SaitoTommo/CatTeasingRobot/esp32-host/README.md

# 接收窗口协议（2026-10-13）

ESP 0.50 配套 Uno V6.14：ESP GPIO43 经电平转换接 Uno D13；Uno D1 回传至 GPIO44。
普通真实 UART 命令等待 Uno 的一次性 RX available，SIM_UNO 保留原协议。
停止与停止重试可直接发送，缺少窗口不能解除 STOP_UNCONFIRMED。
`/api/state` 的 `uartWindow` 显示是否收到许可、当前编号、年龄及队列长度。
接线及兼容性以 [当前接线表](../SOFT_UART_WIRING.md) 为准；以下旧版接线为历史说明。

# DEV ESP32 0.49（2026-10-13，已烧录并回读版本）

`ESP32_CAT_HOST_0.49_ESCAPE_CONTINUOUS_FRONT` 修复 0.48 转完后等待前向请求超时的问题：转向停稳后直接读取持续 FLOOR 结果，要求新帧且采集时间晚于本次停稳观察起点。无需单次 FLOOR 请求及 generation/step 匹配；旧画面或非 FLOOR 画面不能授权直跑。侧向 90° 搜索、连续直跑及普通开关不关闭逃跑前向保护的语义保持不变。原因和验证见[持续前向检查修复](../evidence/escape-continuous-front-20261013/README.md)。

# ESP32 0.48（2026-10-13，已烧录，发现转后检查超时）

`ESP32_CAT_HOST_0.48_ESCAPE_QUARTER_SEARCH` 保留第一次攻击后找猫和复核，再进行侧向超声波门控的 90° 方向搜索。转前不依赖当前前向结果；转后获取新画面，CLEAR 才连续直跑，BLOCKED 则在剩余预算内再转 90°。最多 3 个方向，侧距阈值可在猫互动配置调整（默认 15 cm）。逃离阶段前向保护独立启用，失效/过期停车，触碰恢复重新检查。台架步骤、离线数据、应用文件及回滚边界见[90° 旋转避障说明](../evidence/escape-quarter-search-20261013/README.md)。Uno 不变；已烧录并回读版本，但后续用户日志显示三次转后检查均超时，0.49 修复此缺陷。

# 当前 DEV 配对版本（2026-10-12）

ESP `0.47_SWITCH_FIX` / Uno `V6.13` 新增手机遥控、速度与声光控制、自定义路线及指定路线节点续寻；巡逻与遥控卡片均可续寻，避障、猫识别和标签识别分卡显示。使用、协议和回滚说明见 [遥控与续寻](../遥控与续寻.md)。烧录与验证结果见项目日志；以下旧版本内容按日期保留。

0.47 修复前向开关在标签／猫接近、试探与复核中的遗漏，并独立保存开关、同步高级参数草稿。核查与验证边界见 [开关核查](../开关核查-20261012.md)。

# 当前 ESP32 0.40（2026-10-06）

0.39 首次实机回读发现 OV3660（PID 0x3660）增益上限 status=248，而通用 sensor.h 注释给的是 OV2640 的 0–6 档位。最终已通过COM11烧录0.40，USB与HTTP回读一致；95个旧配置不变，路线[43,46]保留。本机完整寄存器仍回读248，已落在正确范围，未进行参数试写或识别效果实验。OV3660/OV5640 的驱动使用 0x3A18/0x3A19 的 10-bit 原始寄存器刻度，uint8_t status 对超过255的值会截掉高位。因此 0.40 按传感器 PID 给网页提供参数范围；OV3660/OV5640 用 get_reg 读全 10-bit 值、set_reg 写对应掩码，范围 0–1023；其他传感器保留 enum 0–6。不能简单把 248 截成 6，也不能把未保存的原始默认上限误写成 0–6。读失败时该项不当作有效回读；写后读失败拒绝保存并尝试回滚。

接口核对见 [Espressif OV3660 驱动](https://github.com/espressif/esp32-camera/blob/master/sensors/ov3660.c)：set_gainceiling、init_status、get_reg/set_reg。其余本地日志和摄像头功能沿用下面 0.39 的说明。本轮只更新原始项目日志，归类版留给后续整理。

# 当前 ESP32 0.39（2026-10-06，未上传）

网页新增“导出本地全部日志”。已收到的日志写入当前浏览器、当前网页地址的 IndexedDB，不再随 ESP 重启清空，也不再以 160 条限制本地历史。ESP 仍保留 160 条环形缓冲；网页拉取后归档，并按设备 ID、随机启动 ID、序号去重。界面只显示最近 500 条，本地历史不自动裁剪，导出包含全部已保存记录及当前页面尚未落盘的记录。文件格式为 esp32-local-history-v1：logs 为全部历史，lastState 为最后收到的设备快照，附接收时间、启动信息、断线事件、漏收区间和摄像头参数变更。

ESP 断线时，只要当前页面仍开着，导出按钮仍可使用。刷新后重新获得页面时会读回本地历史；ESP 离线时本功能不负责提供网页本身。网页关闭期间不会采集新日志，断线期间超出 ESP 环形缓冲的记录无法补回；崩溃串口 backtrace 不在 HTTP 日志中。AP 地址与局域网地址属于不同网页来源，各自保存。浏览器容量有限、可被清理或驱逐；存储失败会显示错误并保留当前页面待保存记录，读取失败不会生成冒充完整历史的文件。导出后不会自动删除本地数据。

摄像头区域增加“调整摄像头参数”：JPEG 质量、亮度、对比度、饱和度、自动／手动曝光、曝光目标、AEC2、自动／手动增益、增益上限、白平衡及预设、伽马、镜头校正、镜像与翻转，合计 18 项。猫和标签共用同一物理摄像头设置。数字 0/1 表示关闭/开启，JPEG 数值越小画质越高；手动曝光值是传感器驱动刻度，不能当作毫秒。QVGA 320×240 与 JPEG 格式保持固定。

先停止并等待停车确认、结束手动测试、关闭识别性能实验，再点击“应用并保存到 ESP”。请求在控制循环中校验和执行，取帧与传感器设置使用同一互斥锁；传感器不支持的项目和范围外、小数参数会拒绝。实际驱动接受值保存在独立 NVS camera 键，重启恢复；页面等待相同 requestId 的结果回读，不把 HTTP queued 当成成功。驱动可能量化数值，回读显示实际配置；自动模式的实时曝光／增益不是由该状态测量。未保存过时沿用当前板子的启动默认值，“恢复本机启动默认参数并保存”可回到该组参数。

修改后取消旧识别票据、清空旧缓存、丢弃前两帧并检查采集时间，旧推理完成后也不能重新发布为当前预览。空地外观参考失效，先持久化其失效状态，再保存摄像头参数，避免两次 NVS 写入之间断电后出现新画面参数配旧地面参考。驱动设置或保存失败时尝试回滚，并回报失败；回滚本身失败同样明确显示。

驱动接口及范围依据本机 ESP32 Camera sensor.h，结合 [Espressif OV2640 驱动](https://github.com/espressif/esp32-camera/blob/master/sensors/ov2640.c) 核对。设置能力与实际识别改善仍须实机验收。本轮不修改 Uno、不执行串口或烧录。

以下为历史版本记录。

# 当前 ESP32 0.38（2026-10-05，未上传）

双轮扫描预算采用实际左右编码器脉冲和，配套 Uno 6.11 的扩展 VQ 回报；旧格式继续接受并记录 SCAN_COMPAT。新增 tagScanMaxFrames，默认 3，范围 1–10 整数。网页巡游参数区可在停止且停车确认后保存，写入原有 NVS config 并显示板上回读。每次停稳使用新画面识别当前目标标签，找到立即结束本步，未找到保持停车重试，达到次数上限再转下一步；无效识别和超时仍停止。窗口为 min(60000, scanVisionTimeoutMs×次数)。猫的 catCheckMaxFrames 和主动找猫完整行为轮次保持各自设置。

离线验证与实机待测范围见[项目日志](../项目日志.md)最后的“双轮扫描预算与停稳后的标签多帧识别”。须配套更新两块板；本轮没有串口或烧录操作。

以下为历史版本记录。

# 当前 ESP 0.13 / Uno V6.6（2026-10-03，用户正在上传，待验收）

ESP0.13 网页增加“最低驱动 PWM”，先停止并等待确认，再输入1–255整数、点击“保存最低 PWM”，查看“板上已保存下限”回读。初始140沿用用户当前测得值；已有保存值优先，ESP重启保留。比如请求95、下限140则下发140；设置100后下发100。0仍停车，正反方向不变；范围外或小数拒绝。后续改变供电时可以调整这个参数，不需重烧程序。

该设置由ESP统一处理MOTOR/TEST_MOTOR/DRIVE/ROTATE/SR及旧MOVE/TURN运动命令，在CRC封装之前应用；包括自动策略、手动测试和原始命令。纯转角、距离、时长、扫描编号/预算/flags不变。策略请求PWM仍单独保存，网页显示下限调整后的命令值和请求值；实际输出看Uno遥测。要测更低启动PWM，先把下限降低到准备测的值或1。UnoV6.6自己的下限为1，本次无需更改Uno；若板上仍是旧固件，下调到低于其固定下限可能被Uno再次提高，应先更新配对固件。

配对固件已离线实施。路线使用用户保存的1–128个数字标签ID；找到只要求当前ID在有效新帧出现，到达使用单独保存的宽度比例，未配置时用0.25。所有找猫/找标签和丢失后重找最多两圈，按 Uno 分步转、停稳、请求后新帧的协议执行。慢接近猫采用短 DRIVE→确认STOP→停稳→识别，移动期间不运行猫模型；猫消失重找，找到续剩余距离，失败回原路线并持续报告。

首次触碰位置优先；顶部/画面冲突/多触碰按首次位置找猫两圈，双侧近距直接原地扫描。实际策略、视觉帧门槛、CRC及页面状态有自动化检查；猫状态 CAT-01～CAT-18 同时纳入现场验收。旧网页 SIM_UNO 无 SCAN_V1，不能验收新配对固件。

离线构建：`./build.ps1`，板型 `esp32:esp32:XIAO_ESP32S3:PSRAM=opi,PartitionScheme=max_app_8MB`。上一节点 ESP0.12 编译 Flash3714906/8257536 bytes、静态SRAM78792/327680 bytes；0.13完整编译通过：Flash3717266/8257536 bytes、静态SRAM78792/327680 bytes；本轮结果单独记于统一验收记录第5节。`-Upload` 已阻止默认自动复位；用户允许上传，但 RESET、进入烧录模式、界面和运动由用户操作，需另行配合。不要沿用下方历史自动上传命令。完整证据见[离线结果](../离线验证结果.md)，现场步骤见[统一验收记录](../统一验收记录.md)。下方旧版实测保留原日期，不表示本版本通过实机验收。

# XIAO ESP32-S3 Sense 上位机

分支 `esp32-sense-host`，基线 `9217cc9`。关键阶段分别提交，保留现有 Uno 测试台。

## 连接

双击仓库根目录 `启动ESP32测试网页.bat`，自动启动本地服务器并打开 ESP32 页面；已运行则复用。端口被旧版本或其他服务占用时提示关闭对应服务，不自动结束进程。启动日志在忽略版本管理的 `esp32-host/vendor/web-8765*.log`。PowerShell 也可运行 `./esp32-host/start-web.ps1`；`-NoBrowser` 只启动服务，`-Port 8766` 可选择其他端口。它启动的是电脑测试网页；开发板调试网站随固件上电启动。

从原测试台打开“ESP32 实机上位机”，或访问 `http://localhost:8765/esp32-lab.html`。USB 使用 115200 波特，选择 COM11；网页模拟 Uno，ESP32 接收观测并运行决策。切换 UART 后不接受模拟输入。

开发板创建热点 `ESP32-CatHost`，密码 `catrobot32`。调试页 `http://192.168.4.1/`，HTTP MJPEG 流 `http://192.168.4.1:81/stream`。调试页可配置 2.4GHz Wi-Fi；热点保留，站点 IP 在状态中显示。

2026-10-01 接好外置天线后，完整固件已连接笔记本热点，当前地址 `192.168.137.22`；HTTP 页面、Uno 收信日志和视频解码已实测通过。IP 可能改变，以实时状态为准。电脑页面连接 USB 后会自动填写 stationIP 对应的视频地址和调试页链接。

也可连接笔记本移动热点：开启 2.4GHz 热点并接好开发板外置天线，通过 USB 或板载调试页保存热点信息。连接成功后使用状态里的 `stationIP` 访问 `http://<stationIP>/` 和 `http://<stationIP>:81/stream`；电脑测试页的视频地址也改成该流地址。固件重启会读取已保存配置自动连接。`http-smoke.py --host <stationIP>` 可验证此网络上的视频。

真实 Uno UART（0.5）：ESP32 D6/GPIO43 TX→LV4→HV4→Uno D12 软件接收；Uno D1/TX→HV3→LV3→ESP32 D7/GPIO44 RX，共地，57600/8N1。Uno D0只保留给USB串口桥。蜂鸣器移至Uno D13，LED使用ESP板载GPIO21；完整接线见[当前接线表](../SOFT_UART_WIRING.md)。USB控制和ESP UART是独立入口。先验证协议，再验收实体运动。

## 编译和烧录

旧版曾使用 `./build.ps1 -Upload -Port COM11`；当前请在本目录运行 `./build.ps1` 仅编译，使用 XIAO ESP32-S3、OPI PSRAM 和 `max_app_8MB` 分区。脚本保留完整猫检测模型，并将 `ESP32CatHost/debug_page.html` 无损 gzip 压缩为内置网页头文件；网页由浏览器自动解压。编辑网页后运行 `node ./generate-debug-page.mjs`，Arduino IDE 直接编译前也需生成头文件。编译失败时不自动烧录。

Arduino IDE 中对应选项：Board 为 XIAO_ESP32S3，PSRAM 为 OPI PSRAM，Partition Scheme 为 Maximum APP (7.9MB APP No OTA/No FS)。默认 8MB 分区的应用槽只有 3,342,336 bytes，不能把这个应用槽限制当成开发板的总 Flash 容量。当前应用不使用 OTA 和文件系统；NVS 配置区保留。不要使用整片擦除或合并镜像覆盖配置区。

## 路线

`route` 是有序 AprilTag ID 数组，例如 `[7,42,2,100,7]`，按顺序循环。支持 1–128 个节点，可重复访问；tag36h11 ID 范围 0–586。停止策略后保存，存于 ESP32 NVS，重启回读；上电不自动运动。

巡逻寻路使用独立转速：`patrolSearchPwm=45`（搜索标签）、`patrolAlignPwm=30`（对准标签），范围均为 30–150。电脑 USB 测试页和开发板调试页均提供“巡逻转向速度”输入框：停止巡游 → 修改两项 PWM → 保存 → 查看“板上当前值”确认 → 重新启动测试。保存后重启保留；读取实际配置后才允许保存，旧固件缺少参数时提示更新。旧保存配置没有这两个键时自动使用新默认值；原 `searchPwm`、`alignPwm` 继续用于互动中的找猫/对准，互动逃离及直行参数保持原值。降低 PWM 可减少两帧观测间的转角，但不保证消除纠偏摆动；实车需确认低 PWM 能稳定启动。

## 版本与验证

- 通信阶段：USB JSON 行、UART CRC、HTTP 调试页、独立流服务器、网页 JavaScript Uno 模拟入口。网页 65 项测试通过；此阶段策略/视觉文件为下一阶段接口，尚不提供识别或自主巡游。
- 已接入板载 ESPDet-Pico 猫检测、完整 tag36h11 识别，以及本地巡游/互动状态机。默认仅提供约 5fps 预览，不运行推理；在网页选择“只识别标签”“只识别猫”或“两种识别”。每次检测后休息 200ms，两次检测启动至少间隔 350ms，上电重新回到仅预览。实际观测周期包含推理和队列耗时；2026-10-01 各模式约 12 秒实测分别为标签 2.12Hz、猫 2.21Hz、双识别 1.49Hz，长期稳定性仍未验证。
- 状态机支持按路线搜索/对准/接近标签、编码器 360° 搜索上限、750ms 无有效脉冲反馈时发送 STOP、四区触碰、声光探索、捕猎逃跑、主动 HTTP 找猫、三段试探、装死等待及会话关闭/重开确认。0.10 已取消 KEEP；ESP 只在启动车轮、改变速度和停车时发送 MOTOR/STOP。距离停止使用 Uno 确认的几何参数；实体模式不能以模拟值补充缺失观测。
- 实机检查记录在 `VALIDATION.md`。首次烧录后发现控制任务栈溢出，已将两个 4KB 缓冲移出栈并增加任务栈。编译、启动、视频和识别质量分别记录，不把编译成功等同于实物验收通过。

### AprilTag 纠错内存评估（2026-10-01）

当前 `tag36h11` 使用 0 位纠错。目标 ESP32-S3 编译器确认 `quick_decode_entry` 为 16 字节；按本仓库 `quick_decode_init` 的容量公式，0/1/2 位纠错的码表分别为 28,176 / 1,042,512 / 36,544,272 字节。历史双识别日志中 PSRAM 最低剩余 6,606,424 字节，且固件已配置大块 malloc 使用 PSRAM。1 位纠错在容量上可行，2 位超过 8MiB PSRAM 总容量。此评估没有开启纠错；历史剩余总量不等于当前最大连续空闲块，开启前后仍需验证分配成功、峰值剩余和识别耗时。纠错仅容忍标签编码位读错，不能替代标签四边形检出。

## 前向标定与边界

地面外观检测路线来自先前的单目地面/障碍研究讨论，相关论文引用与当前简化范围见 [前向视觉研究依据](./FRONT_VISION_REFERENCES.md)。当前实现不包含论文中的 IPM、MRF 分割或距离估计；分块数量与阈值是项目参数。

前向默认 `INVALID`；视频可见不代表可前进。原型提供地面外观参考：停止策略，固定实车相机，用 15cm 标尺对应图像警戒区调整 `floorRoiTop`，确认当前警戒区是空地后点采集参考。中央一半视野、下部 ROI 分成 24 块，与参考灰度均值比较；接近的猫或外观变化返回 `BLOCKED`。这是定性外观检查，不是深度测距，同色障碍可能漏检，实车避障还需现场验证。相机高度、朝向、光照改变后重新标定。

只启用一种检测时，另一种视觉观测标为不可用。猫未检出、触碰松开都不证明离开；装死等待超时未确认则保持停车，现场确认后人工恢复。

## 指示灯

官方说明：未接电池时，USB 接入后红色充电灯约 30 秒会熄灭，这不表示断电或过热。来源 https://wiki.seeedstudio.com/xiao_esp32s3_getting_started/#battery-usage 。排查是否运行应看 COM11、启动日志、HTTP 状态和 uptime；本次没有实测板温或电源电压，不能据指示灯推断温度。

## 板载 Arduino 调试网页（0.6）

首页用两个明显按钮显示 `Simulated UART` / `Real UART`，选中状态来自 ESP32 的实际模式回读；收到近期 Uno 回报才显示真实接收状态。切换模式停止策略与会话，并清空旧传感器、配置回读。

停止巡游后，可直接测试前进、后退、左转、右转和左/右轮各自正反转（PWM 1–255，时长 50–2000 ms），以及会话解锁、LED、蜂鸣器、PING、状态和配置查询。点击“开启测试：绕过全部避障”后，这些限时动作忽略前向标定、左右超声波和触碰；没有伪造CLEAR或测距值。开关仅作用于手动测试，自动巡游继续遵守避障；上电、模式切换、Uno重启后恢复避障。每次等待会话解锁，再发送 `TEST_MOTOR`；关闭绕过时先确认前向输入。结束后发送STOP/SESSION_STOP，CRC、会话锁、失速停止和急停保留。模拟模式只产生SIM_TX；真实模式通过GPIO43/GPIO44的57600 UART与Uno D12/D1通信，不接受HTTP模拟Uno回报。网页按钮发送成功只代表入队，执行结果看实际Uno回报。

Arduino 配置面板支持左右安全距离（1–100 cm）、轮径（20–150 mm）、轮距（50–300 mm）。ESP32 逐项等待 `DONE`，最后 `GET_CONFIG` 回读核对四项值。部分设置失败可能已改变先前项；请读取当前值核对。当前 Uno 只在 RAM 中保存这些值，Arduino 重启后恢复默认。轮径和轮距还须与 ESP 策略参数匹配。前向安全常量、触碰规则、电机最小驱动值等没有可写协议的限制会说明需改 Uno 固件，不生成无效设置按钮。

传感器面板独立显示超声波物理测距/控制值、编码器、四处触碰、电机请求/实际引脚输出、LED/蜂鸣器、前向判定、LIVE/DRY_RUN 及物理 I/O 掩码。每行单独计时，2.5 秒后标为过期；不会用其它新回报刷新旧读数。前向判定是上位机视觉输入，不是深度测量。板载网页复用 `hardware-telemetry.mjs`，构建时打包到 gzip，无外部 JS 请求。

## 构建命令

ESP32 0.11 配套 Uno 6.4：Arduino 配置面板和接口允许左右 1–100 cm；Uno 默认左右均 3 cm，仅有效新鲜测距严格小于阈值时执行超声波停车。无效或过期测距保持原样显示，但不触发超声波停车。前向判断仍只由 ESP 执行，停止确认、触碰、失速和 MP 反馈超时规则保留。新原因 SIDE_LEFT_OBSTACLE / SIDE_RIGHT_OBSTACLE 不再混入 SENSOR_INVALID。模拟 Uno 已同步该规则。此版本不代表长期串口失联已修复。

ESP32 0.10 配套 Uno 6.3：57600 不变，正常遥测每 2 秒请求一次，每次回三条 CRC 短帧和校验 DONE；收齐后原子更新 13 项显示读数。MP 编码器运动反馈改为 200 ms，独立于慢速遥测；ESP 超过 750 ms 没有有效 MP 仍发送 STOP。取消所有 ESP KEEP 定时发送，Uno MOTOR 没有续租截止时间。ESP 失联而无法发送 STOP 时，Uno 不会因为收不到续行自动停车，本地侧向、触碰、失速检查仍有效。限时手动 TEST_MOTOR 保留截止时间。真实巡游验收需用户操作，本轮上传后仅进行静止通信核对。

真实 UART 的 STOP 设置独立确认等待：收到匹配编号、CRC 正确的 `DONE id MOTOR_STOPPED` 才继续发送队列中的其它命令。每 300 ms 未确认时重发同编号 STOP，最多三次；仍未确认则清空后续队列并显示“停车未确认”，阻止新电机命令。显式新 STOP 可重新尝试，迟到的有效确认也可解除等待。清理普通命令队列不会清除已发出的停止等待。MOTOR 的 750 ms 反馈超时从实际串口发送时开始计时，避免排队等待 STOP 确认时误判。STOP 重发是停车确认恢复，不是续行。Uno 的 DONE 回报统一加 CRC。停止策略并不等于已经实测电机静止，停车确认表示 Uno 已执行关闭输出。

ESP32 0.9 在正常巡游按钮旁保留“前向避障”开关，需停止后切换，以板上配置回读为准，保存后重启保留。默认开启。关闭时跳过 ESP 的前向外观门禁，不改变 `frontCalibrated` 或参考图。前向判断和 STOP 停车指令由 ESP 决定；Uno 6.2 不再执行前向门禁，CAMERA_FRONT 仅保留兼容回读，正常控制不再周期发送此指令。标签新鲜度、左右超声波、触碰、失速和通信停车继续有效；不会自动切换 DRY_RUN/LIVE。

车轮架空固定的标签流程测试：选择 Real UART，确认 Uno 状态为 LIVE；在路线输入框保存自己指定的 ID 数组（1–128 项，ID 0–586），查看“板上已保存路线”。关闭前向避障，然后启动巡游。启动/恢复会自动在 OFF 或 CAT 模式下开启 BOTH（猫与标签），已有 TAGS/BOTH 设置保留，无需另按识别按钮。按当前目标顺序展示真实标签，居中且宽度达到 `tagStopWidth` 才算到达；日志为 `TAG_REACHED <ID>`，随后切换下一个，末尾循环回到首个。每次启动从数组首项开始。启动逐步等待 STOP、当前编号 GET_CONFIG 的 DATA/DONE、SESSION_START 确认；准备期间暂停自动遥测，每阶段超时最多重试两次。网页固定显示当前步骤和最后的故障/动作拒绝原因。没有保存过路线的新设备以空路线启动，要求用户先保存；已有保存路线继续使用。搜索仍受原有 360°/`searchTimeoutMs` 限制，轮子架空时编码器转角也会累计。

本轮 Uno 固件按用户要求将默认轮距改为 120 mm，复位后 `GET_CONFIG` 应回读 `TRACK_MM=120.0`；原默认 0 会使巡游因 `geometry not confirmed` 停止。网页仍可修改轮径/轮距，临时修改在复位后恢复默认，应与 ESP 策略参数一致。120 mm 是用户指定的默认值，不是此次实测。串口失联也会停止，不应通过关闭前向避障解释或绕过。关闭前向开关不证明巡游、标签识别或长期通信稳定性已验收。

PowerShell 运行 `./build.ps1` 编译；加 `-Upload -Port COM11` 烧录。构建目录使用 Windows 临时目录的英文路径，避免当前中文项目路径导致链接失败。`generate-config.mjs` 从原网页的概率和参数范围生成校验头；修改参数定义后再运行它。模型生成脚本由构建脚本自动执行并检查 SHA-256。

工具链：Arduino CLI、`esp32:esp32@3.3.12`、ArduinoJson 7.4.3。板型 `esp32:esp32:XIAO_ESP32S3:PSRAM=opi,PartitionScheme=max_app_8MB`。PSRAM 必须开启。

资料：[Seeed 开发板说明](https://wiki.seeedstudio.com/xiao_esp32s3_getting_started/)、[Espressif ESP-DL](https://github.com/espressif/esp-dl)、[AprilTag ESP32 库](https://github.com/raspiduino/apriltag-esp32)。识别库及模型来源和许可证另见 `THIRD_PARTY.md`。
