SaitoTommo/CatTeasingRobot/evidence/front-switch-escape-20261014/README.md

# 前向避障开关覆盖逃离流程：2026-10-14

用户授权二次复核后烧写 ESP32，并要求更新版本号。基线提交为 `fb7f8b7`，功能修改为 `fdb89be`，最终源码为 `32888ba`，固件编号为 `ESP32_CAT_HOST_0.52_FRONT_AVOIDANCE_SWITCH`。

相对于基线，运行逻辑只改变前向开关对逃离流程的控制：关闭时跳过转向后的前向画面检查、起步前检查及行进中的前向拦截，并关闭该阶段的 FLOOR 请求；开启时保留原有有效期、标定和新画面要求。侧距、触碰、停车确认、失速和通信处理没有修改。控制台说明、版本标识及对应回归检查同步更新；独立手机遥控原本没有前向视觉拦截，本次没有新增该功能。

最终编译通过：程序 3,845,178 字节，静态 RAM 86,032 字节，应用文件 3,845,328 字节。四组本机回归检查共通过 1,741 项断言，覆盖开关开启/关闭、无效/过期/缺失/未标定输入、侧距和触碰，以及原有策略和接近行为。

COM11 既有分区表 3,072 字节与编译分区完全一致。固件 deviceId 按 little-endian eFuse 整数打印，HTTP 的 `c0871ead4f7c` 对应 esptool MAC `7c:4f:ad:1e:87:c0`。首次身份检查未转换字节顺序而停止，未写应用；依据本机 ESP32 核心实现修正部署脚本后重新核对并继续。

上传仅写 `0x10000` 应用区，26.0 秒完成，esptool 确认 `Hash of data verified`。没有写 NVS、引导程序、分区表，也没有上传 Uno。上传前和分区检查后均回读空闲、无运行电机和无待确认停车。

`192.168.137.234` 回读确认 0.52、`IDLE / SIM_UNO`、摄像头正常。99 项配置变化 0 项，路线 `[14,15]`、直行校正间隔 100 ms、前向开关开启和地面标定均保留。设备实际提供的 gzip 控制台页面与生成的 `debug_page.h` 字节内容一致。

完整构建、检查、上传输出及摘要已提交。应用镜像、已知 0.51 回滚镜像、完整状态快照和 gzip 页面样本保存在同目录，未加入 Git；回滚镜像来自此前已保存的 0.51 构建，并非本次设备闪存备份。没有执行实车运动、猫识别/逃离验收或长期稳定性测试。
