SaitoTommo/CatTeasingRobot/猫互动状态机现状-20261004.md

## 2026-10-14：直行校正间隔配置（已烧录，运动效果待验收）

ESP 0.51 / Uno 6.15：网页提供 straightBalanceIntervalMs（20–1000 ms 整数，默认 200 ms）；ESP 持久保存，下次自主启动同步 Uno。WAIT_PATROL_BALANCE 在几何配置确认后发送 SB，等待对应事务的校验完成回复后才进入 WAIT_SESSION_START。LINK_RECOVERY_BALANCE 在通信恢复的停车及几何确认后重新同步，确认后才进入 LINK_RECOVERY_SESSION_START。未确认、错误或超时不会授权运动。

补充现有 0.49 逃离门控状态：ESCAPE_SIDE_SETTLE 等待侧向取帧前停稳；ESCAPE_SIDE_CHECK 检查候选方向侧距及观测；ESCAPE_FRONT_SETTLE 等待转向后停稳；ESCAPE_FRONT_CHECK 等待停稳后更新的连续 FLOOR 观测，确认可行后进入逃离直行。

## 2026-10-12：DEV ESP 0.46 操作区布局

电脑：UART／巡游左列，摄像头与正下方避障中列，遥控右列。手机：UART／巡游、摄像头、遥控、避障。已烧录并摘要校验，路线 [43,46,51] 与全部配置保持。

## 2026-10-12：DEV ESP 0.45 路线独立存储

解决路线修改时整份配置写入失败导致末节点未保存的问题；路线独立写入、立即回读并在启动恢复。已保存用户路线 [43,46,51]，复位后回读一致，其余配置保持。

## 2026-10-12：DEV ESP 0.44 路线编辑与接管修复

巡逻和遥控卡片均提供路线编辑、保存及起始节点续巡；实际 Uno 裸 DONE 配置完成回报导致的接管超时已修复。静止真 UART 进入/退出遥控通过，运动验收待完成。详见《遥控与续寻.md》和《串口回报匹配检查-20261012.md》。

> 2026-10-12 DEV：源码 ESP 0.43_REMOTE_RESUME / Uno V6.13。新增 REMOTE 接管状态，自主策略在该状态不执行。遥控链路为 ENTER_STOP → ENTER_LOCK → CONFIG → START → ACTIVE；松手 MOVE_STOP → START，退出 EXIT_STOP → EXIT_LOCK → 停止或指定节点巡游。每一步等待对应停车或会话确认。
> Uno 新增 MOTION_REMOTE：限时 600 ms 的遥控运动，可续期和更新速度/方向；绕过环境保护，保留失速。续期不能重置同方向失速计时；超时/中止后锁定会话。TEST_MOTOR 的 SAFE/BYPASS 语义保留。GET_CONFIG 可附带 REMOTE_V1 能力标记；旧 ESP 不支持该标记，回滚时配套恢复两端版本。
> 两处续寻使用相同路线索引入口；先停车并清理遥控/声光，再寻找所选节点，不把选择视作已到达。部署及实机验收结果见 2026-10-12 项目日志，以下保留历史状态说明。

> 2026-10-06 当前源码：ESP 0.42 / Uno配对6.11（仅离线验证，未烧录）。设备已烧录的是maintenance/0.40-cat-flow的0.40.1维护版。以下2026-10-05发布记录保留为历史证据；找猫、接近和确认的当前行为以本条及当前状态表为准。
>
> 主动找猫与触摸找猫共用CAT_CONFIRM：停车确认、编码器停稳后最多catCheckMaxFrames张新画面，任一次找到立即通过，无额外catConfirmWaitSeconds等待、不要求居中。扫描各停点也最多三帧。快/慢接近整段执行，结束后CHECK_APPROACH → SETTLE → CAT_CHECK；catApproachStepCm不再生效。猫丢失后使用与标签相同的TargetRecoveryMemory和startTargetRecovery/advanceTargetRecovery引擎：最近五秒位置优先、中心死区参考趋势，局部→反向→原预算余额。猫不使用标签直行宽限；重新找到继续保存的行为/剩余距离，初次主动/触摸选择仍各自保留。标签ID、到站宽度与路线规则保留。0.40.1仅简化确认和整段接近，不带方向恢复。
> 2026-10-06 更新：ESP 0.41 标签短暂漏检保留已确认直行命令；持续丢失后确认停车 → TAG_SETTLE（编码器停稳）→ TAG_RECHECK（多帧停车复核）→ 记忆方向局部搜索／反向局部搜索／共享剩余预算搜索。找到或到站、停止、互动抢占和配置变更会结束对应恢复状态。
> 2026-10-05 更新：ESP 0.35 的主动找猫与触碰找猫共用 CAT_CONFIRM，找到猫后不检测居中。旧 FACE_CAT、ALIGN_CAT、CHECK_ALIGN 与猫居中预算已退出运行路径；后文这些状态属于历史版本。接近短段后的 SETTLE/CAT_CHECK 保留用于停稳识别。详见 esp32-host/统一找猫不检测居中-20261005.md。
# 猫互动状态机现状：ESP 0.42 / Uno 6.11

2026-10-04 更新。本页前半部分是当前源码现状；末尾保留 ESP 0.17 基线原清单，供版本对照。代码基线提交 81588be，配置页面提交 970643d，独立找猫提交 ebd8db6，连续互动与逃跑拆分提交 5995e7d。

这份清单已逐条核对 policy.cpp 的状态入口、等待动作和转移条件，同时核对 Uno 扫描和运动执行器。自动化覆盖不代表实际识别、运动和 UART 长期稳定性；现场由你验收。当前构建/上传记录见项目日志。

## 当前完整流程

首次触碰：巡游/待命 → 开始一轮互动 → 固定首次触碰位置 → 选择探索/捕猎。

后续触碰：CAT_TOUCH 内只记证据，不重抽、不切换来源。ROBOT_SEARCH 的首次触碰属于新的攻击入口，转入与巡游首触完全相同的 CAT_TOUCH 状态机。若正在转向、直行或扫描：确认停车 → WAIT_TOUCH_RESUME → 松开后续做剩余角度/距离/扫描预算。装死/声光/观察不因拍打重新开始。

捕猎：WAIT_RELEASE → **ESCAPE_DIRECTION（寻找逃跑方向）** → 必要时找猫或 ESCAPE_TURN → 确认停车 → ESCAPE_DRIVE → **ESCAPE_MOVE（执行逃跑直行）** → 确认停车 → POST_ESCAPE → 本轮完成计数/装死选择。

未装死：停车找猫并对准 → WAIT_CHASE → 有追击则观察、继续下一轮；无追击到期则结束。首次顶部/冲突找猫后，对准猫，再转 180°远离猫；找猫扫描本身不算逃跑。

探索：TOUCH_SIGNAL → SIGNAL 声光周期 → 周期完成计数 → 满足可配置最短探索时间后才抽装死 → 未装死则重新面向猫观察 → 下一声光周期。

装死：PREY_WAIT 保持静止，灯条由你遥控 MazeBot；猫退出确认或可配置装死超时结束。不会为画面外的猫转圈。

独立主动找猫：IDLE/STOPPED → 停车确认 → 几何参数 → SESSION_START → 原地两圈找猫。无需标签路线，无需先巡游。主动找猫结束后统一返回巡游：巡游中触发则恢复原路线节点及 TAG_REARM 条件；从 IDLE/STOPPED 触发则从保存路线第一个节点开始。找猫本身仍无需路线；返回时若没有保存路线，明确报 empty route 并停止，不编造标签。主动找猫默认完成5个完整动作后退出邀请；快接近、慢接近、完整三段试探、声光和观察各计一次，内部短段/停车复核不计数。猫攻击立即进入统一首触状态机；找到后有效新帧无猫可提前退出。

## 2026-10-05：CAT_CHECK 停稳后多帧复核

SETTLE → CAT_CHECK：新增 catCheckMaxFrames，默认 3，允许整数 1–3。主动找猫与触碰互动中进入 CAT_CHECK 的路径共用此配置。任一张有效新画面找到猫即通过；有效未找到则在同一 CAT_CHECK 内请求下一张，全部未找到后才进入原有丢失处理。每张采用新取帧 ticket，拒绝重复／旧帧及不匹配 generation、stepId 的结果。补测期间不重新 SETTLE，不发送运动命令。

scanVisionTimeoutMs 限制整次 CAT_CHECK 识别窗口，不按补测次数延长。无效、过期或超时走 FAULT / STOPPED，发送 STOP 与 SESSION_STOP，不能当作猫离开而恢复巡游。CAT_CHECK_SAMPLE 日志记录次数、frameSeq、found/absent/invalid；状态回报 catCheckSamples 和 catCheckMaxFrames。次数配置在主动找猫、猫互动面板和全部参数中可保存并回读；旧保存配置未包含此项时使用默认 3。

本次仅修改 CAT_CHECK，CAT_CONFIRM 的等待及最终单帧、扫描各停点的单帧、OBSERVE/SIGNAL/FOLLOW_WAIT 中的单帧离开判定保留现状。仍可能从这些入口结束互动；不能声称所有漏检引起的恢复巡游均已解决。离线回归和编译不代表实际摄像头、电机行为已验收。

已获用户授权上传 ESP32（Uno 上传需先通知，等待用户拔掉板间串口线）。本次 Uno 未改未上传。ESP 编译 Flash 3,762,754 字节、静态 RAM 83,696 字节；COM11 核对既有 3072 字节分区一致，仅写 0x10000 应用 3,762,896 字节，25.3 秒，Hash of data verified。HTTP 回读 ESP32_CAT_HOST_0.29_FPS_BENCH_3_ACTIVE_SEARCH_3_CAT_CHECK_3、IDLE/SIM_UNO、catCheckMaxFrames=3；原有保存参数变化 0 项，路线 [46,40] 保留；服务页面与编译页面一致。原生 CAT_CHECK 新增 116 项检查、现有 policy 1172、连续互动 623、PWM/配置 2656、扫描 259 项通过，网页 31 项和状态清单 2 项通过。设备验收仍由用户切 Real UART 后进行；本次未主动运行实车电机。证据见 evidence/cat-check-three-frames-20261005/verification.json。

## 2026-10-05：主动邀请计数与上位机调参

最新主动邀请为 ACTIVE_SEARCH_3。默认完成5个完整动作后返回巡游；猫攻击或找到后有效新帧无猫可提前中断。快速接近默认最多15厘米、请求PWM180，仍使用catApproachStepCm短段上限及停车新帧；慢接近使用原保存计划距离/PWM。快接近达到距离上限或猫宽超过远阈值后进入慢接近，两者分别计一次；三段试探完整结束计一次。并行闪灯不是额外动作，概率robotSlowFlashPercent默认50%，只在整个慢接近开始抽一次。

“主动找猫”控制台显示当前动作、完成次数/上限、摄像头新鲜有效猫框占画面宽度、控制采用的远近档和实际PWM。可保存robotActionLimit、快接近距离/PWM、并行闪灯概率、远处和停下后概率组、catFarWidth/catNearWidth、initialLookSeconds、decisionIntervalMs、signalFlashMs、signalBeepMs及慢接近/试探参数。猫宽阈值采用百分比输入，存为归一化宽度；中间区间沿用上一远近档。过期/无效画面显示无有效新鲜检测。

观察与声光时长独立：观察按initialLookSeconds；灯按signalFlashMs，蜂鸣按signalBeepMs，声光动作等待较长者结束后计数。参数经config/NVS保存和板上回读，编辑草稿不会被轮询覆盖；修改前需停止且确认停车。既有保存概率、宽度、时长和最低PWM不自动改值。最低PWM255会使快180/慢95都实际255，控台明确显示，真实速度差仍待用户标定。本次未修改/上传Uno。

## ESP 顶层状态

| phase | 含义与出口 |
| --- | --- |
| IDLE | 待命；可直接主动找猫或由首次触碰启动。 |
| STARTING | 停车/几何/会话准备；会话确认后根据启动目标进入巡游或猫互动。 |
| PATROL | 标签巡游；alert 或首次触碰优先打断并进入 INTERACTION。摄像头单独看到猫不触发互动。 |
| INTERACTION | 主动邀请 ROBOT_SEARCH 的首次触碰转为 CAT_TOUCH，复用巡游首触流程；CAT_TOUCH 内后续拍打保留已选分支。 |
| RECOVERING | Uno 链路恢复；每轮先确认 STOP、关闭会话、回读配置，再重开会话；最多四轮。 |
| ENDING | 停车并关闭会话；持续触碰时先等松开，随后按来源返回巡游或待命。 |
| STOPPED | 故障或操作员停止；后续自动运动已取消，等待重新启动。 |

## ESP 所有 action 状态

包含猫流程、它依赖的启动/退出步骤，以及恢复巡游的节点；因此不会把“公共状态”漏出清单。

| action | 中文含义 | 当前转移与条件 |
| --- | --- | --- |
| IDLE | 待命 | 独立互动关闭会话后进入；可再次找猫或启动巡游。 |
| WAIT_PATROL_STOP | 等启动前停车 | STOP 确认后，真机 GET_CONFIG；模拟先 SET_GEOMETRY。独立找猫也复用此状态，名称不代表必须巡游。 |
| WAIT_PATROL_GEOMETRY | 等模拟几何设置 | 确认后读取 CONFIG。 |
| WAIT_PATROL_CONFIG | 等几何回读 | 合法轮径/轮距确认后启动会话；缺失则故障。 |
| WAIT_SESSION_START | 等会话开放 | 独立找猫进入 INTERACTION，巡游启动/恢复进入 PATROL。 |
| WAIT_STOP | 等确认停车 | 确认后进入 nextAction；超时则故障；页面显示下一步。 |
| WAIT_RELEASE | 首次响应等触碰松开 | 保留原计划，不再因按住 4 秒正常结束；探索走声光，捕猎走 ESCAPE_DIRECTION。 |
| TOUCH_SIGNAL | 首次探索入口 | 开始声光周期并启动探索计时。 |
| ESCAPE_DIRECTION | 寻找逃跑方向 | 按首个触碰决定 +90/-90/0；顶部/冲突或两侧近先两圈找猫；找到并面向猫后准备转 180°远离。目标方向受阻或侧距过期退出恢复规则。 |
| ESCAPE_TURN | 寻找方向中的实际转向 | ROTATE 回报完成后确认停车，再进 ESCAPE_DRIVE。此时尚未执行直行，不计逃跑轮数。 |
| ESCAPE_DRIVE | 已有方向，准备逃跑 | 核对前方可走，发 DRIVE 后进入 ESCAPE_MOVE。默认 26 cm 减 3 cm 余量。 |
| ESCAPE_MOVE | 逃跑直行 | 编码器确认 MD 完成后停车 → POST_ESCAPE；触碰停车后续做剩余距离。 |
| POST_ESCAPE | 完整逃跑已完成 | 增加一轮；默认第 5 轮强制装死，之前每轮按 escapePreyPercent 抽一次；否则找猫并等待追击。 |
| WAIT_CHASE | 等猫追击 | postEscapeWaitSeconds 默认 10 秒；新触碰或远/中→近的有效画面证明追击，进入面向猫观察；到期无证据退出。开始时猫已经近且一直近，不单凭“仍可见”算追击。 |
| WAIT_TOUCH_RESUME | 接触后暂停续做 | 已确认停车，等待松开；普通转向扣已用角度，逃跑/试探扣已走距离；慢接近先停稳识别再继续；扫描保留已用两圈预算。 |
| SEARCH_CAT | 准备找猫 | 配置两圈扫描；scanNext 保存找到后目的。 |
| WAIT_SCAN_CONFIG | 等 SC 确认 | 必须 SCAN_CONFIGURED；错误延后 100 ms 重发，首次外最多 3 次；无回复 2.5 秒再安排重发。 |
| SEARCH_CAT_ACTIVE | 分步扫描猫 | Uno 转小步并停稳后 VQ，ESP 取新画面回 VR；找到则对准并执行后续目标，其他结果报找猫失败。 |
| BOTH_SIDE_SCAN | 两侧近的扫描切换 | 保留扫描累计角度，flags=1 继续剩余预算；不是倒退，也不是逃跑直行。 |
| FACE_CAT | 准备面对猫 | SETTLE → CAT_CHECK → 对准判断。 |
| ALIGN_CAT | 实际对准猫的小步转向 | 每步 ±20.25°，完成后 CHECK_ALIGN；最多 8 步或超时报找猫失败。 |
| CHECK_ALIGN | 转向后检查入口 | SETTLE → CAT_CHECK → ORIENT 判断。 |
| SETTLE | 等停车后稳定 | 等用户最低等待、编码器安静时间及停车后两次样本；此时遥测每 250 ms，普通状态仍 2 秒；成立后 CAT_CHECK，超时找猫失败。 |
| CAT_CONFIRM | 主动/触摸共用静止复核 | 停车后等编码器安静、两次样本及最低等待；最多三张新画面，任一次找到通过，无额外等待。首触CHOOSE_TOUCH行为选择保留。 |
| CAT_CHECK | 停车后新画面识别 | 最多三帧，找到则继续保存下一步；接近/试探丢失时沿记忆方向局部、反向、剩余预算恢复；过期/无效/超时明确失败。 |
| APPROACH_CAT | 准备整段快/慢接近 | 前方可走且有猫则发剩余完整距离DRIVE；距离完成按原规则计数和选择后续行为。 |
| CAT_DRIVE | 整段快/慢接近 | 一次执行剩余完整距离，运动中不实时识别猫；触摸/通信/编码器保护保留，结束后CHECK_APPROACH。 |
| CHECK_APPROACH | 完整接近动作后识别入口 | SETTLE → CAT_CHECK → APPROACH_CAT完成计数；丢失时恢复，保留行为及剩余距离。 |
| PROBE_DRIVE | 准备试探当前段 | 前方可走发 DRIVE。 |
| PROBE_MOVE | 试探当前段运动 | 默认 3/4/3 cm；完成后 CHECK_PROBE。 |
| CHECK_PROBE | 试探后识别入口 | SETTLE → CAT_CHECK → PROBE_DONE 行为 → PROBE_PAUSE。 |
| PROBE_PAUSE | 试探段间停顿 | 默认 700/900/600 ms，继续下一段或结束三段并观察。 |
| SIGNAL | 声光探索/主动声光 | 周期完成后关闭声光；猫主动探索计一轮，达到最短时间才抽装死；未装死则面对猫观察。 |
| OBSERVE | 静止观察 | 默认 initialLookSeconds 5 秒后 FOLLOW_WAIT。 |
| FOLLOW_WAIT | 等下一行为 | 默认决策间隔 2.5 秒；猫主动互动沿原分支继续；机器人动作间等待后再按概率选择行为，完成 robotActionLimit（默认5）个完整动作才正常结束返回巡游。 |
| PREY_WAIT | 装死静止等待 | 不自动闪灯/蜂鸣；有效远离或连续有效无猫且无触碰持续 catLeaveSeconds 默认 5 秒退出；captureWaitMaxSeconds 默认 15 秒到期正常退出，不报旧 MAX_WAIT_UNCONFIRMED。 |
| END_SESSION | 互动结束准备关会话 | 触碰已松开则 SESSION_STOP，否则 WAIT_INTERACTION_RELEASE。 |
| WAIT_INTERACTION_RELEASE | 等触碰松开后退出 | 停车已确认；不在按住时恢复巡游运动，松开再关闭会话。 |
| WAIT_SESSION_STOP | 等会话关闭确认 | 巡游来源恢复原节点；独立主动找猫重开保存路线的新巡游；缺路线明确 FAULT。独立触碰来源仍按原规则进入 IDLE。巡游重开会话时清对准次数/旧决策帧、恢复标签扫描默认方向。 |
| LINK_RECOVERY_STOP | 恢复前停车确认 | 重试 STOP；确认后 LINK_RECOVERY_STOPPED。 |
| LINK_RECOVERY_STOPPED | 已确认停车 | 发 SESSION_STOP 进入 LINK_RECOVERY_SESSION_STOP。 |
| LINK_RECOVERY_SESSION_STOP | 等关闭会话 | 匹配 SESSION_STOPPED 后读 GET_CONFIG。 |
| LINK_RECOVERY_CONFIG | 恢复配置回读 | 几何确认后重开会话；原故障停止则保留停止。 |
| LINK_RECOVERY_SESSION_START | 等恢复会话 | 确认后按原 phase 恢复；猫互动使用新画面重新搜索，巡游重新扫描标签。 |
| FAULT | 故障停止 | 错误原因保留；运动、扫描和识别请求取消。 |
| SCAN_TAG | 准备恢复/开始找标签 | 共用 SC → SR，进入 SCAN_TAG_ACTIVE。 |
| SCAN_TAG_ACTIVE | 分步找标签 | 成功则 APPROACH_TAG，失败故障；猫触碰优先打断。 |
| APPROACH_TAG | 接近当前标签 | 当前目标宽度达到停车阈值先确认停车；偏离则 TAG_ALIGN；丢失则重新扫描。 |
| TAG_ALIGN | 标签小步对准 | ROTATE 完成、停车确认后继续接近；最多 8 步/超时故障。 |
| TAG_ARRIVAL | 标签到达确认后换节点 | 当前节点加一，末尾循环；同编号下一节点需 TAG_REARM。 |
| TAG_REARM | 等同编号重新可计到达 | 标签消失或宽度退到停车阈值 80% 以下，再开始扫描。 |

SCAN_TAG_ACTIVE 是 SR 成功后由条件表达式赋值的状态，不能仅搜索 action== 字面量来列清单。

## 行为目标不是驻留状态

ORIENT 是停车画面后的对准判断；CHOOSE_ROBOT 是机器人主动选择；FAST_APPROACH 是远处快速接近的完整动作，达到 robotFastApproachCm 距离上限或新鲜猫框宽度大于 catFarWidth 后计一次，再切 SLOW_APPROACH。SLOW_APPROACH 完成计划距离后计一次；它的 robotSlowFlashPercent 只在动作开始抽一次，闪灯并行于短段运动；停止后按 robotNearSignalPercent/robotNearObservePercent/robotNearStayPercent 选择声光/观察/静止；SLOW_APPROACH/RESUME_APPROACH、PROBE_APPROACH/PROBE_DONE、STAY_SIGNAL/STAY、TOUCH_SIGNAL、ESCAPE_DIRECTION_FOUND、ESCAPE_DRIVE、WAIT_CHASE 是保存的后续行为。ESCAPE_DIRECTION_FOUND 表示已找到并对准猫，现在决定远离方向。

旧 TOUCH_END、TOUCH_PREY 不再有有效入口/处理；PREY/PREY_SIGNAL/END 的旧直接行为分派不在新的首次响应流程中使用，不能把它们列为目前会自动出现的状态。

## Uno 执行状态完整清单（本次固件未改，配对 6.11）

| 扫描 phase | 实际行为 |
| --- | --- |
| IDLE | 无扫描；合法 SR 启动 NEXT。 |
| NEXT | 准备下一步；预算用完 TERMINAL，否则 TURN。 |
| TURN | 两轮反向，执行小步编码器转动；完成进入 SETTLE。 |
| SETTLE | Uno 自己确认最低停车时间/安静条件；不同于上表 ESP SETTLE，不依赖电脑网页。 |
| WAIT_VISION | VQ 请求新画面；每 500 ms 重发；有效无猫且有预算 NEXT，找到/无效/超时 TERMINAL。 |
| TERMINAL | 停车并 SD 终止；同 id/generation SR 重发不重置，不重新转两圈。 |

SD 结果：0 NOT_FOUND（预算耗尽）、1 FOUND、2 INVALID、3 TIMEOUT、4 ABORTED、5 SETTLE_TIMEOUT。猫扫描失败报告“找猫失败”；旧 id/generation 结果忽略。

| 普通运动 kind | 含义 |
| --- | --- |
| MOTION_NONE | 无运动，可接受下一运动。 |
| MOTION_TIMED | 定时运动，截止完成。 |
| MOTION_PULSES | DRIVE/ROTATE/扫描，按编码器脉冲完成。 |
| MOTION_CONTINUOUS | MOTOR 持续运动，直到 STOP/中止/替换。 |

任何正常自动运动触碰按下，Uno 先停再报告；持续按住时拒绝运动。此保护保留，ESP 的“不重新响应”不等于取消底层停车。AK=接收确认，MS=开始，MP=进度，MD=完成，MA=中止。ESP 根据 MA 已走距离/角度续做，而不是重发完整运动。

超声波辅助状态 SONAR_IDLE / SONAR_WAIT_RISE / SONAR_WAIT_FALL 是等待触发、回波上升沿和下降沿；它们不表示新的猫行为，但会影响测距新鲜度及运动方向是否可执行。会话 SESSION_START/SESSION_STOP 是 Uno 运动开放/锁定，不是猫行为。

## 配置、退出与故障

网页独立配置：远/近猫框宽度（默认 12%/35%）、追击超时 10 秒、最多逃跑完成轮数 5、逃跑装死概率 20%、探索最短时间 30 秒、探索装死概率 20%、退出确认时间 5 秒、装死超时 15 秒。概率两个独立字段，可改 0–100%；保留板上原有设置，新字段才取默认。

远≤远阈值、近≥近阈值，中间保持上一档；首次中间只观察。未看到/无效/过期不能当远近证据。装死退出用新鲜有效连续画面；拍打清离开计时，不重置装死最长时间。超时退出不冒充确认猫离开。

正常退出包括：主动邀请达到动作上限、有效猫离开画面或远离确认、两圈找猫失败、追击超时、装死超时、方向受阻/前方不能执行；回原巡游或待命按来源判断。故障退出包括：STOP 不确认、Uno 失联 2.5 秒、运动开始未确认 2.5 秒、运动中 750 ms 没检查通过的进度、编码器失速、必要命令失败、扫描重试耗尽、重启。保留真实原因，执行故障不当猫离开。

SC 配置：错误后 100 ms 重试，无回复 2.5 秒再安排重试，首次外最多 3 次。SR 启动：错误立即重发，无启动确认 100 ms 重发，同 id/参数首次外最多 3 次。普通 DRIVE/ROTATE 未加新的启动重试。两圈预算累计约 718.875°，接触暂停续做不会重新给完整两圈。

SETTLE 的最低停车等待 scanMinimumMs（默认 200 ms）、安静时间 scanQuietMs（默认 100 ms）与追击/装死超时不同；新遥测频率只去掉采样排队造成的额外等待，不缩短用户设置。实际等待还受 UART 回报和编码器变化影响。

## 基线 ESP 0.17 原清单（历史对照，非当前行为）

# 猫互动状态机现状：供重新梳理

日期：2026-10-04。代码基线：`81588be7ebb7336765ec6327c058ef7f87126325`。

版本：ESP `ESP32_CAT_HOST_0.17`，Uno `UNO_CAT_V6.8`。

本文描述这份基线代码实际写了什么，不是新的实施方案。没有修改程序、上传、reset、操作界面或进行运动测试。数字标为“默认”的，是代码初始值；网页保存的设置可以覆盖它们。

主要依据：[ESP 行为代码](esp32-host/ESP32CatHost/policy.cpp)、[行为默认设置](esp32-host/ESP32CatHost/policy_defaults.h)、[主程序默认设置与输入入口](esp32-host/ESP32CatHost/ESP32CatHost.ino)、[Uno 执行代码](firmware/UnoCatController/UnoCatController.ino)、[Uno 扫描状态机](firmware/UnoCatController/scan_machine.h)。

## 1. 先看完整流程

```text
巡游
 ├─收到触碰按下 → 猫主动互动 → 选择探索/捕猎 → 停车确认
 │   ├─探索 → 声光 → 面向猫 → 观察 → 后续选择
 │   ├─装死 → 静止等待猫远离
 │   └─逃跑 → 等触碰松开 → 转向或找猫 → 前进逃跑
 │                 → 停车找猫 → 等待追击 → 面向猫 → 观察 → 后续选择
 └─收到 alert 指令 → 机器人主动互动 → 停车找猫 → 对准
                         ├─猫较远 → 慢接近 / 三段试探
                         └─猫较近 → 声光 / 观察 / 静止
                                      → 观察 → 再次选择

找猫共用流程：停车 → 扫描配置 → 扫描启动
             → 转一小步 → 停稳 → 识别一帧
             → 找到则对准；未找到则下一步，最多两圈

结束互动：停车确认 → SESSION_STOP 确认
         → SESSION_START 确认 → 恢复原来的巡游目标

通信或运动故障：停车、关闭会话 → FAULT，等待人工恢复
```

注意：“猫较远/较近”在 ESP 固件中按猫框宽度占画面宽度判断，不是厘米测距。

## 2. 顶层状态与进入条件

| 状态 | 中文意思 | 进入及离开条件 |
| --- | --- | --- |
| `IDLE` | 尚未运行 | 启动/恢复后进入 `STARTING`。触碰会记录开关状态，但不会在这里自动开启互动。 |
| `STARTING` | 开启巡游会话 | 停车确认 → 获取 Uno 几何设置 → `SESSION_START` 确认 → `PATROL`。此阶段触碰不进入猫互动。 |
| `PATROL` | 巡游 | 新的触碰按下进入猫主动互动；`alert` 指令进入机器人主动互动。仅摄像头看到猫，不会自动打断巡游。 |
| `INTERACTION` | 与猫互动 | 有两种来源：`CAT_TOUCH`（猫触碰）和 `ROBOT_SEARCH`（alert）。现有代码允许后续触碰把机器人主动互动改为猫主动互动。 |
| `ENDING` | 结束当前互动并恢复巡游 | 停车 → 关闭会话 → 重开会话 → `PATROL`。一般保留被打断的路线节点。 |
| `STOPPED` + `FAULT` | 停止运行 | 人工停止、串口失联、运动未确认等进入这里。人工停止现在也记为 `operator_stop` 故障。 |

## 3. 触碰的完整处理：目前会重新打断互动

开关分为左、右、后、顶部。持续按住同一个开关，不反复算新的按下；松开后再次按下，会重新处理。

| 情况 | 当前实际处理 |
| --- | --- |
| 巡游中第一次按下 | 进入 `INTERACTION`，来源记为 `CAT_TOUCH`，清零互动轮数和分支，然后立即处理首次响应。 |
| 机器人主动互动中首次按下 | 改为 `CAT_TOUCH`，清零轮数和分支，重新选择触碰响应。 |
| 已在猫主动互动，松开后又按下，距上次达到 `touchDebounceMs` | 算新一轮，轮数增加；重新记录触碰位置，重新选装死/慢逃/快逃或探索声光。 |
| 未达到合并间隔，又按下 | 不增加轮数；不同位置会标记需要找猫；仍然停车并进入 `WAIT_RELEASE`。 |
| 一个开关尚未松开，另一个位置也按下 | 标记多个位置触碰、需要找猫；保持之前的首个位置；重新停车并进入 `WAIT_RELEASE`。此路径不会更新 `lastTouch`。 |
| 多个位置的 Uno 时间戳相同 | 额外标记同时触碰；首个位置按实际收到并处理的顺序保留。 |
| 顶部被碰 | 标记需要两圈找猫。 |
| 左碰但新鲜画面里的猫偏右，或右碰但猫偏左 | 保留触碰位置，标记需要两圈找猫。画面冲突判断阈值为中心位置 0.55/0.45。 |
| 左/右触碰要逃跑 | 分别准备 `+90°/-90°` 转向；后部准备 0°，即不先转。最终仍受测距、触碰和运动执行条件限制。 |

探索/捕猎的大分支一般只在 `branch < 0` 时抽一次；但同一分支下的具体动作会在新一轮触碰时重新抽。新一轮也会覆盖“首个触碰位置”。所以当前代码还不是“整轮互动固定第一次响应，后续拍打全部忽略”。

达到 `endingAfterRounds` 时优先进入收尾抽选，不再执行普通探索/捕猎抽选。默认第 3 轮：40% 结束恢复巡游、30% 安静装死、30% 声光装死。顶部或画面冲突时，可能先经 `WAIT_RELEASE` 找猫，再执行这个结局。

## 4. 行为选择：两种进入来源

### 猫触碰进入

| 选择 | 默认概率 | 实际动作 |
| --- | --- | --- |
| 探索分支 | 20% | 触碰后选择一种声光模式；不执行逃跑抽选。 |
| 捕猎分支 | 80% | 在该分支内再选：装死 20%、慢逃 40%、快逃 40%。 |
| 捕猎触碰即时声光 | 独立 20% | 停车确认后闪灯和蜂鸣，与装死/逃跑抽选独立。 |

探索声光模式四种：常亮 1.8 秒；120 ms 间隔闪烁 2.4 秒；600 ms 间隔闪烁 3.6 秒；1400 ms 间隔闪烁 5.6 秒。蜂鸣分别 120/180/240/360 ms。四种按抽取袋轮换，避免连续重复；这份固件结束会话时没有清空声光袋。

### alert 进入机器人主动互动

先停车找猫、对准，再选行为：

| 猫的位置 | 默认选择 | 后续 |
| --- | --- | --- |
| 未在新鲜有效画面中找到 | 两圈扫描找猫 | 找到后重新对准并选择；失败结束互动、报找猫失败。 |
| 猫框宽度小于 `catNearWidth`，默认 35% | 满足冷却时，15% 三段试探，其他慢接近 | 不满足试探冷却时直接慢接近。 |
| 猫框宽度达到近处阈值 | 20% 声光、40% 观察、40% 静止 | “静止”和“观察”在现有固件中均进入同一个 `OBSERVE` 状态。 |

## 5. ESP 的全部猫相关动作状态

表内出现的 `WAIT_STOP`、`SETTLE`、`CAT_CHECK` 等是共用步骤，会带着“下一步要做什么”的记录；同一个状态名不代表每次后续都相同。

| 状态名 | 做什么 | 正常下一步 / 其他出口 |
| --- | --- | --- |
| `WAIT_STOP` | 取消旧扫描/识别请求、清发送队列，发 STOP，等待停车确认 | 确认后进入保存的下一步；2.5 秒无确认则故障。 |
| `WAIT_RELEASE` | 等所有触碰松开 | 4 秒默认仍按住则结束互动；松开后按下表选择找猫、声光、装死或逃跑转向。 |
| `TOUCH_PREY` | 触碰抽中装死 | 进入 `PREY_WAIT`。 |
| `TOUCH_SIGNAL` | 触碰抽中探索声光 | 进入 `SIGNAL`。 |
| `TOUCH_END` | 达到轮数后的结局 | END 则结束互动；否则进入安静/声光装死。 |
| `SEARCH_CAT` | 准备两圈找猫 | 发扫描配置，进入 `WAIT_SCAN_CONFIG`。 |
| `WAIT_SCAN_CONFIG` | 等 Uno 接受 SC 参数 | 确认后发送 SR，进入 `SEARCH_CAT_ACTIVE`；失败按第 8 节重试。 |
| `SEARCH_CAT_ACTIVE` | Uno 分步转动，ESP 在停车后识别 | 找到猫后进入对准；扫描结果非 FOUND 则报找猫失败并结束互动。 |
| `BOTH_SIDE_SCAN` | 猫扫描受侧障碍中止，且两侧都近时切换原地扫描方式 | 保留已用角度，按剩余两圈预算继续配置扫描；用完预算则找猫失败。 |
| `FACE_CAT` | 已停车，准备面向猫 | `SETTLE → CAT_CHECK → ORIENT`。 |
| `SETTLE` | 等停车后编码器不再变化 | 满足最低等待及安静时间，并收到停车后两次编码器样本，才进入 `CAT_CHECK`；默认 6 秒仍不能确认则找猫失败。 |
| `CAT_CHECK` | 请求并等一张新的停车后猫画面 | 有效、找到猫则执行保存的下一步；有效但没猫则开始两圈寻找；画面过期、无效或等画面超时则找猫失败。 |
| `ALIGN_CAT` | 按猫偏左/偏右每次转 `-20.25°/+20.25°` | 运动完成 → 停车 → `CHECK_ALIGN`；转向超时或失败走故障/结束路径。 |
| `CHECK_ALIGN` | 转向后重新检查 | `SETTLE → CAT_CHECK → ORIENT`。 |
| 对准判断 `ORIENT` | 这是判断步骤，不是独立驻留状态 | 中心误差默认 ≤5.5% 则执行计划行为；否则再转一小步。最多 8 次，超出报找猫对准失败；没猫转两圈找。 |
| `APPROACH_CAT` | 决定下一段慢接近距离 | 尚有距离且看到猫则 `CAT_DRIVE`；没猫则扫描并计划 `RESUME_APPROACH`；距离完成则重新面向猫观察。 |
| `CAT_DRIVE` | 按上一张停车画面授权前进一小段，默认 1 cm | 完成 → 停车 → `CHECK_APPROACH`；运动中不实时识别猫，启用前方避障时仅看 FLOOR。 |
| `CHECK_APPROACH` | 慢接近一段后重新看猫 | `SETTLE → CAT_CHECK → APPROACH_CAT`；猫不见则两圈寻找，找到继续剩余距离，找不到结束并报找猫失败。 |
| `PROBE_DRIVE` | 准备试探的当前一段 | 前方可走则进入 `PROBE_MOVE`。 |
| `PROBE_MOVE` | 试探前进，默认 3/4/3 cm | 每段完成 → 停车 → `CHECK_PROBE`；运动中不实时识别猫。 |
| `CHECK_PROBE` | 试探前进后重新看猫 | `SETTLE → CAT_CHECK → PROBE_DONE`；没猫则两圈寻找，找到后执行 PROBE_DONE。 |
| 行为 `PROBE_DONE` | 本段识别完成 | 进入 `PROBE_PAUSE`。 |
| `PROBE_PAUSE` | 各段默认停 700/900/600 ms | 前两段后继续下一段；第三段后面向猫观察。 |
| `ESCAPE_TURN` | 根据触碰位置先转向 | 完成 → 停车 → `ESCAPE_DRIVE`。 |
| `ESCAPE_DRIVE` | 准备逃跑直行 | 默认距离为 26 cm 减停车余量（默认 3 cm）；前方可走则 `ESCAPE_MOVE`；剩余距离为 0 则找猫。 |
| `ESCAPE_MOVE` | 慢逃/快逃直行 | 完成 → 停车 → `POST_ESCAPE`；运动中不实时识别猫。 |
| `POST_ESCAPE` | 逃跑结束后重新找猫 | 停车并两圈找猫，找到、对准后进入 `WAIT_CHASE`。 |
| `WAIT_CHASE` | 默认等猫追击 10 秒 | 时间到后重新面向猫，进入观察。 |
| `SIGNAL` | 原地灯光/蜂鸣 | 时间到关闭声光，重新面向猫观察。 |
| `OBSERVE` | 面向猫静止观察，默认 5 秒 | 时间到进入 `FOLLOW_WAIT`。 |
| `FOLLOW_WAIT` | 默认再等决策间隔 2.5 秒 | 机器人主动互动重新选择行为；猫主动互动按第 6 节选择或等待。 |
| `PREY_WAIT` | 装死停车，可附灯光/蜂鸣 | 新鲜画面仍看到猫、猫框小于远处阈值、无触碰，持续默认 5 秒才结束；默认最长 15 秒仍不能确认离开则故障，要求人工恢复。 |
| `END_SESSION` | 停车已确认，发 SESSION_STOP | `WAIT_SESSION_STOP`。 |
| `WAIT_SESSION_STOP` | 等会话关闭确认 | 清轮数、分支、后续标记，再发 SESSION_START。 |
| `WAIT_SESSION_START` | 等重开会话确认 | 回 PATROL 的 SCAN_TAG/TAG_REARM，继续原来的路线节点。 |
| `FAULT` | 停止、取消请求、关闭声光/会话 | 人工启动/恢复才再走启动流程。 |

`SLOW_APPROACH`、`PROBE_APPROACH`、`RESUME_APPROACH`、`STAY_SIGNAL`、`STAY`、`PREY`、`PREY_SIGNAL`、`END`、`CHOOSE_ROBOT` 是计划行为/后续目标，不能当成额外驻留状态。实际分别转入上表状态。

### WAIT_CHASE 名称补充澄清

你在测试中称为“wait change”的状态，当前代码里最接近且实际存在的名称是 `WAIT_CHASE`（等待猫追击），不是 WAIT_CHANGE。若当时屏幕确实显示其他拼写，需要以那次日志为准。该状态上表已经列出，但此前说明不够醒目。

实际顺序是：逃跑完成 → POST_ESCAPE → 停车 → 两圈搜索猫 → 找到并对准 → WAIT_CHASE → 等 `postEscapeWaitSeconds`（默认 10 秒）→ 再次面向猫 → OBSERVE。它不是等串口回复，也不是停车后识别延迟。三者对应不同设置：追击等待为 postEscapeWaitSeconds，停车识别最低等待为 scanMinimumMs，观察时间为 initialLookSeconds。

### WAIT_RELEASE 松开后的顺序

1. 左右都近，或者顶部/冲突/多位置要求找猫：两圈扫描。左右都近使用 flags=1；不倒退。
2. 否则探索分支执行声光，装死分支执行装死。
3. 否则要转的一侧太近：结束互动恢复巡游。
4. 左/右侧距任意一侧缺失或超过 2.5 秒：结束互动恢复巡游。
5. 转角为零直接准备逃跑；否则先转再逃跑。

因此：两侧都近可以走原地扫描路径；该路径在 Uno 只放行原地转动的侧距检查，仍然受触碰、会话锁等条件影响。

## 6. 观察之后是否继续：现在的真实规则

| 来源 | FOLLOW_WAIT 当前处理 |
| --- | --- |
| `ROBOT_SEARCH` | 每次重新判断猫：没有猫则找猫；有猫则按远近选择接近/试探/声光/观察。 |
| `CAT_TOUCH`，超过无新触碰时间 | 默认 12 秒则直接结束，未要求先确认猫离开。 |
| `CAT_TOUCH`，`followPending=true` | 默认 5% 三段试探、35% 观察、60% 直接结束；试探需要看到猫且冷却满足，否则该部分落入观察。 |
| `CAT_TOUCH`，已经做过这一次后续选择 | `followPending=false` 时不会自动再选下一动作，留在 FOLLOW_WAIT，直到新触碰、无触碰超时或会话上限。 |

这解释了“互动并不一直继续”：现有流程包含随机直接返回巡游、一次性后续选择和时间限制。

## 7. Uno 的两套执行状态机

### 分步扫描（找猫和找标签共用）

| 状态 | 处理 | 下一步 |
| --- | --- | --- |
| `IDLE` | 无扫描 | 收到合法 SR → NEXT。 |
| `NEXT` | 检查剩余角度预算，准备下一步 | 预算耗尽 → TERMINAL/NOT_FOUND；有预算 → TURN。 |
| `TURN` | 左右轮反向转一小步，默认 2 个编码器脉冲 | 本步完成 → SETTLE；运动拒绝/中止 → 终止。 |
| `SETTLE` | 等最低停车时间及编码器安静时间 | 默认最低 200 ms、安静 100 ms → WAIT_VISION；默认 3 秒仍没停稳 → SETTLE_TIMEOUT。 |
| `WAIT_VISION` | 发 VQ，让 ESP 用停车后的新画面识别；每 500 ms 重发请求 | VR FOUND → 终止成功；NOT_FOUND 且有预算 → NEXT；无效 → INVALID；默认等 3 秒 → TIMEOUT。 |
| `TERMINAL` | 发 SD 结果，停车 | 本事务结束；相同 id/generation 的 SR 重发不会重置扫描或重新转动。 |

总预算按两圈量化，默认几何得到约 718.875°。这是一轮寻找的预算；之后丢猫再找会启动新的预算。总扫描事务另外有不超过 600 秒的上限。ESP 会把收到扫描终止结果前的扫描用时加回 `sessionAt`，因此这段用时通常不计入互动时长上限。

| SD 数值 | 名称 | 猫扫描在 ESP 的处理 |
| --- | --- | --- |
| 0 | NOT_FOUND，预算用完没找到 | 报找猫失败，结束并恢复巡游。 |
| 1 | FOUND | 对准后执行保存的行为。 |
| 2 | INVALID | 报找猫失败，结束并恢复巡游。 |
| 3 | TIMEOUT | 报找猫失败，结束并恢复巡游。 |
| 4 | ABORTED | 若仍匹配当前扫描，报找猫失败；已被取消的旧扫描结果忽略。 |
| 5 | SETTLE_TIMEOUT | 报找猫失败，结束并恢复巡游。 |

### 普通运动与触碰

| 情况 | Uno 的现有动作 |
| --- | --- |
| 没运动 `MOTION_NONE` | 可接受下一条符合条件的运动指令。 |
| 持续运动 `MOTION_CONTINUOUS` | MOTOR 持续执行，等待 STOP、中止或替换。 |
| 定时运动 `MOTION_TIMED` | 达到截止时间结束。 |
| 脉冲运动 `MOTION_PULSES` | DRIVE/ROTATE/扫描按编码器目标执行；两轮各自到达目标后结束。 |
| 任意正常自动运动期间触碰按下 | 先中止运动/扫描，再报告 TOUCH。即使 ESP 忽略新的行为抽选，Uno 仍会停车。 |
| 触碰一直按住时又收到普通自动运动/SR | 拒绝：TOUCH_ACTIVE 或 SESSION_OR_TOUCH_LOCK。 |
| 会话已关闭 | 拒绝运动：SESSION_STOPPED。 |
| 已有普通运动/扫描不能接受另一运动 | 拒绝 BUSY。 |
| 编码器不前进、到期未完成、转向侧太近 | 中止并报告 ENCODER_STALL / MOTION_TIMEOUT / SIDE_* 等。 |

运动回报：AK 表示接收确认；MS 开始；MP 进度；MD 完成；MA 中止。触碰中止在 ESP 的 `motionFailure` 里取消当前运动/扫描，但仅直接返回，不自动保存和续做被打断动作；实际后续主要由 TOUCH 事件重新安排。

## 8. 共用重试、故障和退出条件

| 条件 | 当前行为 |
| --- | --- |
| 扫描配置 SC 收到 BAD_CHECKSUM/BAD_ENVELOPE | 等 100 ms 重发，首次之外最多再发 3 次。 |
| SC 没回复 | 每次等 2.5 秒确认超时，再等 100 ms 重发；超过次数则 FAULT。 |
| 扫描启动 SR 收到同类错误 | 立即重发相同 id/参数，首次之外最多 3 次。 |
| SR 没启动确认 | 从实际发送起 100 ms 后重发，最多 3 次。 |
| 普通 DRIVE/ROTATE/MOTOR 没确认 | 2.5 秒报 motion start not confirmed；当前没有相同的运动启动重试。 |
| 已开始运动，750 ms 没收到检查通过的进度回报 | FAULT。 |
| 真串口超过 2.5 秒没收到 Uno 消息 | Uno link timeout → FAULT。 |
| 普通会话相关等待未确认 | 2.5 秒重发，首次外最多 2 次，再失败则 FAULT。 |
| STOP 未确认 | FAULT/STOP_UNCONFIRMED，阻止后续运动。 |
| 猫对准超过 8 步，或一小步超过默认 5 秒 | 报找猫失败、结束互动。 |
| 猫停车后的画面过期、无效、等待超时 | 报找猫失败、结束互动。 |
| 猫扫描两圈未找到 | 报找猫失败、结束互动。 |
| 触碰默认 4 秒不松开 | 结束互动，不要求确认猫离开。 |
| 非 PREY_WAIT 互动时间达到默认 60 秒 | 结束互动；扫描等待阶段先处理扫描，不在该检查处结束。 |
| FOLLOW_WAIT 无新触碰默认 12 秒 | 结束互动。 |
| 后续选择抽中返回巡游，或轮数结局抽中 END | 结束互动，即使猫还在。 |
| 装死看到猫远离并持续默认 5 秒 | 结束互动；条件为有效新鲜画面检测到猫、宽度 < 默认 12%，且没触碰。完全看不到猫不会启动这个离开计时。 |
| 装死达到默认最长 15 秒且没有确认离开 | FAULT：MAX_WAIT_UNCONFIRMED。 |
| 逃跑/接近/试探准备阶段，前方连续默认 2 秒不能确认可走 | 结束互动；运动中明确看到前方 BLOCKED 也结束。 |
| 要转的一侧近，或等待松开后侧距过期 | 结束互动恢复巡游。 |
| 猫扫描侧障碍，且两侧都近 | 尝试 BOTH_SIDE_SCAN；其他互动侧障碍中止一般结束互动。 |
| 其他普通运动错误/中止 | 通常 FAULT；触碰中止有前述特殊处理。 |
| Uno 重启 / 人工停止 / 切换模式 | 停止，取消流程。 |

恢复巡游并不保证一定能走：后续找标签、转向和前进仍可能因为障碍或通信失败停在 FAULT。

## 9. 关键默认设置与未生效项

| 设置 | 默认 | 用途 |
| --- | --- | --- |
| `touchDebounceMs` | 1000 ms | 松开再拍是否算新一轮；不延迟首次响应。 |
| `endingAfterRounds` | 3 | 达到轮数时抽选收尾；0 禁用这一条件。 |
| `endingInactivitySeconds` | 12 秒 | 无新触碰结束；0 禁用这一条件。 |
| `sessionLimitSeconds` | 60 秒 | 非装死互动总时长限制。 |
| `initialLookSeconds` / `decisionIntervalMs` | 5 秒 / 2500 ms | 观察与后续决策间隔。 |
| `postEscapeWaitSeconds` | 10 秒 | 找猫、对准后等待追击。 |
| `captureWaitMaxSeconds` / `catLeaveSeconds` | 15 秒 / 5 秒 | 装死最长等待与远离确认时间。 |
| `catNearWidth` / `catFarWidth` | 35% / 12% | 猫框宽度比例的近处/远处判断。 |
| `visionMaxAgeMs` | 1500 ms | 画面可用于决策的最长年龄。 |
| `slowApproachCm` / `catApproachStepCm` | 9 cm / 1 cm | 慢接近总距离与分段距离；总距离先减默认 3 cm 停车余量。 |
| `escapeDistanceCm` | 26 cm | 逃跑距离，先减停车余量。 |
| `slowApproachPwm` / `probePwm` / `slowEscapePwm` / `fastEscapePwm` | 95 / 90 / 95 / 210 | 所有非零运动还受网页最低 PWM 值抬高。 |
| `minimumDrivePwm` | 140 | 未保存设置时的默认最低 PWM；实际值以已保存设置为准。 |
| `scanMinimumMs` / `scanQuietMs` | 200 / 100 ms | 停车后的最短等待和编码器安静时间。 |
| `farCatThresholdCm` / `catLeaveDistanceCm` | 40 / 70 cm | ESP 固件未使用；真实代码使用猫框宽度比例。 |
| `searchTimeoutMs` / `finalSearchTimeoutMs` | 15 / 8 秒 | ESP 固件未使用；真实扫描使用两圈预算和 SC 超时参数。 |

## 10. 仓库旧网页模拟流程：与 ESP 固件分开看

仓库还保留 `app.mjs` + `decision-system.mjs` 的电脑网页模拟流程。它不是当前 ESP 0.17 的行为执行器，不能用其说明替代上面的真实固件状态机。

旧网页的顶层也是 IDLE/PATROL/INTERACTION/ENDING。独立决策输出包括：PATROL、SEARCH_CAT_START、EXPLORE_SOUND_LIGHT、ATTACK_RESPONSE、SLOW_APPROACH、PROBE_APPROACH、STAY_SIGNAL、OBSERVE、STAY、END_SESSION；网页执行还提供 SEARCH_CAT_STOP、FAST_FORWARD、CAPTURE_WIGGLE、慢逃/快逃等动作。

其主要规则：HTTP_NEGATIVE 只在巡游触发主动互动；探索/捕猎分支一轮只抽一次，但触碰仍会记录攻击次数和互动轮数；后续按试探/观察/结束概率选择；轮数、无触碰超时、会话时长、失败、确认猫远离等会结束。旧网页远近判断按模拟摄像头的厘米距离；触碰回应失败会直接返回巡游。

旧 README 还写了“逃跑后找猫上限 360°、收尾 8 秒”等历史说明；它与当前 ESP 的两圈扫描不同。本次没有修改这些旧说明或旧网页。

## 11. 对照你刚刚提出的新要求：待你梳理，尚未实施

你提出的是：第一次猫响应优先打断其他任务；一旦进入互动，后续拍打不再新建响应或重新规划；除非猫退出，否则继续这轮互动。

需要重新定规则的现有位置：

1. 重复触碰会覆盖位置、增加轮数、重新抽具体动作，并停车重设下一步。
2. 机器人主动互动会被后续触碰切换为猫主动分支。
3. 多位置触碰会取消原流程，重新进入找猫。
4. Uno 每次触碰都会停车，持续按住拒绝运动；是否保留“临时停车、松开续做”需另定。
5. 无新触碰、互动时长、轮数、随机返回巡游，都不等猫实际退出。
6. 猫主动互动的后续只选择一次，之后可能留在 FOLLOW_WAIT 等超时。
7. 猫退出没有统一判断：装死只认“仍看到猫但已远”；其他阶段多通过扫描失败结束。
8. 画面无效、串口/运动失败和“猫真的走了”目前有不同出口，需要分别梳理，避免混为同一个条件。

本文仅供你逐项决定保留、删除或修改；代码基线保持不变。
