SaitoTommo/CatTeasingRobot/开关核查-20261012.md

# DEV 开关核查与修复（2026-10-12）

本次源码版本 ESP32_CAT_HOST_0.47_SWITCH_FIX，配套 Uno V6.13。实车测试结果待用户反馈后整理入项目日志。

## 问题与证据

用户在页面看到前向关闭，但标签很小就切换到下一目标。21:25:49 导出的本地日志回读 frontAvoidanceEnabled=false、tagStopWidth=0.2；同一 bootId 下 545762ms 进入 APPROACH_TAG，545763ms FRONT_BLOCKED，545765ms STOP，545775ms MOTOR_STOPPED，545776ms TAG_ARRIVAL/TAG_REACHED 46，随后 SCAN_TAG。这段没有前进命令，无法据此判断电机故障，也无法判断前向结果是真实障碍还是误报。

这是策略路径问题：approachFrontBlocked 和 approachFrontClear 未读取总开关，历史测试甚至要求关闭时仍拦截。另有 349852ms CONFIG_ERROR：NVS save failed; RAM applied but restart persistence unconfirmed。旧开关操作重写含地面参考的整份配置，因此 RAM 回读关闭不保证重启保持。

## 修复范围

前向两个共用判断现在先读取总开关。关闭时 blocked=false、clear=true；开启时保留有效性、标定、新鲜度与障碍优先判断。标签 APPROACH_TAG/TAG_ALIGN、TAG_RECHECK，猫 chooseRobot、APPROACH_CAT、CAT_DRIVE、CAT_CHECK，PROBE_DRIVE/PROBE_MOVE，以及既有逃跑、接触恢复和普通动作测试全部遵循该开关。关闭时猫移动/试探不再强制要求 FLOOR 识别；停车后仍按原流程识别猫。关闭不绕过标签/猫自身识别有效性、停车确认、失速、触碰或左右超声波保护。标签正常到达仍比较 tagStopWidth；开启前向时遇障后跳下一标签的旧规则保留。

开关单独保存为 NVS front 键的 0/1，写入并立即回读成功才更新单项开关的 RAM 值；失败报告错误，不声称成功。启动覆盖旧 config 开关；无该键时兼容原配置。完整配置成功保存后也同步独立键。页面按钮以板上回读为准，关闭文案说明接近同样关闭拦截，检测状态仍显示。

## 其他开关核查

| 控件 | 控制链路与实际范围 | 结论与证据级别 |
| --- | --- | --- |
| 前向避障 | 页面 config → 独立 NVS/readback → 全部前向策略判断 | 已修复；开/关、无效/未标定、新帧、宽度到达与重启存储离线验证 |
| 模拟 / Real UART | mode → 停车、清会话、接收源匹配 → 真实/模拟发送 | 源码核查及既有静止 UART 验证；重启默认 SIM_UNO |
| 遥控进入 / 退出 | STOP → SESSION → CONFIG 能力 → ACTIVE，退出先停车 | 原确认匹配修复已部署验证；开关控制者、释放及超时离线检查 |
| 动作测试绕过全部避障 | bench_safety → manualBypass → TEST_MOTOR BYPASS/SAFE，Uno motionBypassAvoidance | 源码核查与现有 UI 检查；仅动作测试，非自主巡游设置 |
| 显示预览 / 显示猫框 | 本地选项 → JPEG/视频显示与画框；不改变策略 | 页面测试通过；隐藏预览不等于关闭识别 |
| OFF/TAGS/CAT/BOTH | visionMode → 待机 USER；运行中由 policyVisionMode 与显式票据选择 | 生效范围是待机识别模式；自主会覆盖，以 actualVisionMode 为准，非关闭自主感知的总开关 |
| 性能测试启停 | visionBench → 采集/识别循环与间隔，关闭恢复正常模式 | 源码核查、性能页面测试；只在本次上电保存 |
| 摄像头 aec/agc/awb、aec2/awb_gain、raw_gma/lenc、hmirror/vflip | 值范围校验 → 传感器 setter → 实际回读 → camera NVS，失败回滚并报错 | 摄像头驱动/运行时离线验证；自动曝光/增益打开时手动值可能不决定实时值 |
| ESP 灯开 / 关 | manual_test → hostLedManual → GPIO21，独立 mode4 防止迟到 Uno 回报覆盖 | 源码核查；自主声光接管/STOP 可改变灯，不是永久禁用灯开关 |
| Uno DRY_RUN/LIVE、DEBUG_IO ON/OFF（原始串口诊断） | 串口命令 → physicalIo/输出与中断绑定、注入门禁 | 源码核查；本轮不改变 Uno，也未操作实车诊断开关 |

未发现上述其他开关与前向开关相同的遗漏。此结论不等于逐项实车验收；运动、摄像头自动控制实际效果、超声波与触碰物理行为仍由实测确认。左右超声波卡片目前提供阈值设置，没有独立启停开关，不把阈值当作开关。

## 验证与回滚

针对性检查输出、烧录前后状态和应用备份位于 evidence/switch-audit-20261012/。大体积固件与历史 evidence 不加入 Git。烧录前保存 0.46 串口状态并核对回滚应用的 ROM 摘要；本次仅更新 ESP 应用分区。应用回滚不恢复 NVS；回滚到 0.46 不读取独立 front 键，将使用旧 config 的开关，需要重新核对。完整原始 Flash 备份另见遥控与续寻说明。

扩大回归补充发现：页面按钮确认切换后，全部参数 JSON 曾保留旧前向值，后续保存可能恢复旧开关。现仅在板上开关回读变化时同步该字段，保留其他参数草稿和未完成的 JSON；未确认的切换不改草稿，用户直接编辑高级开关时的普通轮询不覆盖其编辑。增加专门页面回归检查。

最终部署结果：ESP 0.47 已烧录，86 项网页检查与完整原生回归通过（包含前向分支 144、开关存储 8、遥控 71、路线 19 等）。最终编译 Flash 3833626/8257536 字节、静态 RAM 85992/327680 字节。写入 Hash 与独立 ROM 摘要均匹配；真实 ESP 静止状态开关开启/关闭写入回读通过，复位后 frontAvoidanceEnabled=false、路线 [43,46,51]，全部 config 与本轮烧录前一致。未发送运动或巡游指令。当前重启默认 SIM_UNO，真机测试需切回 Real UART。完整实车接近验收与当天开发总结待用户反馈后写入项目日志。

## 2026-10-13 用户验收补记

完成上述部署后，用户反馈“测试没问题”。本轮接近／前向开关问题记为已部署、用户实测通过（定性反馈）；未提供测试次数、模式或距离，不扩展为其他历史故障全部解决。助手当时静止验证范围与原 validation.json 保持不变。近期聊天补漏与当天开发总结已写入《项目日志.md》2026-10-13 节。
