SaitoTommo/CatTeasingRobot/遥控与续寻.md

# 手机遥控与指定标签续寻

DEV 配对版本：ESP `0.47_SWITCH_FIX`、Uno `V6.13`。顶部注释、ESP `/api/state` 和 Uno `READY` 回报使用这些版本号。部署结果另见项目日志。

## 使用

连接 ESP 热点后打开 [板载页面](http://192.168.4.1/)。真机操作需选择 Real UART，并接好 ESP↔Uno 通信线；SIM_UNO 只接受模拟来源回报。遥控启动会检查 Uno 的 `REMOTE_V1` 能力，旧 Uno 或旧模拟器不会被当作支持遥控。

- **自定义巡游路线**：在巡逻或遥控卡片中填写标签 ID 顺序（如 `43, 46, 12, 46`，支持空格、箭头或 JSON 数组），点击“保存巡游路线”。先停止巡游或退出遥控，并确认停车。两个编辑框同步，轮询不覆盖未保存草稿；以 ESP 写入成功回报及路线回读确认保存。路线重启保留。
- **巡逻与续寻卡片**：无需进入遥控即可输入标签 ID、选择路线节点、点击续寻。普通“启动巡游”从首节点开始。
- **手机遥控与续寻卡片**：点击进入遥控，等待停车、锁定、配置能力检查和解锁确认；按住前/后/左/右控制运动，松手停车。左/右是原地转向。PWM 0–255，默认 100，独立于自主最低 PWM；低 PWM 不保证实车能起转。
- 两处输入框搜索**已经保存的路线**，不会新增标签或修改路线；同一 ID 的重复节点显示各自序号，两处选择同步。续寻先寻找该节点，随后沿原路线循环，不把选择当作到达。
- 遥控中也能从该卡片启动巡游或续寻。程序先退出遥控、关闭声光、确认停车和会话锁定，再启动自主扫描；恢复自主保护。
- 蜂鸣器可选择长响（600 ms）、两声短响（180 ms，第二声在 800 ms）、三声短响（150 ms，起点 0/600/1200 ms），或按住鸣叫、松手静音。按住鸣叫取消旧声音模式。
- 随机灯光从不亮、常亮、慢闪、双闪选择，相邻不重复；节奏与时长复用自主探索定义。关闭声光不取消正在按住的移动。

## 保护与状态

遥控期间绕过前向、左右障碍及触碰保护，页面持续显示这一状态；原始观测仍正常显示。自主策略的避障设置不被改写。失速、急停和通信停车保留。

方向与按住鸣叫每 150 ms 续期一次，各自最多有效 600 ms；网页松手、触摸取消、失焦和隐藏会发出停止请求。Uno 在 ESP 或网络失联时也会本地结束遥控运动并锁定会话。相同方向续期不会重置失速计时。超时或故障后必须重新进入遥控并再次按下，旧请求不能恢复运动。

遥控使用单控制者会话和递增序号，切换模式或设备重启使旧会话失效。停车未确认时禁止新运动与续寻。HTTP 返回 `queued:true` 只是请求入队；以板上状态和 Uno 回报确认操作结果，PWM 回报也不等于实测转速。

避障、猫识别、标签识别分别展示。过期、无效、未开启识别、有效未检出和设备断线有不同提示；它们不表示空间畅通或目标不存在。

## 接口与兼容性

- `/api/input`：`op:remote`，动作 `enter/heartbeat/move/move_stop/beep_hold/sound/light/quiet/exit`；进入携带 `client`，后续请求携带 `client/session/seq/expectedMode`。
- 路线保存接口：`{op:"route_save",requestId:"唯一请求号",route:[43,46,12,46],expectedMode:"UART"}`；`/api/state.routeSave` 返回对应请求的 saved/error。保存不启动巡游。
- 两个卡片调用同一续寻接口：`{op:"control",action:"resume_from",index:1,route:[9,46,40],expectedMode:"UART"}`。`index` 为零基路线位置，`route` 必须与当前板上路线一致；旧 `start/resume` 仍从首节点启动。
- `/api/state.remote` 返回会话阶段、执行确认、请求 PWM、声光状态、能力和错误。
- Uno 新增 `TEST_MOTOR <leftPWM> <rightPWM> <50..600ms> REMOTE`；只更新已有遥控运动，其他运动仍返回 BUSY。`SAFE/BYPASS` 原语义不变。`GET_CONFIG` 末尾追加 `REMOTE_V1`，新 ESP 接受新旧配置回报。
- 老 ESP 的严格配置解析不支持追加标记，因此回滚配对固件时须同时恢复旧 ESP 和旧 Uno。

## 验证与回滚

离线回归覆盖接管、松手、变速、方向更新、心跳失效、失速、旧协议拒绝、迟到请求、重复标签节点、路线变化及自主保护恢复。现场仍需验收真机方向、速度、声光、断开网页停车和续寻，不以离线测试代替实车行为。

原 ESP 回读状态和完整 8 MB Flash、原 Uno Flash 备份保存在 `evidence/remote-resume-20261012/`，不把大二进制纳入 Git。ESP 仅更新应用分区；原 NVS 和分区表保留，上传前逐字节核对分区表。两端上传后分别做 Flash 读回比较和实际版本回报核对。

需要回滚时使用原始备份或 `rollback/front-avoidance-baseline-20261011` 的源码构建；先停车并断开运动控制，核对设备 ID、端口与备份校验值。完整 Flash 备份会恢复 NVS，应用分区备份则保留当前 NVS；根据需要明确选择。回滚操作不自动执行。

0.44 修复遥控接管超时：实际 Uno GET_CONFIG 以裸 `DONE <id>` 完成，ESP 现在识别此格式；STOP/SESSION 确认仍检查对应完成原因。

0.44 部署检查：写入哈希校验和独立 ROM Flash 摘要校验成功；真 UART 已通过静止进入/退出遥控及保存现有路线确认。0.43 应用回读备份保存在 evidence/route-editor-20261012/esp-before-app.bin，恢复到 0.43 可保留 Uno V6.13。0.42 配对回滚仍须同时恢复旧 Uno。

0.45 将路线单独保存在 NVS `route` 键，避免每次编辑路线都重写较大的配置字符串。启动优先读取独立路线，未保存过时继续使用原配置中的路线；旧配置、摄像头设置和地面参考不被删除。保存后立即回读核对，再显示成功。

0.45 实际部署：已保存用户路线 `43 → 46 → 51`，复位后仍回读三节点；列表包含末节点 51，续巡请求采用节点位置 2。应用 Flash 摘要校验成功，未发送巡游或移动指令。回滚 0.44 会使用旧 config 内的路线（本轮基线为 43、46），它不读取新的独立 route 键。

0.46 页面布局：电脑顶部左侧为 UART／巡游与自定义路线，中间为摄像头预览及其正下方的前向避障／超声波状态，右侧为遥控。宽度不超过 1000px 时依次显示 UART／巡游、摄像头、遥控、避障；猫和标签识别状态随后显示。控制协议和路线保存方式沿用 0.45。

0.47 统一前向开关：关闭后标签与猫接近、试探和停车复核同样不受前向结果拦截；开启时保留原前向优先规则。单项开关独立 NVS 保存并立即回读，启动恢复；完整核查及其他开关的作用范围见 [开关核查](./开关核查-20261012.md)。实车结果待用户反馈后整理到项目日志。
