SaitoTommo/CatTeasingRobot/猫流程版本说明-20261006.md

# 0.40 猫流程维护版与 0.42

2026-10-06。0.40维护分支 maintenance/0.40-cat-flow 从2361672建立（该基线固件0.40，含此前文档，未包含0.41标签恢复）。版本 ESP32_CAT_HOST_0.40.1_SIMPLE_CAT_FLOW。

主动找猫和被抓后找猫共用扫描后的停稳确认：匹配STOP回报、两次后续编码器采样、零RPM、最短停车和静默窗口满足后请求新画面。不再额外等待catConfirmWaitSeconds。CAT_CONFIRM与CAT_CHECK同样最多catCheckMaxFrames次（1–3），任一次找到立即通过；不是要求三次阳性。有效负帧才重试，旧帧和错代次不计数；无效、超时保留原故障处理。

快/慢接近一次下发剩余完整距离，不再每catApproachStepCm停车识别。完整动作结束仍停车复查；试探动作保留原三段及停顿。触摸、通信、编码器、障碍保护与五次高层动作预算保留。运动中不持续识别猫，因此不会实时按猫框宽度提前结束这一段；最大距离受已有接近距离配置限制。编码器完成不证明实际车身位移。

旧NVS字段不删除、不重写：catApproachStepCm和catConfirmWaitSeconds列入unsupportedSettings；移除页面确认额外等待字段。路线ID、顺序及摄像头配置保留。0.40维护版不包含标签方向恢复。

离线验证：11个原生测试程序全部通过；59项Node页面/预览/日志/性能测试通过。新增真实policy回归覆盖整段快/慢接近、完整动作计数、两种确认入口第1/2/3帧命中。构建及烧录证据见 evidence/cat-flow-20261006/。本次用户随后明确授权只烧录0.40维护版，0.41/0.42禁止烧录。

0.42已以0.41为基础合入同一简化改动，使猫与标签共用TargetRecoveryMemory与startTargetRecovery/advanceTargetRecovery有界局部/反向/剩余全扫恢复引擎。猫不使用标签直行宽限；局部角度复用tagRecoveryAngleDeg，页面明确标为猫与标签共用，旧配置无需迁移。新画面匹配代次与步骤后才更新记忆，恢复成功继续原动作及剩余距离；停止、新互动、配置/摄像头变更、通信恢复清除记忆。两种目标各保留识别和完成条件，猫不采用标签的直行丢失宽限。0.42仅离线验证。

0.40.1应用3793024字节，COM11仅写0x10000，哈希校验、USB及HTTP回读通过；回读IDLE/SIM_UNO，已有策略配置变化零项，未做运动验收。维护版二进制保留evidence/cat-flow-20261006/firmware-040.bin。0.42的13个native程序通过（新增猫恢复111项），网页61项、状态清单2项通过；未烧录。
