SaitoTommo/CatTeasingRobot/新会话实施提示词.md

最新状态：ESP0.13完整编译通过（Flash3717266，静态RAM78792 bytes），用户已报告正在自行上传。助手未操作设备，上传成功及实际NVS保存/运动效果仍待确认。

2026-10-03新增：ESP源码0.13提供 minimumDrivePwm（默认140，整数1–255，NVS保存），网页确认停车后动态设置。统一 sendUno 在 CRC 前提高非零PWM幅值，保留方向与0；全自动/扫描/手动/原始运动命令适用，UnoV6.6保持不变。新增验收在统一验收记录第5节；尚未上传，RESET/界面/运动由用户操作。

# 2026-10-03 本轮执行进度补充

以下旧提示词是历史需求与现场状态，不自动构成新会话操作授权。本轮用户已在聊天批准实施、基线和关键节点 Git 提交，并允许上传代码；RESET、界面操作和运动测试仍由用户完成。当前源码 Uno V6.6 / ESP 0.12；离线原生与 Node 测试及编译通过，尚未上传和实机验收。使用《统一验收记录.md》《配置接入表.md》《扫描协议.md》继续，不拿旧模拟或历史短测当新版本实机证明。标签宽度保存值保留，未配置默认.25；所有搜索最多两圈；慢接近猫每段停稳后新帧识别，丢猫两圈重找、失败回原路线并保留找猫失败记录。

以下保留实施前上下文：

# 新会话实施提示词

以下内容可直接复制到新会话。状态表、To-do、测试矩阵和四张 Mermaid 图在同目录 `机器人状态机与测试清单.md`。

---

请继续我的 ESP32-S3 + Arduino Uno 猫互动机器人项目。工作目录：

`D:\data\SynologyDrive\文档\论文+学习\Embodied behavior design for social context`

主仓库 `uno-web-lab`。先读取适用的 AGENTS.md（若存在）、`uno-web-lab/机器人状态机与测试清单.md` 和 `uno-web-lab/项目日志.md`，再核查实际源码。状态表和图是目标设计，不是已完成实现；不要据此宣布功能已通过测试。

**当前 Uno 失联，我不在设备旁，无法 RESET。现在只做离线代码、文档、测试和编译，不要发设备命令、开电机、复位、上传或自动启动测量。等我回来恢复设备并明确告诉你设备准备好了，再进行实机操作。失联后不要继续递增 PWM 或依靠自动烧录恢复。**

最近烧录记录：ESP `ESP32_CAT_HOST_0.11`、Uno `UNO_CAT_V6.5`。V6.5 只移除了非零 PWM 120 下限，允许 1..255；编译 Flash 30774/32256、静态 RAM 1307/2048，已经上传过。分级测量取消，无可确认结果，最低启动／维持 PWM 尚未知。USB `app.mjs` 仍期待 V6.4，请核查兼容。

两份 Uno 源码必须同步：
- `uno-web-lab/firmware/UnoCatController/UnoCatController.ino`
- `uno-firmware/UnoCatController/UnoCatController.ino`

ESP 策略是 `uno-web-lab/esp32-host/ESP32CatHost/policy.cpp`，参数 `policy_defaults.h`，视觉与串口在 ESP 主固件。保留已有未提交改动，不自行清理或提交。

我的要求：

1. 路线数量、ID、顺序由我在网页输入，不可写死。网页显示找标签／靠近标签、真实子步骤、当前目标／路线位置、大小／阈值、观测年龄、动作确认和停车原因。
2. 有效新帧识别到当前 ID 就算找到，开始靠近；无需 25% 或居中。停止靠近的大小阈值单独可调，达到即停车，无需居中。现有 tagStopWidth 是宽度比例，不是面积比例；新默认值未确定，不混用单位。
3. 搜索低速“转一步→停稳→识别”，Uno 管电机计数、停稳、等待识别，ESP 管视觉与决策。实现独立 SCAN_ROTATE；保留不侦查的 ROTATE angle pwm 和手动持续 MOTOR。先核查现有 ROTATE／DRIVE 的参数与完成语义。
4. Uno 停稳后发请求，ESP 用请求之后新捕获帧识别，响应匹配 scanId、stepId、generation；去重并拒绝旧结果。跨板 millis 不能直接比较。识别等待、总步数／角度／时间都有限，不能重新引入 KEEP／续行租约。
5. 搜索按停稳事件识别，网页持续识别开关可额外启用；**靠近标签自动持续识别，每个新有效帧实时决定停止／纠偏**，不等下次扫描或网页刷新。视频预览独立。丢失／过期则停并有限重获。
6. 猫触碰／攻击最高行为优先级：Uno 立即停，ESP 抢占巡游、扫描、推理等待、旋转与直行。旧推理／完成通知不能恢复旧动作；操作员 STOP 和内存锁定不可被互动覆盖。仅看到猫不打断巡游，仍由真实触碰／明确 alert 触发。
7. 完整覆盖猫行为：主动找猫、朝向、慢接近、三段试探、原地声光、观察／静止；猫触发的四模式声光探索；捕猎可选短提示、静默被捕获、慢逃／快逃、释放等待、逃离转向／直行、等待追逐；结束回巡游／静默捕获／提示捕获、确认离开／等待故障。保留概率、冷却、轮数、防抖和会话规则，参见状态表。
8. 逃离策略尚未最终确定，不能默认看到猫就转 180°。可提议 ESP 按猫位置／触碰面／有效侧距选方向，Uno 纯角度旋转和有界距离执行；无效侧距不因侧向检查停，但不等于已确认畅通。没有后向超声波，不能虚构后向测距。
9. 前向检查仅 ESP 判断并 STOP，保留开关；Uno 不检查前向。侧向超声波归 Uno，默认／最小 1 cm，仅新鲜有效值严格小于阈值停车；无效／过期不因该检查停。触碰、失速、内存保护、可靠停车保持。
10. 保留两端 57600、无 KEEP、紧凑 50 字节 TB 遥测、200 ms MP、2000 ms 遥测查询、CRC 和非零编号匹配；STOP 确认前不发后续运动，发送／ACK 不能代替停车证明。

先核查这些核心问题：
- 搜索／对准／接近共用 SCAN_TAG 和搜索预算，需拆开，避免已找到仍报搜索耗尽。
- ESP angle() 多除一个 PI；修正并测试。67.5 mm 轮径、120 mm 轮距、20 脉冲/转，两轮对转各一个脉冲理论约 10.125°，不承诺 1° 精度。
- 重复 ID／循环不能旧帧跳节点，到达停车确认与重新布防要明确；互动回来续原路线。
- captureCueFlashMs、captureCueBeepMs、touchFeedbackBeepMs 在 ESP 对应路径硬编码；align/finalSearch 超时及厘米猫距离参数可能未接入。逐一追到核心，接入或明确不支持。
- 多标签＋角点＋floor 可能超过约 4096 字节，被 toCharArray 静默截断；需要长度保护和队列丢弃可观察。
- ROI 改动应使旧地面校准失效；ESP 几何保存不等于 Uno 已应用；UI 不从旧 observation.policy 取最新路线。
- 命令 #0 仍显示旧 PWM 的故障展示要纠正；前向关闭时逃离不要被无关旧相机观测卡住。
- STAY／OBSERVE 当前执行合并；声光离开分支应清理，不留下提示。

先给源码核查后的具体实施顺序，再完成不依赖未定选择的离线实现、有效的协议／状态机测试和两端编译，持续更新日志与图。界面→核心→协议→Uno 执行必须贯通，不要只做展示或模拟成功。未定的默认阈值／逃离规则应清楚说明并询问，不能擅自宣称已批准；继续做独立工作。

实机恢复后的测试另排：左右正反分级 PWM、角度／滑行／停稳、TAGS/CAT/BOTH 推理时序、UART 延迟、多个标签完整流程、四面触碰与全部猫分支、至少 10 分钟分场景稳定性。既有 BOTH 耗时 477–531 ms、相机缓存约 5.06 fps 仅是旧样本，识别 fps 尚未直接测量。

编译参考：Arduino CLI 路径 `D:/software/arduinoIDE/Arduino IDE/resources/app/lib/backend/resources/arduino-cli.exe`；ESP FQBN `esp32:esp32:XIAO_ESP32S3:PSRAM=opi,PartitionScheme=max_app_8MB`；优先英文临时构建路径。历史串口 Uno COM10、ESP COM11，历史 ESP 地址 192.168.137.15，均不代表允许当前访问或测试设备。

最终交付同步源码、真实状态网页、通过的离线测试／编译、更新的状态表／图／项目日志和未做的实机项。源码验证、编译、烧录、实机功能、长期稳定性分开报告，不能互相替代。
