SaitoTommo/CatTeasingRobot/配置接入表.md

# 当前 ESP 配置接入表（0.13）

日期：2026-10-03。保存前校验，保存后从 `config` 回读。所有配置更改要求可靠停车；保存不是执行回报。

| 配置 | 默认 / 单位 | 当前执行位置 |
|---|---|---|
| route | 未配置；数字ID数组 | policy 当前路线索引，1–128节点、ID0–586，重复节点需重新布防 |
| tagStopWidth | .25，标签宽度/画面宽度 | 每个新有效标签帧，优先于居中；保存值优先；页面百分比除100 |
| minimumDrivePwm | 140，整数1–255 | ESP sendUno统一处理非零PWM，正反号及0保持；NVS保存，确认停车后可调；包括扫描、直行、纠偏、手动测试和原始运动命令 |
| patrolSearchPwm / patrolAlignPwm | 45 / 30，请求值 | 标签SR扫描 / 小步ROTATE纠偏；实际下发幅值至少为minimumDrivePwm |
| searchPwm / alignPwm | 75 / 52 | 猫SR扫描 / 小步ROTATE朝向 |
| scanStepPulses | 2，整数脉冲1–64 | SC/SR每轮每步目标；总预算由真实Uno GET_CONFIG几何换算两圈 |
| scanMinimumMs / scanQuietMs | 200 / 100ms | Uno扫描停稳；ESP慢接近/朝向停车后编码器采样 |
| scanVisionTimeoutMs | 3000ms | 每次停稳新帧等待；不是整次搜索只有3秒 |
| scanSettleTimeoutMs | 3000ms | Uno停稳上限，大于两个窗口 |
| catSettleTimeoutMs | 6000ms | ESP在DRIVE/ROTATE停车确认后等待两次新编码器采样；保留2000ms遥测周期 |
| catApproachStepCm | 1cm，上限.5–3 | 慢接近每段DRIVE距离；实际距离按两轮真实脉冲扣除剩余量 |
| slowApproachCm / slowApproachPwm / stopMarginCm | 9cm / 95 / 3cm | 慢接近总目标先扣停止余量；重找成功不重置距离 |
| probeStep1/2/3Cm、probePause1/2/3Ms、probePwm | 3/4/3cm、700/900/600ms、90 | 三段试探与暂停，真实MD才完成；每段后停稳识别 |
| escapeDistanceCm、slowEscapePwm、fastEscapePwm | 26cm、95、210 | 有界DRIVE逃离，保留停止余量；纯转向由首次触碰位置决定 |
| captureCueFlashMs / captureCueBeepMs | 2200 / 360ms | 提示捕获真实LED FLASH/BEEP，不再硬编码 |
| touchFeedbackBeepMs / touchFlashPercent | 180ms / 20% | 捕猎前可选短提示；停机事务后执行 |
| signalFlashMs / signalBeepMs | 1400 / 180ms | 普通原地声光；退出清提示；探索四模式保持既有固定节奏池 |
| alignTimeoutMs | 5000ms | 每次有界朝向/标签纠偏等待；另有8次调整上限 |
| catNearWidth / catFarWidth | .35 / .12，猫框宽比例 | 主动远近分支 / 捕获后确认远猫；不是厘米 |
| visionMaxAgeMs | 1500ms | 真实采集年龄；推理开始不能把旧照片刷新为新观察 |
| frontAvoidanceEnabled | true | 仅ESP前向检查；移动中可只处理FLOOR，不运行CAT |
| floorRoiTop / floorReference / frontCalibrated | .75 / 空 / false | 地面外观参考；改ROI使旧参考失效，重新校准，不是深度测量 |
| 所有概率、冷却、轮数、防抖、观察/追逐/会话参数 | 保留原默认值 | chooseRobot/onTouch/FOLLOW_WAIT/PREY_WAIT等；概率组校验总和100；搜索时间单独计账，不在旧60s时限截断正常两圈 |
| wheelMm / trackMm | 67.5 / 120mm，ESP保存值 | SIM几何设置；实体决策只采用当前GET_CONFIG的真实回读；ESP保存不代表已写Uno |
| Uno左右净空 | 默认1cm，RAM，重启恢复默认 | 单独SET_SAFE_DISTANCE + GET_CONFIG回读；严格小于有效新鲜阈值才停；无效/过期不是受阻 |

当前 ESP 不使用 `farCatThresholdCm`、`catLeaveDistanceCm`（无可靠厘米猫距离），也不使用旧 `searchTimeoutMs`、`finalSearchTimeoutMs` 截断两圈扫描；页面与快照明确列出。旧电脑模型仍可能使用这些旧参数，不能混当ESP执行。

总扫描时间按剩余步数×（每步10s运动上限+停稳上限+识别上限）推导，最大600000ms；每步运动/失速可提前失败，不宣称一定转满。双侧例外仅flags=1的有限原地扫描，必须有新鲜双侧证据，不能用会绕过触碰的BYPASS。
