SaitoTommo/CatTeasingRobot/实施计划与人工验收.md

# ESP32 + Uno 实施计划与人工验收

日期：2026-10-03。状态：用户已在聊天批准执行，源码与离线自动化已实施；上传及现场验收尚未执行。

本计划以用户本次要求为执行边界，以《新会话实施提示词.md》《机器人状态机与测试清单.md》为需求背景，再对照当前源码制定。附件中的“继续实现”“编译”等文字不构成本次实施授权。用户随后在聊天批准实施和关键节点提交 Git，并允许直接上传；RESET、界面与运动测试由用户完成。以下初始源码核查表保留为实施前基线，最新实装与验收结果见《统一验收记录.md》《配置接入表.md》。

## 1. 本次边界与已经确定的选择

- 保留既有修改，不清理；按用户后续批准先提交基线，再在关键节点提交 Git，提交说明包括验证和未验证范围。
- 我运行自动化测试与离线编译；用户已允许我上传代码，但不允许自动 RESET。设备准备、按键复位、浏览器操作、架空轮和落地测试由用户完成；不使用 computer use。上传前需用户确认现场准备和端口。
- 离线工作不需要 Uno RESET。现场恢复需要时明确告知用户原因、操作和恢复标准，等用户确认再继续。
- 不依据历史 COM10/COM11、IP 或烧录记录连接设备。附件报告的失联状态未在本次实时核实。
- 已确定：标签停车使用“标签宽度 / 画面宽度”；保留用户保存值，没有保存值才用 0.25。它只决定停车，不决定是否找到标签。
- 用户补充规则：顶部触碰、触碰与画面冲突、多个位置触碰时，以第一次触碰为依据，分步找猫最多累计转 720°；找到提前结束，找不到回原路线巡游。想转方向有近障碍或所需信息已经过时则尝试恢复巡游，巡游无法继续则停止。
- 用户最新补充：所有找猫、找标签均以两圈（720°）为搜索上限，包括主动找猫、触碰找猫、正常标签搜索、丢失后重获、左右受阻时原地找猫；找到目标立即结束搜索。本条替代先前的任何一圈搜索安排。
- 左右都有近障碍时直接原地转，不先倒退；该分支同样最多 720°。该分支需要单独允许侧距过近时的原地旋转，普通运动的侧向规则不变；触碰、失速、STOP、内存保护保留。整体计划仍待批准。
- 用户最新要求：把现在已经存在的找猫及其后续互动状态机完整纳入计划，最后与新功能一并验收。既有且符合要求的行为可以不改，不能因为本次没有改过就免验收；现有流程与用户已经确定的新规则冲突的部分仍按新规则实施。详见第 3.1 节和最终验收清单。
- 用户最新补充：慢接近猫时不持续识别猫，改为走一小段→停车并停稳→识别新画面；新有效帧看不到猫则分步旋转寻找，最多两圈。找到则回慢接近流程，仍找不到则结束本次互动、继续原路线巡游，并回报“找猫失败”。标签靠近的自动持续 TAGS 规则不变。详见第 3.1.5 节。

## 2. 当前源码核查结论

| 核查项 | 当前事实 | 实施影响 |
|---|---|---|
| Uno 双份源码 | 两份 SHA256 一致，声明 UNO_CAT_V6.5，非零 PWM 下限为 1 | 每阶段保持一致；“实测至少 120”旧注释需要纠正，最低可运行 PWM 仍待测 |
| USB 网页握手 | app.mjs 精确期待 V6.4 | 更新受支持版本/能力检查，旧板不允许发送新扫描指令 |
| 路线 | ESP config.route 支持 1–128 个 ID；USB app.mjs 仍固定 A/B/C/D | 主运行路径使用用户数字 ID 数组，旧 USB/模拟入口不得展示固定路线冒充同一功能 |
| 标签巡游 | policy.cpp 共用 SCAN_TAG；先纠偏，再比较 tagStopWidth；到达立即推进索引，只等待 500 ms | 拆状态、预算与到达停车确认；旧帧不能推进下一节点 |
| 转角 | ESP angle() 多除一次 PI | 正确公式为 (左右脉冲之和) × wheelMm / 20 / trackMm × 180，仅适用于当前两轮反向旋转计数约定 |
| 本地动作 | DRIVE cm pwm，范围 -100..100 cm；ROTATE degrees pwm，范围 -360..360°；非零，PWM 1..255 | 都按几何换算每轮目标脉冲，四舍五入且至少 1 脉冲；两轮均到目标才完成；本地 10 s 上限 |
| 完成与中止 | Uno MD 带匹配编号和两轮脉冲，MA 带原因；均带 CRC | ESP 当前策略没有消费 MD 分支，逃离仍使用 MOTOR 和 ESP 角度判断，必须接入真正完成事件 |
| 触碰停车 | Uno setTouch 中先串口报告，再 abortMotion；扫描尚不存在 | 本地先关电机并取消扫描，再安排报告，减少日志输出对停车的拖延；实际时延仍需实测 |
| 视觉 | visionTask 拷贝最新 JPEG 缓存；processVision 用推理开始时间写 at，没有关联采集帧编号 | 新增真实帧身份、采集时间、请求代次；缓存晚更新不能证明照片在请求之后拍摄 |
| 队列 | Input.text 为 4096 字节；enqueueCamera 的 toCharArray 可能截断，忽略 xQueueSend 失败 | 控制和视觉分开调度；完整长度检查、丢包计数；不得用截断数据刷新观察 |
| 协议容量 | Uno 行缓冲 128 字节，解析器最多 8 个词，包括信封和命令 | 新扫描字段必须紧凑编码或拆为配置/执行接口，不能直接塞入长参数列表 |
| 配置接入 | 捕获提示/触碰提示部分写死；alignTimeoutMs、finalSearchTimeoutMs 和厘米猫距离未在当前 ESP 策略路径使用 | 为每个参数建立配置→校验→执行→回读映射，未支持项明确显示 |
| 显示和校准 | ESP 页面从 vision.policy 取路线索引；ROI 保存未使旧校准失效；故障可能 motorId=0 仍保留旧 PWM | 以最新策略快照显示，分开请求值/真实输出/历史命令；ROI 变更使参考失效 |

Flash 30774/32256、静态 SRAM 1307/2048 是日志中的上次 Uno 编译结果，本次未重新编译。新增扫描必须逐阶段检查实际容量，不能假定能直接塞入；不能靠删除触碰、失速、CRC 或内存保护来腾空间。

## 3. 实施顺序与代码范围

### 阶段 A：协议、动作和停车基础

涉及两份 UnoCatController.ino、ESP32CatHost.ino、policy.cpp、policy_ids.h、core.mjs、compact-telemetry.mjs、app.mjs。

1. 写出扫描协议规范：SCAN_ROTATE、停稳识别请求、识别结果、扫描完成/中止。关联键包含 scanId、stepId、generation；命令编号非零；各消息 CRC 校验。
2. 计算最大编号、参数和 CRC 时的帧长、词数、接收/发送缓冲占用及新增 SRAM；必要时使用短命令别名/紧凑字段，保持公开动作语义清楚。
3. 保留三个独立动作：SCAN_ROTATE 用于转动后识别；ROTATE 用于不识别的指定角度；MOTOR 用于手动持续运动。DRIVE 保留本地有界距离语义。
4. 接入 MS/MP/MD/MA 的真实事务匹配，区分命令已发送、已接受、执行中、已完成、已中止和停车未确认。
5. 保留 STOP 的 CRC+同编号 MOTOR_STOPPED 确认、300 ms 有限重试和未确认门禁；清队列、切模式、触碰、复位不能让旧动作绕过门禁。
6. 修正角度换算，测试正反方向、单轮/双轮计数、归零、累计及边界。两轮各一脉冲理论约 10.125°；小角度按脉冲量化，并显示实际请求/执行目标，不能承诺 1° 精度。
7. 保留 57600、无 KEEP、50 字节 TB、200 ms MP、2000 ms 遥测查询。扫描等待期间没有 MP 时不得误触发“运动反馈 750 ms 超时”；反馈检查只覆盖实际运动步骤，等待识别另用有限超时。

通过门槛：新协议边界测试、可靠停车测试和两端编译通过；Uno 双份源码一致，容量合格。

### 阶段 B：Uno 扫描和 ESP 新帧识别

涉及 Uno 扫描核心（拟提取 scan_machine.h）、ESP32CatHost.ino、vision.cpp、host_types.h 及新增扫描/视觉接口。

1. Uno 非阻塞状态：转一步→关闭输出→等待停稳→请求识别→等待匹配结果→下一步/完成。最小等待、编码器静止窗口、停稳超时和识别超时可配置；静止窗口仍受编码器分辨率限制。
2. 总步数、累计角度、总时间均有限。任何一步触碰、STOP、会话关闭、失速、侧向障碍或内存锁定立即取消；等待识别超时保持停止。重发同一请求不重新转一步或重复计数。
   所有目标搜索统一累计角度上限 720°；双侧受阻专用旋转的侧距例外见第 6 节。步数按实际每步脉冲/角度推导，总时限考虑两圈转动、每步停稳和识别等待，并与会话时限协调；不能沿用旧 360°或过短时限，使正常搜索在一圈附近就被判定为未找到。真实故障/请求超时仍可提前中止，显示实际原因。
3. ESP 收到停稳请求后记录本地采集屏障，只使用实际采集发生在请求之后的帧。核查相机驱动返回的帧时间/排队行为，拒绝缓存和驱动中更早的帧；不比较 ESP 与 Uno 的 millis。
4. 推理在视觉任务运行；UART、触碰和 STOP 不等待推理结束。推理结果返回控制核心时再次校验请求键、generation 和帧身份。
5. FOUND 只表示新有效帧中识别到该次目标。NOT_FOUND 与无法识别/无新帧分别处理；INVALID 不能冒充没找到后继续盲转。
6. 给控制事件保留优先处理能力，视觉采用受限待处理数据；超长/队列满显式计数，保留必要目标字段，角点等展示字段可限量。任何丢失不得刷新观察年龄。
7. 分开用户持续识别需求与行为必要识别：搜索默认由停稳请求触发；靠近标签自动连续 TAGS；慢接近猫只在每段停稳后请求 CAT，不在行进中持续推理；其他猫行为按需 CAT；合并需求决定实际模式；视频预览独立。慢接近期间不让网页后台持续 CAT/BOTH 请求重新引入移动中猫推理，显示本阶段实际识别安排。请求识别不被旧周期节流跳过。

通过门槛：延迟、乱序、重复、旧帧、旧推理、队列拥塞和抢占用例通过，转动中照片不能作为停稳照片。

### 阶段 C：标签巡游

涉及 policy.cpp（拟把可测试决策核心提取为 policy_core.cpp/.h）、策略配置、USB/模拟适配层。

1. 状态拆为选目标、找标签、找到、靠近、小步纠偏、丢失停车/重获、前向等待、到达停车确认、到达和重新布防。
2. 有效新帧出现当前 ID 即找到。每个新有效帧先判断是否达到停车宽度，再判断是否需要纠偏；未居中也能到达停车。
3. 搜索、纠偏、靠近、重获各有独立预算和原因。正常找标签和丢失后的重新寻找均允许最多累计 720°；找到以后不能再因原搜索时间累计报“从未找到”。丢失/过期先可靠停车，再有限重获。纠偏仍是对已找到目标的小步调整，不要求绕两圈。
4. 达阈值发 STOP，等停车确认才记到达和推进索引；相同帧不能计作下一次到达。
5. 重复 ID/单节点循环：除了新帧，还必须完成重新布防。建议相同 ID 连续可见且仍在停车阈值内时保持停止，等该 ID 消失或宽度退到明确的较小重布防阈值后，再允许再次计到达；超时显示等待重布防。此版本不自动倒车/离开制造新一圈，需要用户移动标签/机器人或另行批准离开动作。
6. 互动中保存路线索引及当前目标；正常互动收尾后重开会话并从该节点重新观察。操作员 STOP、失联/复位和故障不自动恢复旧动作。
7. 前向仅 ESP 判断并 STOP；开关关闭时逃离不因不需要的旧相机观察而卡住。普通运动左右仅 Uno 按新鲜有效值严格小于阈值停车，1 cm 默认/最小值不变；双侧受阻的专用原地扫描例外见第 6 节。

通过门槛：偏侧大标签、小标签、丢失、错误 ID、重复 ID、单节点、循环、互动恢复及停车未确认测试通过。

### 阶段 D：完整猫行为

涉及 policy.cpp/提取后的决策核心、decision-system.mjs、escape-planner.mjs 和参数生成器。

1. 真实触碰和明确 alert 才触发互动，看到猫只更新观察。触碰抢占搜索、扫描等待、推理、靠近、纯旋转和直行；操作员停止/故障锁定不可解除。
2. 每次取消增加 generation，清除旧完成处理和后续运动；迟到 MD、VISION_RESULT 不能恢复旧逃离。
3. 覆盖主动找猫、朝向、慢接近、三段试探及暂停、原地声光、观察/静止和后续等待。慢接近按第 3.1.5 节分段使用 Uno 有界 DRIVE，行进中不持续识别猫，停稳后才看新画面并决定继续/找猫/收尾；试探保留既有分段/暂停及视觉规则，不能把此次慢接近规则无声扩展为修改全部猫行为。两者触碰、STOP 等必要中止始终及时执行。
4. 保留四模式探索、会话分支只抽一次、模式池、防抖、轮次、概率、冷却和总时限；自动化用固定随机输入逐条覆盖分支，不靠重复运行碰概率。
5. 捕猎包括可选短提示、静默捕获、等待释放、慢逃/快逃、ROTATE 完成后 DRIVE、停后等待追逐，以及再次触碰后的取消/重新等待释放。顶部/触碰与画面冲突/多个位置触碰的找猫按第 6 节执行 SCAN_ROTATE，最多 720°，不使用不侦查的纯 ROTATE 一次转满两圈。
6. 捕获结束分回巡游、静默捕获、提示捕获。提示时长真正使用配置；静默与所有退出路径清旧灯/蜂鸣器。未检测到猫不能证明离开；只有新鲜有效的“猫已较远且无触碰”持续满足时间才确认离开，超时停止等待人工恢复。
7. STAY 与 OBSERVE 先保留现有静止执行含义，显示真实状态并说明两者当前都等待后续决策；不擅自新增行为差异。
8. 无可靠厘米估计时，farCatThresholdCm/catLeaveDistanceCm 明确标为 ESP 当前不支持；实际分支使用可配置框宽阈值。不要把框宽显示为真实厘米。
9. 逃离与找猫采用第 6 节的用户补充规则。首次触碰位置优先于画面；单侧受阻/信息过期/找猫失败均尝试可靠收尾后恢复原路线；巡游无法继续则停止。双侧过近时使用单独允许的原地扫描分支，最多 720°，不倒退。主动 alert 找猫和猫丢失后的重新寻找也统一两圈上限。

通过门槛：全部分支和退出条件有可重放测试，概率/冷却保持原值，按住触碰不反复计轮，任何旧结果不能启动旧运动。

### 阶段 E：网页和配置贯通

涉及 debug_page.html、generate-debug-page.mjs、debug_page.h、generate-config.mjs、policy_defaults.h、app.mjs、index.html、core.mjs，必要时同步资源映射。

1. 展示实际主状态/子步骤、路线索引/总节点/目标 ID、标签宽度与停车阈值、观测年龄、帧编号、命令确认、扫描步骤和停止原因。数据来自新策略快照，不依赖旧 observation.policy。
2. 用户输入任意有效有序 ID 数组，保留当前合法 1–128 节点容量限制、ID 0–586 和重复 ID；没有固定 A/B/C/D 默认路线。USB 场景适配与真实路线分开，不能拿场景名称替代真实 ID。
3. 到达宽度单独输入，明确百分比和比例换算；搜索 PWM、纠偏 PWM、步长/脉冲、停稳窗口和有限预算可保存、校验、回读。非零低 PWM 的参数范围不再隐含强制 120；能否转动由现场测量决定。
4. 建立配置接入表，包含 captureCueFlashMs、captureCueBeepMs、touchFeedbackBeepMs、alignTimeoutMs、finalSearchTimeoutMs 等；修改生成器后重新生成头文件，避免只改生成文件。
5. ROI 变更清除旧地面校准并要求重新采集；配置保存不伪造真实 Uno GET_CONFIG 回读，几何区分“ESP 保存”和“Uno 已确认”。配置修改要求可靠停车。
6. 当前命令为空/故障时不显示历史 PWM 冒充输出；真实输出未知时标未知，保留历史动作单独显示。HTTP queued 只表示排队，不显示成已应用。

通过门槛：无浏览器的 DOM/接口测试证明输入→配置→核心参数→协议和状态显示贯通；视觉布局和真实点击由用户验收。

## 3.1. 已有找猫状态机：可以保留，但最终一并验收

### 3.1.1 核查依据与“保留”的含义

本节以当前 ESP `esp32-host/ESP32CatHost/policy.cpp` 的 `policyControl`、`chooseRobot`、`behavior`、`onTouch`、`policyTick` 为实机策略依据，以 `policy_defaults.h`/ESP 初始化为参数依据；另对照旧 USB/模拟网页 `app.mjs` 的 `searchCat`、`alignToCat`、`finishFacingCat`、`holdCatView`、`waitForCatPursuit` 和行为执行，以及 `decision-system.mjs` 的概率/会话决策。

下面记录的是**目前源码怎样执行**，不是已经验收成功的结果。中文流程节点中“选择行为”是决策分支，`CHOOSE_ROBOT`/`STAY` 等名字有的只是待执行行为名称，不都对应一个实际运行状态。最终验收必须跟真实日志、动作及转移相互对照。

“可以不做更改”表示保留符合需求的行为顺序、概率、冷却、距离/时长参数和收尾含义，不为了验收重新设计整套互动。不免除两圈搜索、新帧扫描、角度修正、可靠停车、旧结果失效和触碰优先等已明确修改，也不把当前未实现的目标表当成既有功能。

### 3.1.2 当前 ESP 找猫和后续行为状态表

| 编号 | 当前状态/分支 | 当前源码入口与执行 | 当前正常出口/异常出口 | 最终一并验收的重点 |
|---|---|---|---|---|
| CAT-01 | 巡游看见猫 | `PATROL` 中相机结果更新猫观察，不自行进入互动 | 明确 `alert` 或真实触碰才进入互动 | 仅画面出现猫不打断路线；明确 alert 只在允许状态触发 |
| CAT-02 | 主动互动入口 | `policyControl(alert)` 停车、设置 `ROBOT_SEARCH`、记录会话开始并执行 `chooseRobot` | 没看到猫→`SEARCH_CAT`；看到→远近选择后 `FACE_CAT` | 发起方与原路线保存正确；开始互动不能越过停车确认；不重复开会话 |
| CAT-03 | 找猫 `SEARCH_CAT` | 当前连续 MOTOR 扫描；无有效新鲜视觉就停等；看到偏侧猫后在同一个搜索状态内对准 | 居中后按 `afterFace` 继续；当前 360°或 `searchTimeoutMs` 耗尽→`finish` | 按新要求改成停稳新帧扫描、720°；第一圈未见继续，第二圈可成功；找到与朝向分开记录，不能把看见但未居中说成未找到 |
| CAT-04 | 主动远近选择 `chooseRobot` | ESP 用猫框宽与 `catNearWidth` 比较；远处默认试探 15%、否则慢接近；试探须满足机器人试探冷却 | 选择 `PROBE_APPROACH` 或 `SLOW_APPROACH`，先进入 `FACE_CAT` | 远近依据明确是框宽；固定随机输入覆盖两分支和冷却；不把厘米字段冒充已使用 |
| CAT-05 | 主动近猫选择 `chooseRobot` | 默认声光 20%、观察 40%、静止 40%，先朝向 | `FACE_CAT` 后执行对应行为 | 概率组保持；三种选择均有验收，STAY/OBSERVE 当前执行合并要如实标明 |
| CAT-06 | 朝向 `FACE_CAT` | 保存 `afterFace`；当前看到偏侧猫时连续转向，居中停；猫不见则在该状态内搜索 | 根据 `afterFace` 去慢接近/试探/声光/观察/等待追逐；找不到或视觉不可用超时→结束互动 | 找到后纠偏的真实步骤、停止确认；朝向中丢失时最多两圈重新找；align/finalSearch 超时按实际接入验收，不因搜索预算误判 |
| CAT-07 | 慢接近 `APPROACH_CAT` | 当前 MOTOR 前行，ESP 用两轮脉冲估计距离；默认距离 9 cm、PWM95，受停止余量影响 | 当前到距离→朝向再观察；猫丢失→结束；观察不新鲜/前向非 CLEAR 先停，等待超时收尾 | 按最新要求改成分段走→停稳→新帧识别，不连续 CAT；停稳后猫不见则最多720°重找，找到续慢接近，找不到回原路线并报找猫失败；参数/剩余距离真实使用，触碰即时中止，详见第3.1.5节 |
| CAT-08 | 三段试探 `PROBE_DRIVE` | `probeStep` 从 1 起；默认 3/4/3 cm、PWM90；每段当前由 ESP 读脉冲判断完成 | 每段→`PROBE_PAUSE`；看不见猫→结束；触碰转入猫发起互动 | 恰好三段，距离/顺序/速度可调；每段完成或可靠停车后才进入暂停，旧完成不能推进下一段 |
| CAT-09 | 试探暂停 `PROBE_PAUSE` | 原地等待默认 700/900/600 ms；到时递增段号 | 第 1/2 次暂停后下一段；第 3 次后→朝向观察 | 暂停时无持续驱动；等待期间仍响应触碰/STOP；第三段结束不出现第四段 |
| CAT-10 | 原地声光 `SIGNAL` | 机器人主动 `STAY_SIGNAL` 使用 `signalFlashMs`/`signalBeepMs`；猫探索分支四模式，执行期间电机停 | 声光时限到→LED OFF→朝向→观察 | 主动提示与四种探索分开覆盖；原地不动、提示有限、退出不残留；参数实际接入 |
| CAT-11 | 观察/静止 `OBSERVE` | `behavior(OBSERVE)` 和 `behavior(STAY)` 当前都停并等 `initialLookSeconds`，默认 5 s | 到时→`FOLLOW_WAIT` | 可以保持相同执行含义，不能宣称两者现有动作不同；等待时无电机/默认声光，仍能被触碰抢占 |
| CAT-12 | 后续决策等待 `FOLLOW_WAIT` | 停车等 `decisionIntervalMs`，默认 2500 ms；ROBOT_SEARCH 到时重新选择；CAT_TOUCH 带 `followPending` 限定一轮一次，受试探冷却和无触碰超时约束 | 主动可再次选行为/重新找猫；猫发起默认试探/观察/回巡游为 5/35/60，冷却影响实际可选动作 | 不按每帧反复抽样；每轮最多一次猫后续抽样；冷却到期前后均覆盖；无触碰超时正常收尾 |
| CAT-13 | 触碰接管 `onTouch` | 当前先停；从巡游进入 CAT_TOUCH，会话中 ROBOT_SEARCH 也可转 CAT_TOUCH；按防抖计轮，探索/捕猎分支一会话选一次 | 声光探索，或捕获/慢逃/快逃；达到结束轮次进入结束三分支 | 四面、同时触碰、按住/释放/再按、主动找猫被触碰全部验收；加入首次位置锁定和用户两圈规则，不覆盖操作员/故障锁定 |
| CAT-14 | 等释放与逃离 `WAIT_RELEASE`/`ESCAPE_TURN`/`ESCAPE_DRIVE` | 等全部触碰释放；当前按画面或触碰选择角度，ESP 估计转角后直行；默认逃离26 cm，慢/快 PWM95/210 | 直行完成→`FACE_CAT(afterFace=WAIT_CHASE)`；再触碰→等待释放；释放超时/动作故障收尾 | 按第 6 节新规则替换方向处理，角度/距离交 Uno 本地有界执行；再触碰立即取消，旧完成不得再次直行 |
| CAT-15 | 逃离后等待追逐 `WAIT_CHASE` | 当前先朝向猫，成功后停等 `postEscapeWaitSeconds`，默认10 s | 到时再朝向→观察；触碰可接管新一轮 | 等待时电机保持停；等待前后两次找猫/朝向都验收；猫丢失时两圈重找，不无限逃离 |
| CAT-16 | 捕获等待 `PREY_WAIT` | 静默或带提示捕获；当前用有效猫框宽较小且无触碰持续 `catLeaveSeconds`，默认5 s，判断离开 | 确认离开→结束；默认15 s仍不能确认→`MAX_WAIT_UNCONFIRMED` 故障停 | 静默/提示分别覆盖；猫画面消失不等于离开；观察过期不能累计确认时间；超时不自动巡游 |
| CAT-17 | 正常收尾 `ENDING`/`WAIT_SESSION_STOP`/`WAIT_SESSION_START` | `finish` 停车、关会话；匹配会话完成后重开会话，回 `PATROL` | 正常继续原路线；确认超时→故障 | 找猫失败、动作完成、会话时限、无触碰超时等正常出口一并覆盖；清声光/旧事务；停车/会话确认齐全才恢复原目标 |
| CAT-18 | 必须停止 `FAULT`/停车未确认 | 操作员 STOP、Uno失联/复位、反馈超时、必要故障等清队列并停止；停车确认耗尽单独锁住 | 等人工明确恢复，不自动执行旧动作 | 在找猫流程每个主要等待/运动步骤都验证；猫事件和迟到推理/完成不能解除锁定 |

补充全局计时：ESP 当前互动（除 PREY_WAIT）受 `sessionLimitSeconds` 默认60 s约束；找猫当前 `searchTimeoutMs` 默认15 s；`alignTimeoutMs` 默认5 s、`finalSearchTimeoutMs` 默认8 s虽然存在于配置，当前 ESP 该路径没有独立使用。最终验收要证明两圈搜索与有限时间约束协调，不用过短旧时限让正常两圈被提前叫作“未找到”，同时不允许无限等待。

### 3.1.3 旧 USB/模拟网页的已有流程与差异

以下已有流程同样登记验收，但结果归到 USB/模拟适配层；不能拿它代替 ESP 实机验收。

| 已有流程 | 当前实现 | 与 ESP 当前实现的差异/验收重点 |
|---|---|---|
| `searchCat` | 基于 `scanUntilVisible` 旋转寻找；当前默认及内部 clamp 最大360° | 所有调用和内部限制都要允许720°，不能只改默认值；观察来源标为 SIM_CAMERA，不能当真实猫识别 |
| `alignToCat` | 对准猫，使用独立 `alignTimeoutMs`，丢失/受阻/持续触碰会退出或等待 | ESP 当前 SEARCH_CAT/FACE_CAT 合并处理搜索/朝向，没有对应独立超时；分别验收实际执行，不写成完全一致 |
| `finishFacingCat` | 等释放→必要时找猫→对准→再次检查；对准后丢失时最多两次尝试；收尾使用 finalSearchTimeoutMs | 声光前后、逃离前后、等待追逐后都可能调用；全部搜索入口两圈，重试仍有限；不能漏掉硬编码 searchLimitDeg=360 的调用 |
| `holdCatView` | 朝向后原地取景默认5 s；猫丢失或行为取消则退出；日志明确 photo_taken=false | ESP 当前 OBSERVE 是停等时间，未实现同样的持续可见退出含义。先如实保留差异并验收，不把模拟取景就绪说成拍照成功或擅自新增拍照 |
| `SLOW_APPROACH`/`PROBE_APPROACH` | 找猫→对准→DRIVE；试探使用三段距离和暂停；随后有朝向收尾 | 慢接近适配最新分段停稳识别/两圈重找/失败回巡游规则；试探保留独立既有流程并验收。模拟脉冲/运动动画不证明物理距离；实际验收以 Uno 回报和现场动作结合 |
| 声光/观察/静止 | USB 的 STAY 明确 STOP+LED OFF；OBSERVE 记录观察；声光、探索后有各自朝向/观察路径 | 允许保留现有差异，但灯/声必须按退出规则清理，最终报告不得声称两端执行完全相同 |
| 逃离后续 | 逃离后朝向→等追逐→再朝向→原地观察，过程中可触碰抢占 | 最终覆盖整个后续链，不只验收到“电机逃离完成”即结束 |

### 3.1.4 最终统一验收记录

CAT-01～CAT-18 每项记录：起始状态、触发事件/新观察、进入状态、发出动作和编号、停车/完成证据、实际出口、结果、日志位置。每项注明“保留既有”或“按新需求修改”，以及“自动化已通过/实机已通过/未验收/失败”；没有改代码不允许直接标通过。

- 自动化：执行实际固件共用核心，用可控时钟/观察/随机数分别覆盖正常、丢失、过期、等待超时、触碰抢占和旧结果迟到。原有概率组测试继续作为回归，并覆盖实际核心的分支出口。
- 人工：用户按上述编号操作页面和现场目标/触碰，先短测再稳定性测试。我提供逐项步骤和预期结果，用户操作并提供日志/观察；需要 RESET 时明确叫用户，不使用 computer use 代操作。
- 最终：新标签/扫描功能与已有找猫流程合在同一张验收清单。未完成的既有状态必须列出缺口，不能只因新增扫描或 Node 测试通过就宣布整套机器人行为验收完成。

### 3.1.5 慢接近猫：分段走，停稳识别，丢失后两圈寻找

这是用户对 CAT-07 的明确修改，替代行进中持续识别猫或一丢失就直接结束的既有路径。目的在于减少推理压力，让 UART、触碰和 STOP 更及时。实现后仍需用时序记录验证响应，不能仅凭减少调用宣称时延已改善。

| 子步骤（拟新增） | 电机与猫识别安排 | 下一步 |
|---|---|---|
| 慢接近准备 | 停止状态取得一帧有效新猫观察，必要时先朝向；记录已选慢接近行为和剩余距离 | 可接近→开始短距离段；无猫→找猫 |
| 分段行进 `CAT_APPROACH_STEP` | Uno 有界 DRIVE 执行一小段；不运行后台连续猫推理，不靠旧图在 ESP 定时循环中决定段完成 | 匹配 MD 后→停稳；触碰/STOP/必要故障立即中止 |
| 停稳 `CAT_APPROACH_SETTLE` | 输出关闭，按统一最小等待和编码器静止窗口等停稳；MD/PWM=0 本身不等于已停稳 | 停稳成功→请求识别；停稳超时→明确停止/失败原因 |
| 停后识别 `CAT_APPROACH_CHECK` | 只使用该次停稳请求之后实际拍摄的一帧，校验代次和帧身份；等待时保持停 | 有效看到猫→决定继续下一段/纠偏/已完成；有效没看到猫→重新找猫；无效或无新帧→有限等待，不假装猫已走 |
| 猫丢失后寻找 `CAT_APPROACH_REACQUIRE` | 原地转一步→停稳→新帧识别，最多累计720°；找到立即结束 | 找到→可靠停妥、重新朝向后回慢接近；两圈仍未找到→报告失败并结束本次互动 |
| 找猫失败回巡游 | 保持停、取消剩余慢接近和旧推理/完成，清理提示，可靠关会话/重开并恢复原路线 | 巡游能继续→正常巡游；巡游找不到目标/无法继续→停止；不自动再次进入本次慢接近 |

具体约束：

- 总接近距离仍使用 `slowApproachCm`（当前默认9 cm）及已批准的停止余量含义；新增可调每段上限、停稳窗口和识别等待上限。每段距离要按真实编码器脉冲量化，记录已走与剩余距离，不把每次重找当作重新获得完整9 cm。
- 停稳后找到猫再续行，不重新抽慢接近/试探概率，也不清零整次互动的有限时限；反复丢失/重找不能让会话无限延长。
- 在本次新有效帧中“没有检测到猫”只表示猫不在当前可识别画面中，因此启动寻找；它不能在 PREY_WAIT 中冒充“已经确认猫离开”。
- 无新帧/识别无效和转满两圈未找到分开报告；真正的触碰、失速、内存故障、停车未确认等按必要停止规则处理，不用回巡游解除锁定。
- 若前向检查开启，前向所需地面观察与猫推理分开安排，不能为了前向输入偷偷恢复连续 CAT，也不能因暂停 CAT 自动关闭前向检查；前向无有效观察按已有门禁处理。标签靠近仍持续 TAGS，视频预览保持独立。
- 失败回报进入日志及独立策略快照，包含“找猫失败”、发生于慢接近重找、实际累计角度、失败原因和时间；恢复巡游后网页仍能查看，不因当前 action 已变 PATROL 或滚动日志覆盖而丢失。它是行为失败记录，不能把恢复成功也显示成不可解除的整机 FAULT。

验收追加 CAT-07A～CAT-07F：正常分段停稳再识别；行进中猫移出画面且下一停稳才启动找猫；第一圈未见第二圈找到并恢复剩余距离；两圈未见回原路线且保留失败回报；旧帧/无效识别不启动下一段；行进/停稳/推理/重找各阶段触碰或 STOP 不被迟到结果恢复。人工测试由用户操作，自动化直接测试实际共用核心。

## 4. 我负责的自动化验证

现有 Node 测试主要覆盖 JS 模型和网页脚本，不能直接证明 ESP/Uno C++ 状态机。新增测试必须执行实际用于固件的控制核心。

| 层次 | 验证内容 | 方法 |
|---|---|---|
| 协议 | CRC、最大帧长、零/错编号、乱序、重复、代次变化、超时和计时回绕 | 对实际解析/事务核心做参数化测试，错误帧不启动下一运动 |
| Uno 扫描 | 两轮脉冲、停稳窗口、有限预算、无新帧、触碰/STOP/失速中止 | 原生 C++ 测试运行固件共用扫描核心，注入时钟/编码器/驱动输出桩；不另写一个 JS 扫描来代替 |
| 所有搜索两圈 | 找猫/找标签/重获/双侧受阻搜索均统一 720°，第一圈未见而第二圈识别到，满两圈仍未见 | 第一圈结束不报耗尽；第二圈新帧有效则成功；累计至两圈才按未找到处理；超时/故障提前退出显示实际原因；纠偏和靠近不误用两圈搜索预算 |
| 触碰找猫新规则 | 首次位置锁定、旧画面不覆盖、720° 内提前找到、满两圈未找到、单侧/双侧受阻、信息过期 | 测实际核心：双侧新鲜有效过近允许专用原地扫描最多 720°，不倒退、不关闭触碰/失速保护；该许可不泄漏到普通扫描/直行。找猫失败恢复原路线；巡游预算耗尽才停止；其他安全锁定不被恢复流程解除 |
| ESP 策略 | 找到/到达优先、独立预算、重获、重复节点、猫抢占、旧 MD、完整猫分支 | 原生 C++ 测试运行固件共用策略核心，注入观察、时钟、随机数和传输；编译器可用性在实施开始核查，缺失则明确报告验证缺口 |
| 已有找猫全流程回归 | 第3.1节 CAT-01～CAT-18 的既有与修改路径，包括选择、朝向、三段试探、观察/决策等待、逃离后续和正常/异常收尾 | 每项实际核心执行测试；保留功能也需要覆盖；旧 USB/模拟适配单独记录，不能替代 ESP/Uno 核心验证 |
| 慢接近停稳识别 | 第3.1.5节 CAT-07A～CAT-07F；识别请求严格晚于停稳，行进中没有连续 CAT；两圈重找、剩余距离、失败回报与原路线恢复 | 控制核心/识别调度事件轨迹联合断言；网页持续 CAT/BOTH 也不能绕过慢接近识别安排；错误/旧结果不推进下一段 |
| 视觉时序 | 缓存旧帧、推理迟到、重复帧、采集屏障、过期、队列满 | 测实际请求/帧接纳核心；相机与推理设备时延另留现场 |
| 既有回归 | 观察边界、侧距严格阈值、TB 完整批次、会话概率、传输及显示 | Node 测试；网络桩仅使用本机回环，不接实际 ESP/串口 |
| 网页配置 | 保存/拒绝/回读/核心使用、真实状态显示、旧 #0 PWM | 现有 vm/DOM 桩和 API 自动化；不打开或点击浏览器 |
| 生成和构建 | 配置/页面源与生成头一致、两份 Uno 一致、语法和两端编译 | Node 语法检查、生成一致性检查、Arduino CLI compile；上传另按用户授权及手动 RESET 流程执行，不调用默认自动复位上传 |

计划使用的命令形式：

```powershell
# 从 uno-web-lab 执行；用显式文件数组避免 Windows 通配符处理差异
$testFiles = @(Get-ChildItem -LiteralPath . -Filter '*.test.mjs' -File | ForEach-Object FullName)
$testFiles += (Resolve-Path -LiteralPath 'esp32-host/debug-page.test.mjs').Path
node --test @testFiles
node --check app.mjs
```

Arduino CLI 使用已有安装：D:/software/arduinoIDE/Arduino IDE/resources/app/lib/backend/resources/arduino-cli.exe。Uno 使用 arduino:avr:uno；ESP 使用 esp32:esp32:XIAO_ESP32S3:PSRAM=opi,PartitionScheme=max_app_8MB。用英文临时目录构建；如编译器仍不接受中文源码路径，复制完整构建输入到英文暂存路径。每阶段记录 Flash、静态 RAM 和实际容量差；编译通过不证明运行栈、硬件或长期稳定。

## 5. 用户现场操作和测试顺序

下列是批准实施、自动化验证通过之后的人工验收，当前不启动。届时提供最终版本、上传命令及每项记录表。

| 顺序 | 用户怎么做 | 通过条件/需要保存的证据 |
|---|---|---|
| 1. 恢复和上传 | 在设备旁确认供电/接线、架空固定车轮；需要时按 Uno RESET。按已授权的上传范围准备两端固件，复位/进入烧录状态由用户操作，打开页面确认 UART/LIVE 和版本 | READY/uptime、真实 GET_CONFIG、停止确认和实际输出；历史板号/IP 先重新确认；启动后不自动续旧巡游 |
| 2. 空闲稳定 | 不启动电机或声光，先观察至少 10 分钟，可运行明确的只读自动日志采集 | 无 READY 重现、uptime 下降、持续无回报、内存锁定；保留原始 UART/日志和供电状态 |
| 3. 四种轮向 | 网页分别选择左正/左反/右正/右反，每次使用 Uno 本地限时测试。逐档测启动 PWM；成功启动后另测降低 PWM 的维持能力 | 每档真实转动、MS/MP/MD 或中止、可靠停车；上一档未确认停止不试下一档。架空测量不当作落地结果 |
| 4. 角度和停稳 | 先纯 ROTATE 正反，再最小扫描步；标记车体方向并测多次实际转角，记录关输出后的滑行脉冲 | 两轮本地计数完成；实际误差/重复性可接受。停稳识别请求只能在停稳条件后出现，步长/PWM/等待以实测调整 |
| 5. 新帧和识别 | 在搜索转动期间展示/遮挡标签，停稳后换标签；分别试 TAGS/CAT/BOTH，试视频和持续识别开关；第一圈遮挡目标，第二圈再展示，另测两圈都不展示 | 每条结果关联正确请求和新采集帧；第一圈未见不提前报搜索耗尽，第二圈能找到；两圈未见按对应失败规则收尾；记录采集→推理→回复，实际识别 fps 与视频 fps 分开；开视频不启动行为 |
| 6. 标签全流程 | 自填路线（例如手头实际拥有的两个以上 ID），从小目标到大目标、偏侧大目标、遮挡/丢失、重复 ID、单节点循环逐项测试 | 小目标即进入找到/靠近；偏侧大目标直接停；停车确认才推进；旧帧不跳节点；重复 ID 的重新布防能看到等待原因 |
| 7. 触碰抢占 | 搜索转动、停稳等待、推理等待、靠近、ROTATE、DRIVE 中分别按 LEFT/RIGHT/REAR/TOP；再测按住与释放 | 电机及时停；旧结果不重新启动；按住不重复计轮。先用手控触碰模拟验收，完成短测后再考虑真实猫互动 |
| 8. 猫完整分支 | 用停止状态下可设置的测试概率依次覆盖主动 alert、四声光、三段试探、捕获/慢逃/快逃、结束三分支，再恢复原概率；测试顶部/多处触碰和画面冲突的两圈找猫，另测双侧过近时直接原地扫描两圈 | 仅看见猫不触发；首次触碰位置不会被后续位置/旧画面覆盖；找到猫提前结束，未找到回原路线，巡游找不到路才停止；声光按配置结束；捕获时目标消失不当作已离开。双侧分支不倒退，原地扫描仍响应触碰/STOP/失速 |
| 8A. 已有找猫统一验收 | 按第3.1节 CAT-01～CAT-18 逐项验证，包含未修改的既有行为；分别记录 ESP 实机与 USB/模拟结果 | 所有状态的入口/动作/出口与实际日志吻合；保留概率/冷却/暂停/等待时长；两圈、新帧、抢占规则同时成立；未验收状态留在最终清单，不省略 |
| 8B. 慢接近停稳识别 | 在短距离行进时移开猫目标，观察停稳后才识别并转圈；分别在第二圈重新展示和两圈都不展示；在各子步骤按触碰/STOP | 行进中无连续猫推理；第二圈找到后继续剩余慢接近；找不到可靠回原路线并显示找猫失败；下一段不会被旧帧启动；实际响应时延另记录 |
| 9. 前向/侧向 | 分别开关前向；改变 ROI 后重新校准；使用可控障碍检查两侧严格阈值，单测测距无效/过期 | 前向 STOP 来自 ESP；侧向仅新鲜有效 <1 cm 停，=1 cm 不因这一检查停；未知显示未知。实物很难精确制造 1 cm 边界，严格边界以自动化为主，实测另记误差 |
| 10. 稳定性 | 分场景各至少 10 分钟：静止通信、扫描/推理、完整巡游、互动；保存设置与完整记录 | 单独报告每场景时长、复位/失联、CRC 错误、停车重试、队列丢包、内存情况；不以短测替代长期结果 |

发生失联、复位、停车未确认或异常持续运动：用户现场停止测试并切断电机动力（按现场可用方式），保留日志；不继续递增 PWM，不自动烧录/复位恢复。不假定 ESP 失联必然使 Uno 停车：取消 KEEP 后持续 MOTOR 没有续租超时，这个既定契约在此次继续保留，实机有人在旁才能做持续运动测试。

## 6. 用户补充的触碰找猫、逃离和回巡游规则

本节记录用户在计划讨论中明确补充的规则，代替此前“信息不足一律保持停止”的建议；整体程序已由用户在聊天批准，以下规则已纳入实现和自动化；实体结果仍待用户验收。

| 情况 | 用户决定 | 落到程序的行为 |
|---|---|---|
| 顶部被碰 | 转两圈找猫，找不到回巡游 | 停车、等触碰释放，再转一步→停稳→新帧识别；累计最多 720°，找到提前结束 |
| 多个位置被碰 | 最先被碰的位置为准，然后转两圈找猫 | 记录这一轮首次 PRESS 的位置；后续 PRESS 不改该位置、不重复计轮；释放后进行最多 720° 搜索 |
| 触碰位置与画面不同 | 触碰为准，转两圈找猫；画面可能过期 | 画面不改写首次触碰位置；搜索方向按触碰位置设定，找到与后续朝向只能使用新帧 |
| 想转的一侧有新鲜有效近障碍 | 继续巡游，巡游找不到路就停 | 中止当前转动、确认停车、清理提示/旧请求，结束互动并恢复原路线；标签搜索/路径不可继续时停止 |
| 左右都有新鲜有效近障碍 | 直接原地转，不先倒退；最新要求所有搜索两圈，车体按圆形考虑 | 专用分步原地扫描，最多 720°，找到提前结束；这一动作允许侧距过近时旋转，仍受触碰/失速/STOP/内存保护和有限预算约束；未找到恢复巡游，巡游不了停止 |
| 所需信息已经过时 | 继续巡游，巡游不了就停 | 旧信息作废，可靠收尾后回原路线并取得新标签观察；若无新观察/找不到目标且巡游预算耗尽则停止，不使用旧帧盲目直行 |
| 两圈仍没找到猫 | 继续巡游，巡游不了就停 | 记录找猫失败原因，恢复原路线索引；不是无限转动，也不把找猫失败直接当成整机不可恢复故障 |

实现细节：

- “转两圈找到为止”按最多累计 720°理解：找到立即结束搜索，不强制补齐两圈。按脉冲量化记录目标/实际累计；总时间、步数和停稳/识别等待仍有上限，提前超时要显示实际原因，不虚报已经转满两圈。
- 两圈找猫使用 SCAN_ROTATE，不是纯 ROTATE 720。Uno 现有纯 ROTATE 单次只接受 ±360°；它不识别猫，不能拿两个纯转角命令替代新帧扫描。
- “首次触碰”按 Uno 实际检测并报告的先后顺序锁定。若多个触点在同一轮采样已经同时按下，硬件无法还原真实先后；使用明确、固定的报告顺序并标注同时检测，不宣称知道物理上谁先碰到。
- 先立即停车，触碰未释放时不开始旋转或逃离；后续运动再次触碰仍立即停车，但不能覆盖本轮首次位置。释放超时按既有停止/收尾规则处理。
- 双侧受阻优先于单侧受阻分支：两侧都是新鲜有效且严格小于设定阈值时按最多 720°的专用原地扫描执行；只有想转的一侧受阻时按回巡游规则。已有触碰搜索遇到双侧受阻则切入该专用分支并保留已累计角度，不能重新赠送两圈。
- 同一回合双侧受阻不因每帧/每次遥测重复启动或清零预算；专用扫描和整个触碰搜索累计上限均为 720°。记录已经走过的步骤与角度，避免在两个分支间切换导致无限转动。
- 原地扫描的侧距许可只属于这一有界动作，完成/中止/换状态立即清除，不作用于直行、倒车、普通 ROTATE、手动 MOTOR 或正常标签搜索。不能直接复用会同时绕过触碰的通用 BYPASS；需要把“允许这一动作原地旋转”和触碰等必要停车分别实现。按圆形车体制定动作不等于实测已经确认周围畅通。
- 触碰与旧画面冲突：触碰位置有效，按触碰启动新帧搜索。只有“后续动作所需观察已过期且无法取得有效新观察”才转入过期回巡游分支，不能因旧画面恰好过期而取消用户要求的两圈搜索。
- 找到猫后停止扫描，进入既有朝向/互动流程，保留本轮已选分支与概率；不凭这一帧自动改成另一个逃离方向。
- 恢复巡游只适用于正常找猫失败/行为受阻/观察过期；操作员 STOP、内存锁定、Uno 失联、停车未确认等必要故障仍保持停止，不能用“继续巡游”解除。
- 无效/过期侧距不等于“左右都有障碍”，不触发双侧原地扫描分支；保持用户既定的无效侧距不因该检查停车规则。此分支不倒退，也不引入不存在的后向测距。
- 按用户最新要求，正常标签巡游、主动 alert 找猫、触碰找猫及丢失后重获全部采用 720°搜索上限，取消此前只将触碰搜索设为两圈的安排；各自仍保留独立计数/计时与失败原因。

## 7. 交付与批准范围

批准整体计划后按 A→B→C→D→E 完成独立实现及第 6 节已确定规则，包括双侧受阻时专用原地扫描。每阶段通过实际核心自动化和编译门槛再推进，不留只接网页展示的假完成。

交付：同步源码、新协议说明、配置接入表、真实状态网页、自动化报告、两端编译与容量报告、更新后的状态表/四张流转图/项目日志，以及包含既有找猫 CAT-01～CAT-18 和新增功能的统一人工验收记录表。源码测试、编译、上传、实机功能、稳定性分别记录；未修改的既有功能也必须给出验收结果或明确缺口。

实施记录：基线 Git ba5afeb；Uno 扫描核心 Git 059bf30；ESP 协调 Git 87a2de6；后续实际策略、新帧门槛、页面与配置已实施并做原生/Node验证和两端离线编译，详细结果见统一验收记录。没有 RESET、上传、界面或电机测试。

## 8. 开发回顾对应的量化补测表（2026-10-03 新增）

历史证据与数据口径见《项目日志》“开发问题回顾与实测数据补充”章。这里补充测量交付要求，不改变整体实施批准范围；不启动现场测试。旧版 9600 的遥测 P50 510/542/630 ms 只作历史参考，当前 57600 / 紧凑遥测尚无同口径压力对照。

| 测量项 | 固定条件与应记录字段 | 当前结果 |
|---|---|---|
| 当前 UART 延迟基线与压力对照 | 记录两端版本、57600/8N1、接线、供电、诊断档、遥测协议/周期；分空闲、额外 PING、GET_STATUS、识别并行、运动并行；记实际发送 Hz、完整样本 n、TX→ACK/完整完成 P50/P95/max、错误/超时/溢出次数及总发送分母 | 待测；目标频率与实际频率分别记录；不能以 HTTP 往返或批次发布跨度替代 |
| 分场景稳定性 | 按第 5 节先至少 10 分钟静置，再逐个场景；记录实际时长、READY/uptime 下降、持续沉默及持续时间、CRC 错误、内存异常、最后事务/步骤；原始日志须能覆盖窗口 | 待测；一次复位或失联即停止递增负载，恢复由用户处理 |
| 供电对照 | 固定电源路径，记录电池/驱动板输入、驱动板 VSS/5V、Uno 5V 的静态与电机启动最低值、RESET/VCC 波形（有仪器时）、动作与负载 | 待测；历史 5.8 V 是驱动板输入，不是 Uno 5V |
| 四轮向 PWM | 左正/左反/右正/右反分别记录启动和启动后的最低维持 PWM、重复次数、脉冲/时间、架空或落地负载、电源电压；每档确认停车 | 待测；历史 120 不视为当前最低值，V6.5 下限 1 不是测量结论 |
| 转角与停稳 | 记录目标/实际角度、多次误差、两轮脉冲、PWM、轮径/轮距、关输出后额外脉冲和停稳时间 | 待测；理论约 10.125°/两轮各一脉冲不等于精度 |
| 新帧视觉链路 | TAGS/CAT/BOTH 分开，记录请求→停稳→采集→推理结束→结果接纳时间、帧/请求号、识别次数及窗口、视频开关/光照；过期/重复/迟到结果单列 | 待测；缓存 fps、推理耗时、有效识别 Hz 分开 |
| 安全停车响应 | 触碰和前向/侧向障碍分别记录观测→停车指令→Uno 输出归零→物理停稳时延、距离及重复次数；注明动作与安全配置 | 待测；DONE/MD 不替代目视停车与实体测量 |

每轮保存原始记录和统计摘要，并在项目日志新增对应日期章节。空白结果保持“待测”；记录失败样本与中止原因，不只记录成功值。计时来自 ESP/Uno/电脑时说明时钟与同步方法；跨设备未同步时间不直接相减。采集缺口、在途事务、版本/供电改变分别标注，只有同口径数据才计算改善百分比。
