SaitoTommo/CatTeasingRobot/寻找猫控制约定.md

# 当前控制约定（2026-10-03）

Uno V6.6 / ESP 0.12 已使用 [扫描协议](./扫描协议.md)：ESP 开始扫描，Uno 分步旋转→本地停稳→VQ，请求后实际采集的新帧才可回复 VR。匹配扫描/步骤/代次，最多两圈；找到提前退出，STOP或触碰取消旧动作和旧识别。使用同一板上的时间判断采集，不直接相减 ESP/Uno 时钟。

正常巡游只找路线标签；明确 alert 或真实触碰才触发猫行为。慢接近猫只在短 DRIVE 完成、STOP确认和停稳之后识别；有效新帧中猫消失才重找，找到继续剩余距离，最多两圈仍没有则回原路线并报告找猫失败。无效图像不是确认猫消失。

当前 MOTOR 没有 KEEP；不使用下面历史“350ms续发”方式做实体扫描。旧 A/B/C/D 场景和 SEARCH_CAT_START/STOP 名称不是新协议命令。以下保留早期电脑模型背景，当前行为和全部既有猫状态验收见[统一验收记录](./统一验收记录.md)。

# 寻找猫：上位机与 Uno 的开始 / 停止控制约定

## 职责与两个动作

`SEARCH_CAT_START` 和 `SEARCH_CAT_STOP` 是**上位机（未来的 ESP32，当前由网页代替）**的两个明确动作。Uno 只执行转向、停止和本地安全保护，不在 Uno 内判断画面中有没有猫。

固定路线巡游由上位机按路线标签 A/B/C/D 决策：到达当前标签后持续旋转搜索下一个标签，最多 360°，找到即停并接近。巡游阶段不启动寻找猫。只有收到一次性 HTTP 指令或 Uno 触碰触发互动后，互动策略才可能调用寻找猫。HTTP 指令通道：经 `server.mjs` 打开页面时，外部用 `curl -X POST http://127.0.0.1:8765/mood_alert -d "{\"source\":\"HTTP_NEGATIVE\"}"` 发一条，网页端（模拟 ESP32）轮询 `GET /mood_alert/pending` 收信，随后才向下位机发出动作命令；指令一次性消费，只携带意图，不携带猫的位置。`file://` 打开时无网络通道，用页面按钮模拟收到同一条指令。首次触碰先按概率选择声光探索或捕猎，本轮互动保持同一分支。探索时在接触中停车并同时发出灯光和蜂鸣，松开后再寻找并观察猫；捕猎时抽取装死或逃跑，装死当场停车，逃跑在触碰松开后先向远离猫的安全方向移动，停下后再搜索并面向猫。

| 上位机动作 | 上位机做什么 | 发给 Uno 的具体命令 | Uno 回报 |
| --- | --- | --- | --- |
| `SEARCH_CAT_START` | 启动摄像头检测，选择初始转向，持续检查新画面 | 连续转向控制，例如 `MOTOR -75 75`，并在有效期内续发 | `ACK`、运动状态，以及可能的安全中止事件 |
| `SEARCH_CAT_STOP` | 上位机确认猫**出现在镜头画面中**，或收到人工停止 / 会话结束 / 安全中止 | 立即发送 `STOP`；结束会话时发送 `SESSION_STOP` | 停止确认与被中止动作的结果 |

网页寻找期间约每 350 ms 续发一次连续转向命令；Uno 的实际连续命令超时以当前固件为准。若上位机失联，Uno 的连续运动命令不得无限期保持有效。

## 正常时序

1. 上位机进入 `SEARCH_CAT_START`，读取摄像头画面。如果此时已检测到猫，直接发送 `STOP`，不必先转动。
2. 画面中没有猫时，上位机发出低速转向命令，并持续读取新画面、续发转向命令。逃跑后的找猫允许根据现场安全条件选择扫描方向；装死期间不扫描。
3. 上位机确认 `cat_detected = true`，即**有猫进入镜头画面**，立刻进入 `SEARCH_CAT_STOP` 并向 Uno 发送 `STOP`。停止条件是“看见猫”，**不要求猫处于画面中央**。
4. 上位机收到停止确认后，记录发现时间、检测结果和寻找时长，再进行观察或下一步策略判断。

若始终没有检测到猫，最多旋转 360°；一圈结束、达到搜索时间上限、人工停止、会话结束或 Uno 本地安全条件中止时都立即停车。安全中止不能被记录为“找到猫”。

```text
上位机：SEARCH_CAT_START
摄像头：cat_detected = false
上位机 → Uno：MOTOR -75 75
摄像头：cat_detected = false
上位机 → Uno：续发 MOTOR -75 75
摄像头：cat_detected = true，center_x = 0.23
上位机：SEARCH_CAT_STOP，reason = CAT_DETECTED
上位机 → Uno：STOP
Uno → 上位机：停止确认
```

示例中猫处于画面左侧，仍应立即停止寻找。若接近猫等后续动作要求它居中，上位机需**另行启动对准猫**的视觉闭环，不能把“对准”混入本次寻找的停止条件。

## 互动收尾的面向猫约定

触碰回应收到 Uno 触碰按下时，先按可调概率选择一轮互动的声光探索或捕猎分支，不在同一轮中重复抽分支。探索分支的有效触碰立即让机器人停车，同时发送 LED 与蜂鸣命令；常亮、快闪、慢闪、极慢闪四种节奏用完一轮才重复，连续两次不相同。触碰松开后再寻找并观察猫。捕猎分支独立抽取“当场装死／松开后慢逃／松开后快逃”；装死立即停车，不找猫或转动，等待猫实际离开或达到可调静止上限。逃跑分支等触碰松开后依据当前可见方位或触碰方向实际转动，随后用新测量选择行程，不在逃跑前找猫或停留取景；Uno 的触碰、前方和侧边安全检查仍可拒绝运动。逃跑后停车并搜索猫，找到后对准；即使猫暂时不在镜头内也会尝试扫描。等待默认 10 秒供猫追击后，再次搜索、对准并静止观察；若猫不在画面或安全条件阻止转向，则显式记录失败。首次触碰立即启动回应，默认 1000 ms 的连击窗口只将后续快速触碰并入同一轮，不延迟回应。两分支共用后续观察／试探／巡游选择、轮数上限、无触碰超时和会话上限；达到轮数的触碰使用独立的三种结局概率。确认 `SESSION_STOPPED` 后再发送 `SESSION_START`，从被中断的巡游标签目标继续。机器人主动找猫使用另一套独立概率。其他顶层互动动作完成后，也尝试面向猫。单独手动发起的寻找最多旋转 360°。

捕猎分支还保留触摸时独立的声光反馈概率：抽中时立刻发送 LED 闪烁和蜂鸣命令，不改变装死／逃跑抽签，也不启动轮子。探索分支已经必定发出声光，不重复叠加此反馈。

只有模拟摄像头确认猫在画面内且中心误差不超过当前调试容差（默认 0.055），才记录 `FACE_CAT_RESULT status=READY` 和 `SIM_CAMERA CAPTURE_READY`。这表示模拟取景条件就绪，**并未拍摄真实照片**。若触碰持续按下、寻找超时、对准失败或 Uno 安全保护中止，记录失败原因并停止电机；会话结束时仍关闭所有执行器，不能把失败记成“已面向猫”。

## 中断与记录

- 用户点击“停止寻找猫”：上位机取消寻找并发送 `STOP`，结束原因记为 `OPERATOR_STOP`。
- 新互动行为取代寻找：先发送 `STOP`，结束原因记为 `REPLACED_BY_BEHAVIOR`。
- 整段互动结束：普通收尾先尝试面向猫并记录结果；装死收尾保持静止。之后发送 `SESSION_STOP`，关闭电机等执行器。
- Uno 报告障碍、触碰或其他安全中止：上位机停止续发转向命令，并记录实际中止原因。
- 日志分别记录 `SEARCH_CAT_START`、`SEARCH_CAT_STOP`、停止原因、摄像头检测结果、向 Uno 发出的命令及其回报。`CAT_DETECTED` 与人工或安全停止不能混为同一种结果。

本约定记录上位机与下位机的控制边界。当前网页使用模拟摄像头，可连接模拟 Uno 或串口实板 Uno；真实 ESP32 摄像头检测和实体运动效果仍需后续固件及实物验证。

扫描角度由左右轮编码器增量及已生效轮径/轮距计算，不读取场景朝向。摄像头在视野外或遮挡时不提供目标方位/距离；只有实际转动后才能获得新朝向的观测。
