SaitoTommo/CatTeasingRobot/离线验证结果.md

# 离线验证结果（2026-10-03）

固件来源：`87a2de6bd32de26bb257b472ee529fb3c2385809`，Uno V6.6 / ESP 0.12。详细机器可读结果及源码/产物 SHA256 在 [offline-validation-20261003.json](./offline-validation-20261003.json)。本轮没有打开设备串口、上传、RESET、操作网页或运动测试。

| 检查 | 最终结果 | 证据边界 |
|---|---|---|
| 实际 Uno scan_machine.h | 199 项通过 | 原生时钟/编码器输入，未运行于 Uno 板 |
| 实际 ESP policy.cpp | 429 项通过 | 实际 ArduinoJson 7.4.3；替换时钟、随机数、String 和 IO；覆盖既有 CAT-01～18、新增接近/重找、标签、抢占及第二圈联合流程 |
| 实际 VisionGate | 通过 | 请求前缓存、迟到推理、重复、取消及计时回绕 |
| 实际 ESP wire guard | 通过 | 物理 STOP/会话 DONE 和全部关键运动/扫描回报 CRC 门槛 |
| Node | 85 项通过，0 失败 | 网页绑定、参数、协议、观察边界及旧模型回归；不是新配对固件实机测试 |
| Uno AVR 编译 | Flash 32084/32256；静态SRAM1379/2048 bytes | core1.8.8、`firmware/build-uno.ps1` 必需优化参数；Flash仅剩172 bytes，静态余量不等于运行栈余量 |
| ESP32-S3 编译 | Flash3714906/8257536；静态SRAM78792/327680 bytes | core3.3.12、XIAO/OPI PSRAM/max_app_8MB；应用BIN3715056 bytes，与编译统计口径不同 |
| 仓库外 Uno 同步 | ino及scan_machine.h哈希分别与仓库匹配 | 仓库外副本不受本仓库Git管理，以仓库提交为恢复来源 |
| 无自动复位上传脚本 | PowerShell语法解析通过；仅查看本机工具帮助 | 未在板上执行，不宣称上传已通过 |

复现：在仓库根目录运行 `./tests/run-native.ps1`（可传 `-Compiler` 指定便携 Zig 0.14.1；默认ArduinoJson路径见脚本），以及 `node --test *.test.mjs esp32-host/*.test.mjs`。离线构建分别运行 `./firmware/build-uno.ps1`、`./esp32-host/build.ps1`。不要把生成头文件的脚本与读取这些头文件的编译测试同时运行。

## 上传准备，等待用户现场配合

上传已授权，RESET/进入烧录模式/界面/运动测试由用户操作。编译文件保存在报告所列 TEMP 路径；重编后哈希可改变，上传前确认文件对应当前源码。未创建固件仓库大二进制提交。

1. 用户在设备旁断开电机动力，关闭占用串口的窗口，确认 Uno 和 ESP 各自 COM 口，不依据历史 COM10/COM11 自动选设备。
2. Uno：用户按 RESET 进入短暂 bootloader 窗口，配合运行 `./firmware/upload-uno-no-reset.ps1 -Port COM数字 -ManualBootloaderReady`。已安装 AVRDUDE8 的 arduino 驱动支持 `-x noautoreset`（帮助注明不切换RTS/DTR）；只尝试一次，写/验证应用 HEX，不写 bootloader/fuses。错过窗口只报告失败，等用户再处理。
3. ESP：用户 BOOT+RESET 进入 ROM download mode，重新确认可能变化的 COM 口，再运行 `./esp32-host/upload-no-reset.ps1 -Port COM数字 -ManualBootloaderReady`。已安装 esptool5.3.1使用 `--before no-reset --after no-reset --no-stub`，连接只尝试一次。先读0x8000分区表与构建表逐字节比较，一致才只写0x10000应用；不整片擦除，不写NVS/分区/bootloader。表不符就停，不猜测覆盖。
4. 脚本成功后由用户重启。先查看 READY UNO_CAT_V6.6、ESP32_CAT_HOST_0.12、SCAN_V1能力、真实 GET_CONFIG 和停车确认，再按 [统一验收记录](./统一验收记录.md) 静置、单轮和完整行为逐项验收。历史失联未解除，出现沉默/复位先保存日志并停止加负载，恢复由用户操作。

脚本未执行；工具帮助和语法检查不能证明这两块板的实际上传/复位行为。旧电脑 SIM_UNO 不支持 SCAN_V1，不能替代新配对固件验收。物理转角/滑行、低PWM启动、触碰/超声波/识别效果、响应时延、运行内存与供电/UART长期稳定性均待用户测量，不填估计结果。
