SaitoTommo/CatTeasingRobot/扫描协议.md

# 分步扫描协议（V6.6 起）

现有 CRC-8 信封 `C <非零id> <命令>*HH` 不变。下列命令公开长名可用，实际传输使用别名；最长 8 个词，包含信封。所有扫描回报必须有 CRC，否则不接纳。

- `SCAN_CONFIG` / `SC minimum quiet vision total settle`：停稳最小等待、编码器静止窗口、识别等待上限、整次扫描上限、停稳上限，单位 ms。仅在无扫描/运动且已可靠停车时设置。
- `SCAN_ROTATE` / `SR generation signedStepPulses pwm pulseBudget flags`：命令 id 同时是 scanId。generation 非零，范围1..2147483647；每步带符号脉冲1..64；PWM1..255；每轮总目标脉冲1..1000；flags=0普通侧向检查，1为用户批准的双侧受阻原地扫描许可。flags 不绕过触碰/失速/内存/会话锁定。每轮 pulseBudget 由真实 GET_CONFIG 几何换算720°，整数脉冲量化；不承诺精确720°。
- `VISION_RESULT` / `VR scanId stepId generation result frameSeq`：result=0新有效帧未见，1找到，2识别无效。只接受当前等待步骤，非零新帧才允许0/1；2可以frameSeq=0并中止。重复/迟到/旧代次不推进。
- `VQ scanId stepId generation usedPulses*HH`：Uno关输出且满足停稳条件之后请求识别；usedPulses 是 Uno 自己计数的本次扫描累计脉冲（包含可观测滑行），用于恢复预算和诊断；最多在同一有限等待内每500ms重发，不重新转动。
- `SD scanId generation result*HH`：整个扫描已关输出并完成，result=0预算用完仍未见、1找到、2无效、3超时、4中止、5停稳超时。该回报不替代操作员STOP的匹配MOTOR_STOPPED确认。

每步复用MS/MP/MD/MA，编号为scanId。MD仅表示一步电机计数完成，随后仍需要停稳和识别；只有SD表示整个扫描结束。等待识别时不期待MP，也不发KEEP。重复SR不得重新转动；重复VQ复用同一新帧事务，不再次抽取结果或重启计时。

ESP记录收到VQ的本地时间、请求时帧序号和generation；只用实际采集时间晚于该请求的帧，driver/cache里的旧画面不合格。回复前再检查代次。两板millis不直接比较。STOP/触碰/会话关闭/复位作废旧事务。

V6.6 的 GET_STATUS、GET_DISTANCE、GET_ENCODER 都复用 GET_TELEMETRY 的完整 50 字节 TB 批次和 DONE TELEMETRY，避免重复文本输出代码占满 Flash。状态、输出、距离和编码器信息仍在批次中，旧文本格式不再返回；适配层必须解码完整批次，不能将 ACK 当作读数。GET_CONFIG 和 GET_IO 保留原格式。使用 firmware/build-uno.ps1 的明确 AVR 优化参数构建；默认参数无法装入 Uno。
