SaitoTommo/CatTeasingRobot/元器件接线与电脑测试.md

# Arduino Uno R3 元器件接线与电脑测试（V5.6）

V5.6 新增硬件实时读数：默认打开“硬件测试”，桌面采用四列元件卡片，开关与读数同卡显示。约每 250 ms 请求一次 GET_TELEMETRY，同一时刻最多一个请求，响应丢失时退避；不依赖模拟场景是否暂停。三组互动策略与共享日志默认折叠。

左/右电机显示接收的带符号 PWM、实际引脚驱动记录、方向引脚电平及输出开关；编码器显示累计脉冲、约 500 ms 窗口的 RPM、采样瞬间 HIGH/LOW 和物理/虚拟来源。超声波分别显示物理测距和最终控制读数，触碰显示原始电平及去抖状态，LED/蜂鸣器显示逻辑指令与引脚状态。前向判定标注电脑模拟或上位机来源。超过 2.5 秒未更新的单项读数标为过期；断开或 Uno 重启时清空旧值。数字电平不是波形，电机引脚驱动也不是实测电压、电流或转动反馈；真实转动需要看编码器。ENA/ENB 跳线固定使能时，显示 PWM 不代表实际调速；开启通道也不意味着检测到模块已接入。

使用本次页面前，需重启本地测试台服务器以加载新模块路由，刷新网页，并重新烧录主固件 UnoCatController.ino（READY UNO_CAT_V5.6）；独立的 SimpleMotorTest.ino 只接受 A/B/C/D/S，不能提供网页实时协议。界面操作及硬件验证由用户完成。

电脑继续作为上位机：USB 连接 Uno，Chrome/Edge 打开 http://localhost:8765/ 并连接串口，57600 波特。当前摄像头不直接接 Uno，也无需接 ESP32。

## 只接电机

当前固件采用 L298N 双路驱动接口。电机两根线接驱动板输出，不能接 Arduino IO。

| 端子 | Uno IO 或连接位置 |
| --- | --- |
| 左轮 IN3 / IN4 / ENB | D8 / D9 / D6（PWM） |
| 右轮 IN1 / IN2 / ENA | D4 / D7 / D5（PWM） |
| 左轮电机两根线 | 驱动板 OUT3 / OUT4 |
| 右轮电机两根线 | 驱动板 OUT1 / OUT2 |
| 驱动板 GND、电机电源负极 | Uno GND，所有地共地 |
| 电机供电 | 驱动板电机电源输入，按实际电机及驱动板额定要求供电 |
| Uno 与电脑 | USB |

PWM 调速需要取下 L298N 的 ENA/ENB 短接帽；它们不是 5V 稳压跳线。不要用 Uno 5V 给电机供电。驱动板逻辑电源/5V 稳压跳线按实际板型说明配置，避免 USB 5V 与驱动板 5V 输出相互供电。若实际不是 L298N，需核对其 IN/PWM/使能接口；当前固件没有单独 STBY 引脚。

1. 烧录 uno-firmware/UnoCatController/UnoCatController.ino；连接后确认 READY UNO_CAT_V5.6。先关闭电机电源，将车轮悬空。
2. 连接网页串口，点击“准备元器件测试（模拟未接输入）”。等待 IO 全部回报“已关闭”，状态为 DEBUG=ON INPUT_MODE=TEST MOTOR_MODE=OFF。轮距留空时使用名义 120 mm，本次单轮测试不依赖该值。
3. 仅勾选左电机或右电机，等待“已开启”。未接的编码器、超声波、触碰保持关闭，LED/蜂鸣器也关闭。勾选不会立刻转动电机。
4. 保持“测试模式按需注入未接传感器”勾选，再开启电机电源。点击对应轮子的正转/反转 0.5 秒按钮（PWM 120）。每条 MOTOR 指令只有 500 ms 租约，超时自动停止；日志 DEADMAN_TIMEOUT 是该按钮的预期收尾。未接真实编码器时，页面运动只是名义动画。
5. 测完点“关闭所有物理输出”：停止动作，关闭两路电机、LED、蜂鸣器和两路超声波 TRIG，保留所有输入开关选择；不会切断模块电源。

模拟距离来自网页场景，不代表真实避障。本次只做车轮悬空测试。前方小于 15 cm、侧面不足阈值或读数过期仍会拒绝动作。没有转动时检查 IO 回报、模拟输入复选框和场景阻挡，再检查电机电源、共地及 ENA/ENB 跳线。

未接编码器时使用短时单轮按钮或定时 MOVE/TURN，不使用 DRIVE/ROTATE。真实电机输出开启而对应编码器关闭时，计数型动作返回 PHYSICAL_ENCODER_REQUIRED，不生成虚拟脉冲冒充真实反馈。编码器关闭时无真实停转检测，但 500 ms 租约及定时动作时限仍生效。当前实测启动下限为 PWM 120，固件会将非零物理输出提升至至少 120。若 PWM 120 不足以启动电机，可在原有左右 PWM 输入自行调整，使用“连续控制”下发单条 500 ms 指令。

## 全部元件接线

| 元件/信号 | Uno IO | 说明 |
| --- | --- | --- |
| 左光槽编码器 DO | D2 | INPUT_PULLUP，下降沿计数，20 脉冲/车轮圈 |
| 右光槽编码器 DO | D3 | INPUT_PULLUP，下降沿计数 |
| 左轮驱动 IN3 / IN4 / ENB | D8 / D9 / D6 | ENB 使用 PWM |
| 右轮驱动 IN1 / IN2 / ENA | D4 / D7 / D5 | ENA 使用 PWM |
| 左 HC-SR04 TRIG / ECHO | D10 / D11 | 朝左；两个通道都开启才使用真实距离 |
| 右 HC-SR04 TRIG / ECHO | A4 / A5 | 朝右；作为数字 IO |
| 有源蜂鸣器控制/SIG | D12 | HIGH 触发；大电流模块或裸蜂鸣器使用驱动电路 |
| LED | D13 | 默认板载 LED；外接需限流电阻 |
| 顶部触碰 TOP | A0 | 开关另一端接 GND，按下 LOW |
| 左触碰 LEFT | A1 | 同上 |
| 右触碰 RIGHT | A2 | 同上 |
| 后触碰 REAR | A3 | 同上 |
| USB 串口 | D0 / D1 由板载 USB 串口占用 | 当前无需另接线，也不要再接其他串口主机 |
| 摄像头 | 不接 Uno IO | 当前电脑提供模拟输入；未来由 ESP32-S3 接摄像头 |

HC-SR04 VCC 接 5V、GND 共地。编码器及蜂鸣器模块供电/极性以实物为准。触碰按机械开关接地设计，不能直接套用不同极性的触摸模块。

物理开关只控制引脚驱动/采样，不控制模块电源。TRIG 可以单独开启发射，ECHO 独立控制采样；真实测距要同时开启该侧两项。真实超声波两项开启后，网页停止注入该侧模拟距离；真实触碰开启后，网页停止注入该开关模拟按压。LED/蜂鸣器先开启对应物理输出，再点“灯亮/闪烁/蜂鸣”。

修改 IO 会先停止当前动作、清除旧注入状态。切换某轮电机/编码器来源会清零该轮计数，避免混合虚拟与真实计数。可以按“编码器”“距离”读取回报。

所有设置只在本次上电有效。重启回到物理通道全部启用、LIVE 输入配置，电机/LED/蜂鸣器动作初值为停止，超声波可发射；需重新准备测试。关闭调试会停止运动、清除注入，不自动开启物理输出。原始兼容命令 DEBUG_MOTOR_MODE LIVE 会恢复全部物理通道。

## 新增串口协议

- CMD <id> GET_IO：逐项返回 DATA <id> IO <channel> ON|OFF。
- CMD <id> DEBUG_OUTPUTS OFF：关闭全部输出，保持输入通道选择。须先 DEBUG_MODE ON。
- CMD <id> DEBUG_IO <channel> ON|OFF：独立设置单通道。须先 DEBUG_MODE ON。
- DEBUG_MOTOR_MODE DRY_RUN：兼容的测试初始化命令，允许模拟输入并关闭全部物理通道，之后可以逐项开启。

通道名：MOTOR_LEFT、MOTOR_RIGHT、LED、BUZZER、SONAR_LEFT_TRIG、SONAR_RIGHT_TRIG、SONAR_LEFT_ECHO、SONAR_RIGHT_ECHO、ENCODER_LEFT、ENCODER_RIGHT、TOUCH_TOP、TOUCH_LEFT、TOUCH_RIGHT、TOUCH_REAR。

## 验证范围

固件编译与 Node 自动测试通过。界面操作、串口实物、IO 电平、电机方向及供电由用户测试；本次未烧录或驱动实体电机。
