SaitoTommo/CatTeasingRobot/ESP32真机移植观测边界.md

# ESP32 真机移植观测边界

2026-09-30 补充：最终目标是 ESP32 完整接管上位机，电脑仅作为调试浏览器。外部检测只可作为开发对照，不是最终完成标准；实施范围见 [ESP32 上位机与网页调试计划](./ESP32上位机与网页调试计划.md)。装死时视野外是未知，触碰释放不证明猫离开；未确认的等待超时保持停止。当前触碰传感器为左、右、后、上四路，后部模拟触碰默认开启；后方没有摄像头或超声波，超出触碰范围的位置未知。

本文档定义从网页仿真（uno-web-lab）移植到 ESP32-S3 真机时，每一个观测量从哪里来、误差多大、决策端必须如何降级使用。原则不变：

1. **所有传感器读数必须由物理交互产生**（图像像素、编码器脉冲、触碰开关、超声波回波），任何环节不得读取场景真值或隐藏状态。
2. **决策模块与传感输入、执行固件解耦**：决策只消费观测，不关心观测是仿真相机还是真实 OV 摄像头给的。

真机传感器清单：正前方单目摄像头（ESP32-S3 + OV2640/OV5640 一类），左、右各一个超声波传感器（已接在 Uno 上，固件 V5.2 已实现其运动安全）。**没有前向超声波，没有深度传感器，没有绝对定位。**

---

## 1. 观测量对照表

| 仿真观测量（core.mjs 产生） | 真机来源 | 精度现实 | 决策端用法 |
|---|---|---|---|
| `detected`（猫在 ±FOV、400cm 内、无遮挡） | 检测模型输出（置信度阈值） | 有漏检/误检 | 只作布尔；漏检的后果是继续扫描，可接受 |
| `centerX`（框中心/图像宽，0–1） | 检测框水平中心 ÷ 图像宽 | 高（对距离误差免疫） | **对准环的唯一输入**，见 §3 |
| `relativeDeg`（相对方位角） | 由 centerX 按镜头 FOV 反推 | 中 | 派生量，不作独立观测量 |
| `distanceCm`（射线测距真值） | **单目不可靠**，只能由框大小反推 | 差（±20–30%） | 禁止当绝对距离用，见 §2 |
| `bboxSize`（仿真里由距离正推） | 检测框面积/宽 ÷ 图像 | 中（单调可靠） | 距离层级、looming 差分的基础 |
| 前向 `CAMERA_FRONT` 厘米值 | 地面投影或猫框下缘估计，或降级为定性值 | 差 | 只送 `CLEAR/BLOCKED/INVALID`，15cm 安全阈值在 Uno 内部不变 |
| 左右 `sideSonarDistanceCm` | Uno 板载超声波（已有） | 好（±3cm） | 原样使用 |
| 扫描累计角 `sweptDeg` | Uno 编码器脉冲差（固件已有） | 好 | 360° 封顶逻辑原样移植 |
| 接近行程 | MOTOR 开启、MP 脉冲反馈、KEEP 续期、STOP 关闭 | 好 | 用编码器闭环，不依赖视觉测距 |
| 触碰 `TOUCH <AREA> PRESS` | Uno 触碰开关（已有） | 强 | **唯一的"到达猫身边"强信号** |

## 2. 距离：单目没有绝对值，用四层弱观测替代

仿真里 `cameraTargetObservation` 直接给出精确厘米数（core.mjs:99），真机复现不了。对应策略按可靠性排序：

**① 框宽层级（粗分远/近）。** 先验：猫身长约 45–50cm，在图像中框宽 `w_px ≈ k / 距离`。把 `farCatThresholdCm` 这类"绝对阈值"改为**标定后的框宽阈值**：实地把猫形道具放在 50/100/150/200cm 各拍 N 帧，记录框宽分布，取分位数当阈值。加两样东西防抖：
- **滞回**：进入"近档"用阈值 A，退回"远档"用更严的阈值 B（A<B 留间隙）；
- **驻留时间**：连续 M 帧（建议 ≥500ms）档位一致才允许切换档位，杜绝单帧误判驱动行为分类。

**② Looming 差分（趋势代替数值）。** 对框宽做时间差分：持续变大 = 在接近，持续变小 = 在远离。仿真里 `catLeaveDistanceCm`/`catLeaveSeconds`（猫离开判定）在真机上应改由"框宽连续缩小且最终漏检"触发，而不是比较厘米数。

**③ 编码器实测行程（控制距离靠轮子，不靠眼睛）。** 缓慢接近不依赖未标定的猫绝对厘米距离。对准后开启 MOTOR，持续消费视觉观测与 MP 编码器反馈，以测得行程和可见近档决定 STOP，并预留停止余量。巡游不再默认每 12 cm 停车；明确的互动试探停顿仍由策略决定。传感器失效或目标丢失必须按未知处理，不读取隐藏猫位置。

**④ 触碰即零距离。** `EVENT ... TOUCH ... PRESS` 是强观测：到了猫身边不需要知道距离。"到达判定"最终交给触碰，视觉档位只做粗分类。

**结论：对准与伺服不依赖距离；远/近行为分类依赖的是"层级 + 趋势 + 实测行程 + 触碰"，全部单目可产出。**

## 3. "边缘看到 → 转到正中间"真机全链路

这是图像伺服，全程只用 `centerX`，距离零参与：

```
loop（每帧，预期 5–15 fps 检测 / 25–50ms 控制）:
  if 未检测到:
     首次 MOTOR(+pwm,-pwm) 开启；KEEP 约每200ms续期（500ms租约），相同 MOTOR 也只续期不重启
     编码器累计角 ≥ min(360°, sweep_limit) → 报 FULL_SWEEP，按现有逻辑退出
     左右安全：Uno 超声波中止逻辑已有，勿绕过；中止原因按 SCAN_REVERSE 惯例反向
  else:
     e = centerX - 0.5
     if |e| < 对准容差(如 6–8%)  → STOP，进入下一行为
     else → MOTOR 按 sign(e) 转向；转向前查当前实体侧面测量（同 sceneTurnBlockReason 的观测接口）
  触碰按下 → 暂停对准、计时冻结（同 hold-position 逻辑）
```

要点：
- 检测容差别追求 <3%：帧率低、猫会动，6–8% 加一次判定即停，避免振荡；
- 电机速度对准阶段要低于扫描阶段（仿真 `alignPwm < searchPwm` 同理），否则冲过头来回找；
- 首次发现时 `centerX≈0 或 1`（视场边缘，±FOV/2 偏心）→ 回正最多约半个 FOV 的转角，肉眼就是"扫到就顺势转正"——与仿真行为一致，不是读了隐藏坐标；
- 低帧率要求保守处理数据新鲜度；过期或丢失的观测应停止相关动作或进入受限搜索，不能认为低帧率天然更安全。

## 4. 检测前端两条路线

| 路线 | 做法 | 优点 | 缺点 |
|---|---|---|---|
| A. 板载 esp-dl | ESP32-S3+PSRAM 跑自训练量化猫检测（参考 ESP-PCB-Design 流程，模型 ~100–300KB int8） | 离线闭环、延迟低 | 要自建猫数据集与训练管线；帧率低（3–10fps）；准确率有限 |
| B. 推流 + 外部检测 | ESP32 只出 MJPEG/RTSP，笔记本或边缘盒子跑 YOLO 类模型，把 `(detected, centerX, bboxW, ts)` 经 socket 回传 ESP32 | 模型强、迭代快 | 多一个 WiFi 依赖；**观测边界仍干净**——检测端只见像素，不见场景真值，与网页把观测喂 decision-system 同构 |

路线 B 可用于开发对照；按当前用户目标，最终验收采用 ESP32 自主完成观测与策略的路线 A。具体模型与资源预算尚未选定，表中规模/帧率仅为早期估计，不是本项目实测结果。

## 5. 现有策略参数在真机上的降级映射

| 仿真参数（decision-system.mjs） | 真机替代 |
|---|---|
| `farCatThresholdCm`（绝对距离分远近） | 框宽层级阈值（滞回 + ≥500ms 驻留） |
| `catLeaveDistanceCm` + `catLeaveSeconds`（猫离开判定） | looming 持续缩小 + 连续漏检时长 |
| `centerTolerancePercent` | 原样可用（centerX 是强观测量） |
| `slowApproachCm` 分段行程 | 原样可用（编码器闭环，本来就是测距之外的机制） |
| `searchTimeoutMs` / 360° 封顶 | 原样可用（编码器累计角） |
| `alignPwm`/`searchPwm` | 需实物重新标定（PWM↔转速非线性），先低速 |
| Uno 前向 15cm 安全距离 | 阈值不动；`CAMERA_FRONT` 值由 ESP32 从地面投影估计或送定性 BLOCKED |

## 6. 标定清单（先于任何行为实验）

1. 摄像头 FOV 实测（拍远处已知间隔标尺反推），把仿真 ±38° 换成真值；
2. 框宽-距离标定表（50/100/150/200cm，各 ≥30 帧，取 25–75 分位）；
3. PWM-转速、PWM-速度标定（Uno 端 `SET_GEOMETRY` 已支持编码器换算，沿用）；
4. 超声波左右安全阈值实车复核（现有 `SET_SAFE_DISTANCE`）；
5. 检测置信度阈值与漏检/误检率测试（静止、暗光、快速移动三组）。

## 7. 禁止项（保持观测边界的红线）

- 禁止把猫的仿真坐标、脚本阶段（`world.cat`、`CatMotionInput` 的 phase）以任何形式接入真机或真机回放数据管线——它们在仿真里也只允许 core.mjs 的传感派生读取；
- 禁止用"页面/调试端算好的方位角"替代 `centerX`——上位机之间只传观测，不传真值；
- 禁止绕过 Uno 的 500ms 读数新鲜度与触碰/超声波运动安全（固件 `motionSafetyReason` 原样保留）；
- 外部检测端（路线 B）只允许接收图像流，禁止接收场景 JSON 真值。
