SaitoTommo/CatTeasingRobot/esp32-host/统一找猫不检测居中-20261005.md

# 2026-10-05 统一找猫：检测到猫即可，不检测居中

用户要求主动找猫与被猫触发共用找猫实现，并取消居中检测。修改前的源码、网页、模拟器与文档已提交为 42b0cbd（ESP 0.34 基线）；原始未跟踪采集文件仍保留在本地。

ESP 0.35_UNIFIED_CAT_SEARCH 将所有 CAT 扫描成功统一转入 confirmCat：STOP 确认 → 两次新的编码器样本、零转速、最小等待与安静时间 → catConfirmWaitSeconds → 等待结束后的新 CAT 帧。复核有猫便分发 CHOOSE_TOUCH、CHOOSE_ROBOT、WAIT_CHASE 或原定后续行为，不读取 centerX、不使用猫居中容差，不下发 ALIGN_CAT 转向。主动行为选择复用这一张确认帧，不再次停车复核。复核暂时失去猫时按既有剩余扫描预算重试；无效帧、超时、触碰抢占与通信保护保留。

CAT_CONFIRM 最终请求帧时直接保持 CAT_CONFIRM，不再产生 CAT_CHECK → CAT_CONFIRM 的瞬间日志切换。主动接近/试探短段结束后的 SETTLE → CAT_CHECK 是运动后的实际停稳检查，仍保留；扫描寻找方向、逃跑转向与标签对准也仍保留。这些不再用于把猫框对到画面中央。

兼容：保存的 centerTolerancePercent、alignPwm、alignTimeoutMs 保留并标记 unsupportedSettings，不影响其他保存值；猫居中控件禁用并解释已停用，角度换算仅用于标签。猫远近框宽阈值、主动接近距离与概率、触碰互动分支、标签路线与对准不变。主动接近依照当前车头方向执行，不先把猫框转到中央。

日志依据：log49 只有 492911–504467ms 的标签巡游尾段，不能证明横跳现场。log50 在 645599ms 进入 CAT_CONFIRM，648580ms 确认新帧，648584ms 的 ROTATE 180 是逃跑方向转向，649331ms DRIVE 23 是逃跑，650210ms 再次扫描；并非 ALIGN_CAT。旧 encoder settle unavailable 时间戳 413943ms 不能当成本轮新故障。

验证记录另见下方；本轮仅源码修改、原生模拟检查与离线编译，未操作串口、上传 ESP/Uno 或运行实车。停稳耗时、识别可靠性与实车行为待测。
## 实际离线检查数据

- tests/run-native.ps1：扫描核心 259、实际 policy.cpp 1192、找猫检查 656、连续互动 618、PWM/设置 2656 项通过；视觉门控、实际串口帧校验通过；猫预览缓存与时序 20 项通过。
- node --test esp32-host/debug-page.test.mjs tests/state-inventory.test.mjs：37 项通过（模拟 DOM/接口，未浏览器实测）。
- 新检查覆盖 CAT_TOUCH/ROBOT_SEARCH × 猫框中心 0/0.2/0.8/1 × 宽度 0.1/0.2/0.5，完整扫描成功、停稳确认、最终新帧、直接选择行为；全程确认窗口没有 ROTATE/DRIVE/SR/MOTOR，也没有选择行为后的第二次 STOP。失去猫时两种入口均保留剩余扫描预算。
- git diff --check 通过。ESP 离线完整编译通过：Flash 3,774,014/8,257,536 字节，静态 RAM 85,352/327,680 字节。固件标识 ESP32_CAT_HOST_0.35_UNIFIED_CAT_SEARCH，尚未上传。
