SaitoTommo/CatTeasingRobot/esp32-host/三栏界面与猫框预览-20261005.md

# 2026-10-05：上位机三栏布局、独立识别原图与逐次耗时

顶部左侧传感器与电机输出回报，中间串口模式、启动巡游、主动找猫及停止，右侧摄像头、识别状态、识别原图与猫框。配置紧随其后分为三栏，动作／输出测试、串口日志放在配置下方，性能测试在页面末尾。窄屏自动收为两栏／单栏。

每次 ESP32 运行猫模型，独立缓存该次 JPEG 与 cat.box、score、frameSeq，提供 /cat-preview-frame；不依赖性能测试开关，不开启额外推理，不发送电机命令。浏览器 Canvas 绘制匹配原图上的框，新结果未找到猫时重绘原图清除旧框。默认显示识别原图，无结果时回退实时视频。可关闭预览、切换实时视频、隐藏猫框，偏好保存在浏览器本地。关闭预览时状态和耗时仍由 /api/state 更新。

预览下方显示逐次解码／模型推理／总处理／启动间隔。ESP 维护有限耗时缓冲，每次状态回报最近 16 条，浏览器去重保留最近 500 条、显示最近 10 条，缺失记录显示计数。总处理不含 HTTP 传输与浏览器画框。旧结果标记历史及时间，不把上一次识别当作持续看到猫；预览结果也不等同策略确认。

全部在本地：模型在 ESP32 推理，JPEG 和元数据通过局域网交给浏览器画框。没有云端识别请求。

本地页面、预览和性能测试 41 项通过；真实缓存／配对接口原生 20 项通过，现有原生策略回归通过。用户明确界面检查由本人完成，不使用 Computer Use 或内置浏览器检查。本次仅 ESP32 代码改动，Uno 无需更新；后续 Uno 上传必须先通知用户，等待用户拔掉板间串口线再操作。

部署证据：已授权仅更新 ESP32。COM11 上传前 USB 状态确认 STOPPED/UART、motorId=0、motorRunning=false、stopPendingId=0、stopUnconfirmed=false；3072 字节既有分区与编译一致，仅写应用 0x10000。Flash 3,767,914 字节，静态 RAM 85,264 字节；写入 3,768,064 字节、25.5 秒、Hash of data verified。USB 回读 ESP32_CAT_HOST_0.29_FPS_BENCH_3_ACTIVE_SEARCH_3_CAT_CHECK_3_PREVIEW、IDLE/SIM_UNO、cameraOk=true；原有保存配置变化 0 项，路线 [46,40] 与 catCheckMaxFrames=3 保留。尚未主动运行猫模型，因此预览缓存为空、耗时样本为 0；现场猫框显示与布局由用户检查。192.168.137.130 HTTP 在本次回读中超时，未确认部署页面的 HTTP 内容一致性。详见 evidence/camera-preview-layout-20261005/verification.json。未使用浏览器做界面检查，未上传 Uno，未运行实车电机。
