SaitoTommo/CatTeasingRobot/esp32-host/重连四轮与遥测重试-20261004.md

# ESP0.29：四轮恢复与有效配置判定

用户在log35诊断后明确授权：自动恢复增加到四轮，修正有效回报被判断失败的问题。本次仅ESP侧，Uno保持6.10。

1. 自动恢复最多四轮，保留每轮停车确认→会话停止→配置确认→必要时会话启动的顺序。所有轮次真正失败仍保持停车，未取消安全判断。
2. 配置解析同时用于普通启动WAIT_PATROL_CONFIG和恢复LINK_RECOVERY_CONFIG，校验命令ID、完整字段、有限数值、轮径20..150mm、轮距50..300mm、20slots/转、左右安全距离1..100cm。匹配有效DATA之后DONE才能前进。当前Uno6.10发出的完整配置兼容；不接受此前仅测试夹具使用的两字段简化包。
3. 不完整遥测已经收到经过现有校验的匹配DONE TELEMETRY时，释放telemetryId，按当前policyTelemetryInterval重新轮询：停稳/复核/恢复250ms，普通2000ms。保持三分片+有效DONE后才能发布快照；不改变CRC、停车门禁和编码器新样本条件。缺失或损坏DONE仍走原超时保护，不凭猜测完成事务。
4. 旧恢复测试人工置geometryConfirmed=true改为输入真实DATA+DONE序列；覆盖第四轮正确回复成功、错误ID、缺字段、NaN、slots错误、安全范围错误和尾部垃圾被拒绝，原FAULT恢复保持停车的契约仍覆盖。

原生实际policy1160项、连续互动252项、扫描259项、设置/PWM2640项及CRC/视觉门控通过；网页23项通过。源码与原生检查不代表实物串口根因已修复。Uno非人工重启、命令回环与电气噪声继续待查，本次修复的是ESP失败判定与缺帧后的恢复处理。

历史log34的reproduce.cpp按当时故障预期断言，应在b77a941/ee24f31代码版本下复现；当前版本以新增回归测试验证修复，不再把历史复现脚本成功作为当前版本标准。

部署证据位于evidence/uart-repro-20261004/post-v029/；现场复测通过后再提交本轮修复Git。

最终编译：Flash3,744,414/8,257,536字节（45%）；静态RAM79,000/327,680字节（24%）。严格完成回包检查另覆盖DONE编号错误、其他结果、多余尾字段及无挂起事务，均不得释放当前查询。

最终应用上传：COM11，0x10000，3,744,560字节，46.5秒，Hash of data verified。HTTP读回ESP32_CAT_HOST_0.29，SIM_UNO/IDLE，配置与上传前一致（verification.json）。Uno未上传。重开只读双串口捕捉，目录post-v029/capture；四轮恢复的实物验证仍待用户复测，本轮尚未提交Git。

用户验收：2026-10-04用户反馈‘目前来看应该没有问题，提交就好了’，授权本地提交。本记录属于当次现场反馈，未量化长期稳定性或证明UART物理根因已解决。
