SaitoTommo/CatTeasingRobot/esp32-host/自动恢复失败诊断-20261004.md

# 2026-10-04 log34：自动恢复收到配置后仍失败

本轮遵循用户“先不要改代码”：只分析导出/被动双USB抓取，运行不改变固件的离线复现，记录问题并提交已验收的现有版本。无烧录或设备控制。本地Git即可，不推远端。

## 确认的程序缺陷

ESP 0.28 / Uno 6.10。自动恢复的第三轮已经打通串口，但配置解析只允许主动作 WAIT_PATROL_CONFIG，不允许 LINK_RECOVERY_CONFIG。正确 DATA CONFIG 因状态门槛被忽略，geometryConfirmed仍为false；随后收到匹配DONE，恢复处理再次调用retryLink，因为已使用3轮而进入FAULT。

|ESP运行时间ms|日志证据|
|---|---|
|203187|发STOP #268|
|203198|收到DONE268 MOTOR_STOPPED|
|203233|收到DONE270 SESSION_STOPPED|
|203259|DATA271 CONFIG，轮径67.5mm、轮距120mm、左右安全距离1cm|
|203263|DONE271|
|203265|Uno link recovery failed after 3 attempts|

双USB COM10原始抓取柏林19:03:42.807495同时包含DATA271及DONE271*3A，证明配置确实由Uno发出。ESP导出也记录正确接收，不能归为这一步没有Uno回报。源码policy.cpp配置解析条件和恢复完成分支可直接对应。UI独立缓存能显示配置，不等于policy的geometryConfirmed已经设置。

精简证据：evidence/log34-diagnosis/log34-excerpt.json、serial-window.json。原导出位于D:/data/download/esp32-log(34).json，完整被动抓取保留evidence/uart-repro-20261004/post-v028/capture。

## 不改固件的复现

reproduce.cpp复用实际policy.cpp和原测试夹具：普通启动输入同一配置包时geometryConfirmed=1；第三轮恢复输入正确配置包时geometryConfirmed=0，匹配DONE后进入STOPPED/FAULT。输出保存reproduce.txt，退出码0表明该失败路径被成功复现，不代表修复通过。

原恢复测试直接设置geometryConfirmed=true，绕过真实DATA CONFIG解析，因此之前能通过的回归没有覆盖此次缺陷。这是明确测试盲点，本轮仅记录，不修改测试或固件。

## 与软件缺陷分开的通信异常

19:03:36起出现BAD_CHECKSUM、混入命令前缀/非ASCII的坏帧及UART_LOOPBACK；扫描VR回报出现命令回环，19:03:39收到SD251 39 3（TIMEOUT），不是扫描角度耗尽。紧接着初始停车及前两轮恢复停车收到共12条对应命令回环，没有匹配停止确认；期间仍有Uno诊断心跳和SD终态。因此不能称为整个Uno完全失联。通信异常为何发生，仍需检查电气、串口收发与调度，日志未证明具体根因。

第三轮STOP和配置均成功，是从通信异常转为ESP恢复状态漏解析的问题，不能继续统一称作链路未恢复。

19:02:34.073058（Berlin）COM10记录READY UNO_CAT_V6.10，随后EVENT DIAG_BOOT STAGE=74 CMD=94。用户随后明确确认没有碰过Uno，可以记录为运行期间的非人工触发重启。采集于19:00:46开始，启动出现在约107.6秒后，不是打开采集时立即出现的启动。供电、程序异常或其他复位原因尚未确认，不能用STAGE=74启动面包屑单独证明蜂鸣器引发重启。

## 手动切换为何表面恢复

208071ms操作者停止，208072 SIM_UNO；209195ms再次停止，209196 UART；之后STOP289、SESSION_STOP290、GET_CONFIG291均得到正常回报。切换路径停止策略、清理调试/紧凑遥测/历史观察、重新查询；它不要求完成自动恢复的geometryConfirmed门槛，也不自动恢复运动。通信其实在203198ms已有正常回报，只是自动恢复最终被程序判失败，人工切换清掉恢复失败的现场状态。不能由此认定切换修好了回环根因。

## 验收边界和后续方向

用户反馈本次探索声光等互动体验感觉没有问题，自动恢复仍失败。可提交当前验证版本，但不标记整机稳定性或恢复功能验收通过。以后若授权修复，应让普通启动与恢复共用经过命令ID/范围校验的配置解析，补实际DATA+DONE序列回归，并保留停车门禁；本轮未实施。
