SaitoTommo/CatTeasingRobot/esp32-host/探索声光组合-20261004.md

# 探索声光组合（2026-10-04）

ESP 0.27；Uno 保持 6.10，不增加 Uno 程序。

## 用户要求与硬件

四种灯光与四种声音自由组合；不亮、静音各算一种，但不能同时选中。未来使用 WS2811 灯带；本次仅以 XIAO ESP GPIO21 板载单色灯模拟节奏，不实现颜色、流水或实际灯带接口。

蜂鸣器：TinyTronics Active Buzzer 5V，输入 3.5–5.5V DC，电流小于25mA，标称2300±500Hz。商品说明为供电即鸣叫，无需输入频率。采用开关时序控制长短音，不声称实现可变音高。
https://www.tinytronics.nl/en/audio/speakers/buzzers/active-buzzer-5v

## 四种独立形式

|灯光|时序|
|---|---|
|不亮|保持关闭|
|常亮|1800ms|
|慢闪|2400ms；每800ms亮300ms|
|双闪|3000ms；每1200ms在0–180ms、400–580ms亮|

|声音|时序（ESP调度时间）|
|---|---|
|静音|无正时长BEEP|
|长响|600ms一次|
|两声短响|0ms、800ms各180ms|
|三声短响|0ms、600ms、1200ms各150ms|

组合时两个序列各自运行，到较长序列结束。本次15种组合随机不放回选取，用完重置，相邻组合不重复。蜂鸣器实际节奏还受串口排队和Uno调度延迟影响，实物听感待测。

## 行为与边界

初次找到猫并停车复核、选择探索后播放第一组。探索静止等待期间每次新的按压立即换组，长按不重复，保留原互动编号与探索分支。中途重按替换旧组，不叠加定时序列。没有按压时不自行循环声光。无互动后的找猫、观察超时、装死与逃跑流程保留；运动或找猫期间的触碰仍优先停车和安全交接。

灯直接在ESP调度，延迟到达的Uno HOST_LED事件不能覆盖当前探索灯光。停止、故障、通信恢复取消未播放的后续声音，延迟循环跳过已过期音节，避免集中补发。

网页LED开/关由ESP直接写GPIO21，不发送Uno串口命令，不需要Uno解锁、近期Uno遥测或停车回报；需策略处于IDLE/STOPPED，避免覆盖自动灯光。模拟串口模式下也可测试本地LED。急停、模式切换和重启熄灯。

## 验证

真实policy核心1051项、连续互动252项、扫描259项、设置/PWM2640项通过；CRC/视觉门控通过。网页23项通过。覆盖15种组合、各灯光输出、各声音脉冲、连续按压与长按、不自主重播、停止取消、过期音节跳过及本地LED模拟模式控制。

最终编译与上传结果见 evidence/uart-repro-20261004/post-v027/；实际灯光、声音及触碰响应需现场验收。

最终编译：Flash 3,744,202 / 8,257,536 字节（45%）；静态RAM 79,000 / 327,680字节（24%），剩余248,680字节。应用BIN 3,744,352字节。相比ESP0.26 Flash增加2,804字节，静态RAM增加8字节。Uno保持6.10，其原有Flash仅剩2字节；本次不向Uno加入模式表或新协议。

部署完成：COM11 app-only 0x10000，写入3,744,352字节、46.5秒，Hash校验通过。HTTP回读ESP32_CAT_HOST_0.27，保存配置变化0项。模拟模式/IDLE下分别执行网页同路径manual_test led_on、led_off：GPIO21回读LOW/亮、HIGH/灭，记录2条HOST_LED_LOCAL，LED串口命令0条。最终保持灯灭；上电默认SIM_UNO/IDLE，真机互动测试请切Real UART。此回读验证软件控制状态，不代替肉眼灯光、听感和实际按压验收。

恢复双USB只读捕获30分钟：evidence/uart-repro-20261004/post-v027/capture，COM10 57600与COM11 115200，DTR/RTS=false、writes=0；旧post-v026-uno610捕获已关闭保留。

## 0.28 并行响应修正

用户现场发现0.27在找猫期间再次按压没有声光回应。原因有两层：onTouch只在SIGNAL/OBSERVE/FOLLOW_WAIT/WAIT_CHASE无电机命令时触发；awaitStop和beginScan交接清空输出/发送队列，也会取消或丢失回应。

本次将选择/播放组合拆为playExplorationResponse，独立于主状态action。探索分支在扫描旋转、扫描配置、等识别帧、停车复核、等停止回报期间的新按压，都先按原逻辑安全停车，再启动并行回应；不把主状态改为SIGNAL，不重抽互动分支。静止复核保留原deadline/generation，新按压不重新开始找猫。扫描的触碰暂停和松开续扫仍保存已使用角度。

非终止性停车保留声光定时序列；清理扫描队列后只恢复当前尚未过期的音节，不重放整组。声光调度在扫描/配置等待的提前return之前运行。ESP本地灯直接更新；蜂鸣命令仍受原串口停车门禁约束，确认后执行队列中的有效回应。后续调度只恢复剩余有效音节。总停止、故障、退出互动、通信恢复仍取消声光。回应完成计数独立处理；随机装死决策延后到没有电机命令的静止行为节点，不在扫描中途抢走状态。

回归覆盖各找猫/复核节点、重复按压不改互动身份、停车门禁、暂停松开续扫保留声光、故障终止取消。实车并行效果仍待现场验收。

0.28回归结果：实际ESP policy核心1142项、连续互动252项、扫描259项、设置/PWM2640项，CRC与视觉门控检查均通过，网页23项通过。新增验证：回应结束且装死概率100%时扫描仍保持SEARCH_CAT_ACTIVE，待进入无扫描/无电机/无会话交接且停车确认的静止节点才允许装死。Uno源代码和协议格式未在本轮更改；逃跑距离与原有追逃、装死、巡游回归保留。

0.28最终构建：Flash3,744,614/8,257,536字节（45%）；静态RAM79,000/327,680字节（24%），剩余248,680字节。构建证据post-v028/build-final.txt。

0.28部署完成：COM11 app-only 0x10000，写入3,744,768字节、46.5秒、Hash verified。HTTP回读ESP32_CAT_HOST_0.28，保存配置0项变化；启动SIM_UNO/IDLE。只读双串口捕获已恢复到post-v028/capture（30分钟，writes0）。本轮无Uno烧录，无实车运动/声光并行验收。
