SaitoTommo/CatTeasingRobot/esp32-host/通信恢复与停稳检查-20261004.md

# 2026-10-04 ESP 0.24：通信恢复与停稳检查

## 实测证据与限制

- log28 导出时 `lastUnoAgeMs=208`、`DONE 343 TELEMETRY`，同时保留 `Uno link timeout`。当前连接与锁存故障不是同一时间的状态。
- 双串口采集：ESP ms259484 收到 DONE310，ms261986 触发超时，ms262897 收到真实 DONE313 MOTOR_STOPPED。不能据此确定通信中断的电气或调度原因。
- log29：ms426645 收到 STOP475 确认，ms426646 进入 SETTLE；后续编码器有增量，遥测仍报告非零转速。期间没有新的运动命令。用户明确为架空车轮测试，持续旋转原因未确定，不能归因为车辆在地面滑行。
- 该日志导出时已因 `alignment budget exhausted` 结束找猫，重新进入标签巡游扫描；导出的 `scanPhase=SETTLE` 是另一个扫描停稳阶段。
- log30 覆盖不到此前故障，但记录 ms771205 SIM_UNO、ms773355 UART、ms773486 STOP669 确认。双串口完整记录仍保存在 `evidence/uart-repro-20261004`；此前 STOP639 回显、坏帧及 STOP_UNCONFIRMED 与本轮模式切换分别记录，不能把模拟停车回复当成真实恢复。

## 改动

1. 活动流程出现 2500ms 通信超时或停车未确认时进入有上限的恢复流程，最多三轮。清理旧运动、旧扫描、视觉请求、串口半行、紧凑遥测及调试状态，保持真实 UART。
2. 每轮必须依次取得对应命令的真实停车确认、SESSION_STOPPED、配置/几何确认、SESSION_STARTED。单纯诊断消息或旧命令回复不能放行运动。停车命令仍使用原有三次重发机制；恢复阶段超过2500ms则换下一轮。失败后保留 FAULT。
3. 恢复成功后，互动重新寻找猫；保留已选择分支和轮数，不重放旧逃跑距离。巡游重新找当前标签。操作者停止或切换模式会取消自动恢复；检测到 Uno 重启仍按原有重启故障处理。
4. 原有停稳检查只看计数和时间。现在另要求两侧编码器转速为零；原地复核每250ms请求遥测，复核期间出现非零转速则重新停车并重新计时。
5. 页面解释通信重试步骤；历史 FAULT 与当前收到 Uno 数据同时存在时明确提示。

## 验证边界

原生回归包含真实 policy.cpp：错误类型停车回复不能放行、三轮恢复上限、诊断消息不能放行、保留互动分支、取消恢复、非零转速禁止识别及重新启动复核计时。源码检查及编译不能证明实际引脚已归零，也不能解释或消除持续车轮驱动、串口命令回显、Uno 自发复位的根因。
