SaitoTommo/CatTeasingRobot/esp32-host/FRONT_VISION_REFERENCES.md

# 前向视觉检测的研究依据与实现范围

## 先前讨论

先前对话「ESP32避障方案比较」（conversation `6ab8d23d-0bbc-83eb-ae83-131ef95469fc`，相关回答 `c8bb1c3a-73a1-4c8d-8a1a-3b7dc60cd754`）讨论了地面识别、地面平面检测、逆透视映射（IPM），并建议固定向下的相机、下方 ROI、学习地面外观、检测非地面区域，以及用地面接触点标定距离。

2026-10-01 回查确认：此前讨论有文献引用。可读取的对话导出只保留引用占位符，未展开原始引用 URL；下面的论文是本次重新核验、直接支持该研究路线的背景文献，不声称已恢复当时每一个引用链接。

## 核验后的论文引用

Lee, T.-J., Yi, D.-H., & Cho, D.-I. “Dan”. (2016). **A Monocular Vision Sensor-Based Obstacle Detection Algorithm for Autonomous Robots**. *Sensors*, 16(3), 311. https://doi.org/10.3390/s16030311

- 出版社全文：https://www.mdpi.com/1424-8220/16/3/311
- PubMed 题录与摘要：https://pubmed.ncbi.nlm.nih.gov/26938540/
- PMC 全文：https://pmc.ncbi.nlm.nih.gov/articles/PMC4813886/

论文将图像下方 ROI 的像素分类为地面或障碍，结合 IPM 几何信息和地面外观模型，使用马尔可夫随机场进行分割，并计算障碍到机器人的最短距离。它支持“单目相机结合地面模型检测障碍”的思路。

## 当前代码与论文的关系

当前 `ESP32CatHost/vision.cpp` 沿用先前讨论的地面外观参考路线，实现了一个简化检查：保存空地参考，比较下方中央 ROI 的 24 个灰度块均值，输出 CLEAR / BLOCKED / INVALID。

它没有实现该论文的 IPM、垂直平面模型、自适应外观学习、马尔可夫随机场分割或最短距离计算，因此应描述为**有相关文献依据的简化原型**，不能描述为该论文算法的完整复现或已验证的 ESP32 移植。

24 块、差异阈值 35、猫框底部比例 0.88 是本项目初始工程参数，不来自该论文。猫框近底部判阻挡是额外启发式规则。论文的准确率和距离误差不适用于当前实现；本项目尚未测得对应性能。

报告可用表述：

> 前向视觉模块参考单目地面/障碍分割研究路线（Lee et al., 2016），采用地面外观参考的轻量化原型；当前实现未包含论文中的 IPM、MRF 分割和距离估计，需通过实际场景测试验证。
