SaitoTommo/CatTeasingRobot/evidence/log45-48-review-20261005/诊断.md

# 2026-10-05 日志45–48诊断

由两个子代理分别完整读取45/46与47/48。四份版本均为 ESP32_CAT_HOST_0.29_FPS_BENCH_3_ACTIVE_SEARCH_3_CAT_CHECK_3_PREVIEW。

|日志|ESP ms|frameSeq|heap|日志数|
|---|---:|---:|---:|---:|
|45|2245|8|49972|8|
|46|2265|9|44968|8|
|47|8291|39|46104|21|
|48|8525|40|47580|21|

四份都是 IDLE/SIM_UNO，droppedLogs=0，没有 SETTLE/CAT_CHECK、主动找猫或运动轨迹。45/46日志相同；47/48日志相同；共同起始记录为seq1/ms152/READY ESP32_CAT_HOST，seq2/ms503/CAMERA init=0。uptime持续增长、启动记录一致，支持四份来自同一次ESP启动，不能计为四次重启。

明确捕捉到ESP刚启动，不能区分手动复位、断电、软件重启或异常崩溃。若与此前log42(ms450806、UART)属于同一设备的先后采样且中间未主动复位/上传，则uptime降至2245与启动日志重现支持中间发生ESP重启。文件自身未记录导出墙钟时间、reset reason、brownout、watchdog、panic，因此无法定位原因。

重启后处于SIM_UNO并周期记录 INPUT_REJECTED source does not match mode；这表示输入源与模式不符，不能当作重启原因。47/48的7023ms TELEMETRY_TIMEOUT属于模拟通路无应答，不证明ESP重启。无Uno uptime或READY UNO记录，不能判定Uno是否重启。

重启前日志不在四份文件中，故本次不能确认或排除主动找猫的反复横跳。前述log40存在明确动作/退出后巡游命令；CAT_CHECK三帧已实现，但OBSERVE/SIGNAL等其它单帧退出及每1cm停走重检仍存在。网页断连和ESP重启需要分别记录；目前未实现reset reason/WiFi/HTTP/min heap/largest block诊断，也未修复轮询负载。

本轮仅只读分析与Git归档，无固件修改、设备测试或上传。界面与物理验收由用户完成。
