SaitoTommo/CatTeasingRobot/evidence/rotation-avoidance-review-20261013/literature-and-design.md

# 快速直线逃离：文献核实与设计调整（2026-10-13）

## 核实结论

用户假设具有明确的指南依据：Ellis et al. (2013), AAFP and ISFM Feline Environmental Needs Guidelines, Journal of Feline Medicine and Surgery 15:219–230, DOI 10.1177/1098612X13477537，在 Pillar 3 / Using play to provide exercise and mimic predatory behavior 中建议使用逗猫棒模拟地面猎物，原文为“moving in straight lines swiftly away from the cat”。

原文链接：https://pmc.ncbi.nlm.nih.gov/articles/PMC11383066/
本地已提取全文：猫互动声光与探索文献-20261013/sources/13_Ellis_2013_Environmental_needs.txt（749–753 行）。

证据边界：这是专业指南的仿猎物玩耍建议，不能直接表述为实验已经证明猫普遍更喜欢快速直线而非其他轨迹。指南没有给出机器人速度、逃离距离、转身方式或等待时长的参数。

Hall (1995) 的博士论文摘要报告：最强烈的玩耍由小型、移动、具有真实鹿毛/羽毛/仿毛覆盖的玩具引发。它支持移动与其他猎物特征的作用，摘要并未建立直线或某个速度优于其他运动的结论。
原始机构来源：https://eprints.soton.ac.uk/459217/

2018 年 Enrichment Preferences of FIV-Infected and Uninfected Laboratory-Housed Cats 报告激光条件的互动强度较高，讨论快速运动可能诱发捕猎行为，但同时承认新奇性、运动量和先后呈现等解释限制，并指出互动强度比较不是经典同时选择的偏好测试。该研究没有独立操纵速度和直线轨迹。
来源：https://pmc.ncbi.nlm.nih.gov/articles/PMC6071041/
本次网络全文打开遇到验证页；相关方法及讨论已通过现有本地全文核对。

本次检索没有找到直接比较快速直线、慢速直线、曲线、以及分段/连续转身后的机器人逃离偏好的对照实验。未检索到不代表这样的研究绝对不存在。

## 对实现的调整建议（尚未修改策略）

保留“一次性连续直线逃离”作为行为设计目标，不把周期性停车做成正常逃跑节奏；持续避障判定可以在同一次 DRIVE 期间运行，出现阻挡、无效或超龄数据时打断停车。

将转身准备与直线逃离分成不同阶段：转前 STOP/停稳/新观测 → 必要时连续转身 → 转后停稳和新前向观测 → 一次性连续直线逃离。现有指南支持最后阶段的运动目标，但没有规定之前必须连续转身，也没有证明分段转身会降低猫的兴趣。

连续转身需要先证明车身旋转扫掠范围与传感器覆盖条件；当前前向地面外观差异和两侧距离读数无法证明整个旋转空间没有障碍。不能仅凭固定 15/10 cm 阈值将其当作已验证安全。

合并仍有价值：移植远程的转前/转后观测和停稳机制，保留 DEV 的既有开关及互动行为；修补短移监测、侧距 UNKNOWN、触碰恢复跳过转后检查等问题。不要将分段转身或自动前移 4 cm 两次作为无条件默认恢复策略。

快速逃离的参数需要依据实测车速、前向判定范围、图像/推理/通信延迟和停车距离确定。现有 CLEAR 是地面外观差异算法的输出，不是可行走距离测量，因此当前不能只从文献或 PWM 数值确定安全速度和距离。

建议先验证运动/感知条件，再用少量同猫对照观察比较连续转身和分段转身；保持直线逃离速度、距离和声光一致，分别记录追逐、扑击/接触、中途退出和回避，不将仅注视当作喜欢。

本轮只有文献和设计评估；DEV 已跟踪代码未改，没有合并、推送、烧录或运动。
