SaitoTommo/CatTeasingRobot/串口回报匹配检查-20261012.md

# Uno 回报编号与完成格式检查（2026-10-12）

用户日志的实际序列为 STOP → SESSION_STOP → GET_CONFIG。配置正确回报 REMOTE_V1，随后 `DONE 114` 已在 258178 ms 被 ESP 接收，但遥控接管在约 260653 ms 报确认超时；原代码只匹配 `DONE 114 `，漏掉无尾缀完成行。修复后的 ESP 0.44 在 CONFIG 阶段接受相同编号的裸 DONE；停车和会话操作仍要求对应完成原因，不把 AK 当作完成。

| Uno 操作/回报 | 实际格式 | ESP 检查结果 |
| --- | --- | --- |
| GET_CONFIG | DATA id CONFIG ...；DONE id | 遥控已修复；自主启动和通信恢复原本接受裸 DONE/CONFIG；调参回读按相同 id 匹配。 |
| GET_IO、部分 DEBUG 查询 | DONE id | uno_debug 先读取并匹配 id，不依赖尾缀。 |
| STOP | DONE id MOTOR_STOPPED | 停车门禁、策略和遥控要求相同编号及停止原因；物理来源要求 CRC。 |
| SESSION_START / STOP | DONE id SESSION_STARTED / SESSION_STOPPED | 策略和遥控匹配相同编号及完成原因。 |
| SET_GEOMETRY / SCAN_CONFIG | DONE id GEOMETRY_SET / SCAN_CONFIGURED | 自主步骤检查相同编号和原因；调参流程通过 id 跟踪。 |
| GET_TELEMETRY | TB id part ...；DONE id TELEMETRY | 三帧相同编号，检查长度、CRC、期限、完整性及末尾编号；裸 DONE 不误当遥测完成。 |
| 运动确认/完成/中断 | AK id；MD id left right；MA id reason left right | 策略解析编号与参数，遥控只接受当前运动编号；迟到的旧编号不能恢复动作。 |
| 扫描视觉/结束 | VQ id step generation ...；SD id generation result | 检查当前扫描编号、代次及字段数量。 |

本轮未发现另一处同样因裸 DONE 尾部匹配漏判造成的确认超时。按用户要求不扩大全套测试：受影响网页 61 项、实际路线保存控制器 17 个断言、实际遥控控制器 71 个断言通过。

已烧录 ESP 0.44，Uno V6.13 未改动。真 UART 静止验证确认进入遥控、退出遥控均成功，未发送运动指令；保存现有路线得到对应请求的 saved 回报。写入哈希校验和独立 ROM verify-flash 摘要比较成功。动作方向、声光和真正巡游的现场效果仍由实车验收确认。原始证据见 evidence/route-editor-20261012/。
