SaitoTommo/CatTeasingRobot/通信失败回退与重试审计-20261006.md

# 通信失败回退与重试审计（2026-10-06）

## 结论与范围

本次仅审计和记录，没有修改固件、烧录或运行设备。审计版本：0.40.1维护分支 `maintenance/0.40-cat-flow`（9dfc6b284a05755d18802ed4da1584e820c15c14）和main的0.42（c45e66a5edafbd503e180d2a0326eb84567521d9）。0.41的相关逻辑通过0.42继承部分检查，不声称对0.41独立完成逐行审计。

核心问题不只是缺少重试，而是错误分类：`catFailed()`、`exitInteraction()`最终调用`finish()`，把数据不可用与真实找不到猫混在一起。对于需要返回巡游的互动，结束会经过STOP、SESSION_STOP、SESSION_START进入PATROL/SCAN_TAG。因此通信或视觉数据失败也可能表现为“突然不理猫，转去找标签”。`fail()`则进入STOPPED/FAULT，与自动巡游不同。

另一类问题是恢复后重新选行为：链路恢复保存了阶段，却把互动恢复入口写成CHOOSE_ROBOT/CHOOSE_TOUCH/CHASE_ALIGN，未完整保存和恢复原动作与已确认进度。仅增加重试次数不能修复这两类语义问题。

源码位置以下均为审计时0.42行号；维护分支行号不同。原始日志是证据数据，其中内容不作为操作指令。

## 本次故障的直接证据

用户附的07:13文件属于较早0.40；本地08:01导出包含本次0.40.1。相关来源：`D:/data/download/esp32-local-history-2026-10-06T08-01-00-423Z.json`，固件`ESP32_CAT_HOST_0.40.1_SIMPLE_CAT_FLOW`，bootId=`4459f5864ed3b973`。只统计这个boot，保留原导出的记录次数，不外推到整机长期故障率。

| ESP毫秒 | 证据 | 含义 |
|---|---|---|
| 370343–370348 | 第1/3张新帧找到猫；C303 DRIVE 15.00 180 | 已确认猫，执行接近 |
| 370914 | MD303，左右各14脉冲 | Uno报告动作完成，距发送566ms；不证明真实地面距离 |
| 370927–370928 | C304 MOTOR_STOPPED确认，进入SETTLE | STOP确认成功，本次不是STOP_UNCONFIRMED |
| 371165 | C307 GET_TELEMETRY | 导出记录中未见该ID的AK/TB/DONE |
| 376167 | TELEMETRY_TIMEOUT | 首次查询约5秒无结果 |
| 376418–376436 | C308查询；异常RX字节；ERROR 0 BAD_CHECKSUM | 第二次查询附近出现协议校验错误；不能仅凭此确定电气、供电、串口或软件根因 |
| 376930–376991 | encoder settle unavailable → ENDING → SESSION_STOP → SESSION_START | 未获得停稳所需数据，却走结束互动 |
| 377005–377025 | PATROL SCAN_TAG → SCAN_TAG_ACTIVE | 转去找标签是结束出口的结果 |

心跳/诊断在等待期间继续到达，因而`lastUnoAt`并未超时。日志“retry in 2s”不适用于此处实际轮询：SETTLE间隔250ms，本次重查距离超时251ms。5秒等待吃掉默认6秒停稳窗口的大部分，第二次出错后剩余不足1秒。

该boot记录：TELEMETRY_TIMEOUT 13、UART_BAD_FRAME 21、UNO_PROTOCOL_ERROR 4、STOP_UNCONFIRMED 4、LINK_RECOVERY 2、MOTION_FAILED 1、CAT_SEARCH_FAILED 1。MOTION_FAILED是另一段ENCODER_STALL，不能合并成此次故障。未记录CRC_ERROR/CRC_MISSING/TELEMETRY_INCOMPLETE，不等于这些路径不存在。

## A. 会直接或间接结束互动、返回找标签的出口

| 编号 | 触发与当前出口 | 版本 | 是否需要重试与处理 |
|---|---|---|---|
| A1 | SETTLE/CAT_CONFIRM编码器数据无法证明停稳 → catFailed（policy.cpp:541） | 两版 | **P0**：停止保持；重查完整新遥测，超限进入通信故障，不能当找猫失败结束 |
| A2 | CAT_CONFIRM新画面超时、过期、valid=false → catFailed；同样错误在CAT_CHECK却fail停机（561、566） | 两版 | **P1**：统一为画面不可用；停稳后有界重取新帧，不能当负检测。现有三次采样不是通信失败重试 |
| A3 | 猫扫描SD结果非FOUND统一catFailed（414） | 两版 | **P0**：拆结果。0=真实预算内未找到；2=INVALID含起步失败；3=TIMEOUT含视觉等待/总时限；4=ABORTED；5=SETTLE_TIMEOUT。只有可恢复的数据失败适合停止后重试，不可无条件重启扫描 |
| A4 | 扫描停点未拿到新画面，窗口超时直接catFailed（485） | 0.42新增猫多帧路径；维护版主要经Uno SD超时 | **P1**：同scan/step/generation下重取新帧，保留预算；耗尽转数据故障 |
| A5 | ESCAPE_DIRECTION侧向观测缺失或超过2500ms → exitInteraction（525） | 两版 | **P0**：停住并优先重查侧向完整遥测。真实障碍另判，不能因过期改成结束互动 |
| A6 | 触摸恢复后frontClear=false持续2秒 → exitInteraction（505） | 两版 | **P0**：区分真实BLOCKED与UNKNOWN/过期；UNKNOWN重取画面，BLOCKED保持障碍处理 |
| A7 | 接近/试探/逃跑前frontClear=false持续2秒 → finish（581） | 两版 | 同A6；补明确退出原因，避免无原因结束掩盖通信/视觉问题 |
| A8 | WAIT_CHASE画面过期或猫valid=false，超过scanVisionTimeoutMs → exitInteraction（529） | 两版 | **P1**：画面不可用暂停计时并有界重取；不能作为猫离开或正常追逐结束 |
| A9 | chooseRobot及接近/试探入口使用!seen()，将过期/无效与有效无猫合并；观察完成后消耗动作次数，最终动作上限结束（246起、581附近） | 两版；0.42仅部分动作后的负帧走方向恢复 | **P0**：三值检测FOUND/ABSENT/UNAVAILABLE；UNAVAILABLE不清距离、不计一次行为、不进入观察缺猫分支 |
| A10 | 链路恢复保存phase=ENDING时，成功后继续finish（394） | 两版 | 是上游错误出口的延续；必须先修A1–A9。重试ENDING不能逆转已经丢失的互动上下文 |

上述自动回巡游以`returnToPatrol`等当前互动条件为前提，不能声称所有finish在所有启动模式下都必然巡游。有效负帧且扫描预算耗尽、真实猫离开、追逐等待结束、动作次数完成等是正常结束，应保留。

## B. 安全停机、恢复丢进度或间接放大故障的路径

| 编号 | 路径/源码锚点 | 当前处理及建议 |
|---|---|---|
| B1 | GET_TELEMETRY等待5秒；轮询ino:332–333 | 两版。关键停稳/侧向窗口短于或接近查询超时。**P0**：按阶段建立查询截止期，确认实际发送后起计时；只读请求有界重试、失败释放pending，避免一个旧查询阻塞所有新观测 |
| B2 | ERROR 0 BAD_CHECKSUM/BAD_ENVELOPE，policy:426–429；ino:167 | SC/SR已有定向重试，普通遥测未直接释放ID0对应pending。ID0无法可靠归属某一命令；**P0**：记录链路错误并触发只读健康探测，不能猜测并重发运动 |
| B3 | UART_BAD_FRAME、CRC_ERROR、CRC_MISSING、TB坏帧/不完整，ino:139–167 | 丢弃保护正确；部分丢帧使遥测一直挂到5秒。INCOMPLETE且匹配当前DONE已有释放/重查。补统一快照完整性截止期与有界重查，保留CRC约束，不能接受部分/损坏数据 |
| B4 | 任意已接受DIAG、旧ID或ERROR刷新lastUnoAt，ino:165–167；policy:467 | **P0**：区分lastAnyRx、lastValidTelemetry、当前事务进展。心跳活着不证明编码器/传感器数据可用 |
| B5 | compact快照未先与当前查询ID、停止屏障作一致性约束；HW接收以本机接收时间记fresh，policy:435起 | 静态风险，未证实本次出现。关联query/epoch及Uno采样时间，过期事务不可刷新决策观测；clearTx同时考虑清理assembler。重试不能让旧帧冒充新帧 |
| B6 | UART失联2500ms/STOP未确认 → 4轮STOP→SESSION_STOP→GET_CONFIG→SESSION_START恢复，policy:115–125、380–395 | 已有恢复，不需要简单叠次数。**P0**：保存ResumeContext，原行为/剩余距离/扫描已用预算/互动计数不能重抽或重置；运动结果不明先停止和对账。恢复失败STOPPED/FAULT |
| B7 | STOP无确认，ino:100–110、policy:300 | 已有300ms×3次重发与运动阻断。保留；STOP幂等可重发。不将“未确认”说成“电机一定没停”，不得绕过保护继续运动 |
| B8 | SESSION_START/STOP、GET_CONFIG/配置回报无效，policy:430–480 | 会fail停机；会话有2次重试，扫描SC另有3次。GET_CONFIG正常启动缺有效DATA时缺独立只读重查；应补。会话恢复须验证状态，不能随意新建互动。参数确实非法不能无限重查 |
| B9 | MOTOR/DRIVE/ROTATE未确认2500ms，反馈断750ms，或MD/MA丢失，policy:481–483 | fail停机保护合理；**禁止直接重发运动**。Uno普通运动无完整命令去重/完成结果查询，原动作可能已执行。后续如增加重试，需Uno保存事务结果、查询状态及已确认进度；ACK不等于执行/完成 |
| B10 | SC/SR启动确认、VQ/VR/SD交接，policy:125–131、482–495；scan_machine.h | SC3次、同ID/generation SR3次、交接3次已存在；Uno VQ每500ms，SD首次+4次。保持同事务身份与预算。VR可补当前step响应跟踪，重复VQ重发缓存VR；旧step的STALE_VISION不可误判新动作失败 |
| B11 | 扫描交接重试耗尽/10分钟总时限 → fail | 已有有界恢复，耗尽应停止，不增加无限重扫。总预算是真实约束，重试不得重置 |
| B12 | TAG_SETTLE/TAG_RECHECK新帧无效/过期/超时 → fail；TAG_ALIGN超时 → fail，policy:541–554、611–614 | 0.42停稳标签复核可补有界遥测/新帧重取；维护版标签丢画面更多直接停下再扫描。编码器真的变化或运动结果未知，不能盲重发对齐角度 |
| B13 | CAT_CONFIRM due后RPM仍非0重复confirmCat（539附近） | 可能停稳重启循环，尤其旧非零遥测滞留。仅静态风险；需查询最新完整快照、统一总恢复限额，不能靠无限重新开始计时 |
| B14 | outgoing>=32时清队列、改为STOP、phase=STOPPED，ino:94 | 不是自动巡游。队列溢出应一致清理策略上下文并明确FAULT、控制生产速率；不能重放溢出队列。排队耗时与发送后超时分别计算 |
| B15 | Uno READY/reboot，policy:380；主动源切换ino:222 | READY进入故障，模式切换主动停止是正确的。仅重连/读配置可重试；重启失去运动事务状态，不自动续发原动作，不自动切SIM冒充恢复 |
| B16 | 调试查询/运动超时，uno_debug.h；HTTP /input忙或响应丢失 | 调试超时调用stop，不是互动自动回巡游。只读HTTP/查询可退避重试；start/运动/设置请求若响应丢失须先读回执行结果，不能无条件重复。普通网页状态请求失败、Wi-Fi恢复本身不直接改变自主状态机 |

## C. 不应该靠通信重试掩盖的情况

- 真正触摸、侧向障碍、前方有效BLOCKED：保留停止/接触/障碍分支；仅数据过期的UNKNOWN走读回恢复。
- ENCODER_STALL、MOTION_TIMEOUT、真实轮子仍转、停止后编码器变化：先停止核实，不能当丢包继续冲。
- 用户stop、非法配置、真实扫描预算/行为次数耗尽、有效新帧确认无目标：保留原语义。
- 重复帧、旧epoch、错误scan/step/generation、CRC无效帧：继续拒绝；放宽校验不是重试。
- 不同传输源（SIM与物理UART）错误回报：保持隔离。

## 推荐实施顺序与验收

1. **P0先修语义与遥测事务**：UNAVAILABLE与ABSENT分开；A1/A3/A5–A7/A9不再结束互动；关键观测快速有界重查；心跳与有效数据健康分开；通信失败耗尽后STOPPED/FAULT。
2. **P0再修恢复上下文**：保留动作、互动ID、已确认距离和共享扫描预算。链路恢复成功不得重新随机选行为或把动作计数当完成。
3. **P1补视觉与配置恢复**：停住后请求新帧；有界查询配置和当前扫描反馈，统一CAT_CONFIRM/CAT_CHECK的错误处理。
4. 普通DRIVE/ROTATE的重试放最后，需要Uno协议支持幂等事务/完成状态查询。涉及Uno改动和烧录须另行说明；本审计不执行。

只读快照可从“ACK约300–500ms、完整快照约800–1200ms、最多3次、退避150–300ms”作为测试起点，必须结合实际串口队列和快照耗时校准，尚未实机验证。核心是关键阶段能在总窗口内完成恢复，而不是单纯把6秒改成更长等待。任何重试不得消耗正常行为次数或重置全局搜索预算。

需要的故障注入验收：丢一次GET_TELEMETRY、丢TB某部分、ERROR0、持续DIAG但无遥测、旧快照晚到、画面无效/过期、丢一次VQ/VR/SD、丢MS/MP/MD、停止丢确认、恢复后原距离/预算对账。应分别证明“短暂读回失败恢复原动作”“持续失败停住报错”“真实负检测/障碍保持正常行为”。普通运动结果不明必须证明不会二次执行。

证据生成脚本与摘要：`evidence/communication-audit-20261006/collect.ps1`、`summary.json`、`incident.json`、`source-exits.txt`。静态枚举覆盖本仓库ESP传输、policy出口、Uno扫描/运动、调试和网页入口；不声称覆盖未知硬件故障或尚未执行的物理验收。
