SaitoTommo/CatTeasingRobot/通信与视觉问题解决故事线_20261004.md

# 从“连不上”到“出错后能恢复”：通信与视觉问题的解决故事线

这是供项目介绍、复盘或面试讲述的版本。事实截至2026年10月4日；设备数据、源码判断、用户观察和未完成验收分开。完整问题索引见[分类日志](./项目日志_问题分类版_20261004.md)。

## 可以直接讲给别人听的版本

这个项目让ESP32负责摄像头识别和行为决策，让Arduino Uno负责电机与传感器。我们遇到的主要挑战是：两个控制器之间的通信能不能可靠地支撑一个完整行为。很多看起来像“识别失败”“电机不动”或“状态机卡住”的问题，最后沿着命令和回报的时间线，发现断点落在通信交接上。不过，我们没有统计所有故障的占比，所以“大部分问题来自通信”目前是项目体验和复盘判断，不能作为已测比例。

最初的问题是链路根本没有打通。Uno发给ESP的启动信息能够收到，ESP发给Uno的PING却没有回应。我们检查过电平转换、参考电源和接触情况，也做过回环、降速和最小程序对照，但仍没有最终查清原来Uno D0接收路径为什么不通。为了推进项目，我们采用一个绕过办法：让Uno用D12软件串口接收，用D1硬件串口回传，并先在9600波特率下验证。两端出现ROUND_TRIP_OK，完整程序也能收到PONG和传感器回报，才算打通双向通信。这个阶段解决的是“能通信”，原D0路径的根因仍然暂缓。

打通之后，我们发现“收到一些消息”还不等于可靠。有时消息漏字、乱码，关键的开始或完成回报损坏，界面和下位机就可能对当前动作产生不同理解。我们没有证据把这些损坏直接归因于电机质量：供电、电平转换、线路、中断时序和收发实现都仍是候选。为此，我们缩短命令和回报，加CRC-8校验，并让接收方拒绝损坏数据。早期电脑USB链路也曾统一到57600；后来为了排查ESP到Uno的接收路径，D12方案阶段采用9600，再将两板升回57600。它不是一直沿着“越低越好”的方向调整。

9600带来了另一个可测的问题：数据量太大，状态轮询很慢。当时一份完整遥测约440字节，9600/8N1下，仅回传这些字节理论上就要约458毫秒。实测静置时，从发送查询到收到完整结束回报，中位数是510毫秒；加入额外GET_STATUS查询后升到630毫秒，P95从562升到674毫秒。原本想每秒发5次PING，实际只达到约2.09次；名义每秒2次的GET_STATUS实际约1.164次。这个结果让我们确认：不能只靠降低波特率，还必须减少每次发送的数据和重复交互。它解释了延迟，但不能证明串口负载导致Uno重启。

随后，我们把两板链路升到57600，将13条逐传感器遥测压成50字节快照，经3条带校验的TB帧和完成回报传输；普通轮询改为每2秒一次。按使用需求取消周期KEEP续行，保留开始、改速、停止；同时加强STOP确认，避免上位机认为停了而下位机没有收到。现有0.18短窗口里，21次能配对到完整结束的遥测事务为39–91毫秒，比旧9600完整遥测快得多。不过这些是成功事务的小样本，仍有校验错误和超时，不能把它说成当前所有场景的稳定性能，也不能给整个系统统一算一个提速倍数。

接下来，我们发现只校验并丢弃坏消息还不够：如果关键消息丢了，行为流程仍然会停在半路。到达第二个标签后，下一轮SC扫描配置损坏，就可能看起来像“路线只跑一轮”；SR启动消息损坏，又会表现成电机没有开始。我们先为SC和SR加入有限重试，并保证同一身份的SR重发只补确认，不重新旋转。后来找猫日志又暴露了更深的交接问题：有一份是扫描结束SD损坏，有一份是识别结果VR被拒绝，还有一份是false已经被接受、下一步也转完了，但后续识别请求没有被有效收到。最终ESP0.19/Uno6.9增加独立扫描进度超时、同身份恢复和终态有界重发，让通信出错后能够恢复或者明确停车退出。两板已上传并校验，但实体恢复效果仍待用户测试，串口损坏根因也没有因此消失。

视觉侧面对的是另一个资源限制。ESP32既要解码图像，又要运行猫模型和AprilTag检测，历史短测单标签处理平均约271毫秒、猫约250毫秒，双识别约469毫秒；加上调度和间隔，实际双识别约每秒1.49次。我们做过识别调度提速，例如缩短原来识别后的1.5秒等待，也做了按状态选择模型的调整，但没有完成模型量化、替换模型或推理内核优化的对照实验。后来更关键的做法是让状态机明确“什么时候需要看什么”：巡游主要看标签，猫互动看猫，扫描时旋转一小步、停车、等停稳，再请求这一阶段的新帧识别；慢接近猫也采用短距离行驶后停车再看。连续标签接近仍可识别，并不是所有运动中都关闭视觉。

这套设计减少了不必要的双模型运行，并用scanId、stepId、generation和采集时间约束结果，防止把旋转前、触碰打断前或迟到的旧图像用于下一步动作。它在设计上降低运动图像和过期结果带来的风险；但我们还没有CPU占用、功耗或识别准确率的前后对照，所以不能说性能开销降低了多少、准确率提高了多少。能量化的是已有处理耗时、识别频率和请求到回报的时间。

这段经历的核心是：我们逐渐把“通信能通”拆成了“数据可信、带宽够用、动作有确认、交接有恢复”；同时把视觉处理从持续跑模型，变成行为流程按需申请新观测。已经完成的工程改进有日志和构建、上传证据，底层串口损坏、供电与长期稳定性仍作为后续问题保留。

## 校验到底怎么做

这里的“校验位”是**应用层CRC-8校验字段**，不是UART硬件奇偶校验。当前链路仍是57600、8N1，即8数据位、无奇偶校验、1停止位。

发送方对整段ASCII消息正文计算CRC，包含命令编号、命令和参数，然后附加`*HH`，HH是两位十六进制。例如日志中的`C 303 VR 294 5 33 0 1646*7A`，CRC只计算星号前正文，不包含`*7A`和行结束。源码使用初始值0、多项式0x07、逐字节异或后逐位左移，无反射、无最终异或。

接收方重新计算并比较；缺字段、格式错误或结果不一致，按协议记录BAD_ENVELOPE/BAD_CHECKSUM，ESP接收侧则记录CRC_MISSING/CRC_ERROR并拒绝该数据。CRC用于发现损坏，不纠错、不找回漏掉的字节，也不保证所有损坏都必然被发现。命令编号用于匹配请求与回复，scanId/stepId/generation用于约束扫描结果归属，有限重试用于恢复；这些职责不能由CRC替代。

当前TB遥测、AK、MS/MP/MD/MA、VQ/SD及物理DONE属于受保护回报；不是所有普通诊断文本都加了CRC。完整同编号TB批次和有效DONE齐备后才发布遥测，坏帧不能拼进可信状态。

源码依据：[ESP CRC与保护范围](./esp32-host/ESP32CatHost/wire_integrity.h)、[Uno串口实现](./firmware/UnoCatController/UnoCatController.ino)。

## 已有数据能说到什么程度

### 通信：旧9600完整遥测与当前短窗口分开

| 数据来源/场景 | 样本 | TX→完整DONE P50/P95/最大 | 解释 |
|---|---:|---:|---|
| 旧V5.8/9600静置 | 见原审计 | 510/562/599ms | 约440字节的长遥测 |
| 旧9600额外PING | 实际2.09次/秒；375次PING完成 | 542/606/636ms | 这里是同期遥测耗时，不是PING自身耗时 |
| 旧9600额外GET_STATUS | 重启前244次STATUS，实际1.164次/秒 | 630/674/779ms | 延迟随额外查询增加，未证明重启因果 |
| 0.18日志12成功遥测 | 14 | 46/62/62ms | 111915–139650ms的160事件窗口 |
| 0.18日志13成功遥测 | 3 | 76/91/91ms | 209530–231649ms窗口，之后有损坏/超时 |
| 0.18日志14成功遥测 | 4 | 40/40/40ms | 323394–342902ms窗口，之后有损坏/超时 |

新数据由同一窗口UNO_TX编号匹配UNO_RX同编号DONE计算，只统计配对成功事务；未配对另列，可能是损坏、截断或仍在等待，不能一概算丢包。TX/RX时间是ESP队列出队/接收解析日志时间，不是引脚电气测量，也不是浏览器HTTP总耗时。不同版本、数据量、负载和抽样范围不同，因此可描述改善方向，不作严格同负载提升百分比。

### 视觉：历史模式短测和当前扫描交接

| 历史短测模式 | 独立观测数 | 平均处理latencyMs | 平均观测间隔 | 实际观测频率 |
|---|---:|---:|---:|---:|
| 只标签TAGS | 25 | 271.2ms | 472.8ms | 2.12次/秒 |
| 只猫CAT | 26 | 250.2ms | 452.3ms | 2.21次/秒 |
| 双识别BOTH | 17 | 468.7ms | 669.3ms | 1.49次/秒 |

依据[历史视觉短测](./esp32-host/vision-fast-smoke-result.json)；脚本以cameraVision.at去重，同一状态反复读取不算多次推理。该数据是早期短测，不冒充0.19性能。当前源码latencyMs计时从processVision开始至结果结构准备完成，包含JPEG解码、模型/标签处理及地面特征等，首次可能含模型初始化；不包含全部相机采集、序列化、排队、UART回报或网页渲染。不能称为纯模型推理耗时。

| 0.18窗口 | 首次有效VQ→首次VR P50/P95/最大 | 步骤数 | 成功VR发送→VISION_ACCEPTED |
|---|---:|---:|---:|
| 日志12 | 327/472/472ms | 2 | 13–15ms，2次 |
| 日志13 | 495/547/547ms | 7 | 13–16ms，6次 |
| 日志14 | 461/498/498ms | 5 | 13–14ms，5次 |

VQ→VR从窗口内首次识别请求到首次结果发送，包含等待合格新帧、图像处理、任务调度和发送队列；按扫描ID/步骤/代次去重重复VQ。首次VR也可能被Uno拒绝，所以不是成功识别闭环耗时。日志12/13/14最后一帧CAT latencyMs分别239/301/241ms，每个仅是一个样本。

用户网页观察“300多毫秒”保留为观察，尚未给出对应字段和时间段；它可能是处理耗时或另一段响应，不能直接写成串口通信延迟。当前实际波特率是**57600**，不是口述的5600。现有数据也不足以证明停稳识别比运动识别准确率更高，或按需识别节省了具体比例的CPU/功耗。

计算证据：[新窗口统计](./evidence/20261004-review/story-measurements.json)、[可复算脚本](./evidence/20261004-review/measure-story.cjs)、[旧延迟审计](../tmp/latency-audit-notes.md)。本次仅分析已有文件，没有设备测试。

### 后续补充：并非所有旋转异常都由通信造成

10月4日日志16还显示一个行为设计问题：ESP0.19反复“复核→对准→停车→再复核”，4次明确发送ROTATE20.3 255，导致看起来一直在转。按用户要求，ESP0.20将猫触碰主流程简化为“转停搜索→原地停稳/等待/新帧复核→执行行为”，去掉复核居中循环，触碰声光独立并行。代码、回归和编译完成，尚未上传或实体验收。这个例子应与串口消息损坏分开讲，避免把所有表现都归为通信问题。详细证据见项目日志对应最新章节。

后续状态更新：ESP0.20已上传，46.7秒写入3732944字节、哈希和HTTP版本回读通过，既有配置零键变化；Uno仍6.9。原地复核/物理停稳和并行声光尚未实车验收，以项目日志最新上传章节为准。

后续又定位到数据接收后的协议解析缺陷：日志23侧距已回报，策略sscanf8字段却检查返回9，导致侧距永远过期并退出逃跑。ESP0.21已修复、回放测试并上传，实体逃跑待验收。这个案例说明CRC/收包成功之外，还要检查字段解析和策略消费；网页间歇性超时及状态清单同步另列未完成。

最新视觉调度补充（ESP0.23）：按后续需求，装死后/探索无互动后重新找猫并对齐，原地复核定时等待和面向猫观察期间连续CAT；停稳与转向仍使用停车后新帧。故故事中的按需识别不是一律单帧或所有等待都关闭视觉。0.23已上传，实际观察帧率和追逃行为待验收；后端接入与网页间歇超时未完成。

日志26补充了仍未闭环的链路证据：ESP0.23扫描155停在首次旋转后的交接，同身份恢复3次仍无新VQ；SR、遥测和STOP命令原样出现在接收侧，STOP首发及3次重发均无有效停车完成回执。系统最终明确报交接超时/STOP_UNCONFIRMED并阻止后续命令。它证明恢复/保护会有界退出，不能证明底层链路已可靠；回环和坏帧原因仍需线路/电平转换检查，DIAG在线不代表命令闭环。

双USB复现补充：本次ESP断电重启后命令仍回环，随后模拟/真实模式切换附近，两端记录到真正Uno的停车确认，证明恢复不只是模拟显示。模式切换代码未重新初始化硬件UART，因此恢复原因还不能定。数分钟后采集又捕获Uno READY启动，重启原因仍未证明；这段经历应讲成已有复现和缩小范围，不能讲成模式切换彻底解决串口问题。

日志28还暴露了诊断显示问题：一次2502ms无有效回报触发停止，之后真实停车确认和遥测恢复，但历史Uno link timeout仍锁存。当前连接状态与历史控制故障应分开显示，恢复通信不能自动恢复运动；记录空档的原因仍未定位，未据此判定设备卡死。

日志29/30补充：用户是在架空平台看到轮子持续转，不能解释成车在地面滑行。停车确认后无新运动指令，但RPM仍非零，暴露停稳检查只看短时间计数不变的缺口。0.24代码增加双侧RPM零条件和最多3轮严格停车/关闭会话/几何/开启会话确认的恢复，再重新搜索，不重放旧距离；尚未上传。模式切换再次恢复使软件恢复值得优先排查，仍未排除硬件或找到持续转轮/重启根因。

0.24后续状态：最终编译和ESP应用上传已完成，保存HTTP回读0.24/IDLE/SIM_UNO，原配置零键变化；新只读双串口采集进行中。尚未主动测试实体运动，持续转轮、回环和自发复位根因仍不能写成已解决。

0.25最新诊断把一类‘SETTLE下总在转’定位为软件行为：逃跑后找到猫仍强制居中，反复ROTATE，中间停稳状态让网页看起来一直在等待。完整双端采集有命令证据，不能只归为通信或惯性。用户仅需猫在画框内，触碰互动收尾因此改为直接停车复核/观察；代码离线通过，编译上传和实体验收尚待完成。其他转轮/自发复位根因仍需各自证据。

0.25后续状态：ESP应用上传/哈希校验和HTTP回读完成，既有配置零变更；强制居中命令循环修复仍待用户真实UART行为复验，UART回显和自动复位仍独立待测。

日志32补充：停车未确认时保护层连GET_TELEMETRY也拦截，造成所有UI读数过期，是诊断通道被软件阻断，不是所有传感器坏。0.26改为严格放行只读查询而继续锁住运动，代码检查通过、编译上传待完成。手动切模拟后原UART排队的STOP已收到真实确认，早于切回UART；仍不能归为硬件UART重新初始化，底层回环/自动恢复失败原因未定。

新增确证：柏林18:05:31 Uno在遥测1413中途重新READY，用户确认没有复位或断电，应记自发重启；原因及与回环的关系未知。日志33又发现扫描先FAULT后停车失败会跳过旧恢复入口，0.26补为有限恢复通信且仍保持FAULT/停止，不自动运动；现场仍0.25，0.26尚未上传。

最新部署ESP0.26/Uno6.10：保留停车失败后的只读诊断，并修复Uno空运动时STOP跳过输出清零的独立缺口。一次遥测请求0而应用值220不是电压测量，也未证明该缺口是唯一原因；最低PWM回读255仅作用非零请求。两板上传完成、实体效果待测，命令回显和自发复位仍未闭环。

0.27新增探索15种声光组合（四灯×四声排除全静默），新按压换组、长按不重复、不自主换组；板载灯本地GPIO控制绕过UnoUART，只是灯光控制分工改进，不能称串口故障根因修复。ESP已上传，软件GPIO回读通过，实际声光/按压和新30分钟采集最终结果仍待验收。

0.28补记独立调度问题：0.27探索找猫期间新按压声光被节点限制/清队列影响，现拆为不改主action的并行响应，保留触碰停车和剩余扫描预算，装死不能中途抢占。已离线回归并上传，实车并行验收待测，不能算串口根因修复。

日志34诊断：自动恢复第三轮已取得真实停车/会话结束/正确配置DATA，但配置解析仅接普通启动状态，恢复状态漏消费并错误失败，实际policy离线已复现。按用户要求暂不改代码。用户当次探索声光体验感觉无问题，仅记局部验收；自动恢复、UART回显及另一次运行期间非人工触发的READY启动仍各自保留问题；用户已确认未碰Uno，启动在采集开始约107.6秒后，STAGE74/CMD94不证明具体根因。本地提交由实施会话完成，不推远端。

日志35又确认‘错误后的处理’会放大通信故障：Uno发出完整PWM/RPM0遥测，ESP缺分片后正确拒收，但未释放挂起查询，使250ms复核轮询停顿5251ms并缺停稳证据。随后第三轮真实配置收到仍被旧恢复解析缺口拒绝。两条软件缺口只诊断未修；本次无新READY，不记又一次重启，也不把复核缺证据等同轮子仍转。

日志34/35之后用户授权0.29修复：恢复增加四轮、正常启动与恢复共用严格配置解析；缺帧事务收到可信匹配DONE后释放pending并限频重试，继续拒绝部分快照。源码和初步实际策略1160检查通过，编译上传/实体恢复尚待完成；UART损坏和自发复位根因仍未解决。

0.29后续状态：最终编译、ESP应用上传和HTTP回读完成，88项配置一致；四轮恢复/严格配置消费及缺帧事务释放已有离线覆盖，真实恢复表现待用户复测，UART回环和自发重启仍独立未闭环。代码按要求待实测后提交，本次只更新文档。

识别频率实验补充：cat-vision-fps-bench基于f40bf52，实验固件已上传。用户观察串口工作约3.24、闲时约3.5次/秒且网页流畅；导出无环形统计，尚不作P95/长期稳定验收。日志36目标46已找到，后续TAG_ALIGN旋转在架空车身不动时无法改变视角，不是搜索失败；单帧总457ms/解码19/猫模型252ms，平均频率不保证每帧333ms。后续333ms启动调度/停车采集时间门控仅建议，本轮不改代码。

实验版2已上传：把居中容差显式开放、加轻量/api/flow及8条决策历史，帮助分清短暂TAG_ALIGN与继续搜索。100ms是响应后的等待，实测空闲往返64.32–308.78ms，不是串口/推理延迟或硬实时保证。只加只读快照，未实施3Hz调度/停车新帧补强，88配置保留；界面由用户检查，本轮不操作浏览器或设备、不提交Git。

实验版3把猫/标签居中容差分开并接实际对准，区分框宽远近与位置偏差；主动找猫开放原有慢靠近/试探及近处声光/观察/静止概率，未新加快慢切换。已上传并保留旧值，用户原容差20迁移猫20/标签20；实车和界面待用户验收，本轮无浏览器、设备操作或Git提交。

历次停车未确认综合结论：回环/坏帧、已修的软件误判及自发重启要分别讲。最新日志38四轮恢复连同原STOP共20次发送/约6.095秒均无确认，但61条接收全是DIAG、Uno计时和循环持续，无新重启证据；这次卡在命令闭环而非已修的CONFIG消费。诊断在线不等于命令正常，PWM0不等于正式停车确认；下一步需同编号D12接收/解析/D1回包证据，增加重试不能修持续失效通道。本轮只离线分析。

主动找猫新增控制路径复盘：旧ROBOT_SEARCH触碰仅暂停、无人回应又反复邀请或回IDLE；当前方案复用巡游firstTouchPlan统一首触互动，保留后续分支，完成一次邀请无人回应后返回保存路线。无路线安全停止而不编造路线。实施验证中，本轮不设备操作或提交其他改动。
