SaitoTommo/CatTeasingRobot/猫互动重梳理实施计划-20261004.md

# 猫互动重梳理实施计划（已批准实施）

代码基线：81588be，ESP 0.17 / Uno 6.8。现状清单提交：ddfcc9e。

用户已批准实施，ESP 0.18 代码与配置页面已经完成，正在编译和验收。下面保留获批准的方案；实际状态请看现状清单前半部分。两个新装死概率暂按已告知的 20% 默认实现，可在网页修改。追击开始时猫已近不会单凭可见就确认追击。

## 1. 名称澄清

当前代码存在 WAIT_CHASE，没有 WAIT_CHANGE。WAIT_CHASE 是“等待猫追击”：逃跑 → 停车找猫 → 找到并对准 → 等待追击（默认 10 秒）→ 再次面向猫 → 静止观察。现状清单第 5 节原已列出，现补充专门解释。

拟在网页状态显示中同时显示中文和原名，例如“等待猫追击（WAIT_CHASE）”。停车后识别等待、追击等待和观察时间各自显示，避免混淆。

补充确认：WAIT_CHASE 是等待追击的超时窗口，不是时间一到无条件继续观察。窗口内猫追来则继续本轮互动；到期仍未追来则停车、退出互动，记录“等待追击超时”。沿用 postEscapeWaitSeconds（默认 10 秒）并提供单独网页输入。

追击证据拟采用：等待阶段发生新的触碰，或有效停车画面中猫由远/中间进入用户设置的近处范围。新的触碰在这里仅证明猫追来了，不重建互动、不重抽响应。等待开始时猫已经近，是否直接算追来，需要最终确认；不能仅靠“画面仍有猫”一律判为追击。无效/过期画面不证明追击；等待时间不因反复拍打重置。

## 2. 猫的远近比例设置

复用已有 catNearWidth、catFarWidth 与保存机制，不再增加厘米距离判断。现在它们只在“全部参数”文本框中编辑；新增与标签停车比例一样的单独数字输入、保存按钮和板上回读。

比例统一为：猫检测框的宽度 ÷ 画面宽度 × 100%。不是面积百分比，也不等于物理厘米。

| 画面里的猫宽度 | 拟判断 |
| --- | --- |
| ≤ 用户设置的远处阈值 | 远 |
| ≥ 用户设置的近处阈值 | 近 |
| 两者之间 | 中间距离，维持上一档，避免边界来回跳；首次落在中间时先观察，不立即选接近/逃跑。 |
| 没找到猫、识别无效或画面过期 | 不拿来判断远近；进入停车取新画面或最多两圈重新寻找。 |

保留已保存值；未配置时沿用远 12%、近 35%。远阈值必须小于近阈值。范围沿用现有字段：远 1%–80%，近 2%–90%；页面按百分比输入，固件按 0–1 保存。先确认停车再保存，重启保留；刷新不覆盖用户正在输入的草稿。

## 3. 一次互动只处理首次猫响应

首次触碰打断巡游或待命流程，建立一轮猫互动，记录首个位置与探索/捕猎分支。只在首次响应或当前行为自然完成后选择下一行为。

互动中后续拍打只记录触碰与时间：不再增加触碰响应轮数，不覆盖首次位置，不重抽探索/捕猎，不切换互动来源，不清空原计划，不从头转向或找猫。多个位置后续被碰也不新建响应。首次同时触碰仍按先处理的位置决定方向。

**拟采用的运动处理：被按住时临时停车，松开后续做原动作。** 这是保留 Uno 现有触碰停车行为，同时去掉 ESP 的重新规划。不是一边被按住一边强行转动。

续做按实际已经完成的距离/角度扣除，不把完整动作重做；扫描中断则按剩余两圈预算续找，不重新给两圈。停稳与新画面要求保留。需核对 Uno 在扫描等待识别时也可能被触碰取消，因此不能只在 ESP onTouch 加一个 return。

若你希望持续按住时也继续运动，这与上述方案不同，需要你明确选择后再定 Uno 的执行规则。

## 4. 装死只能在逃跑或探索之后选择

取消“首次触碰直接抽装死”的入口，也取消达到触碰轮数时直接装死。

```text
首次猫触碰
 ├─探索 → 声光探索完成 → 面向猫/停稳观察 → 后续选择
 │                                      ├─装死
 │                                      └─继续同一轮探索互动
 └─捕猎 → 慢逃/快逃 → 停车找猫并对准 → 等待追击 → 观察 → 后续选择
                                                        ├─装死
                                                        └─继续同一轮捕猎互动
```

### 逃跑分支：概率或完成轮数决定装死

一轮定义为一次完整的逃跑直行动作实际完成；仅转向、找猫、指令重发、被触碰打断后的续做，不另算一轮。计数在本轮互动开始时清零，慢逃/快逃共用计数。

每轮逃跑实际完成，先增加完成轮数：达到配置轮数则装死；未达到则只抽一次本分支装死概率，抽中装死，未抽中继续找猫、等待追击。等待追击超时优先退出，不开始下一轮。默认完成第 5 轮即装死，不是第 6 轮才装死。次数和概率都放到网页；这是两种触发条件同时有效，不是三个平行行为供首次触碰选择。

装死在逃跑完成后的停车确认点选择；选中后不再为了面向猫而转动。不成功或尚未续做完成的逃跑不能增加计数或触发抽选。

### 探索分支：最短 30 秒之后才能按概率装死

采用你最后确定的时间规则，取代先前口述的“至少三轮”。从探索实际开始计时，默认 30 秒之前不抽装死；满 30 秒后，在完整声光周期的结束点抽一次探索装死概率。抽中装死，没抽中继续探索，在后续周期结束点再抽，不在主循环每一帧反复抽。中断后续做不额外抽一次。

网页单独显示探索第几轮（一个完整声光周期为一轮）、探索已进行多少秒、距离允许装死还剩多少秒。重复拍打不增加探索轮数、不重置这段计时。不因已到 30 秒就必然装死。

### 装死输出

装死一旦选中，保持静止，不被新拍打重抽，直到确认猫退出、达到装死最长等待时间或操作员停止。MazeBot LED 灯条由你通过遥控器实现；本次计划不自动控制该遥控器，也不自动发送旧版装死闪灯/蜂鸣命令。网页显示“已进入装死”和剩余等待时间，便于你操作灯条。

装死超时时间单独在网页设置，复用 captureWaitMaxSeconds：保留已保存值，未配置时沿用现有默认 15 秒。计时从进入装死开始，后续拍打不重置；到期正常结束装死并退出互动，记录“装死等待超时”，不沿用旧 MAX_WAIT_UNCONFIRMED 故障要求人工恢复。超时不能记成已经确认猫离开。猫提前离开达到确认时间则提前退出。独立找猫来源退出回待命，巡游来源恢复原节点；实际继续运动仍须触碰松开并满足执行条件。

探索/捕猎大分支暂保留现有 20%/80%；去掉首次装死后，慢逃/快逃按原 40:40 归一为 50%/50%。逃跑装死概率、探索装死概率分开配置，数值待你确认；旧的首次装死概率、旧轮数收尾概率不直接迁移到新规则。

## 5. 持续互动与统一“猫退出”

正常互动不再因为拍打次数、无新触碰 12 秒、会话 60 秒、随机抽中恢复巡游而结束；相关旧字段从当前行为入口移除/标为不再使用。保留你明确要求的 WAIT_CHASE 等待追击超时退出；逃跑完成轮数用于触发装死，不用于直接恢复巡游。

行为完成后继续当前互动分支，装死除外（静止等待猫退出）。“重新响应拍打”和“行为自然完成后的下一步选择”分开处理。

拟统一退出证据：

| 条件 | 拟处理 |
| --- | --- |
| 新鲜有效画面持续看到猫处于远处，且无触碰 | 达到 catLeaveSeconds（沿用默认 5 秒）后认定退出。持续触碰说明猫仍在接触，不退出。 |
| 停稳后的有效画面没找到猫 | 非装死阶段最多转两圈重新寻找；找到则继续同一轮，找不到则回报“找猫失败”，结束互动。 |
| 装死阶段猫在画面外 | 保持静止，不转圈找猫；连续有效的新画面没猫，且无触碰，持续 catLeaveSeconds（默认 5 秒）后确认退出。猫回来或再次触碰，清零离开计时；无效/过期画面不能累计或确认离开。 |
| WAIT_CHASE 到期仍无追击证据 | 停车并退出互动，明确显示等待追击超时。 |
| 装死最长等待时间到期 | 正常退出互动，明确显示装死等待超时；不声称猫已离开，不自动控制 MazeBot 灯条。 |
| 画面无效/过期 | 不宣称猫退出；停车并取新画面，必要时显示识别失败原因。 |
| 串口、编码器、停车确认失败，或无路可走 | 停止运动并显示实际原因；属于执行故障，不伪装成猫退出。 |
| 操作员停止 | 立即停止，结束本轮。 |

“猫走了”只能由有效观察判断；不再用“不拍了”代替。两圈找不到猫仍保留你之前要求的找猫失败返回规则。

## 6. 主动找猫不必先巡游

当前限制来自 policyControl：alert 只在 PATROL 生效。硬件允许原地扫描，不需要先走标签路线。

拟让“主动找猫”按钮在停车确认后的待命/停止状态直接启动：

```text
主动找猫 → 确认停车 → 获取 Uno 几何设置 → SESSION_START
        → 原地最多两圈找猫 → 对准 → 机器人主动互动
```

复用已有启动步骤，用“本次启动目标是巡游还是找猫”决定 SESSION_START 后的下一步。不先发巡游电机指令，不要求填写标签路线，不增加旧固件能力校验。

记录开始找猫前是否正在巡游：从巡游打断的互动退出后恢复原路线节点；从待命独立找猫开始的互动退出后停车回待命。这样即使没有标签路线，也能使用找猫按钮。若以后需要“独立找猫结束自动开始巡游”，再单独设定该行为，避免现在隐式启动。

## 7. 涉及文件与关键提交

### 单独放在网页上的配置项与进度

| 网页名称 | 拟字段/默认 | 说明 |
| --- | --- | --- |
| 猫远处宽度百分比 | catFarWidth / 12% | 保留已保存值。 |
| 猫近处宽度百分比 | catNearWidth / 35% | 保留已保存值，远必须小于近。 |
| 等待猫追击超时 | postEscapeWaitSeconds / 10 秒 | 无追击证据则退出，不能隐藏在全部参数里。 |
| 逃跑最多完成轮数 | escapePreyAfterRounds / 5 | 默认第 5 轮装死；轮数按动作完成，不按拍打次数。 |
| 每轮逃跑后的装死概率 | escapePreyPercent / 待定 | 0% 只靠轮数，100% 第一轮完成即装死；范围 0–100%。 |
| 探索允许装死前最短时间 | explorePreyMinimumSeconds / 30 秒 | 达到时间后才开始按周期抽概率。 |
| 探索完成周期后的装死概率 | explorePreyPercent / 待定 | 0% 不概率装死，100% 达到最短时间后第一个完成点装死。 |
| 猫退出确认持续时间 | catLeaveSeconds / 5 秒 | 装死远离/连续有效无猫等确认。 |
| 装死最长等待时间 | captureWaitMaxSeconds / 15 秒 | 保留已保存值；网页可设，沿用现有 1–60 秒范围，到期正常退出互动。 |

上述项提供普通输入框、保存按钮、保存成功/失败反馈及板上回读；先确认停车再保存，重启保留。新字段的整数范围在批准后实施时统一校验。旧“触碰轮数结束/无拍打结束/会话结束”的输入不继续作为有效配置显示；装死最长等待保留并独立显示，改为正常超时退出。

运行进度显示：当前中文状态及原名、同一轮互动编号、逃跑完成 X/5 轮、探索第 X 轮及已进行 X 秒、等待追击剩余时间、装死和猫退出确认进度。拍打统计可保留作日志，不作为动作轮数。

| 文件/模块 | 计划改动 |
| --- | --- |
| ESP policy.cpp | 互动生命周期、首次触碰与后续触碰分开、动作续做、后置装死、统一远近/退出、独立找猫启动。 |
| ESP policy_defaults.h / 主程序配置 | 新后置装死轮数/概率/探索时间设置，保留已有猫宽度与保存值，处理旧结束字段。 |
| ESP debug_page.html | 上表配置输入、保存回读、轮数/计时进度、中文状态、独立找猫按钮说明。 |
| Uno 固件/scan_machine.h | 仅在续做需要时调整报告与扫描中断处理；不取消触碰停车、不绕过实际障碍。具体是否需要改 Uno 由实施时的协议核对决定。 |
| 原生策略/扫描测试、网页脚本测试 | 覆盖新状态转换、触碰续做、页面保存与回读。 |
| 现状清单、实施与验收说明 | 随最终行为更新，区分基线现状与新行为。 |

分阶段提交：页面远近设置 → 独立找猫启动 → 连续互动与后置装死/触碰续做 → 编译及上传记录。修改固件时顶部注释及运行版本号同步增加。现有代码基线 81588be 保留。

## 8. 我做的自动化验证

1. 执行实际 policy.cpp 的原生测试：首次响应能打断巡游；多次按下/松开、不同位置、同时触碰，不重建互动、不重抽首次行为；当前动作被停车后按剩余距离/角度续做。
2. 扫描状态测试：中断续找累计不超两圈；过期/无效画面不能算猫退出；正常找到、预算耗尽、停稳等待与扫描指令重试仍有效。
3. 行为顺序测试：首次不能装死；逃跑中断续做不多计轮，第 5 次完成强制装死，概率仅在实际完成点抽一次；探索 30 秒前不抽，之后每个完成周期最多抽一次；重复拍打不重置计时或轮数；WAIT_CHASE 无追击超时退出，有追击继续本轮；无触碰/会话旧上限不正常结束互动。
4. 启动测试：无路线且未巡游也可主动找猫；无需能力握手；从巡游进入保留原目标，独立进入退出后不自动巡游。
5. 网页脚本自动测试：百分比换算、远近关系校验、草稿保留、保存后回读、重新加载。不会使用 computer use 操作界面。
6. 编译实际固件，报告 Uno Flash/RAM 和 ESP 构建结果；编译与原生测试不等于实体识别/运动验证。

## 9. 你做的现场验收

1. 页面设远 12%、近 35%（或你需要的值），保存并重启，确认保留；不同位置展示猫，核对远/中/近。
2. 未启动巡游、甚至无路线时点主动找猫：应原地找两圈，不先找标签；成功进入互动，失败回报找猫失败并停车。
3. 巡游中首次拍打，确认优先打断；进入互动后连续拍、换位置拍，确认同一轮继续，不从头规划。
4. 前进或扫描时按住再松开，核对暂时停车并续做剩余动作；扫描总角度不因重复拍打增成四圈/六圈。
5. 逃跑后验证 WAIT_CHASE 无追击到期退出、有追击继续；装死概率设 0% 验证第 5 轮完成才装死，设 100% 验证第 1 轮完成才装死。探索概率设 100%，确认 30 秒前不装死、之后完整周期结束才装死，页面轮数与时间正确。
6. 猫持续在近处或持续拍打超过旧 12/60 秒，不因这些旧规则返回巡游；猫实际远离满足持续时间后才退出。
7. 猫离开画面时检验两圈重新寻找和找猫失败回报；无效画面不能冒充离开。
8. 从巡游进入时退出后恢复原节点，从独立找猫进入时退出后回待命。运动/识别效果由你现场验证并提供日志。
9. 装死时由你遥控 MazeBot 灯条；确认车保持静止、不会转圈找画面外的猫；连续有效无猫画面达到确认时间后退出，触碰/猫回来会取消离开计时。
10. 网页修改装死最长等待，保存重启核对保留；猫仍在时等待到期，确认显示装死等待超时并正常退出，不报 MAX_WAIT_UNCONFIRMED；重复拍打不重置装死倒计时。自动化测试同步覆盖这些边界。

自动化检查已实施，编译/上传结果及现场验收边界见项目日志；界面操作和运动验收由用户执行。
