SaitoTommo/CatTeasingRobot/统一验收记录.md

# V6.6 / ESP 0.13 统一验收记录

日期：2026-10-03。本表把离线软件验证与用户现场验收分开。**实机验收待完成。助手未上传/复位/操作网页/做运动测试；用户最新报告正在自行上传。** 附件旧描述是历史背景；本轮授权来自聊天中的“批准执行”、关键节点提交 Git、允许上传但 RESET/界面/运动由用户操作。

自动化入口：`tests/run-native.ps1` 直接编译固件使用的 `scan_machine.h`、`vision_gate.h`、`wire_integrity.h` 和 `policy.cpp`，使用实际 ArduinoJson 7.4.3，只替换时钟、随机数、Arduino String 和收发接口。不是另写一套 JS 策略。Node 的 DOM/传输/模拟回归单独统计；不证明板上时延、电机、摄像头检出率、供电或长期稳定。

前一节点ESP0.12离线结果：Uno核心199项、实际ESP策略429项、帧门槛与CRC通过、Node85项通过、两端编译通过。本轮0.13增量结果见第5节。容量、哈希与不自动复位上传准备见《离线验证结果.md》。`upload-uno-no-reset.ps1` / `upload-no-reset.ps1` 尚未执行。

## 1. 已有猫状态机一起验收

| 编号 | 当前实现和检查点 | 离线执行证据 | 用户现场结果 / 日志 |
|---|---|---|---|
| CAT-01 | 只看到猫不打断 PATROL | 实际 policyTick 保持 PATROL | 待测 |
| CAT-02 | 明确 alert：保存原索引，先可靠 STOP，再找猫 | alert 入口和 STOP 匹配检查 | 待测 |
| CAT-03 | SEARCH_CAT_ACTIVE：Uno 分步转、停稳、新帧，最多两圈 | Uno 199 项与两端联合第二圈找到 | 待测 |
| CAT-04 | chooseRobot：远猫 85%慢接近/15%试探，冷却独立；近猫 20%声光/40%观察/40%静止 | 固定随机输入检查各选择、冷却；不以样本频率证明概率精度 | 待测 |
| CAT-05 | FACE_CAT→SETTLE→CAT_CHECK→ALIGN_CAT；朝向为有界 ROTATE，再停稳看新帧 | 居中出口、旧回报拒绝、朝向预算/超时路径 | 待测 |
| CAT-06 | SLOW_APPROACH 选择不因重找重新抽概率 | 选定行为、冷却和 remainingCm 保持检查 | 待测 |
| CAT-07 | 慢接近：短 DRIVE、MD、可靠 STOP、两次停车后编码器采样、新 CAT | 实际分段执行、移动中不运行 CAT、剩余距离检查 | 待测 |
| CAT-08 | 三段试探：3/4/3 cm，暂停700/900/600ms，然后朝向观察 | 三段实际核心执行到完成 | 待测 |
| CAT-09 | 原地声光：按 signalFlashMs/signalBeepMs，结束清理再朝向 | SIGNAL、LED OFF/BEEP 0、朝向出口 | 待测 |
| CAT-10 | OBSERVE 与所选 STAY：当前都静止等待，默认5s | 到 FOLLOW_WAIT 的时限检查；快照保留 selectedBehavior | 待测 |
| CAT-11 | 首次触碰锁定位置；按住不重复计轮；20%探索/80%捕猎 | 四位置、持有/多位置、旧动作失效、同次检测顺序 | 待测 |
| CAT-12 | 探索四种声光，模式池用完再补，不连续重复 | 常亮/120/600/1400ms闪烁及1800/2400/3600/5600ms持续检查 | 待测 |
| CAT-13 | 捕猎：可选短提示，20%捕获/40%慢逃/40%快逃 | 三种抽取执行，touchFeedbackBeepMs接入检查 | 待测 |
| CAT-14 | WAIT_RELEASE：先等释放；顶部/画面冲突/多位置搜索两圈，触碰位置不被视觉改写 | 首次位置、顶部、画面冲突、释放超时 | 待测 |
| CAT-15 | 单侧受阻/必要信息过期回原路线；双侧新鲜过近原地扫描，不倒车；切换不重新给两圈 | 严格1cm边界、过期、专用flags、累计预算恢复 | 待测 |
| CAT-16 | 逃离：纯 ROTATE→DRIVE完成→找猫并朝向→等追逐→再朝向观察 | 正向转角与 MD、慢95/快210 PWM、WAIT_CHASE链 | 待测 |
| CAT-17 | FOLLOW_WAIT：5%试探/35%观察/60%回巡游；冷却、轮数、无触碰与会话时限 | 各后续分支、冷却和会话关闭/重开 | 待测 |
| CAT-18 | 第3轮结束40/30/30%；静默/提示捕获；有效远猫连续5s才离开，消失不算；默认15s未确认则停 | 三结局、配置捕获提示、确认窗口、不可确认故障 | 待测 |

## 2. 慢接近新增用例

| 编号 | 验收动作和通过条件 | 离线结果 | 用户现场结果 |
|---|---|---|---|
| CAT-07A | 每段短 DRIVE→MD→STOP确认→停稳→新帧 CAT；不在移动中识别猫 | 通过实际核心，移动时实际需求 OFF 或仅 FLOOR | 待测 |
| CAT-07B | 行进中移开猫，下一停稳的新有效帧才启动重找 | 通过；INVALID/过期不冒充猫走了 | 待测 |
| CAT-07C | 第一圈遮挡，第二圈再展示；找到后只走剩余距离 | 两端实际核心联合检查通过 | 待测 |
| CAT-07D | 两圈都不展示，可靠回原路线，持续显示“找猫失败” | 通过，包含非零路线索引恢复与持久失败快照 | 待测 |
| CAT-07E | 旧帧/无效帧/缓存早于请求，不能启动下一段 | 实际帧门槛与策略通过 | 待测 |
| CAT-07F | 行进/停稳/推理/重找时触碰或 STOP，迟到回报不能续旧动作 | 实际核心通过；真实停车时延待测 | 待测 |

## 3. 标签和基础验收

1. 页面保存自己的1–128节点数字ID数组（0–586，可重复），查看板上回读。保留已保存 tagStopWidth；未保存才用25%宽度。
2. 当前ID刚出现就算找到；目标偏侧但已达停车宽度时也先停。收到CRC正确、同编号 MOTOR_STOPPED 才推进索引。
3. 遮挡/观察过期先STOP再重找。单节点或相邻重复ID需在新帧中消失或宽度低于停车阈值80%后重新布防，持续大标签不能反复刷到达。
4. 所有搜索最多两圈、找到提前退出。默认几何下每次搜索预算为71脉冲约718.875°，每步2脉冲约20.25°；这是量化目标，实际转角/滑行由用户测量。扫描每步、停稳、识别、整次等待都有上限。
5. 配置和地面校准要求已确认停车；改 floorRoiTop 会清空旧参考。ESP 保存几何不等于 Uno 已应用；必须看 GET_CONFIG 回读。
6. 页面的patrolStatus是当前控制状态；电机卡片是实际回报，lastTx是历史。命令#0不得显示历史PWM。识别超长/覆盖/迟到有计数，控制和视觉分开待处理。
7. 四种轮向、纯ROTATE、分步扫描、严格侧距、前向开关、触碰/失速、至少10分钟分场景稳定性按《实施计划与人工验收》第5/8节测量。保存原始日志与实际供电、负载、PWM；不补估计值。

## 4. 上传与现场顺序

编译脚本只离线构建：`firmware/build-uno.ps1` 和 `esp32-host/build.ps1`。ESP脚本的 `-Upload` 已阻止默认自动复位，不能直接沿用旧说明。构建产物保存在 TEMP；不覆盖NVS、不用ESP整片擦除/merged镜像、不烧bootloader/fuses。

上传授权已给出，但当前设备准备状态和端口未确认。开始时先由用户在设备旁断开电机动力并关闭占用串口的窗口，确认两块板和端口；需要进入烧录或重启时由用户按键。常规 Uno uploader 会自动复位，不能在本轮直接执行带自动复位的上传命令。上传前明确工具的复位行为，不能拿“允许上传”推断“允许我RESET”。完成后用户重启，先核对版本、扫码能力、真实配置和空闲稳定，再由用户进行界面与运动验收。

旧 `index.html` 是独立电脑场景模型，A/B/C/D只是场景名称；新实体自动流程使用ESP板载网页。旧SIM_UNO网页模型没有SCAN_V1能力，不能作为新配对固件验收。新C++行为已用原生共用核心验证；这不把模型或动画升级成实际硬件证据。

## 5. ESP0.13最低驱动PWM（本轮新增）

自动化通过：实际共用PWM处理/生成配置校验2603项；实际ESP策略442项（含下限处理后命令文本及请求/下发快照）；Uno核心199项、帧门槛及CRC通过；Node88项通过。ESP0.13完整固件编译通过：Flash3717266/8257536 bytes，静态SRAM78792/327680 bytes；应用BIN3717408 bytes。结果单列，不替换0.12历史报告。助手没有上传、RESET、界面或运动操作；用户报告已完成编译并正在自行上传，尚未报告上传完成或实机验收结果。电脑测试仅检查逻辑及模拟数据，不证明电机实际转动或NVS重启保存。

| 用户验收操作 | 通过条件 | 现场结果 |
|---|---|---|
| 更新ESP到0.13，确认停车后读取页面 | “最低驱动 PWM”初始为140，或已有保存值；老固件缺键时禁用 | 待测 |
| 保存140，再保存100 | 回读分别显示140/100；不把尚未确认的新输入冒充保存结果 | 待测 |
| 确认停车，ESP由用户RESET | 下限回读仍为最后保存值；路线与其他配置保持 | 待测 |
| 设置下限140，手动请求95；对照请求210 | 95下发140，210仍210；左右正反保持方向；单轮另一侧仍0 | 待测，用户操作运动 |
| 设置100后再次请求95 | 实际下发100；巡游、扫描、猫接近/逃离也使用新下限 | 待测，用户操作运动 |
| 停车、按STOP、设置下限255时的0请求 | 仍停车，0不提升成非零；触碰/失速及已有停车门槛保持 | 待测 |
| 运动/待停车确认/手动测试未结束时修改 | 页面禁用；服务器拒绝配置变更 | 待测 |
| 输入0、256、小数或空值 | 页面拒绝；直接接口的非法值也拒绝 | 待测 |

操作顺序：用户更新ESP固件→确认停止→输入下限→保存→核对“板上已保存下限”→用户执行限时单轮/正反转测试→用户重启验证保存。测试更低PWM前先降低下限，避免请求值被提高。查看PWM_FLOOR日志、UNO_TX和物理电机遥测区分请求、下发、输出；遥测不能替代实体转动测量。不要使用历史0.12产物上传本轮0.13。
