SaitoTommo/CatTeasingRobot/OBSERVATION_AUDIT.md

# 机器人观测边界审计

最新补充为文末的 2026-09-30 记录。以下 2026-09-28 内容保留为历史，不代表当前固件版本、回归数量或触碰语义。

日期：2026-09-28。范围：网页所有运行模块、页面输入、文档、静态服务器与 UnoCatController 固件源码。构建输出不是源码，旧固件二进制不代表本次修改。

## 已修正的数据路径

| 发现 | 修改后 |
| --- | --- |
| route-planner 用全地图坐标规划绕行点 | 只按当前测距决定短步前进或实际转向；转向后重新测量 |
| escape-planner 读取猫绝对坐标并对假想朝向射线测距 | 可见方位/触碰开关给出初始方向；完成转向后才取新读数 |
| 扫描角度读取网页 heading | 由轮子编码器与已生效的轮径、轮距累计 |
| 摄像头未检出时仍返回距离/方位，且不检查遮挡 | 视野、范围、遮挡检测通过后才返回目标测量 |
| 静止装死判断猫离开直接读取真实距离 | 只在视觉测得猫足够远时累计离开时间，否则等明确的等待上限 |
| 猫脚本直接指定机器人触碰开关 | 脚本仅移动猫；车体接触检测产生实际开关区域 |
| 手填距离、脉冲及外部告警可影响自主决策 | 页面移除传感器覆盖入口；HTTP 指令仅触发主动互动，接触按钮移动猫，距离输入放置障碍物 |
| Uno 空板缺少测量时默认侧面 400 cm | V5.2 无测量即 INVALID，已有侧面测量超过 500 ms 失效 |
| 页面只在侧面数值改变时发送 | 运动前同步；运动中每 250 ms 更新，越过阈值立即更新 |
| 未提交的几何输入影响里程计算 | 使用 MockUno 当前配置或固件 GET_CONFIG 确认值 |

## 模块权限

- core.mjs：环境、当前方向射线碰撞、目标可见性、车体接触、模拟轮子与 Uno 执行器。允许使用场景几何生成测量；不规划机器人动作。
- cat-input.mjs / scenario.mjs：测试环境中猫的动作；不是机器人控制器，不能给控制器传递场景位置或脚本阶段。
- decision-system.mjs：只读目标观测、开关事件、HTTP 触发命令、时钟、策略设置和互动历史。
- route-planner.mjs / escape-planner.mjs：只读当前测量；不导入环境模型，不接受 world、地图或绝对坐标。
- app.mjs：场景编辑/绘图、观测适配、动作执行和 UI。控制例程无 world 引用；传感器适配处调用当前几何测量；帧更新不向决策传递猫脚本状态。
- sensor-stream.mjs：只负责测量的串口发布与刷新，不生成默认通路。
- server.mjs：只提供静态文件；所谓后端决策实际在浏览器中的独立模块运行，没有另一个 HTTP 决策服务。
- Arduino：接收当前前向测量、左右测量与开关事件，执行安全判断及电机控制；不持有网页坐标。空板自动控制要求 READY UNO_CAT_V5.2。

环境几何是模拟器计算碰撞所需的真值，不是机器人拥有的全局地图。画布、日志导出的 world 仅用于人工复核，不被规划器读回。视觉横坐标 centerX 是当前模拟图像中的归一化位置，不是网页坐标。

## 验证与边界

代码回归覆盖隐藏目标移动不改变输出、遮挡、射线最近交点、接触区域、编码器角度、规划模块禁止访问世界、UI 元素连接、触碰状态机、协议发布和服务器模块加载。最终 Node 回归 33/33 通过，app.mjs 语法检查通过。最终 V5.2 固件编译通过：Flash 19,462 / 32,256 字节，SRAM 1,035 / 2,048 字节。

用户要求由本人完成操作测试；后续不再操作浏览器或设备。本次较早的自动浏览器检查已确认障碍物 12 cm 输入、侧面 9 cm 阈值、几何接触事件、移除传感器覆盖按钮且无脚本错误。没有烧录，也没有真实串口/传感器/电机验证。

模拟仍为二维几何模型：相机使用目标中心遮挡，测距使用有限射线束，不是实际图像识别、噪声标定或真实猫接触力学。局部绕障不保证找到全局路径；不允许为提高成功率而预读隐藏状态。视频预览不是决策输入，LIVE 尚未接入实体视觉，自主控制保持禁用。

需要用户操作时：烧录本次 V5.2 源码、确认握手，使用本地或空板模式移动猫/障碍物验证行为。无需重跑大量页面场景。

版本管理：uno-web-lab 是独立 Git 仓库；相邻 uno-firmware 没有 Git 仓库，本次固件源码与文档修改保存在其原路径，不包含在网页仓库提交中。本次编译输出位于父目录 .build/observation-audit；uno-firmware/build 中原有二进制未覆盖，请勿将其当成 V5.2。

## HTTP 触发纠正

上一轮把外部触发命令误当成传感器作弊输入，错误移除了 HTTP 按钮并增加“看见猫即进入互动”。现已恢复一次性 HTTP 注入按钮，删除自动视觉触发。巡游看到猫继续巡游（前向避障仍有效）；收到 HTTP 指令才进入主动互动，视野里没有猫时启动搜索。触碰触发的猫主动互动保持不变。HTTP 不提供隐藏位置，不绕过观测或安全判断。本轮另增真实回环通道：`server.mjs` 的 `POST /mood_alert`（白名单仅 `HTTP_NEGATIVE`，只携带意图）入队，页面仅在 `http:` 下每 600ms `GET /mood_alert/pending` 一次性取走，与按钮共用同一入口 `injectMoodAlert`；`file://` 打开时网络轮询自动停用。该通道是上位机收信模拟，不参与任何传感测量或安全判断。

## 2026-09-30 全控制链复核

当前主固件 V5.6。63 项 Node 自动回归通过，未操作真实浏览器或设备。Arduino 编译证据沿用本次相同源码：25140 字节 Flash、1304 字节全局 RAM。固件源码现以版本快照纳入 firmware，历史“固件未入 Git”不再适用于本次提交。

| 路径 | 发现与当前约束 |
| --- | --- |
| 装死离开判定 | 没有直接取猫坐标；原先 MAX_WAIT 后等待触碰释放再续巡。现仅连续有效视觉确认远离可自动续巡，未确认超时保持停止；未知与释放不代表离开 |
| core.updateAutomaticTouch、串口 streamSceneSensors | 删除身体整体重叠保持旧触碰信号。触碰只跟随传感器区域；左、右、后、上四路触碰默认配置齐全，后部模拟触碰默认开启，可为特定测试显式关闭 |
| sceneTurnBlockReason | 原混合模式从场景取侧距，现经 robotSideObservation/sideObservation 选择来源，实体开关开启只读实体回报 |
| robotFrontCm / robotCamera | 前向取显式模拟传感器或新鲜 HOST 回报；无猫视觉观测时提供 UNKNOWN，不提供距离/方位。无法用一般超声波障碍物读数识别猫是否离开 |
| robotEncoder / MP / 编码器里程显示 | 编码器值来自 MockUno 轮子模型、Uno 回报；画面没有名义速度兜底。累计脉冲是相对里程，不是隐藏的猫/标签坐标 |
| scanUntilVisible / alignToCat / alignToTag | 只消费当前视觉、侧距、触碰、编码器、时间和已确认配置；实际转向后再取观测 |
| followFixedPatrol / avoidObservedObstacle / 执行逃跑 | 标签 ID 顺序是预设路线；目标位置只由当前传感观测产生。距离及安全检查不读取完整地图或假想方向测距 |
| decision-system / route-planner / escape-planner / robot-observations | 不导入 world、catInput 或 core 几何。局部状态只保存可观测事件、计时和控制历史，静态测试维护此边界 |
| cat-input / 拖动、键盘和场景重置 | 环境及测试设置，可以修改场景；脚本阶段、攻击计划和运行标志不传给机器人策略 |
| 绘图、物体拾取、导出 world | 供人工复核场景，允许坐标；导出的全地图不被控制器读回。图上能看到猫不意味着机器人传感器能看到 |
| CAMERA_FRONT / DEBUG_INJECT 发布 | 仅显式模拟模式生成几何读数；物理超声波通道不注入覆盖。后部默认产生接触区域内的模拟触碰，接触释放不证明猫已离开 |
| Uno / HTTP 事件入口 | Uno 不保存场景坐标；输入为串口、编码器、触碰和超声波。HTTP 只携带一次性意图，不携带隐藏位置 |

新增回归：后方移动与不移动在相同观测/时间下给出相同等待结果；跨入后方盲区释放侧触碰，进一步离开盲区不产生额外信号；后部触碰默认启用且可为测试关闭；后部接触释放后，进一步不可见移动不产生新信号；物理来源拒绝缺失、过期、部分启用、注入来源和未知开关的兜底；装死超时不续巡，允许用户手动重新启动。

仍未实现真实 ESP32 猫视觉。LIVE 未提供检测结果时，不用模拟猫位置替代。新增模块 robot-observations.mjs 已登记服务器路由；旧运行服务须重启。
