SaitoTommo/CatTeasingRobot/esp32-host/主动互动按行为次数退出-20261005.md

# 2026-10-05 主动互动按完成行为次数退出（ESP 0.37）

用户澄清：主动找猫在找到猫后应至少完成设置的行为次数，默认 5，不应被 catLeaveSeconds 提前结束。之前 robotActionLimit 是最大完成次数，另有猫离开提前结束；ESP 0.36 延缓了这个提前退出，但仍不满足最新要求。本文件取代上一份观察退出说明中主动 ROBOT_SEARCH 的部分，WAIT_CHASE 与装死规则不变。

## 实现

- 已找到猫（robotFound）后的 ROBOT_SEARCH OBSERVE/SIGNAL/FOLLOW_WAIT 不再使用 catLeaveSeconds 退出。完整行为完成后仍由 completeRobotAction 计数，达到 robotActionLimit 后返回巡游。
- 接近或试探丢失猫、或者已找到猫后的 CAT_CHECK/CAT_CONFIRM 得到有效无猫结果，转为静止 OBSERVE，后续用完整观察行为完成剩余次数，不发起盲目 DRIVE，也不通过重新扫描失败提前退出。未完成的移动不会被补记成完成行为。重新获得猫画面后，下一行为仍可按原概率与远近阈值选择。
- WAIT_CHASE 持续有效无猫达到 catLeaveSeconds 才退出的规则保留。独立的画面不可用计时修复保留。PREY_WAIT 离开确认不变。
- 没有找到过猫的初始扫描仍可能失败；触碰攻击仍切入 CAT_TOUCH；无效/超时新帧、停稳、障碍、串口与电机保护仍可中断。这些不是正常按行为次数退出。5 指五个完整高层行为，不是五个编码器短段，也不是五次完整主动找猫会话。
- robotActionLimit 保存字段与数值不变，UI 改称完成行为次数，说明猫丢失时继续静止观察；catLeaveSeconds 不再标注适用于主动观察。

## 实际离线验证

实际 policy 1193 项、找猫复核 662 项、连续互动 703 项、扫描核心 259 项、PWM/设置 2656 项通过；视觉门控、串口帧校验与预览缓存 20 项通过。网页/状态清单 37 项通过。新增完整五行为测试分别从观察、声光开始，始终未检出猫也只在计数 5 时结束；测试接近/试探丢失与负停车复核改为 OBSERVE，不计未完成移动、不重新扫描、不发新 DRIVE。最终 ESP 完整离线编译通过：Flash 3,774,226/8,257,536 字节，静态 RAM 85,360/327,680 字节；git diff --check 通过。

本轮仅修改和离线验证，未连接串口、上传 ESP/Uno 或运行实车。原有两份项目日志的其他未提交修改保持原样，本轮变更单独提交。
