SaitoTommo/CatTeasingRobot/esp32-host/观察退出延时与提前退出复核-20261005.md

# 2026-10-05 观察退出延时与全部提前退出点复核

## 本轮修改：ESP32_CAT_HOST_0.36_CAT_ABSENCE_GRACE

主动 ROBOT_SEARCH 的 OBSERVE、SIGNAL、FOLLOW_WAIT，以及 CAT_TOUCH 的 WAIT_CHASE，共用 departed(true, true) 与已有保存值 catLeaveSeconds（log51 为 5 秒）。只有持续的新鲜、有效且未检出猫的帧覆盖该时长，才记录 cat absent for configured leave interval 并退出。再次检出猫，即使框很小、仍在远处，也清零；无效、过期帧和触碰也清零；重复同一帧不作为结束判据。缺猫确认期间保持静止，不因为初始观察/声光时长或动作间等待已经到期就完成动作次数或发起新运动；WAIT_CHASE 同样不会先被观察上限抢先退出。无新增保存配置或默认值变更。

WAIT_CHASE 无有效画面的超时，改从本次画面不可用开始计时，持续到 scanVisionTimeoutMs 才退出；恢复有效画面后清零。不再继承进入观察前已经过去的时长。触碰追逐仍可立即抢占缺猫等待。

同步修正：上一版本把 alignTimeoutMs 标为不支持是错误的，该字段仍控制标签转向超时；本轮从 unsupportedSettings 移除。猫居中仍停用，标签对准行为不变。

## 代码复核确认的其他退出点

| 分支 | 当前实际条件 | 可能表现及本轮范围 |
|---|---|---|
| 主动观察/声光/等待 | 原为单帧未检出猫 | 已改持续 catLeaveSeconds |
| WAIT_CHASE 猫离开 | 原为单帧未检出猫 | 已改持续 catLeaveSeconds |
| WAIT_CHASE 画面不可用 | 原超时从 actionAt 算 | 已改独立不可用计时 |
| 主动停车 CAT_CONFIRM / CAT_CHECK | robotFound 后负结果退出；CAT_CONFIRM 一张最终帧，CAT_CHECK 最多 catCheckMaxFrames 张 | 漏检仍可能结束互动；本轮只核查，未改变停车复核语义 |
| WAIT_CHASE 等不到追逐 | catObserveTimeoutSeconds 到期 | 已看见猫仍可能因没有近处转换/新触碰而结束，默认 10 秒；缺猫确认期间不抢先退出 |
| 主动动作次数 | robotActionLimit 次完整动作后结束 | 默认 5，计 OBSERVE/STAY、声光、快接近、慢接近、试探；短段停车不计次数 |
| 猫扫描结束 | Uno SD result 非 FOUND | NOT_FOUND 为剩余两圈编码器预算用尽；INVALID/TIMEOUT/ABORTED/SETTLE_TIMEOUT 可提前结束，不能把所有失败都理解为扫描满两圈 |
| 找到后停稳/新帧失败 | catSettleTimeoutMs、scanVisionTimeoutMs，或无效/过期最终帧 | 保护停稳与结果可用性，默认分别 6000/3000ms；本轮不放宽 |
| 逃跑方向/恢复运动 | 侧向障碍、侧传感器过期、前方不可用 | 侧数据 2500ms 过期；前向启用时 2000ms 无法获得许可会终止，本轮不改 |
| 通信/电机保护 | Uno 重启、STOP 未确认、运动反馈缺失、命令启动未确认、重试用尽 | 分别记录故障/失败；本轮不取消保护 |

## 为什么其他找猫等待较久

尚未找到猫时，beginScan 为最多两圈、约 720 度的编码器脉冲预算。每步需转动、停车、scanMinimumMs（log51 为 500ms）与安静条件，再等识别；多步累计可明显长于 5 秒。旧 searchTimeoutMs/finalSearchTimeoutMs 已不控制这个扫描。PREY_WAIT 是装死状态（不等同找猫）：catLeaveSeconds 的持续离开或 captureWaitMaxSeconds（log51 为 15 秒）到期后先转入重新找猫，扫描失败才结束，因此外观总等待还包含扫描时间。已找到猫的观察原来单独使用一帧缺猫立即退出，两者规则不同。本轮统一两个观察阶段的缺猫规则，未把完整扫描替换成 5 秒超时。

实际离线检查：policy 核心 1193 项、找猫复核 656 项、连续互动 709 项、扫描核心 259 项、PWM/设置 2656 项通过；视觉门控/串口帧校验与预览缓存 20 项通过。网页/状态清单 37 项通过，git diff --check 通过。最终 ESP 完整离线编译通过：Flash 3,774,074/8,257,536 字节，静态 RAM 85,360/327,680 字节。本轮未串口操作、上传或运行实车。项目日志在开始时已有其他未提交修改，保持其原样，本轮结论独立保存于此文件。
