SaitoTommo/CatTeasingRobot/esp32-host/猫识别帧率摸底-20261004.md

# 猫识别帧率实验分支

基线：已由用户现场验证并提交的 ESP0.29，Git f40bf52。分支 cat-vision-fps-bench，固件 ESP32_CAT_HOST_0.29_FPS_BENCH。Uno 不修改。默认关闭测试，原控制网页、路线、参数、动作测试和停车/通信恢复逻辑保留。

在原页面增加性能区域，开启后静止及运动时持续识别猫。原预览区域改为识别原图加浏览器绘制的猫框，JPEG 与响应头 X-Vision-Result 在同一互斥锁下复制，保证框和图片属于同一帧。关闭测试恢复原实时视频。位置为原图像素坐标，同时返回猫框、置信度、图像尺寸和帧编号。

识别完成后的额外空隙可调 0–5000ms；采集后的额外空隙可调 0–2000ms。两者为运行期参数，不修改保存配置。零表示取消对应固定等待，仍等待新帧并让出至少一个调度 tick；没有重入推理或积压旧图。非测试模式保留原采集200ms、连续推理启动间隔350ms。状态机请求帧优先，并保留其新帧/scanId/stepId/generation规则，不受实验空隙限制。

测试期间原策略需要标签时同帧执行猫和标签，原策略需要地面检查时继续计算地面结果。提供给策略的连续结果保留原模式和有效性，不把运动测试的猫框冒充停车识别；请求帧仍按原票据处理。BOTH模式整次处理耗时含标签工作，猫模型耗时单独列出。

逐次记录：编号、帧号、解码/模型初始化、猫模型推理、整次处理、相邻启动间隔、上次完成到本次启动的实际空隙、采集到完成的图像年龄。毫秒计时；整次处理包含预处理/后处理和地面/标签工作，不包含HTTP图像传输。首轮模型初始化不剔除。

网页分别展示整次处理与猫模型推理的平均、中位数、P95、最小、最大耗时，并根据设备启动间隔计算识别频率。P95为最近邻秩定义：升序第ceil(0.95*N)个样本。ESP保留最近128次，浏览器保留最近20000次并可导出CSV；超出设备缓冲的丢失记录明确计数，不能把浏览器图片刷新率当作识别帧率。换间隔比较时先“清空并重新计时”。

使用：保留原串口/巡游/主动找猫/手动测试操作；开启性能测试，在静止与运动条件下分别比较200、100、50、0ms。若要解除原采集速度限制，采集空隙也需设零。观察CPU/堆、网页请求失败与Uno连接，零空隙会增加实际系统负载。

已有网页23项及统计/去重/缺样本/换轮检查通过。实际帧率、动态猫识别命中率和长时间运动通信稳定性待实测；不承诺零间隔时原系统响应时间保持不变。

原生检查也通过：实际策略1160、连续互动252、扫描259、设置/PWM2640，以及视觉新帧门控与串口校验。未修改policy.cpp和Uno固件。

最终完整编译通过：Flash3,751,110/8,257,536（45%），静态RAM83,656/327,680（25%）；网页原有23项与新增4项统计、零间隔和同帧画框检查通过。上传前设备再次停车未确认；重复STOP和SIM_UNO→UART均没有得到可信停车回包，已停止烧录，等待用户断电机供电/Uno确认。原设备仍ESP0.29，实验固件尚未写入；证据evidence/cat-vision-fps-bench-20261004。关闭测试保留本轮统计，重新开启/清空重新计时才换轮。

用户随后明确指示Uno失联暂不处理，继续ESP实验。上传前策略STOPPED、motorId0、当前请求0/0，停车ACK仍未收到；不把这次操作记录为停车确认成功或电机断电已验证。按该指示只上传ESP应用。

## 居中容差与短暂巡游状态显示
新增独立居中容差输入，使用既有centerTolerancePercent（1–20%，中心左右各±百分比），猫与标签共用；保存后由原有config校验/NVS和policy比较实际执行，并以板上回读确认。可选水平FOV与允许偏角辅助输入按p=50*tan(angle)/tan(FOV/2)换算，角度不保存，必须是水平FOV，镜头畸变与裁切待标定。不新增假定的相机FOV。
TAG_ALIGN在log36持续约79–97ms，而网页轮询至少600ms，当前状态抽样可跳过它；新增最近8项巡游DECISION历史和中文标签，明确历史不等同当前执行；APPROACH_TAG显示为标签已找到、判断对准或靠近。顺手修正UI恢复总轮数由3显示为4，与0.29实际策略一致。此次不修改policy.cpp，不实施3Hz调度或停车后新帧补强。网页30项检查通过。固件版本ESP32_CAT_HOST_0.29_FPS_BENCH_2，编译上传记录另补。

进一步按用户要求增加/api/flow轻量只读接口：即时流程约100ms请求一次（收到响应后再计时，不并发积压），失败退避1000ms；完整状态保留600ms。policy.cpp仅新增policyFlowSnapshot读出当前步骤/电机请求，不改控制状态转换。回包含最近8条巡游DECISION，避免短状态漏显示，较旧完整回读不倒退历史。设备重新上电时即时状态可正常更新。网页合计31项、原生实际policy1160等检查通过。目标刷新频率受HTTP与网络耗时影响，不保证硬实时100ms。

## 实验版2编译与上传实录
2026-10-04：完整编译通过，Flash 3,754,358/8,257,536（45%），静态RAM 83,656/327,680（25%）。COM11仅上传ESP应用，地址0x10000，写入3,754,512字节，46.7秒，esptool确认Hash of data verified。HTTP回读固件ESP32_CAT_HOST_0.29_FPS_BENCH_2，上电模式SIM_UNO、策略IDLE；88项保存配置与上传前一致，居中容差仍为5.5%。Uno未修改或上传。

/api/flow在空闲条件下连续6次保持连接请求均返回200，155字节回包，往返耗时分别115.66、186.09、308.78、108.69、64.32、130.78ms。这些是接口实测，不是运动/推理负载下的网页刷新保证。100ms为响应结束后的下一次请求等待；短状态可在历史中查看。代码检查31项及原生状态机检查通过，实车运动、识别负载和界面验收由用户测试。证据目录evidence/cat-center-live-ui-20261004。

用户要求后续不使用Computer Use或浏览器，界面检查由用户自行完成。该要求到达前曾只读打开页面，未操作车辆或更改保存配置；后续不再进行浏览器检查。本分支待用户验证后再本地提交。

## 实验版3：居中拆分和主动找猫概率
按用户要求将居中范围拆为猫居中容差（沿用centerTolerancePercent）与标签居中容差（新增tagCenterTolerancePercent）。两者均为画面中心左右各±1–20%，各自进入实际猫对准/标签对准判断；猫远处/近处阈值仍是框宽占画面宽度，用于远近判断，标签停车宽度仍用于到达判断，明确区分命名。旧保存配置没有标签居中字段时继承旧共用容差，不重置其他配置。视场角换算可选择应用到猫或标签。

用户明确选择保留现有慢靠近与三段试探靠近，只开放现有概率；未增加慢→快或快→慢。原界面新增主动找猫配置区域：远处慢靠近/试探合计100%；近处原地声光/观察/静止合计100%，另展示试探冷却、现有距离/PWM/三段暂停及声光时长。沿用原config校验、保存、回读及状态机；冷却期间试探回退慢靠近。触碰发起的并行声光、复核后装死/探索/逃跑继续在猫互动配置中设置。本次不改变分支概率、靠近控制或识别调度，只让既有有效参数可见可调。

自动化网页检查33项通过；实际policy1170、连续互动252、scan259、设置/PWM2647及视觉门控/串口校验通过。新检查覆盖猫/标签容差独立影响实际转向、旧值迁移、0/100概率选原有分支、概率组校验和保存回读。本轮未使用浏览器或Computer Use。上传前通过USB串口只读查询确认实验版2、UART/IDLE、stopPendingId=0、stopUnconfirmed=false、当前motorId=0及PWM0/0。用户已将旧共用居中容差保存为20%，升级应迁移为猫20%/标签20%；原远处85%/15%、近处20%/40%/40%、最低PWM255不变。编译与上传最终记录另补，证据evidence/cat-settings-split-20261004。

实验版3完整编译通过：Flash3,756,322/8,257,536（45%），静态RAM83,656/327,680（25%）。已提前告知用户后，经COM11仅上传ESP应用0x10000，3,756,464字节、46.7秒，Hash of data verified。USB串口回读确认ESP32_CAT_HOST_0.29_FPS_BENCH_3、SIM_UNO/IDLE，所有已有保存配置不变；新增标签居中容差实际继承20%，猫居中仍20%。上传和回读证据已落盘。Uno未改未上传；界面与实车行为由用户验收，新版本尚未Git提交。
