SaitoTommo/CatTeasingRobot/esp32-host/停车失败时保留遥测-20261004.md

# 2026-10-04 ESP 0.26：停车失败时保留遥测

log32 ESP0.25：STOP101未确认后，92913ms进入自动恢复。三轮STOP104、106、108均只收到UART_LOOPBACK，没有对应MOTOR_STOPPED，96587ms失败退出；所以配置读取和会话重新同步根本没有执行。97790ms再次停车未确认后，GET_TELEMETRY114在99792ms被TX_BLOCKED；GET_TELEMETRY115在106793ms同样被拦截。界面全部遥测过期是此发送保护的结果，不能据此判定所有传感器故障。

108826ms切到SIM_UNO时，108827ms仍发送了原UART模式排队的物理STOP116，108838ms得到真实停车确认；之后111037ms切回UART，STOP128同样确认。恢复发生在切回真实UART之前。两端USB都有真实回复。模式切换源码没有重新begin硬件UART，与自动恢复的差异不能简单称为硬件串口被重初始化；时序和外部物理链路根因仍待查。不要把先前回显当成确认。

0.26：停止未确认保护只允许新的STOP，以及严格匹配的GET_TELEMETRY、GET_CONFIG、PING只读查询。只读查询不会清除stopPendingId、stopUnconfirmed或重启停车计数；运动、SESSION_START、配置写入等仍禁止。停车确认等待期间仍优先停车，失败后的只读遥测才放行。若物理接收仍回显或损坏，界面仍须显示无新读数，不能伪造有效值。

原生检查验证只读白名单及尾随字段、非查询伪装被拒绝，全部现有策略818项、扫描259项、连续互动252项、PWM/设置2640项和视觉/CRC检查通过。该修复恢复诊断查询通道，未证明自动恢复可以消除UART_LOOPBACK。

log33仍是0.25：标签扫描的VR1257等回复回显，894562ms扫描result3先进入FAULT，895763ms停车未确认；旧代码因phase已STOPPED跳过恢复。最终0.26补上这条非操作者停止的故障恢复入口：确认STOP、SESSION_STOP和配置后，只恢复诊断通信，保留原FAULT/STOPPED，不发送SESSION_START、不自动开电机。已经穷尽三轮的恢复失败不重复开启恢复，操作者stop仍取消恢复。最终策略回归831项通过。

双串口在柏林18:05:31抓到 `DONE 1413 TELE` 中断后大量00及READY UNO_CAT_V6.9。用户明确没有复位或断电，属于自行重启；与串口回显是否同根因仍未确定。

上传前另测：明确STOP策略之后，DATA1815等新遥测仍出现`HW MR 0 220 220 1 0 0`，两侧RPM0；后续DATA1901两侧应用PWM均0。应用PWM是Uno软件记录，不是电机电压测量，因此不能直接认定这段时间电机持续带电，也不能归为最低PWM设置。当前ESP最低PWM回读255，零请求不抬升。

Uno源码存在独立STOP缺口：abortMotion在motion.kind==MOTION_NONE时返回，跳过stopOutputs，STOP处理器却仍返回MOTOR_STOPPED。已将stopOutputs移动到该返回之前；STOP、SESSION_STOP等调用路径都执行输出清零。Uno6.10编译32254/32256字节、RAM1379/2048，保留功能，只缩短一条启动诊断文字`BAUD=57600`为`57600`以容纳Flash。此时尚未上传Uno，不能声称该缺口已证明是220或持续转动的唯一根因。

部署完成：ESP0.26 BIN3741552字节，46.5秒写入并哈希校验；HTTP确认版本0.26，IDLE/SIM_UNO，保存参数变更0。用户明确板间串口已拔好后，Uno6.10使用COM10、arduino-cli upload --verify成功退出0，首轮同步警告后完成。重新挂接只读采集post-v026-uno610；有有效Uno心跳，未捕到新版本完整READY启动行，未主动驱动电机验收。告知用户接回板间串口并选Real UART。命令回显及自行重启根因未确定。
