SaitoTommo/CatTeasingRobot/esp32-host/找到猫后反复旋转-20261004.md

# 2026-10-04 ESP 0.25：找到猫后反复旋转

用户指出架空测试中电机持续旋转，不接受将其归为车辆滑行。log31导出时ms409664，已停止，160条保留日志未覆盖问题现场；本轮双USB采集补到完整互动。

## 采集事实

- 初次触碰找到猫：ms311621 VR result1，ms311652停车确认，CAT_CONFIRM，ms317643进入逃跑；这一段没有强制居中旋转。
- 逃跑结束后ms319819再次找到猫，ms319840发 `ROTATE 20.3 255`，ms319924停车确认并进入SETTLE。
- ms320203/ms320455遥测请求和应用PWM均0/0，编码器计数138/214，RPM18/24；ms320703同样计数，RPM0/0，随后CAT_CHECK。
- ms321009再次扫描；ms322028找到猫；ms322048又发ROTATE。后续323677、325049、326628、329267、330642、332248等仍发同方向ROTATE。
- ms341252最终 `alignment budget exhausted`，结束互动后重新巡游；ms349410用户主动停止。

## 原因与修复

追逃、装死或探索收尾的CHASE_ALIGN路径找到猫后仍调用orient，要求猫框严格居中才复核。框不居中便反复旋转；中间会进入SETTLE，页面刷新可能遗漏较短的ALIGN_CAT阶段。相机与电机未同步改变朝向时，居中反馈更难收敛，但本次不能仅凭代码断定相机安装方式。

0.25将所有CAT_TOUCH收尾的找到猫结果直接转为停车复核；CHASE_ALIGN成功后的目标为WAIT_CHASE。复核成功即静止观察，猫框偏离中央不再重新旋转。后续有效帧无猫或观察超时仍退出，找不到猫仍按扫描失败处理。保留0.24的停车确认、编码器停稳条件及通信有上限恢复。主动ROBOT_SEARCH、AprilTag对准和逃跑方向转动保留原逻辑。

此证据确认程序确实反复下发运动命令，不能再只按停车惯性解释用户现象；也不证明其他所有时段不存在电机输出或编码器异常。未主动进行实体电机验收。

原生检查通过：实际ESP策略818项、连续互动252项、PWM及配置2640项、扫描259项，视觉与帧校验检查通过。新增回归使用偏离中央的猫框，验证找到后停车复核到WAIT_CHASE全过程没有ROTATE、DRIVE或SR。ESP编译Flash3740650/8257536、RAM78976/327680。
