SaitoTommo/CatTeasingRobot/esp32-host/扫描配置重试-20261003.md

# ESP V0.15：扫描配置校验失败重试

2026-10-03。用户确认仅在扫描配置实现重试：首次发送之外最多重发3次，校验失败后间隔100毫秒。Uno V6.7无需改动。

证据：scan-config-checksum-failure-20261003.json 中206073ms到达40，切回46；206106ms发送SC配置389，206126ms收到ERROR 0 BAD_CHECKSUM；208578ms原程序直接scan configuration timeout。后续心跳、遥测和STOP确认正常，不证明电气或SoftwareSerial时序是哪一个造成损坏。

实现：WAIT_SCAN_CONFIG期间只对BAD_CHECKSUM/BAD_ENVELOPE（无编号0或匹配当前SC编号）安排重试；100ms到期重发同一配置参数、分配新编号，忽略旧编号迟到成功或失败。完全无回复等2500ms后安排100ms间隔重试。重复错误不叠加次数、不推迟已安排重试。第四次发送仍失败或超时即发送STOP并终止策略，显示最后原因。收到当前编号的精确SCAN_CONFIGURED才发SR。STOP、触碰、新流程、重启取消待重试。串口无近期回复时仍遵循原2500ms链路停止保护，不以重试绕过断线保护。

扫描配置开始前清理剩余发送队列；配置等待和重试期间暂停普通遥测轮询，减少无编号错误归属混淆。范围只限SC，BUSY/INVALID_ARGUMENT等拒绝不重试，运动命令不增加重试。没有通用网关，不自动更改已保存PWM、停车宽度或等待时间。

自动化：真实policy.cpp原生策略514项通过，包括路线末尾切回首个目标、错误后99ms不发送/100ms发送、三次重试后停止、无回复超时、重复错误、旧编号回复、错误DONE类型、间隔中成功、操作停止取消、参数拒绝、范围隔离、下一轮次数清零和millis回绕。扫描核心215、PWM/参数2603、视觉门控和线路校验、网页18项通过。现场运动和人工UI验收由用户完成。

用户验收：确认HTTP版本ESP32_CAT_HOST_0.15，选真机UART并PING确认SCAN_V1，按原路线展示46和40至少两轮。若出现校验失败，日志应有SCAN_CONFIG_RETRY_WAIT及SCAN_CONFIG_RETRY，之后当前编号SCAN_CONFIGURED成功即继续巡游；只有用尽3次重试才停止。不要通过断线制造运动故障。自动化已模拟错误注入、次数用尽和无回复。

编译完成：ESP V0.15 Flash3719626/8257536字节，静态RAM78816/327680。追加无回复但心跳正常时三次重试用尽、断线保护、运动错误不重试，最终原生策略514项通过。未更改Uno。

上传结果：用户已授权上传自动reset。上传前只读确认UART、STOPPED、stopPendingId=0、stopUnconfirmed=false、无运行电机。COM11既有分区与构建一致，仅写应用0x10000共3719776字节；写入哈希校验通过并自动reset。HTTP回读确认ESP32_CAT_HOST_0.15、IDLE、SIM_UNO；原保存路线[46,40]、最低PWM255、scanMinimumMs200、停车宽度0.19保留。没有进行界面或运动测试；用户需要选Real UART并PING确认能力后验收。
