SaitoTommo/CatTeasingRobot/esp32-host/停稳计时修复与等待设置-20261003.md

# 2026-10-03：Uno V6.7 / ESP V0.14 停稳计时修复

用户实车操作，助手只读 HTTP 采集；原始证据见 live-diagnosis-20261003.ndjson 和 live-diagnosis-initial.json。去重后 1284 条事件：46 到达 5 次、40 到达 2 次、4 次 result=5；12 次 SCAN_CONFIGURED。采集期间未重现配置超时与对准次数耗尽，不能归因于本次修复。最低 PWM 初始回读为255，用户后续说明供电需要225；本次不修改已保存 PWM 或停车宽度。

一次 MD 918 在 ESP 日志时刻1610095 ms，SD 918 113 5 在1610098 ms，仅相隔3 ms。Uno loop保存now后执行tickMotion，finishMotion用新millis记录stopped，再tickScan使用旧now，无符号减法可误判超时。

修复：tickScan获取新millis；共享扫描核心拒绝早于stopped的旧采样时间，保留正常3秒超时和计时器回绕行为。顶注释与READY升级Uno6.7，ESP状态版本0.14。两份Uno源码同步。

页面新增停车后识别等待时间，50–3000毫秒，绑定现有scanMinimumMs，读取保存值、保留编辑草稿、停车确认后才允许保存、断线禁用、沿用NVS持久化。必要时将scanSettleTimeoutMs延长到至少等待时间或quiet时间加1000毫秒；不缩短原超时上限。默认200毫秒与现有已保存值不变。

自动化：扫描核心215项，ESP策略442项，PWM/设置2603项，视觉门控和线路校验通过；网页18项通过。新增旧时间戳、回绕、延长等待、真实超时及设置验证。Uno编译32162/32256字节，RAM1379/2048。实车停稳、页面保存重启、两标签巡游由用户验收。

验收：刷新网页确认ESP0.14；确认Uno READY UNO_CAT_V6.7。停止并等待停车确认后，在停车后识别等待时间保存1000毫秒，核对回读。用户展示46和40，确认每段停车等待至少1秒，停止后不再立即result=5。重新打开网页/重启后核对保存值。记录仍出现的配置超时或对准次数耗尽，它们不在本次两项修改范围内。

上传记录：用户明确允许上传时自动reset。ESP COM11分区回读与构建分区一致，仅写0x10000应用3717872字节，哈希校验成功并自动reset；HTTP只读回读确认ESP32_CAT_HOST_0.14、IDLE，scanMinimumMs=200、scanSettleTimeoutMs=3000、minimumDrivePwm=255、route=[46,40]、tagStopWidth=0.19，保存值保留。Uno COM10两次因拒绝访问未能打开端口，未写入V6.7，等待用户关闭串口占用。不得把ESP上传成功描述为Uno计时修复已在设备生效。ESP编译Flash3717718、静态RAM78792。未进行UI、运动或识别验收。

后续上传完成：用户释放串口后，COM10的Uno V6.7成功写入32162字节，AVRDUDE读回校验32162字节通过。ESP V0.14与Uno V6.7均已上传；尚未验证实车停稳、标签巡游或网页操作，用户负责接回UART与现场验收。
