SaitoTommo/CatTeasingRobot/evidence/uart-ready-window-20261013/latency-review-20261014.md

# 接收窗口协议与历史时延对比（2026-10-14）

本轮只分析已有文件和源码，没有连接设备、重烧固件或进行新实机测试。当前指本次 2026-10-13 部署后的静止采集，不是 10 月 14 日的新测量。源码 db1d28d，部署证据 80e3edc。

## 数据来源及口径

- 2026-10-02：Uno V5.8 / ESP 0.6，9600/8N1，策略停止、USB 供电。取既有 `../tmp/latency-audit-results.json`、`../tmp/latency-audit-notes.md`，项目日志已保留条件及样本缺口。
- 旧紧凑协议：项目日志中 ESP 0.18 日志12/13/14的完整事务统计，以及 ESP 0.10 短测摘要。后者只有批次发布跨度与查询间隔，没有完整 TX→DONE 时延。
- 本次故障日志：用户附件 `D:/data/download/esp32-local-history-2026-10-13T15-41-52-587Z.json`，ESP 0.49。该文件是本地历史导出，存在模式切换和故障恢复，不是受控压测。完整事务必须有同编号三份 TB 和 DONE。
- 当前：`uart-stationary-capture.json` 中 ms≥130529 的真实 UART 事件（MODE UART 起）；采集总时长30.516秒，该事件统计跨度30.065秒。开头旧 SIM 事件排除。`uart-final-readback.json` 另含安全重发 SESSION_STOP 的结果，不混入15次遥测。

采用设备日志 ms 之差：实际 UNO_TX→同编号 AK / 完整 DONE，不采用浏览器 receivedAt、HTTP往返或帧龄。P95采用最近秩法，15样本时P95即最大值。成功事务耗时不包含请求排队→实际发送，不包含物理停稳。小样本、不同供电/负载/版本不能作为严格同条件提速证据；捕获完整比例也不是受控丢包率。

## 已有数据

| 对象 | 完整事务样本 | 遥测 TX→DONE P50 / P95 / 最大（ms） | 其他口径 |
|---|---:|---:|---|
| 9600 静置 | 1160 | 510 / 562 / 599 | TX→ACK 41 / 74 / 118 ms；实际遥测1.90Hz |
| 9600 叠加低频PING | 222 | 521 / 574 / 612 | 额外PING实际0.70Hz；遥测1.88Hz |
| 9600 叠加高频PING | 329 | 542 / 606 / 636 | 额外PING实际2.09Hz；遥测1.82Hz |
| 9600 叠加GET_STATUS | 345 | 630 / 674 / 779 | 额外STATUS实际1.16Hz；遥测1.65Hz |
| 57600 / ESP0.18 日志12 | 14 | 46 / 未复算 / 62 | 最小40ms，包含未完成请求 |
| 57600 / ESP0.18 日志13 | 3 | 76 / 未复算 / 91 | 最小40ms，包含未完成请求 |
| 57600 / ESP0.18 日志14 | 4 | 40 / 未复算 / 40 | 最小39ms，包含未完成请求 |
| 57600 / ESP0.49 本次故障前附件 | 2（47次发送） | 46.5 / 52 / 52 | 两次为41、52ms；ACK均9ms；请求间隔中位7002ms |
| 57600 / ESP0.50 接收窗口静止采集 | 15（15次发送） | 56 / 70 / 70 | 最小38ms；ACK中位/P95均9ms；请求间隔中位2000ms、P95/最大2026ms |

相比9600静置，当前成功遥测中位数低454ms（89.0%），P95低492ms（87.5%），最大低529ms（88.3%）；ACK中位低32ms（78.0%）。相对9600叠加STATUS，遥测中位低574ms（91.1%）。这些是跨版本观测差值，包含此前波特率及紧凑遥测改造的效果，不能全归功于此次窗口。

相比旧57600故障附件仅有的两次成功事务，中位56−46.5=9.5ms（+20.4%），P95/最大70−52=18ms（+34.6%）；ACK中位9ms不变。相对0.18日志12/14，中位分别增加10ms、16ms；相对日志13减少20ms。当前P95样本少、负载不同，不能认定窗口机制必然造成9.5ms退化，也不能宣称57600事务全面更快。

旧附件47次发送捕获2次完整回报（4.3%），当前15/15（100%）；旧46条TELEMETRY_TIMEOUT、5条STOP_UNCONFIRMED、15条STOP_RETRY及1条UART_BAD_FRAME，当前统计窗口0条遥测超时、0条CRC错误，1条RX_WINDOW_EXPIRED。超时条目可能涉及模式切换/既有pending，不能把46直接当47次请求中46次独立失败。旧附件没有捕获可信MOTOR_STOPPED完成；新STOP一次10ms获确认，另一次SESSION_STOP安全重发14ms完成。这是恢复可信确认，不能计算旧→新物理停车提速。

查询间隔中位7002→2000ms（缩短71.4%），说明这次故障中等待5秒超时再隔2秒重取的停顿已在短测内消失。当前约0.5Hz的普通遥测频率仍低于早期9600的1.65–1.90Hz；主要是当前约2秒轮询策略，与旧300ms轮询策略不同。回复更快不等于网页传感器刷新更频繁。ESP0.10曾已有1999–2015ms间隔，因此这次不是首次达到2秒轮询。最后13行年龄299–302ms是最后回读时的年龄，不是UART事务时延。

## 当前机制的代价与边界

- 普通命令多了等待available、至少3ms转向等待和单窗口一命令。Uno最短80ms再提供下一窗口，窗口最多60ms，ESP按45ms预算含线速和余量发包。这些是源码门槛；真实排队→发送P50/P95没有独立打点，不能把80ms写成每条必增或严格上限。没有grant时普通命令可能等待更久。紧急STOP允许直发和有界重试。
- 当前375个相邻available日志间隔中位80ms、P95 91ms、最大133ms（最小33ms，日志接收调度可能聚集，不等于Uno发射周期）。376条/30.065秒≈12.5条/秒；按统计内事件速率估算，设备160条环形日志在类似负载下约9秒就被覆盖。旧H心跳约1秒一条。浏览器持久历史/连续导出可保留更多，但不能假设未打开页面也已持久采全；新增日志/流量是明确代价，未实测CPU或HTTP退化。
- 删除旧H心跳的循环频率/最大循环耗时等字段，available能证明窗口声明及回传活跃，无法替代全部旧诊断信息。内存M与指令诊断保留。
- Uno Flash32234/32256，仅余22字节；静态RAM1376/2048，编译口径余672字节不等于运行时栈余量。容量已非常紧，后续扩展需重新编译及检查。
- 右侧超声波仍-1；可区分“完整收到无效读数”与“串口没收到回报”，但没有修复传感器。没有运动/长期/额外PING或STATUS压力验收；HTTP、视觉推理、触碰到物理停稳等时延没有本轮新数据。

## 可复算入口

运行 `compare-latency.ps1` 生成 `latency-comparison.json`，其中保留附件SHA256、完整编号、ACK/DONE/间隔分布及事件计数。旧附件位于用户下载目录，脚本参数OldPath可指定新路径。历史9600统计按既有报告引用，不重复伪造原始测量；0.18统计来自项目日志已记录结果。

## 补充：必须计入派发等待及一窗口一命令（用户复核后）

前面56ms只是实际发送→完整回报，不能代表请求发生→完成的整体响应；不能用它单独评价新窗口的性能代价。正确分段为：请求到ESP/策略生成→指令入队→等待可用窗口和前序指令→实际串口发送→Uno解析/确认→结果完整回传。旧日志和当前源码均未给每条入队时间；Uno取指/开始执行也无同步独立打点。ACK只是ESP收到确认的时刻，含命令串行发送、Uno解析和ACK回传，不是CPU取指→执行耗时。旧压力驱动只记录快照/累计sent及HTTP queued布尔，没有逐POST起止/指令编号，因此不能追回逐条排队时延。

**现有数据能计入触发至完成的实例。** 当前MODE UART设备时间130529ms，同一处理函数已将STOP31、SESSION_STOP32、GET_CONFIG33入队；MODE事件是近似触发参照，非精确逐命令入队打点。

| 指令 | 触发→发送 | 触发→ACK | 触发→完成/拒绝 | 解读 |
|---|---:|---:|---:|---|
| STOP31（紧急） | 62ms | 67ms | 72ms确认 | 队列前有4条旧SIM命令，紧急STOP不受窗口许可限制；62ms不能全部归因available |
| SESSION_STOP32（普通） | 163ms | 无ACK | 175ms窗口过期拒绝 | 单看发送后12ms错误会漏掉前面等待；该命令此次没有执行成功 |
| GET_CONFIG33（普通） | 194ms | 203ms | 223ms完整返回 | 发送后29ms只是后段，整体含排队/等待为约223ms |

旧附件首次MODE UART为28026ms，STOP14在28091ms发出（触发→发送65ms），29296ms报STOP_UNCONFIRMED（触发后1270ms）；无可信完成。该旧实例同样有旧SIM队列清理，不是纯窗口前后对照。新STOP62ms派发/72ms确认说明恢复事务可确认，不能推出新普通命令排队更快。

**加入已收到的许可之后的时间。** 15次遥测对应窗口1150、1175……1500，每次相差25个许可，与2000ms轮询及80ms窗口接近同相；本次稀疏遥测没有测试持续排队的普通命令。按实际UART_WINDOW_TX打点：

| 区间 | P50 / P95 / 最大（ms） | 范围及限制 |
|---|---|---|
| 对应available已收到→实际发送 | 5 / 29 / 29 | 3–29ms；未含该许可到来前的等待 |
| 对应available已收到→收到ACK | 14 / 38 / 38 | 12–38ms；仍非精确Uno执行起点 |
| 对应available已收到→完整DONE | 61 / 92 / 92 | 43–92ms；仍不能当请求→完成的全程 |

UART_WINDOW_TX在写串口后立即记录，UNO_TX随后记录，两者部分相差1ms，因此使用此表时不将后者的56ms统计机械相加成新的完整端到端时延。`compare-dispatch.ps1`生成`dispatch-comparison.json`，保留每条许可匹配及触发时间线。

**连续普通命令的派发能力确实受限。** 旧ESP派发门槛为两次写入至少15ms，没有一窗口一命令限制；理论仅派发门槛上限约66.7条/秒，非实机可持续执行能力。新许可起点至少隔80ms，每许可一条普通命令，长期连续供给的理想上限约12.5条/秒（相对该旧理论门槛上限低81.25%）；超声阶段、TX未完成、前序回报或许可过期会进一步降低。这是明确机制代价，不用15次稀疏遥测成功替代突发吞吐验收。紧急STOP为例外。

不能表述为“每两条实际发送/执行都严格相差80ms”：第一条在许可较晚时发送，后一条在下个许可早期发送，二者间隔可小于80ms；长期许可供给仍受80ms起点门槛约束。无排队孤立指令若刚错过可用阶段，需要等后续许可；有N条普通命令排队还会跨N个窗口。理想例：3条同时排队、首条恰逢窗口，起点约0/80/160ms，最后一条还需发送和执行/回报时间；这只是示意，不是本次实测。无许可/繁忙时不能把80ms当排队严格上限，也不能把80ms统一加在每条成功事务上。

最终结论修正为：短测完整回报和故障停顿改善；发送后事务略增但原因未确认；窗口降低连续普通指令的派发能力并引入等待。请求入队→ACK/执行→DONE的完整P50/P95，需以后补逐指令编号和入队/实际发送/匹配回报打点后同条件测试。本轮只修订统计解释，没有修改/烧录固件或发送新设备命令。

## 更早健康基线与接触不良的归因修正

用户随后现场排查发现接触不良。该信息作为用户硬件排查结果记录，不能再把最近故障附件2/47→部署短测15/15直接解释为协议本身的可靠性提升；恢复同时涉及重新接线、D13迁移和窗口协议，独立贡献没有隔离实验。

补查下载目录10月6/7/12/13的较早历史导出，以及10月14日07:57:36Z新协议导出（本轮只读已有文件，不做新测量）。按bootId和seq去重，不跨启动关联指令；按三份TB+同编号DONE匹配。静止筛选要求紧凑回报移动标志关闭、左右目标及输出PWM为零，不等于物理停稳。每份文件选择最长捕获的连续静止完整回报段，遇seq缺口、模式切换、重启标记、遥测/校验错误或非静止回报即结束；这避免用最近故障窗口及仅两次成功回复充当健康性能基线。仍有其他控制/视觉流量，未控制供电等条件。

| 健康捕获段 | 对应启动固件（不能用文件末尾版本替代） | 完整静止样本 | TX→ACK P50/P95（ms） | TX→DONE P50/P95/最大（ms） |
|---|---|---:|---:|---:|
| 10月6日 boot3c1603d092c49dc8，ESP102522–213576ms | 0.40_SENSOR_CAMERA_RANGES | 88 | 9/10 | 41/57/90 |
| 10月7日 boot77215860126b7ac6，ESP156656–816512ms | 0.42_SHARED_TARGET_RECOVERY | 343 | 9/10 | 41/64/71 |
| 10月12日 boota05962c32eae743c，ESP283415–586924ms | 0.44_ROUTE_EDITOR | 152 | 9/10 | 41/52/69 |
| 10月13日 boot2fcf1053357ae5a6，ESP569465–767307ms | 0.49_ESCAPE_CONTINUOUS_FRONT | 100 | 9/10 | 47/58/87 |
| 10月14日 bootf18e9032097095ca，ESP202620–446662ms | 0.50_UART_RX_WINDOW | 147 | 9/11 | 45/68/84 |

相比更早343样本健康段，当前147样本段发送后中位41→45ms，增加4ms（9.8%）；P95 64→68ms增加4ms（6.3%），ACK中位不变。相对10月13日0.49健康段，中位47→45ms低2ms，P95 58→68ms高10ms，不是全面提升。当前最大84ms高于10月7日71ms，但低于10月6日90ms和10月13日87ms，负载/样本数不同，不能取最有利一格报“整体性能提升”。当前147样本段available→DONE中位53/P95 83ms，仍漏掉该许可到来前等待，不能和旧TX→DONE41ms直接同比。

**同一触发流程的全程对照更能体现派发代价。** 从旧0.49附件取两次MODE UART后无STOP_RETRY/窗口错误、配置完整返回的例子，分别MODE851754/997845ms；旧触发→GET_CONFIG发送95/96ms，→ACK102/104ms，→DONE123/124ms。新0.50附件对应两次无STOP_RETRY/窗口错误的成功例子，MODE284895/653775ms；触发→发送189/188ms，→ACK196/197ms，→DONE均217ms。

| 整段流程（各2次，触发代理为MODE） | 旧0.49中位 | 新0.50中位 | 观测差值 |
|---|---:|---:|---:|
| MODE→GET_CONFIG发出 | 95.5ms | 188.5ms | +93ms |
| MODE→GET_CONFIG ACK | 103ms | 196.5ms | +93.5ms |
| MODE→GET_CONFIG完整DONE | 123.5ms | 217ms | +93.5ms（+75.7%） |
| GET_CONFIG实际发出→完整DONE | 28ms | 28.5ms | +0.5ms |

增加几乎都在实际发送之前。具体连续普通命令实例：旧MODE851754ms，SESSION_STOP514发出851832、GET_CONFIG515发出851849，间隔17ms；新MODE653775ms，SESSION_STOP525发出653881、GET_CONFIG526发出653963，间隔82ms，两者都成功完成。相比纯理论80ms门槛，这是真实记录中的普通指令派发差值。不过MODE处理还包含前序控制指令，原模式/队列/调度不同，样本各2次不能当受控因果测试或推广为所有操作慢75.7%；它明确说明不能漏掉窗口及前序排队。

**更新结论：相对正常工作的旧57600协议，没有测出新的整体速度提升；成功事务大致相近或略慢，连续普通命令及配置流程更慢。** 当前窗口提供发送与接收协调、一条许可一条命令及过期拒绝，是机制改善；其独立可靠性收益在接触问题排除后仍需同条件长测。故障现场恢复属已观察结果，不再用于宣称协议本身可靠性提升95.7个百分点。右超声波无效和整体运动验收仍独立未闭环。

`scan-healthy-history.mjs`及`healthy-history-comparison.json`保存全部六份输入的SHA256、每启动版本/seq缺口/事件计数、前三个最长健康段和MODE配置实例。各历史文件互有重复的可能，不把不同导出当独立样本合并计算成功率；整体文件含故障/切换/采集边界，不用全文件完整比例作协议可靠性优劣结论。旧/新没有逐条入队打点的限制仍存在。
