SaitoTommo/CatTeasingRobot/本次改动清单-20261012.md

# DEV 遥控与续寻改动清单（2026-10-12）

开始修改前，受跟踪文件和暂存区没有待提交改动。DEV 从本机 main 的 592621b 创建；历史 evidence 未跟踪文件留在本地，不纳入本次提交。用户已授权将本次关键开发改动提交到 DEV；实车验收结果待反馈后再整理入项目日志。

| 文件或模块 | 改动 |
| --- | --- |
| ESP32CatHost.ino | 接入遥控会话、控制入口、状态回读与循环；版本更新为 0.47_SWITCH_FIX。 |
| remote_control.h（新增） | 接管前确认停车、检查 Uno 能力；修正实际 GET_CONFIG 裸 DONE 回报导致接管超时；单控制者和递增序号；方向与声音续期；故障退出；从遥控交接到指定路线节点。 |
| route_editor.h（新增） | 自定义标签顺序、停车门禁、独立 NVS 小记录、写入结果及请求回读、重启恢复；保存后两处续巡列表同步。 |
| policy.cpp | 增加指定路线位置续寻；先寻找指定标签，再沿原路线继续；兼容新旧配置回报。 |
| pwm_floor.h | 遥控速度独立于自主最低 PWM，保留自主下限。 |
| signal_sequences.h（新增） | 遥控和自主复用同一声光节奏。 |
| UnoCatController.ino | 新增有本地超时的 REMOTE 运动及同向续期，保留失速计时；停止后锁定会话；配置回报增加 REMOTE_V1；版本更新为 V6.13。 |
| debug_page.html、remote-ui.js（新增） | 双路线编辑与保存入口、双续寻入口、同步标签筛选与路线位置选择；按住移动、调速、声光控制；避障、猫识别、标签识别独立卡片。 |
| generate-debug-page.mjs、debug_page.h | 将新增网页脚本打包到板载压缩页面。 |
| remote-control.test.cpp、remote-ui.test.mjs（新增） | 遥控状态机、续期、会话、交接、选择标签和网页释放行为回归。 |
| Uno/PWM/布局测试和 run-native.ps1 | 验证失速计时不被续期清零、遥控速度不被自主下限改写及卡片组织。 |
| README、esp32-host/README、猫互动状态机现状、遥控与续寻（新增）、项目日志 | 使用方式、兼容协议、回滚边界和实际验证结果。 |

大体积 Flash 备份、构建产物和原始工具输出保存在 evidence/remote-resume-20261012/，供回滚核对；不要使用 git add . 混入历史未跟踪文件。验证结果以 validation.json 和项目日志为准，实车方向、声光、断线停车及指定节点续寻待验收。

追加界面布局：电脑为 UART／巡游、摄像头与下方避障、遥控三列；手机按 UART／巡游、摄像头、遥控、避障排列。版本注释与内部回读同步更新为 0.47_SWITCH_FIX；未修改 Uno。

前向开关修复：policy.cpp 的共用判断读取总开关，覆盖标签／猫接近、复核与试探；front_switch.h 独立保存并回读开关，防止大配置写入失败导致重启丢失；更新页面文案和相关开关回归检查。完整核查见《开关核查-20261012.md》。
