SaitoTommo/CatTeasingRobot/evidence/cat-flow-20261006/inventory-042.txt

✔ current inventory covers literal state entrances and conditional scan state (1.5095ms)
✔ Uno enum states are covered separately from ESP and baseline (1.5578ms)
ℹ tests 2
ℹ suites 0
ℹ pass 2
ℹ fail 0
ℹ cancelled 0
ℹ skipped 0
ℹ todo 0
ℹ duration_ms 87.3809
