SaitoTommo/CatTeasingRobot/SOFT_UART_WIRING.md

# D13 软件 UART 与接收窗口（2026-10-13）

当前源码：Uno V6.14 / ESP 0.50。ESP D6/GPIO43 → 电平转换 → Uno **D13**；
Uno D1/TX → 电平转换 → ESP D7/GPIO44，57600/8N1、共地。
蜂鸣器已拆除；原蜂鸣器输出改到 D12，默认关闭，留作备用。
Uno USB 仍使用 D0/D1，不与 ESP 接收线混接。烧录 Uno 时暂时断开 D1 外部线，
烧录结束后恢复 D1 回传线。回滚 V6.13 时需将接收线移回 D12。

Uno 在 TX 已发送完、没有待发遥测时主动发带 CRC 的 `RX <window>*HH`。
普通后台输出暂停最多 60 ms；传感器、编码器、运动期限和停车检查继续执行。
ESP 等待 3 ms 后，用一次性编号发送 `R <window> C <id> <command>*HH`；
CRC 覆盖整个封装。ESP 为串口传输预留时间，只使用接收后的 45 ms 预算。
用过、过期或被安全事件打断的窗口不会执行普通命令；半包超时清理。
未带窗口的 ESP 指令只有 STOP 可以执行，紧急 STOP 和重试不等待窗口。
USB 命令和 SIM_UNO 保留原协议。旧 Uno 不会发 RX，故两端必须配套升级。

日志：`UART_AVAILABLE` 表示许可收到；`UART_WINDOW_TX` 是实际封装发送；
`AK` / `TB` / `DONE` 才是接收确认及遥测结果。
许可和发送都有而无 AK，缩小问题到命令链路，不能单独证明软件 RX 损坏。
旧 H 心跳已由短 RX 信号替换；M 内存诊断及详细命令诊断仍保留。
板载 L 灯连接 D13，可能随串口输入变化，不能用它判定 RX 正常。

以下为 2026-10-02 至 2026-10-03 的历史分配及验收记录，不作为当前接线依据。

## 历史：D12 软件 UART 与辅助输出迁移

本文件描述2026-10-02的新分配，取代旧接线表中D0、D12、D13的分配；2026-10-03 两端改为57600波特率。

| 用途 | 当前接线 / 速率 |
| --- | --- |
| ESP→Uno | ESP D6/GPIO43→LV4→HV4→Uno D12，57600/8N1 |
| Uno→ESP | Uno D1/TX→HV3→LV3→ESP D7/GPIO44，57600/8N1 |
| Uno USB | 57600，D0只保留给板载USB串口桥，不接ESP |
| 蜂鸣器控制 | Uno D13，取代原D12；沿用原蜂鸣器的合适驱动/额定供电，不把大电流负载直接接IO |
| LED | ESP XIAO板载用户灯，GPIO21、低电平点亮，无需新增外接线 |
| 转换模块参考 | LV=3.3V，HV=5V，所有GND共地；无回环短接线 |

SoftwareSerial只负责接收；返回数据仍使用硬件Serial/D1。Uno USB输入和D12输入有独立的整行缓冲，避免两个来源的字节拼成同一个命令。软件接收溢出会丢弃该帧，原CRC、会话锁、障碍物/触碰保护、运动租约和电机最小PWM120保留。

完整Uno固件版本UNO_CAT_V5.9，ESP主机版本ESP32_CAT_HOST_0.6。Uno仍负责LED指令的会话/DRY_RUN/DEBUG_IO权限与逻辑状态，将LED开/关或闪烁参数作为CRC保护事件传给ESP。ESP本地驱动板载LED，模拟模式、会话停止、复位、UART过期均关闭LED。闪烁在ESP本地定时，不按每个闪烁边沿占用串口带宽。

`DATA HW OUT`中的Uno LED引脚读数变为-1，网页显示“交由ESP输出”；蜂鸣器仍回报Uno D13电平。ESP API另提供hostLed状态，区分物理控制位置。网页灯光/蜂鸣器测试入口保留。

板载Uno的L灯也连接D13，可能随蜂鸣器控制亮灭；它不再作为独立的机器人LED。

上传Uno前暂时拔下D12、D1外部信号线并关闭串口监视器。上传后恢复新接线。不要在运行此固件时把蜂鸣器接回D12，也串口监视器使用57600，不能继续使用此前的9600参数。

验证顺序：最小D12 PING/PONG已经实机通过；完整固件还须验证真实PING/配置/遥测、LED开关/闪烁、D13蜂鸣器及传感器读数。软件串口接收期间会占用中断时间，编码器和超声波在真实运动中的性能必须实测，编译和静态检查不能替代此项。

网页0.6新增左轮/右轮各自正反转，以及“绕过全部避障”开关。只作用于手动限时 `TEST_MOTOR <leftPWM> <rightPWM> <50..2000ms> SAFE|BYPASS`：BYPASS忽略前向相机、左右超声波和触碰拦截，不伪造传感器值。会话锁、CRC、限时截止、STOP以及编码器失速检查仍有效。普通MOVE/TURN/MOTOR及自动巡游继续遵守原避障。开关不上NVS，上电、模式切换、Uno READY回报后为关闭。
