SaitoTommo/CatTeasingRobot/evidence/front-switch-escape-20261014/esp-build.txt

Debug page: 138809 -> 46185 bytes (lossless gzip)
Sketch uses 3845178 bytes (46%) of program storage space. Maximum is 8257536 bytes.
Global variables use 86032 bytes (26%) of dynamic memory, leaving 241648 bytes for local variables. Maximum is 327680 bytes.
