SaitoTommo/CatTeasingRobot/evidence/straight-balance-20261007/main-build.txt

Sketch uses 31902 bytes (98%) of program storage space. Maximum is 32256 bytes.
Global variables use 1387 bytes (67%) of dynamic memory, leaving 661 bytes for local variables. Maximum is 2048 bytes.
