SaitoTommo/CatTeasingRobot/evidence/branch-alignment-20261007/main-build.txt

Debug page: 104884 -> 36402 bytes (lossless gzip)
Sketch uses 3805410 bytes (46%) of program storage space. Maximum is 8257536 bytes.
Global variables use 85720 bytes (26%) of dynamic memory, leaving 241960 bytes for local variables. Maximum is 327680 bytes.
