SaitoTommo/CatTeasingRobot/evidence/cat-flow-20261006/build-042.txt

Debug page: 101583 -> 35266 bytes (lossless gzip)
Sketch uses 3804222 bytes (46%) of program storage space. Maximum is 8257536 bytes.
Global variables use 85712 bytes (26%) of dynamic memory, leaving 241968 bytes for local variables. Maximum is 327680 bytes.
