SaitoTommo/CatTeasingRobot/evidence/tag-recovery-20261006/esp32-build.txt

Debug page: 101155 -> 35212 bytes (lossless gzip)
Sketch uses 3802682 bytes (46%) of program storage space. Maximum is 8257536 bytes.
Global variables use 85656 bytes (26%) of dynamic memory, leaving 242024 bytes for local variables. Maximum is 327680 bytes.
