SaitoTommo/CatTeasingRobot/evidence/camera-sensor-ranges-20261006/esp-build.txt

Debug page: 97301 -> 34204 bytes (lossless gzip)
Sketch uses 3792866 bytes (45%) of program storage space. Maximum is 8257536 bytes.
Global variables use 85584 bytes (26%) of dynamic memory, leaving 242096 bytes for local variables. Maximum is 327680 bytes.
