SaitoTommo/CatTeasingRobot/evidence/active-search-rounds-final-20261005/build.txt

Debug page: 67895 -> 24514 bytes (lossless gzip)
Sketch uses 3760410 bytes (45%) of program storage space. Maximum is 8257536 bytes.
Global variables use 83688 bytes (25%) of dynamic memory, leaving 243992 bytes for local variables. Maximum is 327680 bytes.
