SaitoTommo/CatTeasingRobot/evidence/active-search-upload-20261005/build.txt

Debug page: 65688 -> 23699 bytes (lossless gzip)
Sketch uses 3756806 bytes (45%) of program storage space. Maximum is 8257536 bytes.
Global variables use 83656 bytes (25%) of dynamic memory, leaving 244024 bytes for local variables. Maximum is 327680 bytes.
