SaitoTommo/CatTeasingRobot/esp32-host/VALIDATION.md

# 本轮验证边界（2026-10-03）

Uno V6.6 / ESP 0.12 尚未上传，也未 RESET、使用界面或做运动测试。最新离线检查：实际 Uno 核心199项、实际 ESP policy.cpp 429项、实际视觉帧门槛与CRC检查通过；Node 85项通过；两端编译通过。结果和产物哈希见[离线验证报告](../离线验证结果.md)，全部既有/新增猫行为与现场待测项见[统一验收记录](../统一验收记录.md)。

下面是旧版本实测，日期/版本/口径均保留。它们不能证明新配对固件的实际识别、转角、停车或稳定性，也不能宣布历史失联/复位问题已解决。

# ESP32 实机验证记录

## D12 UART、辅助输出及直接电机测试（2026-10-02）

- 当前部署Uno V5.8、ESP V0.6：D12软件接收9600，D1硬件回传，ESP D6/D7不变；蜂鸣器D13、LED迁至ESP板载GPIO21。当前接线见`../SOFT_UART_WIRING.md`。
- 两块完整固件编译、上传校验通过。Uno程序27694 bytes（85%），静态RAM1055 bytes（51%，剩993）；ESP程序3676850 bytes（44%），静态RAM78304 bytes（23%）。固定协议字符串与元件名称放入Flash，保留全部模型、视觉模式和控制功能。
- 最小D12软件接收固件的物理双向PING/PONG已通过。完整0.5/V5.7曾收到真实PING、配置、I/O、状态及完整13行遥测；连续PING为19/20，期间用户确认手动操作/重启，不能作为不受干扰的稳定性统计。后续静态验证未完成；当前0.6/V5.8新烧录后尚待用户接回信号线验证物理链路。
- 72项Node测试通过；包括新单轮按钮参数、避障开关回读及遥测、旧观测边界/巡游/串口回归。电脑USB页面握手及波特率同步V5.8/9600，未人工浏览器验收。
- `bench-uno-validation.json`：先读取确认14项物理I/O全部OFF，再DRY_RUN验证实际Uno上的八种TEST_MOTOR动作，BYPASS在前向无效、触碰已注入按下时仍执行至MD；SAFE前进因前向无效拒绝；2001ms和锁定会话拒绝。测试未驱动真实电机，结束SESSION_STOP并恢复LIVE/DEBUG OFF。
- `bench-host-validation.json`：部署的ESP0.6在SIM_UNO验证八种正负左右PWM映射、等待SESSION_START、BYPASS不发CAMERA_FRONT、限时停止/SESSION_STOP、开关恢复。每个请求附expectedMode，服务端拒绝模式不匹配的操作，避免模拟测试误发真实动作。未驱动真实电机。结束SIM_UNO、STOPPED、benchBypass=false、cameraOk=true。
- 尚未验证：新固件D12实际运动时的编码器/超声波表现、ESP LED实际开关/闪烁、D13实际蜂鸣声、真实各轮方向与电机供电。编译、DRY_RUN与模拟映射均不证明这些物理行为。

下方为此前版本的历史记录，旧波特率和接线不可作为当前接线依据。

日期：2026-09-30，设备：用户指定 COM11，esptool 确认 ESP32-S3 revision v0.2、8MB PSRAM。

## 已验证

- 原网页及新增协议/路线测试共 65 项通过。
- 集成板载视觉、状态机、HTTP 流的版本编译通过，程序约 3.66MB，占最大应用分区 44%。
- COM11 烧录完成，Flash 校验通过。
- 实际启动日志：`CAMERA init=0 psram=8388608`，证明本次摄像头初始化成功。
- 栈修复后的最终源码编译、COM11 烧录及 Flash 校验通过：程序 3,659,430 bytes（44%），静态 RAM 77,832 bytes（23%）。
- `serial-smoke.py` 实机通过：USB JSON、六节点含重复 ID 的路线、非法路线拒绝、CRC 错误拒绝、标签目标推进、反馈缺失停车、摄像头持续出帧（106 → 124）。结果见 `serial-smoke-result.json`。
- `vision-smoke.py` 连续约 77 秒通过：仅预览 35 秒、标签 12 秒、猫 15 秒、双识别 15 秒。帧序号 489 → 873，三个识别模式均返回板载观测；本次末帧推理耗时分别约 187/222/399ms。没有测试实物检出正确率或长时间温升。结束后已关闭推理。

## 已发现与修复

- 中文构建路径令 ESP32 链接器输出失败：改用英文临时构建路径。
- 初版运行栈溢出：日志为 `Stack canary watchpoint triggered (loopTask)`。addr2line 映射到 `readLines()`、`loop()`，两个 4096-byte 局部 Input 缓冲占用默认任务栈。移出栈、控制栈改成 16KB；类型移入头文件以避开 Arduino 自动函数声明顺序。
- 初版默认同时运行两种视觉推理：改为上电仅预览约 5fps，按需选择标签/猫/两者，每次检测后休息至少 1.5 秒。未测得温度，不能将此前重启归因于过热。
- 灯熄灭观察：官方资料明确未接电池时红色充电灯约 30 秒熄灭是正常状态。未确认用户观察的具体灯、USB 断连或电源异常。

## 当前未验收

- 用户要求隔离 Wi-Fi：已烧录 `WiFiMinimal` 替代完整应用，只运行 STA 和串口；40 秒监测仍未连接，原因码 201（NO_AP_FOUND）。此为接天线前的历史检查，完整固件现已恢复。

- 已按用户提供的笔记本热点名称/密码经 COM11 写入开发板 NVS。35 秒连接检查仍为 `stationIP=0.0.0.0`，当时未连接成功；用户接好天线后，完整固件已获得 192.168.137.22。凭据不存入仓库。
- 电脑网页启动脚本用端口 18766 验证了新建服务、页面与模块可访问、已有服务复用；随后仅结束该测试创建的 PID。双击 BAT 的浏览器操作未做人工验收。

- 独立 AP 曾两次未连接成功，当时未接天线，两次均恢复原 Wi-Fi；接天线后本次验证使用笔记本热点，未再次切换到独立 AP。
- 栈修复后短时运行已通过；识别任务长期稳定性、温度与电源情况未测量。
- 猫及贴纸真实识别质量由用户验证，当前没有实物正确率结论。
- Uno UART 接线、物理电机/编码器、几何标定和整机巡游/互动未验收。JavaScript 下位机测试不能替代这些检查。
- 单目前向地面外观检查是原型，未验证实车安全，不能当成可靠深度测量。

脚本：`serial-smoke.py` 仅在 SIM_UNO 测 USB、路线、CRC 和反馈缺失停车；`vision-smoke.py` 测任务运行而非识别准确率；`http-smoke.py` 验证 JPEG 和多帧 MJPEG；`test-hotspot.ps1` 会暂时切换 Wi-Fi，等待 DHCP，finally 恢复原连接。电脑 HTTP 检查绕过系统代理。

## 接好天线后恢复完整固件（2026-10-01）

- 最新完整固件重新编译、COM11 烧录、Flash 校验通过。用户释放串口监视器后烧录成功。NVS 的热点配置自动回读，取得 `192.168.137.22`，摄像头初始化成功。
- 初始仅预览：HTTP 页面、状态接口、模拟 Uno 注入及 SIM_RX 日志可见、JPEG 解码和连续五帧 320×240 MJPEG 通过，约 1.89 秒完成。
- 联网状态重跑串口协议检查通过；摄像头帧序号 282 → 300。实际 Uno UART/电机仍未连接验收。
- 标签模式同时 HTTP 视频通过。首次猫模式 HTTP 子进程报失败，早期脚本未输出 stderr，原因未定位；改进错误输出后 CAT、BOTH 各约 15 秒复测通过，再以 BOTH 连续三次 HTTP 检查全部通过，每次解码五帧。末次约 2.78 秒；不据此声称长期稳定。
- 猫和双识别末帧延迟约 222ms、382ms；实际猫与贴纸检出效果仍由用户验收。
- 电脑 ESP32 页面通过 USB 状态自动填写 stationIP 的视频地址和调试链接，保留手工修改的视频地址；JS 语法检查和两项 ESP32 协议测试通过，浏览器交互未人工验收。
- 结束状态由 HTTP 确认：`ESP32_CAT_HOST_0.3`、`phase=IDLE`、`visionMode=OFF`、`cameraOk=true`。启动和串口工具的打开/关闭可能重置板子，运行时 IP 应以当前状态为准。

结果文件：`http-smoke-result.json`、`serial-smoke-result.json`、`vision-smoke-result.json`；相机现场快照仅保留本地，不提交 Git。

## 完整功能固件体积优化与烧录（2026-10-01）

- 用户提供的 IDE 日志使用 `PartitionScheme=default_8MB,PSRAM=disabled`，应用槽上限 3,342,336 bytes，固件 3,656,580 bytes，导致 109% 超限。实际 COM11 为 ESP32-S3 revision v0.2，烧录器确认内置 8MiB PSRAM；正确构建采用 `PSRAM=opi,PartitionScheme=max_app_8MB`（应用分区 8,257,536 bytes）。
- 完整体积优化尝试：全局 LTO 首先因 SDK 的 `-fno-lto` 导致插件问题，移除临时参数副本中的该开关后，又触发 SDK 核心 Xtensa 重定位错误。保留普通 SDK 核心/库、只链接优化应用对象可成功，但应用镜像仅从 3,661,696 减至 3,661,424 bytes（272 bytes）；未部署该试验镜像。
- 最终使用可重复的普通工具链和无损 gzip 内置网页：HTML 从 6,802 减至 3,574 bytes，浏览器自动解压；猫模型 SHA-256 校验保持原值。页面、识别模型、全部 tag36h11 ID、状态机、通信与调参功能保留。网页源现为 `ESP32CatHost/debug_page.html`，`generate-debug-page.mjs` 生成头文件并检查逐字节往返一致。
- 最终编译：程序 3,658,366 bytes（44%），静态 RAM 77,832 bytes（23%）；相较调速界面版本减少 3,180 bytes。`build.ps1 -Upload -Port COM11` 完成四段烧录及 Hash 校验，未写 NVS 区。应用镜像实际 3,658,512 bytes，区别来自镜像头和对齐。
- USB 实机协议检查通过：JSON、包含重复 ID 的路线、非法路线拒绝、CRC 拒绝、目标推进、缺失反馈停车、摄像头持续出帧。测试恢复烧录前路线；HTTP 逐项比较确认烧录前保存的全部策略/标定配置未变化。
- 实机确认识别后等待 200ms，新巡逻参数 45/30。通过 HTTP 保存为 46/31、回读验证后恢复 45/30。板载 HTTP gzip 页面解压后与原 HTML 字节完全一致，两种巡逻转速控件仍存在；浏览器手工点击未验收。
- 各模式约 12 秒采样，按不重复的观测 `at` 时间戳计算：标签 25 帧、2.115Hz、平均识别 271.2ms；猫 26 帧、2.211Hz、平均识别 250.2ms；双识别 17 帧、1.494Hz、平均识别 468.7ms。三种模式均通过 JPEG 和连续五帧 MJPEG 解码；双识别采样时 PSRAM 最低 6,428,556 bytes。此为短时运行验证，不是长期稳定性、温升、识别准确率或实车运动验收。
- 结束状态通过 HTTP 确认：`ESP32_CAT_HOST_0.3`、`phase=IDLE`、`mode=SIM_UNO`、`visionMode=OFF`、`cameraOk=true`、`stationIP=192.168.137.155`。IP 仍应以运行时状态为准。

新增结果：`vision-fast-smoke-result.json`、`upload-verification-result.json`；更新 `serial-smoke-result.json` 和 `http-smoke-result.json`。运行原始日志仍保留在本地 vendor 目录。AprilTag 纠错设置保持 0，本次没有启用纠错。
