SaitoTommo/CatTeasingRobot/evidence/front-approach-priority-20261007/node-tests.txt

✔ attack input stays in the same contact until the cat physically leaves (2.1048ms)
✔ all sensors publish atomically only after a complete checked batch (5.5852ms)
✔ bad CRC, incomplete, wrong id, conflicting duplicate, timeout and missing CRC never refresh rows (1.4512ms)
✔ search allows the second turn and stops at two full turns (2.5129ms)
✔ hunting branch draws only prey, slow escape, or fast escape (1.4461ms)
✔ a touch counted during an active hunting response does not draw again (0.9777ms)
✔ interaction branch is sampled once and exploration cycles through distinct sound-light patterns (2.1006ms)
✔ cat-initiated follow-up is independent from robot search probabilities (0.6763ms)
✔ cat follow-up runs once and inactivity returns to patrol (0.5496ms)
✔ robot-initiated far and near probabilities and cooldown remain separate (0.7348ms)
✔ old browser settings migrate and each probability group sums to 100 (1.0689ms)
✔ ending outcome has its own three probabilities (0.7993ms)
✔ prey endings are chosen on a caught touch; idle endings only resume patrol (1.0862ms)
✔ seeing a cat does not interrupt patrol; HTTP triggers search even outside camera (0.3158ms)
✔ escape uses visible bearing or measured contact side (0.9756ms)
✔ travel requires a current forward measurement after the turn (0.1557ms)
✔ every processed frame draws its own box and negatives clear the preceding box (6.1458ms)
✔ preview visibility and live video choice are local and leave status updates active (1.991ms)
✔ box toggle repaints a matched frame without starting inference or motion (1.5984ms)
✔ timing history includes distinct inferences, deduplicates, and resets on reboot (1.5123ms)
✔ a late decoded JPEG cannot restore the preview after a device reboot (8.723ms)
✔ camera settings revision rejects a late old JPEG and clears stale detection even when uptime grows (2.5913ms)
✔ primary panels are sensor/control/camera, settings follow, profiling is last (1.72ms)
✔ preview skips absent and unchanged frames, pauses offline, and resumes on a new result (1.9433ms)
✔ a JPEG finishing after a lost state connection is discarded (2.7583ms)
✔ front parameters explain effects, retain drafts and save only after checked parking and board readback (5.1915ms)
✔ front parameter failure does not claim persistence and reboot reloads board values (1.1ms)
✔ tag recovery tuning keeps drafts, gates saves on confirmed stop and waits for board readback (3.3518ms)
✔ camera tuning preserves draft, requires confirmed parking and reports actual matching request readback (4.7952ms)
✔ camera epoch and boot changes reset drafts and current diagnostic log cursor independently of uptime (0.6973ms)
✔ OV3660 full-width gain ceiling uses board-provided limits instead of OV2640 enum limits (1.2864ms)
✔ state, flow and preview reads share one in-flight request and release it after errors (0.7925ms)
✔ one closed keep-alive connection is retried before clearing live readings (0.4574ms)
✔ failed state polls disable controls, release video, back off and recover on successful readback (10.1162ms)
✔ incremental logs retain history, deduplicate replies, cap memory and reset after a reboot (1.2567ms)
✔ CAT_CHECK frame limit is saved and read back in both cat panels, rejecting fractional counts (3.1626ms)
✔ legacy cat centering is disabled and cannot issue a save (0.4295ms)
✔ horizontal FOV conversion uses perspective projection rather than a linear angle percentage (0.2303ms)
✔ cat and tag centering save independently, with tag draft and FOV target preserved (13.2605ms)
✔ active cat search probabilities validate groups, preserve drafts and require board readback (2.3853ms)
✔ brief tag alignment remains visible as history while current state is approach (0.5171ms)
✔ cat settings preserve drafts, validate relative widths and round trip every timeout (2.2454ms)
✔ cat progress names chase and displays separate rounds and time (0.3481ms)
✔ cat save failure is reported from board logs rather than assumed successful (1.0566ms)
✔ scan wait preserves drafts, saves safely and extends timeout only when needed (1.5468ms)
✔ minimum PWM saves an integer, shows actual board readback and retains a draft while polling (1.0599ms)
✔ minimum PWM is locked until confirmed stop, while debugging, and on unsupported firmware (0.4884ms)
✔ policy display distinguishes requested PWM from the floored command (0.2766ms)
✔ zero current command never displays historical PWM and cat failure survives patrol (0.2795ms)
✔ parking width is read back, percent converted and locked until STOP confirmation (0.4659ms)
✔ Arduino panel accepts a 1 cm threshold without rounding it to the old minimum (0.331ms)
✔ an unconfirmed stop is visible even when the policy phase says STOPPED (0.4001ms)
✔ patrol failure remains visible even after the rolling log no longer contains it (0.3074ms)
✔ front avoidance switch uses saved board state and is locked while running (0.9761ms)
✔ user route preserves count, order and repeated IDs when saved (0.7347ms)
✔ diagnostic log decodes hexadecimal heartbeat and reset breadcrumbs (0.894ms)
✔ page reports ESP active-low LED control separately from Uno buzzer (0.4995ms)
✔ compiled page bundles the shared telemetry parser without imports (0.1991ms)
✔ wheel controls send signed-test choices with validated duration and PWM (0.7456ms)
✔ bypass button uses board readback and visibly restores avoidance (0.7827ms)
✔ mode selection uses board readback; physical reception is separately reported (0.5084ms)
✔ partial telemetry does not refresh old sensor rows and changing mode clears configuration (1.0498ms)
✔ exploration shows independent light and sound combination and playback state (0.4426ms)
✔ local ESP LED controls work without Uno link or stop confirmation (1.4061ms)
✔ lightweight flow updates preserve transient history against a slower old telemetry reply (1ms)
✔ invitation controls round-trip durations and widths and show fresh cat evidence (2.9995ms)
✔ tag stopped attempts save integer config and wait for board readback (3.8165ms)
✔ shared target recovery shows cat side, actual search direction and remaining budget (0.3687ms)
✔ durable history exports all 1200 records after reload, despite 500-row display and ESP reboot (24.2535ms)
✔ captured data is copied before page merge; duplicate responses and reconnects do not erase logs (1.1916ms)
✔ missed ring-buffer sequences are marked and separate device/boot identities never collide (1.2443ms)
✔ quota failures preserve pending records for full export and retry without duplicate durable rows (1.0898ms)
✔ a read error rejects export instead of reporting a partial download as complete (2.2728ms)
✔ camera revision changes are recorded with actual and saved parameters (1.1732ms)
✔ export serializes concurrent ingestion and an export error does not poison later saves (1.1449ms)
✔ latency statistics handle even medians, outliers and nearest-rank P95 (2.3455ms)
✔ history deduplicates repeated replies and exposes missing records and epoch reset (0.8973ms)
✔ zero cooldown is sent unchanged without a motion command (0.3939ms)
✔ overlay uses metadata paired with the JPEG and clears a prior cat on a negative frame (1.6344ms)
✔ widths use percentages and only current route target, independent of policy acceptance (5.7714ms)
✔ negative, invalid, stale, missing, and offline measurements are explicit (2.1246ms)
✔ calibration needs a complete reference and a frame captured after calibration (1.4674ms)
✔ camera invalidation, reboot and simulation do not misrepresent old physical results (1.23ms)
✔ board reports calibration capture barrier and UI bundle is installed (3.7025ms)
✔ configuration save applies RAM before NVS and generated page contains measurement code (11.5939ms)
✔ SIM_UNO keeps physical camera widths and ground judgment visible (1.3146ms)
✔ physical negatives and stale frames cannot be replaced by simulated detections (1.3039ms)
✔ front controls explain unconfirmed stopping and send no rejected operations (2.082ms)
✔ toggle waits for readback and calibration failure is shown inline (1.6995ms)
✔ calibration success requires new board timestamp and offline disables both buttons (1.4357ms)
✔ HTTP send failure does not leave controls indefinitely pending (10.084ms)
✔ route preserves arbitrary ordered IDs and repeat visits (2.1005ms)
✔ host command is accepted only after exact CRC check (0.6818ms)
✔ complete TB telemetry publishes all 13 rows, injected sources and coherent timestamps (3.9095ms)
✔ scan stops before VQ, rejects stale generation, finishes once and deduplicates retransmission (3.3418ms)
✔ invalid CRC cannot start motion; scan bounds match firmware and touch aborts (0.7571ms)
✔ mean wheel scan carries halves across asymmetric stopped steps and retries (0.3488ms)
✔ extended stopped window config is accepted and still bounded (1.5945ms)
✔ remote LED telemetry does not read the reassigned Uno D13 as LED (1.8424ms)
✔ motor telemetry separates received command from disabled physical output (0.416ms)
✔ encoder count, raw input, RPM and physical or virtual source remain distinct (0.2873ms)
✔ disabled and invalid physical sonar never becomes a plausible measured distance (0.3286ms)
✔ a partial or malformed frame cannot refresh an older sensor row (0.3992ms)
✔ touch and auxiliary output rows preserve logical and physical states (0.2624ms)
✔ polling never stacks requests and missing responses trigger backoff (0.324ms)
✔ lost motion start is recovered from the exported log's terminal reply (1.1949ms)
✔ ACK recovery and later start preserve one starting pose; stale replies cannot replace motion (0.378ms)
✔ short checked commands reduce bytes while preserving complete arguments (1.2705ms)
✔ critical short replies expand only when intact; missing digits and checksum are rejected (0.5209ms)
✔ card telemetry is throttled to 250 ms without extra motion status polling (0.1627ms)
✔ movement feedback is checked independently of the slow card telemetry (1.1568ms)
✔ staggered encoder edges cannot flip straight heading or rewind a turn (0.3117ms)
✔ continuous motor needs no renewal; a new command replaces its ID and STOP ends it (2.0827ms)
✔ renewal ACK cannot replace the current pose and pulse origin (0.1846ms)
✔ out-of-view and occluded objects do not expose bearing or distance (2.6458ms)
✔ rays measure nearest surfaces and penetration measures zero (0.8536ms)
✔ wheel observations track rotation instead of reading scene heading (2.3742ms)
✔ HTTP can initiate search but camera detection alone cannot (1.0469ms)
✔ decision and navigation code cannot access world geometry (13.9964ms)
✔ page controls referenced by the controller exist in the actual HTML (6.6796ms)
✔ injected side measurements expire instead of persisting indefinitely (0.6153ms)
✔ page binds the HTTP button and auto tick has no visual interaction trigger (3.4005ms)
✔ moving an unseen rear cat cannot confirm departure or change captured-wait decisions (3.5777ms)
✔ touch release, loss of sight and invalid vision never count as departure (0.3058ms)
✔ enabled physical sonar uses actual measured range, never the simulated clearance (0.3863ms)
✔ unknown gates, partial physical sonar and injected rows cannot masquerade as physical input (0.1939ms)
✔ explicit virtual input uses the simulated sensor; disabled input remains unknown (0.5132ms)
✔ real front input is current host data; no camera input stays unknown (0.3667ms)
✔ source selection and captured-wait logic never import scene geometry or cat scripts (11.1461ms)
✔ patrol moves in bounded steps from current range (2.7311ms)
✔ obstruction requests real scanning, invalid range stops (0.2913ms)
✔ continuous patrol can reach its stop point without 12 cm segments and still respects front clearance (0.3487ms)
✔ invalid and expired sonar permit motion; only a fresh reading below 1 cm stops it (4.7568ms)
✔ simulated camera detects distant cat and route tag within its viewing angle (0.5829ms)
✔ Uno leaves forward camera gating to the host and each sonar protects its own turn (0.4774ms)
✔ both side sonars default to 1 cm and have separate adjustable limits (0.4044ms)
✔ signed rotation can turn left and still obey left sonar (0.2498ms)
✔ one continuous contact in the same sensor region emits one press until release (0.6078ms)
✔ moving from a side sensor to an uninstrumented rear region releases contact without waiting for body separation (1.0955ms)
✔ the installed rear touch sensor is enabled by default and can be explicitly disabled for a fixture (0.2596ms)
✔ rear touch release is observable but further hidden movement produces no additional signal (0.316ms)
✔ scan adapter preserves keys and rejects unprotected or damaged replies (1.9575ms)
✔ maximum scan fields fit the real Uno envelope, line and word limits (0.9336ms)
✔ empty board sends no sensor traffic while idle and refreshes measured ranges during travel (1.4896ms)
✔ turns avoid camera traffic but side safety changes are sent promptly (0.2802ms)
✔ new motion after SESSION_STOP restores cleared sensor inputs (0.1297ms)
✔ mixed hardware testing never overwrites an enabled physical sonar (0.979ms)
✔ mood_alert queue accepts an HTTP find-cat command and hands it out once (142.206ms)
✔ the HTTP server serves every local module imported by the browser (154.392ms)
✔ state and writes serialize through body completion, and failed requests release the queue (1.7359ms)
✔ queued vision is replaced by the newest frame while telemetry and commands remain intact (0.3456ms)
✔ each touch area can choose prey or escape within the hunting branch (2.5464ms)
✔ branch choice separates hunting motion from sound-light exploration (5654.4737ms)
✔ current inventory covers literal state entrances and conditional scan state (2.9545ms)
✔ Uno enum states are covered separately from ESP and baseline (1.2789ms)
ℹ tests 155
ℹ suites 0
ℹ pass 155
ℹ fail 0
ℹ cancelled 0
ℹ skipped 0
ℹ todo 0
ℹ duration_ms 5953.7277
