SaitoTommo/CatTeasingRobot/evidence/tag-recovery-20261006/node-tests.txt

✔ every processed frame draws its own box and negatives clear the preceding box (2.9763ms)
✔ preview visibility and live video choice are local and leave status updates active (0.8474ms)
✔ box toggle repaints a matched frame without starting inference or motion (0.7537ms)
✔ timing history includes distinct inferences, deduplicates, and resets on reboot (0.6541ms)
✔ a late decoded JPEG cannot restore the preview after a device reboot (3.8239ms)
✔ camera settings revision rejects a late old JPEG and clears stale detection even when uptime grows (1.0381ms)
✔ primary panels are sensor/control/camera, settings follow, profiling is last (0.7882ms)
✔ preview skips absent and unchanged frames, pauses offline, and resumes on a new result (0.8253ms)
✔ a JPEG finishing after a lost state connection is discarded (1.021ms)
✔ tag recovery tuning keeps drafts, gates saves on confirmed stop and waits for board readback (3.582ms)
✔ camera tuning preserves draft, requires confirmed parking and reports actual matching request readback (2.1367ms)
✔ camera epoch and boot changes reset drafts and current diagnostic log cursor independently of uptime (0.3077ms)
✔ OV3660 full-width gain ceiling uses board-provided limits instead of OV2640 enum limits (0.4526ms)
✔ state, flow and preview reads share one in-flight request and release it after errors (0.3854ms)
✔ one closed keep-alive connection is retried before clearing live readings (0.2274ms)
✔ failed state polls disable controls, release video, back off and recover on successful readback (4.733ms)
✔ incremental logs retain history, deduplicate replies, cap memory and reset after a reboot (0.4653ms)
✔ CAT_CHECK frame limit is saved and read back in both cat panels, rejecting fractional counts (1.3992ms)
✔ legacy cat centering is disabled and cannot issue a save (0.257ms)
✔ horizontal FOV conversion uses perspective projection rather than a linear angle percentage (0.1541ms)
✔ cat and tag centering save independently, with tag draft and FOV target preserved (0.4278ms)
✔ active cat search probabilities validate groups, preserve drafts and require board readback (0.8285ms)
✔ brief tag alignment remains visible as history while current state is approach (0.203ms)
✔ cat settings preserve drafts, validate relative widths and round trip every timeout (1.0799ms)
✔ cat progress names chase and displays separate rounds and time (0.1497ms)
✔ cat save failure is reported from board logs rather than assumed successful (0.4422ms)
✔ scan wait preserves drafts, saves safely and extends timeout only when needed (1.2119ms)
✔ minimum PWM saves an integer, shows actual board readback and retains a draft while polling (0.4407ms)
✔ minimum PWM is locked until confirmed stop, while debugging, and on unsupported firmware (0.1955ms)
✔ policy display distinguishes requested PWM from the floored command (0.1001ms)
✔ zero current command never displays historical PWM and cat failure survives patrol (0.1379ms)
✔ parking width is read back, percent converted and locked until STOP confirmation (0.2463ms)
✔ Arduino panel accepts a 1 cm threshold without rounding it to the old minimum (0.1822ms)
✔ an unconfirmed stop is visible even when the policy phase says STOPPED (0.2136ms)
✔ patrol failure remains visible even after the rolling log no longer contains it (0.1851ms)
✔ front avoidance switch uses saved board state and is locked while running (0.3692ms)
✔ user route preserves count, order and repeated IDs when saved (0.205ms)
✔ diagnostic log decodes hexadecimal heartbeat and reset breadcrumbs (0.2231ms)
✔ page reports ESP active-low LED control separately from Uno buzzer (0.1506ms)
✔ compiled page bundles the shared telemetry parser without imports (0.0845ms)
✔ wheel controls send signed-test choices with validated duration and PWM (0.2225ms)
✔ bypass button uses board readback and visibly restores avoidance (0.3462ms)
✔ mode selection uses board readback; physical reception is separately reported (0.1596ms)
✔ partial telemetry does not refresh old sensor rows and changing mode clears configuration (0.4158ms)
✔ exploration shows independent light and sound combination and playback state (0.1355ms)
✔ local ESP LED controls work without Uno link or stop confirmation (0.6534ms)
✔ lightweight flow updates preserve transient history against a slower old telemetry reply (0.2278ms)
✔ invitation controls round-trip durations and widths and show fresh cat evidence (0.5625ms)
✔ tag stopped attempts save integer config and wait for board readback (0.2883ms)
✔ durable history exports all 1200 records after reload, despite 500-row display and ESP reboot (11.4243ms)
✔ captured data is copied before page merge; duplicate responses and reconnects do not erase logs (0.5567ms)
✔ missed ring-buffer sequences are marked and separate device/boot identities never collide (0.4795ms)
✔ quota failures preserve pending records for full export and retry without duplicate durable rows (0.4997ms)
✔ a read error rejects export instead of reporting a partial download as complete (1.2038ms)
✔ camera revision changes are recorded with actual and saved parameters (0.2743ms)
✔ export serializes concurrent ingestion and an export error does not poison later saves (0.4425ms)
✔ latency statistics handle even medians, outliers and nearest-rank P95 (1.2089ms)
✔ history deduplicates repeated replies and exposes missing records and epoch reset (0.4428ms)
✔ zero cooldown is sent unchanged without a motion command (0.1819ms)
✔ overlay uses metadata paired with the JPEG and clears a prior cat on a negative frame (0.949ms)
✔ current inventory covers literal state entrances and conditional scan state (1.1858ms)
✔ Uno enum states are covered separately from ESP and baseline (1.2589ms)
ℹ tests 62
ℹ suites 0
ℹ pass 62
ℹ fail 0
ℹ cancelled 0
ℹ skipped 0
ℹ todo 0
ℹ duration_ms 118.5381
