SaitoTommo/CatTeasingRobot/evidence/camera-sensor-ranges-20261006/node-tests.txt

✔ every processed frame draws its own box and negatives clear the preceding box (2.7572ms)
✔ preview visibility and live video choice are local and leave status updates active (0.8465ms)
✔ box toggle repaints a matched frame without starting inference or motion (0.729ms)
✔ timing history includes distinct inferences, deduplicates, and resets on reboot (0.6305ms)
✔ a late decoded JPEG cannot restore the preview after a device reboot (3.8899ms)
✔ camera settings revision rejects a late old JPEG and clears stale detection even when uptime grows (1.0206ms)
✔ primary panels are sensor/control/camera, settings follow, profiling is last (0.7901ms)
✔ preview skips absent and unchanged frames, pauses offline, and resumes on a new result (0.7868ms)
✔ a JPEG finishing after a lost state connection is discarded (1.0439ms)
✔ camera tuning preserves draft, requires confirmed parking and reports actual matching request readback (2.6619ms)
✔ camera epoch and boot changes reset drafts and current diagnostic log cursor independently of uptime (0.6221ms)
✔ OV3660 full-width gain ceiling uses board-provided limits instead of OV2640 enum limits (0.4639ms)
✔ state, flow and preview reads share one in-flight request and release it after errors (0.5375ms)
✔ one closed keep-alive connection is retried before clearing live readings (0.3744ms)
✔ failed state polls disable controls, release video, back off and recover on successful readback (3.94ms)
✔ incremental logs retain history, deduplicate replies, cap memory and reset after a reboot (0.4357ms)
✔ CAT_CHECK frame limit is saved and read back in both cat panels, rejecting fractional counts (1.45ms)
✔ legacy cat centering is disabled and cannot issue a save (0.2746ms)
✔ horizontal FOV conversion uses perspective projection rather than a linear angle percentage (0.1934ms)
✔ cat and tag centering save independently, with tag draft and FOV target preserved (0.4248ms)
✔ active cat search probabilities validate groups, preserve drafts and require board readback (0.9205ms)
✔ brief tag alignment remains visible as history while current state is approach (0.2227ms)
✔ cat settings preserve drafts, validate relative widths and round trip every timeout (1.0807ms)
✔ cat progress names chase and displays separate rounds and time (0.1578ms)
✔ cat save failure is reported from board logs rather than assumed successful (0.4227ms)
✔ scan wait preserves drafts, saves safely and extends timeout only when needed (1.1657ms)
✔ minimum PWM saves an integer, shows actual board readback and retains a draft while polling (0.3993ms)
✔ minimum PWM is locked until confirmed stop, while debugging, and on unsupported firmware (0.1645ms)
✔ policy display distinguishes requested PWM from the floored command (0.1054ms)
✔ zero current command never displays historical PWM and cat failure survives patrol (0.134ms)
✔ parking width is read back, percent converted and locked until STOP confirmation (0.2257ms)
✔ Arduino panel accepts a 1 cm threshold without rounding it to the old minimum (0.1479ms)
✔ an unconfirmed stop is visible even when the policy phase says STOPPED (0.1924ms)
✔ patrol failure remains visible even after the rolling log no longer contains it (0.1688ms)
✔ front avoidance switch uses saved board state and is locked while running (0.3827ms)
✔ user route preserves count, order and repeated IDs when saved (0.212ms)
✔ diagnostic log decodes hexadecimal heartbeat and reset breadcrumbs (0.2264ms)
✔ page reports ESP active-low LED control separately from Uno buzzer (0.1476ms)
✔ compiled page bundles the shared telemetry parser without imports (0.0833ms)
✔ wheel controls send signed-test choices with validated duration and PWM (0.2757ms)
✔ bypass button uses board readback and visibly restores avoidance (0.2724ms)
✔ mode selection uses board readback; physical reception is separately reported (0.1242ms)
✔ partial telemetry does not refresh old sensor rows and changing mode clears configuration (0.4152ms)
✔ exploration shows independent light and sound combination and playback state (0.1017ms)
✔ local ESP LED controls work without Uno link or stop confirmation (0.6518ms)
✔ lightweight flow updates preserve transient history against a slower old telemetry reply (0.2171ms)
✔ invitation controls round-trip durations and widths and show fresh cat evidence (0.619ms)
✔ tag stopped attempts save integer config and wait for board readback (0.3569ms)
✔ durable history exports all 1200 records after reload, despite 500-row display and ESP reboot (9.9899ms)
✔ captured data is copied before page merge; duplicate responses and reconnects do not erase logs (0.472ms)
✔ missed ring-buffer sequences are marked and separate device/boot identities never collide (0.4706ms)
✔ quota failures preserve pending records for full export and retry without duplicate durable rows (0.4656ms)
✔ a read error rejects export instead of reporting a partial download as complete (0.8371ms)
✔ camera revision changes are recorded with actual and saved parameters (0.2643ms)
✔ export serializes concurrent ingestion and an export error does not poison later saves (0.4418ms)
✔ latency statistics handle even medians, outliers and nearest-rank P95 (1.111ms)
✔ history deduplicates repeated replies and exposes missing records and epoch reset (0.4465ms)
✔ zero cooldown is sent unchanged without a motion command (0.1749ms)
✔ overlay uses metadata paired with the JPEG and clears a prior cat on a negative frame (0.8133ms)
✔ current inventory covers literal state entrances and conditional scan state (1.2333ms)
✔ Uno enum states are covered separately from ESP and baseline (1.328ms)
ℹ tests 61
ℹ suites 0
ℹ pass 61
ℹ fail 0
ℹ cancelled 0
ℹ skipped 0
ℹ todo 0
ℹ duration_ms 112.0081
