SaitoTommo/CatTeasingRobot/项目日志_问题分类版.md

# Uno × ESP32 猫互动机器人：完整问题分类与能力成长日志

整理日期：2026-10-13（Europe/Berlin）。覆盖 [原始项目日志](项目日志.md) 全部内容，事件从 2026-09-30 至 2026-10-13，含原日志补记的更早历史证据。原始日志保留按时间记录；本文件按问题领域重排，供复盘、讲述与能力总结使用。

阅读顺序：先看主题导航与故事线，再进入各章“发展脉络／能力提炼”，需要具体时间、版本、配置、数据或验证结果时读后面的完整记录。每个有正文的原始二／三级标题构成一个记录单元，138 个单元全部归档，各只出现一次；跨领域问题通过关联索引定位，不重复复制。正文和证据引用保留原貌，原日志自身的复盘重复也保留，以免删掉补充口径。没有正文的父标题随来源路径保留。

历史标题中的“未上传”“实施中”“未提交”只代表当时状态，应连读同主题的后续记录；不要摘取中间阶段当作最终结论。截至最近验收：DEV 的 ESP 0.47_SWITCH_FIX／Uno V6.13 已部署，路线43→46→51，关键开发提交6ea5885；用户反馈“测试没问题”，是本轮问题的定性实测反馈。硬件根因、长期稳定性及模型质量不能因此一并标为解决。

状态口径：**已解决／用户确认**说明该具体场景有结果；**缓解／绕过**说明可以继续推进但根因未清；**已部署、待实车量化**区分软件交付与实体效果；**离线通过**仅说明合同／回归检查；**研究筛选未通过**保留负面结果；**未闭环**表示仍缺证据。协议中STOP确认不等于测量了机械刹停距离，found不等于物理到达，INVALID／UNAVAILABLE不等于无目标或无障碍。

旧归类版全文保存在 [历史快照](项目日志_问题分类版_历史快照_20261013.md)，保留原来的相对引用位置。旧文件名保留跳转入口。本次只整理文档，未改固件或操作设备。

## 主题导航与能力映射

| 主题 | 核心问题／发展方向 | 可提炼的能力（由记录支持） |
|---|---|---|
| [硬件供电与物理边界](#category-01) | 从“方向回报正常但电机不动”拆分逻辑供电、VS动力供电、输入／输出与带载条件；再区分插USB可运行、外部供电不稳、POWERON与PANIC。 | 能够围绕输入、负载、供电与观测建立排查链，撤回过早归因；避免把指示灯闪动、驱动输出状态或一次恢复当作确诊。 |
| [通信协议、事务与故障恢复](#category-02) | 单向能收但反向不通→D12软件接收绕过→乱码与带宽量化→短帧和CRC→请求编号／完整事务→扫描交接重试→确认停车与有限恢复。 | 协议建模、异步事务、幂等重试、故障降级和因果诊断；能区分在线、有效遥测、动作确认与物理结果。 |
| [运动控制、扫描与目标恢复](#category-03) | 断续巡游改持续驱动→扫描停稳与预算→区分最低PWM与请求速度→标签短暂丢失的宽限和方向恢复→双轮编码器直行平衡。 | 运动闭环、时间与状态边界、目标记忆和受限恢复；把底层走偏预防与上层丢失找回组合起来。 |
| [视觉感知、标定与避障策略](#category-04) | 标签规格／曝光→猫标签识别频率与居中→结果对应实际画面→新帧和标定→前向优先→关闭开关仍拦截的完整审查。 | 感知与策略解耦、有效性／新鲜度管理、实验口径，以及从配置到执行的全链路检查。 |
| [猫互动与自主行为设计](#category-05) | 观测盲区与未知→首次触碰和持续触碰→主动邀请与无回应收尾→取消不必要的严格居中→最多三帧确认→接近猫一次走完剩余距离与共享恢复。 | 把用户体验转为状态机条件，设计抢占、预算、动作衔接和可解释退出；在交互意图与实现细节之间找出多余要求。 |
| [网页服务、配置与可观测界面](#category-06) | 从真UART诊断入口→结果与原始画面对齐→轮询和HTTP连接预算→单HTTP共享四路视频→配置草稿／回读／实际驱动设置→跨重启浏览器历史。 | 资源约束下的网页工程、并发调度、错误反馈、数据来源与配置生命周期；让诊断状态可见且不误导用户。 |
| [遥控、路线编辑与续巡体验](#category-07) | 现场搜索失败后原地停住→人工移出困境→从指定路线位置续巡→双卡片路线编辑→配置确认兼容→小NVS路线记录→手机／电脑操作区重排。 | 围绕现场恢复设计产品闭环，区分控制模式与路线编辑，处理跨设备交接、错误确认和响应式布局。 |
| [容量、构建、部署与版本管理](#category-08) | Uno容量接近上限→正确板型与优化配置→紧凑解析→源与构建哈希→应用分区限定写入→版本回读、配置保留与回滚→分支边界。 | 受约束交付、可复现构建、版本控制、部署核验和风险界定；能守住用户授权与维护分支边界。 |
| [日志证据、复盘与验收管理](#category-09) | 160条单次快照不足→双USB持续采集→bootId与来源分组→跨重启本地历史→区分已解决／缓解／待验证→给每个指标定义分母。 | 可观测性设计、证据保全、量化复盘和验收管理；把发现、假设、代码修复、烧录和现场接受分开陈述。 |
| [前向避障研究与模型评估](#category-10) | 追查24格算法来源→论文与工程方案分开→保存旧基线→公开数据按物理场景划分→候选训练和一致性→验证筛选不合格后停止。 | 研究检索、数据集与泄漏控制、评价指标、数值一致性和停止标准；能用负面实验收窄方向而不包装成已部署提升。 |

## 可提炼的六条故事线

这些是基于日志的讲述骨架，供你改写成自己的经历。能力描述是从实际行动提炼的方向，不代表独立完成全部技术环节，也不把助手、用户现场操作和其他会话的工作合并成个人实测。

### 故事一：把“设备不动”拆成可验证的问题

起点是方向指令有回报但电机不转。先量IN／OUT与带载差异，补接VS后解决首次接线问题；遇到“不靠近猫”时则沿UI→观测→策略→DRIVE检查，确认两次都没有下发前进，原因在INVALID门禁。到0.47又识别出开关关闭仍被前向分支拦截。可以讲的成长是学会先找执行链上最后一个成功节点，再依据观测判断故障所在层。证据：记录002、134、137；不能把这三次不同原因讲成一次故障。

### 故事二：让双控制器异步协作可恢复

先用D12／D1绕过不通的D0接收路径，再量化旧9600带宽，建立短帧、CRC、编号、完整快照、扫描交接及有界恢复。0.44的裸DONE漏识别说明回归样例仍需覆盖实际协议格式。可讲结果是具体交接与解析缺口已修复，通信故障能更明确地暴露；长期电气／UART根因仍未闭环。证据：记录012、028、043、068、069、128。重点能力是协议契约和状态一致性，而非声称“永久无丢包”。

### 故事三：把机器人交互意图变成状态机

用户希望找到猫后互动，旧实现却额外要求居中、反复停车与确认。完整日志揭示多次ROTATE与预算耗尽，逐步取消不必要的居中、统一主动／触碰入口、最多三张新帧确认，再把每1cm停查改为完整剩余距离。可讲的成长是识别“实现增加的约束”，把互动意图、观测证据、抢占与退出条件写清楚。证据：记录059、075–079、095、098、114–116；完整实车互动收益缺统一前后对照，不填虚构提速比例。

### 故事四：从演示界面走向现场可用工具

网页不只是按钮：需让识别框对应真实画面、过期结果明确、连接受限时仍能看日志；随后按手机现场操控设计摄像头在上、遥控在下，提供自定义路线和指定节点续巡。最后节点缺失不是下拉框索引问题，而是保存未成功，通过独立小记录和读回闭环解决。证据：记录082、092–094、103、127–130。重点是围绕现场恢复组织信息与操作，并贯通保存、执行和反馈。

### 故事五：在资源受限设备上做可回滚交付

从Uno超Flash容量、错误构建配置，到紧凑解析和双轮平衡，再到烧录前回读、应用区写入、独立Flash核验、版本与用户配置对照。不同备份恢复不同范围，分支中的代码不能被当成板上版本。证据：记录033、102、108、120、124–125、133。重点能力是让每次改动可审查、可验证、可回滚；软件回读通过与物理漂移改善分开。

### 故事六：用研究和失败实验做技术选择

先说明24格灰度规则的实际来源与局限，再隔离分支、保存基线，用ORG按场景划分训练／验证／测试。五模型普通准确率不能证明障碍可靠性，按漏放、误报与通行约束全部未通过；ESP-DL导出也有明显量化误差，最终按用户要求停止。证据：记录135–136。可讲的是学会建立评价标准、保留负面结果、及时停止不合格方向，不能讲成“已经实现免标定智能避障”。

## 能力成长如何整理成你的总结

| 阶段 | 日志中的做法变化 | 可总结的能力 | 可用结果／边界 |
|---|---|---|---|
| 从症状描述到定位执行层 | 对照电压、命令派发、模式、反馈与真实动作 | 系统拆解与故障诊断 | 首次VS接线已解决；不同“不动”事件找到不同门禁 |
| 从单条消息到异步协议 | 编号／代次、CRC、完整快照、幂等与有界重试 | 嵌入式通信与状态一致性 | 多个解析／交接缺口有修复证据，长期链路仍待验证 |
| 从堆叠行为到清晰状态机 | 统一入口、触碰抢占、原地复核、有界目标恢复 | 行为设计与需求转译 | 简化冗余旋转和停查；实车整体收益待量化 |
| 从按钮页面到操作闭环 | 来源／帧龄／保存回读、错误反馈、遥控与续巡 | 产品体验与前后端联调 | 完整路线持久化、双场景操作布局与现场恢复入口 |
| 从“编译过了”到部署验收 | 源码／构建哈希、限定分区、回读、配置比对、回滚 | 工程交付与质量管理 | 已部署版本可追溯，不扩大为实体全功能通过 |
| 从找论文到可否决实验 | 场景隔离、宏／微指标、漏采样、量化误差与停止门槛 | 研究评估与判断力 | 否决不合格候选；未宣布虚构的避障提升 |

讲述时采用“场景与目标→现象及数据→如何定位→做了什么→得到什么结果→学到什么／剩什么”。对个人贡献，另补你现场接线、测试、提出需求、选择方案和判定效果的具体动作；对工具协助实现的部分可如实说明。下面完整记录保留版本和证据，便于抽取案例时核实。

## 01 · 硬件供电与物理边界

**发展脉络：** 从“方向回报正常但电机不动”拆分逻辑供电、VS动力供电、输入／输出与带载条件；再区分插USB可运行、外部供电不稳、POWERON与PANIC。

**目前结果与边界：** 初次IN3约4.7V、IN4约0V、带载OUT约0.27V，补接VS后用户确认能转；USB静置610.65秒只是该窗口通过。10月6日新bootId／POWERON和换线后仍复现，供电根因未闭环。

**能力提炼：** 能够围绕输入、负载、供电与观测建立排查链，撤回过早归因；避免把指示灯闪动、驱动输出状态或一次恢复当作确诊。

关联其他主题：[记录012](#record-012)、[记录110](#record-110)。

### 本章记录索引

| 记录 | 原始日志标题 |
|---|---|
| [002](#record-002) | 节点一：解决真实电机不转 |
| [011](#record-011) | 节点三：同步电机映射、起转下限和接线说明 |
| [014](#record-014) | 配套硬件讨论与待解决问题 |
| [016](#record-016) | 供电问题已经收窄，串口失联尚未闭环 |
| [109](#record-109) | 2026-10-06：ESP32 自动重启与 VUSB 供电排查（尚未解决） |

### 本章完整记录

#### 记录002 · 节点一：解决真实电机不转

来源：[原始日志](项目日志.md)，第7行；原主题：2026-09-30：从空板调试推进到真实电机测试。以下为该记录原文，状态按记录日期理解。

**现象。** 串口输入 A/B/C/D 能回报对应方向，IN3 对地约 4.7 V、IN4 约 0 V，但 OUT3/OUT4 接电机时约 0.27 V；断开电机负载后约 3.8 V。电机直接供电能够转动，Arduino 未观察到重启。

**定位与结果。** 初始接法给驱动板逻辑 5V 端子供电，电机供电端未正确供电。L298N 的逻辑供电与电机供电是两个端子。用户将逻辑 5V 与标记 12V/Vs 的电机供电端都接上后，确认电机能转。端子标记“12V”不代表本次实际输入电压已经测得为 12 V；本记录不把该标记当作测量结果，也没有确认带载供电能力。

**辅助程序。** 保存独立的 `SimpleMotorTest.ino`，串口 115200 波特：A 左正转、B 左反转、C 右正转、D 右反转、S 停止。它只使用 D4/D7、D8/D9 控制方向，用于区分接线问题与完整策略程序问题。

ENA/ENB 当时通过跳线接逻辑 5V 保持使能；这种接法不连接 D5/D6 来调速，网页显示的 PWM 指令不能当成实际调速结果。

**状态。** 用户已确认真实电机可以转动。完整车辆带载、装轮后的运动能力仍需实测。

#### 记录011 · 节点三：同步电机映射、起转下限和接线说明

来源：[原始日志](项目日志.md)，第97行；原主题：2026-10-01 至 2026-10-02：ESP32 视觉调优与真实 Uno 通信联调。以下为该记录原文，状态按记录日期理解。

两份 Uno 固件更新左右轮映射：左轮 OUT3/OUT4，IN3=D8、IN4=D9、ENB=D6；右轮 OUT1/OUT2，IN1=D4、IN2=D7、ENA=D5。将用户实测起转下限 PWM 120 写入物理输出：非零低值提升到 120，保留方向，PWM 0 仍停止，关闭的通道不输出，遥测反映调整后的输出。相关修改编译通过；当天早期记录为尚未烧录，后续完整固件已有烧录记录。

整理 [Arduino Uno 与 ESP32 引脚接线表](./Arduino_Uno与ESP32引脚接线表.md)。低速策略设定与物理电机起转下限属于不同层级，网页设定数值不能直接当作实际轮速；装轮和带载表现仍待验证。

#### 记录014 · 配套硬件讨论与待解决问题

来源：[原始日志](项目日志.md)，第117行；原主题：2026-10-01 至 2026-10-02：ESP32 视觉调优与真实 Uno 通信联调。以下为该记录原文，状态按记录日期理解。

配套讨论澄清 L298N 的 VS 电机供电与 5V 逻辑供电，6V 输入下板载 5V 输出偏低的现象，以及两节常见 18650 串联的供电方案；讨论了电机长线固定、弯折应力和 AA 电池盒裸线瞬间短路后的线头处理。这些属于方案与排查记录，不作为供电系统已改造、已验收的证据。

截至追加时仍未闭环的事项：

- Uno 偶发停止回报，用户通过手动重启恢复。正在分析 esp32-log.json 与固件，已观察到右电机内部输出值 -15104 的异常，尚未确认与断流的因果关系。按用户要求，本轮先分析、不修改代码、不烧录；该限制针对断流诊断阶段。
- 右侧超声波曾返回无效值，需要现场排查与复测。
- 软件串口与编码器、超声波同时运行的长期稳定性尚未验收；短时协议通过不能替代稳定性结论。
- 前向视觉避障仍是地面外观比较原型，没有厘米测距能力，可靠性与现场标定待后续处理。
- 真实车辆带载运动、调速效果、标签识别距离及完整巡游/互动流程仍需实体测试。

#### 记录016 · 供电问题已经收窄，串口失联尚未闭环

来源：[原始日志](项目日志.md)，第133行；原主题：2026-10-03：补记最新供电、失联排查与前向标定验收方法。以下为该记录原文，状态按记录日期理解。

- 单独 USB 供电的静置观察持续约 610.65 秒，末次 Uno 运行计时约 11 分 16 秒，期间未观察到重启或超过 10 秒的串口停更。但后续右轮 200 ms 动作完成约 7.49 秒后出现持续停发，PING 无回应；这只建立时间关联，不能认定右电机或右超声波是根因。见 [USB 供电对照报告](../tmp/usb-only-stability-report.md)。
- 无电机查询对照只发送 PING、GET_STATUS，也在 Uno 运行约 9 分 29 秒时出现 READY、计时归零，随后自行恢复。电机动作不是重启的必要条件；自动重启与持续失联仍需分别分析。源码审计发现命令缓冲区复用缺陷、串口持续处理及编码器中断负载风险，但未证明它们导致本次故障；未修改固件。见 [串口与电机隔离报告](../tmp/serial-versus-motor-report.md)。
- 9600 波特下完整遥测约 440 字节，仅回传占线约 458 ms。完整遥测延迟中位数/P95：静置 510/562 ms，高频 PING 542/606 ms，GET_STATUS 630/674 ms；实际额外查询频率分别约 2.09、1.16 次/秒。负载增加确实使回报变慢，但重启前未捕获持续积压、CRC 错误或队列溢出，不能把带宽限制直接当作重启原因。见 [延迟审计](../tmp/latency-audit-notes.md)。
- 随后左右单轮及双轮 PWM 150、0.8 秒动作均有完成及编码器回报，短观察内未立即重启；后续又出现失联，短动作成功不构成长期稳定性验收。
- 用户测得电池组／驱动板输入约 5.8 V，并澄清驱动板 5V→Arduino 5V 一直相连，另接 Arduino USB。用户确认接 USB 后电机能转，拔掉 USB 后只有响声、不转。这强烈支持供电不足、USB 补足逻辑电源的判断；但尚无启动瞬间驱动板 5V 与 Arduino 5V 的对照测量，不能确定不足发生在哪一路，也不能宣告供电系统已修复。无电机时的重启与失联仍待供电修正后复测。
- TX 灯恢复闪烁后 LED／蜂鸣器不响应，另有已确认的软件解释：限时测试结束会锁定 STOPPED 会话，需“解锁测试会话”。灯闪不等于命令已执行，状态锁拒绝也不等于程序卡死。

#### 记录109 · 2026-10-06：ESP32 自动重启与 VUSB 供电排查（尚未解决）

来源：[原始日志](项目日志.md)，第1137行；原主题：2026-10-06：ESP32 自动重启与 VUSB 供电排查（尚未解决）。以下为该记录原文，状态按记录日期理解。

**现象与日志证据。** 用户提供 esp32-local-history-2026-10-05T23-50-13-116Z.json，本地归档捕获到一次真实启动切换：旧 bootId=7192128c3e5af9bf，最后设备记录 seq=1090、ms=250187；新 bootId=0cbe4b01efee853d，seq 从 1 开始，READY 出现在 ms=155。网页接收时间窗口为 2026-10-05 23:49:48.050–23:49:59.463 UTC，不能将接收时间当作精确复位时刻。新启动 resetReason=1（ESP_RST_POWERON），与此前另一份日志的 PANIC 分类不同。此次归档有 628 条记录，其中旧启动设备记录 583 条（seq508–1090连续）、新启动设备记录38条（seq1–38连续），另有7条本地事件；没有重复key。旧启动 seq1–507 未收到，已通过 LOCAL_GAP 明确标记。本地历史确实保留了重启前后已收到的数据，不能声称恢复了全部启动日志。

**排查经过与最新状态。** 用户现场对照 USB 供电与当前外部 5V 供电的表现，最初怀疑连接 VUSB 的杜邦线接触不良，更换一根杜邦线后曾报告恢复；随即补充问题仍然复现，红色电源灯不停闪动，因此撤销“接触不良已确诊／换线已解决”的结论。目前确认的供电路径是电机驱动板的 5V 输出同时给 ESP32 和 Arduino 供电。项目既有记录使用 L298N，但当前板型、上游输入电压、5V-EN 跳帽、板载稳压器型号与负载能力仍需现场确认。共享 5V 的带载压降、接线／地线接触、电机干扰、稳压器压差不足或过热／保护是待排查假设；POWERON 和电源灯闪动提供供电／复位方向的线索，不能直接确诊稳压器过载。本次没有修改固件、参数或再次烧录。

**其他迹象与边界。** 旧启动第一次归档状态（ms=171149）的 minFreeHeap=232B、largestFreeBlock=9204B，说明该启动批次存在内部堆压力；这是启动以来的最低空闲堆记录，并非重启前瞬间内存值，不能把它认定为此次重启的已证实根因。重启后默认回到 SIM_UNO／IDLE，出现30条 source does not match mode 和2条 TELEMETRY_TIMEOUT，是启动后实际 Uno 输入与模式不匹配的后果。此前 FAULT operator_stop 后仍有持续运行记录，不作为崩溃证据。

**验证口径。** 换线后仍复现为用户最新现场报告，故障状态为尚未解决；缺连续电压／复位波形和受控供电隔离测试，不计算修复前后重启率、改善百分比或平均无故障时长。本节只追加原始项目日志，归类版未修改。对应附件位于 ../.codex-remote-attachments/01a10ce8-1c6f-7440-9496-178313911ee6/07ecd6d3-be79-4fd0-b395-01bc9df798b9/1-esp32-local-history-2026-10-05T23-50-13-116Z.json。

**后续排查建议（未执行）。** 断电后将 ESP32 的 VUSB 正极与驱动板 5V 输出分离，再用此前表现稳定的 USB 单独给 ESP32 供电，保留通信所需共地；避免未知板级隔离条件下将 USB 5V 与驱动板 5V 并接。比较相同识别／摄像头负载下电机停止与运行时的电源灯和重启表现，记录驱动板输入、5V 端、ESP32 VUSB／3.3V 的带载电压；万用表可能漏掉短暂跌落，必要时用示波器。ESP32-S3 官方芯片供电指南要求 3.3V 电源具备至少 500mA 输出能力，这是供电设计能力要求，不是本装置实测电流，也不是 VUSB 应输入 3.3V；摄像头、开发板与 Arduino 合计负载尚未测得。稳压器输出能力需按实际板型核对。资料：https://docs.espressif.com/projects/esp-hardware-design-guidelines/zh_CN/latest/esp32s3/schematic-checklist.html 。

**用户随后补充的供电条件。** 5V-EN 跳帽仍插着；上游是两节 18650 串联，用户估计输入约 7V，尚未给出带载电压测量；板型按用户回应及项目原记录暂按 L298N。若本板采用常见的 78M05／同类线性稳压器，约 7V 输入对生成稳定 5V 的压差余量有限；电池电压随电量下降、电机启动拉低输入或接线压降，都可能让共享 5V 失稳。这是符合当前现象的优先假设，尚未验证板载稳压器型号、实际压差与故障瞬间电压，不能写成确诊。建议先沿用此前较稳定的 USB 单独供 ESP32、断开其驱动板 5V 正极并保留共地进行对照；长期供电方案应核对实际负载后使用独立稳定的逻辑电源，不以驱动板“5V”端子标称值替代带载能力验证。
**静置复现、二极管与指示灯定义的补充核查。** 用户进一步说明即使电机静置，所称“红色电源灯”仍不停闪动；ESP32 没有 USB／电池等其他供电入口，仅由驱动板的 5V 供电。因此不能只用电机启动压降解释全部现象，接线／共地接触和稳压器静态供电仍需排查。单供电条件下没有证据支持两个独立电源互相回灌；板间信号仍存在潜在反向供电路径，但没有电压或电流证据，不能认定正在发生。

项目源码确认目标为 XIAO ESP32-S3 Sense。Seeed 官方手册 Power Pins 明确要求外部电源接5V引脚时串二极管，阳极接外部电源、阴极接5V引脚；该隔离措施不能代替稳压或接触修复，正向压降还会降低板端电压，不能把“补二极管”写成重启已解决。官方 Battery Usage 同时说明板上红灯是充电指示灯；若用户观察的是靠近RESET的该灯，就不能当作普通电源指示灯，每次闪动也不等于CPU重启。若观察的是L298N板灯，则需按该板原理图确认。用户随后确认闪动的是ESP32小板上的红灯，因此应按充电指示灯理解，不能仅凭闪动认定供电反复中断或CPU反复重启。此前日志用“红色电源灯”保留用户原描述，此处修正其电气含义尚未确认；已捕获的一次真实重启仍由bootId切换、ms回退和READY支持，与灯闪现象分开判定。

下一步应先核对灯的位置，并观察同一时刻网页设备ms是否回退／bootId是否改变；供电测量应分别比较驱动板5V端和ESP VUSB端，区分源端失稳与线缆压降。此建议未执行，根因仍未确定，没有改固件或操作设备。资料：https://wiki.seeedstudio.com/xiao_esp32s3_getting_started/ （Power Pins、Battery Usage）。

**摄像头无画面的进一步现场信息与只读验证。** 用户报告网页可以下达Arduino测试指令，ESP用户LED可控，但无摄像头预览；改用USB后红色充电灯不再闪，摄像头依然无画面。故不能把红灯闪、真实重启与无画面合并认定为同一个故障。助手只读查询192.168.137.130/api/state：同一bootId=77eb2fe2276f8f2c，从首次ms5590至保存采样ms35506／35696／35829，cameraOk=true且frameSeq始终为0；CAMERA init=0，视频workerReady=true、clients=[]，GET /capture返回HTTP500、camera unavailable。当前设备未发布可用缓存帧，无画面不只是浏览器渲染问题；cameraOk仅表示初始化结果，不保证后续采集与发布正常。不能将约30秒内同一启动批次推广为长期无重启。

板上摄像头配置persisted=true，JPEG quality=1（此前部署默认12），其他已读参数未见错误报告。低quality数值意味着较高JPEG质量／较大图像，极端设置造成驱动缓冲压力或无有效帧是优先验证假设，尚无串口FB-OVF／DMA overflow证据或参数恢复对照，不能写成已确诊。固件OFF仅关闭识别，摄像头采集仍独立运行，所以当前visionMode=OFF不能解释frameSeq=0。建议用户先在确认停车后将JPEG quality恢复12（或恢复默认）并保存，再观察frameSeq和/capture；若恢复后仍无帧，再查摄像头排线／扩展板连接及驱动采集日志。未自行修改参数或操作串口、复位与供电。只读证据位于evidence/camera-no-frame-20261006/。

**参数修改后续。** 用户先报告将JPEG quality改回12时提示camera busy；源码中该错误表示250ms内未取得cameraSensorLock，而采集任务持有该锁调用esp_camera_fb_get，取帧等待是可能原因，尚未取得驱动等待／锁占用时序证据。随后用户确认参数已成功改为15，但ESP小板红灯仍持续闪动。故参数写入并非永久不可用，不能将一次busy确诊为死锁；本轮没有修改锁实现或固件。JPEG quality与红色充电指示灯属于不同通路，修改JPEG参数不保证改变充电灯行为。改15后的预览是否恢复、ms是否连续增长尚待用户回复，不写成已恢复画面或已排除重启。

## 02 · 通信协议、事务与故障恢复

**发展脉络：** 单向能收但反向不通→D12软件接收绕过→乱码与带宽量化→短帧和CRC→请求编号／完整事务→扫描交接重试→确认停车与有限恢复。

**目前结果与边界：** 9600下约440字节回传需约458ms，静置遥测P50/P95为510/562ms；SC／SR／VR／VQ／SD不同断点分开处理。恢复配置漏解析、遥测挂起、只读诊断被阻断等已有具体修复，长期UART根因未清。

**能力提炼：** 协议建模、异步事务、幂等重试、故障降级和因果诊断；能区分在线、有效遥测、动作确认与物理结果。

关联其他主题：[记录128](#record-128)、[记录137](#record-137)。

### 本章记录索引

| 记录 | 原始日志标题 |
|---|---|
| [003](#record-003) | 节点二：处理串口乱码、缺字与画面不移动 |
| [012](#record-012) | 节点四：绕过 Uno D0 接收路径，打通真实双向通信 |
| [019](#record-019) | 后续实施：57600 通信与 Uno V5.9 流程诊断 |
| [020](#record-020) | 2026-10-03：Uno 缓冲修复、内存检查与 ESP 请求号匹配 |
| [021](#record-021) | 最新现场：遥测 1137 中途停止 |
| [024](#record-024) | 2026-10-03：取消续行、压缩遥测，并核对 ESP/Uno 指令时序 |
| [028](#record-028) | 1. 串口压力对 Arduino 回报耗时的影响 |
| [035](#record-035) | 2026-10-03：ESP V0.15 扫描配置重试 |
| [036](#record-036) | 2026-10-03：ESP V0.16 / Uno V6.8 开始扫描重试 |
| [037](#record-037) | 2026-10-03：ESP V0.17 取消扫描能力启动门槛 |
| [041](#record-041) | 新补证：找猫卡住不只是检测值持续true |
| [043](#record-043) | 2026-10-04：ESP V0.19 / Uno V6.9 扫描交接停滞与结束回报重发 |
| [046](#record-046) | 2026-10-04：扫描交接恢复最终离线验证补录（关联另一会话） |
| [047](#record-047) | 2026-10-04：ESP0.19／Uno6.9上传完成，实体扫描待验收 |
| [054](#record-054) | 2026-10-04：日志26命令回环、交接重试耗尽与停车未确认 |
| [055](#record-055) | 2026-10-04：双USB只读复现——模式切换附近恢复真实通信，随后Uno再次启动 |
| [056](#record-056) | 2026-10-04：日志28当前通信已恢复，界面仍显示锁存的Uno link timeout |
| [057](#record-057) | 2026-10-04：更正架空持续转轮解释，ESP0.24有限通信恢复与RPM停稳条件 |
| [058](#record-058) | 2026-10-04：ESP0.24最终编译、上传和新只读采集 |
| [061](#record-061) | 2026-10-04：日志32停车失败后遥测被保护层拦截，ESP0.26保留只读诊断 |
| [062](#record-062) | 2026-10-04：用户确认18:05:31 Uno自发重启；日志33补齐FAULT后的恢复入口 |
| [063](#record-063) | 2026-10-04：ESP0.26／Uno6.10部署完成，补记空运动STOP清零缺口 |
| [066](#record-066) | 2026-10-04：日志34自动恢复配置漏解析，用户声光体验反馈与只诊断边界 |
| [067](#record-067) | 2026-10-04：日志34非人工重启用户确认与本地版本归档 |
| [068](#record-068) | 2026-10-04：日志35不完整遥测未释放挂起请求，停稳复核缺证据 |
| [069](#record-069) | 2026-10-04：用户授权ESP0.29修复恢复配置解析与缺帧挂起，恢复上限四轮 |
| [070](#record-070) | 2026-10-04：ESP0.29最终验证与上传完成，四轮恢复实体表现待测 |
| [074](#record-074) | 2026-10-04：STOP_UNCONFIRMED历次综合分析与日志38持续命令无响应 |
| [117](#record-117) | 2026-10-06 通信失败导致互动回退审计（仅记录，未改固件） |

### 本章完整记录

#### 记录003 · 节点二：处理串口乱码、缺字与画面不移动

来源：[原始日志](项目日志.md)，第19行；原主题：2026-09-30：从空板调试推进到真实电机测试。以下为该记录原文，状态按记录日期理解。

**证据。** 用户导出的 `uno-web-lab-2026-09-30T14-19-54-228Z.json` 中，多次 `DRIVE 12.0 105` 有完整的 `MOTION_DONE`，但开始回报和部分 ACK 出现乱码或缺字；机器人位置停在原处，策略持续重复同一段前进命令。该日志中的 `ESTIMATED` 脉冲不能视为已经验证的真实编码器里程。供电负担可能与乱码相关，但没有电气测量证据证明具体噪声来源。

**改动。**

- 主固件和网页统一使用 57600 波特；独立最简测试程序继续使用 115200。
- 缩短高频指令：`C id CF`、`C id GT`、`C id DI S L|R`；删除超声波模拟注入的冗余 EVENT 回显。
- 网页指令与关键运动回报加 CRC-8。缺校验或校验失败的网页指令不执行，损坏的关键回报不猜测内容。
- 使用短回报 AK/MS/MP/MD/MA，前端验证后还原为可读日志；有效 ACK、进度或结束回报可以恢复漏掉的运动开始记录。
- 没有为了修复丢字而增加重复 STATE 同步，也没有新增无条件重发运动命令。

**频率调整。** 曾把硬件卡片刷新降到每秒一次；根据随后对连续动画的反馈，当前 V5.6 调整为卡片约每 250 ms 刷新，运动期间另有约每 100 ms 的短脉冲回报。波特率仍为 57600；高频脉冲回报使用校验和短帧，避免发送整批状态。

**状态。** 用户认可乱码处理为已完成的阶段节点。校验、缺字拒绝和丢开始回报恢复已通过自动测试；这不等于已测得所有供电条件下均无乱码，V5.6 持续实机运行仍待用户验收。

#### 记录012 · 节点四：绕过 Uno D0 接收路径，打通真实双向通信

来源：[原始日志](项目日志.md)，第103行；原主题：2026-10-01 至 2026-10-02：ESP32 视觉调优与真实 Uno 通信联调。以下为该记录原文，状态按记录日期理解。

**排查证据。** 初期 Uno→ESP 能收到 READY、HELLO，ESP→Uno 多次 PING 无回应。现场确认电平转换模块曾接触不良，HV 参考供电也曾偏低；修复这些条件后反向仍未通。ESP 经过转换模块的回环、Uno 自身 D0/D1 回环以及电脑 USB 输入 PING/PONG 均通过。降低波特率、换供电、最小固件和发送方向直连 D0 尚未解决反向接收。RX/TX 指示灯、空闲电压、发送日志均不足以证明双向通信成功。

**最终方案。** Uno 改用 D12 软件串口接收，D1 硬件串口回传，双方 9600 波特率；ESP D6→LV4→HV4→Uno D12，Uno D1→HV3→LV3→ESP D7，LV=3.3V、HV=5V、全部共地。最小固件在两板日志出现 ROUND_TRIP_OK；完整固件随后收到真实 Uno 的 PONG、配置与传感器回报。D12 方案已实测打通双向协议，但原 D0 路径的具体电气原因未最终确定，不能据此判定 D0 损坏。

**资源与输出分工。** Uno 固定协议文字移到 Flash，RAM 占用由 1612 降到 1054 字节，约留 994 字节给栈；USB 与软件串口分别组帧，避免字节混入。最终采用 Uno D13 控制蜂鸣器，LED 改由 ESP 板载灯承担。固件已更新，蜂鸣器实际驱动接线与发声仍需现场确认。

#### 记录019 · 后续实施：57600 通信与 Uno V5.9 流程诊断

来源：[原始日志](项目日志.md)，第159行；原主题：2026-10-03：补记最新供电、失联排查与前向标定验收方法。以下为该记录原文，状态按记录日期理解。

用户再次报告 Uno 停止回报，并要求增加调试输出、把两边波特率改为 57600。已将 Uno D12 软件接收、D1 回传及 USB、ESP GPIO43/44 UART、电脑 USB 测试页统一为 57600/8N1；ESP USB 日志口保持 115200，接线保持 D12/D1，不恢复此前未打通的 D0 路径。

Uno V5.9 默认每秒尝试输出简短心跳，包含循环数、最大循环耗时、遥测编号与分段、瞬时等待位、软件接收溢出与丢弃命令数。详细模式补充命令进入／退出与各遥测阶段标记；每次主循环同时在 SRAM 记录当前步骤，复位后的启动日志尝试报告此前步骤与命令号。SRAM 记录不是复位原因检测，断电或内存被改变时可能不可用，不能把最后记录直接认定为根因。诊断仅在 TX 空间足够时发送整行，繁忙时跳过，不写 EEPROM、不启用自动复位看门狗。

ESP 网页增加诊断三档按钮，并把步骤／十六进制心跳转换为中文说明。用法与解释见 [固件诊断说明](./firmware/README.md)。原工作目录与仓库固件快照已同步，SHA256 一致。

验证：Uno 编译通过，Flash 29202/32256 字节、全局 RAM 1077/2048 字节；ESP 编译通过，Flash 3677718/8257536 字节、全局 RAM 78304/327680 字节；73 项 Node 回归通过，电脑网页语法检查通过。没有烧录设备或操作实机；两端升级后的 PING/遥测、57600 软件串口与编码器／超声波并行运行的稳定性以及当前失联根因均待现场验证。

#### 记录020 · 2026-10-03：Uno 缓冲修复、内存检查与 ESP 请求号匹配

来源：[原始日志](项目日志.md)，第169行；原主题：2026-10-03：补记最新供电、失联排查与前向标定验收方法。以下为该记录原文，状态按记录日期理解。

用户提供的导出日志显示 ERROR 0 BAD_ENVELOPE / BAD_CHECKSUM 被策略层误匹配 motorId=0，随后 MOTION_FAILED 并停止。记录中 16 条 ESP 发送帧重新计算 CRC 均正确，不能证明 Uno 收到的字节相同。另有右电机遥测 -2048，超出合法范围；原 DATA 行未带 CRC，因此未证实是内存损坏还是链路数据损坏。用户再次复位后报告 PREV_STAGE=7 CMD=3154；与此前命令 376 相同阶段，只能作为声光函数附近的定位线索。

Uno V6.0 把四个命令缓冲分开，并加前后哨兵，修复待执行槽被新输入覆盖而改变当前参数的问题。新增带 CRC 的内存诊断，检查缓冲边界、已记录电机范围及采样 SRAM 余量。缓冲/电机异常触发停止并锁定至复位；低余量仅告警。声光函数细分为步骤 70–74。ESP32 0.7 拒绝用编号 0 匹配待完成动作，将未识别编号错误记录为 UNO_PROTOCOL_ERROR，保留 CRC 和反馈/会话超时保护。没有证实这些缺陷就是所有失联的根因。

编译：Uno Flash 30648/32256 字节，全局 SRAM 1237/2048 字节；ESP Flash 3678186/8257536 字节，全局 SRAM 78304/327680 字节。73 项 Node 回归通过，ESP 编译包含 6 项请求号匹配静态断言，Python 采集脚本语法通过；两份 Uno 源码 SHA256 一致。

按用户明确授权，Uno 已通过 COM10 上传。初次只读采集 60.171 秒，60 个心跳、60 个内存帧，内存帧 CRC 错误 0，采样余量 698 字节，异常位/锁定均为 0，未观察到 READY 或复位；此窗口无 ESP 查询流量，不能代表双向并发稳定性。原始记录见 esp32-host/uno-after-upgrade-20261003.json。用户更新 ESP 地址为 192.168.137.15，并授权后续通过 ESP 发命令测试；ESP 上传和双向验证结果继续补录。

ESP32 0.7 已上传 COM11，esptool 校验 Flash 哈希成功，HTTP 192.168.137.15 回读版本一致。真实 UART 切换后 STOP 45、SESSION_STOP 46、GET_CONFIG 47 得到对应回报；随后 PING 49 出现 ERROR 0 BAD_CHECKSUM，ESP 正确记录 UNO_PROTOCOL_ERROR，没有将其误报为 MOTION_FAILED。通信稳定性验证失败，未发送任何运动命令。

采集曾在 COM10 读到 EVENT DIAG M 698 698 5 0 0 0*D1，CRC 可复算通过，但异常位与锁定不一致；随后 15 秒读出约 11.67 MB 的大量重复片段，明显超出 57600/8N1 物理新数据容量。独立 .NET 读取也看到重复片段，故此异常记录不能作为实时 Uno 内存损坏的可靠结论。用户按 RESET 后，ESP 的真实 UART 内存回报为 698/698、异常位 0。采集脚本已加异常速率保护和输出上限；USB 重复读的原因尚未确定。

进一步上传 Uno V6.1，增加分词前的校验失败摘要，并让累计关键异常位同样触发锁定。最终编译 Flash 30952/32256、全局 SRAM 1237/2048。再次通过 ESP 测试，GET_TELEMETRY 195、196 完整返回；PING 197 未获得 PONG，下一条 GET_TELEMETRY 198 的发送帧为 C 198 GET_TELEMETRY*4D，但 Uno 摘要为 EVENT DIAG RX 36 EA 4D C7FEBFFFFBEBFFDFFF7FF65F，随后 ERROR 0 BAD_CHECKSUM / UNO_PROTOCOL_ERROR。期望发送帧为 22 字节，接收摘要长度 36，前缀含非 ASCII 字节，计算 CRC EA 与收到 4D 不同。该摘要无自身 CRC，且不是逻辑分析仪对引脚的独立抓包，但结合前后完整遥测与受 CRC 保护的内存诊断，已提供接收/解析前内容改变的具体线索。不能据此区分软件串口中断时序、电平转换、接地或噪声，也不能排除未覆盖的缓冲内内容损坏。

错误出现即停止后续主动查询；当前保持真实 UART、策略 STOPPED，未启动巡游，未动作电机。下一步应针对 ESP GPIO43 → 电平转换 → Uno D12 做波形/供电/接地检查，并对照更稳健接收方案；未经用户同意，不自行改变现有 57600 波特率或接线。原始复测证据：esp32-host/diagnostic-http-v61-20261003.json。

停止主动查询后另做 32.48 秒 HTTP 只读观察：68 组完整遥测、27 个心跳，内存诊断值为 EVENT DIAG M 698 698 0 0 0 0；期间又出现 1 次 UNO_PROTOCOL_ERROR/BAD_CHECKSUM 和 1 次 TELEMETRY_TIMEOUT。最后 lastUnoAgeMs=101，说明仍有新数据，不能宣称已永久失联或修复稳定性。原始记录 esp32-host/esp-passive-v61-20261003.json。所有自建采集窗口已结束，串口释放。

#### 记录021 · 最新现场：遥测 1137 中途停止

来源：[原始日志](项目日志.md)，第189行；原主题：2026-10-03：补记最新供电、失联排查与前向标定验收方法。以下为该记录原文，状态按记录日期理解。

用户再次报告 PING 后网页读数过期及 Uno 失联。只读 HTTP 快照显示 lastUnoAgeMs=42790，最后回报 DATA 1137 HW SR 1 1 0 57.4 57.4 P；此组此前 STATE uptime=349918 ms，左/右电机为 0，缺少后续触碰数据和 DONE。ESP 后续 GET_TELEMETRY 1138–1143 均没有回报。失联前最后内存诊断为 EVENT DIAG M 698 698 0 0 0 0，最后心跳也停止。独立 COM10 只读 8.18 秒记录 0 字节/0 行，确认 USB 与 ESP 回传均沉默。最新 160 条日志中没有 PING，故无法把此次失联直接归因于特定 PING。当前保留现场并监听用户复位，不发送新测试命令。原始记录 esp32-host/latest-disconnect-20261003.json 和 uno-latest-disconnect-20261003.json。

用户保持供电复位后直接捕获 READY UNO_CAT_V6.1 和 EVENT DIAG_BOOT PREV_STAGE=2 CMD=1137，心跳/遥测恢复。新阶段为 tickTouches，不是此前 Stage 7；tickTouches 仅遍历 4 个触碰输入与防抖，状态变化时 setTouch 可能进行串口发送，没有发现无界循环。不同入口步骤发生沉默提示不能锁定声光函数为统一根因。仍需隔离软件 RX 输入及供电/中断因素，禁止把单个步骤记录等同于根因。

网页过期规则为单个传感器行超过 2500 ms 未更新；PING/PONG 不刷新传感器读数。ESP 遥测等待 DONE/同编号 ERROR 最长 5000 ms，超时后再等待约 2000 ms 发新查询。ERROR 0 无法确认归属，不会释放非零遥测请求。因此校验失败或未完成回报可造成约 7 秒采集缺口并触发过期；这解释显示机制，不证明每次 PING 都必然导致该错误。此次最新日志已无 PING，无法追溯直接因果。

#### 记录024 · 2026-10-03：取消续行、压缩遥测，并核对 ESP/Uno 指令时序

来源：[原始日志](项目日志.md)，第220行；原主题：2026-10-03：取消续行、压缩遥测，并核对 ESP/Uno 指令时序。以下为该记录原文，状态按记录日期理解。

按用户要求，当前正常巡游保留用户自行保存的有序标签路线，启动自动开启标签识别；前向避障开关由 ESP 执行，Uno 不承担前向安全门禁。此次将 ESP 升级到 `ESP32_CAT_HOST_0.10`、Uno 升级到 `UNO_CAT_V6.3`，两边以 57600 通信，已上传 COM11/COM10。用户操作巡游和展示标签，本轮未自动启动巡游或电机。

删除 Uno 的 `KEEP` 命令和 MOTOR 500 ms 截止时间，删除 ESP 的周期 KEEP。一次 MOTOR 持续执行到新 MOTOR、STOP、会话关闭或本地侧向/触碰/失速检查停车；限时测试和计数动作仍保留时限。模拟 Uno 同步为连续 MOTOR，删除模拟前向门禁，前向由上位控制层检查；USB 页面取消 KEEP 和相同扫描 MOTOR 的周期重发。ESP 失联时 Uno 不会因为缺少续行自动停车，这是新控制契约，不是失联修复。

原 13 条单项 DATA HW 遥测替换为一次 50 字节快照，通过三条 `TB id part HEX*CRC`（17/17/16 字节内容）和受校验 DONE 发送；含 CRLF 的单条 TB 最长 50 字节，发送前等待 AVR TX 空位和超声波空闲。快照增加边界标记并纳入内存检测，无 Arduino String 动态分配。ESP、USB 页面收齐完整同编号快照后更新显示，旧 DATA HW 格式作为显示解码形式保留。ESP 自动查询从静止 300 ms/运动 1000 ms 统一改为 2000 ms，运动反馈 MP 从 100 ms 改为 200 ms，750 ms 有效运动反馈检查仍独立执行。

用户授权子代理只读核查两份固件时序。启动 STOP → GET_CONFIG → SESSION_START 的编号匹配、2500 ms 超时/两次阶段重试，以及三份快照字段/CRC 定义一致。发现取消续租后一次 STOP 丢失可能让网页显示 STOPPED 而 Uno 继续运行，已补独立 STOP 确认等待：匹配带 CRC 的 `DONE id MOTOR_STOPPED` 才发后续命令，300 ms 未确认重发同编号 STOP，最多三次；耗尽则清队列、显示停车未确认并阻止后续电机命令。清普通队列不清停止等待，MOTOR 的 750 ms 从实际发送起计时。子代理复核该链未发现新的阻断性问题。Uno DONE 全部带 CRC；详细遥测诊断改为只记录阶段，避免发帧前诊断输出占用刚检查过的 TX 空间。

验证：最终 79 项 Node 测试通过，含整批快照解码、缺帧/损坏/错误编号/超时不刷新和停车未确认显示；两边编译通过。Uno Flash 30824/32256、静态 RAM 1307/2048；ESP Flash 3689078/8257536、静态 RAM 78416/327680。ESP 烧录哈希核验通过。静止采集三条 TB 解出的 13 项与 ESP API 显示逐项一致，同批发布时间差 1 ms；查询间隔 1999–2015 ms，电机请求/输出均 0，内存诊断采样余量 617、异常标志 0。采集时板上路线 `[46,40]`、前向开关关闭、轮距 120 mm 均保留。该短窗口没有协议错误，不能证明十分钟以上稳定。

随后仅发停车指令的验证实际遇到 `ERROR 0 BAD_ENVELOPE`、`ERROR 0 BAD_CHECKSUM`：STOP #60 在 135980 ms 首发，136280/136581 ms 重试，136641 ms 收到校验通过的停车确认，随后才发送 SESSION_STOP #61。因此停止重试在真实损坏命令下有效；底层软件串口/线路偶发损坏仍存在，不能宣称串口问题已修复。还没有验证连续标签巡游、电机运动中的时延或长期失联；这些由用户下一轮实机测试确认。侧向传感器无效/障碍、编码器失速、标签搜索耗尽与串口失联仍是不同故障原因。

证据：`esp32-host/compact-v010-before-upload-20261003.json`、`compact-v010-passive-20261003.json`、`compact-v010-validation-summary-20261003.json`、`compact-v010-stop-confirm-20261003.json`。

#### 记录028 · 1. 串口压力对 Arduino 回报耗时的影响

来源：[原始日志](项目日志.md)，第261行；原主题：2026-10-03：开发问题回顾与实测数据补充（本次新增）。以下为该记录原文，状态按记录日期理解。

历史条件：2026-10-02，Uno V5.8 / ESP 0.6，D12 软件接收、D1 硬件回传，9600/8N1，USB 单独为 Uno 供电，策略停止，背景持续 GET_TELEMETRY。耗时口径是 ESP 日志中 UART 发送到同编号 DONE 的时间，包含缓冲、调度和解析；不是 HTTP 请求耗时，也不是引脚波形测量。P50 为中位数，P95 为第 95 百分位。

| 场景 | 实际额外查询频率 | 完整遥测有效样本数 | 遥测 P50 / P95 / 最大值（ms） | 遥测实际频率 | 相比基线 P50 |
|---|---:|---:|---:|---:|---:|
| 静置，仅背景遥测 | 0 | 1160 | 510 / 562 / 599 | 1.90 Hz | — |
| 叠加 PING，阶段名 PING_1Hz | 0.70 Hz | 222 | 521 / 574 / 612 | 1.88 Hz | +11 ms，约 +2.2% |
| 叠加 PING，阶段名 PING_5Hz | 2.09 Hz | 329 | 542 / 606 / 636 | 1.82 Hz | +32 ms，约 +6.3% |
| 叠加 GET_STATUS，阶段名 GET_STATUS_2Hz | 1.16 Hz | 345 | 630 / 674 / 779 | 1.65 Hz | +120 ms，约 +23.5% |

额外命令本身也有量化结果：低频 PING 84 个完整样本，P50/P95/最大值 65/88/132 ms；较高频 PING 375 个完整样本，66/103/156 ms；GET_STATUS 244 个完整样本，160/202/243 ms。PING 回复约 28 字节，GET_STATUS 约 107 字节，指令种类与回复长度同样影响负载，不能只比较调用次数。

完整遥测约 440 字节，9600/8N1 下单是回传的理论占线时间约 458 ms；这是计算值。基线回传方向估算占用率约 86.9%，较高频 PING 约 89.3%，GET_STATUS 约 88.6%。原定 300 ms 查询条件实际受到等待 DONE 的约束。可以记录为“压力增加后完整遥测中位数 510→542→630 ms”，没有依据写成“400→500 ms”。阶段名称代表目标频率，不能宣称已经完成实际 5 Hz PING 或 2 Hz GET_STATUS 压测。

数据质量限制：基线日志有 243 个 seq 缺口、7 条发送未捕获 DONE；低频 PING 阶段有 20 个 seq 缺口。环形快照漏采不等于 UART 丢包。较高频 PING、GET_STATUS 阶段内部没有 seq 缺口；统计在重启前截止，未完成事务不进入完整耗时样本。基线分析跨度 614.757 秒与稳定性观察报告 610.65 秒使用不同时间边界，分别保留，不混用。

证据：[延迟分析说明](../tmp/latency-audit-notes.md)、[统计结果及样本数](../tmp/latency-audit-results.json)、[基线原始快照](../tmp/usb-only-watch-20261002.jsonl)、[压力测试原始快照](../tmp/serial-load-isolation.jsonl)。

#### 记录035 · 2026-10-03：ESP V0.15 扫描配置重试

来源：[原始日志](项目日志.md)，第344行；原主题：2026-10-03：Uno容量与手动IDE上传配置。以下为该记录原文，状态按记录日期理解。

新日志定位到达标签40后SC389收到BAD_CHECKSUM，旧策略只发一次而超时。按用户要求，只对扫描配置校验失败安排100ms间隔，首次之外最多重发3次；无回复先等2500ms超时。对应SCAN_CONFIGURED后才旋转，失败用尽STOP，停止/触碰取消重试，暂停配置期间普通遥测；不为运动命令扩展重试。真实策略499项等自动化通过。原始证据及验收见esp32-host/扫描配置重试-20261003.md。

ESP V0.15已上传COM11应用区，哈希校验和HTTP版本回读通过。原NVS路线、PWM、停车宽度和等待时间保留；未做UI/运动验收。实现提交e2eca7e，Uno仍V6.7。

#### 记录036 · 2026-10-03：ESP V0.16 / Uno V6.8 开始扫描重试

来源：[原始日志](项目日志.md)，第350行；原主题：2026-10-03：Uno容量与手动IDE上传配置。以下为该记录原文，状态按记录日期理解。

按用户要求SR校验错误立即重发、无回复实际下发100ms后重发，首次之外最多3次。冻结同编号/代次/实际PWM，Uno同一扫描只补确认，不重置进度，等待SR确认期间暂停普通遥测。SC配置规则不变，普通运动和语义拒绝不增加重试；用户现场测试。实际策略557、扫描235、PWM2603、网页18及线路/视觉测试通过；Uno32206字节，ESP3721018字节。证据及验收见esp32-host/开始扫描重试-20261003.md。

上传完成：ESP V0.16应用区上传哈希及HTTP版本回读通过，参数保留。Uno第一次未同步，用户断开两板串口并关闭监视器后COM10写入/读回32206字节成功。实现提交03a17f1；用户负责接回UART和实车多轮标签验收。

#### 记录037 · 2026-10-03：ESP V0.17 取消扫描能力启动门槛

来源：[原始日志](项目日志.md)，第356行；原主题：2026-10-03：Uno容量与手动IDE上传配置。以下为该记录原文，状态按记录日期理解。

按用户明确要求，新版Uno固定配对，不再为旧版本兼容强制先PING确认SCAN_V1。删除start/resume能力门槛，无额外自动查询或等待；直接原有停车确认→读取配置→启动会话→SC→SR。诊断字段不再阻挡启动。真实策略579项、扫描235项、PWM2603项、线路/视觉自动化通过；新增无PING/READY/能力事件时真机启动和恢复完整进入SR的回归。Uno保持V6.8，实际UI/运动由用户验收。证据见esp32-host/启动巡游移除能力门槛-20261003.md。

2026-10-04：ESP V0.17已上传并通过哈希和HTTP版本回读，NVS参数保留。取消启动扫描能力门槛实现提交6a0b735；选择真机UART后直接启动，不要求手动PING。实车测试由用户完成。

#### 记录041 · 新补证：找猫卡住不只是检测值持续true

来源：[原始日志](项目日志.md)，第387行；原主题：2026-10-04：近期对话复盘、已有日志补证与分类归档。以下为该记录原文，状态按记录日期理解。

15份ESP导出已复制到[evidence/20261004-review](./evidence/20261004-review/snapshot-index.json)，索引记录版本、窗口时间、来源分类计数及SHA256。各份只保留最后160事件，不保证连续；错误窗口计数不是全程错误率，也不重复累加UNO_RX错误行和对应UNO_PROTOCOL_ERROR事件。

| 0.18导出 | 实际时间轴与窗口内计数 | 判断 |
|---|---|---|
| esp32-log(12).json | 113568ms出现CRC_ERROR：`SD 104 12 1*0`；CRC_ERROR1、UNO_PROTOCOL_ERROR1 | 扫描结束消息损坏，留下旧true，不证明猫仍在画面 |
| esp32-log(13).json | 步6～11的false成功接收继续转；215474/215491ms发步12 VR，两次BAD_CHECKSUM；UART_BAD_FRAME33、UNO_PROTOCOL_ERROR4、TELEMETRY_TIMEOUT2 | 第12步识别结果未被接收，仍保留scan177/步12/代次17；后续Uno真实内部终态无法确认 |
| esp32-log(14).json | 330057ms发步5 false，330070接受，330076MS，330152MD；330350起坏帧，无有效后续VQ/SD；UART_BAD_FRAME27、UNO_PROTOCOL_ERROR2、TELEMETRY_TIMEOUT2 | false已接收且完成下一段旋转，断点在停车后的交接；坏帧没有原文，不能断言是哪条VQ损坏 |

日志14快照保留scan294/步5/代次33，182.25°/预算718.875°，visionAgeMs13568、motorRunning=false、无lastFault；用户后续界面报告观测90462ms是更晚观察，二者不能混用。日志14还显示frontCalibrated=false/front=INVALID，不能作为标定成功证据。

正常链路：SR→Uno小步旋转MS/MD→停稳→VQ→ESP新帧识别VR→VISION_ACCEPTED→Uno继续下一步或发SD。false之后下一步由Uno执行，不是ESP重新发旋转指令。共同恢复缺口包括停车后只剩600秒扫描总超时、DIAG在线消息掩盖无进展、SD仅发一次。既有SC/SR重试未覆盖完整VQ/VR/SD链路；数据损坏的电气/收发根因仍待定位。

#### 记录043 · 2026-10-04：ESP V0.19 / Uno V6.9 扫描交接停滞与结束回报重发

来源：[原始日志](项目日志.md)，第411行；原主题：2026-10-04：近期对话复盘、已有日志补证与分类归档。以下为该记录原文，状态按记录日期理解。

用户报告分步找猫停止旋转，猫离开后曾持续显示 detected=true；随后两次显示 false 仍停车。以用户最终更正的界面 SEARCH_CAT_ACTIVE / 命令294 / 帧1646 / 观测90462ms / 第5步182.3度为准，先前 STOP_UNCONFIRMED 描述已被用户更正，不作为这次故障证据。原始日志12、13、14只读分析后保存于 evidence/scan-handoff-20261004/，保留原文件内容。

实际数据与断点：
- 日志12：113552ms回报 VR 104 6 12 1 564；113567ms收到 VISION_ACCEPTED；113568ms收到 CRC_ERROR，原文 SD 104 12 1*0。导出时视觉结果已旧26784ms、实际识别OFF。持续true是未更新的历史结果，不能证明模型持续误识别。
- 日志13：215474ms和215491ms发送第12步 false，Uno两次返回BAD_CHECKSUM；随后持续UART_BAD_FRAME，未收到有效下一步/结束回报。导出时SEARCH_CAT_ACTIVE、scanPhase=VISION、识别结果旧16886ms。
- 日志14：330057ms回报第5步false，330070ms收到VISION_ACCEPTED，330076ms收到下一步旋转MS，330152ms收到MD（2/2脉冲）；330350ms起坏帧，未收到有效第6步VQ或SD。坏帧原文未保留，不能断言330350ms那一条就是VQ。导出时scanPhase=SETTLE、scanStep=5、182.25度、视觉旧13568ms，之后界面旧90462ms。

原因边界：已证实扫描交接消息出现损坏/缺失，ESP与Uno扫描状态不同步；没有两个行为状态同时争抢电机的证据。Uno在每步旋转后停车、等待停稳、发VQ；ESP按请求识别并发VR；false由Uno自行启动下一步，结束由SD通知ESP。MD后motorRunning=false，原750ms运动反馈检查不再适用；扫描仅600000ms总超时。EVENT DIAG仍刷新连接时间，在线不能证明扫描推进。UART损坏的具体线路/电平/供电/软件收发根因仍未闭环。物理停稳、识别准确率和现场长时间行为均未被离线测试证明。

修复实现：
- ESP记录扫描独立进度时间；新步骤VQ、MS、首次MD刷新。普通ACK、重复VQ和诊断消息不续进度。停车交接等待上限为scanSettleTimeoutMs + scanVisionTimeoutMs + 1500ms，当前默认7500ms。达到后以原scanId/generation和冻结的SR命令请求Uno重发现有状态，最多3次、间隔1000ms；仍无进展则FAULT、STOP/SESSION_STOP，不自动恢复运动。持续旋转时保留750ms编码器反馈保护、总扫描600秒上限。
- 复用Uno已有同id/generation的SR幂等处理：活动扫描只ACK、保留原旋转/预算；WAIT_VISION按既有500ms周期重复VQ；终态重复原SD，不重新扫描。ESP收到有效SD即完成/退出，后续旧SD不能重复执行行为。
- Uno终态SD首发后最多4次自动重发，间隔至少500ms；同身份恢复请求可再次请求终态回报。重发只传原身份/结果，不能中止之后另一编号的运动。这里采用有界重发与幂等接收，没有新增SD确认命令。
- 为适配Uno容量，复用现有计时字段、终态发送字段改为计数，重发间隔比较使用16位差值（长间隔最多延迟回报，不触发运动）。缩短启动诊断文字为EVENT DIAG_BOOT STAGE=... CMD=... / NONE，网页同时兼容旧PREV_STAGE格式。正常串口消息/动作/安全门槛保留。
- 版本标识ESP32_CAT_HOST_0.19、UNO_CAT_V6.9；仓库外uno-firmware/UnoCatController手动上传副本已同步。需两板更新才能得到完整自动结束回报重发；本轮没有烧录、RESET、网页操作或实物运动测试。

离线验证：实际共用扫描核心259项、实际ESP policy.cpp591项、连续猫互动149项、PWM/配置2622项通过，视觉请求门与线路CRC检查通过。新增覆盖丢失下一步VQ/SD、三次重试后安全退出、同id冻结命令不变、ACK/重复VQ不续进度、恢复成功/失败终态和有界SD重发。Uno AVR1.8.8按既有build-uno.ps1优化参数编译32254/32256 bytes Flash、1379/2048 bytes静态RAM；Flash仅剩2 bytes，后续功能需继续检查容量。ESP最终编译和Node结果见本节后续验证记录。编译和原生测试不等同于串口错误已消除或现场行为已验收。

#### 记录046 · 2026-10-04：扫描交接恢复最终离线验证补录（关联另一会话）

来源：[原始日志](项目日志.md)，第477行；原主题：2026-10-04：按10月2、3、4日完整对话逐页补漏。以下为该记录原文，状态按记录日期理解。

修复会话已将结果转交统一日志：ESP0.19/Uno6.9代码实施完成，扫描停车交接等待默认7500ms（停稳超时+视觉超时+1500ms），原身份/冻结SR恢复最多3次、间隔1000ms；ACK、重复VQ、DIAG不续进度，恢复耗尽安全FAULT/STOP/SESSION_STOP。VQ沿用500ms周期；SD新增首发后最多4次、至少500ms的有界重发，未新增SD ACK命令，不重启运动，不中止其他编号新动作。

最终离线验证：扫描核心259、实际policy591、连续互动149、PWM/配置2622检查通过，视觉门/线路CRC通过；Node92测试全通过。Uno编译32254/32256字节Flash（仅余2字节）、静态RAM1379/2048；ESP最终编译3729586/8257536字节Flash、静态RAM78928/327680。两板尚未上传，未RESET、网页操作、运动或现场长期测试；UART损坏根因仍未闭环，不能宣称实车问题消除。本次只统一记录结果，不提交或修改另一会话固件。

补充日志12：true为旧帧564，导出观测年龄26784ms；日志13导出旧16886ms。原始文件也由修复会话存于evidence/scan-handoff-20261004；本轮15份统一索引仍保留evidence/20261004-review。最新阶段以本补录为准，前文“实施中/最终构建待补”保留为整理期间快照。

#### 记录047 · 2026-10-04：ESP0.19／Uno6.9上传完成，实体扫描待验收

来源：[原始日志](项目日志.md)，第485行；原主题：2026-10-04：按10月2、3、4日完整对话逐页补漏。以下为该记录原文，状态按记录日期理解。

后续上传证据已核对，更新前文“尚未上传”的阶段状态：用户授权直接上传并确认板间UART已拔下。Uno COM10（FTDI VID0403/PID6001）成功写入V6.9共32254字节，AVRDUDE完整读回校验通过。ESP COM11（VID303A/PID1001）先读取0x8000的3072字节分区表，与构建一致后，仅写0x10000应用区3729728字节；921600波特、no-stub，47.0秒，哈希校验通过并RTS复位。上传会话记录未写NVS、分区表或bootloader。

保存HTTP快照回读ESP32_CAT_HOST_0.19、SIM_UNO、IDLE、cameraOk=true、motorRunning=false、stopPendingId=0、stopUnconfirmed=false。路线[46,40]、minimumDrivePwm255、scanMinimumMs200、tagStopWidth0.19、扫描视觉/停稳超时3000/3000ms保留。当前结论为两板上传已完成、参数保留；用户接回UART并选择Real UART后现场验收仍待完成。没有执行实体电机、巡游或识别测试，不能认为串口损坏根因已消除。固件改动尚未提交Git。

证据：[上传记录及产物SHA256](./evidence/scan-handoff-20261004/upload-v019-v69.json)、[上传后HTTP状态](./evidence/scan-handoff-20261004/esp-v019-after-upload.json)。本轮只读取保存证据并统一更新文档，没有连接设备。

#### 记录054 · 2026-10-04：日志26命令回环、交接重试耗尽与停车未确认

来源：[原始日志](项目日志.md)，第553行；原主题：2026-10-04：日志26命令回环、交接重试耗尽与停车未确认。以下为该记录原文，状态按记录日期理解。

已保存并核对[ESP0.23日志26](./evidence/scan-handoff-20261004/esp32-log(26).json)，窗口64018–85391ms，前840事件已覆盖。本次仅诊断，没有修改、上传或启动电机。64022/65000ms仍正常收到运动MS/MD，STOP143/149获确认，SETTLE→CAT_CHECK→ALIGN_CAT运行。66074ms扫描155（generation32）开始，66088MS、66179MD2/2后没有有效新VQ，scanStep=0，后续大量UART_BAD_FRAME。

73681/74681/75683ms按同身份执行交接恢复1/2/3；73687/74687ms完整C155 SR32 2 255 71 0*4F出现在UART_LOOPBACK，75063ms GET_TELEMETRY157也原样回环。76684ms流程进入FAULT，76685ms发送STOP158，76689ms原样回环；76985/77285/77586ms重发STOP，也均4ms后原样回环，无DONE158 MOTOR_STOPPED。77886ms STOP_UNCONFIRMED阻止后续电机命令。这里有限恢复和停车保护确实触发，但未恢复出有效交接/停车确认，不是重试机制消除了链路故障。

66848–84848ms仍可收到DIAG M507等诊断，快照lastUnoAgeMs564只能证明近期诊断到达，不能证明命令闭环或扫描正常。68065ms坏帧前缀包含C156、FC及ERROR混合，75689ms有8A AA AA等非ASCII。支持命令回环/帧损坏；具体是否线路短接、电平转换、干扰或接收实现异常尚未证明，不断言设备重启、缺电或两个行为同时控制电机。不能将自身命令回环当作Uno确认，也不能以放宽STOP保护处理。

快照catFailure的scan result=3、at24252ms属于更早缓存，本窗口无法重建该轮；本次主要故障是交接超时后停车回执仍未返回。后续应核查线路/电平转换链路，故障仍未闭环。原始快照已保存，本轮未做新的设备操作。

#### 记录055 · 2026-10-04：双USB只读复现——模式切换附近恢复真实通信，随后Uno再次启动

来源：[原始日志](项目日志.md)，第563行；原主题：2026-10-04：双USB只读复现——模式切换附近恢复真实通信，随后Uno再次启动。以下为该记录原文，状态按记录日期理解。

修复会话持续采集COM10（Uno57600）和COM11（ESP115200），程序monitor-dual-readonly.py，启动事件usbWrites=0；本轮仅读取已保存文件，没有设备操作。证据位于[evidence/uart-repro-20261004](./evidence/uart-repro-20261004/events.jsonl)，包含两端COM10.jsonl/COM11.jsonl及原始二进制片段，采集尚在进行，不能将截至当前的状态写成最终稳定性结果。

用户报告拿起ESP对准猫图片立即故障（日志27）、Uno自行重启后仍未恢复，ESP断电后再切Real UART→Simulated→Real UART似乎恢复。这是用户操作/观察。采集事实：柏林17:12:03（UTC15:12:03）COM11断开，17:12:07重新连接；ESP重启后ms7262/7563/7863/8163的STOP6仍全部UART_LOOPBACK，ms8460 STOP_UNCONFIRMED，故这次ESP断电重启并未立刻恢复链路。

柏林17:12:50.261（UTC15:12:50.261）记录MODE SIM_UNO，17:12:52.086切MODE UART；17:12:52.149发STOP26附近，17:12:52.159两端同时记录真实Uno的DONE26 MOTOR_STOPPED，应用时间约11ms，后续真实VISION_ACCEPTED也有双端证据。恢复不是只显示模拟回包。当前源码mode切换停止策略、清调试/遥测/观测状态、注入READY SOURCE_CHANGED并发STOP/SESSION_STOP/GET_CONFIG，没有重新begin硬件UART。只支持“切换附近真实通信恢复”，不能直接归因为硬件UART重初始化或状态机重叠。

柏林17:15:30.257（UTC15:15:30.257）Uno在TB225中途出现大量00，随后READY UNO_CAT_V6.9和DIAG_BOOT STAGE=74 CMD=225，确认采集中又出现启动。首启动在17:11:16紧邻USB打开，不排除打开端口复位；第二次启动与此相隔数分钟，用户报告为自动重启，但触发根因仍未知。STAGE=74是残留执行步骤，不是复位原因寄存器，不能据此认定声光函数导致重启。

日志27的诊断交接记录：VR164（scan163/step1/gen26/result0/frame561）发送后6ms原样回显，重复VR与遥测同样回显；Uno仍发VQ、DIAG及115637ms SD163/26 result3超时。STOP173回显而无DONE，最终STOP_UNCONFIRMED。问题包括命令闭环损坏和Uno再次启动，不能把诊断在线等同链路正常。尚无针对这次复现的新固件修改/上传，供电、移动导致的线接触、电平转换/串口收发及软件状态根因继续待定位，暂未判定缺电、短接或程序重叠。

#### 记录056 · 2026-10-04：日志28当前通信已恢复，界面仍显示锁存的Uno link timeout

来源：[原始日志](项目日志.md)，第575行；原主题：2026-10-04：日志28当前通信已恢复，界面仍显示锁存的Uno link timeout。以下为该记录原文，状态按记录日期理解。

已保存[日志28](./evidence/scan-handoff-20261004/esp32-log(28).json)。ESP0.23快照ms321257、UART/STOPPED、lastUnoAgeMs208、lastRx DONE343 TELEMETRY，lastFault仍Uno link timeout。它反映当前接收新鲜度与历史故障锁存同时显示，不是同一时刻既超时又正常。

完整双USB采集补足了导出覆盖不到的现场：ms259484收到DONE310 TELEMETRY，259485进入CAT_CHECK，修复会话stdout捕获261986/261987发生Uno link timeout，距最后有效消息约2502ms，符合活动流程2500ms门槛。262897ms STOP_CONFIRMED DONE313 MOTOR_STOPPED在真实COM10/COM11均有回报，之后连续遥测恢复。日志28自身窗口从289343ms开始，不能单靠导出重建原故障。

代码有效回报更新lastUnoAt；活动流程超时fail进入STOPPED/FAULT并保留lastFault，STOPPED下策略tick返回，后来通信恢复不会自动清历史FAULT或继续运动。COM10 elapsed309.907的DONE310至313.282下一诊断，采集时间字段相差约3.375秒；这是记录空档，不单独证明Uno停机或ESP阻塞，缓冲/采集调度也需考虑。本次没有新固件修改。

待处理：界面应分开显示当前串口新鲜度、历史故障时间和后续恢复情况；不要暗示仍持续断线，也不应在通信恢复后静默自动恢复运动。短时无有效消息的根因仍待定位。原始双端证据见evidence/uart-repro-20261004/COM10.jsonl、COM11.jsonl；本轮只读保存文件并整理。

#### 记录057 · 2026-10-04：更正架空持续转轮解释，ESP0.24有限通信恢复与RPM停稳条件

来源：[原始日志](项目日志.md)，第585行；原主题：2026-10-04：更正架空持续转轮解释，ESP0.24有限通信恢复与RPM停稳条件。以下为该记录原文，状态按记录日期理解。

用户明确日志29在架空平台测试，看到车轮持续旋转。此前将停车后编码器增量解释为滑行属于过早推断，不能记录成车辆地面滑行原因。已核对[修复说明](./esp32-host/通信恢复与停稳检查-20261004.md)：ms426645 STOP475确认、426646进入SETTLE，后续编码器增量/RPM非零，确认后没有新运动命令；但这不能证明实际电机输出已归零，也不能解释持续旋转。日志导出时找猫已因alignment budget exhausted结束并转回标签巡游，导出的scanPhase=SETTLE属于另一扫描，不能当作旧猫复核阶段。

用户又报告STOP_UNCONFIRMED时重接ESP TX/RX、按紧转换器LV/RV通道无效，Real→Sim→Real再次恢复。日志30记录771205ms SIM_UNO、773355ms UART、773486ms真实STOP669确认；之前STOP639回显、671142ms STOP_UNCONFIRMED及坏帧由完整双串口另行保留。模式切换的软件状态恢复值得优先检查，不能由这些操作排除硬件，也不能将模拟回复当真实恢复。

ESP0.24代码实施：活动流程通信超时/停车未确认最多3轮恢复，清旧运动/扫描/视觉请求、半行、紧凑遥测、调试和观测，保持UART；每轮严格确认STOP→SESSION_STOP→GET_CONFIG几何→SESSION_START各自真实匹配DONE，诊断/旧回报不能放行。成功后重找猫或当前标签，保留分支/轮数，不重放旧距离运动；操作者停止或切模式取消自动恢复，Uno READY仍按重启故障。此为有门槛的主动恢复，取代前文仅保持停止不自动续流程的旧实现，不是无条件恢复运动。

停稳检查增加两侧RPM为零条件；CAT_CONFIRM每250ms遥测，非零转速重新停车和复核计时。原条件仅短时间计数不变可能放行，这一检查缺口已修；编码器/RPM逻辑仍不等于物理已停稳。

离线实际policy826、连续互动252、PWM/设置2640、扫描259及CRC/视觉检查通过，网页21测试通过。修复会话最终固件仍在编译，尚未上传0.24；持续转轮、命令回环和Uno自发重启根因及实体恢复均待测，不写成已解决。本轮只统一文档，未改固件或操作设备。

#### 记录058 · 2026-10-04：ESP0.24最终编译、上传和新只读采集

来源：[原始日志](项目日志.md)，第597行；原主题：2026-10-04：更正架空持续转轮解释，ESP0.24有限通信恢复与RPM停稳条件。以下为该记录原文，状态按记录日期理解。

更新上节“仍编译/未上传”阶段状态：修复会话已完成ESP0.24上传，Uno未改、仍6.9。最终构建Flash3740706/8257536、静态RAM78976/327680、应用BIN3740848字节。上传会话记录先读0x8000现有3072字节分区表与构建一致，随后仅写0x10000应用区，46.6秒，Hash verified、RTS reset。

本轮核对[上传前状态](./evidence/uart-repro-20261004/esp-v024-before-upload.json)、[上传后状态](./evidence/uart-repro-20261004/esp-v024-after-upload.json)和[分区回读](./evidence/uart-repro-20261004/partitions-before-v024.bin)：HTTP保存快照版本ESP32_CAT_HOST_0.24、IDLE/SIM_UNO，逐项比对原config字段，变更键0。测试需用户选择Real UART；没有主动开电机做实体恢复/停稳验收。

离线826策略、252连续互动、2640设置/PWM、259扫描及视觉/CRC检查通过，网页21通过。新双USB只读采集已启动并保存至evidence/uart-repro-20261004/post-v024；重新打开USB后捕获的启动不能直接当作自发复位，采集仍在进行，未统计最终稳定时长。本轮只读已保存证据并补日志，不启动或停止采集。

最新结论：恢复机制与RPM停稳判定缺口已修改并上传，持续转轮、Uno自发复位和命令回显根因尚未证明已修复，物理行为仍待验收。

#### 记录061 · 2026-10-04：日志32停车失败后遥测被保护层拦截，ESP0.26保留只读诊断

来源：[原始日志](项目日志.md)，第623行；原主题：2026-10-04：日志32停车失败后遥测被保护层拦截，ESP0.26保留只读诊断。以下为该记录原文，状态按记录日期理解。

已核对[停车失败时保留遥测说明](./esp32-host/停车失败时保留遥测-20261004.md)。日志32的ESP0.25在STOP101未确认后92913ms自动恢复；STOP104/106/108均UART_LOOPBACK，无有效停车完成回报，96587ms三轮恢复失败。GET_CONFIG和SESSION同步未到达，不能说完成同步后仍故障。

97790ms再次停车未确认，99792ms GET_TELEMETRY114和106793ms GET_TELEMETRY115被TX_BLOCKED：flushTx保护把只读查询一起拦截，导致界面全部遥测过期。已明确此软件阻断，不能据界面无读数判所有传感器坏；物理链路当时也有回环，不保证放行查询就能收回真实数据。

108826ms手动切SIM_UNO，108827ms发送原UART模式已排队的物理STOP116，108838ms取得真实MOTOR_STOPPED；111037ms才切回UART，STOP128亦确认。双USB有真实回包，恢复发生在切回真实UART之前，不能简化成切回UART重初始化修好。源码mode切换没有重新begin硬件UART；与自动恢复差异的时序/软件状态/外部链路原因仍待查。

ESP0.26代码新增严格只读白名单：停车未确认时允许STOP以及GET_TELEMETRY、GET_CONFIG、PING，拒绝尾随字段/伪装查询；只读不清stopPendingId/stopUnconfirmed、不重启停车计数、不放行运动、SESSION_START或写配置。停车等待仍优先停车，失败后才放行只读诊断；坏帧/无回复仍显示过期，不填假数据。

818实际策略、252连续互动、2640设置/PWM、259扫描及视觉/CRC检查通过。最终固件正在编译，尚无本轮上传完成证据。修复范围仅取消不必要的查询阻断，UART_LOOPBACK根因及自动恢复失败仍未解决，无实物验收。本轮只补文档，不改固件或操作设备。

#### 记录062 · 2026-10-04：用户确认18:05:31 Uno自发重启；日志33补齐FAULT后的恢复入口

来源：[原始日志](项目日志.md)，第635行；原主题：2026-10-04：日志32停车失败后遥测被保护层拦截，ESP0.26保留只读诊断。以下为该记录原文，状态按记录日期理解。

柏林18:05:31（UTC16:05:31），post-v025/COM10.jsonl记录DONE1413 TELE后大量00紧接READY UNO_CAT_V6.9、DIAG_BOOT STAGE=24 CMD=1413。用户明确当时没有按RESET或断电，记录为本次自行重启，不归因手动操作。STAGE=24仍为执行残留线索，不是复位原因；也不能把本次自发重启与UART_LOOPBACK认定同一机制。

日志33现场版本仍ESP0.25：VR1257/1258/1259/1262/1263及GET_TELEMETRY1260回显，894562ms标签扫描result3先进入FAULT；STOP1264首发及3次重发全部回显，895763ms停车未确认。旧恢复hook因已STOPPED跳过这条路径。908481ms切SIM时物理STOP1270确认，909763ms切回UART STOP1281确认；这是另一次模式切换附近恢复，不证明根因。

0.26代码追加修复：非operator_stop且非已穷尽恢复的FAULT停车失败，也可进入有限通信恢复；成功后仍保持原FAULT/STOPPED，不自动运动。排除恢复耗尽故障，避免无限重启恢复。实际策略回归830检查通过，扫描259、连续互动252、设置2640及CRC/视觉通过，替代前文0.26中间818检查的记录。新增头引发依赖重编导致首次构建较慢，最终构建/上传仍未完成，不能把现场0.25日志当修复后结果。本轮仅核对保存日志、统一追加文档。

#### 记录063 · 2026-10-04：ESP0.26／Uno6.10部署完成，补记空运动STOP清零缺口

来源：[原始日志](项目日志.md)，第643行；原主题：2026-10-04：ESP0.26／Uno6.10部署完成，补记空运动STOP清零缺口。以下为该记录原文，状态按记录日期理解。

最终ESP0.26构建Flash3741398/8257536、静态RAM78992/327680、BIN3741552；仅应用0x10000写入46.5秒、哈希验证通过。保存HTTP回读0.26、IDLE/SIM_UNO，本轮逐项核对旧config变更0、最低PWM255。最终实际策略831、扫描259、连续互动252、设置2640、CRC/视觉检查及网页21通过，替代前文0.26中间测试数。证据位于evidence/uart-repro-20261004/post-v025：esp-v026-before-upload.json、esp-v026-after-upload.json、upload-v026.txt。

补记真实遥测：上传前明确STOP后DATA1815右轮请求0、应用220、PWM220、方向GPIO0/0，两侧RPM0；后续DATA1901两侧应用0。这是软件appliedMotor值，不是电压/驱动电流测量，不能直接判实际持续带电。用户猜最低PWM25，板上回读255；ESP pwm_floor与Uno setMotorSide仅提升非零请求，0仍0，不能仅据下限解释220。

独立源码缺口已明确：abortMotion在MOTION_NONE时提前返回，跳过stopOutputs，STOP处理器仍回MOTOR_STOPPED。Uno6.10将stopOutputs移到空运动返回之前，保证STOP/SESSION_STOP等路径先清零。它是修复事实，不代表已证明是220或持续转轮唯一原因。构建32254/32256字节Flash、静态RAM1379/2048；为容量将启动诊断EVENT UART_SOFT_RX D12 BAUD=57600 TX=D1缩为EVENT UART_SOFT_RX D12 57600 TX=D1，控制协议未变。

用户确认拔掉板间UART后，修复会话COM10 arduino-cli upload --verify成功退出0；首attempt not in sync resp0x66后完成。upload-uno-v610.txt仅保存同步警告与端口信息，成功退出码由执行会话记录提供，不能把这份简短文本称为含完整逐字节验证明细。新只读采集post-v026-uno610有有效诊断心跳，未捕到新版完整READY行，不能写启动banner已确认；该会话采集session65719。不在本日志会话操作或停止采集。

最新状态为ESP0.26、Uno6.10上传完成，用户接回UART、选择Real UART后实体验收仍待进行，未主动开电机。最终FAULT诊断恢复路径只确认STOP→SESSION_STOP→配置，成功仍FAULT/STOPPED，不发SESSION_START；活动流程恢复的启动契约另行保留。UART命令回显、自发重启以及实际电机输出根因继续待测。

#### 记录066 · 2026-10-04：日志34自动恢复配置漏解析，用户声光体验反馈与只诊断边界

来源：[原始日志](项目日志.md)，第677行；原主题：2026-10-04：日志34自动恢复配置漏解析，用户声光体验反馈与只诊断边界。以下为该记录原文，状态按记录日期理解。

用户反馈自动恢复失败、手动SIM→UART恢复，明确先不要改代码；本轮互动/探索声光整体感觉没有问题，要求本地Git提交、不推远端。该反馈仅为当次声光互动体验，不等于自动恢复或整机长期稳定通过。本日志追加后暂不继续编辑，供实施会话统一提交；本日志会话未执行Git提交或推送。

已核对当前实际policy.cpp及[evidence/log34-diagnosis离线复现](./evidence/log34-diagnosis/reproduce.txt)：配置DATA解析只接受action WAIT_PATROL_CONFIG，忽略LINK_RECOVERY_CONFIG。日志34第三轮203187ms发STOP268、203198停车确认；203233 SESSION_STOP270确认；203259 DATA271 CONFIG正确包含wheel67.5/track120、左右安全1/1，但geometryConfirmed未置true；203263 DONE271后203265立即恢复失败。实际核心离线复现普通启动同包geometryConfirmed=1，而恢复同包geometryConfirmed=0并STOPPED/FAULT。明确是一条恢复状态未接入解析的代码缺口，当前尚未修复。

双USB post-v028/capture/COM10.jsonl在柏林19:03:42.807（UTC17:03:42.807495）保存真实DATA271及DONE271*3A，不能说这轮Uno完全不回报。前两轮STOP未确认有UART_LOOPBACK，期间心跳/SD仍收到；第三轮则已走到配置回报后软件漏消费。两类断点分开记录。

采集另见柏林19:02:34.073 READY UNO_CAT_V6.10、DIAG_BOOT STAGE74 CMD94；用户随后确认没有碰过Uno，属于运行期间非人工触发重启。采集开始19:00:46.507751，启动19:02:34.073058，相隔约107.6秒，不是刚打开采集立即出现的启动。STAGE74/CMD94仅作面包屑，不证明蜂鸣器、程序或供电根因。配置解析缺口、UART回显/坏帧和此启动原因不认定同一机制。本轮不修改/烧录或启动实体电机，现场仍0.28；诊断报告与精简证据由实施会话补在esp32-host/自动恢复失败诊断-20261004.md及evidence/log34-diagnosis，大抓取留本地，追加时报告尚在整理。用户本地提交授权不代表同意修复或远端推送。

#### 记录067 · 2026-10-04：日志34非人工重启用户确认与本地版本归档

来源：[原始日志](项目日志.md)，第687行；原主题：2026-10-04：日志34自动恢复配置漏解析，用户声光体验反馈与只诊断边界。以下为该记录原文，状态按记录日期理解。

用户已确认柏林19:02:34没有碰过Uno，上节对应描述已更新为运行期间非人工触发重启。捕获开始19:00:46.507751，READY19:02:34.073058，相隔约107.6秒；不能归为打开采集立即触发。供电、程序、蜂鸣器或其他复位根因仍未知，STAGE74/CMD94仅是执行面包屑。

本轮核对本地Git提交b77a941，保留ESP0.28/Uno6.10已验证互动改动和日志34漏配置诊断。未实施自动恢复配置解析修复；未推远端由提交会话确认。本次用户确认的文档更正等待该会话另做本地提交，本日志会话不提交或推送，修改后保持文件稳定。

#### 记录068 · 2026-10-04：日志35不完整遥测未释放挂起请求，停稳复核缺证据

来源：[原始日志](项目日志.md)，第693行；原主题：2026-10-04：日志35不完整遥测未释放挂起请求，停稳复核缺证据。以下为该记录原文，状态按记录日期理解。

按此前仅诊断要求，未改代码/烧录或控制设备。已核对[日志35报告](./esp32-host/日志35遥测缺帧与恢复失败-20261004.md)与evidence/log35-diagnosis。ESP0.28在493770ms SD679/104 result1找到猫，493783ms STOP681确认、493784进入CAT_CONFIRM；不是未找到猫或未取得此次停车回执。

494022ms查询遥测684，UnoUSB原始抓取完整TB0/1/2和DONE；还原请求/应用PWM0/0、计数846/736、RPM0/0。ESP494046ms坏帧，仅收有效part2，494058ms TELEMETRY_INCOMPLETE。拒绝不完整快照正确，但acceptUno失败直接return绕过telemetryId清零，使请求挂起，!telemetryId门槛阻断250ms轮询。499022ms才5秒超时释放，499273ms发685，距前查询5251ms，随后又回环；499914ms encoder settle unavailable，复核已6130ms，期间触碰变化也影响推进。

新明确缺口为已结束的不完整遥测未释放pending，把一次接收损坏放大成5秒无新查询。它与接收坏帧根因分开；不能由encoder settle unavailable断言电机仍转，Uno该快照确实记录PWM/RPM0，但软件记录也不等于独立物理停稳/电压测量。复核缺少两次新鲜完整样本，不能用旧0值或取消CRC放行。

第三轮恢复再次确认503541ms STOP695、503576ms SESSION_STOPPED697、503602ms正确DATA698CONFIG、503605ms DONE698，503607ms恢复失败；仍是日志34已复现的LINK_RECOVERY_CONFIG漏配置解析，未修。此前回环/坏帧时DIAG和触碰事件仍在，不能称Uno全无回报。故障窗口uptime单调，无新READY/BOOT，不写成又一次重启；历史故障可与后续正常遥测共存。

后续若授权修复，应严格拒绝缺帧同时明确结束/释放挂起查询、限频重取完整快照，并共用正常启动/恢复配置解析；本轮只记录方向未实施。精简证据log35-excerpt.json及uno-replies.json在evidence/log35-diagnosis，完整双USB仍在post-v028/capture。追加后保持日志稳定，供实施会话仅做诊断文档/证据的本地提交，本日志会话不提交或推送。

#### 记录069 · 2026-10-04：用户授权ESP0.29修复恢复配置解析与缺帧挂起，恢复上限四轮

来源：[原始日志](项目日志.md)，第705行；原主题：2026-10-04：用户授权ESP0.29修复恢复配置解析与缺帧挂起，恢复上限四轮。以下为该记录原文，状态按记录日期理解。

保留日志34/35只诊断未修改的历史。用户随后明确授权实施：自动重连增至4轮，修复有效回包仍失败。当前ESP0.29源码已改、Uno不变；初步实际policy1160检查通过，其余检查/完整编译上传继续，尚无实物恢复结果。本轮代码Git待用户实体验收后提交，不把实施开始记成已解决。

恢复上限由3改4；正常启动WAIT_PATROL_CONFIG和LINK_RECOVERY_CONFIG共用配置DATA解析，要求当前请求ID匹配、完整6字段、有限数值、轮径20–150mm、轮距50–300mm、每圈20脉冲、左右安全距离1–100cm。合法DATA+匹配DONE继续恢复，缺失/非法配置仍不放行。新增真实DATA+DONE序列测试，去掉旧恢复测试手工置geometryConfirmed=true的绕过，使回归覆盖实际解析。

同时修日志35：收到已通过校验、匹配当前ID的遥测DONE后，即使快照缺帧也结束挂起事务并释放telemetryId，按当前策略轮询间隔限频重试；仍不发布部分快照，不取消CRC、不放宽停稳新样本要求。坏帧没有可信DONE的情形不冒充事务已完成。该修复针对错误处理的5秒放大效应，接收坏帧/命令回环和Uno自发复位根因仍待定位。

本轮日志会话只核对正在修改的源码并整理实施状态，没有编译、烧录、运行电机或替实施会话提交。最终测试数、构建/上传及用户恢复验收另行追加。

#### 记录070 · 2026-10-04：ESP0.29最终验证与上传完成，四轮恢复实体表现待测

来源：[原始日志](项目日志.md)，第715行；原主题：2026-10-04：用户授权ESP0.29修复恢复配置解析与缺帧挂起，恢复上限四轮。以下为该记录原文，状态按记录日期理解。

已核对[实施报告](./esp32-host/重连四轮与遥测重试-20261004.md)及[验证记录](./evidence/uart-repro-20261004/post-v029/verification.json)，更新前节编译上传待完成状态。最终ESP构建Flash3744414/8257536（45%）、静态RAM79000/327680（24%）；COM11仅写0x10000应用3744560字节，46.5秒、Hash of data verified。HTTP保存回读ESP32_CAT_HOST_0.29、SIM_UNO/IDLE，上传前后88项配置一致、stopPendingId0、stopUnconfirmed=false。Uno未修改或上传，仍6.10。

原生实际policy1160、连续互动252、扫描259、设置/PWM2640及CRC/视觉门检查通过，网页23通过；DONE TELEMETRY严格格式另覆盖错误编号/结果、多余尾字段及无pending时不释放其他事务。停稳/复核/恢复限频重询250ms、普通2000ms，缺少可信DONE仍按超时处理，不发布缺帧快照。历史log34复现脚本针对旧代码，不能直接作当前修复验收标准。

构建、上传和前后state保存于evidence/uart-repro-20261004/post-v029；只读COM10/COM11捕获由实施会话重新开启至capture子目录，writes0。四轮自动恢复实际表现仍待用户复测，未认为UART电气噪声、回环或Uno自发重启根因已消除。本轮代码尚未Git提交，按用户要求实体验收后再提交；本日志会话只更新文档，不提交Git、不操作设备或采集。

#### 记录074 · 2026-10-04：STOP_UNCONFIRMED历次综合分析与日志38持续命令无响应

来源：[原始日志](项目日志.md)，第755行；原主题：2026-10-04：STOP_UNCONFIRMED历次综合分析与日志38持续命令无响应。以下为该记录原文，状态按记录日期理解。

本轮仅离线分析，不改代码、不提交Git、不操作设备/浏览器/Computer Use。完整说明见[停车未确认综合分析](./esp32-host/停车未确认综合分析-20261004.md)，索引/统计见[evidence/stop-unconfirmed-analysis](./evidence/stop-unconfirmed-analysis-20261004/snapshot-summary.json)及log38-timeline.json。统计窗口不等于独立故障次数或丢包率。

STOP_UNCONFIRMED表示当前STOP编号缺少可信CRC匹配MOTOR_STOPPED，不等同实测轮子未停。26/27/32/33/34/35窗口各有7/10/12/10/12/10条完整自身命令UART_LOOPBACK并伴坏帧，回显不是ACK，不能当执行成功。34/35另有旧恢复配置漏消费及缺帧pending约5251ms不释放，已由0.29修复；Uno6.10空运动STOP跳过清零是“可能回DONE但输出未清”的独立缺口，不能解释全部无DONE。非人工READY重启有COM10及用户确认，但供电/具体代码步骤根因未证明。

日志38实验版3窗口248586–282142ms：252780遥测超时，253768 STOP155首发，三次重发后254972停车未确认；恢复四轮STOP158/160/162/164均无回包，259865耗尽。初始加四轮共5编号20次写出，253768–259863约6.095秒，fail再发STOP166不计入这20次。窗口10条STOP_UNCONFIRMED包括恢复/手动重试，不是10次独立物理故障；两次SIM→UART的STOP182/197也无确认。

61条UNO_RX全为DIAG，没有AK/DONE/TB/ERROR；Uno uptime1030019→1063019单调，无READY/下降；循环约6100次/秒、内存M507/507/flags0、PWM0、latch0，RX溢出累计2不变/丢弃0。支持Uno运行及诊断回传仍活跃、命令事务无响应；0ms最大循环耗时是整毫秒采样，非真正零。无新回显/CRC错不证明链路健康，PWM0诊断不代替正式停车确认或电压测量。起因被160条环形窗口覆盖，不写本次又重启、猫识别卡死或旧CONFIG解析再漏消费：恢复尚未取得STOP回复。

定位范围为ESP发送→转换/接线→UnoD12接收/组帧/命令执行→D1回包→ESP校验闭环，尚不能定点。resetLinkState只清ESP应用状态，不复位Uno、不end/begin硬件UART。更多重试不能修复持续失效通道；建议下一轮对照同编号STOP，记录D12字节/完整行/合法命令/CRC拒绝数及D1输出，必要时测引脚波形。本轮建议未实施，当前根因仍未闭环。

#### 记录117 · 2026-10-06 通信失败导致互动回退审计（仅记录，未改固件）

来源：[原始日志](项目日志.md)，第1223行；原主题：2026-10-06 通信失败导致互动回退审计（仅记录，未改固件）。以下为该记录原文，状态按记录日期理解。

检查0.40.1维护分支9dfc6b2与0.42 main c45e66a的ESP传输、policy错误出口、Uno扫描/运动、调试与网页入口。完整清单见《通信失败回退与重试审计-20261006.md》，分直接结束互动、停机/恢复丢进度、正常保护三类，证据evidence/communication-audit-20261006/。

本地08:01导出boot4459f5864ed3b973：370348ms发15cm接近，370914ms收到MD303左右14脉冲，370927msSTOP确认，370928msSETTLE。371165ms遥测307无结果，376167ms超时，376418ms重查308，376436msERROR0 BAD_CHECKSUM，376930ms停稳不可用却catFailed结束，377005ms进入找标签。该段心跳继续到达，不能证明有效遥测健康。原07:13附件属于较早固件，不混算。本boot记录遥测超时13、UART坏帧21、协议错误4、STOP未确认4、链路恢复2、运动失败1、找猫失败1；运动失败另为ENCODER_STALL，与该段分开。

建议先区分ABSENT与UNAVAILABLE：数据失败保持停止并有界重取，耗尽进入FAULT，不冒充找猫失败；补关键遥测截止期、有效观测健康监测、保留互动动作/距离/扫描预算的恢复上下文，再补视觉/配置重查。STOP、SC/SR、扫描交接已有有界重试。普通DRIVE/ROTATE不能直接重发，需先补Uno事务去重/结果查询。仅静态审计与导出日志核对，没有新测试、设备操作或烧录，0.41/0.42继续未烧录。

## 03 · 运动控制、扫描与目标恢复

**发展脉络：** 断续巡游改持续驱动→扫描停稳与预算→区分最低PWM与请求速度→标签短暂丢失的宽限和方向恢复→双轮编码器直行平衡。

**目前结果与边界：** 停稳超时曾在MD后3ms出现，修复时间下溢；停止后的异常计数不能当车身转角。恢复默认宽限1000ms、局部60°，共享有界预算；Uno V6.12只降低直行较快轮，部署回读通过，实车侧偏量化待测。

**能力提炼：** 运动闭环、时间与状态边界、目标记忆和受限恢复；把底层走偏预防与上层丢失找回组合起来。

关联其他主题：[记录115](#record-115)、[记录134](#record-134)。

### 本章记录索引

| 记录 | 原始日志标题 |
|---|---|
| [004](#record-004) | 节点三：改掉断续巡游与动画转回 |
| [009](#record-009) | 节点一：定位巡游摇晃，调整视觉频率与转速 |
| [022](#record-022) | 2026-10-03：按用户要求收敛为正常巡游的前向避障开关 |
| [023](#record-023) | 2026-10-03：自动识别、逐步启动与 ESP 单独负责前向制动 |
| [026](#record-026) | 2026-10-03：移除 PWM 下限，暂停现场测试，整理状态机交接 |
| [032](#record-032) | 2026-10-03：ESP0.13网页动态最低PWM |
| [034](#record-034) | 2026-10-03：Uno V6.7 停稳计时修复与 ESP V0.14 等待时间设置 |
| [101](#record-101) | 2026-10-05：双轮扫描预算与停稳后的标签多帧识别（Uno 6.11 / ESP32 0.38，未上传） |
| [110](#record-110) | 2026-10-06：旋转跳步／漏看标签日志诊断（未修改固件） |
| [111](#record-111) | 现象、可复算证据与原因边界 |
| [112](#record-112) | 实现、配置与兼容性 |
| [113](#record-113) | 验证与后续现场指标 |
| [124](#record-124) | 2026-10-07 直行编码器自动调节与 Uno 紧凑解析 |
| [125](#record-125) | 2026-10-07 Uno 直行校正烧录验证与标签丢失的三层处理 |

### 本章完整记录

#### 记录004 · 节点三：改掉断续巡游与动画转回

来源：[原始日志](项目日志.md)，第35行；原主题：2026-09-30：从空板调试推进到真实电机测试。以下为该记录原文，状态按记录日期理解。

**原实现及原因。** 巡游每走最多 12 cm 就停下，重新检查标签、障碍和朝向。这便于早期调试、限制单次动作范围，但把观察与停车绑定在了一起。旧 MOTOR 续期还会先中止旧动作再启动新动作。画面同时按名义速度前移、按编码器校正，会出现转过去又回跳的现象。

**当前 V5.6 实现。**

- 串口画面只使用有效的运动脉冲更新位置，取消网页内的名义速度推进和回退到虚拟速度的路径；绘制平滑与策略位置计算分开。
- 暂不计算打滑；相等的轮速命令按直行或原地转向处理，减少左右脉冲先后到达造成的航向摆动。物理电机依赖真实编码器，纯虚拟电机可使用 Uno 生成的虚拟脉冲，二者来源在读数中区分。
- 前进、后退使用 MOTOR 开启、KEEP 续期、STOP 关闭。续期约每 200 ms 一次，不切断电机输出，不重置运动编号或累计脉冲基准。
- 取消巡游接近目标时每 12 cm 必停的上限，持续行走到停止条件；目标对齐、障碍、触碰和停靠仍可以要求停车。
- 默认提前停止余量 3 cm，可在几何参数区调整。轮径设为用户提供的 67.5 mm，每圈脉冲数当前为 20。
- 硬件页正/反转、策略页前进/后退及左右转按钮改为开/关；同方向再次点击关闭，可组合左右轮，总停止按钮关闭全部。
- 保留 Uno 的 500 ms 电机租约、障碍/触碰/堵转停止；距离动作超过 750 ms 未收到有效运动反馈时由电脑停止。

**状态。** 代码已修改，回报解析、脉冲处理、持续续期及巡游行程检查通过自动测试。尚未操作网页验证，也未完成装轮后的真实巡游验收。

#### 记录009 · 节点一：定位巡游摇晃，调整视觉频率与转速

来源：[原始日志](项目日志.md)，第81行；原主题：2026-10-01 至 2026-10-02：ESP32 视觉调优与真实 Uno 通信联调。以下为该记录原文，状态按记录日期理解。

**现象与原因判断。** 模拟器行走途中左右摇晃后继续前进。审计日志约 38 秒处出现多次左右交替的 MOTOR 指令，随后恢复直行。标签对准逻辑使用固定转速，模拟视觉约每 180 ms 更新一次，结合代码判断存在纠偏过冲；日志没有逐帧标签位置，不能完整还原偏差。真实固件此前每次识别结束还等待 1.5 秒，观测间隔包含处理耗时。

**改动与验证。** 提高视觉识别频率；将搜索标签、对准标签转速加入电脑 USB 测试页和 ESP 网页，默认分别为 PWM 45、30，可调范围 30–150，支持持久保存。最终版本已烧录，短时实测标签约 2.12 次/秒、猫约 2.21 次/秒、双识别约 1.49 次/秒。这些是当次测量，不是固定性能保证。实车摇晃是否消除仍需现场验证，本次不记录为已完成自适应纠偏算法。

**固件容量。** 使用正确的大应用分区、开启 OPI PSRAM，并无损压缩网页，固件减少 3180 字节；保留现有模型与功能。编译、COM11 烧录、Flash 校验以及 USB 协议、摄像头、识别和 HTTP 视频检查通过。相关提交：`d55bc6e`（识别频率）、`852f991`（网页转速配置）、`8012778`（容量与烧录验证）。

#### 记录022 · 2026-10-03：按用户要求收敛为正常巡游的前向避障开关

来源：[原始日志](项目日志.md)，第197行；原主题：2026-10-03：补记最新供电、失联排查与前向标定验收方法。以下为该记录原文，状态按记录日期理解。

本轮优先验证正常巡游：用户已确认车轮架空、车体固定、D12 接回并复位，要求实际电机转动而不是 DRY_RUN。标签节点数量、编号和排列由用户在网页自行保存。按最新澄清，撤掉未上传的专用定点测试准备流程、120 秒限时与整路线单次结束机制，保留正常巡游到达后切换下一节点、末尾循环的行为。

ESP32 0.8 增加 frontAvoidanceEnabled（默认 true，停止后修改，持久保存）。关闭时 ESP 前向门禁不再阻止运动，同时用已有 CAMERA_FRONT CLEAR 协议明确替代 Uno 前向控制输入；日志标为操作员关闭检查，不伪造相机观测、不修改 frontCalibrated。左右超声波、触碰、视觉新鲜度、编码器反馈、失速与通信停车保留。LIVE/DRY_RUN 状态不被开关改变。新设备不预设标签路线；已有保存路线保留，每次启动从用户数组首项开始。网页显示板上已保存路线和当前目标，保存路线同步参数文本，避免后续保存参数把新路线覆盖。

75 项 Node 回归通过，包括开关回读、运行中禁用、任意顺序与重复 ID 保存。编译和烧录结果继续补录；尚无实机多标签到达、电机转动验收。只读 HTTP 确認板上仍为 0.7、STOPPED、UART、visionMode OFF，Uno 回报已过期约 20 分钟。已请用户复位；失联问题仍未解决。Uno 复位后还须重新应用并回读轮径/轮距；关闭前向避障不会消除 geometry not confirmed 或通信超时。

最终编译 ESP32 Flash 3678842/8257536、全局 RAM 78304/327680。已上传 COM11，Flash 哈希校验成功，HTTP 回读 ESP32_CAT_HOST_0.8。API 在 STOPPED 状态验证 frontAvoidanceEnabled false/true 保存回读，恢复原开启状态；路线 [0] 与 frontCalibrated=false 未改变。网页含新开关且无专用 bench_patrol_start。证据：esp32-host/front-switch-validation-20261003.json。没有发送 MOTOR，也未完成多标签实机验收。

真实 UART CONFIG 回读发现 Uno 复位后 TRACK_MM=0.0，确认这也是 STARTING 后 geometry not confirmed 停止的原因之一。先同步 ESP 已保存轮径 67.5 mm / 轮距 120 mm 并收到 SET_GEOMETRY 对应 DONE 与 CONFIG（证据 patrol-geometry-readback-20261003.json）。随后用户明确要求“轮距默认设置为120mm”，将 Uno trackWidthMm 默认改为 120.0f，两份源码同步且 SHA256 一致。Uno 编译 Flash 30956/32256、全局 SRAM 1237/2048；已上传 COM10。上传期间切到 SIM_UNO 暂停真实查询，完成后恢复 UART。初次 8 秒验收窗口未满足回读条件，后续实际 CONFIG 确认 WHEEL_MM=67.5 TRACK_MM=120.0，策略 STOPPED、LIVE、电机 0；未在本次上传后再发送 SET_GEOMETRY，因此回读对应固件默认值。证据 esp32-host/uno-default-track120-20261003.json。120 mm 是用户指定默认值，不是此次实测；失联长期稳定性和用户展示多标签的正常巡游仍待现场测试。

#### 记录023 · 2026-10-03：自动识别、逐步启动与 ESP 单独负责前向制动

来源：[原始日志](项目日志.md)，第211行；原主题：2026-10-03：补记最新供电、失联排查与前向标定验收方法。以下为该记录原文，状态按记录日期理解。

用户报告启动不自动开启识别、测试电机能动但巡游仍 STARTING 后 STOPPED。只读现场记录在 patrol-live-observe-20261003.json：启动时出现 ERROR 0 BAD_ENVELOPE/BAD_CHECKSUM，随后 geometry not confirmed；并非证明默认 120 mm 未生效，实际为该次 GET_CONFIG 未成功确认。ESP 0.9 改为依次等待 STOP、匹配当前请求编号的 GET_CONFIG DATA/DONE、SESSION_START；准备阶段暂停自动遥测，阶段超时最多重试两次。启动/恢复在 OFF/CAT 时自动启用 BOTH，TAGS/BOTH 保留。运行时传感器查询改为每秒一次，独立 KEEP 仍每 200 ms、MP 反馈每约 100 ms。网页增加不会被 160 行日志滚动覆盖的步骤、最后 FAULT 和动作拒绝原因。

按用户进一步明确要求，Uno V6.2 删除前向 motionSafetyReason 门禁；ESP 独立判断前向并发送 STOP。正常巡游/手动控制不再周期发送 CAMERA_FRONT，旧协议输入仅留兼容遥测。侧向超声波、触碰、失速、MOTOR 租约及急停保留。两份 Uno 源码同步。ESP 编译 Flash 3680570、全局 RAM 78336；Uno Flash 30734、全局 SRAM 1237。两端已上传 COM11/COM10，ESP Flash 哈希确认并 HTTP 回读 0.9。既有 75 项 Node 回归和新增固定故障显示用例通过（新增页内用例 10/10）。

此前授权的架空轮短测证据 patrol-start-v09-validation-20261003.json：自动 BOTH；STOP20/GET_CONFIG21/SESSION_START22 依次得到回报并进入 PATROL，MOTOR26 返回 MS，MP 左/右脉冲从 0/0 到 6/36。首次 MOTOR24/STOP25 附近仍出现 BAD_CHECKSUM，不能宣称串口稳定性修复。随后左脉冲保持 6 超过 1200 ms，触发 ENCODER_STALL；不能仅据此区分低驱动力停转与编码器漏报。PWM150 对比因执行前状态检查不满足而未启动，未修改原 PWM。用户随后明确“我来测”，此后仅只读观察，不主动开始测试。

用户报告 DEADMAN_TIMEOUT，表示 Uno 500 ms 内未成功续租；旧日志已滚动丢失，无法判断该次 KEEP 未发、丢失或校验失败。随后用户报告 tag search exhausted id=41：正常策略在搜索满 360° 编码器估计或超过 searchTimeoutMs=15000 时停车。最新用户保存路线为 [41,47]，没有由助手改写；只读相机帧检测到 27、28、33、34、39、40，当前没有 41/47。更新快照又显示 no checked encoder feedback for 750ms，且最近动作拒绝为 SIDE_RIGHT_OBSTACLE_OR_SENSOR_INVALID，这些是不同停车条件，不能混为前向检查。多标签实机全流程、长期 UART 稳定性、编码器/驱动问题尚未完成验收。

#### 记录026 · 2026-10-03：移除 PWM 下限，暂停现场测试，整理状态机交接

来源：[原始日志](项目日志.md)，第245行；原主题：2026-10-03：移除 PWM 下限，暂停现场测试，整理状态机交接。以下为该记录原文，状态按记录日期理解。

用户授权移除 120 PWM 下限、上传并分级测量。Uno V6.5 将 MOTOR_MIN_DRIVE_PWM 从 120 改为 1，两份 Uno 源码同步；编译 Flash 30774/32256、静态 SRAM 1307/2048，已通过 COM10 上传。ESP 保持 0.11。移除下限不证明低 PWM 能启动电机，实际最低启动／维持 PWM 尚未测得。USB app.mjs 仍按 V6.4 精确握手，列为后续兼容修复项。

分级脚本 pwm-characterize.py 第一次因 pyserial 导入失败未启动采集，补入已有 vendor 路径后再次执行被用户中断。用户随后明确 Uno 失联、本人不在设备旁不能复位，要求停止测试并先整理状态机。本次取消后本地进程检查未发现仍在运行的该脚本，也未发现可确认的分级测量结果文件；此后未再发送设备命令、复位或烧录。不能宣称分级测量完成或失联已修复。

新增“机器人状态机与测试清单.md”和“新会话实施提示词.md”。前者列出全局／巡游／主动猫互动／猫触发声光探索／捕猎逃离／结束捕获以及 Uno 扫描内层状态，明确侦查旋转、纯指定角度旋转和持续 MOTOR 的使用位置与控制归属，并给出四张 Mermaid 图、实施 To-do 和测试矩阵。后者可直接复制到新会话，携带设备离线限制、源码路径、当前版本、核心缺陷和验收条件。

计划尚未实现：Uno 分步转动—停稳—请求 ESP 新帧识别；标签 SEARCH／FOUND／APPROACH／REACQUIRE／到达停车拆分；正确 ID 一出现即找到，停止大小单独可调、无需居中；靠近自动持续识别；猫触碰抢占和旧视觉结果失效；逃离用 Uno 本地角度／距离执行。新到达大小默认值和未知输入下逃离规则仍未决定，不写死。当前 tagStopWidth 是宽度比例，不是面积比例。

只读代码核查确认 ESP angle() 多除一个 PI、搜索和接近共用预算、声光部分参数核心硬编码等，已列入清单。既有 BOTH 样本耗时 477–531 ms、相机缓存约 5.06 fps；后者不能当识别 fps。以轮径 67.5 mm／轮距 120 mm／20 脉冲推导，两轮对转各一脉冲理论约 10.125°，不是已测角度精度。以上文档不替代源码实现、实机多标签／猫互动验收或长期失联调查。

#### 记录032 · 2026-10-03：ESP0.13网页动态最低PWM

来源：[原始日志](项目日志.md)，第318行；原主题：2026-10-03：ESP0.13网页动态最低PWM。以下为该记录原文，状态按记录日期理解。

用户要求供电变化时可以在ESP网页调整最低驱动PWM，当前测得140。本轮增加 minimumDrivePwm：默认140、整数1–255，已有保存值优先，沿用ESP NVS配置保存/启动合并路径。网页确认停车且无测试/配置事务后才能保存，显示板上值，轮询不覆盖未提交的草稿，保存前不冒充已生效。0、256、小数及非数值拒绝。

ESP sendUno在CRC封装前统一提高有效非零PWM幅值，正反符号与0不变，覆盖MOTOR、TEST_MOTOR、DRIVE、ROTATE、SR/SCAN_ROTATE及旧MOVE/TURN。其他参数（距离、角度、时长、扫描键/预算/flags）保持。请求95且下限140生成140；下限100生成100；请求210保持210；0始终停车。原始非法PWM不修补成合法动作，交由Uno拒绝。新增PWM_FLOOR日志，策略快照保留请求值并显示下限调整后的命令值。修改在停车时保存，后续动作立即使用，无需再次烧录；要测更低值先下调下限。本次Uno源码无改动（V6.6自身下限1）。

自动化由 tests/run-native.ps1 用Zig0.14.1将实际共用C++核心编译成Windows程序后运行，实际ArduinoJson7.4.3，时钟/IO替换：PWM与配置校验2603项，实际policy.cpp442项，Uno扫描199项，实际VisionGate/CRC通过。Node88项通过，网页脚本运行于模拟DOM/接口输入；没有打开真实网页、发送设备命令或运行电机。测试不证明实际NVS写入、重启保留、供电启动值或整机效果。

本轮完整ESP固件另由实际ESP32-S3编译链构建通过：Flash3717266/8257536 bytes，静态SRAM78792/327680 bytes，应用BIN3717408 bytes。源码/产物哈希及测试口径见offline-pwm-v013-20261003.json；不覆盖前一0.12报告。用户最新明确报告固件已编译完成、本人正在上传，要求提交Git；这不是上传成功或实体测试通过的证据。助手未上传/RESET/界面/运动。最低PWM现场测试追加统一验收记录第5节，全部结果待用户回报。RESET和后续界面/运动仍由用户完成。

#### 记录034 · 2026-10-03：Uno V6.7 停稳计时修复与 ESP V0.14 等待时间设置

来源：[原始日志](项目日志.md)，第336行；原主题：2026-10-03：Uno容量与手动IDE上传配置。以下为该记录原文，状态按记录日期理解。

只读现场采集确认46、40均能到达；抓到停车完成后3ms返回停稳超时，发现loop旧now与finishMotion新millis相减的缺陷。修复新时间采样并防止旧采样无符号下溢；新增独立scanMinimumMs网页设置，保留NVS及PWM值。自动化扫描215项、策略442项、PWM2603项和网页18项通过，Uno32162字节。配置超时、对准次数耗尽未在这轮重现；实车验收由用户完成。详见esp32-host/停稳计时修复与等待设置-20261003.md。

上传阶段：ESP V0.14应用上传和哈希校验成功，HTTP版本及NVS参数回读通过。Uno V6.7尚未写入：COM10拒绝访问，等待用户释放串口。用户已授权上传自动reset；界面与运动测试仍由用户执行。

后续：用户确认串口已可用后，Uno V6.7 COM10上传成功，32162字节读回校验通过。两块板上传完成；UART接回、页面设置与运动验收由用户完成。

#### 记录101 · 2026-10-05：双轮扫描预算与停稳后的标签多帧识别（Uno 6.11 / ESP32 0.38，未上传）

来源：[原始日志](项目日志.md)，第1011行；原主题：2026-10-05：双轮扫描预算与停稳后的标签多帧识别（Uno 6.11 / ESP32 0.38，未上传）。以下为该记录原文，状态按记录日期理解。

**用户现象与证据边界。** 用户报告：设置的扫描预算为 720°，现场看起来只转约 360°；两侧起转时长明显不同。这里的 360°/720°来自用户观察，本轮没有连接设备或重新测量。修改前基线已先提交为 **6139e88**（源码基线 de87ca2，ESP32 0.37）。

**代码确认的原因。** Uno 原先每步停稳后按 max(左轮增量,右轮增量) 累计“单轮脉冲”，ESP 的 MD、触碰暂停及双侧近距切换也沿用较大侧。角度换算却按两侧等量反转的几何关系计算。因此两侧脉冲不同时，预算会比双轮平均值偏大。实际每步分别等两侧达到目标，完成较快的一侧先停，并非持续要求同样起转时长；起转延迟本身不能证明整个 2 倍转角误差都由旧算法造成。几何、编码器计数、惯性及打滑仍需实测。

**修改。** 找猫、找标签共用的 ScanMachine 改为累计左右轮脉冲之和，再除以 2；保存半脉冲余数，避免每一步取整丢失。惯性增量纳入停稳时的计量，重复握手不再次累计。ESP 的 MD、触碰暂停和双侧近距切换采用相同平均算法；停稳绝对进度回报到达后，迟到的 MD 不再次计量。角度估算为 θ = (ΔL+ΔR) × wheelMm / (20×trackMm) × 180°，限于扫描中左右轮相反方向的控制；trackMm 是两侧轮中心间距，wheelMm 是轮径。67.5 mm 轮径、120 mm 轮距、20 脉冲/转时，两侧各 1 脉冲理论为 10.125°；71 个平均脉冲对应 718.875°。例如左 2、右 1 脉冲：旧算法计 2，新算法计 1.5；连续三步计 4.5，保留余数。中断恢复仍使用整数 SR 预算，余量向下取整，每次恢复可能保守少于 1 个平均脉冲，不把它宣称为实际角度精度。

**协议与配套。** Uno 6.11 的带 CRC 回报扩展为 VQ scanId stepId generation used usedHalf，最后一项为双轮脉冲和。ESP32 0.38 同时接受新格式和旧整数格式；旧格式会记录 SCAN_COMPAT，并在 scanAngleBasis 标为 LEGACY_MAX_WHEEL。新格式标为 MEAN_WHEEL_PULSES，scanMeanProgressConfirmed 表示已收到扩展回报。旧 ESP 不接受扩展 VQ，因此需要配套更新两块板。SC 识别窗口上限从 10000 改为 60000 ms；触碰、失速、停车、停稳失败及总事务 600000 ms 的保护保留。

**标签识别配置。** 新增 tagScanMaxFrames，默认 **3**，允许 **1–10 整数**。网页“每次停稳最多识别标签次数”只在停止且停车已确认时保存；写入现有 NVS config，显示板上配置回读，配置校验拒绝越界或小数。旧保存配置合并新默认值，路线及其他已保存参数继续保留。每次停稳后只找当前路线标签，命中立即回复成功；有效未命中则保持停车，请求新画面，达到上限才发送未找到并允许下一步转动。重复画面、旧 generation/step 不计数；新步骤重新计数，重复 VQ 不清零。无效识别或超时仍停止，不用额外次数掩盖故障。每步窗口为 min(60000, scanVisionTimeoutMs×次数)，默认 9000 ms。

**离线验证。** Node 网页、协议、模拟器、HTTP 通路及状态清单共 **47 项通过**。原生 C++ 覆盖左右不同增量、编码器回绕、半脉冲保留、累计饱和、第二圈仍可找到目标、新旧 VQ、迟到 MD、多帧命中/全未命中、重复画面、超时及触碰打断；最终原生检查数：扫描核心 287、预览 20、策略核心 1193、猫多帧 662、标签多帧与平均计量 429、连续互动 703、配置/PWM 2663；视觉门禁和串口保护专项通过。Uno 正式脚本编译成功：**32244/32256 bytes Flash**（余 12），**1381/2048 bytes 静态 SRAM**（余 667）。新增 -fno-inline-small-functions 容量优化，未删安全逻辑。ESP32 最终编译成功：**3776766/8257536 bytes Flash**、**85376/327680 bytes 静态 RAM**。本轮只做源码、测试和离线编译；没有烧录、串口、网页实机回读、轮子或识别实测。实际转角、起转差、识别改善及实车连续运行均为**待测**。

**计量单位澄清。** 编码器读取始终为左右两侧各自的整数计数。usedHalf 名称指平均单轮计量单位的两倍；实际保存的是整数 ΔL+ΔR，并非编码器能产生半个脉冲。先将每侧脉冲换成轮子走过的路程，再以两侧路程和除以轮距得到反转扫描的车身角度，与使用双轮脉冲和直接计算完全等价。左 2、右 1 个脉冲的整数和为 3，默认几何下估算 15.1875°；对应平均单轮脉冲为 1.5，未丢计数，也未把车身实际转角减半。

#### 记录110 · 2026-10-06：旋转跳步／漏看标签日志诊断（未修改固件）

来源：[原始日志](项目日志.md)，第1163行；原主题：2026-10-06：旋转跳步／漏看标签日志诊断（未修改固件）。以下为该记录原文，状态按记录日期理解。

**用户现象与范围。** 用户提供 esp32-local-history-2026-10-06T00-19-46-815Z.json，报告旋转时突然加速／跳步、漏过本应能看到的位置。该文件含多个启动批次，本次运动诊断只采用最新bootId=cc53bc1af26389d1，固件0.40、UART／PATROL，避免将前面供电／摄像头排查启动混入运动时序。用户前一轮已确认quality=15后预览恢复、运行时间持续增加；这是观察期恢复证据，不代表先前重启根因已解决。

**可以验证的旋转设置和命令。** 最新配置scanStepPulses=2、scanMinimumMs=800、scanQuietMs=100、tagScanMaxFrames=3，wheelMm=67.5、trackMm=120、编码器20槽／圈。patrolSearchPwm=45、patrolAlignPwm=30，但minimumDrivePwm=150。实际SR命令均2脉冲、PWM150，标签对准日志两次明确显示ROTATE 20.3 30 -> ROTATE 20.3 150。45个可配对MS／MD／首次VQ扫描步的运动接收时差106–159ms，PWM全部150；没有看到该批次将PWM突然提升的指令。800ms是停转后的最短等待，不是要求电机持续转800ms。独立ROTATE 20.3是标签对准，不能混作扫描步变大。

**主要异常：停止后的编码器计数突增。** scan171第6步：seq1803、ms283435的MS基准左右262／159；seq1805、ms283568的MD仅2／2，运动段133ms；seq1814、ms284426首次VQ显示累计usedHalf从32升到92，本步左右计数和60，较MD的4多56，几何计量增量303.75°。下一步基准327／162，相较本步结束264／161，又表明报告停转至下一步启动期间左右总计增加63／1。另一处scan105第9步：seq1243、ms235075基准66／76，seq1245、ms235206结束2／2；首次VQ本步计数和27、比MD多23、计量增量136.6875°；下步基准170／78，报告停转后的左计数增加102、右0。45步中26步计数和6（30.375°），其余分布见metrics.json；303.75°是由编码器数据推导的估计，绝不等同实测车身真的转了该角度。上述时间为ESP收到Uno行的ms，非示波器测得的精确动作时间。

**源码机制与诊断边界。** Uno finishMotion先停止两侧输出，再发MD；ScanMachine在SETTLE结束时读取当前左右计数减步起始基准，包含停转后变化并计入预算；WAIT_VISION期间计数变化则没有重新确认静止。编码器ISR对下降沿仅有150微秒间隔门限，不能保证过滤线路／供电噪声；运动中按左右各自到目标脉冲停止各自电机，若一侧误计数，可能出现该侧提前停止、另一侧继续转的偏摆。因此日志已证明计数时序异常，优先检查编码器信号与接线／共地稳定性，并核对停转后轮子实际是否运动；尚不能单凭计数确诊噪声、滑行或所谓真实加速。不能通过改平均轮公式掩盖错误脉冲。最低PWM150导致的急起步是另一项已证实配置行为，但本段没有PWM阶跃增加证据，不能据此认定它就是某次体感跳步的唯一根因。

**视觉边界与后续。** 最新批次有124条TAG_SCAN_SAMPLE（120 absent、4 found），不能当作有真值的识别准确率。扫描只在停稳后检查新帧，停稳阶段有大幅真实转动会漏过视角，假脉冲会污染转角预算和停车判断；文件缺同步视频／标签真实位置／编码器波形，不能确定具体哪个标签视角被跳过。优先验证两侧编码器停车时是否仍跳数，再讨论合理脉冲间隔／异常保护和识别等待期静止失效处理；是否降低最低PWM需先确认实际带载起转能力。未操作串口、电机、配置、烧录或修改固件。复算脚本与45步数据保存在evidence/scan-jump-20261006/，使用原附件为输入；本轮仅更新原始日志。

#### 记录111 · 现象、可复算证据与原因边界

来源：[原始日志](项目日志.md)，第1178行；原主题：2026-10-06：标签接近单帧丢失导致重扫，增加宽限、停车复核与方向记忆（ESP 0.41，未烧录）。以下为该记录原文，状态按记录日期理解。

用户提供 esp32-local-history-2026-10-06T00-43-43-537Z.json，描述已经找到标签，接近时突然停止并转圈，且不会沿最后看到标签的方向寻找。最新批次 bootId=27b85c3ee485768e，路线[43,46]，minimumDrivePwm=110。990050ms 的 TAG_SCAN_SAMPLE 找到，990072ms 进入 APPROACH_TAG，990074ms 下达 MOTOR 110 110，990665ms STOP，990702ms SR：直行命令到停车命令间隔591ms，停车到重扫37ms。992098ms 再次找到；992134ms TAG_ARRIVAL，992135ms TAG_REACHED 43，992156ms 进入下站搜索。这一段到站后的扫描是正常换站，不能全部算成丢标重扫。

修改前源码对有效画面里目标标签缺失立即 awaitStop(SCAN_TAG)，没有连续丢失宽限；无效／过期画面也走相同出口。方向仅沿用 scanDirection，没有保存目标中心的左右位置或趋势。原日志证明了停车重扫的时序，但没有逐帧丢失原因和同步视频，不能确诊591ms这一次必然由单帧漏检触发，更不能用时差推算真实路程。复算输入路径、SHA256、事件列表见 evidence/tag-recovery-20261006/log-evidence.mjs 与 log-evidence.json。停止后脉冲异常／体感跳步仍按上一节独立排查，本次不把搜索策略改动写成硬件故障解决。

#### 记录112 · 实现、配置与兼容性

来源：[原始日志](项目日志.md)，第1184行；原主题：2026-10-06：标签接近单帧丢失导致重扫，增加宽限、停车复核与方向记忆（ESP 0.41，未烧录）。以下为该记录原文，状态按记录日期理解。

修改前已按用户要求提交基线 2361672（空快照提交，固定此前a10c7df版本）。新增 tagLossGraceMs，默认1000ms，范围0–3000整数。只有已确认正在直行且画面有效、新鲜、只是当前标签缺失，才保持原有 MOTOR 命令；不重发、不加速、不按负帧不断续期。到期停车；期间新正帧恢复接近，当前新画面达到 tagStopWidth 才允许到站。对无效／过期画面、障碍、触碰或通信保护，不使用盲走宽限；参数0立即停车。

停车后必须收到匹配的 STOP 确认，再进入 TAG_SETTLE，要求两轮后续编码器采样、零RPM、scanMinimumMs及scanQuietMs窗口满足。TAG_RECHECK 复用 tagScanMaxFrames（默认3，1–10），每次请求新的TAGS画面，只检查当前路线目标；任一次找到立即结束复核，全部有效负帧后才寻找，无效／过期／超时则故障停车。重复帧、旧帧、错generation／step不能增加次数。复核期间冻结左右编码器基准，哪怕RPM=0但计数突变也不能继续使用静止假设。

保存当前目标最近两次有效观测的centerX、width、frame和时间，方向记忆最多5秒。优先按最后位置选择左／右；中心0.5左右0.03死区内参考最近变化趋势，趋势的前一帧同样必须在5秒内，否则沿用原搜索方向。记忆只用于搜索方向，不证明标签仍在、不证明到站。

新增 tagRecoveryAngleDeg，默认60°，范围20–120°。丢失确认后先向记忆方向局部搜索，再反向搜索约两倍该角度，最后继续使用原有约720°预算中的余额，三段不分别领取720°。用原来的双轮平均脉冲推进，沿用SC/SR/VQ/VR协议；轮距、轮径、Uno编码器ISR、PWM最低值和电机控制算法未改。默认几何wheel67.5mm、track120mm、20脉冲/圈，预算整数71平均脉冲=718.875°；首段6平均脉冲约60.75°，反向段12约121.5°。整数协议和已有半脉冲进度可能留不足一整平均脉冲的余额，不能把约720°写成实测精确两圈。

重新找到结束丢失计时与恢复阶段，并以新的有效观测更新方向记忆；到站换目标、停止／新会话、猫互动抢占、通信恢复、策略／路线配置保存、摄像头参数失效会清除恢复记忆，避免跨目标泄漏。页面增加两项独立控件，仅确认停车时可保存，编辑草稿不被轮询覆盖；读取板上有效配置确认保存。新字段随旧NVS配置合并默认值，旧路线、顺序和其余字段不被默认值重置。额外修正原策略保存的NVS返回值检查：完整写入成功后才发布新配置；写入失败报CONFIG_ERROR并保留旧生效配置，不能宣称已持久保存。

新增状态读回 tagRecoveryStage、tagRecoveryDirection、tagMemoryDirection、tagMemoryAgeMs、tagLossRemainingMs、tagRecoveryRemainingDegrees、tagRecheckSamples。新增TAG_TRACK_LOST和TAG_RECOVERY原因、目标／帧号、宽限、方向、已用预算和宽限恢复时差，以及TAG_RECHECK_SAMPLE逐次证据。缺方向／过期明确回退，不把记忆当持续识别成功。

#### 记录113 · 验证与后续现场指标

来源：[原始日志](项目日志.md)，第1198行；原主题：2026-10-06：标签接近单帧丢失导致重扫，增加宽限、停车复核与方向记忆（ESP 0.41，未烧录）。以下为该记录原文，状态按记录日期理解。

网页／状态测试62/62通过；原生12/12可执行测试通过，其中10类报告数值的检查合计6686项，另2类仅报告通过，不把6686称为全部断言总数。标签恢复560项，PWM／配置2684项，摄像头驱动82＋编排66项。覆盖确认直行的单次／重复／旧负帧、边界正帧、零宽限、失去反馈、画面无效／过期、障碍、复核1／3／10次与任一次命中、停稳超时、计数突变、左右记忆与过期、局部共享预算、到站换目标、停止／触碰／通信抢占，以及NVS失败保留旧生效值和持久数据恢复。最终ESP离线编译成功：Flash 3802682/8257536B（46.0510%），静态RAM 85656/327680B（26.1401%）；静态RAM不代表运行heap或栈余量。生成网页101155→35212B gzip。应用bin 3802832B，SHA256 1b9a5b091c4d4f99966876cb56344216a5304b1a9b171baf68ec512ef3e074d2。8个关键源文件／生成文件与实际构建副本的SHA256逐项一致，避免将中途构建误作最终源码的验证。证据目录 evidence/tag-recovery-20261006/。本轮不烧录、不复位、不操作串口、电机或板上配置；离线通过不等于实际识别、运动、NVS重启恢复或真实UART验收。只追加原始项目日志，归类版不修改。

后续采集完整会话，可按目标／bootId统计：有效负帧首次出现→停车时差；宽限中重新找到次数／有效短暂丢失次数；停车复核阳性次数及所用新帧数；首次局部／反向／剩余全扫各阶段找回次数、累计双轮预算和找到耗时；TAG_REACHED之前由丢失引发的重扫次数。成功率分母应是完整、可确认真值的丢失事件，不能直接把扫描frame found/absent当识别准确率。现场应同步视频、路线站点、标签相对位置与实际车身转角，单独标注人工停止、触碰保护、无效画面和通信故障；上述效果指标目前均待测。

#### 记录124 · 2026-10-07 直行编码器自动调节与 Uno 紧凑解析

来源：[原始日志](项目日志.md)，第1274行；原主题：2026-10-07 直行编码器自动调节与 Uno 紧凑解析。以下为该记录原文，状态按记录日期理解。

Uno 6.12 仅在真实双轮、双编码器启用且左右请求 PWM 相同非零时调节，覆盖前进/倒退的连续、按时间和按距离直行。每 200ms 根据本次累计计数差修正：1 计数以内为零目标，超过部分每计数 4 PWM；每次变化最多 2，最大降低 min(请求 PWM/5,32)。只降低快轮，误差反转先撤掉原修正，保持请求与实际 PWM 分离。停车/新动作清零，已到距离的一轮不得重新启动；扫描转动、单轮、DRY_RUN、绕过保护测试不参与，触碰/障碍/失速优先。

初次程序 32896B 超限；仅用协议需要的两位十六进制解析替代通用 strtoul，使用严格有符号 32 位十进制解析替代 strtol，保持有效字段、正负号、前导空白、范围和 CRC 行为。特别拒绝原 strtol 可能饱和为边界值的整数溢出输入，不放松校验；浮点解析和通信帧格式不变。不更改原构建选项、停车保护、bootloader 或扫描算法。最终程序 31902/32256B，比基线 32244B 少 342B；静态 SRAM 1387/2048B，比基线增加 6B。

16 个原生程序通过，直接从真实 Uno 源码提取 startMotion/tickMotion/停车/完成函数测试；最新直行与解析集成测试 68847 项（主要为两位校验码字节组合，不是实机数据），完整 Node 回归 153 项通过。沙箱首次 Node 本地 HTTP 子进程无法启动，允许本地监听后全部通过。回滚标签 rollback/pre-straight-balance-20261007 指向 0a5184d，已离线构建旧 6.11 HEX，和新 HEX 一起保存至上层 output/straight-balance-20261007，哈希见 evidence/straight-balance-20261007/artifacts.json。

用户已追加授权烧录并表示串口已拔；本记录提交时尚未烧录。实车前先检查停车计数不跳，再以相同电量/地面/速度前进和倒退各三次约 50cm，比较侧偏、计数和实际 PWM；参数仅为初测起点，不能把测试通过当成实车已走直。不推送。

#### 记录125 · 2026-10-07 Uno 直行校正烧录验证与标签丢失的三层处理

来源：[原始日志](项目日志.md)，第1284行；原主题：2026-10-07 Uno 直行校正烧录验证与标签丢失的三层处理。以下为该记录原文，状态按记录日期理解。

按照用户“先烧录和验证，后记录”的顺序，已将 main 39f23c5 / 维护 790754b 共用的 Uno 6.12 写入 COM10；ESP32 固件未改动。烧录前经过 CRC 校验的 STOP/SESSION_STOP 回报及完整遥测确认停止。第一次打开 USB 时启动尚未完成，STOP 没有收到回报；保留 initial-stop-timeout.txt，等待启动后重查成功，再进行烧录，未绕过停车检查。arduino-cli upload --verify 退出 0，独立 avrdude flash:v 读取比较确认 31902 字节完全一致；未改 bootloader/fuses。

烧录后 STOP、SESSION_STOP、PING 和两次三段完整遥测通过，间隔 2189ms，左右请求/实际 PWM 都为 0，编码器均为 0 且未变化；正式检查回报的 CRC 错误数为 0。轮径 67.5mm、轮距 120mm、每圈 20 脉冲、左右安全阈值 1.0cm 回读；ESP 策略配置逐项比较无变化，最低 PWM 仍为 110。旧/新启动采集均出现乱码，未获得完整新版 READY，因此版本依据是已编译 6.12 HEX 与板上 Flash 的独立一致性验证，不把短时 USB 回读当成长期通信稳定或 ESP↔Uno 实际 UART 验收。最终 ESP 保持 SIM_UNO/IDLE，没有自动开启巡游或驱动轮子。

针对过冲或走偏后标签丢失，三种处理互相补充：

- 软件：main 在标签短暂漏检后先停车复查，再按最后位置左右搜索原标签，减少丢失后直接放弃；这属于找标签方法，与维护分支原扫描仍有区别。
- 硬件：用户提出保障供电电压/供电条件一致，确定带载能可靠起转和维持运动的最低 PWM，以减少动力不稳及左右轮差异。本轮没有测量两通道电压或实际起转阈值；110 是当前保存配置，不视为已完成硬件标定。
- 固件：Uno 根据编码器累计进度只降低较快轮的 PWM，校正直线前进和倒退，减少走偏；请求、距离目标、转弯、停车保护及通信格式保留。这是减少标签丢失机会的底层措施，左右找回标签则负责丢失后的恢复。没有同步视频/位姿测量，不能认定每次标签丢失都由过冲引起，也不能把本次烧录通过写成过冲问题已解决。

软件测试、容量验证、Flash 回读及短时静止检查已完成。接线后的真实 ESP↔Uno UART、直行偏航和速度平稳性仍待实车验收：同一电量/地面/速度，前进与倒退各三次约 50cm，对比基线与调节版的侧偏、计数和实际 PWM。回滚标签 rollback/pre-straight-balance-20261007（0a5184d）、可烧录旧 6.11 HEX、新 6.12 HEX 和 SHA256 已保存。所有证据在 evidence/straight-balance-20261007，未推送。

## 04 · 视觉感知、标定与避障策略

**发展脉络：** 标签规格／曝光→猫标签识别频率与居中→结果对应实际画面→新帧和标定→前向优先→关闭开关仍拦截的完整审查。

**目前结果与边界：** tag36h11为587个ID；46号3/5次识别只是小样本。前向24格灰度是外观差异，不是距离。0.47修复前向门禁忽略开关，并通过新帧／宽度等回归与用户本轮验收；开启时障碍转路线到达的规则仍保留。

**能力提炼：** 感知与策略解耦、有效性／新鲜度管理、实验口径，以及从配置到执行的全链路检查。

关联其他主题：[记录119](#record-119)、[记录136](#record-136)。

### 本章记录索引

| 记录 | 原始日志标题 |
|---|---|
| [010](#record-010) | 节点二：确认标签规格并生成打印材料 |
| [017](#record-017) | 当前网页如何确认地面参考采集成功 |
| [018](#record-018) | 参考已保存与避障有效分开验收 |
| [025](#record-025) | 2026-10-03：侧向超声波 1 cm 阈值及无效读数不停车 |
| [071](#record-071) | 2026-10-04：猫识别频率实验与日志36标签对准诊断（本轮不改代码） |
| [072](#record-072) | 2026-10-04：识别频率实验版2居中容差与轻量流程接口 |
| [073](#record-073) | 2026-10-04：识别实验版3猫/标签居中拆分与主动找猫参数开放 |
| [082](#record-082) | 2. 识别看不到对应画面：缓存实际JPEG与本地画框已实现，最终HTTP验收未通过 |
| [100](#record-100) | 2026-10-05：摄像头易过曝，选择黑色占比较大的46号标签作为路标 |
| [122](#record-122) | 2026-10-07 前向按钮反馈与仅预览时的自动地面标定 |
| [123](#record-123) | 2026-10-07 自动地面标定最终 main 编译 |
| [126](#record-126) | 2026-10-07 前向障碍优先结束标签／猫接近（代码修复，待实车验收） |
| [134](#record-134) | 10 月 7 日“不接近”的两种日志诊断 |
| [135](#record-135) | 10 月 10 日“视频在更新，避障结果过期”与算法来源 |
| [137](#record-137) | 10 月 12 日 0.47：前向关闭仍阻止接近，连同保存和草稿回写彻查修复 |

### 本章完整记录

#### 记录010 · 节点二：确认标签规格并生成打印材料

来源：[原始日志](项目日志.md)，第89行；原主题：2026-10-01 至 2026-10-02：ESP32 视觉调优与真实 Uno 通信联调。以下为该记录原文，状态按记录日期理解。

当前使用 tag36h11，支持 ID 0–586。587 张标签全部转换为 SVG，排成 13 页 A3 矢量 PDF，编号与原图逐一核对。每页最多 48 张，含白边 40×40 mm、黑框 32×32 mm；打印使用 A3、实际大小/100%，保留白边，页脚标尺为 50 mm。

文件见 [A3 标签 PDF](../output/pdf/tag36h11/tag36h11_A3_all.pdf)、[打印说明](../output/pdf/tag36h11/打印说明.md) 与 [批量脚本](../apriltag-imgs-master/batch_print_tags.py)。打印材料完成不等于真实识别距离、准确率已验收。

纠错资源评估：0 位约 27.5 KiB，1 位约 0.99 MiB，2 位约 34.85 MiB。板上有 8 MiB PSRAM，1 位从容量估算上可考虑，仍需连续空闲块与耗时验证；当前配置未开启纠错。没有开启纠错后崩溃的对照实测，不能把此前任务栈溢出归因于 AprilTag 纠错。

#### 记录017 · 当前网页如何确认地面参考采集成功

来源：[原始日志](项目日志.md)，第142行；原主题：2026-10-03：补记最新供电、失联排查与前向标定验收方法。以下为该记录原文，状态按记录日期理解。

这里对应 ESP 网页“摄像头与识别”的前向视觉避障，不是顶部触碰传感器校准。根据当前源码：

1. 固定摄像头到最终实车位置，确认图像下方中央区域为无障碍地面。点击“停止策略与电机”，状态须为 IDLE 或 STOPPED；真机链路选择 Real UART。
2. 选择“只识别标签”“只识别猫”或“猫与标签”，等待 camera 数据的 at 持续更新，并出现 72 项 floorSignature。默认“仅预览”关闭处理，视频正常不代表有可采集参考。
3. 点击“现场确认空地后采集地面参考（先停止）”。底部日志应出现 `[CALIBRATION] ground appearance reference captured; experimental qualitative front input`。失败日志为 `[CONFIG_ERROR] stop first` 或 `[CONFIG_ERROR] no fresh camera signature`；后者表示参考缺失或超过 5 秒。
4. 等下一帧，“摄像头与识别”的 camera 中应有 `frontCalibrated: true`，空地时 `front: "CLEAR"`，并有更新的 at 与 floorDifference。Real UART 下 selected 应采用同一真实观测。成功路径会把配置写入板上 Preferences；导出状态中的 config 应为 frontCalibrated=true，floorReference 为 72 项。参数文本框只在页面首次载入时填充，采集后可能仍显示旧值，应刷新页面或核对导出状态，不能用旧文本覆盖新标定。

#### 记录018 · 参考已保存与避障有效分开验收

来源：[原始日志](项目日志.md)，第151行；原主题：2026-10-03：补记最新供电、失联排查与前向标定验收方法。以下为该记录原文，状态按记录日期理解。

当前方法将警戒区域分为 3×8 块，比较灰度块均值与参考，72 项来自灰度值重复到三通道。默认 floorRoiTop=0.75（图像底部四分之一、中央一半），floorDifferenceThreshold=35；floorDifference 是各项差异的最大值。正常无猫条件下，差异大于阈值判 BLOCKED，否则标定后判 CLEAR；猫检测框 bottom>0.88 也会判 BLOCKED。

机器人先保持静止：空地应稳定 CLEAR；把障碍移入实际前方警戒范围（用 15 cm 标尺验证安装与 ROI），应切换 BLOCKED；移走后应恢复 CLEAR。重复不同位置、材质和光照，才可评价现场有效性。改变摄像头位置或 floorRoiTop 后重新采集。true 只证明参考配置有效，不证明障碍检测可靠，也不提供厘米测距。

再核对 Uno 接收链路：日志应有 CAMERA_FRONT CLEAR／BLOCKED 的发送及对应 CAMERA_FRONT_SET 完成回报，前向判定卡应为近期 HOST 来源。卡中的等效距离是协议映射值，不是实测距离。手动动作验收必须关闭“绕过全部避障”；最后由用户做低速短程测试确认障碍确实阻止前进。当前没有新增现场标定、障碍检测或停车验收结果，同色障碍漏检风险仍存在。

#### 记录025 · 2026-10-03：侧向超声波 1 cm 阈值及无效读数不停车

来源：[原始日志](项目日志.md)，第235行；原主题：2026-10-03：侧向超声波 1 cm 阈值及无效读数不停车。以下为该记录原文，状态按记录日期理解。

用户再次明确：超声波自动停车由 Uno 执行，左右安全距离应为 1 cm，无效或过期测距继续运动。实时检查时板上 GET_CONFIG 仍回 SAFE_LEFT_CM=5.0、SAFE_RIGHT_CM=5.0；旧固件、ESP 接口及网页最小值都为 5 cm，导致此前 1 cm 设置不能生效。旧 motionSafetyReason 将过近、无效和超过 500 ms 的输入合并为 SIDE_LEFT_OBSTACLE_OR_SENSOR_INVALID。当前左/右读数 221.1/136.8 cm；故障时单次测距已不在滚动日志，不能据此断言当时距离过近或无效。

上传后真实 UART 回读确认：ESP32_CAT_HOST_0.11，SAFE_LEFT_CM=1.0、SAFE_RIGHT_CM=1.0、TRACK_MM=120.0，左右电机请求/输出均 0，停止确认等待已清除，通信恢复。路线 `[46,40]` 与前向开关关闭保留。证据见 esp32-host/side-sonar-v011-readback-20261003.json。

Uno 升级 6.4：默认与可设置最小值改为 1 cm；对应方向仅在 currentSideDistance 返回有效新鲜值且距离严格小于阈值时停车。无回波、关闭输入、无效或过期读数不触发这一停车检查；不改动遥测有效性，不把未知测量标成安全测量。原因缩为 SIDE_LEFT_OBSTACLE / SIDE_RIGHT_OBSTACLE。ESP 升级 0.11，网页和配置接口允许 1–100 cm；模拟 Uno 和 USB 网页同步阈值、错误名称和固件握手。触碰、失速、会话关闭、ESP STOP、运动反馈超时和限时测试仍保留，前向仍由 ESP 处理。

验证：新增双侧无效启动、过期近距离继续运动、新鲜 0.5 cm 停止进行中动作、恰好 1.0 cm 允许运动以及网页提交 1 cm 的测试；全部 81 项 Node 测试通过。编译 Uno Flash30792、静态RAM1307；ESP Flash3689094、静态RAM78416，均在容量内。上传前旧 Uno 再次失联，约 45 秒无新回报，STOP 重试耗尽且网页停车未确认；现场保存于 esp32-host/side-sonar-upload-recovery-20261003.json。通过已授权烧录自动复位恢复并上传两边新固件，本轮未启动实机电机或巡游。长期失联原因仍待独立调查，软件模拟测试不能代替用户的实机巡游验收。

#### 记录071 · 2026-10-04：猫识别频率实验与日志36标签对准诊断（本轮不改代码）

来源：[原始日志](项目日志.md)，第723行；原主题：2026-10-04：猫识别频率实验与日志36标签对准诊断（本轮不改代码）。以下为该记录原文，状态按记录日期理解。

实验分支cat-vision-fps-bench基于已提交基线f40bf52，固件ESP32_CAT_HOST_0.29_FPS_BENCH。说明见[猫识别帧率摸底](./esp32-host/猫识别帧率摸底-20261004.md)，部署保存于evidence/cat-vision-fps-bench-20261004。最终构建Flash3751110/8257536、静态RAM83656/327680；COM11仅应用0x10000写3751264B、47.5秒、哈希验证通过，上传后回读实验版本/IDLE/SIM_UNO，88项配置未改。网页原23+新增4共27、实际policy1160等原生检查通过，Uno未改。早期上传等待章节保留为阶段记录；用户随后明确Uno失联暂不处理、继续ESP实验，不把未收到停车ACK写为停车成功或断电已验。

用户反馈串口工作时猫识别约3.24次/秒，闲时约3.5次/秒，实时识别时网页操作流畅。这是本次用户实测观察；[日志36副本](./evidence/cat-vision-fps-bench-20261004/esp32-log(36).json)未含bench环形统计，不能生成完整频率分布/P95或长期稳定结论，也不直接算较旧识别模式的同比性能提升。

日志36确认目标46已接受：3099234ms VR633/step1/gen38 result1、3099252ms SD633/38 result1、3099253ms APPROACH_TAG；随后6次ROTATE -20.3属TAG_ALIGN，不是继续搜索。原请求PWM30全部被保存最低255提升，MD各2/2且STOP_CONFIRMED。最后目标centerX0.310473、width0.146144，居中容差5.5%（中心合法0.445–0.555）、到达宽度0.19，前向避障关闭，无停车未确认。用户确认车身架空不转，摄像头视角未变，说明对准条件不能在此布置闭环；不能判搜索交接失败或要求直接前进。架空测需用户将标签移到中心，或后续落地闭环验收。

单帧总处理latencyMs457、decodeMs19、modelMs252，平均约3.24次/秒不保证每帧333ms内；同帧标签负载应另看P95/最大值。代码另发现TAG_ALIGN停车后仅按新frameSeq/1500ms时效消费，未强制采集时间晚于本次停车，是后续门控补强候选，日志不足以认定此次根因。软件建议为连续猫检测以约333ms启动间隔调度（不是完成后再睡333ms）、最新帧/超时跳过不积压，保留停车复核新帧门控和标签优先；需后续授权才改。本轮用户要求先不改代码，仅诊断，未提交Git、烧录新版本或主动测试电机。

#### 记录072 · 2026-10-04：识别频率实验版2居中容差与轻量流程接口

来源：[原始日志](项目日志.md)，第733行；原主题：2026-10-04：识别频率实验版2居中容差与轻量流程接口。以下为该记录原文，状态按记录日期理解。

实验分支cat-vision-fps-bench新增ESP32_CAT_HOST_0.29_FPS_BENCH_2，已核对[实现/部署说明](./esp32-host/猫识别帧率摸底-20261004.md)与[evidence/cat-center-live-ui验证](./evidence/cat-center-live-ui-20261004/verification.json)。网页居中容差复用centerTolerancePercent、猫/标签共用、1–20%，经原config/NVS保存回读；可选水平FOV/允许偏角按p=50*tan(angle)/tan(FOV/2)辅助换算，角度不保存，FOV不凭空假定，畸变/裁切标定待测。原保存值仍5.5%，未自动修改。

日志36 TAG_ALIGN仅约79–97ms，完整状态600ms轮询会漏短阶段。新增/api/flow只读轻量接口、当前流程及最近8条巡游DECISION；返回后再等100ms请求，不并发积压，失败退避1000ms，完整状态仍600ms，慢回读不倒退历史。policy.cpp仅增加只读快照，不修改控制转换；先前“未修改policy.cpp”的中间说明以此为准。未实施3Hz启动调度或停车后采集时间补强。历史步骤不冒充当前动作。

空闲6次保持连接flow请求均200、155字节，往返115.66/186.09/308.78/108.69/64.32/130.78ms。100ms只是响应后的等待，不是硬实时刷新，端到端周期还包含HTTP往返、处理和显示；本次接口数据不能当UART延迟、模型推理或负载下刷新保证。

网页31项、实际policy1160/连续互动252/扫描259/设置2640等检查通过。构建Flash3754358/8257536（45%）、静态RAM83656/327680（25%）；COM11仅0x10000应用3754512B、46.7秒、Hash verified。HTTP回读实验版2、SIM_UNO/IDLE，88项配置未变、居中5.5%；Uno未改未上传。构建/上传、state和flow-keepalive.json均在evidence/cat-center-live-ui-20261004，实车、识别负载和界面验收待用户完成。

用户明确不要Computer Use或浏览器，界面由本人检查；要求前实施会话只读开过页面、未改配置或控制车辆，之后不再浏览器检查。本轮日志会话仅读保存文件、修改文档，不提交Git或操作设备/浏览器；分支待用户验证后本地提交。

#### 记录073 · 2026-10-04：识别实验版3猫/标签居中拆分与主动找猫参数开放

来源：[原始日志](项目日志.md)，第745行；原主题：2026-10-04：识别实验版3猫/标签居中拆分与主动找猫参数开放。以下为该记录原文，状态按记录日期理解。

已核对[实验说明](./esp32-host/猫识别帧率摸底-20261004.md)及[evidence/cat-settings-split验证](./evidence/cat-settings-split-20261004/verification.json)。最新固件ESP32_CAT_HOST_0.29_FPS_BENCH_3；猫居中沿用centerTolerancePercent，标签新增tagCenterTolerancePercent，各自1–20%并接入实际policy对准判断。猫框宽远近、标签宽到达和位置居中是不同量；旧NVS缺tag字段继承旧共用容差，不重置其他配置。

用户选择保留慢靠近/三段试探，仅开放现有概率，不增加慢→快/快→慢。主动找猫配置展示远处慢靠近/试探合计100%、近处原地声光/观察/静止合计100%，以及试探冷却、距离/PWM、三段暂停、声光时长；冷却时原试探回退慢靠近。触碰并行声光及复核后的装死/探索/逃跑仍在猫互动配置，不混入主动找猫。保留原控制分支与识别调度，不把参数可调当新增行为。

网页自动33检查、实际policy1170/连续互动252/扫描259/设置2647及视觉门/CRC通过，覆盖独立容差、迁移及概率组校验。构建Flash3756322/8257536（45%）、静态RAM83656/327680（25%）；COM11仅应用0x10000写3756464B、46.7秒、Hash verified，USB回读实验版3/SIM_UNO/IDLE。所有原保存配置未变；用户旧容差已保存20%，迁移猫20/标签20，旧远处85/15、近处20/40/40及最低PWM255保留。此为用户值迁移，不是把默认5.5自动改为20。

Uno未改未上传；本轮没有浏览器或Computer Use，界面/实体效果由用户验收，实验分支待验证后本地提交。本日志会话只读保存证据并改文档，不提交Git或操作设备。

#### 记录082 · 2. 识别看不到对应画面：缓存实际JPEG与本地画框已实现，最终HTTP验收未通过

来源：[原始日志](项目日志.md)，第840行；原主题：2026-10-05：三帧猫复核、识别预览与断连重启证据归类。以下为该记录原文，状态按记录日期理解。

普通猫识别每次缓存与结果匹配的实际JPEG，经局域网取图，浏览器canvas本地画框；不局限于benchmark。显示decode/model/total耗时及识别启动间隔，负结果清除框。界面分为传感器、串口通路、摄像头三栏，设置在下方，性能测试在底部；标签与猫的中心容差独立，实时flow和识别benchmark保留。

证据：[PREVIEW验证](evidence/camera-preview-layout-20261005/verification.json)。最终版本 `ESP32_CAT_HOST_0.29_FPS_BENCH_3_ACTIVE_SEARCH_3_CAT_CHECK_3_PREVIEW` 编译Flash3767914、静态RAM85264，应用写入3768064字节并hash验证；USB版本回读及原配置比较一致，路线[46,40]、maxFrames3保留。native preview20项、JS page/preview/bench41项及完整native regression通过，均为既有离线检查，本轮未重跑。

PREVIEW的HTTP读取超时，`servedPageEqualsCompiled=null`、`previewEndpointStatus=null`；不能把上一版CAT_CHECK的页面验证搬到最终PREVIEW，也不能写最终HTTP预览验收通过。界面效果留给用户检查，没有ComputerUse或内置浏览器视觉验收，没有真实运动测试，Uno未上传。

#### 记录100 · 2026-10-05：摄像头易过曝，选择黑色占比较大的46号标签作为路标

来源：[原始日志](项目日志.md)，第997行；原主题：2026-10-05：摄像头易过曝，选择黑色占比较大的46号标签作为路标。以下为该记录原文，状态按记录日期理解。

**问题与现场观察：** 用户发现ESP32-S3 Sense摄像头非常容易过曝。前期测试中，较白的40号标签识别效果不佳；用户观察46号标签的黑色占比更大，因此选择46号作为识别路标，以改善当前拍摄条件下的识别可靠性。本节记录用户提供的现场测试结果，未进行新的设备测试或图像分析。

**处理：** 在路标选型上优先采用黑色占比较大的46号标签。此次为标签选择调整，不涉及修改摄像头曝光参数、识别算法或程序，也不据此自动修改板上保存的巡游路线。

| 对比项 | 前期测试结果 | 数据来源与范围 |
| --- | --- | --- |
| 较白的40号标签 | 识别成功率0% | 用户报告；测试总次数未提供 |
| 黑色占比较大的46号标签 | 识别成功率60%，即3/5次成功、2/5次失败 | 用户报告的前期5次测试 |

**优化幅度：** 按上述报告，识别成功率从0%提高到60%，提高 **60个百分点**。基线为0%，不计算相对增长百分比或提升倍数。该结果支持目前优先选用46号标签，但属于前期小样本观察，不能直接视为长期成功率；过曝是否为两种标签表现差异的唯一原因仍未验证。40号测试总次数、两组光照/距离/角度及曝光条件的一致性、原始画面与逐次检测记录尚未提供；黑色占比未做图像定量测量。

#### 记录122 · 2026-10-07 前向按钮反馈与仅预览时的自动地面标定

来源：[原始日志](项目日志.md)，第1260行；原主题：2026-10-07 前向按钮反馈与仅预览时的自动地面标定。以下为该记录原文，状态按记录日期理解。

用户报告前向开关及标定点击无反馈。实时回读最初 stopUnconfirmed=true、stopPendingId=39，日志多次 CONFIG_ERROR confirmed stop required first；前端之前只检查策略停止，未检查真实停车确认，也未显示板端拒绝。用户随后确认停车；回读 stopPendingId=0/stopUnconfirmed=false，但 visionMode/actualVisionMode=OFF，未生成地面 signature，旧标定要求新 signature 却没有按钮结果提示。

修复两层：前端与板端保持一致，未确认停车或手动操作未完成时禁用并说明原因；切换/采集显示等待、成功、错误和断线，HTTP 发出不被当作成功。标定改为停车后主动请求一张新 TAGS 帧采集 72 值空地参考，再请求一张新帧确认参考已参与判断，支持仅预览，不改变用户选择的常规识别模式。请求限定 ticket/token，停止状态改变、请求被取消或 8 秒超时明确失败，不绕过停车确认。新增 frontCalibration 状态回读。

标定说明明确：固定摄像头于实车位置及角度，相同光照，实际采集区域必须全是无障碍地面，不以墙地交界为参考；整幅画面不必都是地面。网页显示当前横向 25%-75%、纵向 floorRoiTop 到底边的区域。15cm 标尺用于区域位置标定，采集参考时移开。

验证：75 项网页/状态测试通过，15 个原生程序通过，其中新标定模块 22 项检查覆盖两帧、重复结果、停车未确认、无相机、取消、超时、无效 signature。主分支离线编译与授权部署随后记录；保持机器人找猫/标签、电机等原流程不变。

#### 记录123 · 2026-10-07 自动地面标定最终 main 编译

来源：[原始日志](项目日志.md)，第1270行；原主题：2026-10-07 自动地面标定最终 main 编译。以下为该记录原文，状态按记录日期理解。

按钮主动采集并验证新画面，状态显示采集中/确认中/失败原因；SIM_UNO 模式也读取真实摄像头宽度。75 项网页与状态检查、15 个原生回归程序通过，其中标定流程 22 项检查。最终 main 离线编译通过：程序 3808550 字节、静态 RAM 85776 字节，应用文件 3808704 字节。7 个关键源码与编译副本 SHA256 相同。保持配置、搜索差异与停车确认；实车空地标定及避障效果需另行验收。

#### 记录126 · 2026-10-07 前向障碍优先结束标签／猫接近（代码修复，待实车验收）

来源：[原始日志](项目日志.md)，第1299行；原主题：2026-10-07 前向障碍优先结束标签／猫接近（代码修复，待实车验收）。以下为该记录原文，状态按记录日期理解。

本次仅修改 main／0.42，离线版本为 ESP32_CAT_HOST_0.42_FRONT_APPROACH_PRIORITY，没有烧录、连接串口或驱动实车。

- 标签接近：有效新帧前向 BLOCKED 优先于标签宽度、对齐和目标丢失恢复；立即 STOP，收到匹配的 MOTOR_STOPPED 后按当前标签已到达推进路线。重复编号节点仍需重新识别保护。
- 猫接近：快速、缓慢及试探接近遇障碍，立即进入现有近距离声光／观察／静止概率决策，同时 STOP；互动不等待停车确认，新的运动仍被停车门禁拦截。清除剩余接近距离和阶段标志，接近只计一次；保留动作上限。迟到的运动完成和错误停车回报不能恢复旧动作。
- 标签／猫接近始终检查前向；关闭总开关也不绕过。猫行进持续 FLOOR 地面观测。停车复查的新帧若报障碍，仍优先到达／互动；无效、过期或当前标定失效只停止等待，不能视为到达或进入目标恢复。旧画面的已标定标志不能覆盖当前配置的未标定状态。
- UART 等待 STOP 时，仅在猫互动并行停车状态放行有限时长的 LED／BEEP 命令；MOTOR、DRIVE、ROTATE、SR、SESSION_START 仍阻止。停车失败后恢复原有诊断和故障处理，不继续放行互动输出。不修改 Uno 协议。
- 界面逐项说明 floorDifferenceThreshold、floorRoiTop、frontBlockBottom、visionMaxAgeMs 的作用、范围、调大／调小影响及是否需要重新标定；说明总开关、自动标定状态和参考值。增加独立保存与板上实际值回读，修改草稿不被轮询覆盖，重启后重新读取；NVS 写入失败不会声称重启持久化成功。FLOOR 行进中只用地面差异，猫框底边阈值仅在有猫识别结果时参与判断。

实际验证：完整 Node 155／155 项通过；18 个原生测试程序全部通过，其中新增接近优先 147 个断言，实际 UART flushTx 集成测试验证了 STOP 未确认前声光发送、运动拦截、重试与停车失败诊断。ESP32 最终编译退出 0，Flash 3,814,510／8,257,536 字节（46%），静态 RAM 85,800／327,680 字节（26%）。工作区关键源码与构建副本 SHA256 一致；固件 SHA256、测试原始输出保存在 evidence/front-approach-priority-20261007/validation.json、node-tests.txt、native-tests.txt。

验收边界：上述为源码、离线测试和编译证据。板上参数保存／重启读回、新界面实际显示、障碍识别效果、互动启动延迟、停车延迟和滑行距离尚未实车验证。后续分别测试标签宽度未达标／目标短暂丢失、猫快／慢／试探接近，记录障碍观测时间、互动首个输出时间、停车确认时间和实际停稳／滑行距离；在总开关关闭和不同参数下复测。不把本次通过写成过冲已在实车解决。

#### 记录134 · 10 月 7 日“不接近”的两种日志诊断

来源：[原始日志](项目日志.md)，第1383行；原主题：2026-10-13：复查 10 月 6–12 日聊天，补齐问题证据、处理结果与验收状态。以下为该记录原文，状态按记录日期理解。

1. **猫接近没有下发运动。** `esp32-local-history-2026-10-07T11-54-33-088Z.json` 中，342175ms、508747ms 两次进入 APPROACH_CAT，期间均无 DRIVE，约 2 秒结束互动。导出配置前向开关为 true，但 frontCalibrated=false、空地参考为空、front=INVALID；CLEAR 门禁阻止派发。直接原因在感知／策略门禁，不能据此判断电机坏。当天仅诊断，建议采集参考；另发现该等待阶段实际视觉模式 OFF，无法主动刷新，作为后续策略修正线索。后续接近策略已调整，但该历史事件没有独立的校准后实车对照数据。
2. **识别标签并不代表物理到达。** `esp32-local-history-2026-10-07T13-28-06-440Z.json` 中识别目标 43（frame3107）后，同帧前向被判 FRONT_BLOCKED，流程 STOP → MOTOR_STOPPED → TAG_ARRIVAL → TAG_REACHED43 → 下一目标，没有前进 MOTOR。策略优先处理障碍，把避障停车转成路线到达；记录不能区分真实障碍与视觉误报。10 月 7 日前向优先版本继续保留这一开启避障时的路线推进规则。0.47 修正关闭开关仍进入该分支的问题，未重新定义开启时的到达语义。

#### 记录135 · 10 月 10 日“视频在更新，避障结果过期”与算法来源

来源：[原始日志](项目日志.md)，第1388行；原主题：2026-10-13：复查 10 月 6–12 日聊天，补齐问题证据、处理结果与验收状态。以下为该记录原文，状态按记录日期理解。

源码核查确认：摄像头取帧、网页视频和策略推理是不同流程。默认 OFF／仅预览更新视频而不持续计算避障；采集空地参考只完成新帧标定及另一新帧验证，不自动开启持续调试。连续推理两次启动最少间隔 350ms，网页约 600ms 轮询，结果超过 visionMaxAgeMs（当时默认 1500ms）显示过期；刷新页面不会请求新推理。停车时切 TAGS 是当时可用的持续查看方法，独立 FLOOR 调试入口仍属待办。本次为源码诊断，未连接设备证明某次过期的具体根因。

旧算法是 3×8 共 24 格灰度均值，与固定空地参考逐格取绝对差，再用最大差判断，检测的是外观变化而非距离。阈值低更敏感，阴影、花纹与曝光变化可能误报；与地面亮度接近的物体可能漏检。空地与障碍差异分布重叠时，单改阈值不能同时消除两者。Git 5dcdb99 首次实现该工程规则，0480d09 后补论文背景；[研究依据说明](esp32-host/FRONT_VISION_REFERENCES.md) 明确未复现 Lee 2016 的运动几何算法，不能声称 24 格方案来自该论文。优化交接目录保存六篇 PDF 与基准步骤；16 棵、深度 8 随机森林是待训练候选设计，不是论文现成权重。

计时口径同样需要分开：画面／识别结果“距今多久”是帧龄，latencyMs 是整次视觉处理耗时，都不是单独前向算法耗时。不把聊天中粗略的 0.7–1 秒观察值写成实测纯算法性能。

#### 记录137 · 10 月 12 日 0.47：前向关闭仍阻止接近，连同保存和草稿回写彻查修复

来源：[原始日志](项目日志.md)，第1418行；原主题：2026-10-13：复查 10 月 6–12 日聊天，补齐问题证据、处理结果与验收状态。以下为该记录原文，状态按记录日期理解。

**现象与证据。** 用户界面明确关闭前向避障，停车宽度20%，标签很小时却立即换下一站。新版附件 `esp32-local-history-2026-10-12T21-25-49-766Z.json` 回读 frontAvoidanceEnabled=false。最近事件为545762ms进入APPROACH_TAG，545763ms报FRONT_BLOCKED，545765ms发STOP487，545775ms确认MOTOR_STOPPED，545776msTAG_ARRIVAL／TAG_REACHED46／SCAN_TAG，期间没有前进命令。1ms即结束接近、12ms后收到停车确认，描述的是设备日志流程间隔，不是实际刹停或推理耗时。此前一次导出中六次跳站同为FRONT_BLOCKED；不能把末尾快照的CLEAR与历史结束原因混成同一时刻。349852ms还出现NVS save failed、RAM applied but restart persistence unconfirmed。

**三个根因与处理。**

- 标签接近／对齐／复核、猫接近／试探等共用前向判断忽略总开关。0.47 统一门禁：关闭时前向不阻挡、判为可通过；开启仍保留原障碍优先规则。CAT_DRIVE／PROBE_MOVE 关闭时不强制 FLOOR。目标新帧有效性、宽度到站、其他运动保护继续执行。
- 一个开关仍随大 config 保存，NVS失败可能造成RAM值与重启值不同。增加独立小键 front（0／1），写后回读匹配才应用单开关；启动优先读取，缺键兼容旧配置，成功整份保存同步小键。未擦NVS。
- 按钮已改开关，高级JSON草稿却保留旧值，随后保存可能改回去。仅在板上确认的开关回读变化时同步字段；保留其他草稿、不完整JSON与没有新回读变化时用户主动编辑的布尔值。

其他开关沿 UI→配置→持久化／回读→策略／派发逐项审查。模拟／真UART、遥控接管、动作测试绕过、预览／猫框、识别模式、性能测试、摄像头自动控制、灯、Uno诊断开关未发现同类遗漏。识别模式是待机选择，自主流程可覆盖，以actualVisionMode为准；隐藏视频不关闭推理；超声波只有阈值，没有独立启停开关。此为源码及受影响测试结论，不是逐个开关的完整实车验收。详见 [开关核查](开关核查-20261012.md)。

**验证与部署。** 网页86/86通过，全部21个原生程序通过，其中接近门禁144、开关存储8、路线19、遥控71、policy1184、标签恢复560、摄像头82／运行时66个断言。最终ESP编译Flash3,833,626/8,257,536字节，静态RAM85,992/327,680字节，应用文件3,833,776字节。烧录前旧0.46应用与板上ROM摘要匹配；仅更新0x10000应用、分区表不变，写入Hash和独立ROM摘要校验通过，不称为本轮完整逐字节回读。真实ESP静止开启／关闭保存回读成功，复位仍false、路线[43,46,51]，全部config与修改前一致。Uno维持V6.13；未由助手发送运动命令。验证时重启默认SIM_UNO／IDLE。原始 [validation.json](evidence/switch-audit-20261012/validation.json) 的 physicalApproachTested=false 记录的是当时助手验证范围，保留不改。

**用户验收与Git收录。** 烧录与回归后，用户在本轮明确反馈“测试没问题”，本轮接近／前向开关修复记为**已部署、用户实测通过（定性反馈）**。未提供模式、次数、场地、距离或视频，不推算成功率、停车距离，也不扩大为所有声光／摄像头／通信场景均已验收。关键开发已在DEV提交6ea5885（含0.43–0.47、UnoV6.13及相关文档／证据），未推送；前文当时“未提交”保持为历史记录，本节补最终状态。

## 05 · 猫互动与自主行为设计

**发展脉络：** 观测盲区与未知→首次触碰和持续触碰→主动邀请与无回应收尾→取消不必要的严格居中→最多三帧确认→接近猫一次走完剩余距离与共享恢复。

**目前结果与边界：** 完整采集确认追逃收尾反复ROTATE来自强制居中；0.25修复具体触碰路径，0.35统一找猫。0.40.1取消每1cm停查，0.42扩展共享恢复；不能把通信无数据计为“没有猫”。

**能力提炼：** 把用户体验转为状态机条件，设计抢占、预算、动作衔接和可解释退出；在交互意图与实现细节之间找出多余要求。

关联其他主题：[记录117](#record-117)、[记录133](#record-133)。

### 本章记录索引

| 记录 | 原始日志标题 |
|---|---|
| [006](#record-006) | 追加节点：传感器观测边界与装死等待 |
| [038](#record-038) | 2026-10-04：ESP V0.18 连续猫互动、独立找猫与完整状态清单 |
| [049](#record-049) | 2026-10-04：猫复核反复对准旋转，ESP0.20简化为原地复核 |
| [050](#record-050) | 2026-10-04：ESP0.20上传完成与配置回读 |
| [052](#record-052) | 2026-10-04：每轮随机逃跑距离，ESP0.22已上传 |
| [053](#record-053) | 2026-10-04：ESP0.23追逃、装死和探索的观察收尾 |
| [059](#record-059) | 2026-10-04：完整采集确认追逃收尾严格居中导致反复旋转，ESP0.25修复 |
| [060](#record-060) | 2026-10-04：ESP0.25上传完成，反复居中修复待用户实体复验 |
| [064](#record-064) | 2026-10-04：ESP0.27探索15种声光组合与本地LED控制 |
| [065](#record-065) | 2026-10-04：ESP0.28修正找猫期间探索声光不回应 |
| [075](#record-075) | 2026-10-04：主动找猫首次触碰接入统一互动，无回应后返回巡游（实施中） |
| [076](#record-076) | 2026-10-04：主动找猫统一首触与无人回应返回巡游——本地提交及离线验证 |
| [077](#record-077) | 2026-10-05：主动找猫统一状态机 ESP 应用上传与回读验证 |
| [078](#record-078) | 2026-10-05：主动找猫邀请后返回巡游——日志39真实时序核对 |
| [079](#record-079) | 2026-10-05：主动邀请五动作与可调时长概率的最终部署 |
| [081](#record-081) | 1. 猫识别负帧导致退出：局部修复已实现，完整横跳仍未解决 |
| [095](#record-095) | 2026-10-05：统一主动/触碰找猫，取消猫框居中检测 |
| [098](#record-098) | 最新遗漏补齐：0.35统一找猫的原因、验证和提交状态 |
| [114](#record-114) | 两条版本线与实机边界 |
| [115](#record-115) | 0.42最终实现 |
| [116](#record-116) | 验证与待测 |

### 本章完整记录

#### 记录006 · 追加节点：传感器观测边界与装死等待

来源：[原始日志](项目日志.md)，第59行；原主题：追加节点：传感器观测边界与装死等待。以下为该记录原文，状态按记录日期理解。

用户随后报告猫在后方盲区移开时，机器人似乎仍能判定离开。代码没有在装死判定中直接读取猫绝对坐标，但旧逻辑在等待上限后等触碰松开再恢复巡游；模拟触碰还按整个身体重叠保持旧开关按下，使侧面触碰能跨过后方盲区持续存在。这会产生“机器人知道后面猫何时走开”的表现。

当前修正：触碰只由当前传感器覆盖区域生成，去掉全局重叠保持。已安装的触碰传感器为左、右、后、上四路，后部模拟触碰默认开启，实体后部触碰由 A3 读取。后方缺少的是摄像头和超声波；猫超出接触范围后位置未知。装死只在有效视觉持续测得猫足够远且无触碰时确认离开；看不见表示未知，触碰松开不等于离开。超时未确认则保持停止，需确认现场后手动恢复巡游。

同时修复混合测试转向判断仍取模拟侧距的问题：开启的实体通道只取实体回报，缺失、过期、部分接线、来源不符或 IO 状态未知都不以模拟值兜底。LIVE 前向控制使用当前 HOST 回报；没有实际猫视觉观测时明确标为不可用。

审计覆盖决策、巡游/寻找/对准/逃跑/装死、观测适配、模拟触碰、串口注入、绘图、猫脚本及 Uno 输入边界。场景坐标仅保留在环境生成、模拟传感器几何、位置绘制和测试设置层。路径清单见 [观测边界审计](./OBSERVATION_AUDIT.md) 的 2026-09-30 追加记录。

最终自动回归更新为 **63 项通过**，覆盖后方隐藏移动不改变观察与等待结果、视觉丢失/触碰释放不能证明离开、真实读数禁止虚拟兜底，以及未确认离开时停止和手动恢复。未操作真实浏览器或设备，装轮实测仍由用户完成。

#### 记录038 · 2026-10-04：ESP V0.18 连续猫互动、独立找猫与完整状态清单

来源：[原始日志](项目日志.md)，第362行；原主题：2026-10-03：Uno容量与手动IDE上传配置。以下为该记录原文，状态按记录日期理解。

用户批准实施。基线 81588be 保存 ESP0.17/Uno6.8；970643d 提交独立网页配置，ebd8db6 提交无路线的独立找猫，5995e7d 提交连续互动、后置装死、触碰续做与逃跑阶段拆分。

猫比例按检测框宽度/画面宽度，网页可设置远/近、追击超时、最多逃跑完成轮数（默认5）、两种装死概率（各默认20%）、探索最短时间（默认30秒）、猫退出确认和装死超时。重复触碰不重抽、不改首次位置、不换互动来源；保留Uno触碰停车，以已检查回报续做剩余运动或扫描预算。完整逃跑后才计轮数/抽装死，探索最短时间后在周期完成点抽；追击和装死超时正常退出。装死保持静止，MazeBot灯条由用户遥控。

按用户最新要求单列 ESCAPE_DIRECTION（寻找逃跑方向）与 ESCAPE_MOVE（执行逃跑），找到并面向猫后要转向远离方向再直行。SETTLE 需要停车后两次编码器样本，旧普通遥测2秒周期可能造成数秒额外等待；仅SETTLE改250ms周期，保留最低等待和安静条件。网页显示停稳时间/样本数、猫比例/远近及直行编码器估算，避免将转圈等同直行。没有新的现场日志，不能证明用户这一次停留的全部原因。

验证：真实policy.cpp原生回归557项、新连续互动149项、Uno扫描核心235项、PWM/配置2622项，视觉门和线路校验通过；网页脚本21项、当前状态清单自动核对2项通过。移除的是旧行为要求的断言，并用新生命周期/概率/计数/追击退出测试替代，没有删掉旧串口/扫描回归。实际ESP编译3728590字节Flash（45%），78920字节RAM（24%）；应用bin3728736字节。Uno固件未修改，仍6.8；仓库与旁边手动上传副本SHA256一致。

当前地址192.168.137.188；上传前只读回读ESP0.17、SIM_UNO、IDLE、motorRunning=false、无停车待确认，原PWM255/等待200ms/路线[46,40]保留。上传结果随后记录。没有操作界面或进行真实运动、识别准确率与长时间串口测试；验收由用户完成。当前状态与历史基线分别保留在《猫互动状态机现状-20261004.md》前半部分和末尾。

上传完成：COM11 USB VID303A/PID1001确认ESP32-S3；先读取0x8000分区表，与本次构建3072字节分区表一致，再仅写0x10000应用区3728736字节，921600波特、no-stub，写入50.9秒，esptool报告Hash of data verified，并按用户已有授权RTS reset。HTTP192.168.137.188回读ESP32_CAT_HOST_0.18、SIM_UNO、IDLE、无运动和待确认停车。原路线[46,40]、PWM255、最低等待200ms、标签阈值19%、猫远12%/近35%保留；新字段逃跑5轮、探索30秒、两种概率各20%，追击10秒、装死15秒回读正确。没有写NVS/分区表/引导程序，也没有测试运动；用户需切换真机UART后现场验收。最终编译与清单提交3cef32f。

#### 记录049 · 2026-10-04：猫复核反复对准旋转，ESP0.20简化为原地复核

来源：[原始日志](项目日志.md)，第507行；原主题：2026-10-04：猫复核反复对准旋转，ESP0.20简化为原地复核。以下为该记录原文，状态按记录日期理解。

新增问题由修复会话转交统一日志，已核对[方案说明](./esp32-host/找猫简化与原地复核-20261004.md)和[构建证据](./evidence/scan-handoff-20261004/esp-v020-build.json)。[日志16](./evidence/scan-handoff-20261004/esp32-log(16).json)显示ESP0.19在416607–421192ms循环CAT_CHECK→ALIGN_CAT→WAIT_STOP→CHECK_ALIGN→SETTLE→CAT_CHECK；417148/418307/419537/420552ms发送ROTATE20.3 255，原请求PWM52被保存下限255提高。这里有有效运动命令和重复对准流程，不能全部归因通信故障；也未证明CAT_CHECK/SETTLE内部另发运动或机械惯性已经停止。

按用户最新要求，仅ESP升级0.20、Uno保持6.9：触碰主流程收敛为转停搜索→唯一CAT_CONFIRM原地复核→抽取装死/探索/逃跑。首次有效扫描找到猫后确认STOP；复核先取两次新编码器样本满足安静/最低等待条件，原地等待可配catConfirmWaitSeconds（默认5秒，0–30），再取等待结束后的新帧。整个复核不居中、不发运动命令；有效false继续剩余搜索预算，编码器或新帧不足超时则安全退出，探索后观察也复用此状态。独立HTTP主动找猫、标签巡游与分段接近路径保留。

触碰声光作为并行计时，不阻塞搜索：停车确认后启动，按钮仍按住时保持停车，松开再扫描；概率沿用touchFlashPercent并显式展示。清扫描队列时只恢复声光剩余时长，不延长；停止、FAULT、互动结束、装死关闭。复核后装死20%/探索20%/其余逃跑60%为该会话未收到第二个概率偏好答复时采用的暂定默认，可网页调整且前两者合计≤100%；重复触碰不重抽。该规则是最新猫触碰入口设计，不覆盖旧日期对0.18后置装死规则的历史记录。

离线验证：实际策略692检查、猫互动245、PWM/配置2628、扫描259、视觉门/线路CRC通过，Node92通过；ESP编译Flash3732798/8257536、静态RAM78928/327680、BIN3732944字节。保存构建记录uploaded=false、physicalTested=false：尚未上传0.20，未验收实体惯性、运动、识别准确率或并行声光。固件尚未提交；本次只统一写日志，不修改或提交固件。

#### 记录050 · 2026-10-04：ESP0.20上传完成与配置回读

来源：[原始日志](项目日志.md)，第517行；原主题：2026-10-04：猫复核反复对准旋转，ESP0.20简化为原地复核。以下为该记录原文，状态按记录日期理解。

后续保存证据确认ESP0.20已实际上传，更新前文“尚未上传”的阶段记录。用户授权直接上传，并明确ESP上传无需拔板间UART线；不能把Uno此前上传隔离串口的步骤推广为所有ESP上传要求。上传前回读ESP0.19、UART、STOPPED、无停车待确认，COM11确认ESP32-S3。上传会话记录应用SHA256与构建一致，0x8000现有3072字节分区表比对一致后，仅写0x10000应用3732944字节，921600/no-stub、46.7秒，哈希校验通过并RTS重启。

[上传记录](./evidence/scan-handoff-20261004/upload-v020.json)确认existingConfigChanges为空；[上传后状态](./evidence/scan-handoff-20261004/esp-v020-after-upload.json)回读ESP32_CAT_HOST_0.20、SIM_UNO、IDLE、cameraOk=true、无运动和停车待确认。新增原地复核等待5秒、装死20%/探索20%（剩余逃跑60%）回读正确；触碰声光20%、路线[46,40]、最低PWM255、scanMinimumMs200、tagStopWidth0.19保留。[上传前状态](./evidence/scan-handoff-20261004/esp-v020-before-upload.json)亦已保存。

Uno保持6.9，本次未刷新Uno，未启动现场扫描/运动。最新状态为ESP0.20上传完成、用户刷新页面选择Real UART后自行验收；上传和配置回读不能证明原地物理停稳、猫复核、并行声光或识别效果已经现场通过。本日志整理仅读取保存文件。

#### 记录052 · 2026-10-04：每轮随机逃跑距离，ESP0.22已上传

来源：[原始日志](项目日志.md)，第535行；原主题：2026-10-04：每轮随机逃跑距离，ESP0.22已上传。以下为该记录原文，状态按记录日期理解。

用户最终选择继续按距离结束逃跑，每轮在最小/最大距离之间随机抽取，不改成固定秒数。已核对[实现说明](./esp32-host/随机逃跑距离-20261004.md)和[上传证据](./evidence/scan-handoff-20261004/upload-v022.json)。网页新增escapeMinDistanceCm/escapeMaxDistanceCm，单位厘米、1–100、最小≤最大；相等表示固定距离。每轮直行条件通过后，发DRIVE前抽取一次直接行程，不再减stopMarginCm；触碰暂停只续剩余距离，不重新抽取。patrolStatus.escapeTargetCm、网页和ESCAPE_DISTANCE日志显示本轮目标。

旧配置缺少范围字段时，将原escapeDistanceCm-stopMarginCm（至少1cm）迁移为相等上下限，旧26cm/3cm变23/23，保留原有效行程；已有范围和其他参数/概率保留。逃跑后装死概率、最多完成轮数仍独立。这里目标是命令距离，编码器脉冲会量化，轮子空转不证明机身实际位移。

离线策略745、设置/PWM2632、扫描259、连续互动245、视觉门/CRC检查通过，网页21测试通过；覆盖区间端点/中值、固定距离、50cm DRIVE、暂停续跑不重抽、范围校验和显示。ESP构建Flash3735354/8257536、静态RAM78936/327680。COM11仅写应用3735504字节、分区比对和哈希验证通过、46.4秒、RTS重启，版本0.22；保存上传前后状态于evidence/scan-handoff-20261004/esp-v022-before-upload.json及esp-v022-after-upload.json。未启动实体电机或测试真实行进距离。最新状态为实现/上传完成、物理距离验收待测；本轮仅统一整理保存证据。

#### 记录053 · 2026-10-04：ESP0.23追逃、装死和探索的观察收尾

来源：[原始日志](项目日志.md)，第543行；原主题：2026-10-04：ESP0.23追逃、装死和探索的观察收尾。以下为该记录原文，状态按记录日期理解。

按用户最新要求，装死后、探索无互动一段时间后重新找猫，找到对齐后持续观察，猫离画面或观察超时退出；再次触碰/靠近继续原互动分支。已核对[实现报告](./esp32-host/追逃与探索观察收尾-20261004.md)及[上传证据](./evidence/scan-handoff-20261004/upload-v023.json)。最新规则按本节记录，前文0.20无对准复核等保留其当时需求，不覆盖历史。

POST_ESCAPE保留原装死概率和完成轮数；PREY_WAIT结束或确认离开后不直接结束，而是重新扫描CHASE_ALIGN。扫描成功后实际ALIGN_CAT→校验STOP→SETTLE→新帧，直到居中，再CAT_CONFIRM→WAIT_CHASE。复核定时等待期间连续CAT，猫偏离重新对齐；停稳/转向仍依赖停车后的新帧决策。WAIT_CHASE显示“面向猫观察，等待互动”，有效新负帧退出，无效/过期记为观测不可用。再次触碰可越过临时视觉不可用，松开后直接续逃，取消旧OBSERVE/FOLLOW_WAIT延迟；探索分支续SIGNAL，不重开互动。画面内远猫不再自动等同离开。

探索无触碰达到catInteractionIdleSeconds后重新找猫/对齐/观察，默认12秒、1–120秒；catObserveTimeoutSeconds默认10秒、1–120秒，从旧postEscapeWaitSeconds迁移，旧键兼容保留但不用于动作。无互动按触碰事件计时，观察期远→近可触发互动，不能当作已识别猫的情绪或攻击意图。原配置、随机逃跑距离和装死规则保留。后端没有接收接口，明确本轮不接入；后端推送、情绪识别和网页状态接口间歇超时均未完成。

离线策略792、连续互动252、设置/PWM2640、扫描259及视觉CRC检查通过，相关Node41测试通过；ESP编译Flash3737586/8257536、静态RAM78936/327680。COM11仅写应用3737728字节，46.3秒，分区匹配/哈希验证通过、RTS重启，版本0.23。上传前后证据为evidence/scan-handoff-20261004/esp-v023-before-upload.json、esp-v023-after-upload.json。未启动实体电机做追逃，未测实际观察帧率；最新状态为实现/上传完成、实车行为待验收。本轮只统一整理保存证据。

#### 记录059 · 2026-10-04：完整采集确认追逃收尾严格居中导致反复旋转，ESP0.25修复

来源：[原始日志](项目日志.md)，第607行；原主题：2026-10-04：完整采集确认追逃收尾严格居中导致反复旋转，ESP0.25修复。以下为该记录原文，状态按记录日期理解。

本节补充并收窄此前“持续转轮根因待查”的结论：对这一次CAT_TOUCH追逃收尾，完整post-v024双USB采集已确认具体软件路径；不能仍只写硬件待查或停车惯性。已核对[现场与修复说明](./esp32-host/找到猫后反复旋转-20261004.md)。日志31导出ms409664已STOPPED/FAULT，只保留379464ms之后遥测，现场依赖完整采集而非该导出。

初触找到猫311621ms VR result1→311652停车CAT_CONFIRM→317643逃跑，没有强制居中。逃跑后319819重新找到猫→319840 ROTATE20.3 255→319924停车SETTLE。320203/320455遥测请求/应用PWM0/0，计数138/214、RPM18/24；320703同计数RPM0/0才CAT_CHECK。321009再扫描、322028找到猫、322048再ROTATE，之后323677/325049/326628/329267/330642/332248等反复同方向旋转；341252 alignment budget exhausted退出互动恢复巡游，349410用户停止。

原因：CHASE_ALIGN等触碰互动收尾仍调用orient，要求猫框严格居中；偏心就再转，SETTLE是各段运动之间等待，网页可能漏掉短ALIGN_CAT。用户只要求猫在画框内，严格居中属于不必要行为要求。不能由此断言相机安装方式，也不能外推所有持续电机输出、编码器或自发复位异常都已解释。

ESP0.25仅CAT_TOUCH全部收尾改为找到猫直接停车复核，CHASE_ALIGN成功转WAIT_CHASE；取消复核时偏离中央再次orient，保留有效新帧、原地观察与超时。主动ROBOT_SEARCH、标签对准和逃跑方向转动不改，0.24有限通信恢复和RPM停稳条件保留。离线实际策略818、连续互动252、设置2640、扫描259及CRC/视觉检查通过；数量随移除旧严格居中断言变化，不能据数量下降推断回归失败。最终编译仍在进行，尚未上传0.25、未做实体验收。本轮只统一日志。

#### 记录060 · 2026-10-04：ESP0.25上传完成，反复居中修复待用户实体复验

来源：[原始日志](项目日志.md)，第617行；原主题：2026-10-04：完整采集确认追逃收尾严格居中导致反复旋转，ESP0.25修复。以下为该记录原文，状态按记录日期理解。

更新上节未上传状态：ESP0.25已仅写0x10000应用区3740800字节，46.4秒、Hash verified。保存HTTP回读ESP32_CAT_HOST_0.25、IDLE/SIM_UNO；本轮逐项核对原配置键，变更0。证据：[上传文本](./evidence/uart-repro-20261004/post-v024/upload-v025.txt)、[上传前](./evidence/uart-repro-20261004/post-v024/esp-v025-before-upload.json)、[上传后](./evidence/uart-repro-20261004/post-v024/esp-v025-after-upload.json)。Uno未改，仍6.9。

本轮特定路径原因已有完整采集及818实际策略回归：触碰互动收尾强制居中重复发ROTATE，现已修改并上传。没有主动实体电机验收，用户需选真实UART复验，不把上传成功当现场问题已解决。其他UART命令回显、自动复位和持续输出异常不能自动归为同一原因，继续待测。新双USB只读采集位于evidence/uart-repro-20261004/post-v025；重新开端口附近启动须与自发复位分开，采集结果尚未总结。本轮仅读取保存文件并补日志。

#### 记录064 · 2026-10-04：ESP0.27探索15种声光组合与本地LED控制

来源：[原始日志](项目日志.md)，第655行；原主题：2026-10-04：ESP0.27探索15种声光组合与本地LED控制。以下为该记录原文，状态按记录日期理解。

已核对[实现说明](./esp32-host/探索声光组合-20261004.md)及[验证记录](./evidence/uart-repro-20261004/post-v027/verification.json)。用户最终要求四种灯光（不亮/常亮/慢闪/双闪）与四种声音（静音/长响/两短响/三短响）独立组合，排除不亮+静音，共15种随机不放回、相邻不重复，用完重置。首次复核选择探索后播一组，探索静止期间每次新按压换组，长按不重复，保留互动分支；取消无触碰时自动换组。运动中触碰仍停车，原找猫复核、探索空闲再找猫及观察退出保留。

当前GPIO21板载单色灯模拟未来WS2811节奏，未实现真实灯带、颜色或流水。蜂鸣器仍用Uno原BEEP，长响600ms，两短响0/800ms各180ms，三短响0/600/1200ms各150ms；变化是节奏而非音高，实际声音受UART排队和Uno调度影响。灯常亮1800ms、慢闪2400ms每800ms亮300ms、双闪3000ms每1200ms在0–180/400–580ms亮，组合至较长序列结束。停止/FAULT/恢复取消余音，过期音节不集中补发。

网页LED开/关直接写ESP GPIO21，不经UnoUART，无需Uno解锁/遥测/停车回报；仍要求策略IDLE/STOPPED，可SIM模式测试，停止/模式切换熄灯。实际HTTP同网页路径manual_test led_on/off回读LOW亮/HIGH灭，HOST_LED_LOCAL2条、LED UART命令0条，最后灯灭SIM_UNO/IDLE。这验证软件GPIO状态，不等同肉眼亮灭或实际按压/听感通过。

实际policy1051、连续互动252、扫描259、设置2640及CRC/视觉检查通过，网页23通过。ESP构建Flash3744202/8257536、静态RAM79000/327680，较0.26增2804B/8B。Uno保持6.10，本次没有新Uno程序或协议。COM11仅写0x10000应用3744352B，46.5秒、哈希校验和HTTP0.27回读通过，原配置变化0项；build、upload、前后state、LED测试均在evidence/uart-repro-20261004/post-v027。

双USB被动采集已由修复会话恢复，post-v027/capture，COM10/COM11为57600/115200、DTR/RTS=false、writes0，计划30分钟；旧post-v026-uno610关闭并保留。尚无15种按压组合实体结果或30分钟最终稳定性结论。本次声光改动不能声称解决UART异常或Uno自发重启，本日志会话仅核对保存文件并追加记录。

#### 记录065 · 2026-10-04：ESP0.28修正找猫期间探索声光不回应

来源：[原始日志](项目日志.md)，第667行；原主题：2026-10-04：ESP0.28修正找猫期间探索声光不回应。以下为该记录原文，状态按记录日期理解。

保留0.27现场问题：用户新按压在找猫期间无声光。源码onTouch只放行4个静止节点，signal(true)还可能覆盖主action；awaitStop/扫描clearTx会取消或丢掉回应。已核对[追加说明](./esp32-host/探索声光组合-20261004.md)和post-v028保存证据。

0.28拆出playExplorationResponse，不改变主action/互动分支；探索分支在扫描旋转、等视觉、等配置、停车复核/等停车回报均响应每次新按压。保留触碰先停车、松开续扫、已耗角度与复核deadline/generation。非终止性停车保留定时序列，清队列只恢复未过期音节，不重播整组；在扫描提前return前调度声光，蜂鸣仍受停车门禁。急停/FAULT/退出/通信恢复取消序列。

回应计数独立；随机装死仅在无扫描、无电机、无会话/停车交接且停车已确认的静止节点执行，100%装死回归也不得抢占扫描。保留15组不放回/相邻不重复规则，长按不重复。Uno源码、状态机和命令格式本轮未改，原逃跑/装死/巡游回归保留；这说明离线覆盖，不证明实物无回归。

实际policy1142、连续互动252、扫描259、设置2640及CRC/视觉检查通过，网页23通过。ESP构建Flash3744614/8257536、静态RAM79000/327680；COM11仅0x10000应用3744768B，46.5秒、Hash verified，HTTP0.28/IDLE/SIM_UNO、保存配置零变更。证据evidence/uart-repro-20261004/post-v028包含构建、上传、前后state及verification；新30分钟只读双USB捕获在其capture子目录，writes0，未形成最终稳定性结论。没有本轮Uno烧录或实体运动/声光并行验收，UART回显/Uno自发复位未记为修复。

#### 记录075 · 2026-10-04：主动找猫首次触碰接入统一互动，无回应后返回巡游（实施中）

来源：[原始日志](项目日志.md)，第767行；原主题：2026-10-04：主动找猫首次触碰接入统一互动，无回应后返回巡游（实施中）。以下为该记录原文，状态按记录日期理解。

用户授权主动找猫实施会话将问题/办法转交统一项目日志。该会话确认旧policy缺口：ROBOT_SEARCH中的触碰仅pauseForTouch，未进入巡游的firstTouchPlan；FOLLOW_WAIT反复chooseRobot，独立alert的returnToPatrol=false使结束回IDLE。症状属控制路径/返回契约缺口，不能统一归为串口或猫模型问题。

方案利用已有首触状态机：主动找猫第一次触碰转CAT_TOUCH并调用巡游同一firstTouchPlan/复核/装死探索逃跑路径，后续触碰保留互动身份/分支不重新抽取，避免另造两套行为。无人回应完成一次邀请动作后，按initialLookSeconds观察加decisionIntervalMs等待结束，不反复抽分支邀请；巡游中启动的找猫保留原targetIndex/needRearm，独立alert完成后由已保存路线索引0开启新巡游。

没有保存路线时不能凭空巡游，应保持安全停止、报告empty route，独立找猫入口继续允许使用。正在修改/验证，尚无最终测试数、提交ID、构建上传或实体验收，不写已完成。工作区还有其他会话修改，实施会话计划精确索引补丁独立提交；本日志会话只记录，不操作设备、不提交其他源码，最终结果另补。

#### 记录076 · 2026-10-04：主动找猫统一首触与无人回应返回巡游——本地提交及离线验证

来源：[原始日志](项目日志.md)，第775行；原主题：2026-10-04：主动找猫统一首触与无人回应返回巡游——本地提交及离线验证。以下为该记录原文，状态按记录日期理解。

本节记录主动找猫控制路径修复的最终离线进展。旧流程中 ROBOT_SEARCH 首触仅暂停运动，FOLLOW_WAIT 反复选择主动行为，独立找猫结束回 IDLE；现在复用巡游的首触状态机并返回保存路线。已核对本地提交：6a8052c，主动找猫首次受攻击转入CAT_TOUCH、复用巡游firstTouchPlan；4a99abe，无人回应结束一次邀请并返回原巡游，独立入口从保存路线首节点开启巡游，恢复清扫描方向/对准预算/旧决策帧，无路线明确FAULT，不生成路线。

实际policy原生1172检查、连续猫互动513、扫描259、PWM/设置2647及vision/wire门控通过。ESP离线构建Flash3756790/8257536（45%）、静态RAM83656/327680（25%）。首次因沙箱无法读取Arduino15 packages符号链接失败，批准仅访问离线工具链后编译通过；没有安装新工具、上传、串口/实体操作。代码提交与编译不证明实体识别、轮子动作或长期UART稳定性。

旧状态清单遗漏的 CAT_CONFIRM 和五个链路恢复入口已补齐：LINK_RECOVERY_STOP、LINK_RECOVERY_STOPPED、LINK_RECOVERY_SESSION_STOP、LINK_RECOVERY_CONFIG、LINK_RECOVERY_SESSION_START。状态清单自动检查 2/2 通过。证据见 evidence/active-search-flow-20261004/verification.json 和 build.txt；编译的是包含既有实验/UI修改的当前工作区。

本日志会话只追加上述事实，不提交整份脏日志或其他源码。实体识别、轮子、完整返回路线与UART长期行为继续待用户验收。两份日志本节标题相同，供实施会话仅索引/提交本次新增章节；本节结束。

#### 记录077 · 2026-10-05：主动找猫统一状态机 ESP 应用上传与回读验证

来源：[原始日志](项目日志.md)，第785行；原主题：2026-10-05：主动找猫统一状态机 ESP 应用上传与回读验证。以下为该记录原文，状态按记录日期理解。

用户明确允许 ESP 上传；Uno 若需上传必须先通知用户拔下串口。本次 Uno 程序没有改动，未上传。主动找猫受攻击接统一首触流程及返回巡游代码分别为 6a8052c、4a99abe；独立部署版本标识提交 f76aca4，版本 ESP32_CAT_HOST_0.29_FPS_BENCH_3_ACTIVE_SEARCH_1。

上传前 HTTP 实时回读 IDLE/UART、motorId=0、左右PWM=0、stopPendingId=0、stopUnconfirmed=false、debugBusy=false，Uno遥测 STOPPED/PWM0。重新离线编译通过：Flash3756806/8257536（45%）、静态RAM83656/327680（25%）。编译使用包含既有实验/UI修改的当前工作区，源码与编译副本逐文件哈希一致后上传。

COM11读取0x8000的3072字节分区表，SHA256与编译分区表完全一致；仅写0x10000应用3756960字节，25.5秒，Hash of data verified，RTS重启。未写NVS、bootloader或分区表。HTTP回读新版本、IDLE/SIM_UNO、cameraOk=true、motorId=0、stopPendingId=0、stopUnconfirmed=false。保存配置逐字段比较没有变化，路线仍[46,40]。重启由UART回SIM_UNO是当前setup默认，本轮没有切回真实UART或启动运动。

上传与回读证据见 evidence/active-search-upload-20261005/verification.json、build.txt、partition-read.txt、upload.txt、pre-upload-state.json和after-state.json。文本日志仅去除行尾空格便于Git检查。上传成功不代表实体触碰/识别/轮子/返回路线或UART长期稳定性已验收。本次过程与结果已转交“整理项目日志与问题数据”会话；仅本章节及上传证据单独提交，其他会话脏改动保持未提交。

#### 记录078 · 2026-10-05：主动找猫邀请后返回巡游——日志39真实时序核对

来源：[原始日志](项目日志.md)，第795行；原主题：2026-10-05：主动找猫邀请后返回巡游——日志39真实时序核对。以下为该记录原文，状态按记录日期理解。

用户追问主动找猫为何退出回巡游。本轮仅分析用户提供的 `D:/data/download/esp32-log(39).json`，没有修改程序、访问设备或上传。快照固件为 `ESP32_CAT_HOST_0.29_FPS_BENCH_3_ACTIVE_SEARCH_1`，UART模式；160条日志覆盖104627–117731ms。它为上传后的实际状态机路径提供了证据，但不等于全部实体行为验收。

| ESP时间（ms） | 日志事实 | 解释 |
| --- | --- | --- |
| 105833 | `SD 205 37 1` | 扫描205、generation37返回找到猫 |
| 106841 | `INTERACTION OBSERVE` | 进入邀请观察阶段 |
| 111851 | `INTERACTION FOLLOW_WAIT` | 观察5.010秒后进入回应等待 |
| 114353 | `INTERACTION_EXIT cat ignored robot invitation` | 再等2.502秒，观察及等待共7.512秒后退出 |
| 114366 | `DONE 219 MOTOR_STOPPED` / `STOP_CONFIRMED` | 本次STOP得到同ID确认 |
| 114417 | `DONE 222 SESSION_STOPPED` | 旧会话结束得到确认 |
| 114432 | `DONE 223 SESSION_STARTED` | 巡游会话启动得到确认 |
| 114433 / 114452 | `PATROL SCAN_TAG` / `PATROL SCAN_TAG_ACTIVE` | 返回标签巡游并开始扫描 |

当前保存配置为 `initialLookSeconds=5`、`decisionIntervalMs=2500`，与上述5.010秒及2.502秒一致。这次退出命中提交 `4a99abe` 新增的“一次邀请无回应，返回保存路线”的正常分支；所见链路有STOP、SESSION_STOP、SESSION_START完成回执，不能把这次返回归因为找猫失败或串口故障。窗口中没有 `TOUCH PRESS` / `SEARCH_ATTACK`，只说明日志未收到相应触碰事件，不能证明现实猫没有攻击，也不能据此认定触碰硬件正常。

快照还保留 `catFailure: scan result=3 at23366`，比本次退出早约91秒，是更早的失败记录，不能解释114353ms的退出。本次问题归类为“状态机预期行为与用户理解核对”，结果为已解释、未改代码；触碰是否实际发生并被采集仍需另外核实。

#### 记录079 · 2026-10-05：主动邀请五动作与可调时长概率的最终部署

来源：[原始日志](项目日志.md)，第814行；原主题：2026-10-05：主动邀请五动作与可调时长概率的最终部署。以下为该记录原文，状态按记录日期理解。

日志39的主动找猫在找到猫后观察5.010秒、再等2.502秒即退出，总7.512秒；用户明确纠正为完成动作计数，最新默认5个（取代先前10个），并确认完整快接近/慢接近/声光/观察各计1，内部短步进/停车复核/动作间等待不计。猫攻击或找到后有效新帧无猫可提前中断。本次实现分别提交8b8017a（计数/有界快→慢/慢接近并行闪灯）、62f7440（控制台概率/宽度/时长/计数保存回读）、8950966（灯光较短截断蜂鸣问题，改为独立输出时长、等待较长者完成）。

复用现有编码器DRIVE短段与停车新帧闭环，快接近距离默认上限15cm、请求PWM180，猫不再属于远处或距离预算耗尽时计1次并切慢接近；慢接近沿原计划距离/PWM，完整结束计1次；三段试探全部完成才计1次。慢接近闪灯概率默认50%，整个动作只抽一次，与短段运动并行，不额外计数；段间停车关灯，下一段延续选中灯光。停下后沿原保存概率选择声光/观察/静止，动作预算到达5后返回原巡游，独立入口从保存路线首节点开始；首触仍复用巡游同一互动状态机。

控制台支持次数上限、快距离/PWM、并行灯概率、远处及停下后概率组、猫远近框宽阈值、观察时长、动作间等待、灯光及蜂鸣时长和原慢接近/试探参数，配置经NVS保存并回读。实时显示当前动作/完成数、摄像头新鲜猫框百分比、控制远近档、最低PWM后的快慢实际值；过期/无效检测不冒充当前猫宽，编辑草稿不被轮询覆盖。最低PWM保存值255会把快180/慢95都提升为255，不能宣称已实测速度区分。

最终固件ESP32_CAT_HOST_0.29_FPS_BENCH_3_ACTIVE_SEARCH_3。原生真实policy1172/连续互动623/scan259/PWM设置2649与wire/vision门控通过；当前页面30项、状态清单2项、隔离索引UI2项通过。离线构建Flash3760410/8257536（45%）、静态RAM83688/327680（25%）；编译采用含既有实验/UI修改的当前工作区，Git只索引本任务内容，UI索引gzip由其对应源码独立生成。

用户已有ESP上传授权，Uno上传前须通知拔串口；本次Uno没有修改或上传。COM11分区表0x8000的3072B与编译表SHA256一致，仅应用0x10000写3760560B，25.3秒，Hash of data verified，RTS重启。HTTP回读最终版本、IDLE/SIM_UNO、cameraOk、motorId0、stopPendingId0/stopUnconfirmed=false。原保存设置逐字段无变化，路线[46,40]、猫宽12%/35%、观察5秒、灯1400ms、蜂鸣180ms、最低PWM255保留；新增limit5/fastCm15/fastPWM180/slowFlash50真实回读。服务器返回的67895B网页与编译网页逐字节相同，未进行浏览器视觉验收。上传/读回与检查不替代实车猫识别/触碰/速度/路线或UART长期验收。

完整证据evidence/active-search-rounds-final-20261005/verification.json、build.txt、partition-read.txt、upload.txt、pre-upload-state.json、after-state.json及served-page.html；日志文本仅去除行尾空格。过程、问题和方案均已转交“整理项目日志与问题数据”会话。本节及最终上传证据独立提交，其他历史日志和实验代码修改仍未提交。

#### 记录081 · 1. 猫识别负帧导致退出：局部修复已实现，完整横跳仍未解决

来源：[原始日志](项目日志.md)，第832行；原主题：2026-10-05：三帧猫复核、识别预览与断连重启证据归类。以下为该记录原文，状态按记录日期理解。

`CAT_CHECK` 在一次停稳内最多检查3张新鲜帧：任一有效命中即成功；有效负帧未到上限时继续CAT_CHECK，不重新进入SETTLE；无效结果或超时进入FAULT并停止。`catCheckMaxFrames` 为整数1..3，默认3，已接通配置保存与回读。这减少单张负结果立即退出的机会，但识别准确率提升没有实测数据。

`CAT_CONFIRM` 未改；OBSERVE/SIGNAL等其它单帧退出未改；每1cm分段接近后SETTLE→CAT_CHECK也未改。因此本轮是局部复核机制修复，不能宣称主动找猫反复横跳已完全解决。

证据：[CAT_CHECK验证](evidence/cat-check-three-frames-20261005/verification.json)。该版本编译Flash3762754、静态RAM83696，应用写入3762896字节，hash验证通过，HTTP页面与编译页面一致，回读maxFrames3、路线[46,40]及原配置不变；native catcheck116项通过。未做真实运动测试，Uno未上传。

#### 记录095 · 2026-10-05：统一主动/触碰找猫，取消猫框居中检测

来源：[原始日志](项目日志.md)，第957行；原主题：2026-10-05：统一主动/触碰找猫，取消猫框居中检测。以下为该记录原文，状态按记录日期理解。

按用户要求先提交修改前版本 42b0cbd，再将所有 CAT 扫描成功统一转入 CAT_CONFIRM。停稳与配置等待后，以新的有效猫帧决定后续行为，不使用 centerX，不进行 ALIGN_CAT；主动邀请复用确认帧，不重复检查。最终确认取帧不再瞬间 CAT_CHECK → CAT_CONFIRM。接近短段后的停稳检查、逃跑转向、标签对准保留。旧猫居中设置保留但停用。详情与实际检查数据见 esp32-host/统一找猫不检测居中-20261005.md。本轮不上传、不操作实车；物理效果待测。

#### 记录098 · 最新遗漏补齐：0.35统一找猫的原因、验证和提交状态

来源：[原始日志](项目日志.md)，第981行；原主题：2026-10-05：10月4–5日聊天复盘与改动补漏——问题、数据、处理及优化幅度。以下为该记录原文，状态按记录日期理解。

此前两份日志对0.35只有简述，本节补齐证据和结果。用户在今天明确要求“统一成直接找猫，不需要检测居中”，并要求先保存旧版本。修改前基线提交42b0cbd，最终源码/网页/说明提交aabc751（ESP32_CAT_HOST_0.35_UNIFIED_CAT_SEARCH）。0.34已有上传证据；0.35仅离线编译通过，尚未上传，不能把它写成当前板上版本或实体问题已消失。

所有CAT扫描成功共用STOP确认→两次新编码器样本/零RPM/安静等待→配置复核等待→结束后新猫帧。有效猫帧直接分发触碰或主动行为；不读centerX、不发猫居中ALIGN_CAT，主动选择复用确认帧。旧猫居中参数保留但停用；接近沿当前车头方向执行，标签居中与路线保持。配置迁移、保存和界面显示本身不等同实车动作验收。

最新用户提供的log49只覆盖492911–504467ms标签巡游尾段，不能拿它统计主动找猫横跳。log50在645599ms进入CAT_CONFIRM、648580ms确认新帧，相隔2.981秒；随后ROTATE180是逃跑方向，DRIVE23是逃跑，不是猫居中。413943ms的encoder settle unavailable属于旧故障。该2.981秒是改动前单次路径时序，不是0.35优化后耗时。

离线实际policy1192、找猫检查656、连续互动618、扫描259、PWM/设置2656项通过，视觉门/CRC及预览缓存20项通过；页面/状态清单37项通过。覆盖两入口×中心0/0.2/0.8/1×宽0.1/0.2/0.5共24组合，确认期间无ROTATE/DRIVE/SR/MOTOR、选择行为后不重复STOP，失去猫仍保留扫描预算。Flash3774014B、静态RAM85352B，离线完整编译通过。测试数量是覆盖证据，不是实车成功率或效率提升。

证据：[统一找猫报告](esp32-host/统一找猫不检测居中-20261005.md)、[四路视频及页面验收](esp32-host/网页模拟器协议与持续显示验收-20261005.md)、[Web修复与采样](esp32-host/Web掉线排查与修复-20261005.md)、[四轮恢复与缺帧处理](esp32-host/重连四轮与遥测重试-20261004.md)、[停车未确认综合诊断](esp32-host/停车未确认综合分析-20261004.md)。其他改动的逐版构建/上传证据已经在原日期章节，不重复当作新增实现。

#### 记录114 · 两条版本线与实机边界

来源：[原始日志](项目日志.md)，第1206行；原主题：2026-10-06：0.40猫维护版已部署，0.42共用目标恢复已离线完成。以下为该记录原文，状态按记录日期理解。

维护分支maintenance/0.40-cat-flow，行为提交f847e6e、部署证据提交9dfc6b2，基于0.40基线2361672，不含0.41标签恢复。0.40.1_SIMPLE_CAT_FLOW：主动/触摸共用最多三帧确认，找到提前通过，保留确认STOP与编码器停稳，取消额外确认等待；快/慢接近一次下发完整剩余距离，结束后复查，不再每1cm复查。原试探三段、触摸抢占、通信和运动保护、五次高层动作预算保留。旧配置字段保留，catApproachStepCm/catConfirmWaitSeconds标为unsupportedSettings，不重写用户路线或摄像头参数。

用户明确授权只烧录0.40维护版，禁止0.41/0.42烧录。0.40维护版11个native程序与59项网页回归通过，Flash3792882/8257536B、静态RAM85584/327680B。COM11读取IDLE与无运动/待确认STOP状态，3072B分区表逐字节匹配，仅写0x10000应用3793024B，写入25.5秒，Hash of data verified。应用SHA256=159974FE1A5B02DAC8D17E80F421DEE14F75180AF60F726A9FB5A2EA7BC63358。USB、HTTP均回读0.40.1、IDLE/SIM_UNO，保存策略配置变化零项。最终只读HTTP复验页面97285B与维护分支生成网页逐字节一致，motorId=0、motorRunning=false。未切换模式，未执行运动或猫识别验收。部署详细记录在维护分支；当前工作区保留firmware-040.bin及http-readback-040.json。

#### 记录115 · 0.42最终实现

来源：[原始日志](项目日志.md)，第1212行；原主题：2026-10-06：0.40猫维护版已部署，0.42共用目标恢复已离线完成。以下为该记录原文，状态按记录日期理解。

main基于0.41提交9e0d34f，先移植维护改动（4d350d6），再发布ESP32_CAT_HOST_0.42_SHARED_TARGET_RECOVERY。猫/标签共享TargetRecoveryMemory类型及startTargetRecovery/advanceTargetRecovery恢复引擎，各持独立目标记忆。有效新帧记录位置/趋势，方向记忆有效期5秒；优先最后左右位置，中心死区参考趋势。猫接近/试探动作结束后若最多三次静止复核均无猫，先向记忆方向局部找，再反向局部找，再用原约720度预算余额，阶段不重置预算；恢复成功继续原行为、互动ID和剩余距离，失败结束并明确报找猫失败。无记忆/过期/错目标回退原有界搜索。停止、新互动、通信恢复、配置/摄像头变更和结束清除记忆。

扫描猫的每个停点现在也最多catCheckMaxFrames次新画面，找到提前通过，与标签共用采样逻辑；重复帧、旧代次、错step不消耗次数或更新记忆。识别画面等待与Uno交接重试区分，回复已发送后允许既有交接重试。标签保留有效负帧直行宽限及ID/到站规则；猫不采用直行宽限。共用局部角度复用已有tagRecoveryAngleDeg（默认60度），网页明确标为猫与标签共用；标签宽限仍独立。新增猫恢复阶段、方向、记忆时间、剩余预算、扫描采样状态与日志，页面显示猫恢复回读及断线失效。0.41的NVS完整写入检查保留；Uno固件、电机算法、编码器ISR、协议、轮距轮径本次不改。

#### 记录116 · 验证与待测

来源：[原始日志](项目日志.md)，第1218行；原主题：2026-10-06：0.40猫维护版已部署，0.42共用目标恢复已离线完成。以下为该记录原文，状态按记录日期理解。

13个native回归程序全部通过，其中新增猫恢复111项、标签恢复560项、policy1184项、CAT_CHECK695项、连续互动695项；网页61/61与状态清单2/2通过。验证覆盖左右搜索、局部/反向/全扫共享预算、成功恢复原动作和距离、三次负帧、重复/错代次/错step、过期/错目标记忆、触摸/停止清理及原标签行为。最终离线编译Flash3804222/8257536B，静态RAM85712/327680B；7个关键源文件与构建副本SHA256一致。0.42应用仅保存，未上传；编译和native/网页测试不证明真实运动、识别或长期稳定性。当前设备仍是0.40.1。证据evidence/cat-flow-20261006/，当前流程规则见猫流程版本说明-20261006.md。
0.42应用字节数：3804368；SHA256：06D077E9BC6F9176D8167BC82CB43B6F33A0F605126CDCAE4D9ACBA74AE686FE。

## 06 · 网页服务、配置与可观测界面

**发展脉络：** 从真UART诊断入口→结果与原始画面对齐→轮询和HTTP连接预算→单HTTP共享四路视频→配置草稿／回读／实际驱动设置→跨重启浏览器历史。

**目前结果与边界：** 单服务内部3+客户端13=16 socket；四路视频180秒、额外每路805帧，属于受控短窗口，不能替代长期稳定。摄像头18项设置、NVS与驱动回滚、旧结果失效、SIM串口与真实摄像头来源分开。

**能力提炼：** 资源约束下的网页工程、并发调度、错误反馈、数据来源与配置生命周期；让诊断状态可见且不误导用户。

关联其他主题：[记录129](#record-129)、[记录137](#record-137)。

### 本章记录索引

| 记录 | 原始日志标题 |
|---|---|
| [005](#record-005) | 配套调试能力与版本归档 |
| [007](#record-007) | 下一阶段：ESP32 接管上位机并提供网页调试日志 |
| [013](#record-013) | 节点五：完善 ESP 网页真机调试 |
| [051](#record-051) | 2026-10-04：侧距已回报但策略未消费，ESP0.21协议解析修复 |
| [083](#record-083) | 3. 网页断连：已有快照不足以证明内存泄漏或CPU过载，尚未修复 |
| [085](#record-085) | 2026-10-05：Web掉线排查与修复——连接回收、轮询退避及网络诊断 |
| [086](#record-086) | 现象到代码风险：根因仍未确定 |
| [087](#record-087) | 源码处理：已实现，尚未部署 |
| [088](#record-088) | 验证与处理状态 |
| [089](#record-089) | Web掉线排查补充：当前IP采样、增量日志与最终编译结果 |
| [090](#record-090) | Web掉线修复部署补充：用户授权上传与短时HTTP验证 |
| [091](#record-091) | 2026-10-05：Web八路并发与完整Uno模拟回报——阶段验证及稳定性待验收 |
| [092](#record-092) | 2026-10-05：共享HTTP与四路视频持续显示——0.34部署及高压刷新限制 |
| [093](#record-093) | 从连接额度到减少请求：已实现的处理 |
| [094](#record-094) | 最终持续显示与负载数据 |
| [103](#record-103) | 2026-10-06：浏览器本地完整日志归档与共用摄像头参数界面（ESP32 0.39，未上传） |
| [118](#record-118) | 2026-10-07 main 配置保存行为统一 |
| [119](#record-119) | 2026-10-07 两分支宽度与地面标定显示（main） |
| [121](#record-121) | 2026-10-07 修复 SIM_UNO 下实际摄像头宽度不显示 |

### 本章完整记录

#### 记录005 · 配套调试能力与版本归档

来源：[原始日志](项目日志.md)，第51行；原主题：2026-09-30：从空板调试推进到真实电机测试。以下为该记录原文，状态按记录日期理解。

硬件页和策略页共用 14 路物理 IO 开关；未接输入可以选择场景模拟来源。硬件页提供电机、编码器、超声波、触碰及声光读数，采用紧凑卡片布局。导出日志补充协议版本、IO 开关状态及最后的遥测数据，便于再次定位问题。

Git 仓库原来只覆盖 `uno-web-lab`，工作用 Arduino 程序位于相邻的 `../uno-firmware`。本次将两个烧录程序和固件说明的源码快照纳入仓库的 [firmware](./firmware/README.md)，不纳入编译产物；原工作目录保留。后续更新须同步快照后再提交，避免网页和主固件版本不一致。

验证记录：53 项 Node 自动测试通过；主固件 V5.6 已通过 Uno 编译，25140 字节 Flash、1304 字节全局 RAM。未烧录设备、未进行 UI 操作或装轮实测。

#### 记录007 · 下一阶段：ESP32 接管上位机并提供网页调试日志

来源：[原始日志](项目日志.md)，第71行；原主题：下一阶段：ESP32 接管上位机并提供网页调试日志。以下为该记录原文，状态按记录日期理解。

用户希望 ESP32 完整承担当前电脑上位机的策略、运动控制及运行观测职责，并能通过网页查看真实机器人日志。目标是机器人装轮后，即使电脑没有运行当前模拟器，仍能自主执行策略，电脑或手机只作为调试浏览器。

该阶段尚未开始实现。具体范围、实施顺序和验收条件见 [ESP32 上位机与网页调试计划](./ESP32上位机与网页调试计划.md)。本日志后续追加实际结果，不把计划写成完成项。

#### 记录013 · 节点五：完善 ESP 网页真机调试

来源：[原始日志](项目日志.md)，第111行；原主题：2026-10-01 至 2026-10-02：ESP32 视觉调优与真实 Uno 通信联调。以下为该记录原文，状态按记录日期理解。

增加模拟/真实 UART 模式选择、传感器读数、配置与动作测试，支持网页设置左右安全距离。新增四个单轮正反转按钮和“绕过全部避障”测试开关；开启绕过后不等待前向标定，跳过前向、超声波和触碰拦截，每次最多运行 2 秒，急停保留。前向图像识别与判断由 ESP 完成，Uno 原先检查的是 ESP 下发的结果及有效期。

最新 ESP V0.6、Uno V5.8 已烧录。聊天验证记录为 72 项测试、Uno DRY_RUN 及板上模拟按钮映射通过；实际轮子转动与完整车辆动作留待用户现场验收。相关提交：`743e032`。

#### 记录051 · 2026-10-04：侧距已回报但策略未消费，ESP0.21协议解析修复

来源：[原始日志](项目日志.md)，第525行；原主题：2026-10-04：侧距已回报但策略未消费，ESP0.21协议解析修复。以下为该记录原文，状态按记录日期理解。

已核对修复会话的[协议解析报告](./esp32-host/协议解析修复-20261004.md)与[上传记录](./evidence/scan-handoff-20261004/upload-v021.json)。日志23配置装死/探索概率均0；217304ms CAT_CONFIRMED，217305ms ESCAPE_DIRECTION，217307ms以escape side observation expired退出。此前215840ms左距11.6cm、215841ms右距-1.0已回报。源码根因明确：侧距sscanf格式只有8个转换项，却要求返回9，side/sideAt从未更新。这里属于收到数据后的解析缺陷，不能写成线路丢包、传感器没有上报或概率抽错；界面有读数不代表策略已消费。

ESP0.21修正为8，拒绝非有限/超范围/多余字段；按用户规则保留-1无回波允许转向，未收到或超过2500ms仍拒绝。另收紧运动、ACK/ERROR、编码器、触碰及会话DONE解析：拒绝多余字段、非有限/负RPM、未知触碰区域/非法0或1状态、编号匹配但结果类型错误的完成回报。检查其余ESP/Uno解析，未发现第二处同类转换数量错误；Uno不改，仍6.9。

离线回放真实日志23 TB三块→解码→实际policyInput，左右时间戳更新；0/0概率对随机0/50/99均逃跑，右-1能进入ESCAPE_TURN，后续正确完成/停车确认可进入ESCAPE_MOVE并发DRIVE。实际策略730、扫描259、猫互动245、PWM/配置2628检查及视觉门/CRC通过，相关Node41项通过。额外state-inventory文档同步检查失败，旧清单缺CAT_CONFIRM等，列为待同步文档，不能说所有测试全通过。网页接口间歇性超时本次未修复。

ESP编译Flash3734170/8257536、静态RAM78928/327680；COM11同MAC设备分区比对通过后仅写0x10000应用3734320字节，46.6秒、哈希验证通过、RTS重启。[保存状态](./evidence/scan-handoff-20261004/esp-v021-after-upload.json)回读0.21、SIM_UNO/IDLE、cameraOk=true、停止待确认0、0/0概率保留。上传完成，不等于实机逃跑已通过；未启动实体电机或现场逃跑验收。本轮仅读取保存证据、统一补日志。

#### 记录083 · 3. 网页断连：已有快照不足以证明内存泄漏或CPU过载，尚未修复

来源：[原始日志](项目日志.md)，第848行；原主题：2026-10-05：三帧猫复核、识别预览与断连重启证据归类。以下为该记录原文，状态按记录日期理解。

log41（ESP ms275022、heap17464）到log42（ms450806、heap13880）下降3584字节，只有两个快照，不能证明持续泄漏。log42摄像头与Uno心跳继续；431093ms进入STOPPED/FAULT，原因 `tag search failed result=0`，431105ms收到STOP确认。导出时猫结果已旧84.6秒、vision OFF，不能用旧270ms推理耗时证明当时CPU过载。`droppedLogs` 是160条日志环的覆盖计数，不是网络丢包。

多路HTTP轮询及较小internal heap只是排查方向。reset reason、WiFi事件、HTTP耗时、minHeap、largestBlock尚未记录，轮询减负也尚未实施；网页断连的根因仍未确定。

#### 记录085 · 2026-10-05：Web掉线排查与修复——连接回收、轮询退避及网络诊断

来源：[原始日志](项目日志.md)，第871行；原主题：2026-10-05：Web掉线排查与修复——连接回收、轮询退避及网络诊断。以下为该记录原文，状态按记录日期理解。

用户确认现象是整个网页显示“连接中断”。实施计划为先核查HTTP服务、并行轮询与Wi-Fi管理，再修复源码和运行离线验证，最后记录证据及待测项。完整报告见 [Web掉线排查与修复](esp32-host/Web掉线排查与修复-20261005.md)。本日志会话读取报告与当前源码，没有操作硬件。

#### 记录086 · 现象到代码风险：根因仍未确定

来源：[原始日志](项目日志.md)，第875行；原主题：2026-10-05：Web掉线排查与修复——连接回收、轮询退避及网络诊断。以下为该记录原文，状态按记录日期理解。

历史地址192.168.137.188与192.168.137.130的只读 `/api/state` 请求分别5秒、6秒超时，当前IP未确认，未取得当前快照。页面提示可由状态请求、解析或界面更新失败引发，不是Wi-Fi断开的直接证明；超时也不能单独证明HTTP阻塞、复位或内存不足。

已安装Arduino ESP32核心3.3.12的HTTP默认7连接、LRU关闭、收发等待5秒。状态接口轮询等待600ms，猫图200ms，benchmark闲置1000ms；测试时状态250ms、图100ms，都是配置间隔而非实测频率。网页状态超时4秒短于服务可能等待5秒，存在慢图占用服务、请求排队和连接用尽风险，但尚无连接耗尽记录。核心原来默认已开启自动重连，不能写成原来没有重连。

#### 记录087 · 源码处理：已实现，尚未部署

来源：[原始日志](项目日志.md)，第881行；原主题：2026-10-05：Web掉线排查与修复——连接回收、轮询退避及网络诊断。以下为该记录原文，状态按记录日期理解。

修复版本 `ESP32_CAT_HOST_0.30_WEB_RECOVERY`：两个HTTP服务启用LRU、收发超时2秒；状态锁最多等待250ms，忙时503。猫图按新结果取图，断线暂停辅助取图、释放实时视频，丢弃迟到图；状态失败采用1200/2400/3000ms退避，成功恢复600ms，只恢复读数，不重发操作命令。猫图检查350ms；benchmark状态开启600ms、闲置3000ms、图350ms。这些调整只降低网页展示请求，不改变推理与行为节奏。

显式开启核心自动重连，持续未连接时每30秒补充重试；关闭modem sleep，可能增加功耗，效果待测。新增WiFi断开原因码、次数、时间、RSSI、重连次数、resetReason、minHeap及largestBlock诊断；回调入队，loop记录。这为后续区分Wi-Fi、HTTP、复位和内存问题提供数据，不能当作本次根因已找到。

#### 记录088 · 验证与处理状态

来源：[原始日志](项目日志.md)，第887行；原主题：2026-10-05：Web掉线排查与修复——连接回收、轮询退避及网络诊断。以下为该记录原文，状态按记录日期理解。

网页回归44/44通过；内嵌网页gzip由78522压至27652字节，无损校验通过。固件离线编译仍待最终结果确认。没有刷板、打开串口、复位或运动测试，Uno未修改。真实Web稳定性、HTTP成功率/RTT/P95、热点断开恢复、IP变化和功耗均待测，不能宣称掉线已经解决。

后续建议在确认停车并部署后，分别运行状态、识别预览和benchmark各10分钟，记录成功率、连续失败及network快照；结合uptime回退、resetReason、WiFi原因和内存块数据判断。此为待执行验收计划，不是已测数据。

#### 记录089 · Web掉线排查补充：当前IP采样、增量日志与最终编译结果

来源：[原始日志](项目日志.md)，第893行；原主题：2026-10-05：Web掉线排查与修复——连接回收、轮询退避及网络诊断。以下为该记录原文，状态按记录日期理解。

用户随后确认当前IP为192.168.137.130，再次只读采样成功，设备仍为0.29、UART/IDLE。以下补充更新上一节“IP未确认、编译待确认”的阶段状态；0.30修复仍未刷入设备。证据见 [最终验证](evidence/web-recovery-20261005/verification.json)、同目录 `http-before-samples.json`、`curl-before-samples.json`、`before-state.json` 与 `payload-estimate.json`。

5次PowerShell调用至JSON解析完成分别8237/6389/6504/5414/9607ms，全部成功。这包括客户端开销，不是ESP单独耗时；TimeoutSec6未形成严格总时限。ESP uptime11670924→11698931ms、frameSeq57759→57899，窗口内没有uptime回退；heap13656/13904/13908/13640/12192字节，仅少量快照，不能证明泄漏。

curl禁用代理、连接超时2秒、总超时6秒，获得更清楚的传输边界：

| 样本 | TCP建连ms | 首字节ms | 总耗时ms | 结果 |
| --- | ---: | ---: | ---: | --- |
| 1 | 15.397 | 5891.852 | 6010.429 | HTTP200但仅4249/22122字节，exit28，超时且不完整 |
| 2 | 26.928 | 1182.486 | 1903.665 | 22135字节，exit0，完整 |
| 3 | 3.896 | 80.069 | 4374.202 | 22128字节，exit0，完整 |

第一份截断正文不能当有效JSON快照。建连快、首字节或正文慢，支持响应/传输可超过网页4秒门槛，但3次样本仍不能区分服务排队、Wi-Fi传输及客户端因素，唯一根因未确定。

针对实际约22KB状态响应，新增网页 `afterLog` 游标增量读取，每轮最多40条新增日志，浏览器去重保留160条，设备复位清空。高频期间超过40条的部分日志可能不进入网页历史；无参数完整API及USB state仍有最近160条，诊断应使用完整接口。相同旧快照离线估算：完整22132字节、最近40条11752字节、无新增8293字节；新版另增network与游标字段，这不是新版实测尺寸或提速数据。

最终网页回归45/45通过，gzip78949→27818字节无损通过；包含增量日志与最终网页的离线编译通过，Flash3772038/8257536字节、静态RAM85296/327680字节。静态RAM不是运行时heap余量。编译最初受sandbox访问Arduino15符号链接限制，获离线编译权限后成功，无新核心安装。

处理状态更新为“源码修复完成、网页检查及离线编译通过、尚未部署”；没有刷板、打开串口、复位或运动测试。新版真实稳定性、网络恢复与功耗仍待验收，不能把旧版采样当新版效果。

#### 记录090 · Web掉线修复部署补充：用户授权上传与短时HTTP验证

来源：[原始日志](项目日志.md)，第915行；原主题：2026-10-05：Web掉线排查与修复——连接回收、轮询退避及网络诊断。以下为该记录原文，状态按记录日期理解。

用户随后明确授权“上传吧”，因此前述“尚未部署”保留为历史阶段状态；0.30现已完成ESP应用上传。证据为 [更新后的验证](evidence/web-recovery-20261005/verification.json) 及 [报告上传结果](esp32-host/Web掉线排查与修复-20261005.md)。本日志会话仅核对并记录，未操作设备。

上传前COM11（VID303A/PID1001）回读0.29、IDLE/SIM_UNO，motorId0、motorRunning=false、stopPendingId0、stopUnconfirmed=false、debugBusy=false，ms约588为启动快照；此前UART采样不能写成全过程始终UART。3072字节分区表逐字节匹配，仅0x10000应用写入3772192字节，25.4秒，`Hash of data verified`，随后RTS重启；未写NVS、分区表、bootloader或Uno。

HTTP读回 `ESP32_CAT_HOST_0.30_WEB_RECOVERY`，IP仍192.168.137.130。原config逐字段保留，路线[46,40]、catCheckMaxFrames3、最低PWM255不变。HTTP根页面原始gzip与编译字节完全相同，这是服务内容验证，不是浏览器视觉验收。

20次串行增量curl请求，每轮完成后等600ms，20/20完整HTTP200：最小27.640、中位数63.899、P95 110.722、最大193.734ms，断开计数0。这20次的采样uptime为56639→70022ms，约13.4秒；重启后首次完整状态123.773ms。verification的uptimeStart15473属于更早回读，不能将它误算为20次采样起点。

这是重启后SIM_UNO/IDLE的短时只读验证；旧版为长时间运行后的UART/IDLE，日志量和负载不同，不能把全部差异归因于修复，也不能宣称长期掉线、真实UART、多窗口或模型/图像并行已解决。没有运动或主动关闭热点的重连测试，长期稳定性、恢复与功耗仍待验收。设备当前SIM_UNO/IDLE，用户刷新新网页后自行选择真实UART。

#### 记录091 · 2026-10-05：Web八路并发与完整Uno模拟回报——阶段验证及稳定性待验收

来源：[原始日志](项目日志.md)，第927行；原主题：2026-10-05：Web八路并发与完整Uno模拟回报——阶段验证及稳定性待验收。以下为该记录原文，状态按记录日期理解。

用户授权后，`ESP32_CAT_HOST_0.31_WEB_SOCKETS_8` 已经COM11应用上传，分区一致、仅0x10000写入并hash验证。控制服务客户端上限7→8，视频2；SDK `CONFIG_LWIP_MAX_SOCKETS=16` 是总socket预算，不代表16路业务并发已验收。证据：[八路并发验证](evidence/web-sockets-20261005/verification.json)。

8并行×5组共40次HTTP读取全部成功，中位306.5095ms、P95 1173.307ms、最大1235.699ms。但当时为SIM_UNO/IDLE空回报，只证明该负载下HTTP服务可响应，不代表真实网页数据或真实UART验收，也不能外推无限并发。

随后用户要求更新网页JS Uno模拟器并测试实际页面。已补TB v1的50字节、3段CRC遥测，展开13行，以及AK/MS/MP/MD/MA、SCAN_V1停稳VQ/VR/SD、重传去重和配置回读。路线来自板上保存值[46,40]。实际网页显示13项，模拟动作后左右编码器各4脉冲；这些均为SIM/DRY_RUN、物理IO掩码0，不能作为实车编码器或运动数据。

逐行HTTP模拟回报请求多，发现会丢一段，处理为仅SIM_UNO允许的批量回报、本地HTTP桥及减少重复状态读取。Wi-Fi断开计数0仍曾出现TCP reset，最低heap544字节，说明网络计数不能覆盖全部失败，也不能宣称内存充足。证据与阶段文件见 [模拟协议证据目录](evidence/web-sim-protocol-20261005/)。其verification.json记录0.32及119项测试，更新的tests-final.txt记录120项通过，不能将阶段版本元数据直接当作最终0.33部署证明。

正在编译 `0.33_WEB_SIM_STABLE`：只读状态第一次失败后重试，再判断断连；SIM_UNO空闲遥测最多间隔1秒，真实UART间隔策略未改，以避免后台计时拖延。120项JS检查通过；本阶段最终上传与持续网页验收仍进行中，尚未记录为通过。物理运动、真实UART、多窗口长期稳定性与16总并发均不能据此认定解决。

#### 记录092 · 2026-10-05：共享HTTP与四路视频持续显示——0.34部署及高压刷新限制

来源：[原始日志](项目日志.md)，第939行；原主题：2026-10-05：共享HTTP与四路视频持续显示——0.34部署及高压刷新限制。以下为该记录原文，状态按记录日期理解。

接续0.31–0.33阶段排查，最终 `0.34_SHARED_HTTP` 已COM11仅应用上传、分区一致、hash验证、配置保留。编译程序3774906字节，静态RAM85352字节。证据见 [完整过程与最终观察](esp32-host/网页模拟器协议与持续显示验收-20261005.md) 及 `evidence/web-sim-protocol-20261005/`；本日志会话仅读取记录，无设备操作。

#### 记录093 · 从连接额度到减少请求：已实现的处理

来源：[原始日志](项目日志.md)，第943行；原主题：2026-10-05：共享HTTP与四路视频持续显示——0.34部署及高压刷新限制。以下为该记录原文，状态按记录日期理解。

SDK总预算16个socket，原来两个HTTP服务各占3个内部socket。最终合并为单HTTP服务：内部3+客户端13=16，最多4视频长连接，视频满载时另9个客户端额度给API。额度不是同时执行请求数或性能承诺。视频地址改为 `http://192.168.137.130/stream`，旧81端口停止，外部客户端需更新。视频异步处理，避免旧循环占住HTTP线程。

网页读取串行；PC模拟器GET/POST也共享单请求队列，合并排队旧视觉观测，命令及遥测不丢弃。实际浏览器出现过 `Illegal invocation`，原因是fetch作为对象成员调用，函数包装后重新加载连接成功。123项自动检查通过，见tests-final-clean.txt。

#### 记录094 · 最终持续显示与负载数据

来源：[原始日志](项目日志.md)，第949行；原主题：2026-10-05：共享HTTP与四路视频持续显示——0.34部署及高压刷新限制。以下为该记录原文，状态按记录日期理解。

4视频（实际网页1路+额外3路）运行180秒，额外每路HTTP200、805帧、约2.86MB，首字节157–175ms，无提前关闭或流错误；第5路503。网页120个样本跨度178717ms，13行始终保留、视频始终320像素宽、整页断连0次。不过数据过期5次，最大年龄5521ms；最后40个样本无过期、最大2404ms。结论是本窗口保持显示已验，高压下始终新鲜未验通过，不能写为长期稳定。

额外6路API×5组，共30请求29成功、1次fetch failed；中位394.0145ms、P95 3089.1067ms、最大3163.967ms，成功响应均13行，Uno age最大6201ms。WiFi断开0，但不覆盖HTTP失败；累计最低heap248字节含前期压力，不能宣称内存充足、无限并发或高压刷新延迟已解决。

最终实测为ui-final-samples.json、video-load-final.json、concurrent-final.json及page-final.png，before-transport和first文件属历史阶段，不混算。验证为SIM/DRY_RUN、物理IO掩码0：真实页面确实观察过，但传感器/编码器来自模拟，不是真实UART或运动验收。真实UART、实体传感器、长期稳定性及内存压力仍待测。

#### 记录103 · 2026-10-06：浏览器本地完整日志归档与共用摄像头参数界面（ESP32 0.39，未上传）

来源：[原始日志](项目日志.md)，第1041行；原主题：2026-10-06：浏览器本地完整日志归档与共用摄像头参数界面（ESP32 0.39，未上传）。以下为该记录原文，状态按记录日期理解。

**本地日志。** 原网页只在 JavaScript 内存保留最近 160 条，并在设备 uptime／序号回退时清空，因此刷新及 ESP 重启后不能从页面导出此前历史。现改为浏览器 IndexedDB 归档，ESP 环形缓冲仍为 160 条；网页请求允许取回当前缓冲内最多 160 条增量，按设备 ID、随机启动 ID、序号去重，重启时通过 bootId 重置设备游标。当前策略面板仍使用单次启动的有限窗口，独立历史面板显示最近 500 条，本地持久历史不自动裁剪。导出按钮读出当前来源下的全部历史及本页面尚未落盘的记录，并附最后状态快照、接收时间、启动批次、断线、漏收区间、摄像头参数变更。导出与接收共用序列队列，避免导出时把新记录错误清掉。

**保留边界。** 当前页面打开时，ESP 断线仍可导出；重新获得网页后可读回当前浏览器／网页地址的本地历史。不同 AP／局域网地址、不同浏览器各自保存。网页关闭期间不采集新数据，ESP 缓冲已经覆盖的漏收记录不能补回，原始 panic 串口 backtrace 不在应用 HTTP 日志中。本地存储仍受浏览器容量、清理和驱逐影响；容量错误明确显示并保留当前页面待保存数据，读取失败拒绝导出不完整文件。导出后不自动删数据。

**摄像头界面与真实通路。** 摄像头面板开放 18 项设置：JPEG 质量、亮度／对比度／饱和度、自动曝光／曝光目标／AEC2／手动曝光、自动增益／手动增益／增益上限、自动白平衡／白平衡增益／预设、伽马／镜头校正／镜像／翻转。标签与猫识别共用同一物理传感器设置；QVGA 320×240、JPEG 格式保持固定。只在停车确认、无手动操作、性能实验关闭时应用；HTTP 仅入队，控制循环校验类型、范围和驱动支持，取帧与 SCCB 设置互斥。实际驱动配置存入独立 NVS camera 键，并在重启恢复；界面按 requestId 等待板上结果，不把排队成功当作保存成功。自动模式的实时曝光／增益不是驱动配置状态的测量值。恢复按钮可应用并保存本机启动默认组。

**旧画面失效与保存顺序。** 参数调整取消旧识别票据，清掉 JPEG 和识别原图，丢弃接下来的两帧并要求采集时间晚于变更时刻；已开始的旧推理不能发布新预览，浏览器晚到的旧 JPEG 也不能复原旧猫框。计时历史按摄像头参数批次重新开始。空地外观参考立即失效，并先持久化失效状态、后写入新摄像头配置，避免两次写入之间断电后误用旧参考。驱动或保存失败会尝试回滚；回滚失败明确显示，重新标定仍须现场操作。

**离线验证。** Node 网页、归档、预览、性能实验及状态清单共 **60 项通过**。归档测试包括累计 **1200 条** 后刷新和 ESP 重启、重复回复去重、序号重复跨设备／启动隔离、存储满仍完整导出待保存数据、读取失败拒绝伪完整导出、导出与拉取并发。新增真实摄像头设置核心 **67 项**、固件编排 **65 项**原生检查通过，覆盖类型／范围、自动与手动状态、驱动量化、拒绝与回滚、NVS 写入顺序／失败、重启恢复、停车／调试／实验／忙门禁及旧缓存失效。全部 11 个原生可执行测试通过：原扫描 287、预览 20、策略 1193、猫复核 662、标签与平均计量 429、连续互动 703、配置／PWM 2663，视觉门禁和串口保护专项通过。最终 ESP32 编译数字见下方及证据目录。

没有操作串口、烧录、真实浏览器界面或摄像头。本轮未改 Uno；浏览器 IndexedDB 实际验收、ESP NVS／摄像头真机回读、识别效果和连续运行为**待测**。证据：evidence/local-log-camera-settings-20261006/。之前已经上传的配对基线仍为 ESP 0.38／Uno 6.11。

最终 ESP32 离线编译成功：**3791846/8257536 bytes Flash**、**85584/327680 bytes 静态 RAM**（局部变量可用 242096 bytes）。生成网页 **96953 bytes → 34037 bytes gzip**，压缩往返一致。最终 .ino、摄像头设置头、vision.cpp／vision_preview.h 和生成网页头与编译用拷贝 SHA256 全部一致；应用哈希见 verification.json。没有上传，板上运行版本未因此改变。

#### 记录118 · 2026-10-07 main 配置保存行为统一

来源：[原始日志](项目日志.md)，第1232行；原主题：2026-10-07 main 配置保存行为统一。以下为该记录原文，状态按记录日期理解。

按用户要求，main 改为先更新运行配置再写入 NVS，不检查写入返回值，与维护分支相同。仍清除配置变更前的搜索记忆。保存失败时运行值可能与重启后的值不同，这是选择保留的旧行为。移除不再使用的完整写入检查及对应测试。此次未操作设备，离线验证随本轮后续修改完成。

#### 记录119 · 2026-10-07 两分支宽度与地面标定显示（main）

来源：[原始日志](项目日志.md)，第1237行；原主题：2026-10-07 两分支宽度与地面标定显示（main）。以下为该记录原文，状态按记录日期理解。

新增摄像头区域猫框宽度及当前路线目标标签 ID/宽度，以画面宽度百分比显示一位小数；使用已完成识别结果，不增加推理次数。未识别、无效、过期、模拟和断线均有提示。新增地面参考、前向开关、当前判断、地面差异与阈值回读。新增 groundReferenceChangedAt 状态字段：标定、ROI 和相机设置变化记录时间，只有其后采集的新帧才显示标定有效判断；已标定不代表实车避障验收通过。

验证：14 个原生程序通过，包括动作恢复 41 项检查；69 项网页/状态测试通过；XIAO ESP32S3 离线编译通过，程序 3805410 字节，静态 RAM 85720 字节；6 个源码输入哈希与编译副本一致。编译及测试记录见 evidence/branch-alignment-20261007/main-*。完整写入检查测试已移除；配置值先更新运行内存再尝试保存，与维护分支一致。

保留本地 main 原有猫/标签方向记忆、漏检宽限、局部搜索和复核，未合入远端晚上的逃跑避障。未推送、未烧录、未进行串口或实机行为测试。待验收：标签漏检/局部恢复、猫丢失搜索、找回后动作衔接、宽度与标定状态。后续分别合并远端提交并重新测试，保留本轮修改，不覆盖远端历史。

#### 记录121 · 2026-10-07 修复 SIM_UNO 下实际摄像头宽度不显示

来源：[原始日志](项目日志.md)，第1255行；原主题：2026-10-07 修复 SIM_UNO 下实际摄像头宽度不显示。以下为该记录原文，状态按记录日期理解。

用户截图显示真实猫识别成功而宽度仍等待模拟输入。原因是新界面把串口模式误当作视觉结果来源。改为优先读取实际 catPreview 和 cameraVision，SIM_UNO 下也显示摄像头测量；无实际结果时才回退模拟输入，并明确标注。真实未识别/过期结果不被模拟检测替换，标签宽度及地面判断同样修复。新增真实摄像头与模拟输入同时存在的回归，71 项网页/状态测试通过。仅显示逻辑和压缩网页变化，不改机器人控制、识别频率或阈值。离线编译和授权部署记录随后追加。

## 07 · 遥控、路线编辑与续巡体验

**发展脉络：** 现场搜索失败后原地停住→人工移出困境→从指定路线位置续巡→双卡片路线编辑→配置确认兼容→小NVS路线记录→手机／电脑操作区重排。

**目前结果与边界：** 0.43加入按住方向、速度和声光、租约与停车交接；0.44识别裸DONE确认；0.45证实51没显示因路线写入失败，2715字节需86条目而活动页连续仅75；独立保存后43／46／51重启回读完整。

**能力提炼：** 围绕现场恢复设计产品闭环，区分控制模式与路线编辑，处理跨设备交接、错误确认和响应式布局。

关联其他主题：[记录137](#record-137)。

### 本章记录索引

| 记录 | 原始日志标题 |
|---|---|
| [127](#record-127) | 2026-10-12：DEV 手机遥控与指定路线节点续寻（已烧录，实车验收待完成） |
| [128](#record-128) | 2026-10-12：补全自定义路线，修复遥控配置确认超时（ESP 0.44 已烧录） |
| [129](#record-129) | 2026-10-12：末节点 51 未显示——路线写入失败修复（ESP 0.45 已烧录） |
| [130](#record-130) | 2026-10-12：DEV 0.46 手机与电脑操作区布局 |

### 本章完整记录

#### 记录127 · 2026-10-12：DEV 手机遥控与指定路线节点续寻（已烧录，实车验收待完成）

来源：[原始日志](项目日志.md)，第1314行；原主题：2026-10-12：DEV 手机遥控与指定路线节点续寻（已烧录，实车验收待完成）。以下为该记录原文，状态按记录日期理解。

Git：开始修改前受跟踪文件和暂存区无待提交改动，从本机 main 592621b 创建 DEV。历史 evidence 未跟踪资料留在本地；本次改动暂未提交，逐项说明见《本次改动清单-20261012.md》，由用户决定提交。

实现：巡逻和遥控两处均可输入标签 ID 筛选已保存路线、选择路线节点并续寻；重复 ID 区分节点位置。先寻找所选标签，再按原序列继续。手机遥控支持按住前后移动及左右原地转向、松手停车、独立 PWM 0–255、三种声音模式、按住鸣叫和随机灯光。避障、猫识别、标签识别拆分卡片。遥控接管期间按约定绕过环境/触碰保护；保留失速、急停、动作与会话超时。方向与持续声音 150 ms 续期、600 ms 有效期；相同方向续期不重置失速计时。停车和会话确认后才能交接自主续寻。新 ESP 接受新旧 GET_CONFIG，新遥控要求 Uno REMOTE_V1；回滚旧配对版本须恢复两端。

烧录前实际证据：COM11 USB 回报 ESP32_CAT_HOST_0.42_FRONT_APPROACH_PRIORITY，设备 c0871ead4f7c、SIM_UNO/IDLE。ROM 模式完整读出 8,388,608 字节 Flash，SHA256 CF0D7846098618CDCD30D4FD397E7B3C9529D724CC684E79B93E59637BD1DA5B；首次 stub 高速读取中断，完整备份以重试成功文件为准。COM10 恢复后先确认 MOTOR_STOPPED 和 SESSION_STOPPED；原 Uno 32 KB Flash 包含 READY UNO_CAT_V6.12，保留 Intel HEX 和二进制。原 HEX SHA256 19EC50CD7CAD1AC2A853C45515C03812F7DFDA5A449575208460EC815BC87068。

实际编译与测试：网页相关 Node 72/72 通过；完整原生回归全部通过，其中实际遥控控制器 65 个断言、实际 Uno 运动/解析 68,855 个断言。最终 ESP Flash 3,828,078/8,257,536 字节，静态 RAM 85,928/327,680；应用文件 3,828,224 字节。Uno Flash 32,250/32,256 字节，仅剩 6 字节，静态 RAM 1,387/2,048。源码顶部注释和内部回报版本同步为 ESP32_CAT_HOST_0.43_REMOTE_RESUME / UNO_CAT_V6.13。

实际部署：新旧分区表逐字节一致，ESP 只写 0x10000 应用，工具哈希校验通过；另用 ROM 模式完整读回 3,828,224 字节，与构建文件逐字节一致，SHA256 57a052159ed2d26473ab30950146ea81d44a24e1b0e4d321311cdb78ee1d6b8f。USB 在线回报 ESP 0.43，同一设备、SIM_UNO/IDLE、stopPendingId=0、stopUnconfirmed=false；全部 config 和 cameraSettings.actual 与烧录前一致。Uno upload --verify 成功，另读出完整 Flash，与编译 HEX 覆盖的 32,250 字节全部一致，实际镜像包含 READY UNO_CAT_V6.13；GET_CONFIG 实际追加 REMOTE_V1，STOP/SESSION_STOP 的 CRC 校验完成回报通过。Uno 启动串口 READY 未单独捕获，不把镜像字符串检查写成启动串口回报。

验收边界：未发送运动命令，ESP↔Uno 串口仍需用户接回，当前保留 SIM_UNO。离线无头浏览器未能完成截图，网页视觉和真机方向、速度、声光、断线停车、指定节点续寻均待现场验收。原始工具输出、状态、备份和 validation.json 保存在 evidence/remote-resume-20261012/，大备份不纳入 Git。使用步骤见《遥控与续寻.md》。

#### 记录128 · 2026-10-12：补全自定义路线，修复遥控配置确认超时（ESP 0.44 已烧录）

来源：[原始日志](项目日志.md)，第1329行；原主题：2026-10-12：补全自定义路线，修复遥控配置确认超时（ESP 0.44 已烧录）。以下为该记录原文，状态按记录日期理解。

补全巡逻与遥控两张卡片内的路线编辑、保存和指定节点续巡：输入标签序列可用逗号、空格、箭头或 JSON 数组；草稿两处同步，不被轮询覆盖。保存需确认停止，ESP 按请求编号回报 NVS 保存结果；成功并匹配实际路线后才显示已保存。保存路线不启动电机，续巡选择来自实际保存序列，重复编号按节点位置区分。

用户提供 esp32-local-history-2026-10-12T20-20-26-841Z.json。日志显示 Uno 正常回报 CONFIG REMOTE_V1 和裸 DONE 114，但 ESP 遥控原代码期待 DONE 编号后还有空格，CONFIG 阶段漏判并超时。这是上轮遥控实现和测试样例的遗漏。0.44 修复裸 DONE 匹配，并保留 STOP/SESSION 的严格完成原因检查，超时诊断附等待命令及编号。自主、通信恢复、调参、停车门禁、遥测和运动/扫描编号匹配逐项对照实际 Uno 格式检查，未发现另一处同类尾缀超时；详情见《串口回报匹配检查-20261012.md》。

按用户“不要过多测试”要求，只做受影响验证：网页 61/61 通过；实际路线保存控制器 17 个断言，实际遥控控制器 71 个断言通过。最终编译 Flash 3,830,690/8,257,536 字节，静态 RAM 85,992/327,680；应用文件 3,830,832 字节，SHA256 487d5ce5ac78680865e0174a17bef4bd75787e8814251a6f85dfe6befc912bb6。构建副本与工作区关键源码一致，分区表不变。

烧录前 USB 实际回报 0.43，同设备 c0871ead4f7c；保留此前独立完整回读的 0.43 应用作为回滚备份，Uno V6.13 保持不变。只写应用 0x10000，工具写入哈希验证通过；另以 ROM verify-flash 校验 3,830,832 字节，摘要一致。本轮没有再完整读出 0.44 应用，不将摘要校验写成逐字节回读比较。

静止真 UART 验证：保存原路线 [43,46] 得到匹配请求的 saved 回报，进入遥控 ACTIVE 和退出到 STOPPED 均成功，停车确认正常；全程未发送移动命令。独立 Flash 校验复位后 USB 回报 ESP32_CAT_HOST_0.44_ROUTE_EDITOR，SIM_UNO/IDLE、stopPendingId=0、stopUnconfirmed=false；全部配置和摄像头实际设置与烧录前一致。原始证据与 validation.json 在 evidence/route-editor-20261012/。现场运动、声光及完整巡游效果仍待验收。本次继续保留未提交状态，由用户决定提交。

#### 记录129 · 2026-10-12：末节点 51 未显示——路线写入失败修复（ESP 0.45 已烧录）

来源：[原始日志](项目日志.md)，第1342行；原主题：2026-10-12：末节点 51 未显示——路线写入失败修复（ESP 0.45 已烧录）。以下为该记录原文，状态按记录日期理解。

用户明确输入路线为 43、46、51，最后节点在续寻列表中不显示。实际 USB UTF-8 回读证实板上仍为 [43,46]，routeSave 返回“路线写入失败，未确认保存成功”。只读备份当前 NVS 分区（0x9000、20 KB）并检查条目布局：原 config 字符串含终止符 2,715 字节、跨度 86 条目；当前活动页连续空条目 75，其他已满页存在零散空间，另有垃圾回收保留空页。整份配置替换写入失败，51 未进入保存路线，因此列表仍按两个旧节点生成；不是末节点索引越界。

ESP 0.45_ROUTE_STORAGE 将路线保存为独立小 NVS route 记录，写入后立即读取核对，成功才应用到 RAM；启动读取独立路线，没有新键时兼容原配置内路线。旧 config、摄像头和地面参考保留，不擦除 NVS。旧 route-only config 接口转入同一保存流程；整份配置成功写入时同步路线记录。网页板上路线更新时同步高级参数草稿内的 route，保留其他草稿字段，避免后续保存参数时带回旧路线。

按用户要求只做针对性验证：遥控/路线网页 10/10 通过，新增 [43,46,51] 两处选择框包含第三节点、index=2 请求检查；实际路线存储与启动恢复 19 个断言通过。最终编译 Flash 3,832,090/8,257,536 字节，静态 RAM 85,992/327,680；应用文件 3,832,240 字节，SHA256 cb615c80244f70c392e22af3fc68ff13b9fecc570ad793a44a57ce63b677beb2。

保留已校验 0.44 应用和修改前 NVS 备份，分区表不变，仅烧录 0x10000 应用；写入哈希及独立 ROM verify-flash 摘要校验通过。随后按用户给出的序列保存 [43,46,51]，收到匹配请求的 saved 回报；复位后 USB 版本为 ESP32_CAT_HOST_0.45_ROUTE_STORAGE，同设备 c0871ead4f7c，路线仍为 [43,46,51]，其他全部 config 项与修改前一致，SIM_UNO/IDLE、stopPendingId=0、stopUnconfirmed=false。Uno V6.13 不变，未发送巡游或移动命令，真实巡游结果不作为本轮已验收项。证据在 evidence/route-last-node-20261012/validation.json 和状态、备份、工具输出。Git 仍未提交。

#### 记录130 · 2026-10-12：DEV 0.46 手机与电脑操作区布局

来源：[原始日志](项目日志.md)，第1353行；原主题：2026-10-12：DEV 0.46 手机与电脑操作区布局。以下为该记录原文，状态按记录日期理解。

电脑顶部左列为 UART／巡游／路线，中间列上方摄像头、正下方前向避障及左右超声波状态，右列遥控。中间列使用独立容器，避免左右卡片高度在预览与避障间产生空隙。宽度不超过 1000px 时按 UART／巡游、摄像头、遥控、避障排列，猫与标签识别随后显示。

顶部注释与内部回读同步更新为 ESP32_CAT_HOST_0.46_CONTROL_LAYOUT；Uno 维持 V6.13。19 项页面／遥控检查通过，HTML 容器平衡检查通过。最终编译 Flash 3832138/8257536 字节、静态 RAM 85992/327680 字节。

烧录前串口回读 0.45、UART、STOPPED，路线 [43,46,51]、停车已确认。保留的 0.45 应用与板上 ROM Flash 摘要匹配；新应用只写入 0x10000，分区表与原备份一致，写入 Hash 校验及独立 ROM 摘要校验成功。烧录后回读 0.46、SIM_UNO、IDLE、路线 [43,46,51]，全部 config 与烧录前一致。重启进入模拟模式沿用既有默认。证据位于 evidence/control-layout-20261012/。未发送移动或巡游指令，未完成真实浏览器视觉验收。改动仍未提交，待用户决定。

## 08 · 容量、构建、部署与版本管理

**发展脉络：** Uno容量接近上限→正确板型与优化配置→紧凑解析→源与构建哈希→应用分区限定写入→版本回读、配置保留与回滚→分支边界。

**目前结果与边界：** 早期IDE构建33828超32256，后续解决构建配置。Uno6.12为31902字节，独立Flash比较通过；0.47只写应用且ROM摘要匹配。源码ZIP／bundle、应用备份和NVS备份是不同回滚范围。

**能力提炼：** 受约束交付、可复现构建、版本控制、部署核验和风险界定；能守住用户授权与维护分支边界。

关联其他主题：[记录127](#record-127)、[记录136](#record-136)。

### 本章记录索引

| 记录 | 原始日志标题 |
|---|---|
| [031](#record-031) | 2026-10-03：批准方案离线实施与版本节点 |
| [033](#record-033) | 2026-10-03：Uno容量与手动IDE上传配置 |
| [102](#record-102) | 2026-10-05：Uno 6.11 / ESP32 0.38 上传与 Arduino IDE 容量配置修复 |
| [108](#record-108) | 4. 最终优先完成的ESP固件烧录与回读（0.40） |
| [120](#record-120) | 2026-10-07 用户授权 main 应用区烧录与回读 |
| [133](#record-133) | 10 月 6–7 日 Git／逃跑流程交接的边界 |

### 本章完整记录

#### 记录031 · 2026-10-03：批准方案离线实施与版本节点

来源：[原始日志](项目日志.md)，第299行；原主题：2026-10-03：批准方案离线实施与版本节点。以下为该记录原文，状态按记录日期理解。

授权依据为本会话用户明确“批准执行”，要求现状及关键节点 Git 提交；随后允许上传，但 RESET、界面操作和运动测试由用户完成。附件是历史背景，不自行扩大设备操作授权。上一章历史量化审计完整保留，以下只记录本轮新实施和离线证据，没有新实测。

版本节点：现状快照 `ba5afeb962d88d399d7a9e2760c1e11c7ace0f76`；Uno扫描协议 `059bf301bf18a281c06be466fd18997be11bfa27`；实际 ESP/Uno协调、视觉、页面和测试 `87a2de6bd32de26bb257b472ee529fb3c2385809`。各提交正文记行为、兼容配置、验证与未验收范围。未推送远端。

Uno V6.6增加非阻塞分步扫描和 SC/SR/VR，受CRC保护VQ携带scanId/stepId/generation/累计usedPulses，SD回报终态；转动后本地静止窗口、有限视觉等待和累计两圈预算。保留纯ROTATE±360、持续MOTOR和有界DRIVE。触碰/STOP/失速/内存/会话取消扫描；双侧有效新鲜近距只在flags=1专用原地扫描放行侧向限制，不绕过其他保护。GET_STATUS/GET_DISTANCE/GET_ENCODER改完整紧凑TB批次，避免重复输出代码超过Flash；GET_CONFIG/GET_IO保留。

ESP0.12按当前数字路线ID判断找到，宽度停车值保留保存配置，未配置默认.25；到达优先于居中，可靠STOP确认后才推进，重复节点新帧重新布防。修正多除一次PI角度公式，全部找猫/标签与重获最多两圈，取消隐藏一圈限制和旧15秒整轮截断。真实GET_CONFIG与ESP保存配置分开；地面ROI改变清空旧标定。

慢接近猫采用短DRIVE→MD→STOP确认→停稳→新CAT，不在移动时运行猫模型。有效新帧猫消失才重找，找到续剩余距离，不重抽概率；失败回原路线索引，持续保留找猫失败原因。顶部、画面冲突、多触碰按首次位置扫描；同时采样不能证明真实先后，显示同次采样并保持确定顺序。单侧受阻/必要信息过期回巡游，双侧过近直接原地扫描不倒车，切换保留已耗预算。既有触发、概率、冷却、四模式声光、三段试探、朝向/观察/等待追逐、三种结束/捕获确认一并覆盖CAT-01～18。

相机请求门槛校验实际采集时间、帧号、请求/步骤/代次；缓存/迟到/重复不续旧动作。控制与有界最新视觉信箱分离，拒绝超长包、不截断字段；物理DONE统一CRC，操作员停车和未确认停车门槛保持。板载网页显示最新策略快照、请求/实际识别需求、路线/宽度/搜索步数与持久失败；命令#0显示0 PWM，历史发送单独列示。旧网页模型没有SCAN_V1，标明边界，实体自动策略入口关闭。

最终离线执行：实际Uno扫描核心199项、实际ESP policy.cpp 429项、实际VisionGate及CRC门槛均通过；Node85项通过。Uno core1.8.8编译Flash32084/32256、静态SRAM1379/2048 bytes，必须使用build-uno.ps1优化参数，Flash仅余172 bytes；ESP core3.3.12/XIAO/OPI/max_app_8MB编译Flash3714906/8257536、静态SRAM78792/327680 bytes。静态RAM不证明运行栈最低余量。仓库外Uno ino及scan_machine.h哈希与仓库一致。

新增《配置接入表》《统一验收记录》《离线验证结果》及JSON源码/产物哈希；更新四张状态图、实施计划、当前README和新会话上下文。原有量化补测章节不覆盖；现场结果全部待测。无自动复位上传脚本只做语法解析和本机工具帮助核对，未执行设备命令：Uno使用AVRDUDE8 noautoreset；ESP no-reset/no-stub先检查既有分区表，再仅写应用，不改NVS。需要用户现场手动进入bootloader/RESET并确认端口后才能进行。

本轮未上传、复位、操作界面或做运动测试。历史持续失联、供电、低PWM和实际识别/响应时延/长期稳定仍未闭环；编译和原生核心执行不替代现场验收。详细边界与复现入口见《离线验证结果.md》，全部猫状态和新增分段接近检查见《统一验收记录.md》。

#### 记录033 · 2026-10-03：Uno容量与手动IDE上传配置

来源：[原始日志](项目日志.md)，第327行；原主题：2026-10-03：Uno容量与手动IDE上传配置。以下为该记录原文，状态按记录日期理解。

用户Arduino IDE默认AVR1.8.8构建33828 bytes，超过32256应用区1572 bytes；静态RAM1379 bytes未超。此前32084 bytes通过的构建来自build-uno.ps1，额外使用-mcall-prologues、-mrelax、-fno-split-wide-types、-finline-limit=3以及链接-Wl,--relax。本轮重新离线构建，确认仍为32084 bytes / 静态RAM1379 bytes，Flash余172 bytes。没有更改板容量、bootloader、接线或删功能。

为用户继续手动IDE上传准备firmware/ide-avr/platform.local.txt及Arduino-IDE编译与手动上传.md。用户把文件放到AVR1.8.8核心目录、重启IDE、先验证参数和容量再上传；文件仅覆盖编译/链接extra_flags，影响该版本AVR核心、不影响ESP核心。本轮检查安装位置不存在同名文件，助手没有写入该安装目录，也未操作IDE/设备。另保留脚本仅编译、用户RESET配合noautoreset上传的路径。官方platform specification支持platform.local.txt覆盖属性；IDE实际界面流程仍待用户执行。

临时副本验证过禁止解析函数内联及源码pragma优化，默认构建分别33826/33888 bytes，未解决容量，其中inline-limit pragma不受编译器支持。实验没有进入正式源码，未删功能或把失败当成功；正式运行代码保持不变。

按用户追加要求，在Uno和ESP主固件顶部加入版本/配对/链路注释，分别与READY UNO_CAT_V6.6、ESP32_CAT_HOST_0.13对应；仓库外Uno副本同步且哈希一致。版本注释不改变程序行为。当前可用方案是已验证的编译参数配置；上传、RESET、网页和运动仍由用户完成。

#### 记录102 · 2026-10-05：Uno 6.11 / ESP32 0.38 上传与 Arduino IDE 容量配置修复

来源：[原始日志](项目日志.md)，第1028行；原主题：2026-10-05：Uno 6.11 / ESP32 0.38 上传与 Arduino IDE 容量配置修复。以下为该记录原文，状态按记录日期理解。

用户明确授权上传 COM10/COM11，并确认断开 Uno D0/D1 的板间串口线、关闭串口监视器。

**IDE 编译错误原因已核实。** 仓库 IDE 模板及电脑 AVR Boards 1.8.8 的 platform.local.txt 均缺少新增的 -fno-inline-small-functions；不是所有优化都没生效。旧参数编译本版为 32310 bytes，超过 Uno 应用上限 32256；新参数为 32244。安装文件已备份到 evidence/mean-scan-tag-upload-20261005/platform.local.before.txt，保留原配置，仅补入缺少的项。随后使用 arduino-cli compile --fqbn arduino:avr:uno，不传任何额外 build-property，成功为 **32244/32256 bytes Flash、1381/2048 bytes 静态 SRAM**，证明安装的配置生效。仓库 IDE 模板及说明同步更新。当前 IDE 已运行的后台服务可能缓存旧配置，用户需关闭再重新打开 IDE 后验证；本轮没有关闭用户编辑窗口。仓库外的 uno-firmware/UnoCatController 两个源码文件也已备份并同步为本版，SHA256 与仓库一致。

**Uno 上传。** COM10 使用上述应用 HEX、arduino-cli upload --verify，退出码 **0**。没有写 bootloader/fuses。上传后使用 57600、DTR/RTS=false 查询一次 PING 与一次 GET_CONFIG；捕获 21 条完整 DONE 64000 PONG*CF 及 1 条几何配置回报，轮径 67.5、轮距 120、每转 20 脉冲。采集同时存在乱码/重复片段，本轮未捕到完整 READY UNO_CAT_V6.11；版本依据为已编译及带 verify 成功写入的应用，不将上述回报视作 UART 稳定性验收，重复片段原因未新增结论。

**ESP 上传与回读。** 上传前实际为 ESP32 0.37、IDLE/SIM_UNO，motorId=0、motorRunning=false、stopPendingId=0、stopUnconfirmed=false。COM11 读取 **3072 bytes** 的 0x8000 分区表，逐字节与编译分区一致；仅写 **0x10000 应用 3776912 bytes**，用时 **25.6 s**，esptool 返回 **Hash of data verified**，随后按上传授权正常复位启动。USB 与 HTTP /api/state 均回读 **ESP32_CAT_HOST_0.38_MEAN_SCAN_TAG_CHECKS**，IDLE/SIM_UNO、cameraOk=true、无运行电机、无待确认/未确认停车。HTTP 首页与已编译网页内容逐字节一致。94 个旧配置逐项比较，变化 **0 项**，路线 **[46,43]** 保留；只新增 **tagScanMaxFrames=3**。

证据位于 evidence/mean-scan-tag-upload-20261005/verification.json、uno-verification.json、uno-ide-profile-build.txt、uno-upload.txt、partition-read.txt、upload.txt 及上传前后状态。编译、应用写入校验和网页内容回读已完成；真实 UART 连续运行、实车两圈角度、标签多帧识别改善、猫互动及界面现场操作仍待用户验收。最终保持 SIM_UNO/IDLE；用户接回板间串口后，选择 Real UART 再开始现场测试。

#### 记录108 · 4. 最终优先完成的ESP固件烧录与回读（0.40）

来源：[原始日志](项目日志.md)，第1123行；原主题：2026-10-06：本对话问题复盘、已有可计算指标与本地日志／摄像头部署。以下为该记录原文，状态按记录日期理解。

用户授权COM11烧录。本轮先写入0.39并完成哈希／USB／HTTP回读，实际OV3660参数暴露了上面的增益范围错误，随后优先完成0.40修复、离线检查、编译和再次应用烧录。两次都是先确认IDLE、motorId=0、motorRunning=false、无待确认／未确认STOP、无调试操作；分别读取0x8000的3072B分区表逐字节匹配编译分区，再仅写0x10000应用，不写bootloader、分区表、NVS或Uno。两次人工烧录重启必须从后续稳定性统计中剔除，不能计作新的自发故障。

最终写入 **3793008B**，esptool记录写入阶段 **25.5秒**，整个write命令（连接、stub、写入及校验） **33.132秒**；返回 **Hash of data verified**。应用SHA256为 3DE55BA03166083B9C4CD4395A202C0989735A934CED7F5A8E3130C72E371DB8。USB和HTTP均回读 **ESP32_CAT_HOST_0.40_SENSOR_CAMERA_RANGES**，实际首页与最终编译header解压后的97301B网页逐字节一致，后端／页面一致性均通过。HTTP验收使用板子给出的局域网地址192.168.137.130；最初尝试默认AP地址192.168.4.1超时，不能把地址不可达认定固件服务故障。

上传前后 **95个旧配置逐项对比，变化0项**，当前路线 **[43,46]** 保留，Uno保持既有6.11，未烧写COM10。最终保持 **SIM_UNO／IDLE**，cameraOk=true，motorId=0、motorRunning=false，stopPendingId=0、stopUnconfirmed=false。摄像头PID **13920=0x3660**，320×240，18项实际配置已读回；JPEG质量12，自动曝光／自动增益／自动白平衡均1，aec_value=490、agc_gain=2是启动驱动配置回读，不是随时间自动变化的持续测量。

增益上限的 **完整寄存器回读仍是248**，范围0–1023、unit=REGISTER_10_BIT。本板本次并没有证明原248已经发生截断；已证实的问题是把合法寄存器值错当成0–6枚举。原uint8_t字段对大于255的值存在截断风险，离线用1016的例子覆盖此风险，不能把合成1016写成当前板上默认值。参数未做现场试写，cameraSettings.persisted=false，表示沿用原启动默认配置，未凭空声称NVS参数保存／重启恢复已实机验收。

最终离线编译 **3792866/8257536B Flash（45.9322%）**、**85584/327680B静态RAM（26.1182%）**；相较0.38分别增加 **16100B**、**208B**。网页 **97301→34204B gzip**，减少 **63097B／64.8472%**。最终61个网页检查、全部11个原生可执行测试通过，摄像头核心82＋编排65＝147项。编译资源、应用写入校验、实际HTTP/USB配置和网页内容回读都已验证；浏览器本地存储／断线导出操作、实际摄像头参数试写和NVS恢复、猫／标签效果、运动／真实UART及连续稳定性仍待用户验收。后续只需刷新当前页面取得新界面；不会以本次回读推断识别准确率已改善。

证据分别保存于 evidence/local-log-camera-upload-20261006/（首次0.39）、evidence/camera-sensor-ranges-20261006/（0.40离线）、evidence/camera-sensor-ranges-upload-20261006/（最终0.40上传与回读）、evidence/conversation-metrics-20261006/（本对话指标复算）。本轮只修改原始项目日志，归类版没有新增修改。

#### 记录120 · 2026-10-07 用户授权 main 应用区烧录与回读

来源：[原始日志](项目日志.md)，第1246行；原主题：2026-10-07 用户授权 main 应用区烧录与回读。以下为该记录原文，状态按记录日期理解。

用户明确允许烧录并告知两块板串口已关闭。烧录 main 代码提交 89e9716，使用已离线编译并核对源码哈希的应用，SHA256 B8B5DB9560581E555840C296A653F5C7A58D95AFC1EACB749103422BE63D1C2F。烧录前 ESP 回读 SIM_UNO/IDLE，无活动电机请求，无待确认停车。编译板型 XIAO ESP32S3 OPI PSRAM/max_app_8MB；读取 0x8000 的 3072 字节分区表并逐字节确认相同，只写应用 0x10000，未写 NVS/分区，未刷 Uno。写入 3805552 字节（固件 bin 文件大小），esptool 输出 Hash of data verified。

烧录后 ESP32_CAT_HOST_0.42_SHARED_TARGET_RECOVERY 启动，USB 前后原有 95 项策略配置与相机设置逐项比较无变化，新增 tagLossGraceMs/tagRecoveryAngleDeg 默认参数；groundReferenceChangedAt 字段存在。当前 SIM_UNO/IDLE，相机可用，未标定（参考长度 0），前向避障关闭。初始尚未取得 station IP，随后回读成功连接 192.168.137.25；设备网页包含猫宽度、目标标签宽度、地面标定状态三个新元素，HTTP /api/state 与 USB 配置一致。证据见 evidence/branch-alignment-20261007/upload-result.json、deployment-readback.json、http-readback.json。

没有电机动作测试、现场猫/标签识别验收或地面障碍试验。模拟停止状态不证明实机运动效果。用户需切换 Real UART 测试 main 的标签漏检宽限/定向恢复和猫恢复，观察找回后的动作衔接；空地采集地面参考后再打开前向避障。宽度显示及标定有效状态需现场观察。维护分支代码已提交且编译，但未烧录。未推送，未合入远端逃跑避障。

#### 记录133 · 10 月 6–7 日 Git／逃跑流程交接的边界

来源：[原始日志](项目日志.md)，第1379行；原主题：2026-10-13：复查 10 月 6–12 日聊天，补齐问题证据、处理结果与验收状态。以下为该记录原文，状态按记录日期理解。

10 月 6 日四个本地分支推送及模拟器交接已完成；10 月 7 日聊天按柏林提交时间、跨分支去重统计为 23 个提交。晚间远端曾有两版逃跑处理：a3bb754 的 180° 拆为两个 90°，中途停稳重新取视觉和侧向测距；后由 b8423ee 改为转前、转后检查，不再拆转角。后一版转前要求转向侧至少 15cm、另一侧至少 10cm；空间不足但前方畅通时慢行 4cm 后重查，最多两次。8fb1bbc 的 Uno 默认侧向安全距离由 1cm 改为 3cm。以上为当时远端代码与交接内容，不是本地设备已部署结果：10 月 7 日本地任务明确保留本地行为、未合入晚间逃跑与 3cm 修改，之后直行部署实际安全阈值仍回读 1.0cm。前向灰度判定公式没有因这些逃跑流程提交而改变。交接资料见 [逃离避障开发交接](逃离避障开发交接-20261006.md)。后续审查和实施应以目标分支与实际回读为准，不能将远端默认值套在本机。

## 09 · 日志证据、复盘与验收管理

**发展脉络：** 160条单次快照不足→双USB持续采集→bootId与来源分组→跨重启本地历史→区分已解决／缓解／待验证→给每个指标定义分母。

**目前结果与边界：** 浏览器历史1200条测试覆盖刷新／重启／去重与并发；日志45–48为同一次启动。记录实际TX/RX、请求／输出PWM、帧龄与处理耗时，不用断续快照制造长期成功率或根因。

**能力提炼：** 可观测性设计、证据保全、量化复盘和验收管理；把发现、假设、代码修复、烧录和现场接受分开陈述。

关联其他主题：[记录103](#record-103)、[记录137](#record-137)。

### 本章记录索引

| 记录 | 原始日志标题 |
|---|---|
| [001](#record-001) | 2026-09-30：从空板调试推进到真实电机测试 |
| [008](#record-008) | 2026-10-01 至 2026-10-02：ESP32 视觉调优与真实 Uno 通信联调 |
| [015](#record-015) | 2026-10-03：补记最新供电、失联排查与前向标定验收方法 |
| [027](#record-027) | 2026-10-03：开发问题回顾与实测数据补充（本次新增） |
| [029](#record-029) | 2. 已有问题的回顾索引与仍未闭环的结论 |
| [030](#record-030) | 3. 没有实测值的项目保留为待测 |
| [039](#record-039) | 2026-10-04：近期对话复盘、已有日志补证与分类归档 |
| [040](#record-040) | 处理结果：明确已解决、绕过、修复待验收和未闭环 |
| [042](#record-042) | 保留可量化旧证据及其口径 |
| [044](#record-044) | 2026-10-04：按10月2、3、4日完整对话逐页补漏 |
| [045](#record-045) | 三天完整问题清单 |
| [048](#record-048) | 2026-10-04：通信与视觉问题的故事线及新增量化 |
| [080](#record-080) | 2026-10-05：三帧猫复核、识别预览与断连重启证据归类 |
| [084](#record-084) | 4. 日志45–48：同一次启动的连续快照，不是四次重启 |
| [096](#record-096) | 2026-10-05：10月4–5日聊天复盘与改动补漏——问题、数据、处理及优化幅度 |
| [097](#record-097) | 两天工作脉络与量化结果 |
| [099](#record-099) | 还缺什么数据才能回答“实车优化了多少” |
| [104](#record-104) | 2026-10-06：本对话问题复盘、已有可计算指标与本地日志／摄像头部署 |
| [105](#record-105) | 1. 问题如何描述，最后采用什么解决方式 |
| [106](#record-106) | 2. 已经可以计算的数据，分母和适用范围 |
| [107](#record-107) | 3. 后续指标怎样定义，哪些当前还不能算 |
| [131](#record-131) | 2026-10-13：复查 10 月 6–12 日聊天，补齐问题证据、处理结果与验收状态 |
| [132](#record-132) | 已有记录与本次补漏范围 |
| [138](#record-138) | 仍缺证据或尚未解决的事项 |

### 本章完整记录

#### 记录001 · 2026-09-30：从空板调试推进到真实电机测试

来源：[原始日志](项目日志.md)，第3行；原主题：2026-09-30：从空板调试推进到真实电机测试。以下为该记录原文，状态按记录日期理解。

当前阶段使用电脑网页作为上位机，通过 USB 控制 Arduino Uno；电机驱动板为 L298N。ESP32 接管上位机属于下一阶段计划，尚未实现。以下三个节点合并记录，保留问题、原因、改动与验证边界。

#### 记录008 · 2026-10-01 至 2026-10-02：ESP32 视觉调优与真实 Uno 通信联调

来源：[原始日志](项目日志.md)，第77行；原主题：2026-10-01 至 2026-10-02：ESP32 视觉调优与真实 Uno 通信联调。以下为该记录原文，状态按记录日期理解。

本节根据两天聊天中的实施与验证记录整理，日期采用 Europe/Berlin。前面的“下一阶段”保留为当时的计划记录；截至本次追加，ESP32 上位机、板载网页及真实 Uno 双向通信已实现，但整车长期稳定性与完整实体行为尚未验收。

#### 记录015 · 2026-10-03：补记最新供电、失联排查与前向标定验收方法

来源：[原始日志](项目日志.md)，第129行；原主题：2026-10-03：补记最新供电、失联排查与前向标定验收方法。以下为该记录原文，状态按记录日期理解。

本节回顾 10 月 2 日后续排查，记录日期采用 Europe/Berlin。证据来自最近聊天与本地测试报告；本次只更新文档和核对源码，没有操作网页、发送设备动作、修改固件或烧录。

#### 记录027 · 2026-10-03：开发问题回顾与实测数据补充（本次新增）

来源：[原始日志](项目日志.md)，第257行；原主题：2026-10-03：开发问题回顾与实测数据补充（本次新增）。以下为该记录原文，状态按记录日期理解。

本章回顾截至今天的聊天记录、既有项目日志和本地采集报告。已记录的故障经过不重复展开，重点补充可比较的量化数据、证据边界及待测项。今天的工作仅为文档整理，没有连接设备、发送命令、复位、烧录或进行新测量；下面数据的测试日期及版本必须保留，不能视为当前 V6.5 的性能。

#### 记录029 · 2. 已有问题的回顾索引与仍未闭环的结论

来源：[原始日志](项目日志.md)，第280行；原主题：2026-10-03：开发问题回顾与实测数据补充（本次新增）。以下为该记录原文，状态按记录日期理解。

| 问题 | 已有记录 / 数据 | 当前能下的结论与缺口 |
|---|---|---|
| 无电机也会复位 | 本日志“供电问题已经收窄”；无电机查询测试 510.95 秒，最后 Uno uptime 569059 ms，随后 READY 与计时归零 | 电机不是该次复位必要条件；尚不能证明串口压力导致复位。复位前 STATUS 180 ms、遥测 646 ms，没有捕获持续数秒积压 |
| 短测通过后仍持续失联 | USB 静置 610.65 秒无观察到复位/超过 10 秒停更；右轮动作完成后 7.492 秒停发；今天遥测 1137 中断，COM10 独立监听 8.18 秒为 0 字节 | 自动复位后恢复与持续沉默分开记录；短窗口通过不能作为长期验收 |
| 接收内容改变 / 校验失败 | 本日志 V6.1 复测：期望 22 字节，摘要长度 36，计算 CRC EA、收到 4D；预期发送帧 C 198 GET_TELEMETRY*4D | 有接收/解析前内容改变线索；软件串口时序、电平转换、接地、噪声及未覆盖内存问题仍不能区分 |
| 内存与状态异常 | 缓冲复用缺陷已修复；V6.0 只读 60.171 秒、60 心跳/60 内存帧，CRC 错误 0、采样余量 698 字节；曾有 -15104/-2048 电机遥测 | 短时诊断正常不排除未覆盖损坏；异常遥测不等于实际输出该 PWM。15 秒约 11.67 MB USB 重复读超物理速率，不能用作可靠实时内存证据 |
| 电机供电不足 | 用户测量驱动板输入约 5.8 V；接 USB 能转，拔掉只响不转 | 支持供电路径不足；缺驱动板逻辑 5V、Uno 5V 及启动瞬间波形，不能宣布修复 |
| 巡游摇晃与低速控制 | 约 38 秒有交替 MOTOR，固定 PWM 与视觉延迟存在过冲风险；此前输出下限 120，今天 V6.5 改为 1 | 分级 PWM 脚本被中断，无可确认测量结果；启动/维持 PWM、带载转速及纠偏误差仍待测 |
| 视觉慢、旧帧与角度计算 | 既有 TAGS/CAT/BOTH 短测约 2.12/2.21/1.49 次每秒；其他 BOTH 样本 477–531 ms；相机缓存约 5.06 fps；ESP angle() 多除一次 PI | 不同版本/窗口不可混算；缓存 fps 不等于识别 fps。角度公式修复、停稳后新帧屏障与实际角度验收已列入实施计划 |
| 观测边界和行为状态机 | 早期安全拒绝、HTTP 触发找猫、触碰去重、会话锁、标签到达/重获及两圈搜索已分别记录 | 保留既有规则，按计划统一验收；模拟、Node 测试和编译不能证明实际 ESP/Uno 状态机及物理效果 |

最新紧凑遥测已有短测文件：ESP 0.10 的完整 13 行批次 42 在 101595–101596 ms 发布，轮询间隔 1999–2015 ms，错误数组为空，内存采样 617/617、异常位 0。这只能证明短测批次解析/发布与轮询间隔；1 ms 的批次发布时间跨度不是 UART 完整事务耗时，2 秒轮询间隔也不是回复延迟。新旧协议延迟改善幅度仍待同口径对照，见 [紧凑遥测验证摘要](./esp32-host/compact-v010-validation-summary-20261003.json)。

#### 记录030 · 3. 没有实测值的项目保留为待测

来源：[原始日志](项目日志.md)，第295行；原主题：2026-10-03：开发问题回顾与实测数据补充（本次新增）。以下为该记录原文，状态按记录日期理解。

以下纳入 [实施计划与人工验收，第 8 节](./实施计划与人工验收.md)，由用户后续现场测量：当前版本紧凑遥测在空闲/额外查询/识别/电机负载下的 TX→ACK、TX→完整完成 P50/P95/最大值；实际指令频率与错误率；各场景连续运行时长；供电启动跌落；四轮向启动/维持 PWM；实际转角和停车滑行；采集→推理→结果回复；触碰/障碍→输出归零→物理停稳。当前没有结果的格子保持“待测”，不填经验估计，也不把历史数据迁移成当前版本结果。

#### 记录039 · 2026-10-04：近期对话复盘、已有日志补证与分类归档

来源：[原始日志](项目日志.md)，第376行；原主题：2026-10-04：近期对话复盘、已有日志补证与分类归档。以下为该记录原文，状态按记录日期理解。

本轮回顾9月30日至10月4日项目对话，核对已有ESP导出、Uno串口文件、采集报告及历史实施记录。没有连接设备、复位、烧录或运动测试。历史章节按当时进度保留；按问题分类的当前结论、处置方式、量化数据和待测项另见[新版项目日志](./项目日志_问题分类版_20261004.md)。

#### 记录040 · 处理结果：明确已解决、绕过、修复待验收和未闭环

来源：[原始日志](项目日志.md)，第380行；原主题：2026-10-04：近期对话复盘、已有日志补证与分类归档。以下为该记录原文，状态按记录日期理解。

- **已有结果的节点**：L298N早期补接VS后用户确认电机能转；D12接收/D1回传绕过D0，9600下最小ROUND_TRIP_OK和完整协议实测通过。前者是该次接线修复，后者是绕过方案，原D0电气原因未定。
- **已修改并上传，实体待验收**：Uno旧时间戳造成停稳计时下溢（V6.7）；SC配置校验错误有限重试（ESP0.15）；SR开始扫描同身份有限重试、Uno补确认不重复旋转（ESP0.16/Uno6.8）；取消启动能力门槛（0.17）；动态最低PWM、独立找猫、连续互动、逃跑方向/直行拆分与SETTLE250ms取样（0.18）。上传成功不等于实际巡游、逃跑或长时间稳定。
- **未闭环/现场待测**：低压供电及拔USB不转、Uno自动重启/持续停发、右侧超声波无效、当前57600紧凑协议实际延迟、带载最低PWM、实际停稳、前向外观避障、猫/标签准确率及连续互动完整行为。旧9600压力数据不能当当前性能。
- **扫描交接恢复正在实施**：10/4另一会话获用户批准增加交接超时、结束回报重发与确认；本次整理时源码正在改，未有最终测试/构建/上传/实车结果，不写成已解决。新版分类日志记录证据断点；最终实现由该会话追加结果。

#### 记录042 · 保留可量化旧证据及其口径

来源：[原始日志](项目日志.md)，第401行；原主题：2026-10-04：近期对话复盘、已有日志补证与分类归档。以下为该记录原文，状态按记录日期理解。

- USB单供电静置610.65秒、末次Uno uptime676277ms，无观察到重启/超过10秒停发；右轮PWM150/200ms完成后7.492秒停发、后续PING无回应。这是单次关联，不是右轮根因证明。
- 无电机查询测试510.95秒也出现READY，前一完整uptime569059ms、后续50526ms并恢复，证明电机动作不是重启必要条件；不能证明高查询频率引起重启。
- 旧9600完整遥测约440字节，回传占线约458ms；TX→DONE P50/P95/最大：静置510/562/599ms、额外PING542/606/636ms、GET_STATUS630/674/779ms。实际额外频率2.09Hz/1.164Hz，名义5Hz/2Hz不是实测频率；375次PING和重启前244次STATUS都有完成。原始报告/计算路径见新版分类日志。
- 现场采集1284去重事件，46到达5次、40到达2次、4次result=5。一次MD918到SD918 result=5仅3ms，支持旧now减新stopped计时缺陷；并未在该次采集复现配置超时和对准耗尽。
- UnoV6.8构建32206/32256字节，仅余50字节Flash、静态RAM1379/2048；ESP0.18构建Flash3728590、RAM78920、BIN3728736，上传50.9秒、哈希及HTTP版本回读通过。静态容量、测试数量和上传校验均不能代替实体稳定性。

完整分类涵盖供电/接线、通信/重启、扫描/巡游、猫互动/观测、配置/界面、容量/上传，并逐项写明采用特殊办法、暂缓、待测或实施中的状态。后续新增结果继续按日期追加原日志，同时更新分类版对应项，不覆盖历史阶段记录。

#### 记录044 · 2026-10-04：按10月2、3、4日完整对话逐页补漏

来源：[原始日志](项目日志.md)，第431行；原主题：2026-10-04：按10月2、3、4日完整对话逐页补漏。以下为该记录原文，状态按记录日期理解。

以下清单同步保留在旧日志，分类版第八节也包含同一份核对结果，便于直接查阅。

#### 记录045 · 三天完整问题清单

来源：[原始日志](项目日志.md)，第434行；原主题：2026-10-04：按10月2、3、4日完整对话逐页补漏。以下为该记录原文，状态按记录日期理解。

再次核对实施会话48个turn、前一排查/状态机交接会话32个turn、供电排查会话10个turn，以及量化回顾和三个按钮接线会话各1个turn；同时核对今天找猫交接诊断的当前记录。一个turn可包含多次中途补充；没有只用会话标题或最后答复代替正文。已记录的内容核对后续状态，以下补足容易遗漏的独立问题。

| 问题/用户反馈 | 原因、特殊处理或最后结论 | 状态/证据 |
|---|---|---|
| ESP“上传出错”实际是编译容量超限 | 当次需3672748字节，选定应用区3342336；PSRAM disabled。改用XIAO ESP32S3、8MB、Maximum APP、OPI PSRAM | 构建配置问题已明确，后续大应用构建/上传通过；与57600改动无因果证据 |
| 临时不能把车放地面，标定难以推进 | 生成浅灰地面图，用屏幕只验证参考采集流程；最终相机位置和真实地面需重新采集 | 临时办法，非真实地面避障验收。文件output/imagegen/ground-reference-screen.png |
| Uno最后输出EVE，复位PREV_STAGE=7 CMD=376/3154 | DONE376遥测已完整结束；Stage7写在tickOutputs调用附近，函数无无界等待，发送事件会写Stage21；加70–74细分 | 暂未定根因，不能断言声光函数卡死。SRAM残留stage不是复位原因 |
| ERROR0匹配motorId0，协议坏帧被显示成运动失败 | ESP0.7排除编号0匹配非零待完成动作，记录UNO_PROTOCOL_ERROR；16条ESP发送帧本地CRC重算正确 | 已修复/上传；只证明生成端CRC正确，不能证明接收端字节相同 |
| Uno命令缓冲在ACK泵入新字节时覆盖当前参数 | V6.0分离四个缓冲、加前后哨兵，V6.1异常累计锁定；内存/电机范围/SRAM余量诊断 | 已修复/上传，不能归因为全部失联。异常值-15104与后续-2048属于不同记录，未证明内存损坏 |
| USB串口“内存异常”但锁定不一致 | 15秒读约11.67MB重复片段，独立.NET也重复；远超57600/8N1约5760B/s物理容量，15秒约86.4KB | 采集异常，根因未定；加异常速率保护和输出上限，不把该记录当实时内存损坏 |
| 心跳/内存看起来正常仍失联 | 60.171秒无ESP查询窗口60心跳/60内存帧、698字节余量、CRC错0、异常0；另32.48秒68完整遥测/27心跳仍有1协议错和1遥测超时 | 仅证明各短窗口；未闭环长期稳定。uno-after-upgrade、esp-passive-v61等原始JSON |
| 接收内容与发送内容不同 | 发C198 GET_TELEMETRY*4D（22字节），Uno摘要长36、计算CRC EA/收到4D，前缀非ASCII | diagnostic-http-v61-20261003.json；摘要无自身CRC且不是引脚抓包，不能区分电气、时序或缓冲损坏 |
| 后续失联Stage2，不再是Stage7 | 遥测1137停在右超声波行，uptime349918ms、0输出；COM10只读8.18秒0字节/0行；复位PREV_STAGE2 CMD1137恢复 | 两条回传均沉默，非仅网页问题；tickTouches也未发现无界循环，未证明触碰函数是根因 |
| 拔D12后RX/TX灯不亮被认为立刻死机 | 用户确认仅断D12，供电/地/D1保留；无请求时软件RX输入不再驱动回复，USB灯不等于主循环心跳 | 不能凭指示灯诊断；隔离观察不等于已定位，保留原始uno/esp-d12-isolated JSON |
| PING后传感器读数过期 | PONG不刷新单项传感器；旧单项2500ms过期，遥测等5000ms超时再等2000ms，可能出现约7秒缺口 | 显示/事务机制明确；日志未保留PING时不能声称PING导致失联 |
| STARTING立即STOPPED：配置错误、几何、前向、模式多种原因 | 原GET_CONFIG轮距0；默认设120并回读，随后仍可能因本次GET_CONFIG坏帧未确认而失败 | 120mm是用户默认，非测量。0.9依次STOP→GET_CONFIG→SESSION_START、准备期暂停遥测，匹配编号/阶段有限重试；已上传 |
| 点击巡游不自动识别标签，测试电机转但巡游不动 | 0.9启动/恢复在OFF/CAT自动切BOTH，保留TAGS/BOTH；配置会话成功才发MOTOR | 架空短测确实进入PATROL，MS后编码器0/0→6/36；不能当完整路线验收 |
| 左轮失速ENCODER_STALL | 左脉冲停6超过1200ms，右到36；用户没有留意真实轮子是否停 | 根因待测：真实停转或编码器漏报未分；PWM150对照未启动，不写成试过有效 |
| 前向标定挡住正常巡游，用户希望先测标签流程 | 0.8加frontAvoidanceEnabled持久开关；0.9/Uno6.2明确前向判断/STOP由ESP负责，Uno移除前向运动门禁 | 已实现/上传；侧向、触碰、失速等独立；关闭不意味着标定完成 |
| DEADMAN_TIMEOUT | 旧MOTOR500ms租约内未成功续租；原事件已覆盖，不能区分KEEP未发/损坏 | 按用户要求0.10/Uno6.3删除KEEP和租约，开始/改速/停止；这是控制契约改变，Uno不再仅因ESP续行缺失自动停，不是失联已修复 |
| no checked encoder feedback for750ms | 未收到带校验、编号匹配MS/MP；即使无脉冲也应有MP0/0 | 独立于编码器失速，不能直接判电机不转；保留有效反馈超时，计时从实际发送开始 |
| tag search exhausted id41 | 当时路线[41,47]，相机只读检测27/28/33/34/39/40；旧360度或15秒预算退出 | 不改用户路线；后续分步最多两圈、无旧15秒整轮截断。未证明当时41一定未出现 |
| SIDE_LEFT/RIGHT_OBSTACLE_OR_SENSOR_INVALID频繁停车 | 板上左右阈值仍5cm，代码/接口最小5，1cm保存不了；旧无效/过期也停车 | 0.11/Uno6.4改可设1cm，新鲜有效且严格小于阈值才停；真实回读SAFE_LEFT/RIGHT1.0。无效不标成“安全” |
| 取消KEEP后STOP丢失，网页停止而Uno继续风险 | 新增独立带CRC MOTOR_STOPPED确认，300ms同编号重发最多3次，未确认阻止后续运动 | 真机STOP60于135980首发、136280/136581重试、136641确认（661ms），再SESSION_STOP61；恢复实证，非所有消息可靠 |
| STOP_UNCONFIRMED启动被阻止 | 日志3没有任何回复、lastRx空、age4294967295；上传校验不能证明两板UART接回 | 需恢复D12/D1/转换/地与真实回报；日志4后停车确认恢复，但又被能力门槛阻止；不是标签识别故障 |
| operator_stop反复出现，重烧Uno/断电也不消失 | ESP正常stop/切模式/限时结束统一写FAULT，旧原因覆盖启动拒绝；日志7 23661ms发300ms测试，24062ms限时结束stop、后续确认 | 原因分类/显示缺陷。0.17只去能力门槛，未在该修改中修正常停止FAULT分类；不能写全部operator_stop问题已修复 |
| motion start not confirmed再次出现但日志8看不到现场 | 当前窗口SR187仅14ms确认、扫描到步6、一次BAD_ENVELOPE后重发成功，1482旧事件被覆盖 | 这次根因证据缺失，未改代码；不宣称重试失效或全部恢复 |
| tag alignment budget exhausted但宽度约20% | 到达阈值当时25%，20%不是到达；约20.25度一次、最多8次对准，接近中累计不清可能耗尽 | 代码原因已识别，随后停稳采集未复现；独立修复/实车闭环暂无明确证据，继续列待验收；降低停车宽度不能证明修复 |
| 旋转预算公式/搜索和接近共预算 | ESP angle多除一次PI、搜索/对准/接近边界不清，声光部分配置硬编码 | 0.12分步协议及策略重构已修正角度，分开标签找到/到达/重获，相关配置接入和状态清单补全；真实角度精度仍待测 |
| 低PWM分级测量没有完成 | Uno6.5下限120→1，脚本先pyserial缺路径，补vendor后用户中断、离线要求停止 | 已停止，未再测；没有分级结果。后来0.13网页下限可调不等于补完物理测量 |
| USB页面旧版本精确握手不匹配新Uno | 旧网页模型没有SCAN_V1，与板载ESP实际核心不同 | 历史兼容项/入口边界保留；不能用旧模拟或测试数量代替新实际核心验收 |
| 找猫/猫互动状态清单不完整，WAIT_CHASE漏列 | 0.18完整列状态、WAIT_CHASE超时可设、装死超时可设、猫宽远近可设；装死后置，不在入口三选一 | 已实现/上传；逃跑默认5完成轮，探索默认至少30秒后周期末独立20%概率；最终采用时间而非“三轮”旧提议 |
| 连续攻击反复触发新互动 | 用户要求首次响应最高优先，互动内后续触碰不新抽/重启；安全触碰停车后续剩余动作 | 0.18生命周期修改/回归通过；现场仍需验收，MazeBot灯条用户遥控，不写自动控制完成 |
| 触碰与旧画面冲突、多触碰、两侧障碍逃离 | 首次触碰优先；同次采样不证明物理先后；顶部/未知扫两圈；双侧近直接原地转、不先倒退；单侧/过期按规则回巡游或停 | 批准方案0.12已实现/离线覆盖，实体分支待验收；保留最多两圈累计预算与generation取消旧帧 |
| 慢接近时边动边识别压力大/猫丢失 | 短DRIVE→完成→STOP确认→停稳→新CAT；有效新帧消失重搜最多两圈，找到续剩余距离/不重抽，失败回路线并留原因 | 批准方案已实施，现场采集→识别→回复与响应延迟待测 |
| 摄像头fps被当识别性能 | BOTH样本477–531ms，相机缓存约5.06fps；不同时间/模式的2.12/2.21/1.49识别频率另记 | 相机帧率不是模型推理fps；各数据不得直接混为当前版本稳定性能 |
| 固件版本不好辨、外部Uno副本可能不同步 | 顶部注释与READY/HTTP版本同步，仓库外ino/scan头哈希核对；关键节点Git基线/详细正文提交 | 保留81588be、970643d、ebd8db6、5995e7d、3cef32f等0.18节点；本次只改文档/证据，不提交另一会话未完成源码 |
| COM10占用/not in sync，ESP地址改变导致回读超时 | 关闭监视器/释放端口，用户断UART后再上传成功；0.18地址由.124更正.188回读完成 | 工具/连接阻塞已处理，非识别或运动算法问题；本次不连接现场 |

以上补漏中的详细原始文件均位于esp32-host，旧项目日志对应日期已有更多前后文。没有因“旧日志已经提过”省略分类索引，也没有把中间方案写成最终规则。复盘截至本轮整理时；另一会话正在进行的扫描恢复仍须另记最终结果。

#### 记录048 · 2026-10-04：通信与视觉问题的故事线及新增量化

来源：[原始日志](项目日志.md)，第493行；原主题：2026-10-04：通信与视觉问题的故事线及新增量化。以下为该记录原文，状态按记录日期理解。

新增[通信与视觉问题解决故事线](./通信与视觉问题解决故事线_20261004.md)，按“原链路不通→D12软件接收绕过→漏字/乱码防护→9600带宽瓶颈→57600与紧凑遥测→关键扫描交接有限恢复→视觉按需调度”串起前因、选择和结果，可供项目介绍使用。原D0原因、UART损坏来源、供电与长期稳定仍未闭环，不能归因电机质量；没有统计故障占比，不把“体感大多通信问题”写成量化比例。

澄清：当前57600/8N1，不是5600；CRC是应用层CRC-8（初始0、多项式0x07），对星号前ASCII正文计算、追加*HH两位十六进制，不是硬件奇偶校验位。CRC发现损坏后拒绝，不纠错，编号匹配/扫描代次/有限重试分别负责归属和恢复。早期电脑链路57600、D12打通阶段9600、后续两板57600，不能写成全程只降不升。

旧9600完整遥测约440字节/理论458ms回传；静置TX→DONE中位510ms，额外GET_STATUS升630ms，P95为562→674ms；名义PING5Hz/STATUS2Hz实际2.09/1.164Hz。新分析0.18日志12/13/14成功遥测分别14/3/4次，TX→DONE范围40–62/40–91/39–40ms，对应中位46/76/40ms。存在未完成请求，不能只凭成功事务宣称整条通信稳定或计算严格同比提速。

历史视觉短测：标签25个独立观测，处理均值271.2ms、2.12次/秒；猫26个、250.2ms、2.21次/秒；双识别17个、468.7ms、1.49次/秒。当前0.18首次VQ→首次VR中位：日志12为327ms（2步）、13为495ms（7步）、14为461ms（5步），范围327–547ms；成功VR→接受约13–16ms。三个快照最后CAT处理latencyMs239/301/241ms。用户所说网页300多毫秒尚未明确字段，保留观察，不能与UART事务混用。

曾缩短识别后1.5秒等待、调整按状态只识别标签/猫与请求新帧，并非完全未优化；尚未完成模型/内核性能对照。扫描旋转→停车→停稳→新帧，慢接近猫同样分段停看；标签连续接近仍可识别，并非所有移动都关视觉。按需调度和新鲜帧约束是实施事实，CPU开销/功耗降低比例与准确率改善幅度仍待测。相机帧率、处理latencyMs、观测频率、VQ→VR、UART TX→DONE分开记录。

统计脚本及JSON见evidence/20261004-review/measure-story.cjs与story-measurements.json。故事线包含可直接讲述的版本和完整口径/证据。本次未连接设备，未做新实体测试。

#### 记录080 · 2026-10-05：三帧猫复核、识别预览与断连重启证据归类

来源：[原始日志](项目日志.md)，第828行；原主题：2026-10-05：三帧猫复核、识别预览与断连重启证据归类。以下为该记录原文，状态按记录日期理解。

本轮固件及界面变更为 `79f8a71de2b6ca7faf8025824ec2497e66fe224a`，`cat-vision-fps-bench` 已快进合入本地 `main`，无remote。本节汇总既有验证与只读诊断，本日志会话没有重新测试、操作设备、浏览器验收或修改代码。

#### 记录084 · 4. 日志45–48：同一次启动的连续快照，不是四次重启

来源：[原始日志](项目日志.md)，第854行；原主题：2026-10-05：三帧猫复核、识别预览与断连重启证据归类。以下为该记录原文，状态按记录日期理解。

原JSON及完整诊断已归档至 [日志45–48诊断](evidence/log45-48-review-20261005/诊断.md)。

| 日志 | ESP uptime（ms） | frameSeq | heap（字节） | 环内日志数 |
| --- | ---: | ---: | ---: | ---: |
| 45 | 2245 | 8 | 49972 | 8 |
| 46 | 2265 | 9 | 44968 | 8 |
| 47 | 8291 | 39 | 46104 | 21 |
| 48 | 8525 | 40 | 47580 | 21 |

四份均为IDLE/SIM_UNO、droppedLogs0，共同起点为seq1/ms152 `READY ESP32_CAT_HOST`、seq2/ms503 `CAMERA init=0`，日志前缀一致且uptime递增，支持同一次ESP启动的连续快照。四份没有SETTLE/CAT_CHECK，无法判断启动前的横跳。

这些文件明确捕捉了ESP刚启动。只有在与log42属于同一设备连续采样、且中间没有手动reset或上传的前提下，uptime回退才能支持中间发生重启。缺少resetReason/brownout/watchdog/panic，原因未确定。SIM_UNO下的 `INPUT_REJECTED source does not match mode` 与 `TELEMETRY_TIMEOUT` 不能作为重启原因；没有Uno uptime或READY UNO，不能判定Uno重启。

处理状态：三帧复核和对应画面预览已实现并编译上传；离线检查通过；最终HTTP预览、用户界面及实体行为待验收。反复横跳尚未完全解决，断连及可能重启的根因仍待证据，本轮未以猜测修改程序。

#### 记录096 · 2026-10-05：10月4–5日聊天复盘与改动补漏——问题、数据、处理及优化幅度

来源：[原始日志](项目日志.md)，第961行；原主题：2026-10-05：10月4–5日聊天复盘与改动补漏——问题、数据、处理及优化幅度。以下为该记录原文，状态按记录日期理解。

本节按柏林日期汇总2026-10-04与2026-10-05项目相关聊天。核对了“修复找猫状态误报”“完善主动找猫状态机”“整理项目日志与问题数据”“排查 ESP32 Web 掉线”“排查主动找猫左右横跳”等会话、既有日志、实施报告、当前源码与保存验证；只读证据，不重新连接设备或运行实车。旧阶段记录保留，最新完成状态以本节及各项最终部署记录为准。

#### 记录097 · 两天工作脉络与量化结果

来源：[原始日志](项目日志.md)，第965行；原主题：2026-10-05：10月4–5日聊天复盘与改动补漏——问题、数据、处理及优化幅度。以下为该记录原文，状态按记录日期理解。

| 问题 | 描述问题的数据或证据 | 我们怎么处理 | 优化了多少、证据边界 |
| --- | --- | --- | --- |
| 扫描结束/交接可能卡住，检测true不能单独解释卡死 | 既有日志出现扫描结果后交接停滞、重传及停车失败；日志26同身份交接恢复3轮仍失败 | ESP0.19/Uno6.9增加有界交接恢复和扫描结束回报重发，严格匹配编号/代次 | 已实现并部署；日志26证明重试不能修好持续链路故障，成功率提升待测 |
| 找到猫后重复转向，迟迟不互动 | 日志16在416607–421192ms约4.585秒内4次ROTATE20.3；完整post-v024采集中319819ms找到猫，反复转向至341252ms预算耗尽，跨度21.433秒 | 0.20增加停稳原地CAT_CONFIRM；0.25去掉触碰互动收尾严格居中；今天0.35进一步统一主动/触碰入口，取消全部猫框居中检测 | 0.35离线确认窗口运动命令0条、选择行为后额外STOP0次；真实进入互动时间、反复转向频率改善待测。接近短段后的SETTLE/CAT_CHECK、逃跑转向与标签对准仍有合理用途 |
| 收到侧距但逃跑判断仍称数据过期 | 日志23已上报左11.6cm、右-1.0；解析8个转换项却要求返回9 | 0.21修正侧距解析并加强字段校验，保留-1无回波与2500ms过期规则 | 真实日志离线回放可更新侧距并进入逃跑转向/直行；解决的是解析缺口，不提供实体逃跑成功率 |
| 收到正确配置却自动恢复失败 | 日志34 DATA271/DONE271正确，普通启动geometryConfirmed=1、恢复=0；日志35同样重复 | 0.29使启动与恢复共用完整配置解析；恢复上限3→4 | 漏消费路径离线修复；恢复机会增加1轮（33.3%），不是恢复成功率提高33.3%。用户当次反馈“目前来看应该没有问题”，无长期故障率统计 |
| 一次缺片遥测被放大成数秒停顿 | 日志35：494022ms查询684，匹配DONE后未释放pending，499273ms才再次查询，间隔5251ms；CAT_CONFIRM6130ms后缺停稳证据退出 | 0.29收到可信匹配DONE即结束事务，缺片不发布，按停稳250ms/普通2000ms限频重取 | 去掉等待5秒超时的放大机制；5秒超时→250ms重询策略相差4.75秒、95%，只是策略时长差异，不能宣称实机时延降低95% |
| STOP确认与输出清零存在不同问题 | Uno遥测曾请求0/应用220；空运动abortMotion提前返回，仍回复MOTOR_STOPPED。日志38另外出现20次写出STOP无确认、61条回传全是诊断 | Uno6.10保证空运动STOP也先清零；ESP0.26在停车失败后保留严格只读诊断与FAULT恢复入口 | 输出清零及查询阻断代码缺口已修复部署；UART回环/接收无响应、Uno自发重启根因未闭环，不能给故障率下降百分比 |
| 逃跑与探索互动需要连续、可调且有回应 | 旧有效逃跑行程26-3=23cm；探索灯4种×声音4种，去掉全静默=15种；用户曾反馈扫描期间新按压无声光 | 0.22每轮随机距离且暂停不重抽；0.23观察收尾；0.27/0.28实现15组合不放回、扫描期间并行回应、不覆盖主状态 | 新增15种组合和可调距离；用户当次声光体验反馈良好，实体响应时延、随机分布、真实位移未量化。今天0.35取代此前猫收尾居中要求 |
| 主动邀请过早退出、受攻击未统一互动 | 日志39观察5.010秒+等待2.502秒，总7.512秒即回巡游 | 统一首触与巡游受攻击的互动分支；无人回应恢复保存路线；最终改为默认5个完整动作，快/慢接近、声光、观察计数，短步进不计；开放概率、阈值与独立声光时长 | 从一次时间窗口邀请改为5动作预算，是规则改变，不能换算时长提升倍数；最低PWM255仍把快180/慢95提升至255，尚无真实速度区分证据 |
| 单张负帧容易触发退出，识别结果缺对应图像 | 用户反映CAT_CHECK/SETTLE切换；既有复核一次负帧即可失败；最终PREVIEW版HTTP超时 | CAT_CHECK最多3张新鲜帧，负帧在同一次停稳内继续；缓存对应JPEG、本地画框、三栏页面；性能实验分别记录解码/模型/整体耗时 | 机会1→最多3张，增加2张；不能写识别准确率提高200%。用户报告串口工作约3.24次/秒、空闲约3.5次/秒，缺完整同条件前后统计，帧率优化比例待测 |
| 整个Web页面报连接中断 | 旧版curl建连3.896–26.928ms，总耗时1903.665/4374.202/6010.429ms；最后一份正文4249/22122B不完整，超过页面4秒门槛；heap两快照下降3584B不足以证明泄漏 | 0.30增量日志、减少取图、连接回收、退避、WiFi/reset/heap诊断；后续串行读请求、完善模拟协议、修正fetch调用方式 | 上传后SIM空闲20/20完整响应，13.383秒窗口，中位63.899ms、P95 110.722ms；与旧UART长运行负载不同，不能据此报同比提速或长期稳定。旧快照估算22132→11752/8293B，约减46.9%/62.5%，不是新版实际流量 |
| 多路视频与完整模拟数据造成连接/刷新压力 | 旧模拟器只回左右超声，缺完整TB/SCAN；双HTTP服务各占3内部socket，总预算16；真实负载出现TCP reset | 0.34单服务异步视频；13客户端额度，最多4视频；网页及模拟器请求串行，TB三分片原子展开13行、SIM限定批量回报 | 内部6→3，减少50%；客户端10→13增加30%。4视频180秒，每额外流805帧，页面120样本13行始终保留、整页断连0；过期5/120=4.17%，额外API29/30成功=96.67%、P95 3089.107ms、累计最低heap248B。持续显示通过这个窗口，高压持续新鲜与长期稳定未通过 |

#### 记录099 · 还缺什么数据才能回答“实车优化了多少”

来源：[原始日志](项目日志.md)，第993行；原主题：2026-10-05：10月4–5日聊天复盘与改动补漏——问题、数据、处理及优化幅度。以下为该记录原文，状态按记录日期理解。

需要同配置、同负载、同测试窗口的前后对照：找到猫到首次互动的中位/P95/最大时长、每次互动额外居中ROTATE数、连续有效/负帧与误退出率、完整动作与首触响应延迟；UART完整事务成功率、STOP未确认次数、四轮恢复成功率与恢复耗时、Uno非人工重启次数；Web请求成功率/P95、过期比例/最长过期、连续断连及heap趋势。记录真实UART与SIM、PWM下限、识别等待、路线和场景条件，不能混算。当前未测值保留“待测”，整体优化百分比不计算。本次仅补日志，未执行这些设备测试。

#### 记录104 · 2026-10-06：本对话问题复盘、已有可计算指标与本地日志／摄像头部署

来源：[原始日志](项目日志.md)，第1058行；原主题：2026-10-06：本对话问题复盘、已有可计算指标与本地日志／摄像头部署。以下为该记录原文，状态按记录日期理解。

本节只追加原始日志，归类版留给后续 agent。两位子代理分别只读审查已有日志／证据和本对话早期附件，根代理复核时间差、资源占用和字典码位数。以下分开标明实际日志、用户报告、源码／几何推导、离线测试和本次部署；任何测试通过率都不替代实车识别或互动成功率。前文“0.39未上传”是当时阶段记录，本节记录后续实际烧录与发现的问题。

#### 记录105 · 1. 问题如何描述，最后采用什么解决方式

来源：[原始日志](项目日志.md)，第1062行；原主题：2026-10-06：本对话问题复盘、已有可计算指标与本地日志／摄像头部署。以下为该记录原文，状态按记录日期理解。

**主动找猫左右切换。** 旧主动入口包含猫框居中及重复停车复核，用户现象是 CAT_CHECK／SETTLE 间反复切换、较久才互动。0.35 把主动／被猫触发的找猫统一到同一停车确认、停稳、新帧复核通路，找到猫不再按 centerX 居中；取消选择主动行为后的重复 STOP。标签对准、寻找逃跑方向和运动后真实 SETTLE 检查保留，不能把这些正常转向都记作找猫横跳。log49只包含标签巡游尾段，不能证明主动横跳没有发生；没有完整开始至互动窗口，所以目前不能报横跳发生率或修复后平均耗时。

**找到猫后立即退出。** log51 的0.34版在47713ms找到猫，47714ms进入OBSERVE，48397ms即因 cat left invitation frame 退出。真正问题是独立的单帧负检测分支提前结束，不是把5秒配置简单改得更大。0.36曾将主动观察及WAIT_CHASE都延迟到持续有效新负帧满足catLeaveSeconds；用户随后明确主动互动至少完成设置的行为次数，0.37据此取代主动部分：找到过猫的ROBOT_SEARCH正常退出按默认5个完整高层行为计数，OBSERVE/SIGNAL/FOLLOW_WAIT不再被catLeaveSeconds提前结束；丢猫时静止观察完成剩余次数，未完成移动不计数、不盲目前进。WAIT_CHASE保留持续有效新负帧缺猫等待；复现猫、无效／过期画面及触碰重置相应确认，无画面独立超时从不可用时刻起算。初始从未找到猫的扫描仍有720°预算，运动／通信／无效新帧等保护仍可提前中断。“至少五轮”是五个完整行为，不是五段编码器短步或五次完整会话。

**720°转角、轮距和半脉冲。** 预算是每次搜索当前路线目标的预算，不是整条路线共用。轮距是两轮中心间距离，不是半径／直径。旧单侧max计数会在两侧起转不同时过计平均轮行程；0.38保存左右整数增量和，以两侧行程计算转角，平均单位的半脉冲只是表示方法，编码器本身仍是整数。滑移、负载和实际两轮起转差尚未用外部角度量测验证，不能把公式一致写成实体720°已准确。

**标签停稳只看一次。** 改为每步最多tagScanMaxFrames个新鲜有效画面，默认3、范围1–10；任一次找到立即通过，全未找到才下一扫描步，无效或超时仍故障停车。增加的是识别机会，不能称为准确率提高200%。

**Uno超Flash与回读碎片。** IDE安装层旧优化配置未包含-fno-inline-small-functions，补入后同源码减少66B，从超54B变成余12B；不是所有编译器配置都没生效。上传后的捕获出现21条完整PONG、1条几何配置、没有完整READY，仅发送1次PING，不能报21次事务成功。采集时刻不等于字节产生时刻：未清已有缓存且无逐行时间戳，不能认定乱码烧录后立刻产生，也不能认定启动53秒后仍持续产生；真实UART乱码率及根因仍待确认。

**AprilTag字典与画质。** 第三方节选库的35码不能当作当前程序能力：本项目实际编译的tag36h11.c包含587码（0–586），并非按暗色占比筛选。当前0-bit纠错、quad_decimate=1.5、320×240 JPEG是源码约束，不是失败原因的实验证明。现可从码字计算36个内区数据格的黑白比例；这不是纸张含边框／留白的总体黑面积，更不是实拍亮度。用户报告46号3/5成功、40号0%但未给分母，只有小样本差异，尚无同照度、距离、角度和曝光控制的比较。新增摄像头参数界面用于按相同条件调参并分组验证。

**自动重启与日志断档。** 最新log(1)只有重启后5.694秒的状态，resetReason=4说明上一启动以PANIC分类结束，缺原始异常回溯，不能定位到AprilTag、猫模型、内存或电源。此前网页只保留内存中160条且重启清空，使故障前上下文易丢。0.39将网页已收到的记录写入浏览器IndexedDB，独立于ESP环形缓冲，全部历史可导出，显示窗口仅500条；按deviceId/bootId/seq去重，明确记录断线和漏收区间。不能找回未拉到的环形缓冲旧记录、网页关闭期间数据或未进入HTTP应用日志的panic串口回溯。

**实际传感器范围兼容。** 0.39首次烧录／回读发现OV3660的gainceiling状态为248，而界面按通用0–6档位校验，导致保存整组参数会被拒绝。核对Espressif驱动发现OV3660／OV5640使用0x3A18/0x3A19的10-bit寄存器值，uint8_t status会截断高位，不能把248强行截成6。0.40按PID提供范围；这两类传感器通过get_reg读取完整0–1023并以set_reg写正确掩码，其他传感器保留enum0–6。范围来自板上回读；读失败不当作有效参数，写后读失败拒绝持久化并尝试回滚。标签与猫仍共用同一摄像头，QVGA保持固定。资料：[Espressif OV3660驱动](https://github.com/espressif/esp32-camera/blob/master/sensors/ov3660.c) 的set_gainceiling、init_status、get_reg/set_reg。

#### 记录106 · 2. 已经可以计算的数据，分母和适用范围

来源：[原始日志](项目日志.md)，第1080行；原主题：2026-10-06：本对话问题复盘、已有可计算指标与本地日志／摄像头部署。以下为该记录原文，状态按记录日期理解。

| 指标 | 现在可得结果 | 分母／口径及证据边界 |
|---|---:|---|
| 找到猫到提前退出 | 684ms；进入OBSERVE到退出683ms | log51 seq659/660/665，0.34一次事件；不是修复后的耗时或误退出率 |
| 当时观察／退出配置 | initialLookSeconds=5s，catLeaveSeconds=5s，robotActionLimit=5 | log51保存配置；配置存在不证明旧分支遵守它 |
| 被猫找的停车复核时差 | CAT_CONFIRM→CAT_CONFIRMED=2981ms | log50单次旧流程；随后ROTATE180是逃跑方向，DRIVE23是逃跑，不是猫居中 |
| 旧160条日志覆盖时长 | log49=11.556s；log50=5.627s；log51=10.158s | 每份末ms减首ms；来源混合、负载不同，不能当固定日志秒容量 |
| 36格内区黑格比例 | ID40=14/36=38.89%；ID43=19/36=52.78%；ID46=24/36=66.67% | 当前码字0位为黑、1位为白；仅理论内区图案，无实拍照度因果结论 |
| 用户46号小样本 | 3/5=60%；2/5失败 | 用户报告；40号0%缺分母，报告差60个百分点，不算倍数、不称0.40准确率 |
| 真实编译字典大小 | 587码，ID0–586 | 当前src/tag36h11.c；供应商35码副本不参与当前能力结论 |
| 反转几何估计 | 两侧各1脉冲=10.125°；左2右1=15.1875°；71平均脉冲=718.875° | 轮径67.5mm、轮距120mm、20脉冲／圈；推导值，不是实际角度误差 |
| 停稳标签机会／窗口 | 1次→默认最多3次；增加2次；默认窗口9000ms | 上限3000ms×3；找到可提前结束；不是实际延迟或识别成功率 |
| Uno编译修复 | 32310→32244B，−66B／0.204%；由超54B到余12B | 32256B应用限额；编译数据，不是运行速度提升 |
| Uno静态SRAM | 1381/2048B，余667B | 静态编译占用；不是运行栈最低余量 |
| 最新重启后窗口 | uptime5694ms，27条seq1–27，152–5657ms，跨度5505ms | 仅本次重启后快照；无故障前全窗口，不能算PANIC发生频率 |
| 重启后日志构成 | READY1，CAMERA1，INPUT_REJECTED23，SIM_TX1，WIFI_GOT_IP1 | 27条应用日志；23条拒收在启动后的SIM模式，不是重启原因 |
| 重启后内存／连接 | heap48980B，min40332B，largest31732B，PSRAM8167280B；RSSI−52dBm，disconnects0，frameSeq26 | 重启后读数；不能推断崩溃前OOM或长期稳定率 |
| 0.39本地归档测试量 | 合成1200条，旧窗口160条的7.5倍 | 跨重载／重启逻辑测试，不是浏览器实机容量上限或实机留存率 |
| 0.39网页／原生回归 | 60/60、11/11；摄像头67+65=132检查 | 离线通过率；有计数9类合计6089，另2类只报通过，不能称完整总断言 |
| 0.39编译资源 | Flash3791846/8257536=45.9198%；静态RAM85584/327680=26.1182% | 相比0.38 Flash+15080B、RAM+208B；静态RAM不同于运行heap |
| 0.39网页gzip | 96953→34037B，减少62916B／64.8933% | 压缩往返一致；不是浏览器加载耗时提升比例 |
| 0.39实际配置保留 | 本次上传前后95个旧字段，变化0项 | 本次pre/post快照逐项比对；此前0.38上传是94旧字段＋新增1项，勿混淆分母 |
| 0.40兼容修复回归 | 网页61/61；native11/11；摄像头82+65=147检查 | 新增实机暴露的10-bit上限、读失败和范围覆盖；仍非实机参数写入验收 |

复算脚本：evidence/conversation-metrics-20261006/calculate-metrics.mjs；结果：metrics.json。原始附件保持原路径，计算从日志与源码读取，不手填测试成功率。

#### 记录107 · 3. 后续指标怎样定义，哪些当前还不能算

来源：[原始日志](项目日志.md)，第1107行；原主题：2026-10-06：本对话问题复盘、已有可计算指标与本地日志／摄像头部署。以下为该记录原文，状态按记录日期理解。

| 要衡量的问题 | 建议指标与计算方法 | 当前缺少的证据 |
|---|---|---|
| 找猫是否仍横跳／过早退出 | 完整找猫会话中重复CAT_CHECK／SETTLE且无完成动作的次数；异常退出会话数／有真实猫标注的会话数；找到→互动时差中位/P95 | 附件是截断尾窗；缺修复后完整会话与现场真猫存在标注 |
| 是否完成五个高层行为 | 达到robotActionLimit的已找到猫会话数／符合正常退出条件的会话数；单会话完成数 | 不能把停车步骤、无效帧或保护中断当行为完成；目前只有离线覆盖 |
| WAIT_CHASE是否足时等待 | 最后一段有效连续负检测起点→退出时间；被正帧／触碰重置次数 | 缺修复后完整的新帧和进入／退出实机记录 |
| 新参数是否更利于标签／猫识别 | 按标签ID、camera revision、模式、光照／距离／角度分组，成功检查数／有效检查数；找到耗时、每停稳使用帧数、中位/P95 | 缺逐次阳性／阴性记录及相同条件；lux需要照度测量，猫误检漏检需要真值 |
| 实际720°误差和两轮差异 | 估计角度−外部实测角度；左右起转延迟与各自脉冲、剩余预算 | 编码器推导不包含滑移；需外部角度和同步起转记录 |
| 日志是否完整保留／完整导出 | 按bootId统计唯一设备seq和明确缺口；接收记录数、成功落盘数、待落盘数、导出唯一设备记录数分别核对 | LOCAL_*事件不计设备日志；网页离线前后丢失和浏览器存储失败须记录，不能把ESP覆盖数当网络丢包；当前没有真实浏览器大样本验收 |
| ESP是否稳定及恢复多快 | 非人工重启数／实际观察小时；断线事件→首次成功接收时差；连续heap/min/largest变化 | 需完整观察时长、人工烧录重启标注和连续快照；本次仅重启后快照不能算率或泄漏斜率 |
| Uno通信是否稳定 | BAD_CHECKSUM／完整帧数、重复事务ID数、超时／请求数，采集逐行时间戳 | 当前21条PONG来自1次请求，不能充当21次成功；乱码产生时刻和缓存边界不明 |

0.40最终部署、完整寄存器回读和资源数字在下面补入；本轮不执行电机、标签／猫识别或摄像头试调实验。参数范围修复解决已证实的保存门槛错误，不宣称实际识别率已提升。

#### 记录131 · 2026-10-13：复查 10 月 6–12 日聊天，补齐问题证据、处理结果与验收状态

来源：[原始日志](项目日志.md)，第1362行；原主题：2026-10-13：复查 10 月 6–12 日聊天，补齐问题证据、处理结果与验收状态。以下为该记录原文，状态按记录日期理解。

本节是 10 月 12 日开发后的补漏记录。按柏林日期回查 10 月 6–12 日相关聊天（含 10 月 5 日 UTC 晚间跨日记录），对照已有原始日志、Git、测试报告与烧录记录。核对本地 19 份会话文件、17 个会话 ID；分叉重复消息去重，排除内部审批记录及同目录下无关 Unity 工作。另查到一个云端连续三帧问题会话，仅有中断的提问，没有新的完成结果。覆盖清单见 [coverage.json](evidence/retrospective-20261012/coverage.json)。未将全部聊天原文或无关私人内容复制进项目。

#### 记录132 · 已有记录与本次补漏范围

来源：[原始日志](项目日志.md)，第1366行；原主题：2026-10-13：复查 10 月 6–12 日聊天，补齐问题证据、处理结果与验收状态。以下为该记录原文，状态按记录日期理解。

| 事项 | 原日志已有位置／结果 | 本次处理 |
|---|---|---|
| 浏览器跨重启完整历史、共享相机 18 项设置、0.40 部署 | 10 月 6 日日志与共享相机章节 | 不重复；继续区分已收到的历史与缺失日志 |
| ESP PANIC／POWERON、VUSB／充电灯、JPEG 无帧 | 10 月 6 日重启与供电章节 | 保留尚未确诊；quality=15 后观察期预览恢复已有后续记录 |
| 扫描跳步、最低 PWM150、停止后异常编码器计数 | 10 月 6 日旋转跳步章节 | 不重复，也不把编码器角度当实测车身转角 |
| 标签丢失宽限、停车复核、方向记忆；猫每 1cm 停查改为完整接近 | 10 月 6 日 0.41／0.40.1／0.42 章节 | 不重复实现与离线数据；“最多三张新帧，任一次找到提前通过”，并非连续三次阳性或必为相邻帧 |
| 遥测超时／坏校验被当作找猫失败 | 10 月 6 日通信回退审计，含 370348–377005ms 完整链路 | 保留为审计和建议；没有证据证明所有故障出口已修复 |
| 两分支配置与宽度显示、main 烧录、预览下两帧标定、Uno V6.12 直行平衡 | 10 月 7 日对应章节 | 不重复；短时静止通信与回读通过不等于实车偏航量化验收 |
| 遥控、声光、指定节点续寻、路线编辑、裸 DONE 超时、末节点 NVS、手机／电脑布局 | 10 月 12 日 0.43–0.46 章节 | 不重复；补本轮 0.47 修复、提交状态及用户验收 |
| 标签／猫不靠近的早期诊断、前向研究来源、v2 训练与停止 | 原日志缺完整结果 | 以下补入，并明确诊断、离线筛选与实车结果的区别 |

#### 记录138 · 仍缺证据或尚未解决的事项

来源：[原始日志](项目日志.md)，第1434行；原主题：2026-10-13：复查 10 月 6–12 日聊天，补齐问题证据、处理结果与验收状态。以下为该记录原文，状态按记录日期理解。

- 供电／PANIC／POWERON根因、停转编码器异常、长期UART稳定性仍未闭环；本轮“测试没问题”不替代这些受控排查。
- Uno直行平衡缺同电量／地面／速度下前后各约50cm、各三次的侧偏和实际PWM对照；暂不写改善百分比。
- 开启前向时FRONT_BLOCKED转路线到达仍是现行规则；是否误报、真实滑行和停止距离需有同步现场数据，0.47未改为“原标签停车等待后继续”。
- v2跨场景筛选未通过，自动免标定地面识别、纯前向耗时和ESP预算、独立停车FLOOR调试模式均不能写为已实现。
- 通信未知冒充目标缺失的审计建议尚无完整实施／实车证据；后续需逐出口核实，不能因已有STOP重试就宣布整体解决。

## 10 · 前向避障研究与模型评估

**发展脉络：** 追查24格算法来源→论文与工程方案分开→保存旧基线→公开数据按物理场景划分→候选训练和一致性→验证筛选不合格后停止。

**目前结果与边界：** ORG3420帧，train1458／validation253／test1709；五候选验证宏平衡准确率80.43–85.15%，测试68.28–72.05%，全部NO_ELIGIBLE_THRESHOLDS。ESP-DL导出和CPU回放不等于ESP执行或可用避障。

**能力提炼：** 研究检索、数据集与泄漏控制、评价指标、数值一致性和停止标准；能用负面实验收窄方向而不包装成已部署提升。

关联其他主题：[记录018](#record-018)、[记录135](#record-135)。

### 本章记录索引

| 记录 | 原始日志标题 |
|---|---|
| [136](#record-136) | 10 月 11 日 v2 基线、公开数据训练及停止结果 |

### 本章完整记录

#### 记录136 · 10 月 11 日 v2 基线、公开数据训练及停止结果

来源：[原始日志](项目日志.md)，第1396行；原主题：2026-10-13：复查 10 月 6–12 日聊天，补齐问题证据、处理结果与验收状态。以下为该记录原文，状态按记录日期理解。

先将既有前向优先与参数修改提交到 main 592621b，再在隔离 feature/front-avoidance-v2 工作；7d48212 完成旧算法图像回放／计时核验，12 个合成案例与 C++ 表达式一致，55 项网页／状态及 13 项离线检查通过。回滚标签 rollback/front-avoidance-baseline-20261011 指向 592621b；同级回滚目录保留源码 ZIP 和已验证 Git bundle。这类回滚包保存源码与历史，不能当作当时设备 NVS 或完整 Flash 备份。用户核对设备为 0.42_FRONT_APPROACH_PRIORITY，是其版本确认，不补造此前未记录的烧录／回读过程。

ORG 原始 ZIP 为 7,099,192,170 字节，3,420 对 1920×1080 图像／标签，作者 train1711、test1709。按物理场景划分开发集为 train1458、validation253、test1709；同一 ResearchBuilding_F6Hall 的不同编号归为同一场景，作者 test 不参与模型或阈值选择。五候选使用 RGB／局部纹理等 24 维特征。验证集选择研究候选 logistic_c1，但全部阈值筛选返回 **NO_ELIGIBLE_THRESHOLDS**，没有放宽约束宣布合格。

| 模型 | 验证宏平衡准确率 | 测试宏平衡准确率 | 测试障碍点误判地面 | 测试地面点误判障碍 |
|---|---:|---:|---:|---:|
| rf16_d8 | 80.43% | 68.28% | 12.65% | 48.32% |
| extra16_d8 | 80.54% | 69.44% | 11.43% | 47.23% |
| hist32_d3 | 81.34% | 69.00% | 10.21% | 49.14% |
| logistic_c1 | 85.15% | 72.05% | 11.18% | 41.79% |
| mlp16_8 | 83.46% | 70.52% | 13.77% | 43.12% |

宏平衡准确率先按场景计算再平均；最后两列按全部测试采样点各自真实类别计数，不能与宏平均误判率混用。全部预测地面的普通像素准确率约 98.63%，但障碍召回为零，说明普通准确率不足以评价该任务。若采用“ROI 任一点判障碍就停车”，五模型均会把 1,398 张已标注空地 ROI 判为有障碍；269 张采样后含障碍 ROI 的检出不能弥补空地全停车。另 42 张原图障碍 ROI 的障碍点被缩小／采样丢掉，必须单列漏采样，不能当作真实空地。

52 项离线／原生合同检查通过；每模型 299 个随机／边界输入的 Python／C++ 概率最大误差，树模型≤2.23×10⁻¹⁶、逻辑回归3.58×10⁻⁷、MLP2.69×10⁻⁷。这证明实现一致性，不证明检测质量。权重审查发现“精确场景等权”声明不成立（反例最终 75%／25%），报告改为披露实际权重；MLP100次迭代未收敛警告保留。

实际导出两个 MLP ESP-DL EDL2 文件，4,304 字节单点版和 20,128 字节15×40网格版；格式解析、已安装算子匹配与 CPU 量化回放通过。网格量化验证平均概率绝对误差约0.1247，最大约0.9770，0.5决策变化约11.94%，仍无合格阈值。没有 ESP 加载／执行、耗时／RAM、量化 test 或实车验收；25ms预算未验证。原生 ESP 基线编译按用户要求中止，记录 CANCELLED_BY_USER_NOT_COMPILE_FAILED，不能据工具退出1宣称编译失败。

**结果：完成了可复现研究和不合格筛选，未解决实车误报／漏检。** 用户要求停训后停止后台任务，保留训练源提交 cd71ba01feb86ce62c72e2182ec76c5b8710b067 和产物，回到原仓库 main 基线；未合并或烧录 v2。完整报告见 [首轮结果](../uno-web-lab-front-avoidance-v2/docs/front-avoidance-v2/first-training-results.md)、[模型比较](../前向避障模型训练-20261011/reports/model-comparison.json)、[ESP-DL 状态](../前向避障模型训练-20261011/reports/espdl-status.json)。

## 覆盖与后续维护

所有138个正文单元均有唯一记录编号和来源行号，映射及正文摘要见 [覆盖清单](evidence/log-classification-20261013/coverage.json)。多主题的长复盘表放入“日志证据、复盘与验收管理”，具体实现记录归入对应领域，避免为了主题重排而拆散表格或丢失条件。

未来新增记录先追加原始日志，再归入本文件对应章；同一个故障保留阶段发展与最新验收，不能覆盖历史失败。若原日志插入或修改导致行号变化，应同步来源与覆盖清单。用于演讲或能力总结时提炼主题开头和故事线，保留关键证据，不需要逐版本念完整归档。
