SaitoTommo/CatTeasingRobot/ESP32上位机与网页调试计划.md

# ESP32 上位机与网页调试计划

记录日期：2026-09-30。状态：需求已记录，尚无可烧录的 ESP32 上位机固件。

## 目标与职责

ESP32 最终完整实现当前电脑网页所承担的上位机功能：接收真实观测，运行巡游及互动策略，向 Uno 下发动作，处理结果和异常，并提供网页调试入口。机器人运行不再依赖电脑模拟器；浏览器用于查看和调参，关闭网页不应中断正常策略。

Uno 继续负责电机与声光输出、触碰/左右超声波/编码器读取及本地安全停止。ESP32 不绕过 Uno 的拒绝、租约和停止事件。电脑作为上位机的现有版本保留，便于对照测试。

完整接管不包括把虚拟场景坐标当成真实位置：网页拖动物体、脚本猫动作等功能仅作为独立测试工具。真机只消费真实观测。当前拟用 ESP32-S3 和摄像头，但开发前仍需确认实际板型、摄像头、内存和引脚资源。

观测边界必须一起迁移：左、右、后、上四路触碰都需接入，后方有触碰但没有摄像头或超声波，猫超出接触范围后的位置未知；触碰松开不证明离开。装死超时仍未确认离开时保持停止；实体输入缺失或过期不可用虚拟值补齐。调试注入必须显式标明来源。

## 功能范围与迁移来源

| 功能 | 当前实现 | ESP32 目标 |
| --- | --- | --- |
| 巡游、主动互动、触碰回应、结束与恢复巡游 | `decision-system.mjs`、`app.mjs` | 移植状态机、概率、计时器和动作序列，保持行为语义 |
| 找猫、找标签、对准和前向避障 | 网页生成的相机观测 | 摄像头实际识别，提供有效性、时间戳、目标中心和经过标定的观测 |
| 电机开启、续期、停止与距离停止余量 | 电脑 Web Serial 控制 | ESP32 UART 控制 Uno，按脉冲决定停止，保持持续电机动作 |
| 编码器、触碰、左右超声波及声光状态 | Uno 回报和网页读数 | ESP32 解析、区分来源，处理过期数据与拒绝原因 |
| 主动互动的一次性 HTTP 触发 | `server.mjs`、`app.mjs` | ESP32 接收并消费一次性事件，仍由本地策略决定动作 |
| 策略参数、几何参数、停止余量与物理 IO 开关 | 当前两个工作区 | ESP32 调试页提供配置与回读；切换 IO 时先停止相关动作 |
| 运行日志、错误提示与导出 | 当前网页日志 | ESP32 保存有界日志，向浏览器展示并支持导出 |

最终验收要求策略和真实观测链路由 ESP32 承担。外部电脑视觉处理可以用于早期开发对照，但不能把依赖电脑检测的原型标记为“ESP32 已完整接管”。摄像头测距能力需单独标定，不能把模拟器的精确厘米值直接照搬。相关观测约束见 [真机移植观测边界](./ESP32真机移植观测边界.md)。

## 网页调试日志

ESP32 提供可从浏览器访问的调试页，展示真实运行情况：

- 当前策略状态、动作、目标、最近一次状态转换及原因。
- 电机指令、租约状态、编码器脉冲、停止原因；位置显示明确标为编码器估计，不冒充绝对定位。
- 触碰、左右超声波及摄像头观测的数值、来源、有效性和更新时间。
- 向 Uno 发出的命令、对应回报、校验错误、超时、断联及恢复过程。
- 当前配置、固件版本、会话编号，以及可下载的本轮测试日志。

每条日志使用单调时间和递增序号关联命令/回报；没有网络时间时不伪造真实日期。日志缓存有容量上限，记录丢弃计数。网页断开、连接慢或日志导出期间，UART 续期、传感器处理和策略循环仍继续运行。高频脉冲用于仪表更新，不要求每个脉冲都刷一行文字日志。

可采用 WebSocket 或 SSE 推送显示数据，具体方式在确认 ESP32 运行环境后选择；这不是已实现的接口。需要提供醒目的停止入口，并回读实际停止结果。真实网页默认展示硬件来源，测试注入须显式选择并在日志中标明。

## 实施顺序与验收

1. **板型与协议联通。** 确认资源，打通 ESP32—Uno UART。验证当前 V5.6 的 57600 波特、短指令/CRC、约 100 ms MP 回报、KEEP 与 STOP。断联时 Uno 必须能自行停机。
2. **先实现网页日志。** 接收 Uno 回报并生成 ESP32 本地日志，从浏览器查看、停止和导出。这一步优先帮助装轮后的实机测试；此时尚不能称为完整自主策略。
3. **迁移运动和策略。** 实现持续开关控制、距离与停止余量、搜索/对准、巡游与互动状态机、HTTP 一次性事件和参数配置。使用录制观测对照当前策略测试案例。
4. **接入真实视觉。** 标定并验证标签、猫、前向障碍观测；验证丢失、过期与异常处理。开发用模拟输入与正式硬件输入明确分开。
5. **装轮整体验收。** 验证连续巡游、目标前停止、障碍/触碰中止、找猫失败后的恢复；用导出日志关联实物视频和运行事件。

完成条件：电脑不再运行上位机也能巡游和互动；浏览器关闭不影响控制；串口损坏数据、传感器过期和断联有明确处理；网页能查看并导出本次实机运行日志。电机、摄像头和策略分别验收，不以“网页能打开”代替整机验收。
