SaitoTommo/CatTeasingRobot/esp32-host/ESP32CatHost/debug_page.html

# ESP32-S3 Sense · 猫互动上位机

HTTP 视频与板载识别；关闭网页后控制循环继续。UART 模式需要真实 Uno 接线。测试注入标记为 SIM。

急停：停止策略与电机

## 巡逻与续寻

Simulated UART · 模拟Real UART · 真机

正在读取板子实际模式…

切换会停止当前策略与电机；模式选中状态以 ESP32 回读为准。模拟模式需要电脑模拟器提供回报。

启动巡游主动找猫（无需先巡游）停止策略与电机

### 自定义巡游路线

按巡游顺序填写标签 ID保存巡游路线

支持逗号、空格或箭头分隔；1–128 个节点，标签 ID 0–586，可重复。先停止巡游或退出遥控，再保存。保存后的路线按此顺序循环。

输入标签 ID 搜索已保存路线选择路线中的节点续寻：请选择路线节点

导出本地全部日志

浏览器本地日志历史

正在读取本地日志…

仅保存本页面收到的记录。存储属于当前浏览器及网页地址；切换 ESP 地址、浏览器或清除网站数据会影响读取。网页关闭期间不会收集新日志；当前页面保持打开时，ESP 断线也能导出。

即时流程状态：正在读取…

电机命令栏显示当前请求；实际引脚输出见下方电机回报。lastTx 和滚动日志是历史发送记录。

完整设备状态

正在连接…

## 摄像头与识别

调整摄像头参数（猫与标签共用）

画面固定 320×240。0 表示关闭、1 表示开启；手动曝光和手动增益在对应自动控制关闭后生效。回读是驱动配置，自动模式下实时曝光数值不由它测量。调整后空地外观参考失效，需要重新采集。

应用并保存到 ESP恢复本机启动默认参数并保存

板上摄像头参数回读

仅预览（默认）只识别标签只识别猫猫与标签

上电默认关闭推理，预览约 5fps；每次识别后休息 0.2 秒，两次识别启动至少间隔 0.35 秒。实际更新间隔包含识别耗时。自主搜索由停车后的新帧请求控制；慢接近猫时只在短距离行进并停稳后识别猫，界面选 CAT/BOTH 也不会开启行进中的猫识别。标签靠近自动持续 TAGS；视频独立。

显示预览显示猫框画面

### 每次识别耗时

等待猫识别…

解码、推理与总处理均由 ESP32 计时；不含网络传输和浏览器画框。全部本地处理。

识别原始回报

猫框和 AprilTag 来自板载检测；无检测不代表猫离开。前方没有深度传感器，未标定默认 INVALID。

## 避障状态：前向 / 左侧 / 右侧

前向避障：读取中

左右避障阈值

左侧净空 cm 右侧净空 cm 应用到 Uno 并回读

参数保存在 Uno RAM，重启恢复默认值。

前向判断、标定与参数

地面标定状态：等待读取

采集空地参考（先确认停车）

前向避障参数：作用与调整

接近标签时发现障碍：停车确认后寻找下一个标签。接近猫时发现障碍：立即开始近距离互动，同时停车；新的运动等待停车确认。前向开关关闭时，这两类接近也不受前向结果拦截。未标定、图像过期或结果无效时停止等待，不算到达，也不触发互动。

地面差异阈值 floorDifferenceThreshold（5–100）

把警戒区域划分为 3×8 格，各格灰度均值与保存的空地参考比较，取最大绝对差。差异值大于阈值就报障碍；不是厘米。调小更敏感，阴影或地面变化也更容易触发；调大减少误报，但可能漏掉差异较小的障碍。只调整阈值不需要重新标定。

地面检测起点 floorRoiTop（0.5–0.95）

按画面高度比例设置警戒区域上边界，横向固定为画面中央 25%–75%，纵向从该起点到底边。0.75 表示下方四分之一；调小看得更高、区域更大，调大只看更靠近底边的较小区域。不能直接换算成距离。修改后原地面参考失效，必须重新采集。

猫框底边阈值 frontBlockBottom（0.5–1）

有猫识别结果时，猫框底边的高度比例大于这个值就报障碍；0.88 表示框底边进入画面下方 12%。调小更早触发，调大需更靠近底边才触发。与猫框宽度阈值独立。行进中的 FLOOR 模式不识别猫，只使用地面差异，因此这个值不参与 FLOOR 判断；只改此值无需重新标定。

观测有效期 visionMaxAgeMs（100–5000 毫秒）

前向、猫及标签观测共用的有效期；到期即不可用。调小更快拒绝旧画面，但慢识别时可能频繁停止；调大容许更旧的结果。它不是障碍敏感度，调整后无需重新标定。

保存前向参数到 ESP

正在读取板上参数。

frontAvoidanceEnabled 控制自主行为和普通手动测试的前向拦截，包含标签接近、猫接近、试探和逃跑转向后的前进；关闭后仍显示检测结果，但前向 BLOCKED／INVALID 不会阻止或中断这些动作。左右超声波、触碰、失速及通信停车仍保留。frontCalibrated 是标定状态，floorReference 是自动采集的 72 个参考值，二者不需要手填。摄像头位置、参数或光照变化后重新采集参考。先确认停车再保存，保存成功以板上回读为准，重启保留。

标定步骤：①把摄像头固定在实车使用的位置和角度，停止机器人并等待停车确认。②切到实时视频，在相同光照下对准前方无障碍的地面；下面显示的采集区域必须全部是空地，不要包含墙壁交界、猫、玩具或标尺。整幅画面不必全是地面。③点击“采集空地参考”：程序自动取一张新画面保存参考，再取一张新画面检查参考是否使用成功；不需要先开启猫或标签识别。④看到采集完成和新画面的地面判断后，即可开始接近测试；前向开关开启时，接近过程检查前向结果。15 cm 标尺只用于确定检测区域上边界的位置，采集参考时移开。改变摄像头位置、参数、检测区域或光照后重新标定；同色障碍仍可能漏检。

实验性前向外观检查：图像下方、中央一半为警戒区域。需把摄像头固定到实车，在 15cm 标尺位置调整 floorRoiTop。同色障碍可能漏检，尚不能视为已验证的实车避障。重新安装或改变光照后重新标定。

## 手机遥控与续寻

进入遥控退出遥控停止策略与电机

正在读取遥控状态…

遥控速度 100 PWM

按住方向移动，松手停车；速度独立于自主最低 PWM，0 表示停车。左/右为原地转向。

前进左转右转后退

### 灯光与蜂鸣器

随机灯光长响两声短响三声短响按住鸣叫关闭声光

### 恢复自主巡游

从首节点启动巡游

### 自定义巡游路线

按巡游顺序填写标签 ID保存巡游路线

支持逗号、空格或箭头分隔；1–128 个节点，标签 ID 0–586，可重复。先停止巡游或退出遥控，再保存。保存后的路线按此顺序循环。

输入标签 ID 搜索已保存路线选择路线中的节点续寻：请选择路线节点

先退出遥控并确认停车，再寻找所选标签；自主避障恢复。

## 猫识别

等待猫识别…

猫框宽度：等待识别

过期、无效和未开启识别均不能证明猫不在现场。

## 标签识别

等待标签识别

目标标签宽度：等待识别

续寻目标与识别结果分开显示；未检出不代表标签不存在。

## Arduino 传感器与输出回报

每项单独计时，超过 2.5 秒标为过期。前向避障由 ESP 视觉判断；接近标签和猫时始终生效，总开关控制其他行为；Uno 前向行仅保留旧协议回读，不参与电机门禁。物理输入、测试注入和关闭状态在读数中标明。

## 配置与参数

## 巡游路线与策略参数

巡游路线可在上方“巡逻与续寻”或“手机遥控与续寻”卡片中自定义、保存，并选择从哪个节点开始续巡。

1–128 个路线节点，ID 0–586；可重复访问同一编号。数量和顺序由你保存的数组决定；找到目标并达到停止宽度，或接近中前向报障碍后停车，停车确认后寻找下一个，末尾回到首个节点。同一编号重复节点需等待它消失或宽度退到停车阈值的 80% 以下再重新计到达。找到与停车宽度是两个判断；找猫和找标签均最多搜索两圈。

标签停车宽度占画面的百分比 保存停车宽度 标签出现即算找到；这个百分比决定正常到达；开启前向避障时，前向障碍优先于宽度。

旧猫居中容差（已停用） 保存居中容差

标签居中容差（标签中心左右各 ±%） 保存标签居中容差

每次停稳最多识别标签次数 保存标签识别次数

每次使用新画面寻找当前路线标签；找到立即结束本步，未找到则保持停车继续识别，达到次数上限再转下一步。识别无效或超时仍会停止搜索。

接近标签漏检宽限（毫秒） 猫与标签首次局部恢复转向（度） 保存标签恢复参数

有效新画面暂时没找到标签时，已确认的直行可保持到宽限结束；无效画面仍立即停车。随后停稳多帧复核，确认丢失后先按标签最后位置局部寻找，再反向寻找，最后使用剩余搜索预算。三个阶段合计最多约两圈。

标签居中容差判断左右方向，标签停车宽度判断到达距离；猫框宽度判断远近，找猫不检测居中。

按摄像头视场角换算居中范围

换算应用到 水平视场角（度） 允许偏离光轴（左右各 ±度） 换算到居中容差

按实际镜头水平视场角填写，不能用对角视场角代替。换算采用针孔模型近似，镜头畸变和裁切会影响结果；最终以实际画面标定。只保存居中百分比，辅助角度本身不保存。居中范围与标签停车宽度分别控制方向和到达距离。

全部策略与几何参数

保存参数（先停止）

catNearWidth、catFarWidth、tagStopWidth 是归一化框宽，需现场标定；frontCalibrated 默认 false，不能把视频显示成功当作避障已有效。scanStepPulses 是每步编码器脉冲；scanMinimumMs/scanQuietMs 控制停稳等待；scanVisionTimeoutMs 是单次扫描／复核窗口的新画面等待上限。catCheckMaxFrames 默认 3，可选 1–3；SETTLE 后的 CAT_CHECK 任一次找到即通过，全部有效画面未找到才按原流程处理；补测期间保持停车，无效或超时则故障停车。CAT_CONFIRM 的等待与取帧规则暂时保留。catApproachStepCm 为慢接近分段上限；厘米猫距离 farCatThresholdCm/catLeaveDistanceCm 及旧 searchTimeoutMs/finalSearchTimeoutMs 不用于当前 ESP 控制，请用宽度和新扫描参数。改变 floorRoiTop 后地面参考失效，必须重新采集。

## 巡逻转向速度

搜索标签 PWM 对准标签 PWM 保存转速

数值越小，转向越慢。先停止巡游再保存，保存后重新启动测试；参数保存在板子上，重启后保留。

正在读取当前转速。

## 停车后识别等待时间

停车后至少等待（毫秒） 保存等待时间

正在读取板上保存值。

范围 50–3000 毫秒，1000 毫秒就是 1 秒。找猫、找标签扫描，以及猫的停稳识别均使用此等待时间；还需满足编码器安静条件。先确认停车再保存，重启保留。必要时保存会同步延长停稳超时上限，避免还未等够就超时。

## 直行校正间隔

每隔多少毫秒校正一次 保存校正间隔

正在读取板上保存值。

范围 20–1000 ms，默认 200 ms。先停车再保存；ESP 重启保留，下次启动自主巡游或找猫时由 Uno 确认后生效。间隔越小，校正越频繁，每秒减快轮 PWM 的幅度也越大。仅影响启用直行校正的动作，遥控不使用此校正。保存值与 Uno 确认值分别显示；需要配套新版 Uno 固件。

## 主动找猫：靠近与声光概率

用于“主动找猫（无需先巡游）”找到猫后的行为；触碰发起的追逃概率仍在“猫互动配置”中设置。猫远近由下方猫框宽度阈值判断；主动找猫与触碰找猫共用停稳确认，找到猫即可，不检测居中。主动互动找到猫后按完成行为次数退出；猫丢失时静止观察，继续完成次数。追逐观察仍使用猫退出确认时间，重新检出猫清零计时。

保存主动找猫配置

远处快→慢／三段试探概率合计100%；近处或接近完成后声光／观察／静止概率合计100%。完整快速接近、缓慢接近、三段试探、声光或观察各计一个动作；短步进、停车复核和动作间等待不计数，默认完成5个行为返回巡游；找到猫后有效无猫不再提前退出，未完成的运动不计次数，改为静止观察继续完成行为。触碰攻击会切入被猫触发互动，运动和通信保护仍可中断。快接近到非远处阈值或距离上限后切慢接近；慢接近按独立概率并行闪灯，各短段结束关灯，下一段继续，不占额外动作。试探冷却时回退到快→慢。修改参数前先停车，保存后回读，重启保留。

## 最低驱动 PWM

非零运动的 PWM 下限 保存最低 PWM

正在读取板上保存值。

按当前供电调整，范围 1–255，初始值 140。先确认停车再保存，保存后后续动作立即生效，ESP 重启保留。请求 95、下限 140 时实际下发 140；正反方向不变，PWM 0 仍然停车。巡游、找猫、扫描和手动测试均使用这个下限；要测试更低 PWM，先降低此下限。

## 猫互动配置

猫比例＝猫框宽度÷画面宽度。远处阈值必须小于近处阈值；先停车再保存。逃离每次转90°，最多检查3个方向；侧距必须超过设定阈值与Uno本地阈值中的较大值。逃离转向后的前进也受前向避障开关控制；开启时，未标定或画面失效就停车。装死时 MazeBot 灯条由遥控器控制。

保存猫互动配置

探索按每次新按压回应，长按不重复。灯光：不亮、常亮、慢闪、双闪；声音：静音、长响、两声短响、三声短响。两两组合共 15 种，排除不亮且静音；随机顺序用完再重选，相邻不重复。板载灯模拟灯带节奏。

## Arduino 限制与几何参数

等待 GET_CONFIG 回报…

轮径 mm 轮距 mm 应用到 Arduino 并回读重新读取

净空范围 1–100 cm；无效或过期测距不会触发 Uno 超声波停车，轮径 20–150 mm，轮距 50–300 mm。逐项等待 Arduino 确认；失败时可能已有部分参数生效，请重新读取核对。当前 Uno 协议在 RAM 中保存这些参数，Arduino 重启后恢复固件默认值。轮径、轮距须与 ESP 策略参数匹配才能巡游。触碰规则仍由 Uno 执行。最低驱动 PWM 在下方 ESP 设置中调整，不需要修改 Uno 固件。

## Wi-Fi

接入 Wi-Fi（保留热点）

## 动作测试与串口调试

## Arduino 动作与输出测试

正在读取模式…

测试 PWM 时长 ms

开启测试：绕过全部避障

正在读取测试避障状态…

前进后退左转右转停止并锁定会话

左轮正转左轮反转右轮正转右轮反转

解锁测试会话ESP LED 亮ESP LED 灭Uno 蜂鸣 180msPING查询状态读取 Arduino 配置读取传感器

先停止巡游。打开“绕过全部避障”后，前进、后退、转向和单轮测试忽略前向标定、左右超声波和触碰；每次只运行设定时长，结束后停车并锁定会话。失速停车与急停仍保留。此开关只影响手动测试，自动巡游保留避障；上电、串口模式切换或 Uno 重启后恢复避障。PWM 会应用下方的最低驱动 PWM 设置；实际输出请看电机读数。蜂鸣器测试需先解锁；LED 开关直接控制 ESP，不发送 Uno 串口命令，也无需解锁；LED 由 ESP 板载灯显示，蜂鸣器已拆除，原蜂鸣器输出迁至 D12 备用。

正在读取 ESP LED 控制状态…

## Uno 接收与发送调试

发送 Uno 命令

真实 UART：D6/GPIO43 → 电平转换 → Uno D13 软件接收；Uno D1/TX → 电平转换 → D7/GPIO44，共地，57600 波特。发送成功只表示命令入队，执行结果请查看 AK / DONE / ERROR 和传感器回报。

Uno V6.14：RX available 信号给出一次性接收窗口；ESP 仅在窗口内发送一条普通指令。旧 H 心跳已替换，内存诊断仍保留；详细模式增加命令进入/退出及遥测分段标记。日志中的 EVENT DIAG S 后为十进制步骤和命令编号；H 心跳字段为十六进制，含计时、循环数、最大循环毫秒、遥测编号、分段、等待位、RX 溢出、丢弃命令数。

详细流程诊断仅诊断心跳关闭诊断输出

## 猫识别性能测试（实验分支）

现有巡游、主动找猫、串口及动作测试可照常使用。开启后运动和静止期间均持续检测猫；状态机指定的新帧识别优先，测试结果不替代停车复核。高负载可能影响网页和串口响应，请同时观察。设置仅本次上电有效。

识别完成后的空隙 ms 采集后的空隙 ms 开启 / 应用间隔关闭测试清空并重新计时导出逐次耗时 CSV

0 表示无额外定时空隙，仍等待新帧并让出 CPU；采集空隙也设为 0 才能解除原 5fps 限制。整次处理包含解码、推理和后处理，不含 HTTP 传输；模型推理单独计时。此处保留性能测试原图；右上角识别预览独立运行，无需开启性能测试。图片刷新速度不等同设备识别帧率。
