SaitoTommo/CatTeasingRobot/项目日志_问题分类版_20261004.md

# 项目日志问题分类版：入口已更新

2026-10-13 已将整个原始项目日志重整为主题分类，新增故事线、能力成长索引与完整证据归档。

请阅读 [最新问题分类版](项目日志_问题分类版.md)。

原20261004文件及随后逐日追加的全文保留于 [历史快照](项目日志_问题分类版_历史快照_20261013.md)，原始时间线继续保留在 [项目日志](项目日志.md)。
