SaitoTommo/CatTeasingRobot/esp32-host/日志35遥测缺帧与恢复失败-20261004.md

# log35：遥测缺帧拖延停车复核，随后重现恢复配置漏解析

版本ESP0.28，保持先诊断、不改代码、不烧录。导出508055ms：STOPPED/FAULT，故障为Uno link recovery failed after 3 attempts；lastUnoAgeMs133，停车已确认，持续遥测已恢复。历史故障和当前有回报可以同时存在。

## 故障前找猫与停车成功

493770ms SD679 104 1（FOUND）；493783ms STOP681收到MOTOR_STOPPED；493784ms进入CAT_CONFIRM。故障不是没有找到猫，也不能由后来的encoder settle unavailable认定电机仍在转。

## 新的明确软件处理缺口

494022ms发送GET_TELEMETRY684。Uno USB原始抓取包含三个完整带校验的TB684分片和DONE684 TELEMETRY；还原该快照：左右请求PWM0/0、实际PWM0/0、编码器计数846/736、RPM0/0。

ESP却只收到有效part2，part0/1对应接收异常（UART_BAD_FRAME）；494058ms收到DONE684后记录TELEMETRY_INCOMPLETE，拒绝发布不完整快照是正确的。但acceptUno在失败分支直接return，绕过下方telemetryId清零，查询保持挂起。虽然CAT_CONFIRM设定250ms轮询，也被!telemetryId条件阻止。直到499022ms五秒挂起超时才清理，499273ms再查询685，较684相隔5251ms；这条查询又出现UART_LOOPBACK。

499914ms报告encoder settle unavailable，距离进入复核6130ms。复核需要停车后两次新鲜、完整的编码器快照；本次缺帧和5秒查询阻塞足以耗掉6秒等待窗口。触碰在期间反复按下/松开也会影响状态推进，不能把6130ms只归因固定计时精度。

读数丢失在ESP接收/组包这一侧有直接证据：Uno确实发出完整快照且记录PWM/RPM均0；这不证明电气噪声具体来源，也不等于实际引脚电压或独立物理停稳测量。坏帧原因与失败后挂起5秒的程序处理缺口要分别记录。

## 旧的自动恢复缺陷再次复现

初始STOP688与前两轮STOP691/693未获得停止确认，伴回环/坏帧/BAD_CHECKSUM；期间诊断心跳和触碰事件仍在。第三轮503541ms确认STOP695；503576ms收到SESSION_STOPPED697；503602ms收到正确DATA698CONFIG，503605ms DONE698；503607ms立即判恢复失败。对应log34已离线复现的配置解析仅允许WAIT_PATROL_CONFIG、不允许LINK_RECOVERY_CONFIG问题，尚未按用户授权修复。

本段Uno心跳uptime单调增长，导出及故障窗口没有新的READY/BOOT；不能把这次失败说成又发生了一次Uno重启。较早19:02:34的非人工启动是上一份日志已确认的另一次事件。

## 后续修复方向（本轮未实施）

以后授权修复时：让不完整/损坏且已经结束的遥测事务明确释放挂起查询，并在受限频率下重新请求完整快照，保留严格组包与新帧要求；配置解析共用普通启动/自动恢复的命令ID和范围校验。不能靠放宽停车判定或取消CRC来规避本次失败。

证据evidence/log35-diagnosis/log35-excerpt.json与uno-replies.json；完整原始双USB抓取仍在post-v028/capture。代码未改，设备未操作。

## 诊断之后用户授权实施

用户随后要求恢复改为四轮，并修好成功回包被误判的问题，覆盖本报告开头的诊断阶段限制。实施记录另见重连四轮与遥测重试-20261004.md；历史失败证据保留。现场修复效果仍待验证。
