SaitoTommo/CatTeasingRobot/esp32-host/ESP32CatHost/debug_page.h

#pragma once
// Generated from debug_page.html by generate-debug-page.mjs.
const uint8_t DEBUG_PAGE_GZIP[] PROGMEM={
31,139,8,0,0,0,0,0,2,10,236,189,107,87,83,201,182,48,252,189,199,216,255,161,
58,237,118,37,219,16,146,0,106,7,131,15,34,118,251,108,17,31,160,187,207,121,108,182,
189,72,22,144,211,185,157,100,33,120,32,99,4,21,1,229,166,173,162,128,237,165,81,108,
109,46,182,182,34,23,25,99,159,127,210,157,181,146,124,226,47,188,239,156,179,214,74,173,
69,80,186,247,62,239,57,31,222,47,74,106,85,205,154,85,53,107,214,172,121,171,35,31,
135,19,33,245,66,82,97,221,106,44,90,119,4,254,101,81,57,222,21,116,252,71,119,69,
195,105,71,221,145,152,162,202,44,212,45,167,210,138,26,116,244,168,157,21,135,141,210,184,
28,83,130,142,243,17,165,55,153,72,169,14,22,74,196,85,37,174,6,29,189,145,176,218,
29,12,43,231,35,33,165,2,127,56,234,142,168,17,53,170,212,53,182,158,169,242,179,252,
216,243,220,218,13,237,234,211,220,234,213,220,230,184,62,183,118,164,146,190,127,116,36,173,
94,136,42,117,29,137,240,133,254,206,68,92,13,248,14,38,251,88,250,66,90,85,98,21,
61,145,218,14,57,244,109,87,42,209,19,15,7,62,81,148,206,170,78,95,109,40,17,77,
164,2,159,248,106,252,33,255,225,218,152,156,234,138,196,3,254,234,100,95,109,76,238,163,
254,3,190,42,175,55,217,151,73,43,33,53,146,136,247,11,80,122,187,35,170,82,155,148,
195,225,72,188,43,224,247,38,251,106,59,18,169,176,146,170,72,201,225,72,79,26,17,48,
160,34,50,222,76,71,143,170,38,226,238,72,60,217,163,186,211,74,84,9,169,110,85,233,
83,229,148,34,19,214,145,120,183,146,138,168,38,220,195,37,24,213,201,62,14,160,63,212,
147,74,39,82,129,100,34,18,87,149,148,101,108,225,14,69,81,14,113,84,2,62,152,131,
68,52,18,102,159,28,62,36,119,202,94,27,142,135,147,125,153,100,74,233,199,193,84,164,
147,114,72,9,36,83,74,69,111,74,78,226,44,116,43,145,174,110,53,80,117,16,198,151,
56,175,164,58,163,137,222,128,220,163,38,44,189,250,188,254,79,253,85,198,140,118,124,170,
40,225,144,57,6,31,96,30,137,117,245,11,211,234,245,254,185,150,254,60,88,13,19,28,
149,59,148,104,127,56,146,78,70,229,11,129,72,60,26,137,43,21,29,209,68,232,219,76,
183,15,167,166,34,29,249,15,37,224,175,73,246,101,60,105,53,145,20,215,226,147,206,206,
112,117,232,80,198,156,75,2,253,169,247,207,181,124,0,62,88,160,204,145,74,162,146,143,
142,116,251,136,164,42,90,171,88,171,18,79,43,236,239,111,202,146,87,183,175,238,72,178,
238,243,182,182,51,172,176,112,165,248,232,122,110,117,66,191,183,85,216,220,44,44,95,209,
70,158,111,111,204,106,67,47,139,211,139,249,205,235,197,135,191,104,83,19,250,196,130,54,
242,90,123,247,44,63,177,156,95,95,200,175,47,254,150,189,248,69,125,75,27,211,159,62,
212,54,38,139,115,217,194,147,193,252,220,125,109,233,123,246,69,60,193,244,137,199,249,181,
173,223,178,23,245,95,174,21,150,111,233,47,159,106,67,143,245,7,195,133,165,149,220,234,
26,107,61,217,244,91,246,226,145,202,164,73,228,158,88,34,172,84,16,45,164,25,167,9,
97,142,96,173,240,103,47,13,190,35,17,13,151,86,227,32,204,96,25,8,103,229,84,68,
174,72,166,148,116,90,9,7,213,84,143,210,110,153,99,95,117,77,168,250,32,95,99,162,
126,78,101,85,37,42,243,30,246,119,250,171,50,158,180,18,79,39,82,21,93,169,72,216,
92,85,248,81,11,255,84,168,74,44,25,149,85,165,34,148,136,246,196,226,233,64,74,73,
42,178,234,4,186,170,232,140,168,238,88,36,30,147,251,156,254,42,111,178,207,237,235,76,
185,92,181,93,114,50,224,243,227,234,151,96,51,57,165,70,66,81,165,191,204,246,222,65,
233,165,41,216,1,38,185,99,7,0,1,90,235,120,210,170,28,85,250,57,141,127,218,81,
125,216,23,182,214,72,199,228,104,212,168,80,227,63,120,248,160,177,229,3,225,72,90,238,
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
};
