SaitoTommo/CatTeasingRobot/(commit log)

2026-09-27 Initial local cat interaction lab baseline
    Behavior: track the Uno cat interaction test bench, launcher, simulator, decision policies, independent ending outcomes, route and escape planning, serial safety controls, and documentation. Start patrol immediately from its button and open exactly one Uno session before motion.
    Compatibility: retain migration for previously saved browser response settings. This is a local main branch with no remote or deployment.
    Verification: 21 focused Node tests, 2 simulator tests, browser startup showing SESSION_STARTED and DRIVE, and staged whitespace checks passed. Physical Uno motion and camera integration remain unverified.
2026-09-27 Harden serial transport, escape resume, and session ending order
    Escapes reliably died because the pre-motion sensor injections and the
    ROTATE/DRIVE line shared the wire within one millisecond; while the
    firmware blocked in Serial.print, the Uno's 64-byte RX ring overran and
    the fragmented last line was answered UNKNOWN_OR_INVALID_COMMAND (see
    exported session log: ROTATE -90 110 corrupted twice, plus ERROR 0
    BAD_ENVELOPE / TOO_MANY_ARGUMENTS from merged lines).
    - app: serialize all serial writes through one FIFO with a >=15 ms gap;
    confirmed one-at-a-time sensor sync (await DONE) before motion on serial
    - app: transport-level resend for motion commands (MOTION_RETRY, max 2),
    and SESSIO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
2026-09-27 Debounce touch bursts so one attack episode gets one response
    The cat lands several swipes per attack episode; every raw PRESS used to
    launch its own ATTACK_RESPONSE (later swipes during a response were
    queued and started a second round), so five fast swipes produced a chain
    of responses.
    - onUnoTouchPress now records each press as evidence (attack count and
    the ending inactivity timer still refresh per swipe, and a swipe
    during an active response ends the post-escape pursuit wait) but only
    schedules the response: it commits after a quiet window following the
    LAST press (new policy touchDebounceMs, default 1000 ms, range
    0-5000, 0 restores immediate launch; UI input in the cat pol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
2026-09-27 Fix attack escape timing, prey ending, and patrol recovery
    Behavior: Start a touch response on the first press. Escape after release without a pre-escape gaze, then search and face the cat. Select prey collapse only on the configured caught-touch round. End inactivity directly, wait for actual cat departure during collapse, and allow a safe outward patrol departure.
    Compatibility: Keep the Uno touch and obstacle interlocks authoritative. Retain the existing response-policy fields and saved settings; update the web labels, README, and search-control contract to match the new timing.
    Verification: Node decision, escape, route, server, safety, sensor, cat-input, and simulator tests passed (27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
2026-09-27 Add independent touch light and caught prey response
    On each new Uno touch episode, draw contact LED flash independently from the prey, slow escape, or fast escape choice. Flash immediately while touch is held; collapse and stop on contact when prey is chosen; keep wheel escape gated on release and face the cat afterward. Keep the round-limit ending and patrol recovery, and wait for touch release before resuming after a prey timeout.
    Migrate saved touchSignalPercent to both touchFlashPercent and touchPreyPercent while retaining the saved slow/fast shares. Update the controls, status text, behavior guide, and simulator coverage for the new semantics.
    Verification: node --test *.test.mjs (27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
2026-09-27 Add caught sound and light response
    Add SOUND_LIGHT_RESPONSE as a fourth caught-touch outcome. Start LED flash and buzzer on PRESS while keeping wheels stopped; after RELEASE, face and observe the cat. Keep the separate optional touch flash draw.
    Fresh policies use prey/sound-light/slow/fast odds of 20/20/30/30. Migrate saved three-way policies with sound-light at 0 so their existing odds do not change. Expose the new probability and beep duration in the page and logs.
    Verify all 27 Node tests, including contact-time LED and buzzer commands, no wheel motion before release, probability boundaries, and saved-policy migration. Physical LED, buzzer, and touch timing remain unverified on hardwa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
2026-09-27 Split cat interaction into exploration and hunting branches
    Choose sound-light exploration or hunting once when a cat starts an interaction; keep that branch through the interaction and reuse the existing follow-up, ending, and patrol-resume path. Exploration sends an LED pattern plus a beep on contact and rotates through four distinct rhythms without consecutive repeats. Hunting retains prey/slow/fast odds and skips extra draws for touches counted during an active response.
    Default branch odds are 20 percent exploration and 80 percent hunting; hunting odds are 20/40/40. Migrate the previous four-way response policy by moving its sound-light share into slow and fast escape proportionally, p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
2026-09-27 Restore sound-light feedback during hunting touch
    Put the touch-time feedback probability back in the cat interaction panel. Draw it independently from the hunting prey/slow/fast outcome; when selected, send LED FLASH and BEEP while the touch remains pressed. Exploration retains its own guaranteed sound-light patterns without duplicate feedback commands.
    Preserve saved touchFlashPercent values and migrate the former touchSoundLightBeepMs value to the feedback beep duration when present. Expose a dedicated touch-feedback beep duration while keeping the two branch selection and exit paths intact.
    Verified all 29 Node tests, including simultaneous LED and buzzer commands before release, no wh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
2026-09-27 Require measured robot observations throughout the cat test bench
    Replace full-scene detour geometry and hypothetical escape raycasts with
    current-range local navigation, real turns and fresh observations. Hide target
    bearing/range outside the camera frustum or behind occluders, derive sweep
    angles from encoders, and determine departure only from visible measurements.
    Generate robot contacts from geometry instead of cat script phases. Convert
    page contact/range inputs to scene edits, remove external alert and encoder
    injection controls, and reject manual sensor overrides. Use acknowledged
    geometry settings and require the V5.2 firmware handshake for dry-run control.
    Refresh published side r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
2026-09-28 Restore one-shot HTTP find-cat command and add real loopback channel
    Reverts c8682a3's spontaneous "camera sees cat interrupts patrol":
    patrol only leaves for an HTTP command or an Uno touch report.
    - decision-system.mjs: onMoodAlert gate accepts HTTP_NEGATIVE only
    - app.mjs: injectMoodAlert restored; auto tick has no visual trigger
    - server.mjs: POST /mood_alert queues intent-only commands (whitelist
    HTTP_NEGATIVE), GET /mood_alert/pending hands one out and consumes it;
    the page polls every 600ms when served over http: so the simulated
    ESP32 host genuinely receives an HTTP request before commanding the
    Uno. file:// falls back to the button-only simulation.
    - tests: server endpoint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
2026-09-30 完善电机实测、低流量串口、持续巡游与传感观测边界
    电机测试与 IO：
    - 纳入 L298N 故障定位记录和 A/B/C/D/S 最简电机程序；用户确认补齐逻辑与电机电源后电机可转。
    - 主固件 V5.6 提供 14 路独立物理 IO、硬件实时读数、混合输入来源及紧凑调试卡片；硬件与策略页开关同步。
    - 轮径采用 67.5 mm。ENA/ENB 跳线时显示 PWM 不是实际调速证据。
    串口兼容与容错：
    - 网页和主固件使用 57600 波特、短指令和 CRC-8 关键回报；最简测试程序保持 115200。
    - 删除冗余测距回显，从已有 ACK/进度/结束回报恢复丢失的运动开始；损坏的受保护帧直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
2026-09-30 建立 ESP32 Sense 通信、HTTP 视频与网页模拟输入基线
    新增独立 ESP32 固件和浏览器测试入口：USB JSON 输入、Uno UART 57600/CRC、HTTP 调试日志和 81 端口 MJPEG。开发板默认 SIM_UNO，上电不运动；真实 UART 与模拟来源分开。巡游 ID 配置为有序数组，支持 1–128 个节点和重复 ID，NVS 保存。保留原测试台入口和行为。验证：Node 测试 65 项通过；ESP32 编译进行中，摄像头/实机串口尚未验证。策略与视觉在本提交仅保留接口，后续提交实现。
2026-09-30 接入板载猫检测和完整 AprilTag 字典并完善视频服务
    使用 Espressif ESPDet-Pico 224 猫模型和 AprilTag ESP32 源码；保存模型二进制、校验值、许可证及上游版本。tag36h11 支持完整 587 个 ID。新增真实视觉观测、原型地面外观标定、JPEG capture 和独立采集/视觉任务；未标定前向输入为 INVALID。USB 日志由独立有界队列输出，HTTP 慢客户端不占用串口控制循环。参数完整范围校验及 NVS 回读加入固件。验证：视觉及状态机集成版本编译通过（3.65 MB），最新视频任务分离版本正在复编译。猫/标签识别质量及地面外观避障未做实物验收；同色障碍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
2026-09-30 移植 ESP32 本地上位机状态机并修复启动栈溢出
    实现任意 ID 数组巡游、猫互动与会话确认、编码器行程/扫描角、200ms 续期和750ms反馈缺失停止；模拟/实体输入分离，保留未知观测停车。默认视觉关闭、预览约5fps，支持分别开启猫或标签检测及1.5秒休息。修复首轮真机捕获的 loopTask 栈溢出：4KB输入缓冲移出栈、任务栈扩到16KB，Input类型移入头文件解决Arduino自动声明。新增构建与COM11/HTTP检查脚本和验收文档。验证：65项网页测试通过，集成版本编译及COM11写入校验通过；摄像头实际初始化成功。首次运行因栈溢出反复重启，修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
2026-09-30 验证栈修复后的实机通信与按需视觉任务
    行为：COM11 上验证 USB 模拟 Uno、可重复编号路线、CRC 拒绝、标签推进和反馈丢失停车；按需标签、猫及双识别均产生板载观测，测试后回到仅预览。
    验证：最终源码编译烧录校验通过，65 项 Node 测试通过；约 77 秒实机视觉任务测试持续出帧。提交可审查 JSON 结果和复现脚本。
    限制：电脑未取得热点 DHCP，HTTP 视频尚未验收；原 Wi-Fi 已恢复，等待确认外置天线。真实猫及贴纸识别准确率、长期温升、Uno UART 与实体运动均未验证。文档区分原网页与 ESP32 移植入口。
2026-09-30 增加 ESP32 网页启动脚本与笔记本热点访问说明
    行为：双击 BAT 启动本地 ESP32 测试页；自动复用可用服务，端口冲突时提示，后台输出记录于忽略目录。支持自选端口和仅启动不打开浏览器。HTTP 检查脚本支持 stationIP。
    验证：18766 端口验证首次启动和服务复用，页面及两个 ESP32 模块均返回成功；结束此次创建的测试进程。git diff --check 通过。
    限制：浏览器打开和双击 BAT 仍需用户操作验收。通过 COM11 配置用户指定笔记本热点后，35 秒内未获得 IP；待确认热点开启、2.4GHz 和外置天线。凭据不写入版本库。
2026-09-30 隔离最小 Wi-Fi 固件并记录 COM11 连线结果
    行为：独立程序仅启用 STA 和 USB 串口，打印连接 IP、RSSI、状态及断开原因码；配置模板入库，本机凭据头文件被忽略。附 40 秒串口监听脚本。
    验证：程序 846090 bytes、静态 RAM 45140 bytes，编译烧录及 Flash 校验通过。监听未发现 CONNECTED，反复 reason=201（SDK 定义 NO_AP_FOUND）和 status=6。完整固件源码及恢复步骤保留。
    限制：当前设备运行最小程序，无 HTTP、摄像头或机器人功能；热点 2.4GHz 广播与天线仍需确认。本次未观察到接入点，不将失败归因于密码或完整应用负载。
2026-09-30 恢复完整固件并验收笔记本热点上的 HTTP 视频与调试日志
    行为：ESP32 读取保存的 Wi-Fi 配置取得 stationIP，网页自动填写视频地址和板载调试链接，保留手动地址。HTTP 检查增加下位机注入日志验证，视觉检查支持逐模式视频测试和错误输出。
    验证：COM11 完整固件编译烧录及校验通过；192.168.137.22 上页面、状态、Uno 接收日志、JPEG 和五帧 320x240 MJPEG 通过。联网串口协议测试通过；标签、猫及双识别与视频复测通过，双识别连续三次 HTTP 检查通过。结束保持 IDLE 和 OFF。
    限制：首次猫模式 HTTP 子进程失败未保存原因，复测通过不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
2026-09-30 补充前向地面检测的论文背景与简化实现边界
    来源：回查 ESP32避障方案比较 对话，确认曾讨论单目地面识别/IPM 和地面外观学习；旧导出只有引用占位符，原链接未恢复。本次通过出版社及 PubMed 核验 Lee、Yi、Cho 2016 Sensors 16(3)311，DOI 10.3390/s16030311，补为研究背景引用。
    范围：代码仅是灰度块参考原型，未实现论文 IPM、MRF、自适应学习或距离估计；24块、35阈值和猫框0.88比例为项目参数。文档、来源表及代码注释同时说明，不引入论文性能结论。
    验证：git diff --check 通过。仅文档和注释修改，无运行逻辑变化，未重烧固件；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
2026-10-01 Increase ESP32 vision cadence and document AprilTag correction budget
    Reduce post-inference rest from 1500ms to 200ms while retaining the existing 350ms minimum start interval. Update the board debug page and README to distinguish processing time from the rest interval. Startup inference remains OFF and existing input/protocol formats are preserved.
    Record source-derived tag36h11 correction table sizes using the target compiler's verified 16-byte entry layout. One-bit correction needs about 0.99MiB; two-bit correction needs 34.85MiB and exceeds the board's 8MiB PSRAM. Keep correction disabled pending actual allocation and latency validation.
    Validation: full ESP32-S3 firmware compilation p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
2026-10-01 Expose slower patrol turns in ESP32 web controls
    Add independent patrolSearchPwm (45) and patrolAlignPwm (30) parameters, replacing patrol's previous 75/52 turning values. Keep interaction search/alignment and forward motion on their existing settings. Default-plus-saved-config merging supplies the new fields for existing NVS configurations without discarding saved routes or calibration.
    Provide labeled speed inputs and save controls in both the USB simulator page and onboard HTTP console. Read actual board values, allow integer PWM values from 30 to 150, disable saving during motion or with unsupported firmware, and persist through the existing stopped-only config operation. Show board-rep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
2026-10-01 Compress the ESP32 debug page and validate the complete uploaded firmware
    Move the editable onboard console to debug_page.html and generate a lossless gzip header during the existing build. Serve it with Content-Encoding: gzip while retaining every HTML control and script. Keep the cat model checksum, AprilTag dictionary, policy, serial interfaces, and stored configuration intact. Document the XIAO ESP32-S3 OPI PSRAM / maximum-app partition required for the complete image and the IDE default-slot size failure.
    Update HTTP checks for gzip and patrol control markers. Measure distinct on-device vision timestamps, actual observation rate, latency, and PSRAM in vision-smoke.py; add configurable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
2026-10-02 feat: add bounded ESP bench controls over Uno D12 software UART
    Replace the unreliable shared D0 receive path with 9600-baud SoftwareSerial
    on D12, retain hardware D1 return TX and separate USB line assembly, and
    move the buzzer to D13 and logical LED output to the ESP onboard GPIO21.
    Move fixed protocol strings into AVR Flash to retain SRAM headroom.
    Expose real/simulated UART readback, sensor/configuration data, four single
    wheel directions, and a visible manual-test avoidance bypass switch in the
    embedded gzip webpage. TEST_MOTOR carries signed left/right PWM, a bounded
    50..2000 ms duration, and SAFE/BYPASS. Bypass skips camera-front, side sonar
    and touch gates only for that transaction;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
2026-10-02 docs: record October 1-2 ESP32 and Uno integration milestones
    Document patrol oscillation diagnosis, visual frequency and firmware capacity checks, AprilTag print assets, motor mapping and PWM floor, D12 software UART round trips, memory reduction, and bounded ESP bench controls. Separate implemented and measured results from physical acceptance, unresolved D0 electrical causes, and ongoing Uno telemetry-stall diagnosis. Documentation only; validation: diff whitespace check and review against conversation evidence.
2026-10-03 docs: record power and UART diagnosis with front calibration acceptance
    Record USB-dependent motor behavior, no-motor reboot evidence, UART latency limits and session-lock behavior. Explain reference capture logs, fresh camera fields, obstacle comparison and Uno acknowledgement checks. Documentation only; checked against local reports and current source, no firmware edits, flashing or physical acceptance. Existing unrelated working changes remain outside this commit.
2026-10-03 feat: add Uno flow diagnostics and align host UART at 57600
    Upgrade Uno to V5.9 with optional nonblocking heartbeat and command/telemetry stage traces, SRAM reset breadcrumbs, RX overflow and deferred-drop counters. Show Chinese diagnostic explanations and three verbosity controls in the ESP debug page. Preserve existing D12 RX/D1 TX, D13 buzzer and ESP LED changes; synchronize the formerly stale sibling Uno working source to the current snapshot. Align ESP UART and Uno USB/software UART plus desktop handshake at 57600; ESP USB stays 115200. Document diagnostic limits without claiming a proven reset cause or hardware fix. Verified Uno compile (29202 Flash,1077 SRAM), ESP compile (3677718 Fla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
2026-10-03 fix: isolate Uno command buffers and reject zero policy reply IDs
    Keep active command tokens in a separate guarded buffer so ACK/DONE serial pumping cannot overwrite parameters of a deferred command. Add CRC-protected SRAM headroom and motor-state diagnostics, cumulative fault locking, receive failure summaries before tokenization, and output-stage breadcrumbs 70-74. Uno reports V6.1; ESP reports 0.7 and decodes the new memory diagnostics in the web log.
    Use a shared nonzero pending-ID predicate for policy feedback, errors and completion. ERROR 0 is logged as UNO_PROTOCOL_ERROR rather than matched to an idle motor slot. Preserve CRC validation, feedback/session timeouts, 57600 UART/Uno USB,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
2026-10-03 docs: capture Uno silence and stage 2 reset evidence
    Record telemetry 1137 stopping after the right sonar row, absent heartbeat and DONE, and eight seconds of COM10 silence without new commands. Preserve the ESP snapshot and direct USB reset capture showing Uno V6.1 PREV_STAGE=2 CMD=1137, followed by restored output and zero sampled memory flags.
    Explain the independent 2500ms sensor-row freshness threshold and 5000ms telemetry completion timeout plus roughly 2s retry delay. PING does not refresh sensor data; retained logs do not establish that a particular PING caused this disconnect. Inspection of tickTouches found a bounded four-input loop with serial output on touch transitions, not a d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
2026-10-03 chore: snapshot existing Uno V6.5 and ESP 0.11 bench before approved implementation
    Preserve the existing tracked changes and diagnostic evidence before introducing
    step-and-settle scanning. Capture compact CRC telemetry, reliable STOP retries,
    1 cm fresh-valid side sonar checks, removal of MOTOR renewal and the nonzero
    PWM floor, current debug interfaces, UART probes, wiring notes and approved
    implementation/acceptance requirements as an auditable baseline.
    Compatibility/configuration: existing firmware declares Uno V6.5 and ESP 0.11;
    USB still expects V6.4, search still uses the previous shared states, and the
    angle conversion and visual scheduling issues are intentionally not fixed in
    th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
2026-10-03 feat(uno): add bounded step-and-settle vision scan protocol
    Add the actual shared C++ ScanMachine used by Uno V6.6: bounded encoder steps, minimum settle/quiet window, matched scan/step/generation results, retransmission, and terminal reasons. All search budgets can be supplied for two turns using real geometry. Touch stops motion before logging. The narrowly scoped both-side rotation flag preserves touch/stall/session/memory protection and requires fresh side evidence at entry. Pure ROTATE and manual MOTOR remain separate.
    SCAN_CONFIG/SCAN_ROTATE/VISION_RESULT have compact aliases and require CRC. VQ/SD are CRC protected. GET_STATUS/GET_DISTANCE/GET_ENCODER now return the complete 50-byte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
2026-10-03 feat(esp32): coordinate fresh-frame two-turn scans and stopped cat approach
    Implement the approved shared Uno/ESP scan transaction: step rotation, local
    encoder settle, protected VQ with cumulative pulse budget, post-request camera
    capture, matching VR, and bounded completion. Keep pure ROTATE and manual MOTOR
    separate. Correct the extra PI division and cap all target searches at two turns.
    Make tag finding depend on the current numeric route ID in a new valid frame.
    Preserve saved parking width (default 0.25 only if unset), stop before alignment
    when already large enough, and advance the route only after checked STOP.
    Rearm repeated visits on a subsequent frame and bound loss/reacquisition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
2026-10-03 chore: record approved implementation, offline evidence and manual-reset uploads
    Document current Uno V6.6 / ESP 0.12 behavior, all existing CAT-01 through
    CAT-18 acceptance rows and new segmented-approach cases. Update four state
    flow diagrams, configuration mapping, search protocol references, repository
    entry points and session handoff context. Preserve dated historical latency
    and failure audit sections without recasting their measurements as new tests.
    Record final native assertions (Uno 199, actual ESP policy 429, camera gate
    and CRC pass), 85 Node passes and both compile sizes. Include source/application
    SHA256 manifest tied to firmware commit 87a2de6 and matching sibling Uno copies.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
2026-10-03 feat(esp32): make the minimum drive PWM adjustable from the web page
    Add minimumDrivePwm as a saved ESP configuration value: default 140 from the
    user's present measurement, integer range 1..255, preserved across the existing
    NVS config load/save path. Require confirmed STOP and no active debug transaction
    before changing it. Show board readback separately from unsubmitted input and
    keep a user's draft intact during status polling; disable unsupported firmware.
    Apply the floor once at the central sendUno boundary before framing/CRC for
    MOTOR, TEST_MOTOR, DRIVE, ROTATE, SR/SCAN_ROTATE and legacy MOVE/TURN. Preserve
    sign, zero, timing/distance/angle, scan keys/budget and safety flags. A reque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
2026-10-03 chore(firmware): provide an IDE size profile and identify firmware versions
    Document the user's default Arduino AVR 1.8.8 build failure: 33828 bytes
    against Uno's 32256-byte application limit, with static SRAM still 1379 bytes.
    Revalidate the existing full-feature optimized build at 32084/32256 Flash and
    1379/2048 static SRAM. Keep the actual board limit, all behavior, diagnostics,
    bootloader and upload semantics unchanged; Flash headroom remains 172 bytes.
    Provide firmware/ide-avr/platform.local.txt with exactly the three compile/link
    extra_flags properties used by build-uno.ps1: mcall-prologues, mrelax,
    no-split-wide-types, inline-limit=3 and linker relax. Explain user installation
    next t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
2026-10-03 Fix scan settling clock and expose stopped vision wait
    Uno V6.7 samples fresh time after motion completion and ignores pre-stop clock samples, preventing uint32 underflow from reporting a 3-second settle timeout immediately after MD. Preserve quiet-window safety, real timeouts and wraparound; synchronize the external Uno source copy.
    ESP V0.14 adds a readback-based 50-3000ms scanMinimumMs control, locks it until confirmed stop, preserves drafts and saved NVS/PWM/route settings, and extends settle timeout when required. Retain read-only field evidence and diagnosis; configuration timeout and alignment exhaustion were not reproduced and are outside this fix.
    Validation: scan core 215 checks,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
2026-10-03 Record ESP v0.14 upload and pending Uno port release
    ESP COM11 app-only upload verified by flash hash and HTTP firmware readback; partition table matched and saved PWM, route, arrival width and settle settings retained. User explicitly authorized upload reset.
    Uno COM10 upload attempts could not open the port; V6.7 has not been written and the fix is not active on Uno yet. Await user closing serial UI. No physical motion/UI acceptance performed. ESP build uses 3717718 flash and 78792 static RAM.
2026-10-03 Record verified Uno v6.7 upload
    After the user released COM10, AVRDUDE wrote and read back all 32162 application bytes successfully. ESP v0.14 and Uno v6.7 uploads are now complete; no extra source or configuration changes.
    Physical settling, UART reconnection, webpage persistence and tag patrol acceptance remain user-operated and unverified. Upload readback confirms flash contents, not real movement behavior.
2026-10-03 Retry rejected scan configuration with bounded 100ms gaps
    ESP v0.15 retries only SC configuration on BAD_CHECKSUM/BAD_ENVELOPE after 100ms, at most three retransmissions after the initial send. Missing confirmation waits 2500ms then uses the same retry gap; stop after exhaustion with the final reason. Require exact current-id SCAN_CONFIGURED before SR and ignore superseded replies.
    Cancel retries on stop/touch/new flows, preserve link and STOP safeguards, clear stale queued work before SC and pause ordinary telemetry while configuring. Motion commands and semantic rejections are not retried. Saved route, PWM, vision wait and NVS unchanged; Uno remains v6.7.
    Validation: production policy na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
2026-10-03 Record verified ESP v0.15 upload
    Application-only COM11 upload verified by flash hash and HTTP ESP32_CAT_HOST_0.15 readback after authorized reset. Checked confirmed stopped state and matching partition layout before upload; NVS route, PWM, arrival width and vision wait retained.
    Uno remains v6.7. Real UART selection, PING capability confirmation and repeated tag patrol acceptance are user-operated and unverified; no motion or UI tests performed.
2026-10-03 Retry scan starts without restarting existing scans
    ESP v0.16 immediately retransmits SR after BAD_CHECKSUM/BAD_ENVELOPE, or after 100ms without confirmation measured from actual dispatch. Limit to three retransmissions after initial send; retain command id, generation, motion parameters and frozen applied PWM. Pause telemetry until start confirmation, stop after exhaustion, and preserve semantic refusal/STOP protections.
    Uno v6.8 acknowledges duplicate scan identity before motion/side checks without changing progress; session/touch locks remain enforced. Identical terminal scan can repeat SD. Two Uno source copies match. No general movement retries, NVS/default changes or SC retry-rule cha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
2026-10-03 Record verified ESP v0.16 and Uno v6.8 uploads
    ESP COM11 app-only upload verified by hash and HTTP ESP32_CAT_HOST_0.16 readback; matching partitions and saved NVS configuration retained. After initial Uno sync failure, user disconnected UART and closed monitor; COM10 wrote and verified all 32206 bytes.
    User authorized reset for uploads. No UI or physical motion acceptance performed; user must reconnect UART and test tag patrol and retry behavior. Source implementation remains commit 03a17f1.
2026-10-03 Start patrol without legacy scan capability gate
    ESP v0.17 removes the SCAN_V1 declaration prerequisite from start/resume as requested: current Uno firmware is the fixed pairing. No manual PING or added capability handshake is needed. Keep declaration data diagnostic only; existing STOP/config/session/SC/SR flow and retries unchanged.
    Validation: actual policy 579 checks, scan 235, PWM/settings 2603, vision/wire gates pass. New real-UART tests start and resume through SR without PING, READY or any capability event. ESP builds 3720902 flash/78832 RAM; Uno stays v6.8. Preserve NVS and configuration. Physical/UI acceptance remains user-operated; upload recorded separately.
2026-10-03 Record ESP v0.17 upload and direct-start acceptance
    Verified COM11 application upload by flash hash and HTTP ESP32_CAT_HOST_0.17 readback after authorized reset. Confirmed stopped state and matching partitions before writing; NVS route/PWM/wait/arrival width retained. Uno stays v6.8.
    User can select real UART and start directly without PING. Physical/UI acceptance remains user-operated and unverified; implementation commit 6a0b735.
2026-10-03 Baseline ESP v0.17 and Uno v6.8 before cat interaction review
    Preserve the current tracked firmware and configuration defaults before reviewing cat response priority, repeated touch handling, and interaction exit rules. The working tree was clean; this explicit baseline commit intentionally changes no files.
    ESP32_CAT_HOST_0.17 and UNO_CAT_V6.8 remain unchanged. No behavior, saved device settings, protocol, or compatibility changes are introduced. Verification: read current version headers and git status; no new compilation, upload, UI operation, reset, or physical motion test was performed for this baseline.
2026-10-03 Document current cat interaction state machines for behavior review
    Inventory ESP v0.17 interaction entry, repeat touch branching, stopped-frame cat scanning and alignment, approach/probe/escape, observation, prey waiting, session exit, and failure/retry transitions. Include the Uno scan and motion executors, defaults versus saved values, and the distinct legacy web decision path.
    Anchor the review to unchanged baseline 81588be. Record discrepancies with the requested continuous interaction semantics without implementing them. No firmware, protocol, configuration, device setting, or behavior changes.
    Validation: read current ESP/Uno sources; checked all non-patrol action identifiers extrac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
2026-10-03 Plan continuous cat interaction and independent cat search
    Clarify WAIT_CHASE and propose explicit cat-width controls, first-touch-only response, resume after contact, post-action prey selection, unified departure evidence, and patrol-independent search startup. Record unresolved prey probability and stationary absence decisions for user review.
    Documentation only: ESP v0.17 and Uno v6.8 remain unchanged against baseline 81588be. No saved settings, protocol, UI code, firmware, upload, reset, or movement changes. Validation: inspected current policy and web configuration entry points; staged diff whitespace check passed. Implementation and automated/device acceptance remain pending user appr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
2026-10-03 Refine planned chase timeout and configurable prey triggers
    Record chase-timeout interaction exit, completed escape rounds with a default five-round prey trigger plus probability, configurable exploration minimum duration defaulting to 30 seconds, per-cycle probability decisions, and visible progress/configuration controls. Replace the earlier three-round exploration idea with the latest time rule.
    Confirm stationary prey behavior when the cat leaves the camera and manual MazeBot LED-strip control. Probability defaults and exact chase evidence remain explicitly pending review. This is a documentation-only plan update: no firmware, page code, saved settings, upload, reset, or tests changed.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
2026-10-03 Plan a web-configurable prey waiting timeout
    Expose captureWaitMaxSeconds separately from cat departure confirmation time, preserving saved values and the current 15-second fallback. Plan normal interaction exit on prey timeout with explicit timeout reporting, no false cat-departure claim, and no timer reset on repeated contact.
    Documentation only. Firmware and page code remain unchanged; implementation, compilation, upload, and automated/physical acceptance await approval. Staged whitespace check passed.
2026-10-03 Expose persistent cat width and interaction timing controls
    Add dedicated percentage, chase timeout, prey round/probability, exploration minimum time, departure and prey timeout controls with board readback, draft preservation and confirmed-stop locking. New probability fields default to 20 percent; legacy firmware settings remain stored but inactive end controls are hidden in the parameter editor.
    Regenerate configuration validation and compressed page. Validate with 20 automated page script tests; no UI, device, upload or motion test performed. Behavior implementation follows in a separate commit.
2026-10-03 Start cat search directly from idle without a patrol route
    Reuse checked STOP, geometry and session startup for independent cat search. Patrol interruptions preserve their route target; independent interactions close their session and return to idle. No legacy capability gate or preliminary patrol movement is introduced.
    Validation: actual native policy 599 checks, scan 235 and PWM/config 2603 plus vision and wire suites pass. No flashing, UI or physical motion testing yet; ESP version will increment with the completed interaction behavior.
2026-10-04 Keep cat interactions continuous and separate escape direction from running
    Ignore repeated contacts as new behavioral triggers while preserving Uno touch stops and resuming checked remaining motion/scan budgets. Move prey selection after completed escapes or exploration cycles, expose five-round/time/probability rules, add chase and prey timeout exits, and allow stationary valid-absence departure.
    Add explicit ESCAPE_DIRECTION and ESCAPE_MOVE progress, rotate away after cat-directed search, and poll telemetry every 250 ms only during SETTLE to avoid the old two-second sample wait. ESP version is 0.18; Uno remains 6.8 with unchanged protocol and physical touch checks. New native cat lifecyc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
2026-10-04 Complete current state inventory and verify ESP v0.18 build
    Document every current ESP action, shared startup/exit step and Uno scan/motion/sensor phase, preserving the v0.17 baseline separately. Add automated inventory and configuration-boundary checks, board-log save failure feedback, and explicit SETTLE sample diagnostics without displaying turn pulses as escape distance.
    Validation: policy regression 557, continuous interaction 149, scan 235, PWM/config 2622, vision and wire suites, plus 21 page and 2 inventory tests pass. ESP build uses 3728590 bytes Flash and 78920 bytes RAM; application binary 3728736 bytes. Uno source and external manual-upload copy remain identical at v6.8. Upload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
2026-10-04 Record verified ESP v0.18 upload and preserved settings
    Confirm COM11 ESP32-S3 identity, read and match existing partition table, write only the 3728736-byte app at 0x10000, verify flash hash and perform the user-authorized reset. HTTP readback reports ESP32_CAT_HOST_0.18 idle in SIM_UNO with no pending/unconfirmed stop or active motion.
    Preserve route [46,40], PWM 255, stopped-frame wait 200 ms, tag width 19 percent and cat width thresholds 12/35 percent. Verify new five-round, 30-second and independent 20-percent prey defaults plus chase/prey timeouts. Uno remains v6.8. No UI operation, physical motion, recognition accuracy or endurance testing; the user performs those acceptance steps.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
2026-10-04 Preserve validated ESP 0.28 and Uno 6.10 interaction changes
    Behavior:
    - Confirm cats using a configurable stationary interval and a fresh stopped
    frame; retain bounded scan retries, terminal result handoff and touch-stop
    continuation instead of redrawing the interaction branch.
    - Run escape movement to one sampled distance between saved minimum and
    maximum values, distinguish direction/turn/run progress, reacquire the cat
    after escape/prey/exploration inactivity, and bound continuous observation.
    - Offer 15 independent light/sound combinations (four forms each, excluding
    both off) with non-repeating selection, edge-triggered touches and parallel
    response during cat scanning/conf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
2026-10-04 Record user-confirmed spontaneous Uno reboot in log34
    The user confirms no interaction with Uno near its 19:02:34 Berlin READY
    and STAGE=74 CMD=94 boot record. Update the diagnosis and project summaries
    to identify a non-manual reboot about 107.6 seconds after capture opened.
    Do not attribute it to power, firmware, or buzzer solely from this breadcrumb.
    Keep the separate recovery CONFIG parsing defect documented and unfixed.
    Documentation only: no production code, configuration, upload, or motor
    operation changed. Cross-checked the recorded timestamps and user statement.
2026-10-04 Fix ESP 0.29 UART recovery and incomplete telemetry retries
    Raise automatic link recovery from three to four total attempts while
    preserving stop confirmation, session cleanup, configuration validation,
    and the final fault gate when no valid recovery can be established.
    Consume matching full CONFIG DATA in LINK_RECOVERY_CONFIG as well as normal
    startup. Validate command ID, finite geometry, slots and safety ranges,
    rejecting incomplete or malformed replies before accepting CONFIG DONE.
    Release a pending incomplete telemetry transaction only on a strictly
    matching, validated DONE TELEMETRY reply, then retry at the policy polling
    interval. Keep complete-snapshot publication, CRC enforcement,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
2026-10-04 Return unanswered active cat invitations to saved patrol routes
    Finish one robot invitation after its existing observation and decision wait
    instead of repeatedly selecting another approach/signal. Independent alert
    now resumes patrol too: reset stale route progress only when starting from
    IDLE/STOPPED, while alerts during patrol retain targetIndex and TAG_REARM.
    Close the interaction via checked STOP and SESSION_STOP before reopening the
    patrol session. Reset scan direction, alignment budget and old decision frame
    on patrol session start so cat-search motion state cannot pollute tag search.
    Do not fabricate routes: independent search remains allowed without a route,
    but its return reports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
2026-10-04 Document active-search transitions and verified offline results
    Update the current state inventory for robot first-attack handoff and saved
    patrol return; retain the historical ESP 0.17 baseline. Fill existing missing
    CAT_CONFIRM and five link-recovery action entries so the inventory check
    covers current source states.
    Append only this task's final chapter to both project-log editions, using
    the issues and verified results reported to the project-log chat. Existing
    uncommitted historical log sections and other experiment/UI work are excluded
    from the index. Record code commits 6a8052c and 4a99abe, route preservation,
    empty-route limitation, native check counts and the successful ESP build.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
2026-10-04 Identify the active-search deployment in the ESP firmware version
    Report ESP32_CAT_HOST_0.29_FPS_BENCH_3_ACTIVE_SEARCH_1 in the source header
    and /api/state so live readback distinguishes this deployment from the
    previous experiment build. No behavior or persistent config schema changes.
    Only the two version identifiers are staged; pre-existing bench/UI work
    remains outside this commit. Deployment uses the current combined experiment
    working tree with the already committed active-search behavior.
    Validation: ESP32 offline build passed, Flash3756806/8257536 bytes and
    static RAM83656/327680 bytes. Prior state-machine native checks remain valid
    because only version text changed. User explicitl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
2026-10-04 Record verified ESP active-search application deployment
    After explicit user authorization, upload only the ESP32 COM11 application
    at 0x10000. Check current IDLE/no motor/no pending or unconfirmed STOP,
    match all copied build sources, and compare the 3072-byte device partition
    table at 0x8000 to the compiled table before writing. NVS, bootloader and
    partition layout are preserved. Uno firmware was neither changed nor
    uploaded; future Uno upload requires prior notice for serial unplugging.
    Save partition/build/upload logs, application SHA256 and before/after HTTP
    state evidence. Upload wrote 3756960 bytes in 25.5 seconds with data hash
    verified. Readback reports the ACTIVE_SEARCH_1 version,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
2026-10-04 Count completed invitation actions and add bounded fast-to-slow approach
    The prior one-observation exit cut invitations short after about 7.5 seconds
    (log39). Replace it with a default budget of five completed high-level
    actions, as explicitly confirmed by the user. Fast approach, slow approach,
    a complete three-step probe, signal, observation/static wait each consume
    one action; scanning, short DRIVE segments, settling and inter-action waits
    do not. Count once on completion and exit at the budget, returning to the
    saved patrol route through existing checked STOP/session handshakes.
    Far approach selects the existing approach/probe probability group; approach
    now runs bounded fast segments u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
2026-10-04 Expose saved invitation probabilities, counts, widths and timing in the console
    Add an active-search control panel with five-action limit, bounded fast
    approach distance/PWM, slow flashing probability, far/probe and stopped
    signal/observe/static probabilities, cat-width thresholds, observation and
    inter-action waits, light and beep durations, and existing slow/probe tuning.
    Display completed actions/current action, fresh camera cat-width percentage,
    control distance classification and effective fast/slow PWM after the floor.
    Do not label old or invalid camera data as a current detection.
    Save through the existing config/NVS API, require confirmed stop, validate
    probability groups, integer a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
2026-10-04 Honor independent signal light and buzzer durations before action completion
    When signalBeepMs exceeds signalFlashMs, the old SIGNAL deadline stopped
    both outputs at the light deadline and truncated the requested beep. Keep
    individual output durations, but wait for max(light,beep) before completing
    and counting the invitation action. Exploration response timing is unchanged.
    Identify the final deployment as ACTIVE_SEARCH_3.
    Regression sets light100ms/beep800ms and confirms no completion at100ms,
    then exactly one action counted at800ms. Native checks passed on the current
    combined tree; no Uno firmware/protocol/config-schema changes.
    Only this duration fix, test and two version identifiers a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
2026-10-04 Record final five-action invitation deployment and configuration preservation
    Document the confirmed completed-action counting contract, bounded fast-to-
    slow motion, parallel slow flashing, configurable probabilities/widths and
    observation/light/beep timings. Record the max-output-duration fix and the
    PWM255 floor limitation. Append only this task's final chapter to both log
    editions, reporting implementation issues and results to the log chat.
    Save source-linked deployment evidence for ACTIVE_SEARCH_3: checked COM11
    partition3072B equals compiled layout, application-only write3760560B at
    0x10000 in25.3s, data hash verified and RTS reset. HTTP readback reports
    IDLE/SIM_UNO with camera init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
2026-10-05 Implement three-frame cat checks and local inference preview console
    Keep CAT_CHECK stopped while requesting up to three fresh frames, accept the
    first valid positive, and fault safely on invalid/timeout results. Add persisted
    catCheckMaxFrames (integer 1..3, default 3); preserve CAT_CONFIRM behavior.
    Include the current vision benchmark, separate tag/cat centering settings and
    live flow panel. Arrange sensors, serial controls and camera into three columns,
    with settings below and performance tests last. Pair inference JPEG and metadata
    under frameLock, draw boxes locally and show decode/model/total timing history.
    Preview results remain independent of policy confirmation; no cloud processi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
2026-10-05 Document cat-check preview deployment and disconnect evidence
    Append a distinct 2026-10-05 chapter to the chronological and classified
    project logs, referencing firmware/UI commit 79f8a71 and saved evidence.
    Describe the three-fresh-frame CAT_CHECK scope, persistent configuration,
    matched JPEG preview, and remaining single-frame and segmented-motion paths.
    Record existing compile, upload hash, USB readback, configuration preservation
    and offline checks separately from the final PREVIEW HTTP timeout and pending
    user/physical acceptance. Do not claim motion, preview HTTP or full oscillation
    resolution. Distinguish the two heap snapshots from proof of a leak and the
    four startup snapshots from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
2026-10-05 Document Web disconnect investigation and pending recovery validation
    Append an independent 2026-10-05 chapter to both project logs describing the
    whole-page disconnect report, historical-IP request timeouts, source-confirmed
    HTTP defaults and polling risks. Keep actual cause unresolved and distinguish
    configured intervals from measured rates and existing core auto-reconnect.
    Record WEB_RECOVERY connection recycling, bounded state lock, fresh-image
    fetching, failure backoff, network diagnostics and modem-sleep power tradeoff.
    Preserve 44/44 page checks and lossless gzip sizes; mark firmware compilation
    pending and deployment, stability, recovery and power acceptance untested.
    Validation: r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
2026-10-05 Complete Web recovery log with current-IP measurements and final build
    Append a follow-up to both project logs updating the previously unconfirmed
    IP and pending compilation. Record five client-inclusive PowerShell timings,
    three curl connection/TTFB/total timings, and distinguish HTTP200 truncated
    body exit28 from complete requests. Preserve uptime/frame/heap evidence and
    avoid attributing the slow response to a unique cause or memory leak.
    Document afterLog incremental fetch scope and possible high-rate log gaps,
    complete diagnostic API retention, and old-snapshot payload estimates rather
    than claiming measured new-firmware speed. Record final 45/45 page checks,
    lossless gzip sizes and su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
2026-10-05 Record authorized Web recovery upload and bounded HTTP verification
    Append deployment results to both logs without replacing prior pre-upload
    status. Document COM11 identity, stopped SIM_UNO startup snapshot, matched
    partition, app-only verified write, HTTP version/page readback and preserved
    configuration. Record 20 complete incremental requests and min/median/P95/max
    with their actual 13.4-second sample window, distinguishing earlier readback
    uptimeStart from the poll start.
    Keep short post-reset SIM_UNO/IDLE results separate from old UART load; do not
    claim causal speedup, long-term stability, motion or hotspot recovery acceptance.
    Validation: read updated report and verification JSON;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
2026-10-05 Record eight-client HTTP checks and interim Uno web simulator work
    Append a dated section to both logs covering verified 0.31 app-only upload and
    40 successful eight-way reads, bounded to idle simulation without telemetry.
    Document complete compact telemetry and motion/scan simulation, observed page
    fields and simulated pulses, batch replies and local bridge for per-line loss.
    Preserve TCP reset and minimum heap544 risks despite zero WiFi disconnects.
    Distinguish SDK socket budget from tested concurrency, staged 0.32 metadata
    from final 120 JS checks, and compiling 0.33 from deployment or sustained UI
    acceptance. Physical, real UART and long-run verification remain unproven.
    Validation: re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
2026-10-05 Document shared HTTP deployment and sustained simulated page results
    Append independent chapters describing 0.34 app upload and preserved settings,
    single-service socket budget, four asynchronous streams, new stream address,
    serialized page/simulator requests and browser fetch invocation correction.
    Record 180-second four-video run, 120 page samples and 30 extra API requests.
    Separate retained display with zero whole-page disconnects from five stale
    samples and one failed fetch. Preserve minimum heap248 pressure and clarify
    that socket capacity is not performance or unlimited concurrency acceptance.
    All sensor/motion values remain SIM/DRY_RUN with physical IO disabled.
    Validation: read fin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
2026-10-05 Preserve ESP 0.34 shared HTTP baseline before unified cat search
    Snapshot the existing firmware, Web UI, network health and video stream support, HTTP transport and Uno simulator sources, regression tests, and project documentation before removing cat centering. This commit preserves the current distinct ROBOT_SEARCH and CAT_TOUCH post-search policies and existing saved settings.
    Validation: baseline source snapshot only; existing recorded verification remains in the project documentation. No new hardware test, serial command, firmware upload, or remote push was performed for this snapshot. Raw untracked capture and temporary evidence files remain on disk.
2026-10-05 Unify cat search confirmation and remove cat centering in ESP 0.35
    All successful CAT scans now use the same confirmed STOP, encoder settle, configured confirmation wait and fresh stopped frame for ROBOT_SEARCH and CAT_TOUCH. Cat centerX and alignment tolerance no longer gate success or issue ALIGN_CAT rotations. Robot behavior selection reuses the confirmed frame rather than entering another stop/check cycle. CAT_CONFIRM requests its final frame without briefly changing to CAT_CHECK.
    Retain scan budgets and retry limits, touch preemption, link/stop safeguards, approach segment settle checks, escape turns and tag alignment. Saved cat centering/PWM/timeout settings remain compatible but are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
2026-10-05 Wait for sustained cat absence in invitations and chase observation
    ESP 0.36 shares the existing catLeaveSeconds departure window between robot OBSERVE/SIGNAL/FOLLOW_WAIT and WAIT_CHASE. Require fresh valid distinct negative frames across the interval; reset on detection even for a far cat, invalid/stale observations or contact. Hold the stopped observation while confirming absence so elapsed action/chase deadlines cannot exit early or start motion. Preserve contact preemption.
    Measure WAIT_CHASE unavailable-frame timeout from the current outage instead of observation entry, and clear it on valid recovery. Retain the normal chase timeout when the cat remains present, motion safety guards, s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
2026-10-05 Complete robot invitation action rounds despite losing the cat
    Honor the clarified robot interaction rule: after first finding a cat, complete robotActionLimit high-level behaviors (default five) before normal return to patrol. Remove the robot observation catLeaveSeconds exit and convert valid negative stopped checks into stationary observation instead of ending the interaction. If a target is lost before approach/probe or between behaviors, continue with complete observation actions instead of driving blind or rescanning into an early failure. Interrupted movements are not counted as completed.
    Keep catLeaveSeconds grace and independent unavailable-frame timing in WAIT_CHASE, prey departu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
2026-10-05 Preserve ESP 0.37 and project log baseline before dual-wheel scan changes
    Snapshot the existing project-log and categorized-log edits before changing scan angle accounting and adding stopped tag inference retries. Firmware and Web sources remain at committed ESP 0.37 de87ca2; no new motor/vision algorithm change is included in this baseline.
    Validation: source/document preservation only. Existing source verification is recorded in prior commits. No upload, serial connection, physical test or remote push performed.
2026-10-05 Calculate scan budgets from both wheels and retry stopped tag detection
    Uno 6.11 accumulates the integer sum of both encoder deltas, including settling coast, and retains odd sums rather than rounding every step. Extend CRC-protected VQ with twice-mean progress; ESP 0.38 validates both formats, labels legacy max-wheel reports, uses mean progress in completion/contact/side handoffs, and prevents late MD double credit. SR remains an integer budget, conservatively rounded down when resuming fractional progress. New Uno and ESP must be upgraded together; old ESP cannot consume extended VQ.
    Add persisted tagScanMaxFrames (default 3, integer range 1-10), stopped-only web controls and board readba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
2026-10-05 Fix installed Uno build profile and document paired firmware deployment
    Update the AVR IDE profile with no-inline-small-functions, matching the proven build script. Back up and merge the installed AVR 1.8.8 platform.local.txt without changing board capacity, bootloader or upload settings. A fresh CLI compile without build-property overrides produces 32244 bytes flash and 1381 bytes static SRAM; the running IDE daemon may require an IDE restart to reload the profile. Back up and synchronize the external Uno sketch copy with the repository.
    After the user confirmed cable disconnection and monitor closure, upload Uno 6.11 on COM10 with verify and exit 0. Read-only PING/config replies were capt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
2026-10-05 feat(esp32): persist complete browser logs and expose shared camera settings
    Archive every received application log in browser IndexedDB, separate from
    current-boot policy windows. Deduplicate by device/boot/sequence, record reboot,
    disconnect, missing sequences and camera settings, retain unlimited row history
    within browser quota, and export all durable plus pending rows offline while
    serializing export with ingestion. Bound only display memory to 500 entries.
    Report storage/read failures without silently truncating successful exports.
    Expose 18 supported sensor settings shared by tag and cat recognition. Validate
    and apply on the stopped control loop with capture locking, persist driver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
2026-10-05 fix(esp32): use OV3660 register gain ceiling and verify deployed 0.40
    Real 0.39 deployment returned OV3660 gain ceiling 248, so applying all camera
    settings failed the generic 0..6 validation. OV3660/OV5640 use 10-bit register
    units. Read the full register, validate 0..1023, write the sensor-specific mask,
    and expose its limits/unit to the web UI; keep other sensors on enum 0..6.
    Reject missing register readback and exercise rollback in native tests. Do not
    clamp a raw ceiling to an enum or silently lower startup camera settings.
    Compile and deploy 0.40 on COM11 only after confirmed idle, binary-hash and
    3072-byte partition-table checks; write app only at 0x10000. Preserve both
    upload attem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
2026-10-06 docs: record unresolved ESP reset and shared L298N power investigation
    Document the captured boot transition, POWERON reason, archive coverage and separate heap-pressure evidence. Preserve the user correction that replacing the VUSB Dupont wire did not resolve the recurring power LED flicker and reset.
    Record the reported shared driver-board 5V supply to ESP32 and Uno, fitted 5V-EN jumper and estimated two-cell 18650 input. Treat regulator headroom and load-induced voltage collapse as hypotheses pending board and voltage measurement. Include a single-source USB isolation comparison and retain the original journal only; no firmware, configuration, flash or hardware operations.
    Validation: c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
2026-10-06 docs: clarify XIAO charge LED and external power diode diagnosis
    Record the user report of stationary flicker and a single external 5V power source. Separate unsupported backfeed and motor-start hypotheses from observed symptoms.
    Verify the XIAO ESP32-S3 target and Seeed manual: external 5V requires a series diode and the onboard red LED indicates charging. Keep LED location pending user confirmation and distinguish LED activity from the boot transition already captured. Update only the original project journal; no firmware or hardware operations.
    Validation: official Seeed documentation and repository board configuration checked; journal whitespace check passed.
2026-10-06 docs: record confirmation that flashing LED is on the ESP board
    The user confirms the flashing red LED is on the ESP32 board, resolving the pending location question. Record its charging-indicator interpretation while retaining the independently logged reset and unresolved supply diagnosis.
    Validation: original journal whitespace check passed. No firmware changes or hardware tests.
2026-10-06 docs: capture live camera no-frame diagnosis and persisted JPEG setting
    Record user-reported working control paths and missing preview under both external and USB power. Save three read-only HTTP states showing successful camera initialization, zero published frames, a ready video worker and persisted JPEG quality 1; document capture endpoint HTTP 500 separately.
    Treat JPEG frame-size pressure as an unconfirmed hypothesis and suggest default-quality comparison before connection or driver checks. No device configuration, serial, motor, reset or power operations. Update the original journal only.
    Validation: journal whitespace check and live read-only state/capture requests; physical power s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
2026-10-06 docs: record successful JPEG adjustment after transient camera busy
    Record the user report that JPEG quality was changed to 15 while the ESP charging LED still flashes. Distinguish the sensor-lock timeout from a proven permanent deadlock and leave preview recovery and uptime continuity unverified.
    Validation: checked lock/error control flow and journal whitespace; no firmware edits or hardware operations.
2026-10-06 docs: diagnose scan jumps from post-stop encoder count anomalies
    Analyze the newest boot in the local-history export and save reproducible pairing of 45 scan steps. Commands remain at PWM 150 with 106-159ms motion spans; large post-stop encoder jumps inflate estimated scan travel, including 303.75 and 136.6875 degree increments, without proving physical rotation.
    Document independent wheel stopping, encoder edge filtering, settle-time budget accounting, vision-wait gaps and configured PWM floor as distinct mechanisms. Preserve user-observed jump and camera recovery while leaving signal noise, coasting and exact missed views unproven. Update only original journal and evidence; no firmware ch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
2026-10-06 chore: preserve baseline before tag approach recovery changes
    Baseline source and evidence are at a10c7df; deployed ESP firmware remains 0.40. Preserve current tag approach single-frame loss behavior, direction selection and original scan budget before introducing loss grace, stationary recheck and bounded directional recovery.
2026-10-06 fix: recover lost patrol tags with grace and directional local search
    Problem and behavior:
    - A single missing target frame during approach used to STOP and start another
    full tag scan. Hold only an already confirmed forward command during valid,
    fresh target-negative frames for tagLossGraceMs, without renewing its deadline.
    - After checked STOP and two encoder epochs, recheck stationary TAGS frames up
    to tagScanMaxFrames. Invalid/stale frames, unexpected encoder movement,
    feedback loss, obstacles and touch/link preemption retain stopping behavior.
    - Keep two target-local observations for at most five seconds. Search toward
    last position/trend, reverse locally, then spend the remai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
2026-10-06 fix: port simplified cat confirmation and complete approach actions to 0.41
    Port maintenance change f847e6e onto the 0.41 tag recovery baseline. Preserve tag loss grace, stationary recheck, directional recovery and NVS-write verification while sharing maximum-three cat confirmation and removing 1 cm approach segmentation and additional delay. Preserve existing configuration compatibility and protections. This is a source integration commit; 0.40 deployment evidence applies only to the maintenance branch, and integrated 0.42 validation follows. No 0.41 upload is authorized or performed.
2026-10-06 feat: share bounded directional cat and tag recovery in ESP 0.42
    Extend 0.41 target-local position/trend memory and local/reverse/full-budget recovery to cats using one shared engine and separate target memories. Reacquire a cat lost after complete approach/probe motion without redrawing behavior or resetting remaining distance. Count up to three fresh frames per stopped cat scan position, reject duplicate and mismatched callbacks, and preserve bounded scan budgets and UART handoff retries. Keep tag-only forward-loss grace and tag ID/arrival criteria; clear memories on stop, ending, new interaction, link/config/camera invalidation. Preserve NVS write verification and Uno protocol/motor/encod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
2026-10-06 docs: prepare dual-branch escape obstacle avoidance handoff
    Document the reported rear blind spot during 180-degree cat escape and require fresh sonar and camera observations at segmented turn checkpoints. Define sensor geometry verification, unknown-data handling, bounded direction selection, configuration compatibility, and physical acceptance boundaries.
    Provide a ready-to-use agent prompt and require equivalent maintenance/main fixes without importing main target recovery into the 0.40 maintenance line. Documentation only; checked staged diff, no firmware changes or hardware actions.
2026-10-06 Revise escape flow with preturn safety gate
2026-10-07 Align main configuration saving with maintenance behavior
    Apply validated settings in RAM before saving to NVS, as requested. Retain recovery memory invalidation and existing schema validation. Remove complete-write helper and its tests; failed persistence may leave RAM and reboot values different. No device operations. Full offline verification follows with the visibility changes.
2026-10-07 Show target widths and ground calibration freshness on main
    Display cat and route target widths as image percentages with explicit missing, invalid, stale, offline and simulated states. Show board calibration/reference completeness, front switch, latest judgment and ground difference/threshold. Capture timestamps prevent pre-calibration or invalidated frames from claiming current calibration. Reuse polling and inference outputs without motor or detection changes. Main keeps directional cat/tag recovery; validate approach/probe resumption without action redraw or counter reset. 14 native executables and 69 Node tests passed; offline ESP build 3805410 flash / 85720 RAM bytes with six source ha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
2026-10-07 Record authorized main application deployment and configuration readback
    Upload tested main code 89e9716 to ESP32 COM11 application offset 0x10000 only after stopped host readback and byte-identical 3072-byte partition check. Esptool verified flash hash. All 95 pre-existing policy keys and camera settings match after reboot; two recovery defaults added. USB and HTTP identify main 0.42, and served page contains cat width, target tag width and calibration status. Current address 192.168.137.25, SIM_UNO/IDLE, uncalibrated ground and front avoidance disabled. Preserve existing settings, leave Uno unchanged and perform no motor/physical acceptance tests. Maintenance remains unflashed. No push or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
2026-10-07 Show physical camera measurements in simulated UART mode
    Prefer actual cat preview and camera observations regardless of UART simulation mode. Fall back to explicitly labeled simulated inputs only when no physical measurement exists. Preserve physical negative/stale results rather than substituting simulated detections; fix target tag and ground status sources too. Add mixed physical/simulation regressions. 71 Node tests passed. Display-only change; robot policy and inference timing unchanged. Offline build and authorized main deployment follow.
2026-10-07 Capture and verify fresh ground reference from preview with clear button feedback
    Match front controls to board stop confirmation and busy state, show pending/readback/errors instead of treating accepted HTTP as success. Calibration explicitly requests two stationary fresh TAGS frames: save reference, then verify reference use; normal inference mode is unchanged. Enforce ticket identity, stop/busy checks, cancellation and 8s timeout. Expose frontCalibration status and describe actual image region and empty-floor method, excluding wall boundaries and calibration rulers. 75 Node tests and 15 native executables passed, including 22 calibration checks. Motion/search behavior unchanged. Offline c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
2026-10-07 fix: show capture and verification progress during ground calibration
    Display the board calibration stage immediately, including after page reload. Preserve measurement refresh and robot behavior. All 75 Node checks passed.
2026-10-07 test: verify final automatic ground calibration main firmware
    75 Node checks and 15 native programs passed. ESP32 offline build uses 3808550 bytes flash and 85776 bytes static RAM. Seven critical source inputs match compiled copies; preserved application SHA256 recorded for authorized app-only upload. Physical calibration and obstacle acceptance remain pending.
2026-10-07 feat: balance straight wheel motion locally on Uno
    Apply bounded encoder-based PWM reduction to the leading wheel during equal-command forward/reverse motion. Preserve requested PWM, stopped/distance-complete outputs, motion safety, turns and scanning. Reset on every new/stopped action; exclude DRY_RUN and bypass tests.
    Replace general integer/hex conversion with bounded protocol-specific parsers; retain valid syntax and CRC acceptance, reject 32-bit overflow. AVR build flags and bootloader unchanged. Uno V6.12: 31902B Flash, 1387B SRAM; rollback tag and baseline V6.11 HEX recorded.
    Validation: 16 native programs, 68847 direct Uno-motion/parser checks and 153 Node checks passed. No flash o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
2026-10-07 docs: verify Uno deployment and record three layers of tag-loss handling
    Authorized COM10 Uno 6.12 upload and independent 31902-byte Flash comparison succeeded. Checked STOP/session, PING and complete stopped telemetry over 2189ms; outputs/counts zero, ESP config unchanged. Startup noise persists; real ESP-Uno UART and physical straight-line acceptance remain pending.
    Connect software left/right tag recovery, consistent supply/minimum PWM work, and Uno encoder balancing without claiming unmeasured voltage or solved overshoot. Record rollback tag/HEX and deployment evidence. Normalize line endings in main page-source test; 12 checks passed. No push.
2026-10-10 fix: checkpoint front obstacle priority and adjustable parameters
    Preserve the existing 2026-10-07 ESP32 0.42 FRONT_APPROACH_PRIORITY work
    as the user-authorized baseline before front-avoidance v2 development.
    Fresh calibrated BLOCKED observations take priority during tag/cat approach.
    Tags advance after matching STOP confirmation; cats enter existing nearby
    interaction while STOP runs in parallel. Pending STOP permits only bounded
    interaction LED/BEEP outputs and continues to block new motion. Invalid,
    stale or uncalibrated approach observations wait/stop rather than imply arrival.
    Expose existing floorDifferenceThreshold, floorRoiTop, frontBlockBottom and
    visionMaxAgeMs as editable contro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
2026-10-12 feat: add remote patrol resume and enforce the front avoidance switch
    Add leased manual motion, independent speed, shared sound/light sequences,
    custom ordered route editing, and resume from a selected route occurrence.
    Pair ESP 0.47_SWITCH_FIX with Uno V6.13 REMOTE_V1 capability; accept real
    GET_CONFIG bare DONE responses so stationary remote takeover does not time out.
    Persist routes and the front switch as independent small NVS records with
    immediate readback. Restore legacy config when no independent record exists.
    This avoids rewriting the large ground-reference config for small edits.
    Sync confirmed switch changes into the advanced JSON editor so a later
    parameter save cannot restore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
2026-10-12 docs: reconcile recent project chats and record switch fix acceptance
    Review October 6-12 project conversations against the existing project log,
    deduplicating forked messages and excluding approval and unrelated records.
    Add missing approach-gate diagnoses, preview/inference distinctions, algorithm
    provenance, baseline preservation, and the unsuccessful public-data v2 trials.
    Preserve scene-macro versus pooled-pixel metric definitions and distinguish
    source checks, offline tests, firmware verification, and physical evidence.
    Record the deployed 0.47 front-switch enforcement, small NVS persistence,
    and advanced-JSON synchronization fixes. Add the user's qualitative test
    acceptance without i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
2026-10-12 docs: organize the complete project log by problem and growth themes
    Create a canonical thematic project log spanning the entire September 30 to
    October 13 source. Organize all 138 nonempty source record bodies into ten
    problem domains, retaining each body verbatim exactly once with its original
    heading, parent context, line reference, and evidence links. Add chapter
    navigation, cross-domain references, six storytelling outlines, and a grounded
    capability-growth map for later retrospectives and presentations.
    Keep dated implementation and acceptance boundaries explicit: source checks,
    offline validation, firmware integrity, physical observations, user feedback,
    and unresolved root causes re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
2026-10-13 docs: record escape merge assessment and straight-flight literature
    Record the fetched origin/main escape implementation and a trial merge against
    DEV without modifying the deployed or development firmware. Document the two
    policy conflicts, retained DEV behavior, stale test expectations, and remaining
    clearance and touch-resume gaps.
    Verify the AAFP/ISFM recommendation for straight, swift movement away from cats,
    distinguishing guideline advice from comparative preference experiments. Keep
    sensor coverage and stopping-distance requirements separate from play design.
    Validation: trial-merge approach-front (144), front-switch (8), and action-resume
    (41) checks passed. policy-core and cat-in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
2026-10-13 feat: search escape headings with side-gated quarter turns
    Keep the first-attack cat search and stopped confirmation before selecting escape. Gate each 90-degree turn solely on fresh side sonar above configurable clearance and the Uno local limit; current front BLOCKED, INVALID, stale or uncalibrated results do not prevent rotation. Search at most three alternative headings without revisiting the original direction.
    Require a new calibrated front observation after turning, then run a continuous straight escape. Keep FLOOR sensing and front protection active regardless of the ordinary front switch. Stop and search again on a new obstacle while preserving the remaining distance and search bud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
2026-10-13 docs: record 0.48 flashing and firmware version readback
    Flash only the ESP32 application at 0x10000 after a byte-for-byte partition comparison. Read back ESP32_CAT_HOST_0.48_ESCAPE_QUARTER_SEARCH with IDLE/SIM_UNO, camera initialized, no pending/unconfirmed STOP, threshold 15 cm and retained route 43,46,51. Uno firmware and hardware mode are unchanged.
    Per the user's explicit request, acceptance uses the running firmware version without full application readback or an extra hash check. Record the interrupted pre-write backup attempt and the retained previously verified 0.47 application artifact; do not describe it as a new device backup. Bench and physical motion acceptance remain pending.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
2026-10-13 fix: consume continuous floor observations after escape turns
    The 0.48 runtime log shows three completed quarter turns followed by escape front vision timeout without DRIVE. The stopped check requested FLOOR through VisionGate, which only supports CAT/TAGS; the native request recorder had hidden that integration defect.
    After confirmed stop and encoder settling, cancel old requested work and capture a frame/time barrier. Read the continuous FLOOR observation directly in policyTick without requiring ticket generation or step matching. Require a newer frame captured after the barrier; retain calibration, freshness, invalid-input stopping, blocked-front rerouting and bounded timeout. Side sona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
2026-10-13 docs: record 0.49 flash and version readback
    Compare the device partition table byte-for-byte and write only the COM11 ESP32 application at 0x10000. After reset, read back ESP32_CAT_HOST_0.49_ESCAPE_CONTINUOUS_FRONT, IDLE/SIM_UNO, camera initialized and no active motor or pending/unconfirmed STOP. Full config JSON is unchanged, including the disabled ordinary front switch, 15 cm escape clearance and route 43,46,51.
    Acceptance follows the user's requested version readback without an extra hash check or full application readback. Preserve the existing 0.48 artifact for rollback. Boot restores SIM_UNO from the preflash UART mode; no automatic hardware-mode change or movement was issued. Physic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
2026-10-13 Implement one-use Uno receive windows and move host RX to D13
    Uno V6.14 advertises CRC-protected RX window IDs only after hardware TX drains.
    ESP 0.50 sends one CRC-protected R/window/C command envelope per grant, allowing
    for turnaround and command wire time. Used, expired and interrupted grants
    cannot execute normal commands. Urgent STOP and its bounded retries remain
    available without a grant; USB commands and SIM_UNO retain their prior protocol.
    Move SoftwareSerial RX from D12 to D13. Move the former buzzer output to D12
    and disable it by default because the buzzer has been removed. Update wiring
    and page descriptions. Replace the legacy H diagnostic heartbeat with short
    RX availability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
2026-10-13 Record verified UART window deployment and stationary measurements
    Deploy db1d28d to Uno COM10 (V6.14) and ESP COM11 (0.50), with user-confirmed
    D13 receive wiring and restored D1 return wiring. Uno upload --verify exited
    zero; USB startup/config/telemetry readback confirmed the running sketch.
    ESP partition compatibility was checked before an app-only write at 0x10000,
    and esptool verified the written image hash. Device images were not backed up,
    as explicitly requested; rollback uses Git baseline 276308b and D12 rewiring.
    Record one 30.516-second stationary real-UART capture: after the UART mode
    marker, 376 grants and 15/15 completed sensor requests, 38-70 ms latency
    (median 56 ms, P95 70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
2026-10-14 Document UART receive-window incident and historical latency comparison
    Describe heartbeat-only command failure, stale telemetry, retry delays and
    unconfirmed STOP without claiming continued physical motion or a unique cause.
    Record deployed D13 receive windows, single-use CRC grants and emergency STOP.
    Recompute the supplied ESP0.49 history and committed ESP0.50 stationary capture:
    47 requests / 2 captured complete versus 15 / 15; successful TX-to-DONE median
    46.5 versus 56 ms, unchanged 9 ms ACK median, polling interval 7002 versus 2000 ms.
    Compare earlier 9600 and compact-protocol records while retaining conditions,
    small-sample limitations and separate enqueue, HTTP, vision and physical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
2026-10-14 Include command dispatch waiting in UART latency review
    Correct scope of previous TX-to-DONE statistics: 56 ms excludes queue/grant
    waiting and cannot represent request-to-execution/completion latency.
    Reinspect historical load driver, current/previous dispatch source and capture.
    Neither capture has per-command enqueue or precise Uno execution-start stamps.
    Add reproducible grant matching: 15 telemetry grants to DONE have median 61 ms,
    P95 92 ms; these still exclude pre-grant waiting. Record MODE trigger timeline:
    STOP confirms at 72 ms, SESSION_STOP rejects at 175 ms, GET_CONFIG completes at
    223 ms with 194 ms before actual send. Distinguish old SIM drain, expired grant,
    ACK reception and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
2026-10-14 Compare healthy UART histories and correct protocol benefit attribution
    Record user's newly discovered poor contact as hardware evidence. Stop using
    recent fault capture 2/47 versus deployment 15/15 as a protocol reliability gain:
    contact handling, D13 migration and receive-window change were not isolated.
    Analyze six existing exports per boot/sequence, matching three TB fragments and
    DONE, filtering reported motion flag and commanded/output PWMs for stationary
    samples, ending runs at gaps, modes and captured errors. Preserve per-boot
    firmware rather than assigning final snapshot version to earlier history.
    Healthy old Oct7 run: 343 samples, TX-to-DONE median/P95 41/64 ms.
    Current Oct14 ru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
2026-10-14 Checkpoint straight-balance baseline
    Capture the pre-task ESP32/Uno straight-balance and policy work as a reviewable baseline before changing front-avoidance toggle semantics. Includes balance settings, ESP configuration and policy updates, generated debug page, Uno controller/simulator changes, focused test sources, and the current cat-interaction state note.
    Validation: no tests or hardware actions run for this checkpoint. Local evidence archives and build output remain outside this commit.
2026-10-14 Honor front avoidance switch during escape
    Make frontAvoidanceEnabled govern the escape path as well as the existing tag approach, cat approach, probe, interaction, and ordinary manual-test gates. When enabled, escape continues to require a fresh calibrated FLOOR=CLEAR after turning and while moving. When disabled, it skips that visual gate and selects OFF vision mode during escape; side sonar, touch handling, encoder/stop confirmation, and UART protections remain active.
    Update the console text to say the switch includes forward travel after escape-direction turns. The separate phone remote-control path still has no front-vision obstacle gate and is not governed by this switch.
    Validation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
2026-10-14 Finalize front-avoidance switch firmware 0.52
    Advance the source and /api/state firmware identifier to ESP32_CAT_HOST_0.52_FRONT_AVOIDANCE_SWITCH for the behavior implemented in fdb89be. Correct the remaining console description so escape forward travel is explicitly governed by the front-avoidance switch.
    Update the existing escape regression harness: enabled checks still require settled fresh FLOOR CLEAR, while disabled checks allow blocked, invalid, stale, uncalibrated, and missing-frame observations to start and continue escape. Confirm that side clearance and touch interruption still apply. No configuration defaults or Uno firmware are changed.
    Verification: lossless page generation a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
2026-10-14 Record verified ESP32 0.52 application deployment
    Record the user-authorized COM11 application-only deployment of source 32888ba. The safe IDLE state and complete saved configuration were captured before reset, the 3072-byte partition table matched, and HTTP identity was checked against the USB MAC using the firmware's little-endian eFuse integer convention. Only the application at 0x10000 was written; esptool verified its hash after 3845328 bytes were written in 26.0 seconds.
    HTTP readback at 192.168.137.234 confirmed ESP32_CAT_HOST_0.52_FRONT_AVOIDANCE_SWITCH, IDLE/SIM_UNO, camera initialization, no active motor and no unconfirmed STOP. All 99 saved configuration fields were unchanged, in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
